Yuchan-00/CanSat_EDF_Rocket/sizing/sizing_report_vtol.md

# VTOL 크기 산정 - 전원 battery

CAD 보고서 `cad/exports/cadquery_report_vtol.json` (params sha256 `3419c5fea63506dc…`).

* 질량 1653.7 g (출력 부품 565.6 g), CG z 245.3 mm, 베인 팔 208.3 mm, Ixx 0.0355 kg m², 높이 475.3 mm, 발자국 Ø246.8 mm
* 넘어짐 각: 핀 쪽 26.7°, 핀 사이 19.6°
* 법규: 4종 (250 g 초과 ~ 2 kg 이하), 기체 신고 필요 False

| 추력 (kgf) | T/W | 호버 스로틀 | P1 호버 W | P2 호버 W | T/W 1.3이 되는 질량 (g) |
|---|---|---|---|---|---|
| 2.0 | 1.21 | 0.91 | 886 | 1702 | 1538 |
| 2.3 | 1.39 | 0.85 | 886 | 1380 | 1769 |
| 2.6 | 1.57 | 0.80 | 886 | 1148 | 2000 |
| 3.09 | 1.87 | 0.73 | 886 | 886 | 2377 |

베인 권한(호버 추력 16.2 N, 명령 한계): 피치 0.536 N m → 15.1 rad/s², 롤 0.144 N m → 43.5 rad/s²

모터선 항력(E): 배기 속 모터선 묶음(수축 튜브, 항력 면적 325 mm², Cd 1 ASSUMED)이 추력의 3.2 %(Cd 0.8-1.2: 2.6-3.8 %)를 먹습니다. 호버에서 0.54 N. 그래서 T/W 1.3에 필요한 추력은 2.22 kgf입니다(질량만 보면 2.15 kgf). 위 표(T/W, 호버 전력)는 질량만 반영합니다. 이 EDF를 조립한 그대로 시험대에서 잰 추력에는 이 항력이 이미 들어 있으므로, 그 값에는 보정을 다시 하지 않습니다.

전압 조건: 위 표의 추력은 ESC 22.2 V 기준입니다. 팩이 셀당 3.7 V일 때 전 스로틀 전압은 20.36 V(내부 저항 18 mΩ ASSUMED)이고 추력은 0.870배(T ∝ V^1.61)입니다. 그때 T/W: 2 kgf 1.05 / 2.3 kgf 1.21 / 2.6 kgf 1.37 / 3.09 kgf 1.63. 비행 끝까지 T/W 1.3을 지키려면 22.2 V 기준 추력 2.47 kgf 이상이 필요합니다.

## 배터리 선택지 (추정, 기본 팩은 그대로)

| 팩 | 기체 질량 g | T/W @2.0/2.3/2.6/3.09 | P1 호버 A / 전압 처짐 V / 비행 s | P2(2.0 kgf) 호버 A / 처짐 V / 비행 s | 최대 C (P1 T/W 1.3 / P2 전 스로틀) |
|---|---|---|---|---|---|
| 6S 1300 mAh 120C | 1520 | 1.32/1.51/1.71/2.03 | 36.6 / 0.88 / 102 | 73.4 / 1.76 / 51 | 43 / 88 (정격 120) |
| 6S 1500 mAh 100C | 1550 | 1.29/1.48/1.68/1.99 | 37.6 / 0.79 / 115 | 74.9 / 1.57 / 58 | 38 / 76 (정격 100) |
| 6S 1800 mAh 100C | 1590 | 1.26/1.45/1.64/1.94 | 38.9 / 0.74 / 133 | 77.4 / 1.47 / 67 | 33 / 63 (정격 100) |
| 6S 2200 mAh 70C (default: battery.*) | 1654 | 1.21/1.39/1.57/1.87 | 41.3 / 0.74 / 153 | 82.1 / 1.48 / 77 | 28 / 51 (정격 70) |
