Yuchan-00/CanSat_EDF_Rocket/sizing/sizing_report_vtol_hybrid.md

# VTOL 크기 산정 - 전원 hybrid

CAD 보고서 `cad/exports/cadquery_report_vtol_hybrid.json` (params sha256 `3419c5fea63506dc…`).

* 질량 1526.8 g (출력 부품 565.6 g), CG z 232.5 mm, 베인 팔 195.5 mm, Ixx 0.0322 kg m², 높이 475.3 mm, 발자국 Ø246.8 mm
* 넘어짐 각: 핀 쪽 28.0°, 핀 사이 20.6°
* 법규: 4종 (250 g 초과 ~ 2 kg 이하), 기체 신고 필요 False

| 추력 (kgf) | T/W | 호버 스로틀 | P1 호버 W | P2 호버 W | T/W 1.3이 되는 질량 (g) |
|---|---|---|---|---|---|
| 2.0 | 1.31 | 0.87 | 786 | 1510 | 1538 |
| 2.3 | 1.51 | 0.81 | 786 | 1224 | 1769 |
| 2.6 | 1.70 | 0.77 | 786 | 1019 | 2000 |
| 3.09 | 2.02 | 0.70 | 786 | 786 | 2377 |

베인 권한(호버 추력 15.0 N, 명령 한계): 피치 0.464 N m → 14.4 rad/s², 롤 0.133 N m → 40.9 rad/s²

모터선 항력(E): 배기 속 모터선 묶음(수축 튜브, 항력 면적 325 mm², Cd 1 ASSUMED)이 추력의 3.2 %(Cd 0.8-1.2: 2.6-3.8 %)를 먹습니다. 호버에서 0.50 N. 그래서 T/W 1.3에 필요한 추력은 2.05 kgf입니다(질량만 보면 1.98 kgf). 위 표(T/W, 호버 전력)는 질량만 반영합니다. 이 EDF를 조립한 그대로 시험대에서 잰 추력에는 이 항력이 이미 들어 있으므로, 그 값에는 보정을 다시 하지 않습니다.

## 전원 장치 한계 (Mean Well RSP-1500-24, 25.2 V / 60 A, 루프 59.5 mΩ)

전류 한계에서 ESC 전압 21.63 V, 전력 1298 W. 전원 1대로 낼 수 있는 T/W:

| 추력 (kgf) | T/W 전원 한계 P1 | T/W 전원 한계 P2 | 호버 전선 전류 P1 A (ESC V) | P2 A (ESC V) | 버퍼 전류 P1 / P2 A | 버퍼 지속 P1 / P2 s |
|---|---|---|---|---|---|---|
| 2.0 | 1.26 | 0.90 | 33.9 (23.18) | 72.2 (20.90) | 0.0 / 25.9 | - / 72 |
| 2.3 | 1.40 | 1.04 | 33.9 (23.18) | 56.0 (21.87) | 0.0 / 13.4 | - / 140 |
| 2.6 | 1.40 | 1.18 | 33.9 (23.18) | 45.3 (22.51) | 0.0 / 4.3 | - / 431 |
| 3.09 | 1.40 | 1.40 | 33.9 (23.18) | 33.9 (23.18) | 0.0 / 0.0 | - / - |

하이브리드: 전선 전류가 40.3 A(버퍼 22.8 V)를 넘으면 버퍼 배터리가 함께 방전합니다. '호버는 전선이 혼자 감당한다'는 말은 팬 효율이 P1(판매처 표)처럼 좋을 때만 맞습니다.
