Yuchan-00/CanSat_EDF_Rocket/sizing/sizing_report_vtol_tether.md

# VTOL 크기 산정 - 전원 tether

CAD 보고서 `cad/exports/cadquery_report_vtol_tether.json` (params sha256 `3419c5fea63506dc…`).

* 질량 1405.8 g (출력 부품 565.6 g), CG z 219.8 mm, 베인 팔 182.8 mm, Ixx 0.0293 kg m², 높이 475.3 mm, 발자국 Ø246.8 mm
* 넘어짐 각: 핀 쪽 29.3°, 핀 사이 21.7°
* 법규: 4종 (250 g 초과 ~ 2 kg 이하), 기체 신고 필요 False

| 추력 (kgf) | T/W | 호버 스로틀 | P1 호버 W | P2 호버 W | T/W 1.3이 되는 질량 (g) |
|---|---|---|---|---|---|
| 2.0 | 1.42 | 0.84 | 695 | 1334 | 1538 |
| 2.3 | 1.64 | 0.78 | 695 | 1082 | 1769 |
| 2.6 | 1.85 | 0.74 | 695 | 900 | 2000 |
| 3.09 | 2.20 | 0.67 | 695 | 695 | 2377 |

베인 권한(호버 추력 13.8 N, 명령 한계): 피치 0.399 N m → 13.7 rad/s², 롤 0.122 N m → 38.0 rad/s²

모터선 항력(E): 배기 속 모터선 묶음(수축 튜브, 항력 면적 325 mm², Cd 1 ASSUMED)이 추력의 3.2 %(Cd 0.8-1.2: 2.6-3.8 %)를 먹습니다. 호버에서 0.46 N. 그래서 T/W 1.3에 필요한 추력은 1.89 kgf입니다(질량만 보면 1.83 kgf). 위 표(T/W, 호버 전력)는 질량만 반영합니다. 이 EDF를 조립한 그대로 시험대에서 잰 추력에는 이 항력이 이미 들어 있으므로, 그 값에는 보정을 다시 하지 않습니다.

## 전원 장치 한계 (Mean Well RSP-1500-24, 25.2 V / 60 A, 루프 59.5 mΩ)

전류 한계에서 ESC 전압 21.63 V, 전력 1298 W. 전원 1대로 낼 수 있는 T/W:

| 추력 (kgf) | T/W 전원 한계 P1 | T/W 전원 한계 P2 | 호버 전선 전류 P1 A (ESC V) | P2 A (ESC V) |
|---|---|---|---|---|
| 2.0 | 1.36 | 0.98 | 29.6 (23.44) | 62.0 (21.51) |
| 2.3 | 1.52 | 1.13 | 29.6 (23.44) | 48.5 (22.32) |
| 2.6 | 1.52 | 1.28 | 29.6 (23.44) | 39.4 (22.86) |
| 3.09 | 1.52 | 1.52 | 29.6 (23.44) | 29.6 (23.44) |
