Yuchan-00/CanSat_EDF_Rocket/pcb/vtol_carrier/spec/SPEC_ko.md

# VTOL 캐리어 PCB 전기 사양 (rev 2c, 2026-11-05)

## 0. rev 2c 변경 (rev 2b 독립 검토 반영, 2026-11-05)

아래 1장 이후는 rev 2b 때 쓴 요약입니다. rev 2c에서 바뀐 것은 이 절과 `carrier_spec.json`의 `rev_2c_changes`가 우선합니다.

- **J14(1S 배터리)와 J15(전원 스위치 리드)를 −x/+y 모서리로 옮겼습니다.** 사용자가 고른 배터리 A 자리(6S 팩 −x 면) 바로 옆입니다. J15는 2.54 mm 수 헤더 대신 **JST-PH 2핀 세로형**(J17과 같은 부품, LCSC C131337)입니다. 꽂은 플러그가 높이 13.4 mm 안에 들어갑니다 (A). 스위치 리드 끝은 JST-PH 하우징으로 다시 끼웁니다.
- **J13(사출 서보, 미실장)과 그 직렬 저항을 뺐습니다.** VTOL에는 사출 서보가 없습니다 (params `configs.vtol`). U2 PE5는 무연결로 둡니다. 펌웨어는 고치지 않았습니다. 부품 번호 자리는 비워 두어 다른 번호는 그대로입니다.
- **J3(ESP 굽기 헤더)를 1×6에서 2×3으로 바꾸고 케이블타이 띠 맨 위, ESP-12E 바로 옆에 두었습니다.** 핀 번호와 뜻은 같습니다 (1 IO0, 2 GND, 3 TXD0, 4 RXD0, 5 RST, 6 GND). 부품은 ISP와 같은 2×3 헤더(LCSC C65114)입니다.
- **크리스털 부하 콘덴서 22 pF → 27 pF** (CL 18 pF 크리스털에 맞춤, LCSC C1557, 2026-11-05 온라인 확인).
- **ESP 벌크 콘덴서 100 µF 6.3 V → 10 V** (LCSC C7196 TAJB107M010RNJ, 2026-11-05 온라인 확인). 3.3 V에서 정격의 33 %입니다.
- 부품 수: 162개 (실장 160, 미실장 2), 넷 100개 (M, build_spec.py).
- 배터리 A 자리 가정 상자와 무선 결정(Wi-Fi 유지, ESP-NOW 1 Mbps, 지상 고이득 안테나, 1 km 이상 지상 거리 시험, 실패하면 LoRa)은 `battery_spot_A_assumed`, `radio_decision_2026_11_05`에 있습니다.

아직 그리지 않았습니다. 이 문서는 사양만 요약합니다. 보드를 만들거나 측정한 적이 없으므로 모든 동작은 **NOT_VERIFIED**입니다.

- 기계 판독용 사양: `B:/0)AI_Cad/CanSat_EDF_Rocket/pcb/vtol_carrier/spec/carrier_spec.json`
- 생성 스크립트: `B:/0)AI_Cad/CanSat_EDF_Rocket/pcb/vtol_carrier/scripts/build_spec.py` (네트워크 없이 실행)
- 부품 출처 확인(온라인, 읽기만): `B:/0)AI_Cad/CanSat_EDF_Rocket/pcb/vtol_carrier/scripts/fetch_parts_sources.py` → `B:/0)AI_Cad/CanSat_EDF_Rocket/pcb/vtol_carrier/spec/parts_sources.json`, 원본 응답 `B:/0)AI_Cad/CanSat_EDF_Rocket/pcb/vtol_carrier/out/reports/sourcing/`
- 라이브러리 확인: `B:/0)AI_Cad/CanSat_EDF_Rocket/pcb/vtol_carrier/spec/library_probe.json` (KiCad 10 라이브러리 파일에서 읽음)
- 1차 빌드(PLM100 + 2S): `B:/0)AI_Cad/CanSat_EDF_Rocket/pcb/vtol_carrier/archive/rev1_plm100_2s/` (건드리지 않음)

표시: F = 파일·업체 페이지 근거, M = 도구로 측정, E = 추정, A = 가정(이유 있음).

## 1. 이번에 바뀐 것 (rev 2 → rev 2b)

- **5번째 ATmega128A를 뺐습니다** (사용자 결정). U5와 그 칩만 쓰던 크리스털, 콘덴서, 인덕터, 저항, LED, ISP 헤더 J23을 모두 지웠습니다. 다른 부품 번호는 그대로 두려고 번호 자리(U5, Y5, C33-C40, L5, R9-R10, D5, J23)는 비워 두었습니다.
- **5 V 모듈을 Pololu S9V11F5S6CMA로 정했습니다** (디바이스마트 15855364, F). 승강압형이고 저전압 차단 기능이 있습니다. 셀 과방전을 하드웨어로 막습니다. J6 1×5 헤더 하나로 꽂습니다 (J4는 이제 없음).
- **크리스털을 바꿨습니다.** JLC 기본 부품 C13738은 부하용량이 9 pF라 22 pF 콘덴서와 맞지 않습니다 (F, LCSC 페이지). 18 pF 제품 C70562 X322516MRB4SI를 씁니다.
- 서보 전원 220 µF 전해 콘덴서 풋프린트를 실제 부품 크기(6.3 × 5.4)에 맞췄습니다.
- **4층 대비 계획**을 넣었습니다 (8장).
- **모든 부품의 구매처를 온라인으로 확인했습니다** (7장).

## 2. 규모 (스크립트 결과, M)

- 부품 164개 (실장 160, 미실장/선택 4: J13, R22, Q3, R47), 넷 102개.
- 핀 665개 = 연결 481 + 무연결 184 (무연결마다 이유 기록).
- 신호 경로 52개 모두 통과, TX끼리 충돌 0, ESP 부팅 스트랩 5/5, ESP 플래시 핀 6개 미연결 확인. 스크립트 검사이며 ERC/DRC가 아닙니다.
- 일부러 틀린 6가지(ESP TX/RX 뒤바꿈, GPIO15 풀업, GPS TX끼리 연결, 0402 자리에 0603 부품, 출처 없는 저항값, Pololu EN 핀 누락)를 넣으면 스크립트가 모두 막았습니다. 원본은 통과했습니다 (M, `C:/Users/yc012/AppData/Local/Temp/claude/B--Claude/bed4b475-b8b1-46b7-ab64-c3b11e27401e/scratchpad/pcb/rev2b_mutation.py`).
- 두 번 만든 JSON의 해시가 같습니다 (M, sha256 f12d65d2…).

## 3. 칩과 링크 (펌웨어 핀 그대로)

- U1 NAV, U2 FCU, U3 COM, U4 GNS: ATmega128A-AU, 16 MHz, 5 V.
- 칩마다: 16 MHz 크리스털 + 22 pF 2개, 리셋 10 kΩ + 100 nF, VCC 핀마다 100 nF, AVCC 10 µH + 100 nF, AREF 100 nF(내부 2.56 V 기준), ISP 2×3, LED + 1 kΩ (F: `firmware/README.md:310-311`, `board.h`).
- nlink SPI(NAV→FCU), ilink UART(FCU↔COM, 1 kΩ), glink UART(NAV↔GNS, 1 kΩ 추가 - A)는 5 V 직결입니다.
- 프로그래밍용 리셋 고정 점퍼: J24(NAV), J25(FCU), J26(COM, ESP 굽기용).

## 4. 전원

- 경로: J14 배터리(Molex Mini-SPOX 2핀) → Q10 AO3401A 역극성 보호 → J15 스위치 리드 → 22 µF ×2 → J6 3번 VIN → Pololu 모듈 → J6 1번 VOUT → **+5V** → U6 AMS1117-3.3 → **+3V3**.
- 서보는 ESC BEC(5 V/7 A)에서 받습니다. 로직 배터리에서 받지 않습니다 (F: `firmware/README.md:322-324`).
- 6S는 J18로 전압만 잽니다 (PF0/PF1/PF2). 6S → 로직 변환기는 없습니다.
- 접지: 로직 GND와 추진 GND_PWR는 **NT1 한 곳(J12 ESC 커넥터 3번 핀)** 에서만 만납니다.
- 부하 (E): 5 V 평균 273 mA, 최대 683 mA. 3.3 V 평균 128 mA, 최대 448 mA (ESP 송신 순간 약 400 mA, A).
- 모듈 입력 전류 (E, 효율 85 % A): 3.7 V에서 평균 0.43 A, 3.0 V에서 최대 1.34 A.
- 모듈 능력: 업체 값 1.7 A는 입력이 5 V 근처일 때입니다. 3.0-3.7 V 입력에서는 약 1 A로 봅니다 (A, 그래프 미확인). 최대 부하 0.68 A에 약 1.5배 여유 (E). ESP 송신 때 5 V 처짐을 재야 합니다.
- AMS1117 발열 (E): 평균 0.22 W, 순간 0.76 W.
- 사용 시간 (E): 약 7.7 시간. 비행은 40 s이므로 충전만 해 두면 됩니다.
- Q10: 셀 3.0 V에서도 완전히 켜집니다 (LCSC: 2.5 V에서 85 mΩ, F). 전압 강하 0.11 V 이하 (E).
- 과방전 보호 (3겹):
  1. Pololu 모듈 저전압 차단. 차단 3.2 V를 제안합니다 (A). 재시동은 약 3.65 V부터입니다 (업체 값 114 %).
  2. 배터리 내장 보호회로 ('P' 접미사로 추정 - A, 실측 필요).
  3. FCU PF3 감시 분압기 47k/47k (실장). 펌웨어는 아직 읽지 않습니다. 그때까지 비행 전에 3.8 V 이상인지 재십시오.
- 차단이 비행 중에 걸리면 칩 4개가 모두 꺼집니다. 비행 전 전압 확인이 먼저입니다.
- 로직이 꺼진 채 6S를 꽂으면 PF0 분압기로 약 0.42 mA가 샙니다 (E). 로직을 먼저 켜고 6S를 꽂으십시오.

## 5. ESP-12E (U7)

- 3.3 V + 100 µF 탄탈 + 10 µF + 100 nF를 VCC 핀 옆에 둡니다 (A).
- EN 10 kΩ 풀업 + 100 nF, RST 10 kΩ 풀업(Q5), GPIO15 10 kΩ 풀다운, GPIO0·GPIO2 10 kΩ 풀업 (A, Espressif 자료 확인 필요).
- COM PD3 → Q4 → 1 kΩ → ESP RXD0. ESP TXD0 → Q11 → COM PD2. COM PC6 → Q5 → ESP RST.
- 굽기 헤더 J3 (3.3 V 전용, 전원 핀 없음): 1 IO0, 2 GND, 3 TXD0, 4 RXD0, 5 RST, 6 GND. J26을 끼워 COM을 리셋에 묶고 굽습니다.
- 안테나: 보드 +y 모서리. 안테나 아래와 양옆 4 mm는 모든 층에 구리·부품 금지입니다 (4층이면 안쪽 층도).
- 거리: 가시거리 약 100-300 m (A). VTOL 지오펜스 35 m에는 충분합니다 (E). 로켓(정점 140-150 m + 표류)에는 빠듯합니다 → 사용자 결정. 로켓 구성은 아직 LoRa입니다.

## 6. 센서·주변 장치

- J1 GY-521(I2C 0x68, 5 V), J2 BMP280(직각 소켓으로 눕힘, I2C 0x77, 3.3 V), I2C는 Q1/Q2 BSS138.
- J7 GPS 리드(JST-GH 4핀, NEO-7M은 상단 캡), Q6/Q7, JP1로 3.3 V/5 V 선택 (기본 3.3 V).
- J5 OpenLog: 직각 소켓, 보드에 눕힘 (OpenLog에 직각 수 헤더를 납땜).
- J8-J11 베인 서보, J12 ESC, J13 사출 서보(미실장), J16 아밍 스위치, J17 부저(Q9), J18 6S 감지.
- BSS138 채널 9개 자리, 8개 실장 (Q3는 선택).

## 7. 부품 구매처 (사용자 규칙: JLCPCB 또는 디바이스마트만)

- 보드 부품 36줄 모두 출처가 있습니다 (M, 스크립트 확인). JLCPCB/LCSC 34줄: Basic 18, Extended 16. 디바이스마트 2줄(GY-521, Pololu 모듈).
- 줄마다 C번호 또는 디바이스마트 no=, 제조사 품번, 패키지, 확인 URL, 날짜(2026-11-05), 재고, Basic/Extended를 `carrier_spec.json`의 `bom_sources`에 적었습니다. JLC BOM 열 이름은 `LCSC Part #`입니다.
- 패키지가 풋프린트와 맞는지 스크립트가 검사합니다 (칩 크기는 풋프린트 이름에서 읽음).
- 보드 밖 물품: 점퍼캡 5개(C100114), BMP280·OpenLog·NEO-7M·배터리·토글 스위치(디바이스마트), OpenLog용 직각 헤더(C55629820), GPS 리드 하우징·핀(C160418, C189897), 부저 리드 하우징·핀(C157955, C111515).
- 주의 1: 디바이스마트가 이 PC의 접속을 05:32쯤부터 막았습니다. OpenLog(1313116), MTS-102 토글(13029107), ESP-12E 대안(1378118)은 그 전에 디바이스마트 검색 결과로만 확인했습니다. 상품 페이지는 못 읽었습니다. 근거는 `spec/parts_sources_manual.json`에 적었습니다. 주문 전에 다시 확인하십시오.
- 주의 2: MTS-102 토글의 접점 정격은 확인하지 못했습니다 (A: 2 A 이상 가정). Adafruit 미니 토글은 1 A라서 쓰지 않았습니다 (F).
- 주의 3: LCSC에도 OpenLog(C17253836)가 있지만 재고가 0이었습니다.
- 주의 4: 재고는 날마다 바뀝니다. 주문 직전에 `fetch_parts_sources.py`를 다시 돌리십시오.
- 구매나 장바구니 담기는 하지 않았습니다.

## 8. 2층 / 4층 계획

- 먼저 2층(5번째 칩 없이)으로 배선합니다. 약 90분 안에 미연결 0이 안 되면 4층으로 바꿉니다 (사용자 결정).
- 4층 구성: F.Cu 신호 / In1.Cu GND 전면 / In2.Cu 전원(+5V, +3V3, SERVO_5V) / B.Cu 신호. JLCPCB 표준 4층 1.6 mm. 비아 0.3/0.6 mm 관통만. 2층 규칙을 그대로 지킵니다.
- 4층은 2층보다 기판값이 꽤 비쌉니다 (E, 가격은 조회 안 함). 배선 단계가 어느 쪽을 냈는지 보고합니다.

## 9. 사용자가 정할 것

1. 로직 배터리 자리 (CAD 상자에서 계산, E): A 6S 팩 −x 면이 가장 좋음 (무게중심이 축에서 0.84 mm, 지금 1.34 mm). D −y 옆 1.41 mm(GPS 선과 겹침), C +y 옆 1.09 mm(ESP 안테나 위), B ESC +x 면 2.73 mm(냉각창 막음).
2. 무게: 84 g 추가로 VTOL 배터리 구성 약 1,737.6 g, 목표보다 약 87.6 g 무거움 (E). params.json은 고치지 않았습니다.
3. 전원 스위치 위치: 기체를 닫으면 캐리어에 손이 닿지 않습니다. (a) 옆 창 스위치, (b) 상단 캡에 구멍 추가, (c) 배터리 플러그로 끄기 중 선택.
4. Pololu 차단 전압 (3.2 V 제안).
5. ESP 안테나: 모서리 + 금지 영역(기본) 또는 보드 밖으로 내밀기.
6. JLC Extended 부품 조립비, ESP-12E를 JLC 조립(C89297)할지 손납땜할지.
7. ESP 중계 펌웨어, 지상 쪽, COM 드라이버 - 별도 단계.
8. BMP280 드라이버와 시뮬레이션 기압 모델 - 제어 관련 변경이므로 전/후 비교 영상 규칙 적용.

## 10. 펌웨어 후속 (이번에는 고치지 않음)

- ESP 중계 펌웨어(새로), 지상 쪽(노트북/휴대폰 또는 ESP8266 한 개 더), `tools/ground_station.py` UDP/TCP.
- COM lora_uart 드라이버는 9600 8N1 투명 중계면 그대로 될 수도 있습니다 (E, 시험 필요). `sim/link_model.py`의 Ebyte 시간 모델은 Wi-Fi에 맞지 않습니다.
- FCU PF3 로직 배터리 읽기 + 아밍 금지/착륙 문턱 (A 값).
- NEO-7M MON-VER 처리, 상단 캡 맞춤. `sim/tether.py:171` bec_min_v 재검토.

## 11. 파일 사이 어긋남 (요약, 전체는 `conflicts` 19개)

- params `carrier.model`(1755줄)에는 GY-63, LoRa, 5 V buck, 미실장 5번째 칩이 아직 적혀 있습니다. 사용자 결정을 따랐습니다. params와 문서는 고치지 않았습니다.
- P3 문서의 22 pF와 JLC 기본 크리스털(9 pF)이 맞지 않아 18 pF 크리스털을 골랐습니다.
- params `com.pins.link_uart_rx`는 "direct"인데 Q11을 넣었습니다 (펌웨어 영향 없음).
- 펌웨어 README의 6S → 5 V UBEC 전원 설명은 별도 로직 배터리로 대체됩니다.
- 질량 초과는 과제 문장의 3.7 g이 아니라 문서·CAD 값 3.6 g을 썼습니다.
