Yuchan-00/CanSat_EDF_Rocket/docs/제작가이드.md

# 제작 가이드 — 부품표 · 출력 · 조립

> v0.4: 조종 링크는 보유한 LoRa 모듈입니다. 기체 안에서는 자세 제어와 안전 차단만 돌고, 발사·모터 정지·사출은 노트북 지상국이 명령합니다. 사용법은 [지상국_사용법.md](지상국_사용법.md)에 있습니다.
>
> v0.6.3: 비행 컴퓨터는 ATmega128A 보드 3개입니다. **NAV**는 센서(MPU-6050·기압계)를 읽고 자세 추정과 고도 필터를 돌립니다. 매 틱(4 ms)마다 72바이트 항법 프레임을 SPI(nlink)로 FCU에 보냅니다. **FCU**는 명령과 인터록(I1–I10), 자세 제어, 서보·ESC 출력, OpenLog 로그를 맡습니다. 비행 판단은 모두 FCU가 합니다. **COM**은 LoRa 무선, 명령 해독, 텔레메트리 작성을 맡고, UART(ilink, 250 kbaud)로 FCU와 이어집니다. NAV와 COM은 비행 판단을 하지 않습니다. (2026-11-09 덧붙임: v0.8.1부터 GPS를 맡는 **GNS**를 더해 칩이 4개입니다. VTOL은 네 칩을 캐리어 PCB 한 장에 올립니다. 무선은 2026-11-06부터 ESP-12E Wi-Fi가 기본이고 LoRa는 예비입니다.)

이 문서는 `params.json` v0.6.3의 기본 설계 **`BUDGET_90mm_6S`** 기준입니다. 원래 설계(KAIST 1 kg 캔위성, 12S)는 `KAIST_90mm_12S` 프리셋으로 남아 있습니다. 치수가 바뀌면 `python cad/layout.py`로 현재 값을 확인하세요.

## 1. 부품표

가격, 배송비, 판매처 링크가 있는 전체 부품표는 [예산안.md](budget/예산안.md)에 있습니다. 모든 가격은 2026-10-13에 판매 페이지에서 읽은 값이고, 합계는 `tools/budget_bom.py`가 계산합니다. (ASSUMED) 표시는 가격을 조사하지 않은 추정 품목입니다.

| 분류 | 부품 | 연결 |
|---|---|---|
| 추진 | Hobbyocean 90 mm 12엽 EDF 6S 1450KV | ESC 경유 |
| 추진 | Hobbywing SkyWalker 100A V2 ESC | 신호선 ← FCU PE4(OC3B). 내장 5 V/7 A BEC로 서보 5개 구동 |
| 추진 | CNHL G+Plus 6S 2200 mAh 70C | FCU ADC0(PF0)에 47 kΩ / 4.7 kΩ 분압 |
| 구동 | MG90S 서보 5개 | FCU: 베인 PB5·PB6·PB7·PE3, 사출 PE5 |
| 배선 (v0.6) | 26 AWG 3심 플랫 서보선(실리콘) 약 3 m, 3핀 JR/듀폰 커넥터 4개(또는 서보 헤더 기판에 납땜), 수축 튜브 (ASSUMED) | 베인 서보 4개의 연장선. FCU까지 연장 길이 합 1,947 mm + 여유 300 mm. 단면 3.6 × 1.3 mm, 10 g/m로 가정했으므로 산 전선을 재고 무게를 달아 `params.json`의 `servo_leads`와 비교 |
| 비행 컴퓨터 | ATmega128A 최소 시스템 보드 3개 (NAV·FCU·COM), 16 MHz | 크리스털이 16 MHz인지 확인(8 MHz로 온 사례 있음). 설계는 50 × 50 × 15 mm 보드, 44 mm 정사각 M3 구멍으로 잡았습니다. 받으면 재서 다르면 알려 주세요 |
| NAV | MPU-6050(GY-521), 기압계 BMP280 모듈(TYE-BMP29, 디바이스마트 15442588, 3.3 V. 사용자 결정 2026-11-04, GY-63 MS5611 대신) | NAV PD0(SCL)/PD1(SDA) → 레벨 시프터 HV(5 V) 쪽, GY-521·BMP280의 SCL/SDA → LV(3.3 V) 쪽. BMP280은 VCC 3.3 V(AMS1117 1번)이고, CSB·SDO를 3.3 V에 묶어 I2C 0x77로 씁니다(캐리어 J2와 같음. 핀 순서는 실크로 확인, A). 펌웨어의 기본 NAV 빌드가 BMP280을 읽습니다(2026-11-10 제어 라운드. 실제 부품으로는 아직 확인하지 않았습니다. MS5611을 쓰려면 env `nav_ms5611`) |
| NAV | I2C 레벨 시프터 4채널, AMS1117-3.3 (1번) | ATmega128은 5 V에서 TWI 입력 High 기준이 3.5 V라 3.3 V 센서를 직접 받으면 보장되지 않음 |
| COM | 보유한 LoRa 모듈 (기체용) | UART형(Ebyte E22/E220/E32 등): COM의 USART1 PD2/PD3, M0·M1·AUX = PC3·PC4·PC5. SPI형(SX1276 900 MHz, 예: RFM95W·Ra-01H): COM의 PB0–PB3, DIO0 = PE7, RESET = PC6, 전원은 AMS1117-3.3(2번)에서. Ra-01/Ra-02는 433 MHz라 맞지 않음 |
| COM | 두 번째 레벨 시프터 4채널, AMS1117-3.3 (2번) | COM에서 LoRa 모듈로 가는 신호를 3.3 V로. 2번 AMS1117은 LoRa 모듈과 이 시프터의 3.3 V 쪽 |
| FCU | OpenLog 호환 로거 + microSD | FCU USART0 TXD0(PE1) → OpenLog RXI, 57600 baud. FCU의 ISP와 핀 공유 → FCU를 프로그래밍할 때 분리. 레벨 시프터 경로는 3장 9단계 참고 |
| 배선 (v0.6) | ilink 배선: 1 kΩ 직렬 저항, 4핀 커넥터 1쌍, 신호선 약 30 cm (ASSUMED) | FCU PD3(TXD1) → 1 kΩ → COM PE0(RXD0), COM PE1(TXD0) → FCU PD2(RXD1), GND. 3선입니다(`board.h`). 4핀 커넥터의 남는 핀은 비워 둡니다. COM의 5 V는 UBEC에서 따로 받습니다. 두 칩 모두 5 V라 시프터 없음 |
| 배선 (v0.6.3) | nlink 배선: 5핀 커넥터 1쌍, 신호선 약 30 cm (ASSUMED) | NAV PB0·PB1·PB2·PB3 → FCU 같은 핀 (SS, SCK, MOSI, MISO) + GND. 시프터 없음. FCU를 프로그래밍할 때 뺌 |
| 비행 컴퓨터 | 5 V 3 A UBEC (2–6S) | 로직 전원(세 보드, 센서, 로거, 시프터 5 V 쪽). 서보 전원과 분리해 브라운아웃 리셋을 막음 |
| 회수 | 립스톱 1 × 1.5 m 두 장으로 만든 1.4 m 낙하산, 줄, 쇼크 코드, 스위블 | 노즈 앵커바 ↔ 페이로드 격벽 |
| 구조 | Bambu PLA Matte **아이보리 화이트(Ivory White, 코드 11100)** 1 kg × 2(로켓) / × 1(VTOL), **만다린 오렌지(Mandarin Orange, 코드 11300)** 1 kg × 1(로고), 발사대용 차콜(Charcoal, 11101, 검정, 있으면 안 삼), M3·M2 나사, OD 40 스프링 | 2026-11-04: 기체 흰색 + YUCHAN 로고. 살 때 색 이름·코드 확인(Bone White 11103과 헷갈리지 않게) |
| 구조 | 양면 폼 테이프 3 mm, 케이블 타이 | FCU와 통신·로거 상자 고정. 예산안에 없는 품목 |
| VTOL 로직 전원 (2026-11-05, 배터리 구성만) | 1S 3.7 V 4200 mAh DTP105565P(디바이스마트 16021596, 84 g), MTS-102 토글 하네스(디바이스마트 13029107, 접점 ≥ 2 A 확인), JST-PH 2핀 하우징, 케이블 타이 1개, 상단 캡 나사 **M3×6** 4개(더 긴 나사 금지), 배터리 선이 115 mm보다 짧으면 Molex 5264 2핀 연장선 | 캐리어 PCB J14(배터리) / J15(스위치). 자리·고정·선: 3장 14단계 |

**캔위성 규격이 바뀌었습니다.** 이 예산의 추력(약 3 kg)으로는 국제 규격 캔위성(Ø66 × 115 mm, 350 g)까지만 실을 수 있습니다. KAIST 체험부·슬기부·창작부 규격(650–1000 g)은 이 예산으로 불가능합니다.

## 2. 출력 (Bambu Lab P2S, PLA Matte 흰색 + 주황 로고)

* 출력용 STL은 `cad/exports/print/`에 **출력 방향이 이미 적용된 상태**로 들어 있습니다. Bambu Studio에 그대로 불러오면 됩니다.
* **출력하기 전에 `python tools/make_print_files.py --check`를 실행합니다.** 종료 코드 0이면 출력 파일이 현재 설계와 맞습니다. v0.9(2026-11-04)에는 Fusion 360 GUI 실행(스크립트 0.9.6)을 아직 하지 않아서, 지금 쓸 수 있는 출력 파일은 CadQuery 트윈 STL로 만든 **임시본**입니다: `cad/exports/print/provisional_v09_cadquery/`(로켓), `cad/exports/print/provisional_v09_cadquery_vtol/`(VTOL 배터리). 공식 출력 파일은 Fusion 스크립트를 지금의 `params.json`으로 실행하고 `--check`가 0을 낼 때 만듭니다.
* **흡입 모듈만은 STL이 아니라 `intake_module.3mf`(Bambu Studio 프로젝트)를 엽니다 (v0.6.2).** 창 4개마다 서포트 차단(support blocker) 볼륨과 슬라이스 설정이 들어 있습니다. 흡입 모듈은 **뒤집어** 출력합니다. 위쪽 스피곳이 판에 서고, 조립하면 아래쪽인 창 끝이 출력할 때 창의 천장이 됩니다. 이 천장은 가운데 20 mm가 브리지이고 양쪽이 45° 경사(잘린 박공)라 서포트 없이 출력됩니다. STL만 불러오면 Bambu Studio가 천장 밑과 창 안에 서포트를 다시 넣습니다. 그러면 서포트를 뗄 때 기둥이 상할 수 있습니다. `print_plan.md`의 "창 안 서포트 검사"가 PASS인지 확인하고(지금 PASS, 창 4개 모두 0 mm), 슬라이스 미리보기에서도 창 안에 서포트가 없는지 봅니다.
* 흡입 모듈 창 띠 (v0.6.1): 1.2 mm 기둥이 출력 중에 휘고 서포트를 뗄 때 부러져서, 창이 있는 띠를 3 mm 두께로, 기둥을 18 mm 폭으로 바꿨습니다. 창은 축에서 본 부채꼴이라 기둥 옆면이 반경 방향입니다.
* 공통 설정: `0.20mm Standard @BBL P2S` 기반, 채움 15 % 자이로이드, 자동 브림. 벽 수는 부품 등급별입니다(v0.9 임시 출력 계획): 하중 경로(A) 4줄·위아래 4층, 몸통·평판·발사대(B·C·E) 3줄·4층, 작은 부품(D) 5줄·5층. 벽이 1.2 mm라 3줄 이상이면 꽉 찬 벽이 됩니다.
* 서포트가 필요한 부품: 흡입 모듈(뒤집어 출력), 페이로드 모듈, 노즈콘, 베인, 발사대, **VTOL 배터리 구성의 상단 캡**(2026-11-05 스위치 보호 칼라 때문에 바로 세워 출력, 트리 서포트 - 3장 14단계 2). 발사대는 트리 서포트가 판 밖으로 퍼져 슬라이서가 거부하므로 일반(그리드) 서포트를 씁니다. 흡입 모듈은 일반 서포트를 밀착형(snug)으로, 서포트 확장 −0.5 mm로 씁니다. 트리 서포트는 차단 볼륨이 있어도 가지가 창을 지나 안쪽 선반까지 가기 때문입니다. 흡입 모듈의 서포트는 스피곳 안 격벽 밑, 안쪽 선반 턱 밑, 스피곳 바깥 턱, 볼록 통로 밑에만 남습니다. 선반 홈 천장(폭 14 mm·9 mm)은 대부분 브리지로 출력됩니다. 페이로드 모듈은 판에서 15 mm 위의 격벽과 그 아래 COM 보스 4개(v0.6)에 짧은 트리 서포트가 생깁니다.
* 부품별 출력 시간과 필라멘트는 `cad/exports/print/provisional_v09_cadquery/print_plan_provisional.md`(로켓)와 `cad/exports/print/provisional_v09_cadquery_vtol/print_plan_provisional.md`(VTOL)에 있습니다. 로켓은 발사대를 포함해 47시간 29분, 필라멘트 1475 g(부품 1083 g), VTOL은 32시간 41분, 827 g입니다(v0.9 CadQuery STL을 Bambu Studio로 슬라이스한 값, 2색 모듈의 퍼지량은 가정값 150 / 210 mm³ 기준). 예전 v0.6.2 Fusion 내보내기 값(전체 30시간 21분, 1272 g)은 `cad/exports/print/print_plan.md`에 남아 있습니다.
* PLA 열변형 온도는 52 °C(1.8 MPa)입니다. 여름철 차 안이나 직사광선 아래 보관을 피하세요.
* 벽이 1.2 mm로 얇아졌습니다. 착지 충격으로 금이 가면 해당 모듈만 다시 출력하세요.

### 2색 출력: 전자부 모듈 + YUCHAN 로고 (2026-11-04, AMS 필요)

* **2색인 판은 전자부 모듈 하나뿐**입니다. 다른 부품은 모두 흰색 한 색이고, 발사대만 검정입니다.
* 여는 파일: `cad/exports/print/provisional_v09_cadquery/avionics_module.3mf`(로켓) 또는 `..._vtol/avionics_module.3mf`(VTOL). STL을 따로 불러오지 마세요.
  이 프로젝트에 흰 몸통과 주황 로고가 한 물체의 두 부분으로 들어 있고, 필라멘트 1·2에 색이 정해져 있습니다.
* **AMS 넣기**: 1번 칸 Ivory White(아이보리 화이트, #FFFFFF, 11100), 2번 칸 Mandarin Orange(만다린 오렌지, #F99963, 11300). 보낼 때 AMS 매핑에서 1 → 흰색 칸, 2 → 주황 칸을 고릅니다.
* **슬라이서 설정**(프로젝트에 들어 있음, 바꾸지 마세요): P2S 0.4 노즐, `0.20mm Standard @BBL P2S`, 벽 3줄·위아래 4층·15 % 자이로이드, 벽 생성기 classic,
  **얇은 벽 감지(Detect thin wall) 켬**, 퍼지량 흰→주황 150 mm³ / 주황→흰 210 mm³(배수 1), 프라임 타워 켬(x 20, y 205).
  * 얇은 벽 감지는 끄지 마세요. 끄면 주황 한 줄을 같은 자리에 두 번 찍어서(갔다가 돌아옴) 홈이 넘치고 로고 가장자리가 튀어나올 수 있습니다.
  * 퍼지량 150 / 210은 가장 가까운 색 쌍(연회색 ↔ 주황)에서 가져온 가정값입니다. 흰색·만다린 쌍은 Bambu 표에 없습니다.
  * "채움/물체로 퍼지"는 켜지 마세요. 켜면 주황이 사라집니다(주황은 바깥 한 줄뿐).
  * 벽 생성기를 arachne로 바꾸지 마세요. 시험에서 주황 줄이 덜 찍혔습니다.
  * Bambu Studio가 퍼지량을 더 크게 계산해 보여 주면 그 값을 써도 됩니다. 시간과 버리는 양만 늘어납니다.
* **미리보기에서 확인**: 주황이 바깥 벽 한 줄에만 있는지, 그리고 **그 한 줄을 한 번만 지나가는지** 봅니다(선 종류 보기에서 주황 바깥 벽이 겹쳐 두 줄로 보이면 안 됨).
  색 바꿈은 576번(출력 높이 3.4-124.2 mm)입니다. 그중 2번은 주황 없이 색만 바꾸는 층입니다(층마다 색 순서가 번갈아 바뀌어 생김, 알려진 것).
  글자 끝이나 흰 쐐기 끝이 걸리는 몇 층에서는 작은 주황 점이 빠지거나 흰 쐐기 끝이 메워질 수 있습니다. 예상한 모습입니다.
* **예상(슬라이서 M, 퍼지 150 / 210 가정)**: 로켓 16 h 54 min, VTOL 16 h 28 min(한 색일 때보다 약 +14 h 23-26 min).
  버리는 양: 퍼지 136 g + 프라임 타워 45 g ≈ 180 g. 이 부품에 흰 163 g(VTOL; 로켓은 228 g), 주황 76 g이 듭니다.
  퍼지를 CLI 기본 280 mm³로 하면 약 +15 h 30 min, 256 g입니다(위쪽 기준).
* **긴 출력 전에 짧은 2색 시험 출력을 하세요**(실제 Ivory White / Mandarin 롤, 로고가 있는 아래쪽 몇 cm만). 흰 벽에 주황 기운이 보이면 주황→흰 퍼지를 늘립니다.
  출력이 길어서 AMS 칸에 각각 300 g 이상 남아 있는지 먼저 봅니다.
* **출력 뒤 검사**:
  1. 밖에서 보면 양쪽 모두 아래에서 위로 YUCHAN이 읽혀야 합니다(글자 윗부분이 왼쪽). 기체를 노즈 쪽이 오른쪽이 되게 눕히면 바로 읽힙니다.
  2. 로고가 벽과 같은 높이입니다(튀어나오거나 파이지 않음). 손톱으로 경계를 쓸어 봅니다.
  3. 주황 가장자리에 흰 실·번짐·빈틈이 없고, 가장 작은 배기 점선 3개(약 8.5 mm²)가 다 찍혔는지 봅니다.
  4. 모듈 안쪽 벽에는 주황이 보이지 않아야 합니다(주황은 바깥 0.42 mm뿐).

### 출력 후 가공

1. 힌지 보어(Ø5.4)를 5.5 mm 드릴로 손으로 가볍게 리밍합니다. 베인 축이 걸림 없이 돌아야 합니다.
2. 혼의 D-보어에 베인 축 D-컷이 들어가는지 확인합니다. 설계상 반경 방향 틈새 0.2 mm입니다.
3. 결합부(스피곳)에 상대 모듈이 손으로 끼워지는지 확인합니다. 설계 직경 틈새 0.4 mm입니다.
4. M3 결합 구멍(Ø2.5 / Ø3.2)과 서보 귀 구멍(Ø1.8)을 정리합니다.
5. 흡입 모듈 바깥의 볼록 전선 통로(0° 쪽)를 아래쪽 입구와 선반 홈 쪽으로 들여다보고, 서포트 찌꺼기가 없는지 확인합니다. 12 × 5 mm 막대나 묶은 전선을 한 번 통과시켜 봅니다. 통로 바닥은 45° 경사라 서포트가 생기지 않게 설계했습니다.
6. **서보선 통로 (v0.6)**: 추진 모듈의 서보 포드 4개 끝벽 아래쪽 창(4.6 × 7 mm), 원뿔 아래쪽의 세로 슬롯 4개(핀에서 8° 지난 53°·143°·233°·323°), 그 바로 위 데크 홈 4개, 스피곳 링 바깥 둘레의 턱(깊이 3.4 mm, 높이 5 mm), 흡입 모듈 180° 쪽 볼록 통로와 선반 홈, 격벽의 180° 구멍을 확인합니다. 3.6 × 1.3 mm 띠(서보선 한 가닥)가 걸림 없이 지나가야 합니다.
7. **흡입 모듈 창 (v0.6.2)**: 창 안에는 서포트가 없어야 합니다. 창 천장(출력할 때 위쪽, 조립하면 아래쪽 끝) 가운데 20 mm 브리지에 처진 실이 있으면 칼로 다듬기만 합니다. 안쪽 선반 턱 밑의 서포트는 모듈의 열린 끝(스커트 쪽)으로 손을 넣어 선반에서 떼어 냅니다. 이때 기둥을 지렛대로 쓰지 마세요.
8. **흡입 모듈 격벽 윗면 (v0.6.3)**: 흡입 모듈을 뒤집어 출력하면 격벽 윗면(스피곳 안쪽)이 서포트 위에 출력됩니다. 이 면에 FCU를 폼 테이프로 붙이므로, 서포트를 깨끗이 떼어 평평하게 만듭니다. 통풍 구멍 4개(Ø8, 축에서 40 mm, 45°·135°·225°·315°)에 찌꺼기가 없고 케이블 타이가 지나가는지 봅니다.
9. **VTOL 상단 캡 (배터리 구성, 2026-11-05 보호 칼라)**: 캡은 바로 세워(스커트 끝이 판에) 트리 서포트로 출력됩니다. 스커트 안의 서포트를 손을 넣어 떼어 냅니다. 리브·림 링을 지렛대로 쓰지 마세요. **스위치 구멍(Ø6.2) 둘레의 판 밑면은 안쪽 너트가 닿는 자리**이고 서포트 접촉면 위에 출력됩니다. 칼로 긁거나 사포로 평평하게 합니다. 구멍, 칼라 안, 손가락 홈 안에는 서포트가 없습니다(G-code 검사, M). 와셔 홈(Ø32.5, 허브 아래)도 서포트를 깨끗이 떼고 평평하게 다듬습니다. **이 칼라 캡으로는 붙잡는 줄·증명 하중 시험을 하지 않습니다**: 바로 세워 출력하면 하드포인트 하중 경로(리브 끝, 허브, 와셔 홈)도 서포트 위에 출력되는데, 증명 하중의 리브 안전율은 1.03뿐입니다(C38, 윗면 아래 출력 기준). 그런 시험은 윗면 아래로 출력한 캡(유선·하이브리드 캡)으로만 합니다. 스커트 입구가 첫 층이라 이 슬라이스는 첫 층 보정(elephant foot 0.15 mm, A)을 씁니다. 처음 출력한 캡을 아비오닉스 스피곳에 끼워 맞춤을 확인합니다(반경 틈 0.2 mm).
10. **COM 보스 구멍 (v0.6)**: 페이로드 모듈 격벽 아래 보스 4개(Ø7 × 3 mm, 축에서 x·y ±22 mm)에는 Ø2.5 막힌 구멍이 보스 끝에서 3.8 mm 깊이로 있습니다. 서포트가 구멍에 들어갔으면 2.5 mm 드릴로 손으로 뚫습니다. 구멍 바닥 위의 격벽은 1.2 mm뿐입니다. 드릴에 테이프로 3.8 mm를 표시하고 그보다 깊이 넣지 마세요. 뚫리면 스프링 쪽으로 구멍이 납니다.

## 3. 조립 순서

세 보드는 붙이기 전에 펌웨어를 올려 두면 편합니다(10단계). FCU는 흡입 격벽 위에 붙고 나면 손이 닿기 어렵습니다. 그래도 시험 빌드를 오갈 때와 `params.json`이 바뀔 때마다 FCU를 다시 올려야 합니다. 조립된 기체에서 FCU에 닿는 순서는 10단계 4에 있습니다.

1. **베인 · 서보**: 베인 축을 덕트 안쪽에서 힌지 보어로 끼우고, 바깥에서 혼을 D-컷에 끼웁니다. 서보를 포드에 넣기 전에 (v0.6):
   1. **서보선이 출력축 반대쪽 끝에서 나오는지 확인합니다.** 설계는 그렇게 가정했습니다(`servo_leads.lead_exit_ASSUMED`). 출력축 쪽에서 나오는 서보라면 이 경로가 맞지 않으니 출력하기 전에 알려 주세요.
   2. 서보선을 케이스에서 60 mm 남기고 자릅니다(커넥터 제거). 이 선을 포드 끝벽 아래쪽 창(혼 반대쪽, 핀 쪽)으로 밖으로 빼고 서보를 넣습니다.
   3. 남긴 60 mm 끝에 26 AWG 3심 연장선을 납땜하고 수축 튜브를 씌웁니다. v0.6.3부터 서보선은 흡입 격벽 위의 FCU에서 끝납니다. 연장선 길이(여유 50 mm 포함): 포드 1(24°) 524 mm, 포드 2(114°) 434 mm, 포드 3(204°) 450 mm, 포드 4(294°) 539 mm (`python cad/layout.py`, 검사 C23). 마지막 구간(격벽 서보선 구멍 → FCU 윗면 → 보드 가운데)은 FCU의 서보 헤더 위치를 몰라서 추정한 값입니다. 자르기 전에 FCU에서 서보 헤더를 달 자리를 정하고 길이를 확인하세요. 반대쪽 끝은 피복만 벗긴 채 두고(커넥터는 마지막에 답니다) 양쪽 끝에 번호를 표시합니다.

   서보를 M2 나사로 고정합니다. 서보를 중립(1500 µs)에 둔 상태에서 암을 반경 방향으로 맞추고 푸시로드(1.5 mm 피아노선, 축간 24.7 mm)를 연결합니다. 손으로 ±25°까지 걸림이 없는지 확인합니다.
2. **EDF 실측 (v0.5)**: 설계 치수는 판매처 치수 도면에서 읽은 값입니다. 받으면 먼저 재서 `params.json`의 `edf` 항목과 비교하세요. 다르면 고친 뒤 모델을 다시 생성합니다.
   * 하우징 지름 98 mm, 나팔형 립 지름 112 mm와 깊이 약 11 mm
   * 립 앞면에서 하우징 뒤끝까지 81.1 mm
   * 장착 탭: 바깥끼리 114.2 mm, 길이 42.3 mm, 두께는 도면에 없어 3.0 mm로 가정
   * 탭 가운데 구멍이 하우징 뒤끝에서 34.3 mm, 구멍 간격 11 mm
   * 탭 아래 끝에서 립 앞면까지(모델 67.95 mm)와 탭 아래 끝에서 각 구멍 중심까지(모델 10.15 / 21.15 / 32.15 mm). (2026-11-03 시계 장착부터 탭 나사가 없어 이 값은 재지 않아도 됩니다; 폼 패드가 ±0.5 mm를 받습니다.)
3. **EDF 장착 (2026-11-03 시계 장착, 탭 나사 없음 - `docs/v0.9_하드웨어_변경.md` 17.13)**: 재지 않고 넣습니다.
   1. 공장 수축 튜브는 그대로 둡니다. 모터 전선 끝의 총알 커넥터는 이 단계 전에 잘라 두거나 아직 납땜하지 않습니다.
   2. 두 탭의 밑면에 EVA 폼 조각(약 3 × 8 mm, 두께 3.5 mm)을 하나씩 붙입니다.
   3. **넣기 전에** 낱선 세 가닥을 묶음 끝에서 위로 약 90° 굽혀 둡니다(반지름은 7-15 mm 어디든, 선이 원하는 대로). 곧은 선으로는 EDF가 들어가지 않습니다(곧은 선은 블리스터 바깥벽보다 멀리 나감).
   4. EDF를 위에서 들고 돌려, 선 묶음이 0°(ESC 쪽, +x)의 선 통로(바깥으로 튀어나온 블리스터)를 향하게 합니다. 세운 선이 통로 안에 서도록 그대로 내립니다. 탭은 둘레의 키웨이 25개 중 가까운 곳에 저절로 떨어집니다.
      선이 탭 바로 옆에서 나오면 한 탭은 통로 안에 매달립니다. 정상입니다.
   5. 세운 선을 블리스터 바깥벽 쪽으로 밀어 붙입니다(벽에서 4 mm 안쪽까지만; 탭이 통로에 매달린 자리에서는 꼭). 위쪽에서 흡입부 홈 자리에 나란히 눕힙니다.
   6. 묶음을 고정 날개 뒤 끝에 RTV로 붙이는 것은 선택입니다. 통로 위쪽(몸통 밖, 반지름 60-76.7 mm의 열린 부분)에 폼 마개를 선 둘레에 꽉 채워 끼웁니다.
   7. 추력은 립 → 흡입부 선반이 받습니다(탭 나사 없음). 아래 방향은 탭 → 폼 → 키웨이 바닥 패드가 받습니다. 모터 토크는 탭 → 키웨이 옆 슬리브 이빨이 받습니다(이빨 폭 5.3 mm 이상, C35).
4. **서보선 넣기 (v0.6)**: 경로는 SPEC 3.8에 있습니다. 서보선 4가닥은 모터 전선(0°)과 반대편인 180° 쪽으로 모아 올립니다.
   1. 각 서보선은 포드 창에서 나와 핀 뿌리 옆을 따라 올라가, 원뿔이 시작하는 높이(배기구 끝에서 약 88–92 mm)에서 핀 선을 넘어 8° 옆(53°·143°·233°·323°)의 원뿔 세로 슬롯 아래로 갑니다.
   2. 같은 각도의 데크 홈(스피곳 링 바깥, 흡입 모듈이 덮을 자리)에서 0.5 mm 피아노선이나 기타 줄처럼 뻣뻣한 줄을 아래로 밀어 넣으면, 통로가 일직선이라 원뿔 슬롯으로 나옵니다. 서보선 끝을 테이프로 붙여 위로 당겨 올립니다.
   3. 데크 홈에서 나온 선을 스피곳 링 바깥 둘레의 턱(깊이 3.4 mm, 높이 5 mm)에 납작하게(폭이 세로가 되게) 눕혀 180° 쪽으로 돌립니다. 선은 180°로 가는 길에 그 사이의 키웨이(2026-11-03 시계 장착부터 둘레에 25개) 위를 여러 번 건너갑니다. 키웨이마다 턱 바닥에 4 mm 틈이 있고(탭 윗끝보다 8.65 mm 위), 선은 그 위를 건너가기만 합니다(틈 안으로 밀어 넣지 마세요). 0°의 모터 전선 홈 쪽으로는 돌리지 않습니다.
   4. 포드에서 원뿔 슬롯까지의 바깥 구간(납땜 이음매 포함)은 덕트와 핀 뿌리에 캡톤이나 알루미늄 테이프로 붙입니다. 베인을 손으로 ±25° 움직여 선이 혼·푸시로드에 닿지 않는지 확인합니다.
5. **흡입 모듈**:
   1. 흡입 모듈을 내리기 전에 맨 전선 세 가닥을 흡입 모듈 아래쪽에서 바깥 볼록 통로(0°)로 넣어, 선반 홈을 지나 창 안쪽으로 빼 둡니다. 통로 입구는 6 mm라 한 가닥씩 넣는 것이 쉽습니다. 서보선 네 가닥도 같은 방법으로 반대편 180° 볼록 통로 아래 입구로 넣어 선반 홈을 지나 창 안쪽으로 빼 둡니다. 흡입 모듈을 내릴 때 서보선이 스피곳 링 턱 안에 있어 스커트에 끼지 않는지 봅니다.
   2. 흡입 모듈을 내리기 전에 립이 가운데 오도록 손으로 맞춥니다. 탭이 EDF를 가운데로 잡아 주지 않기 때문입니다(립과 홈 사이 반경 여유 0.75 mm). 흡입 모듈을 스피곳에 끼우고 **M3×8** 나사 4개로 고정합니다. 결합 구멍은 막힌 구멍이라 더 긴 나사를 쓰면 바닥에 닿아 헛돕니다. 선반은 립 앞면에서 0.5 mm 위에 있고, 2026-11-03 시계 장착부터는 추력을 받는 멈춤입니다.
   3. 전선 끝에 4 mm 총알 커넥터를 납땜하고 수축 튜브를 씌웁니다. 전선은 0° 기둥 안쪽을 따라 케이블 타이로 묶고, 격벽의 전선 구멍(0°)을 지나 트레이 +x 면의 ESC로 갑니다.
   4. EDF 전선이 ESC에 닿지 않으면 부품표의 12 AWG 실리콘 전선과 4 mm 총알 커넥터로 늘리세요. 이음매는 흡입 모듈 창 안쪽 넓은 곳에 두는 것이 좋습니다.
   5. 서보선 네 가닥은 180° 기둥 안쪽을 따라 납작하게 모아 케이블 타이로 묶고, 격벽의 180° 서보선 구멍으로 넘깁니다. 창 쪽으로 늘어진 곳이 없어야 합니다(흡입 공기에 빨려 들어가면 팬이 칩니다). 넘긴 끝은 6단계에서 FCU에 연결합니다.
6. **FCU 보드 (v0.6.3, 흡입 격벽 위)**: 에이비오닉스 모듈을 끼우기 **전에** 합니다(검사 C25).
   1. FCU에는 서보 헤더(베인 4 + 사출 1), ESC 신호선, nlink·ilink 커넥터, 로그 선, 배터리 분압, 아밍 스위치·부저·LED, 5 V 전원이 모입니다. CAD는 FCU를 폼 테이프 위 15 mm 높이의 상자로 잡았습니다. 그 위로 트레이 아래 끝까지 2.0 mm, ESC와 기타 전자 상자까지 약 12 mm입니다(`python cad/layout.py`). 커넥터를 꽂은 높이를 재 봅니다.
   2. 3 mm 양면 폼 테이프를 보드 밑면에 붙이고, 격벽 윗면 가운데에 보드 모서리를 x·y축에 맞춰 놓습니다(보드가 축에서 ±25 mm). 가운데 Ø20 케이블 구멍은 보드가 덮습니다. 이 구멍으로는 아무 선도 지나가지 않습니다. 모터선은 0° 전선 구멍, 서보선은 180° 서보선 구멍을 씁니다.
   3. 케이블 타이를 대각선으로 마주 보는 통풍 구멍 두 개(45°와 225°, 또는 135°와 315°)로 넣습니다. 격벽 밑(흡입 창 안쪽)으로 돌려 보드 위를 대각선으로 가로질러 조입니다. 통풍 구멍 가장자리는 보드 모서리에서 0.64 mm 떨어져 있어 보드에 가려지지 않습니다.
   4. 서보선 4가닥을 180° 서보선 구멍에서 FCU 윗면 높이로 올리고, 보드의 −x 가장자리를 넘겨 서보 헤더로 가져갑니다. 각 선 끝에 3핀 커넥터를 압착하거나 서보 헤더 기판에 납땜합니다: 포드 1~4(24°·114°·204°·294°)의 신호선 → FCU PB5·PB6·PB7·PE3, 빨강 → 서보 5 V 줄(ESC BEC +5 V), 갈색 → GND. 서보 5 V 줄(FCU 서보 헤더의 V+ 줄과 사출 서보 V+)은 FCU의 VCC(UBEC 로직 5 V)와 연결하지 않습니다. GND는 공통입니다(`firmware/README.md` 4.5). 세 가닥을 가볍게 꼬고, 0° 쪽 모터 전선과 ESC에서 떨어뜨려 둡니다.
   5. 위로 올라갈 선(nlink, ilink, 로그, 5 V 전원, ESC 신호, 배터리 분압, 아밍 스위치·부저)을 FCU에 연결하고, 끝을 위로 모아 둡니다(9단계).
   6. 흡입–에이비오닉스 결합 나사(Z 340.4)는 FCU와 같은 높이에 있습니다. 하지만 나사 끝이 스피곳 안으로 21.6 mm 넘게 들어가야 보드에 닿으므로 키트 나사(5–20 mm)로는 닿지 않습니다.
7. **에이비오닉스**: 트레이 +x 면 아래쪽에 ESC, 위쪽(v0.5 비행 컴퓨터 자리, 44 mm 정사각 구멍 4개)에 **NAV 보드**를 붙입니다. −x 면에는 아래쪽에 UBEC·부저·아밍 스위치와 배선 묶음(`electronics.misc`, 40 g), **위쪽에 배터리**를 붙입니다. 배터리를 위에 두는 것은 무게중심을 올려 안정 여유를 확보하기 위해서입니다.
   * NAV는 v0.5 비행 컴퓨터 자리 그대로라서 IMU(GY-521) 장착 방향 규칙도 그대로입니다(`firmware/atmega128_fc/fc_config.json`의 `imu_mounting` = +x, +y, +z). 붙인 뒤 `firmware/README.md`의 IMU 장착 방향 절차로 축을 확인합니다. 맞지 않으면 `imu_mounting`을 고치고 `tools/gen_firmware_params.py`를 다시 실행한 뒤 NAV를 다시 올립니다.
   * 에이비오닉스 모듈을 흡입 모듈 스피곳에 끼우고, 트레이를 레일 홈에 위에서 밀어 넣습니다. 트레이는 레일 아래 끝의 멈춤 블록에 얹혀 설계 높이에 섭니다. 이때 FCU에서 올라오는 선이 트레이 아래 끝(FCU 윗면과 2.0 mm)에 끼지 않게 합니다. 모듈을 M3 4개로 고정합니다.
8. **COM 보드와 통신·로거 상자 (페이로드 격벽 아래)**: 페이로드 모듈을 에이비오닉스 모듈에 끼우기 전에 합니다.
   * **COM 보드 (v0.6)**: 페이로드 격벽 아래 보스 4개(축에서 x·y ±22 mm)에 아래에서 **M3×5** 나사로 고정합니다(검사 C22). 나사는 1.6 mm 보드를 지나 3.8 mm 막힌 구멍에 3.4 mm 물립니다. 더 긴 나사는 쓰지 마세요. 구멍 위 격벽이 1.2 mm뿐이라 스프링 쪽으로 뚫고 나갑니다. 부품은 아래로 매달리므로, 매달린 쪽에는 곧은 핀 헤더 대신 전선을 납땜하거나 ㄱ자 헤더를 씁니다. CAD는 보드 포함 15 mm 높이로 잡았고, 트레이 윗끝과 2.0 mm, 배터리와 5.0 mm 떨어집니다.
   * **통신·로거 상자 (v0.6.2)**: LoRa 모듈, OpenLog 호환 로거 + microSD, 두 번째 레벨 시프터, 두 번째 AMS1117-3.3은 트레이에 붙이지 않습니다. 이 네 가지를 30 × 20 × 15 mm 상자 하나로 묶어(`electronics.radio_log`, 20 g은 가정값이니 달아서 `params.json`에 넣으세요) **페이로드 격벽 아래면**에 매답니다(검사 C24). 위치는 축에서 40 mm, −y 쪽(θ −90°)으로 상자가 x −15…15 mm, y −50…−30 mm를 차지합니다. 격벽 아래 가운데의 COM 보드 바로 옆입니다. 양면 폼 테이프로 붙이고 케이블 타이로 한 번 더 묶습니다. 설계 틈새는 COM 보드와 5.0 mm, 스피곳 안벽과 4.8 mm, 트레이·레일·결합 나사와 7 mm 이상입니다(`python cad/layout.py`). 상자가 이보다 크면 붙이기 전에 알려 주세요.
   * LoRa 안테나는 동체 밖으로 내지 않습니다. 상자가 있는 −y 쪽 에이비오닉스 벽을 따라 안쪽에 세로로 늘어뜨리고, ESC·모터 전선·배터리 선과 나란히 달리지 않게 합니다(`firmware/README.md`의 안테나 배치). 이 상자를 격벽 아래로 올린 이유는 두 가지입니다. 무게중심을 올려 안정 여유를 늘리고, 안테나를 ESC와 모터 전선에서 떨어뜨리기 위해서입니다.
9. **배선 정리**: 핀 번호는 `firmware/atmega128_fc/src/board.h`가 기준입니다. 같은 핀 이름이라도 칩이 다르면 다른 핀입니다. 거리는 `python cad/layout.py`가 낸 상자 사이 최단 거리이고, 실제 선 길이는 조립하면서 잽니다.

   | 선 | 양 끝 | 연결 | 거리 · 주의 |
   |---|---|---|---|
   | nlink (SPI) | 트레이의 NAV ↔ 흡입 격벽 위 FCU | PB0 SS, PB1 SCK, PB2 MOSI, PB3 MISO를 같은 핀끼리 + GND | 최단 107 mm. 예산은 30 cm로 가정. FCU를 프로그래밍할 때 뺌 |
   | ilink (UART) | FCU ↔ 페이로드 격벽 아래 COM | FCU PD3 → 1 kΩ → COM PE0, COM PE1 → FCU PD2, GND (3선, 5 V 없음) | 최단 164 mm. 30 cm 가정. 페이로드 모듈을 떼어 낼 때와 COM을 프로그래밍할 때 뺌 |
   | 로그 | FCU ↔ 상자의 OpenLog | FCU PE1 → 시프터 → OpenLog RXI, GND. OpenLog 5 V는 아래 5 V 로직 전원에서 | 최단 167 mm. 아래 "로그 선" 참고 |
   | 무선 | COM ↔ 상자의 LoRa 모듈 | `firmware/README.md` 4.2(LoRa 결선, 핀은 모두 COM의 핀). MCU → 모듈 신호는 두 번째 시프터를 거침 | 상자와 COM 보드 5.0 mm |
   | ESC 신호 | FCU PE4 → ESC 신호선 | 10 kΩ 풀다운. ESC 빨간선(BEC +5 V)은 FCU 로직 5 V에 연결하지 않고 서보 5 V 줄에만 연결(6단계 4, `firmware/README.md` 4.5) | ESC와 12 mm |
   | 베인 서보 | 180° 서보선 구멍 → FCU | 6단계 4 | 1단계 길이 |
   | 사출 서보 | FCU PE5 → 페이로드 모듈 바깥 포드의 MG90S | **CAD에 이 선의 경로가 없습니다(NOT VERIFIED).** 조립 전에 경로를 정해 알려 주세요 | |
   | 배터리 전압 | 팩 + → 47 kΩ → FCU PF0 → 4.7 kΩ → GND | PF0에 100 nF | |
   | 아밍 스위치·부저·LED | FCU PC2, PC1, PC0 | 아밍 스위치는 GND로, 열림 = 안전 | |
   | 5 V 로직 전원 | UBEC → NAV, FCU, COM, OpenLog, 시프터 5 V 쪽 | 모든 보드의 GND를 공통으로. 서보 5 V 줄(ESC BEC)과는 잇지 않음 | |

   * **로그 선 (NOT VERIFIED)**: `firmware/README.md` 4.10. FCU PE1 → 레벨 시프터 한 채널 → OpenLog RXI(3.3 V)입니다. 첫 번째 시프터는 트레이의 NAV에 있고 OpenLog는 페이로드 격벽 아래 상자에 있습니다. 이 선이 어느 시프터 채널을 쓰는지는 정해지지 않았습니다. UART형 LoRa면 두 번째 시프터의 ch4가 비어 있고, SPI형이면 네 채널이 모두 쓰입니다. 산 OpenLog의 RXI 입력 전압을 확인한 뒤 정하세요.
   * **로그 선에는 커넥터가 꼭 있어야 합니다. 적어도 FCU 쪽 끝에 둡니다.** FCU를 프로그래밍할 때 이 선을 빼야 하기 때문입니다(`board.h`, 10단계 4). 예산안에는 이 커넥터가 없습니다.
   * 페이로드 모듈(COM 보드와 상자가 달림)을 떼어 낼 때는 ilink 커넥터와 로그 선 커넥터를 뺍니다. COM·상자의 5 V 전원선에 커넥터를 둘지는 정해지지 않았습니다(예산안에 없음).
   * 서보선, nlink, ilink는 0° 쪽 모터 전선과 ESC에서 떨어뜨려 묶습니다.
10. **프로그래밍 (세 보드)**: USBasp가 필요합니다(예산안의 추가 장비). 명령은 프로젝트 폴더에서 실행합니다.
    1. `params.json`, 게인, `fc_config.json`이 바뀔 때마다 `tools/gen_firmware_params.py`와 `tools/gen_gains_header.py`로 헤더를 다시 만들고, `.venv/Scripts/python.exe -m platformio run -d firmware/atmega128_fc`로 빌드합니다.
       * **2026-10-16 현재 이 단계는 경고 없이 끝납니다.** 게인(`sim/out/gains.json`)과 CAD 보고서를 지금 `params.json`(`0a5c261b…`)으로 다시 만들었고, `gen_firmware_params.py --check`와 `gen_gains_header.py --check`가 모두 "up to date"입니다(`gains.h`의 `GAINS_PARAMS_STALE` 0, params tag 0x6E). Fusion 360 재실행은 출력 파일용이고 헤더와는 상관없습니다(`firmware/README.md` 7.2).
    2. 퓨즈는 칩마다 한 번 씁니다: `... -e nav -t fuses`, `... -e fcu -t fuses`, `... -e com -t fuses`.
    3. NAV: `-e nav -t upload`, NAV의 ISP에 USBasp.
    4. FCU: `-e fcu -t upload`. **OpenLog를 뺍니다**(로그 선 커넥터, FCU PE0/PE1 = ISP). **NAV를 리셋 상태로 잡거나 nlink 커넥터를 뺍니다**(FCU PB1 = ISP SCK를 NAV가 구동).
       * **조립된 기체에서 FCU에 닿는 법.** FCU 윗면은 트레이 아래 끝과 2.0 mm 떨어져 있어 ISP 헤더에 손이 닿지 않습니다(`python cad/layout.py`). 아래 순서는 조립(6–7단계)의 역순입니다. 실물로 해 보지 않았습니다(NOT VERIFIED).
         1. 배터리를 분리합니다.
         2. 흡입–에이비오닉스 결합 나사 M3 4개(Z 340.4)를 풉니다. 페이로드 모듈과 노즈는 에이비오닉스 모듈에 붙은 채로 함께 들립니다.
         3. 에이비오닉스 모듈을 조금 들어 올리고, 흡입 모듈 쪽과 이어진 선을 모두 뺍니다. 모터 전선은 ESC 쪽 4 mm 총알 커넥터에서 뺍니다. FCU에서 위로 가는 선(6단계 5의 선: nlink, ilink, 로그, 5 V 전원, ESC 신호, 배터리 분압, 아밍 스위치·부저, 그리고 사출 서보)은 FCU 쪽에서 뺍니다. 그러려면 이 선들의 FCU 쪽 끝에 커넥터가 있어야 합니다. 들어 올릴 만큼의 선 여유 길이는 정해지지 않았습니다.
         4. 에이비오닉스 모듈을 들어 내면 흡입 모듈 스피곳 위로 FCU 윗면이 드러납니다. 서보선은 FCU에 꽂힌 채로 둡니다. nlink와 로그 선이 이미 빠져 있으므로 위의 준비가 된 상태입니다. 이때 FCU 전원을 USBasp로 줄지 UBEC로 줄지는 정해지지 않았습니다(`firmware/README.md` 7.3). 둘을 함께 연결하지 마세요.
         5. 다시 조립할 때는 7단계대로 하고, 뺀 커넥터를 모두 다시 꽂았는지 확인합니다.
       * FCU ISP 연장선을 꺼내 두는 방법은 설계되지 않았습니다(CAD에 경로 없음). 필요하면 경로를 정해 알려 주세요.
    5. COM: `-e com -t upload`(`params.json`의 `flight_computer.link.radio` 무선, 지금 `lora_uart`). 모듈 형식이 다르면 `com_lora_uart` 또는 `com_sx127x`. **ilink 커넥터를 뺍니다**(COM PE0/PE1 = ISP).
    6. ATmega128의 ISP 핀은 PE0/PE1/PB1/RESET입니다. PB2/PB3이 아닙니다.
    7. **세 칩에는 같은 `params.json`으로 만든 빌드를 올립니다.** 빌드마다 params 해시 한 바이트(params tag)가 들어갑니다. 확인은 두 가지를 따로 합니다(`firmware/README.md` 7.2). 이 표시는 비행을 막지 않으니 둘 다 직접 확인하세요.
       * COM ↔ FCU: FCU 로그(SD)의 `T` 기록 "COM boot: … params tag 0x.. match"를 봅니다. 다르면 "MISMATCH"가 남고 `S` 기록의 `com_flags`에 0x80이 켜집니다. NAV LED에는 나타나지 않습니다.
       * FCU ↔ NAV: NAV LED가 약 1초마다 두 번 깜빡이면 다릅니다. FCU 로그의 `N` 기록 NAV reset_cause 비트 0x20으로도 보입니다.
    8. `*_simbench`, `*_cosim` 빌드는 기체에 올리지 않습니다. `fcu_bench_*` 빌드로 시험한 뒤에는 `fcu`를 다시 올립니다.
11. **페이로드**: COM 보드와 상자가 달린 페이로드 모듈을 에이비오닉스 모듈에 끼우고 M3 4개로 고정합니다. 격벽 위에 스프링, 피스톤, 캔위성 순서로 넣습니다. 쇼크 코드 한쪽을 격벽 구멍에 묶고 캔위성 옆으로 올립니다.
12. **노즈**: 기체 낙하산을 노즈 안에 접어 넣고 쇼크 코드를 앵커바 구멍에 묶습니다. 노즈를 씌우고 스프링을 누른 채 래치 암을 래그 위로 돌려 잠급니다.
13. **무게중심 확인**: 캔위성 350 g을 실은 상태에서 무게중심이 배기구 끝에서 약 376.3 mm 위에 와야 합니다(CAD 376.3 mm, v0.6.3: 흡입 격벽 위 FCU 20 g, 트레이의 NAV 40 g, COM 보드 20 g, 격벽 아래 통신·로거 상자 20 g, 서보 연장선 21.5 g 포함. 정적 여유 0.51 cal, 검사 C13 WARN). FCU·COM·상자 질량과 서보선 10 g/m는 가정값입니다. 달아서 `params.json`에 넣으세요. 크게 다르면 안정 여유와 제어 게인이 달라지므로 실제 질량을 넣고 다시 계산합니다.
14. **VTOL 배터리 구성: 로직 전원 (2026-11-05, 사용자 결정 - `docs/v0.9_하드웨어_변경.md` 19장)**: 캐리어 PCB rev 2c는 따로 1S 로직 배터리로 켭니다. **배터리 구성에만** 넣습니다(유선·하이브리드 구성은 이 캐리어로 더 맞추지 않음).
    표시: M = CAD로 잰 값, E = 추정, A = 가정(산 물건으로 확인).
    1. **산 물건을 먼저 잽니다(A).** MTS-102 토글(디바이스마트 13029107): 부싱 지름·길이, 판 아래 몸통(가정 8 × 13 × 10 mm), 레버 높이(판 위 약 15 mm), 너트 맞변 거리(가정 8 mm), **접점 정격 ≥ 2 A**(물건 표시나 판매 페이지), **하네스 선 길이 ≥ 178 mm**(E; 짧으면 26 AWG 2가닥으로 늘린 뒤 JST-PH로 압착). 1S 배터리(디바이스마트 16021596): 10.5 × 55.5 × 67 mm, 84 g, 리드가 나오는 끝과 길이(**≥ 115 mm 필요**, E), 플러그 1번 핀 = +(계측기로). 다르면 `params.json` `configs.vtol.logic_power`를 고치고 CAD를 다시 만든 뒤 상단 캡을 출력합니다.
    2. **상단 캡**: 출력 파일 `cad/exports/print/provisional_v09_cadquery_vtol/top_cap.3mf`(스위치 구멍 Ø6.2 + **보호 칼라**, 부품 37.8 g, 필라멘트 64.5 g(서포트 26.7 g 포함), 2 h 48 min, M). 구멍은 r 43 mm, 140°(J15 바로 위)입니다.
       **보호 칼라 (2026-11-05, 사용자 결정 "상단 캡과 한 몸으로 출력하는 보호 칼라를 달아줘", `docs/v0.9_하드웨어_변경.md` 19.12)**: 스위치 둘레의 둥근 관이 캡과 한 몸으로 출력됩니다. 안지름 Ø21, 벽 2.4 mm, 판 위 17.2 mm, 레버가 젖혀지는 기체 y 방향 양쪽에 **U자 손가락 홈**(폭 17 mm, 바닥은 반지름 8.5 mm의 반원, 가장 낮은 곳은 판 위 5.0 mm). 붙이는 부품·접착제·나사가 없습니다.
       **출력 방향이 바뀌었습니다**: 칼라 때문에 캡을 **바로 세워**(스커트 끝이 판에, 윗면과 칼라가 위) 트리 서포트로 출력합니다. 3MF에 설정이 들어 있습니다. 예전처럼 윗면을 판에 놓으면 안 됩니다(캡이 칼라 위에 서고 윗면 전체가 서포트 위에 출력됨).
       출력 뒤 판 밑면의 구멍 둘레(안쪽 너트 자리)와 와셔 홈을 평평하게 다듬습니다(2장 출력 후 가공 9). 시간이 급하면 Bambu Studio에서 서포트를 일반(normal)으로 바꿔도 됩니다: 처음 칼라 설계(네모 홈)에서 1 h 49 min, 서포트 34.7 g(M)이었습니다.
       **먼저 레버를 잽니다**: 레버 끝이 판 위 15.06 mm(A 값으로 계산)보다 높으면 칼라 여유 2 mm가 모자랍니다. 그때는 `params.json` `configs.vtol.logic_power.collar.h`를 올리고 다시 만듭니다.
    3. **스위치 달기**: 안쪽 너트(와 잠금 와셔)를 부싱의 **몸통 쪽 끝까지** 돌려 내립니다. 판 아래에서 부싱을 구멍에 끼우고, 판 위에서 잠금 와셔와 바깥 너트로 조입니다. 부싱이 판 위로 약 5 mm(A) 나와야 CAD와 같습니다(레버 끝은 캡 위 약 15 mm). 레버는 기체 y 방향으로 젖힙니다(A).
       바깥 너트는 칼라 안에서 **8 mm 너트 드라이버나 깊은 소켓**으로 조입니다(칼라 안 여유 반경 5.9 mm, E). 스패너는 들어가지 않습니다.
       **주의(검토 F4)**: 반경 여유만 확인했습니다. 젖힌 레버는 부싱 끝 높이에서 축에서 약 4.2 mm(E) 나와 있어 8 mm 육각 소켓 안쪽(반지름 4.0 mm)에 걸릴 수 있습니다. **캡을 출력하기 전에 실물 소켓을 실물 스위치에 대 봅니다.** 위에서 도구가 안 들어가면: 판 위에서 잠금 와셔와 바깥 너트를 **손으로** 끝까지 돌려 놓고, 캡을 뺀 상태에서 스위치 몸통을 잡고 **판 아래의 안쪽 너트를 돌려** 조입니다. 부싱이 판 위로 나오는 길이(약 5 mm, C38)는 그대로 둡니다.
       하네스는 3선(2단 3P, SPDT)입니다. **가운데 선(공통)과 바깥 선 하나만** JST-PH 2핀 하우징에 다시 압착합니다(J15, 극성 없음). 남은 바깥 선은 잘라 수축 튜브로 덮습니다. 계측기로 ON 위치를 찾고, **칼라 바깥 벽**의 ON 쪽 손가락 홈 옆에 ON 표시를 합니다(레버는 칼라 안이라 캡 윗면에는 보이지 않습니다).
    4. **배터리 넣기 (A 자리)**: 6S 팩을 트레이 −x 면에 붙인 뒤, 1S 배터리를 6S 팩의 −x 면에 세워 붙입니다(넓은 면이 6S 쪽, 길이 방향이 위아래, 아래 끝을 6S 팩 아래 끝에 맞춤). **리드가 나오는 끝을 위로** 둡니다. 아래 끝은 트레이 바닥 높이(z 344.1)보다 2.0 mm 위이고 서보선 묶음까지 3.86 mm(M, C37)라 선을 굽힐 자리가 없습니다.
       **6S 감지선(J18)**: J18 플러그는 1S 배터리 바로 아래(캐리어 위 4 mm 틈)에 있습니다. 감지선 경로는 CAD에 없습니다(6S 리드가 나오는 끝을 모름, A). 1S 배터리 −x 면과 관 벽 사이(J18 높이 y −17.7에서 7.7 mm, M)로 올리거나, 6S 팩 아래 4 mm 틈(M)으로 지나게 합니다. 1S 배터리와 관 벽 사이 모서리(3.0 mm)에는 넣지 마세요. 실제 길을 재서 알려 주세요.
    5. **고정**: 6S 팩의 아래 끈을 길게 해서 두 팩을 함께 감고, 위쪽(배터리 윗끝에서 10 mm 아래)에 케이블 타이를 하나 감습니다. 타이는 트레이 경량 구멍의 **바깥 끝**(|y| 33 mm)으로 지나게 합니다(A). 새 출력 부품은 없습니다. 꽉 당기고 흔들어 봅니다(착지 충격 약 16.5 N, E).
       길게 한 아래 끈은 이제 6S 팩 모서리를 직접 감지 않습니다(1S 배터리가 사이에 있음). 6S 팩 아래쪽은 끈이 1S를 통해 누르는 힘(마찰)과 위 끈으로 잡힙니다. 흔들 때 6S 아래쪽이 옆으로 밀리지 않는지 봅니다.
    6. **배터리 선**: 배터리 윗끝에서 리드를 +y 끝 쪽(관 벽 쪽)으로 넘겨 옆으로 내리고, 보드 −x/+y 모서리의 J14에 꽂습니다. 필요한 길이 약 115 mm(E). PCB 라운드는 리드가 +y 끝에서 나와 6 mm만 내려온다고 가정했습니다. CAD는 윗끝(A)이라 더 깁니다. 리드가 115 mm보다 짧으면 Molex 5264 2핀 연장선(암-수, 약 60 mm, 1번 = + 유지)을 만듭니다.
       배터리 선은 **끈 바깥쪽**으로 내립니다(끈 위를 지나감, E). 6S 팩 위나 서보선 묶음 위로 지나가지 않게 합니다.
    7. **스위치 선**: 캡을 씌우기 전에 스위치 선(약 178 mm, 여유 60 mm 포함, E)을 J15(J14 바로 옆, −x/+y 모서리)에 꽂습니다. 선은 스위치에서 똑바로 내려옵니다. 선은 **끈과 타이 고리 안쪽**(1S 배터리 +y 끝 옆)으로 내립니다. 타이가 선을 살짝 눌러 잡아 줍니다(E). 끈을 조일 때 두 선이 끈 밑에서 꺾이지 않게 합니다. 캡을 씌울 때 선이 스커트에 끼지 않게 합니다.
    8. **캡 떼기·달기**: 캡 나사는 **M3×6 이하** 4개입니다(M3×8부터는 135° 나사 끝이 스위치 몸통에서 2 mm 안으로 들어옵니다: M3×6은 2.63 mm(Layout, 나사 끝을 둥글게 본 보수적 값)·3.76 mm(C38 고체), M3×8은 1.03 mm(Layout이 거부), M). M3 4개를 풀고 캡을 들어 올린 뒤(스커트 물림 15 mm, 선 여유 60 mm), J15에서 스위치 선을 뺍니다. 손이 안 닿으면 136° 창(J15에서 17 mm, M)으로 핀셋을 씁니다. 배터리를 오래 둘 때는 J14도 뺍니다.
    9. **켜기 순서 (PCB README 7.2)**: 로직 스위치를 켠 뒤 6S를 꽂고, 6S를 먼저 뺀 뒤 로직을 끕니다. 레버는 기체를 닫은 채 캡 위에서 손가락으로 젖힙니다.
       레버는 칼라의 **손가락 홈 쪽에서** 손끝을 옆으로 넣어 반대쪽으로 넘깁니다. 켤 때와 끌 때 쓰는 홈이 다릅니다(홈 하나가 한 방향). 홈은 손끝(Ø16 가정, A)이 레버를 가운데 너머로 미는 동안 내내 홈 옆면에서 0.5 mm씩 떨어지게 폭 17 mm로 만들었습니다(E/M, C41). 손가락으로 양쪽 다 젖혀지는지 처음 조립할 때 확인합니다.
       **이제 기체의 가장 높은 곳은 칼라 테두리입니다**(z 492.50, 레버보다 2.2 mm 높음, M). 뒤집어 놓거나 윗 모서리로 넘어져도 바닥은 테두리에 닿고 레버에는 닿지 않습니다(C39 PASS). 홈으로 옆에서 들어오는 막대·풀은 막지 못하니 레버 근처를 잡고 옮기지 마세요.
    10. **충전**: 충전 단자가 없습니다. 캡을 떼고 J14를 뺀 뒤 끈과 타이를 풀어 배터리를 꺼내 1S Li-Po 충전기로 충전합니다(A).
    11. **무게**: 이 부품들(부품 약 91.4 g + 구멍·칼라로 캡 +2.6 g = 약 +94 g, M/A)은 아직 비행 질량 모델에 넣지 않았습니다(사용자 결정, `logic_power.in_flight_mass_model` false). 달아서 적어 두세요. 결정 대기 보고서: `cad/exports/logic_power_pending_mass_vtol.md`.
