Yuchan-00/CanSat_EDF_Rocket/sizing/tw_table_v09.md

# v0.9 추력/무게 비와 호버 스로틀 (4개 구성)

params.json sha256 `3419c5fea63506dc…`. 추력은 모릅니다(판매처 3.09 kgf 미검증). 표는 추력 가정별입니다.
호버 스로틀 u = (W/T_max)^(1/2). 전력 P1 = 프록시 효율, P2 = 비관적 모델(T_max에서 2,264 W).

| 구성 | 질량 (g) | 2.0 kgf | 2.3 kgf | 2.6 kgf | 3.09 kgf | T/W 1.3이 되는 추력 | 모터선 항력 포함 (E) |
|---|---|---|---|---|---|---|---|
| VTOL 배터리 | 1653.7 | T/W 1.21, u 0.91 | T/W 1.39, u 0.85 | T/W 1.57, u 0.80 | T/W 1.87, u 0.73 | 2.15 kgf | 2.22 kgf (Cd 0.8-1.2: 2.21-2.24) |
| VTOL 하이브리드 | 1526.8 | T/W 1.31, u 0.87 | T/W 1.51, u 0.81 | T/W 1.70, u 0.77 | T/W 2.02, u 0.70 | 1.98 kgf | 2.05 kgf (Cd 0.8-1.2: 2.04-2.06) |
| VTOL 유선(배터리 없음) | 1405.8 | T/W 1.42, u 0.84 | T/W 1.64, u 0.78 | T/W 1.85, u 0.74 | T/W 2.20, u 0.67 | 1.83 kgf | 1.89 kgf (Cd 0.8-1.2: 1.88-1.90) |
| 로켓 | 2609.2 | T/W 0.77, u - | T/W 0.88, u - | T/W 1.00, u - | T/W 1.18, u 0.92 | 3.39 kgf | 3.50 kgf (Cd 0.8-1.2: 3.48-3.53) |

모터선 항력(E): 모터선 묶음(수축 튜브로 묶인 3가닥, 사진 기준)이 배기 바람을 가로지르며 받는 힘 D = Cd q A (Cd 1.0, 0.8-1.2 ASSUMED, A = Layout.ml_jet_drag). 추력의 약 3.2 % / 3.2 % / 3.2 % / 3.2 %를 먹습니다. T/W 칸은 질량만 반영한 값입니다. 실측이 필요합니다. 이 EDF는 공장에서부터 선이 바람 속에 있으므로, 이 EDF를 조립한 그대로 시험대에서 잰 추력에는 이 항력이 이미 들어 있습니다. 그 값을 쓸 때는 항력을 다시 빼지 않습니다(두 번 빼는 셈). 항력 보정은 다른 EDF의 표(프록시) 추력에만 씁니다.

추력은 ESC 22.2 V 기준입니다. 팩이 셀당 3.7 V까지 내려가면(전 스로틀 전압 처짐 포함) 추력이 줄어듭니다:

| 구성 | 2.0 kgf | 2.3 kgf | 2.6 kgf | 3.09 kgf | 끝까지 T/W 1.3에 필요한 22.2 V 추력 |
|---|---|---|---|---|---|
| VTOL 배터리 (셀당 3.7 V, 20.4 V) | T/W 1.05 | T/W 1.21 | T/W 1.37 | T/W 1.63 | 2.47 kgf |
| 로켓 (셀당 3.7 V, 20.4 V) | T/W 0.67 | T/W 0.77 | T/W 0.87 | T/W 1.03 | 3.90 kgf |

유선·하이브리드는 전원 장치 1대(Mean Well RSP-1500-24, 25.2 V / 60 A, 8.5 m 10 AWG)의 한계가 있습니다. 전원 한계 T/W (P1 / P2, 질량만 반영 - 모터선 항력 미포함):

| 구성 | 2.0 kgf | 2.3 kgf | 2.6 kgf | 3.09 kgf |
|---|---|---|---|---|
| VTOL 유선(배터리 없음) (전원 1대) | 1.36 / 0.98 | 1.52 / 1.13 | 1.52 / 1.28 | 1.52 / 1.52 |
| VTOL 하이브리드 (전원 1대) | 1.26 / 0.90 | 1.40 / 1.04 | 1.40 / 1.18 | 1.40 / 1.40 |

## 호버 전력·전류 (P1 / P2, 22.2 V 기준)

질량만 반영한 값입니다(모터선 항력 미포함). 항력 D/T = k 이면 호버 추력이 1/(1-k)배, 전력은 약 (1/(1-k))^1.5 배가 됩니다: 5.0 % / 5.0 % / 5.0 % / 5.0 % 더 (E). 시뮬레이션도 아직 이 항력을 넣지 않았습니다.

| 구성 | 추력 | P1 W | P1 A | P2 W | P2 A |
|---|---|---|---|---|---|
| VTOL 배터리 | 2.0 kgf | 886 | 39.9 | 1702 | 76.7 |
| VTOL 배터리 | 2.3 kgf | 886 | 39.9 | 1380 | 62.2 |
| VTOL 배터리 | 2.6 kgf | 886 | 39.9 | 1148 | 51.7 |
| VTOL 배터리 | 3.09 kgf | 886 | 39.9 | 886 | 39.9 |
| VTOL 하이브리드 | 2.0 kgf | 786 | 35.4 | 1510 | 68.0 |
| VTOL 하이브리드 | 2.3 kgf | 786 | 35.4 | 1224 | 55.2 |
| VTOL 하이브리드 | 2.6 kgf | 786 | 35.4 | 1019 | 45.9 |
| VTOL 하이브리드 | 3.09 kgf | 786 | 35.4 | 786 | 35.4 |
| VTOL 유선(배터리 없음) | 2.0 kgf | 695 | 31.3 | 1334 | 60.1 |
| VTOL 유선(배터리 없음) | 2.3 kgf | 695 | 31.3 | 1082 | 48.7 |
| VTOL 유선(배터리 없음) | 2.6 kgf | 695 | 31.3 | 900 | 40.5 |
| VTOL 유선(배터리 없음) | 3.09 kgf | 695 | 31.3 | 695 | 31.3 |
| 로켓 | 2.0 kgf | - | - | - | - |
| 로켓 | 2.3 kgf | - | - | - | - |
| 로켓 | 2.6 kgf | - | - | - | - |
| 로켓 | 3.09 kgf | 1757 | 79.1 | 1757 | 79.1 |

## 베인 권한: 로켓 → VTOL 배터리

| 항목 | 호버 추력에서 로켓 | VTOL | 비 | 공칭 추력에서 로켓 | VTOL | 비 |
|---|---|---|---|---|---|---|
| thrust_N | 25.59 | 16.22 | 0.634 | 30.3 | 30.3 | 1.000 |
| lever_arm_mm | 349.5 | 208.3 | 0.596 | 349.5 | 208.3 | 0.596 |
| M_pitch_Nm | 1.418 | 0.5356 | 0.378 | 1.679 | 1.001 | 0.596 |
| I_xx_kg_m2 | 0.1332 | 0.03551 | 0.267 | 0.1332 | 0.03551 | 0.267 |
| alpha_pitch_rad_s2 | 10.65 | 15.08 | 1.417 | 12.61 | 28.18 | 2.236 |
| M_roll_Nm | 0.2271 | 0.144 | 0.634 | 0.269 | 0.269 | 1.000 |
| I_zz_kg_m2 | 0.005079 | 0.003312 | 0.652 | 0.005079 | 0.003312 | 0.652 |
| alpha_roll_rad_s2 | 44.72 | 43.47 | 0.972 | 52.96 | 81.23 | 1.534 |

## 무게중심·넘어짐

| 구성 | CG z (mm) | 베인 팔 (mm) | Ixx (kg m²) | 넘어짐 각 (핀 쪽 / 핀 사이) |
|---|---|---|---|---|
| VTOL 배터리 | 245.3 | 208.3 | 0.0355 | 26.7° / 19.6° |
| VTOL 하이브리드 | 232.5 | 195.5 | 0.0322 | 28.0° / 20.6° |
| VTOL 유선(배터리 없음) | 219.8 | 182.8 | 0.0293 | 29.3° / 21.7° |
| 로켓 | 386.5 | 349.5 | 0.1332 | 17.7° / 12.7° |
