Yuchan-00/CanSat_EDF_Rocket/docs/v0.9_하드웨어_변경.md

# v0.9 하드웨어 변경 - VTOL 구성 + 검토 수정 (CAD-2 → 수정 라운드, 2026-10-28)

사용자 결정 1(직접 구동 베인), 2(경량화, VTOL 구성), 3(모터 선), 4(추력 표), 5(유선 전원)를 CAD에 넣은 결과입니다.
CAD-2(2026-10-27) 뒤에 독립 검토 3건(형상, 무게, 렌더)이 결함을 찾았습니다. 이 문서는 그 결함을 고친 **수정 라운드** 기준입니다.
모든 숫자는 이번에 직접 돌린 도구(CadQuery 트윈, 형상 검사, Bambu Studio 슬라이서, Fusion 스크립트 재생, 크기 산정)에서 나왔습니다.
재지 않은 값은 ASSUMED(추정)로 표시했습니다.

> **2026-11-05 로직 전원(19장, VTOL 배터리 구성만)**: 캐리어 PCB rev 2c의 1S 로직 배터리(84 g)를 6S 팩 −x 면(A 자리)에, MTS-102 스위치를 상단 캡 구멍에 넣었습니다. 새 검사 C37-C40 PASS. **질량은 사용자가 나중에 정합니다**: 시뮬레이션·펌웨어가 읽는 무게는 그대로 1,653.7 g이고, 넣으면 **1,747.71 g(+94.01 g, M/A, 스위치 보호 칼라 포함)**입니다. 유선·하이브리드 구성은 이 캐리어로 더 맞추지 않습니다(사용자 결정).
>
> **2026-11-05 스위치 보호 칼라(19.12, VTOL 배터리 구성만)**: 사용자 결정 "상단 캡과 한 몸으로 출력하는 보호 칼라를 달아줘". 칼라(Ø21 / Ø25.8, 판 위 17.2 mm, U자 손가락 홈 2개)가 상단 캡과 한 몸으로 출력됩니다. C39 WARN → PASS, 새 검사 C41 PASS. 비행 질량 1,653.70 g은 그대로입니다(칼라도 `in_flight_mass_model` false 뒤). 캡은 이제 바로 세워 트리 서포트로 출력합니다(2 h 48 min).
>
> **2026-11-04 흰색 몸통 + YUCHAN 로고(18장)**: 출력 부품 모두 흰색(Ivory White), 전자부 모듈 양옆에 주황(Mandarin Orange) 세로 로고를 AMS 2색 상감(0.42 mm)으로 넣었습니다. 전자부 모듈 출력이 색 바꿈 580번, +14 h 34 min, 버리는 양 181 g 늘어납니다(M). 무게: VTOL 배터리 **1,653.8 g**, 유선 1,405.9 g, 하이브리드 1,526.9 g, 로켓 2,599.3 g. 새 검사 C36 PASS. 발사대는 검정 그대로.
>
> **2026-11-03 모터선 통로를 "재지 않아도 맞게" 바꿨습니다(17장, 시계 장착).** EDF를 돌려 선 묶음을 하나의 통로(블리스터)에 맞추고,
> 탭은 키웨이 **25개** 중 가까운 곳에 들어갑니다(탭 나사 없음). 공장 수축 튜브는 그대로, 출구 각도는 어디든, 선 지름 4.3 mm, 굽힘 7-15 mm까지 받습니다.
> **2026-11-04 수정 라운드(17.16)**: 독립 검토가 찾은 약한 슬리브 이빨(1.73 mm)을 없앴습니다(키웨이 27 → 25개, 이빨 5.3 mm 이상, 토크 안전율 5.9).
> 조립 순서를 고쳤습니다(선을 **먼저** 굽히고 EDF를 내림). 비스듬히 누운 납작 묶음도 모든 경우 검사에 넣었습니다(864개).
> 무게: VTOL 배터리 **1,653.6 g**(목표보다 3.6 g 무거움), 유선 **1,405.7 g**(5.7 g), 하이브리드 1,526.7 g, 로켓 2,599.1 g.
> C33(옆 치우침): 유선 **FAIL 14.0 %**, 하이브리드 **FAIL 11.2 %**, 배터리 WARN 7.7 %, 로켓 WARN 5.7 % - 사용자 결정(17.10).
> 아래 인용(2026-10-29)과 1-16장의 숫자는 그 전 값입니다.
>
> **2026-10-29 모터선 출구 수정(17장, 사용자 사진 기준으로 다시 씀)으로 무게와 검사가 바뀌었습니다.** VTOL 배터리 1,647.2 → **1,655.1 g**(목표 1,650 g 초과),
> 유선 1,399.3 → **1,407.2 g**(목표 1,400 g 초과), 하이브리드 1,520.3 → 1,528.2 g, 로켓 2,592.6 → 2,600.3 g.
> 배기 속 모터선 묶음 항력(추정)을 넣은 C33: 유선 **WARN 9.9 %**, 하이브리드 WARN 7.6 %, 배터리 PASS 4.4 %.
> **같은 날 독립 검토 반영(17장 수정 라운드)**: 공장 수축 튜브를 14 mm로 다시 씌우는 조립 규칙. 무게·출력 파일은 그대로.
> C33은 Cd 범위의 나쁜 쪽 끝으로 판정: 유선 **FAIL 10.3 %(끝 10.8 %)**, 하이브리드 WARN 7.9 %, 배터리 **WARN 4.7 %(끝 5.2 %)**.
> (2026-11-03부터 출구 각도는 재지 않습니다 - 17장.)
> 같은 날 오전의 1차 모델(모터 몸통을 타고 올라감)은 사진으로 틀린 것이 확인되어 `history/v0.9_wire_round1/`에 보관했습니다.
> 아래 1-16장의 숫자는 그 전(2026-10-28) 값입니다. 바뀐 값은 17장을 보세요.

## 0. 이번 수정 라운드에서 고친 것

| 검토 결함 (심각도) | 고친 방법 | 확인 |
|---|---|---|
| 모터 선을 설치할 수 없음 (형상, 높음). 립 포켓 벽이 닫힌 고리 | 모터 선 쪽(0°)에 **폭 6 mm 슬릿**을 립 포켓 벽에 냄. 흡입부를 들고 불릿을 안쪽으로 올린 뒤, 선만 슬릿으로 빼서 홈에 넣음 | C29: 선 통과 0 mm³, 벽 고리 98.3 %(열림). 출력 STL 단면 6곳에서도 열림 |
| 베인 축이 빠질 수 있음 (형상, 높음). 안쪽으로 26 mm 밀림 | 커플러에 **M2 무두볼트**(컵 포인트)를 넣어 축의 D컷을 누름. 축 D컷은 서비스 쪽(+v)으로 돌림 | C28: 안쪽 0.3 mm에서 멈춤(물림 6.5 mm의 절반보다 훨씬 작음), 바깥 2.0 mm(덕트 벽) |
| 모터 선이 흡입실에서 129 mm 매달림, EDF 입구 반지름 안쪽 (형상 높음, 렌더 중간) | 0° 지주 안쪽 면에 **케이블 타이 고정점 3개**(45° 지붕, 서포트 없음). 격벽 구멍 20 × 11 mm, r 42-53으로 바깥쪽으로 이동 | C29: 선이 입구 반지름보다 3.5 mm 바깥, 최대 자유 길이 31.4 mm (40 mm 이하) |
| 서보 빼는 순서가 막힘 (형상, 중간) | 순서를 정함: 무두볼트 풀기 → 베인을 7.5 mm 이상 안쪽으로 밀기 → 서보 빼기. 검사에 축을 넣음 | C5: 밀어 넣은 상태 0 mm³, 육각 렌치 경로 0 mm³ |
| 베인 유격 7-8° (형상, 중간) | 무두볼트로 D컷 유격 없앰. 혼 홈 맞춤 0.05 mm. 서보와 덮개 사이 **EVA 폼 3 mm**(27-50 % 압축) | 남는 유격 추정: 홈 0.65° + 기어 1° (ASSUMED) = 약 1.7° (전체 폭) |
| 커플러-혼 나사 자리가 없음 (형상, 중간) | 나사 없이 **혼 소켓**: 2암 혼을 8.8 mm로 잘라 커플러 홈에 끼움. 혼 나사 머리는 둥근 구멍 안 | 혼 나사 머리와 축 끝 간격 2.4 mm > 바깥 이동 2.0 mm. 홈 벽 두께 1.30 mm |
| 유선 부품 형상 없음, 전선 구멍이 트레이 위 (형상, 중간) | 커패시터, 클램프, XT90-S(+ 하이브리드 다이오드 보드)를 **상자로 모델링**. 전선 구멍을 180°(배터리 칸 위)로, GPS 패치를 0°로 | C14, C25, C30 통과. 커패시터-ESC 입력 34.5 mm (50 mm 이하) |
| 아이볼트 보강판 부족, 배터리와 1.2 mm (형상, 중간) | **D32 × 2 mm 알루미늄 와셔**를 허브 바닥 홈에 넣고 M5 × 16 + 얇은 너트 | C30: 볼트 끝-배터리 4.2 mm (3 mm 이상) |
| 힌지 보스 유격 0.4 mm, 서포트 자국 축 (형상, 중간) | **황동 부싱 6 × 0.45 mm** (안지름 5.1 ASSUMED). 보스 구멍 6.0으로 넓힘. 축은 손으로 다듬어 맞춤 | 기울어짐 2.94° → 0.82° |
| 핀 경량 구멍 강도 과대평가 (무게, 높음) | **구멍 삭제**. 핀은 다시 꽉 찬 판 | 손 계산 여유 8.5배 (구멍 있을 때 약 1.5배) |
| 무게중심이 옆으로 치우침 (무게, 중간) | 트레이 면을 x 25 → 14.6 mm로 옮김. 유선 부품을 -x 쪽에 둠. 새 검사 C33 | 배터리 3.06 → 0.61 mm, 유선 5.71 → 2.06 mm, 하이브리드 6.24 → 1.52 mm |
| 하이브리드 "전선만으로 호버" 조건부 (무게, 중간) | 전원 한계·버퍼 분담 표를 추가 (5장) | 팬이 약하면(P2) 버퍼가 호버 중에도 방전 |
| 유선 T/W에 전원 한계가 빠짐 (무게, 중간) | 전원 장치 1대 한계 T/W 행 추가 (5장) | P1 1.37-1.52, P2 0.99-1.52 |

작은 결함도 고쳤습니다.
* 22 mm 슬롯 옆 얇은 조각(0.035 mm)과 흡입부 홈 가장자리 조각: 절단면 위치를 바꿔 없앰. 출력 STL 두께 조사로 확인.
* `Shape.Volume()` 오차(추진 모듈 -0.7 %): STL 검사와 경량화 계산에 정밀 부피를 씀. 덕트 21.4 g, 페어링 8.3 g으로 고침(전 23.1 / 11.1 g).
* STL 오차가 한계를 넘어도 조용히 넘어가던 문제: 이제 경고를 냄.
* 추력의 전압 조건, 1500 mAh 팩 문구, CAD-1 문서의 옛 VTOL 추정, 발자국 메모: 고쳤습니다(아래).

## 1. 한눈에 보기

* **VTOL 배터리 구성: 1,647.2 g** (목표 1,650 g 이하, 여유 2.8 g). CAD-2보다 +11.0 g (꽉 찬 핀, 부싱).
* **배터리 없는 유선 구성: 1,399.3 g** (목표 1,400 g 이하, 여유 0.7 g). 하이브리드: 1,520.3 g.
* 로켓 구성: 2,592.6 g (비행 질량 2,602.6 g). +1.0 g (부싱 4개 +1.9 g, 나사 -1.0 g).
* 두 목표 모두 **추정 질량을 포함해서** 겨우 맞습니다. 결합 나사, 캐리어, 선 무게를 재면 바뀝니다.
* T/W 1.3이 되는 추력: VTOL 배터리 **2.14 kgf**, 하이브리드 1.98 kgf, 유선 1.82 kgf, 로켓 3.38 kgf.
* 형상 검사: 로켓 0 FAIL / 3 WARN, VTOL 배터리 0 / 1, 유선 0 / 2 (C33 7.0 %), 하이브리드 0 / 1, KAIST 0 / 2.
* 설정 스위치는 그대로입니다: `mission.config`("rocket" | "vtol"), `power.source`("battery" | "tether" | "hybrid"). 기본값은 아직 "rocket"입니다.

## 2. VTOL 구성에서 바뀐 것

| 항목 | 로켓 | VTOL (수정 후) |
|---|---|---|
| 맨 위 | 노즈콘 + 페이로드 모듈 + GPS 포드 | **탑캡** (GPS 위, 테더 고정점, 전선 구멍 180°, 무장 스위치) |
| 캔위성·낙하산·피스톤·스프링·분리 서보·걸쇠 | 있음 | 없음 |
| 비행 컴퓨터 | 보드 4개 + 무선 상자 | **캐리어 PCB 1장** (ATmega128A 4개 + 5번째 자리. 2026-11-05 rev 2b에서 5번째 자리를 뺐습니다(사용자 결정)) |
| 항공전자 모듈 | 200 mm 튜브 | 150 mm, 육각 창 14개 (옆 창 90/112/248/270°) |
| 트레이 | 160 × 100 mm, x 25 | 112 × 107.5 mm, **x 14.6**, 경량 구멍 |y| 4-33 |
| 덕트 벽 / 페어링 벽 | 2.4 / 1.6 mm | 1.6 / 1.2 mm |
| 핀 | 꽉 찬 판, 길이 76 | **꽉 찬 판**(구멍 삭제), 길이 76.8 (발자국 246.8 mm 유지) |
| EDF 구간 / 흡입 격벽 | 100 mm / 2.0 mm | 92 mm / 1.2 mm |

두 구성 모두 같은 것(수정 라운드): 립 포켓 슬릿, 지주 고정점 3개, 격벽 구멍 20 × 11 mm(r 42-53), 혼 소켓 커플러 + 무두볼트, 황동 부싱, EVA 폼.

## 3. 무게 표 (CAD-2 → 수정 후)

| 구성 | CAD-2 g | 수정 후 g | 차이 | 출력 부품 g |
|---|---|---|---|---|
| 로켓 (CAD) | 2,591.6 | **2,592.6** | +1.0 | 944.4 → 945.1 |
| 로켓 (비행 질량, +10 g) | 2,601.6 | **2,602.6** | +1.0 | |
| VTOL 배터리 | 1,636.2 | **1,647.2** | +11.0 | 558.2 → 568.8 |
| VTOL 유선 | 1,388.3 | **1,399.3** | +11.0 | 558.2 → 568.8 |
| VTOL 하이브리드 | 1,509.3 | **1,520.3** | +11.0 | 558.2 → 568.8 |
| KAIST (참고) | 4,396.8 | 4,396.8 | 0 | |

VTOL 배터리의 +11.0 g 내역: 추진 모듈 +10.8 g(꽉 찬 핀 약 +8 g, 핀 길이 +0.6 g, 부싱 구멍·슬롯), 부싱 4개 +1.9 g, 흡입부 +0.6 g(고정점), 커플러 +0.2 g,
트레이 -0.4 g(넓어졌지만 구멍도 키움), 탑캡 -0.45 g(와셔 홈), 베인 나사 추정 -1.0 g(커플러 나사 8개 없어짐), 모터 선 -0.5 g(경로가 짧아짐).
유선·하이브리드 부품은 무게는 같고(추정) 덩어리 대신 상자·고체로 바뀌었습니다.

## 4. 줄인 무게, 단계별 (로켓 → VTOL 배터리, 945.5 g)

각 형상 단계는 그 단계만 끈 모듈과 켠 모듈을 만들어 **정밀 부피** 차이를 재고, 슬라이서의 유효 밀도로 g로 바꿨습니다(`sizing/vtol_savings.py`).

| 단계 | g |
|---|---|
| 페이로드 묶음 제거 | 670.0 |
| 보드 4개 → 캐리어 PCB (ASSUMED) | 76.6 |
| 노즈콘 + GPS 포드 뚜껑 → 탑캡 | 38.2 |
| 항공전자 창 14개 | 35.6 |
| 항공전자 튜브 200 → 150 mm | 30.9 |
| 덕트 벽 2.4 → 1.6 mm (정밀 부피, 전 23.1) | 21.4 |
| 기타 전자 40 → 25 g (ASSUMED) | 15.0 |
| 트레이 경량 구멍 | 14.0 |
| 트레이 160 → 112 mm | 12.5 |
| 흡입 격벽 2.0 → 1.2 mm | 10.8 |
| EDF 구간 100 → 92 mm | 10.0 |
| 페어링 벽 1.6 → 1.2 mm (정밀 부피, 전 11.1) | 8.3 |
| GPS 접지판·선 | 3.8 |
| 트레이 107.5 mm로 넓힘 (수정 라운드, 비용) | -2.0 |
| 핀 길이 76.8 mm (수정 라운드, 비용) | -0.6 |
| ~~핀 경량 구멍~~ | 삭제 (강도) |

## 5. 추력/무게 비와 호버 스로틀

추력은 모릅니다. 판매처 3.09 kgf는 검증되지 않았습니다. 호버 스로틀 u = (무게/추력)^(1/2). 추력은 ESC 22.2 V 기준입니다.

| 구성 | 질량 g | 2.0 kgf | 2.3 kgf | 2.6 kgf | 3.09 kgf | T/W 1.3이 되는 추력 |
|---|---|---|---|---|---|---|
| VTOL 배터리 | 1,647.2 | 1.21 (u 0.91) | 1.40 (0.85) | 1.58 (0.80) | 1.88 (0.73) | 2.14 kgf |
| VTOL 하이브리드 | 1,520.3 | 1.32 (0.87) | 1.51 (0.81) | 1.71 (0.76) | 2.03 (0.70) | 1.98 kgf |
| VTOL 유선 | 1,399.3 | 1.43 (0.84) | 1.64 (0.78) | 1.86 (0.73) | 2.21 (0.67) | 1.82 kgf |
| 로켓 (비행 질량) | 2,602.6 | 0.77 (호버 불가) | 0.88 (불가) | 1.00 (1.00) | 1.19 (0.92) | 3.38 kgf |

**전압 조건 (새로 추가).** 팩이 셀당 3.7 V이고 전 스로틀이면 ESC 전압은 약 20.4 V입니다(내부 저항 18 mΩ ASSUMED). 추력은 0.87배(T ∝ V^1.61)입니다.
그때 VTOL 배터리 T/W: 1.06 / 1.22 / 1.37 / 1.63. 비행 끝까지 T/W 1.3을 지키려면 22.2 V 기준 추력이 **2.46 kgf 이상**이어야 합니다.

**전원 장치 한계 (새로 추가).** Mean Well RSP-1500-24 1대(25.2 V, 60 A), 8.5 m 10 AWG(루프 59.5 mΩ)에서 ESC 전압 21.6 V, 1,298 W가 한계입니다.

| 구성 (전원 1대) | 2.0 kgf | 2.3 kgf | 2.6 kgf | 3.09 kgf |
|---|---|---|---|---|
| 유선, P1 / P2 | 1.37 / 0.99 | 1.52 / 1.13 | 1.52 / 1.28 | 1.52 / 1.52 |
| 하이브리드(전선만), P1 / P2 | 1.26 / 0.91 | 1.40 / 1.04 | 1.40 / 1.18 | 1.40 / 1.40 |

P1 = 판매처 표 효율, P2 = 비관적 모델(T_max에서 2,264 W). 팬이 P2처럼 약하면 전원 1대로는 T/W 1.3이 안 됩니다. **전원 장치는 추력 시험 뒤에 사세요.**

**하이브리드 조건 (고침).** 전선 전류가 40.3 A(버퍼 22.8 V)를 넘으면 버퍼 배터리가 같이 방전합니다.
P1이면 호버 전류 33.7 A라 전선만으로 됩니다. P2이면 2.0 kgf에서 버퍼가 25.5 A를 내고 약 73초, 2.3 kgf에서 13.0 A로 약 144초 버팁니다.
즉 "호버는 전선이 혼자 감당한다"는 말은 **팬이 판매처 표만큼 좋을 때만** 맞습니다.

호버 전력(배터리 구성): P1 881 W(39.7 A). 팬이 약하면(P2, 2.0 kgf) 1,692 W(76.2 A). 전체 표: `sizing/tw_table_v09.md`.

## 6. 무게중심, 관성, 베인 권한, 넘어짐

| 항목 | 로켓 | VTOL 배터리 | VTOL 유선 | VTOL 하이브리드 |
|---|---|---|---|---|
| 무게중심 높이 (mm) | 388.0 | 247.0 | 221.7 | 234.3 |
| 옆 치우침 (mm) - CAD-2 → 수정 후 | 1.51 → 1.54 | **3.06 → 0.61** | **5.71 → 2.06** | **6.24 → 1.52** |
| 호버 중 고정 트림 (피치 권한 대비) | 2.8 % | **1.8 %** (전 9.1 %) | **7.0 %** (전 19.3 %) | **4.9 %** (전 19.7 %) |
| 넘어짐 각 (핀 쪽 / 핀 사이, 치우침 포함) | 17.6° / 12.7° | 26.4° / 19.3° | 28.7° / 21.1° | 27.5° / 20.2° |

* 베인 팔 210.0 mm, Ixx 0.0351 kg m². 호버에서 피치 각가속도 15.3 rad/s²로 로켓(10.8)의 1.42배입니다.
* 유선 구성은 배터리(가장 무거운 -x 쪽 부품)가 없어서 아직 2.1 mm 치우칩니다. 검사 C33이 WARN(7.0 %)으로 알립니다. 시뮬레이션에서 트림 1.4°를 넣으면 됩니다.
* 핀 사이 넘어짐 각이 15°보다 커서 검사 C32는 PASS입니다.

## 7. 직접 구동 베인 (수정 라운드)

* **커플러**: 허브(Ø10, D컷 구멍) + 소켓(Ø12). 소켓에는 2암 혼이 들어가는 홈(5.55 mm, 양쪽 열림)과 혼 허브용 Ø7.2 구멍이 있습니다.
  나사가 없습니다. 혼의 팔 옆면으로 힘을 전달합니다. 팔 방향으로는 미끄러질 수 있어 정렬 오차를 받아 줍니다.
* **무두볼트**: M2 × 3 컵 포인트 1개가 허브를 지나 축의 D컷을 누릅니다. 축이 빠지지 않고 D컷 유격도 없어집니다. 0.9 mm 육각 렌치를 씁니다.
* **혼**: MG90S 동봉 2암 혼의 양 팔을 **8.8 mm(끝에서 끝)**로 자릅니다. 팔 폭 5.5, 두께 1.8, 허브 Ø7은 ASSUMED입니다. 재고 홈을 맞춰 다듬으세요.
* **황동 부싱**: 6 × 0.45 mm 황동 파이프를 보스 길이(7 mm)로 잘라 Ø6.0 구멍에 끼웁니다(필요하면 순간접착제). 베인 옆 힘(2.95 N)은 부싱이 받습니다.
* **폼**: 서보와 덮개 사이에 EVA 3 mm 한 장. 서보를 반대쪽 벽에 눌러 흔들림을 막습니다.
* 힌지 모멘트 0.119 kgf·cm (서보 1.8 kgf·cm의 1/15). 서보가 멈춰 버틸 때 소켓 면압 15.3 MPa, 비행 중 1.0 MPa입니다.
* 시뮬레이션 작업에 넘길 값: 베인 유격 약 1.7°(전체 폭, 기어 1° ASSUMED 포함), 혼 스플라인 20T라 중립 트림 ±9° 필요.

**조립 순서**
1. 혼을 서보에 나사로 고정합니다(팔은 서보 길이 방향과 직각).
2. 커플러를 혼에 끼우고, 무두볼트를 살짝만 끼웁니다.
3. 서보를 열린 쪽(+v)에서 주머니에 밀어 넣습니다. 아래 귀가 바닥 홈에 들어갑니다.
4. 베인을 배기구 쪽에서 덕트 안으로 넣고, 축을 부싱으로 밀어 커플러 D컷 구멍에 끼웁니다. 서보는 1500 µs 중립, 축 D컷은 +v 쪽을 봅니다.
5. 커플러를 보스 쪽으로 붙인 뒤 약 0.3 mm 띄우고 무두볼트를 조입니다.
6. 폼 패드를 붙이고 덮개를 M2 × 8 나사 2개로 닫습니다.

**빼는 순서**: 덮개 열기 → 무두볼트 풀기 → 베인을 배기구 쪽에서 **7.5 mm 이상 안쪽으로 밀기** → 서보를 커플러·혼과 함께 +v 쪽으로 빼기.

## 8. 모터 선 (수정 라운드)

* 립 포켓 벽에 폭 6 mm 슬릿(모터 선 쪽 0°). EDF 립은 나머지 벽이 그대로 잡습니다.
* 0° 지주 안쪽 면에 케이블 타이 고정점 3개(폭 12 mm, 터널 1.4 × 3 mm, 2.5 mm 타이용). 아래쪽은 45° 지붕이라 서포트 없이 출력됩니다.
* 격벽 구멍 20 × 11 mm, r 42-53. 선은 구멍 바깥쪽(r 50.8)을 지나 EDF 입구 반지름보다 3.5 mm 바깥에 있습니다.
* 슬라이스에서 흡입부 창 서포트 검사(window-315) PASS. 서포트 양은 0.2 g 늘었습니다.

**설치 순서**
1. EDF를 넣고 선 3가닥을 추진 모듈 슬롯에 위에서 눕혀 넣습니다.
2. 흡입부를 위에 들고, 불릿을 하나씩 흡입부 **안쪽으로 곧게** 올려 격벽 구멍으로 빼냅니다.
3. 선(불릿이 아닌 선 부분)을 립 포켓 벽의 **슬릿으로 바깥 홈에** 옮깁니다.
4. 흡입부를 내립니다. 선은 홈을 지나 게이트로 립 위를 넘어 안으로 들어갑니다.
5. 창으로 손을 넣어 선 3가닥을 고정점 3곳에 케이블 타이로 묶습니다.
6. 홈 덮개를 닫습니다. 불릿 연결부는 전자부 칸에 둡니다.

## 9. 탑캡과 유선 준비 (수정 라운드)

* 전선 구멍 2개는 **180°**(x -25, 배터리 칸 위)로 옮겼습니다. 트레이 면과 겹치지 않습니다. GPS 패치는 0°로 옮겼습니다.
* 고정점: M5 × 16 아이볼트, **D32 × 2 mm 알루미늄 와셔**(4.2 g, 허브·리브 바닥 홈에 평평하게), M5 얇은 너트(+ 나사 고정제). 볼트 끝-배터리 4.2 mm.
  와셔 판 계산: 100 N에서 여유 12배, 300 N에서 4배. 리브는 여전히 300 N에서 1.03배라 **번지(충격 흡수 줄)는 꼭 필요합니다.**
* 유선 부품 상자(트레이 -x 쪽, 크기 ASSUMED):
  커패시터 1000 µF × 4 (27 × 27 × 26 mm, ESC 입력에서 34.5 mm), 브레이크 초퍼·저항 (16 × 30 × 50 mm, 벽 쪽), XT90-S + 100 mm 여유선 (18 × 25 × 40 mm, 전선 구멍 아래),
  하이브리드 다이오드 보드 (10 × 25 × 40 mm, 버퍼 옆). 무게는 유선전원 검토의 추정 그대로입니다.
* 테더 경로: 부트(≥ 100 mm) 끝에서 흡입 창까지 263 mm(200 mm 이상). 흡입 창 보호망은 아직 없습니다(작은 결함, 시험 전에 덧대기 권장).

## 10. 배터리·ESC 선택지 (추정, 기본은 그대로)

| 팩 | 기체 g | T/W @2.0/2.3/2.6/3.09 | P1 호버 A / 처짐 V / 비행 s | P2(2.0 kgf) 호버 A / 처짐 V / 비행 s |
|---|---|---|---|---|
| 6S 1300 mAh 120C | 1,513 | 1.32 / 1.52 / 1.72 / 2.04 | 36 / 0.87 / 103 | 73 / 1.75 / 51 |
| 6S 1500 mAh 100C | 1,543 | 1.30 / 1.49 / 1.68 / 2.00 | 37 / 0.78 / 116 | 74 / 1.56 / 58 |
| 6S 1800 mAh 100C | 1,583 | 1.26 / 1.45 / 1.64 / 1.95 | 39 / 0.73 / 134 | 77 / 1.46 / 67 |
| 6S 2200 mAh 70C (기본) | 1,647 | 1.21 / 1.40 / 1.58 / 1.88 | 41 / 0.74 / 154 | 82 / 1.47 / 78 |

* 1500 mAh는 **팬 효율이 P1일 때만** 60초 비행에 충분합니다. P2(2.0 kgf)이면 58초로 60초 한계(hard_cutoff)보다 짧습니다. 1300 mAh는 51초입니다.
* 추력 시험 전까지 100 A ESC와 2200 팩을 유지합니다.

## 11. 출력 (임시 출력 계획, CadQuery STL 슬라이스)

| 부품 | 등급 | VTOL g | 로켓 g |
|---|---|---|---|
| 추진 모듈 (서포트 없음) | A | 304.5 | 350.0 |
| 흡입 모듈 (창 서포트 검사 PASS) | A | 122.6 | 130.2 |
| 항공전자 모듈 | B | 58.6 | 124.8 |
| 트레이 | C | 14.2 | 36.4 |
| 탑캡 | A | 35.2 | - |
| 베인 ×4 / 커플러 ×4 / 서보 덮개 ×4 / 선 덮개 | D / D / C / B | 3.56 / 0.92 / 3.41 / 2.23 | 같음 |
| **합계** | | **부품 569 g, 필라멘트 650 g, 17 h 05** | 부품 945 g(발사대 제외), 필라멘트 1,299 g, 31 h 52 |

## 12. 예산

로켓 382,232원, VTOL 배터리 354,192원 (둘 다 +6,000원: 무두볼트 4개 + 0.9 mm 렌치, 황동 파이프 30 cm, EVA 폼, 케이블 타이, ASSUMED).
커플러 M2 × 4 나사 8개는 빠졌습니다. 유선 변형 +35,000원, 하이브리드 +130,000원(유선전원 검토 가격, 와셔 포함).

## 13. 검증한 것

* 형상 검사(5개 구성): 0 FAIL. WARN은 C10(예전부터 있던 0.69 mm 탭 구멍 벽), 로켓 C12·C13(T/W, 안정 여유), 유선 C33(7.0 %).
* 새 검사: C33(옆 무게중심 트림). 바뀐 검사: C5(빼는 순서, 렌치 경로), C28(축 고정, 소켓, 폼, 부싱), C29(슬릿, 고정점, 입구 거리), C30(와셔·볼트 스택), C32(꽉 찬 핀), C14(새 부품).
* 모든 부품 쌍 겹침: 로켓 55개, VTOL 42 / 49 / 52개에서 0 mm³.
* Fusion 스크립트(0.9.2) 재생 비교: 추진 모듈, 커플러, 혼, 부싱, 서보, 덮개, 탑캡, 항공전자 모듈, 유선 부품 전부 0.0000 mm³.
  흡입부는 재생기가 창을 못 그리는 예전 한계가 있지만, 창을 뺀 영역(슬릿, 고정점, 터널, 격벽 구멍 포함)은 0.0000 mm³입니다. 트레이는 재생기가 확인하지 못합니다(예전부터).
* Fusion 모의 실행 4개 구성 실패 0, API 검사 0건.
* 출력 STL 두께 조사: 슬롯·홈 옆 얇은 조각이 없어졌습니다.
* 전체 pytest: 1,102 통과, 5 실패, 5 건너뜀, 2 예상 실패. 실패 중 2개는 옛 형상을 기대한 시험이라 고쳐서 다시 돌렸고 통과했습니다.
  남은 3개: `params_gen.h`·`bridge_config_gen.h` STALE(펌웨어 작업에서 다시 만듦), CAD-1부터 있던 GNS 경로 시험.
  형상이 바뀐 부품의 고정 해시(추진 모듈, 흡입 모듈, 베인 4, 커플러 4)는 바뀐 이유와 전후 부피를 적고 다시 고정했습니다.
  KAIST와 v0.6.2 부품의 고정 해시는 그대로 통과합니다.

## 14. 사용자가 재야 할 것

1. **EDF 추력·전류·전압·회전수** (LiPo로, 100 A에서 멈춤). 추력은 전압과 함께 적어 주세요.
2. ~~edf.wire_exit (모터 선이 나오는 각도와 높이)~~ - **2026-11-03: 이제 재지 않습니다(시계 장착, 17장). 남은 목록은 17.14.**
3. **MG90S 2암 혼**: 팔 폭·두께, 허브 지름, 칼라 높이, 혼 나사 머리. 기어 유격도 가능하면.
4. 황동 파이프의 실제 안지름(5.1 ASSUMED)과 출력한 축 지름.
5. 무게: 결합 나사 12개, 캐리어 PCB, 기타 전자, 선(g/m), 불릿, 아이볼트·와셔·너트·부트.
6. 300 g 하우징의 출력 설정(벽 수).
7. 배터리 후보의 실제 무게·크기·내부 저항.
8. GPS 보드·패치 크기, MG90S 선이 나오는 쪽.
9. 유선 부품 실제 크기(XT90-S 한 쌍, 커패시터, 알루미늄 저항, 다이오드 보드).
10. **핀 낙하 시험**: 핀 하나로 0.3-0.6 m/s, 단단한 바닥. 손 계산의 다리 강성은 추정입니다.

## 15. 남은 일과 주의

* **기본 구성은 아직 "rocket"입니다.** VTOL은 `--config vtol`로 만듭니다.
* **펌웨어 헤더 `params_gen.h`와 `bridge_config_gen.h`는 STALE입니다.** params를 바꿨으니 예상된 일이고, 펌웨어 작업에서 다시 만듭니다.
* 시뮬레이션은 아직 VTOL 구성을 읽지 않습니다. 시뮬레이션 작업에서 VTOL 질량·관성·옆 무게중심·베인 유격으로 게인을 다시 맞춰야 합니다. 로터 자이로 효과도 넣어야 합니다.
* Fusion 360 GUI 실행은 아직 없습니다. 출력 파일은 임시(CadQuery STL)입니다.
* 무게 목표(1,650 / 1,400 g)는 여유가 2.8 / 0.7 g뿐이고, 약 197 g이 추정 질량입니다.
* 흡입 창 보호망, 배터리 선 나오는 자리, 착지 수평 속도 한계(약 0.3 m/s)는 다음 작업으로 남깁니다.
* 렌더 그림 (결과물 폴더 `B:\0)AI_Cad\CanSat_v0.9\06_3D_CAD\CAD_v0.9\렌더\` 기준, 2026-10-29 확인): `렌더\발표용_1920x1080\`의 7장은 **수정 후** 형상입니다.
  수정 전 형상의 같은 그림은 `발표용_1920x1080\수정전_보관\`에 있습니다. `렌더\수정라운드\` 3장도 수정 후 형상입니다(모터 선 경로, 직접 구동 고정, 유선 부품).
  `렌더\` 바로 아래 4장과 `VTOL\렌더\` 5장은 수정 전 형상입니다(핀 구멍, 원판 혼, 슬릿·고정점 없음).
  2026-10-29 모터선 출구 수정(17장) 뒤 다시 그린 그림: `발표용_1920x1080\`의 01, 02, 04, 05, 06, 07과 `수정라운드\` fix_01. 바뀌기 전 그림은 같은 폴더의 `수정전_보관_모터선출구\`에 있습니다. 03(v0.8.1 대 v0.9)은 다시 그리지 않아 질량 글자가 옛 값입니다.

## 16. 파일 위치

* CAD 결과: `cad/exports/` (CadQuery 보고서·검사·STL·STEP, Fusion 재생 비교), 임시 출력 파일 `cad/exports/print/provisional_v09_cadquery*/`
* 문서: `docs/v0.9_하드웨어_변경.md` (이 문서). 결과물 복사본은 `B:\0)AI_Cad\CanSat_v0.9`에 있습니다.
* 프로젝트: `params.json` (`meta.v09_fix_note`), `cad/layout.py`, `cad/cadquery/rocket_geometry.py`, `check_geometry.py`, `build_rocket.py`,
  `cad/fusion360/CanSatEDFRocket/CanSatEDFRocket.py` (0.9.2), `sizing/vtol_sizing.py`, `docs/vtol_strength_checks.json`, `docs/vtol_savings.json`

## 17. 모터선 통로 - 재지 않아도 맞는 넉넉한 설계 (2026-11-03, 시계 장착)

**왜 바꿨나.** 사용자 요청(2026-10-30): "알아서 여유있게 해주면 안돼?" 출력 전에 작은 치수를 여러 개 재고 싶지 않다는 뜻입니다.
이전 설계(2026-10-29 수정 라운드)는 출구 각도를 재야 했고(허용 ±9.6°, VTOL), 공장 수축 튜브를 벗겨 14 ± 1 mm로 다시 씌워야 했고,
굽힘 반지름은 7.2-8.0 mm만 맞았습니다. 그 설계는 `history/v0.9_wire_round2/`에 그대로 있습니다(`ARCHIVE_README.md`).
그보다 전 판은 `history/v0.9_wire_round1/`(1차), `history/v0.9_pre_wire/`(도면의 옆 구멍)에 있습니다.
아래에서 M = 도구로 잰 값(CAD 불리언, 슬라이서), E = 손계산 추정, A = 가정입니다.

### 17.1 무엇을 바꿨나 (한 줄 요약)
* **EDF를 돌려서(시계처럼 맞춰서) 선 묶음을 하나의 고정 통로에 넣습니다.** 이것을 "시계 장착"이라고 부릅니다.
* 통로는 0°(ESC 쪽, +x) 하나입니다. 몸통(반지름 60 mm) 밖으로 **블리스터**가 튀어나옵니다. 블리스터는 통로를 감싸는 볼록한 덮개입니다.
* **키웨이(탭이 끼는 세로 홈) 25개**를 원 둘레에 냅니다(11-03판 27개, 11-04 수정 라운드에서 25개). EDF를 어느 각도로 돌려도 탭이 가까운 키웨이에 들어갑니다.
* **탭 나사 4개와 나사 받침(러그)은 없어졌습니다.** EDF는 위로 흡입부 선반(shelf)에, 아래로 키웨이 바닥의 폼 패드에 놓입니다.
* 22 mm 슬롯 상자와 12.4 mm 노치는 통로로 바뀌었습니다.
* params: `propulsion_module.tab_mount` = `clock_keyways`(기본), `propulsion_module.clock_keyways`, `propulsion_module.lead_passage`,
  `motor_leads.generosity_box`, `edf.axial_retention`. 예전 나사 장착은 `tab_mount` = `screws`로 그대로 만들 수 있습니다(시험도 그 모드로 계속 돌림).

### 17.2 왜 몸통 밖으로 나가야 하나
* 두 개의 독립 검토안(A, B)이 각자 같은 한계를 보였습니다: **몸통 반지름 60 mm 안에서는 공장 튜브 24-35 mm와 굽힘 반지름 15 mm가 들어가지 않습니다.**
  B의 반지름 예산: 몸통 안에서 맞는 가장 큰 굽힘 반지름은 VTOL에서 10.2 mm 이하이고, 튜브가 24 mm 이상이면 아무것도 맞지 않습니다(E).
* 그래서 통로의 바깥벽은 중심에서 **75.5 mm**입니다 = 모터 반지름 17.65 + 튜브 35 + 굽힘 15 + 굵은 낱선 3가닥을 포갠 두께 6.85 + 굽힘 시작 여유 1.0.
  블리스터 바깥면은 76.7 mm(모서리 77.2 mm)입니다. **나중에 통로를 몸통 안으로 다시 넣지 마세요.** 넉넉함이 사라집니다.

### 17.3 넉넉함의 범위 (사용자가 재지 않아도 되는 범위, 모두 A)
| 값 | 받는 범위 | 예전 (10-29) |
|---|---|---|
| 선 출구 각도 (탭에서) | **0-360° 어디든** (C34) | −90° ± 9.6°, 재야 함 |
| 공장 수축 튜브 | **그대로 둠**, 모터에서 35 mm까지, 계단 지름 12 mm까지, 12 × 5 납작 묶음은 어느 방향이든(비스듬히 누워도: 반대각선 6.5 mm를 위아래·옆 모두로 잡은 단면, 11-04) | 벗기고 14 ± 1 mm로 다시 씌움 |
| 낱선(12 AWG) 지름 | **4.3 mm까지** | 3.81 mm 이하 |
| 굽힘 반지름 (선 중심) | **7-15 mm** (작게 굽힐 필요 없음) | 7.2-8.0 mm |
| 고정 날개 뒤 끝이 림보다 안쪽 | **0-3 mm** | 0 (3.2 넘으면 다시 설계) |
| 모터가 림 뒤로 나온 길이 | **30-36 mm** | 30.0 (도면) |
| 림 뒷면 - 묶음 윗면 틈 | **0-2 mm** | 0.4 |
| 굽힘 시작 위치 | 바깥벽에 닿는 곳부터 1 mm 안쪽까지 | 정해진 점 |
* C29는 이 범위의 **모든 모서리 조합**(튜브 20 / 28 / 35 mm × 단면 4가지(둥근 12, 납작 세움, 납작 눕힘, 납작 비스듬 13 × 13) × 지름 3.6 / 4.3 × 굽힘 7 / 10 / 15 × 틈 0 / 2 × 굽힘 시작 0 / 1 mm = 288개)을
  출구 오차 −8.04° / 0° / +8.04°에서 모두 만들어 봅니다(864개; 11-03판은 단면 3가지 648개). 고정 날개 안쪽 3 mm는 덕트 안에서만 묶음을 올리므로 EDF와의 검사(1,008건)에 넣었습니다.
* **표의 범위가 곧 한계입니다(독립 검토 F6, M).** 범위 끝에는 추가 여유가 없습니다. 검토자의 시험: 선 지름 4.6 mm, 림 틈 3 mm, 지름 14 mm 묶음,
  출구가 통로 한계보다 1° 더 돌아감 - 모두 추진 모듈이나 넣는 길에 닿기 시작합니다(12.8 / 7.3 / 69 / 292 mm³, 11-03판 형상).
  실제로는 선이 휘어서 받아 주므로 조금 넘는 것은 큰 문제가 아니지만, 위 숫자를 넘는 부품(굵은 10 AWG 선, 두 겹 수축 튜브 등)은 이 설계로 보장하지 않습니다.
  흡입부 쪽도 4.3 mm 선에서 한계에 딱 맞습니다(EDF 목과 3.00 mm, 묶음 고정점 깊이 여유 0.0 mm).

### 17.4 키웨이와 커버리지 (C34, M)
* 키웨이: 폭 4.0 mm(두께 3.6 mm까지의 탭이 들어감; 탭 3.0 mm는 A), 반지름 49.25-57.6, 바닥 z 123.65(VTOL) / 131.65(로켓), 위로 열림.
  각도는 `Layout._clock_seat`이 계산합니다(손으로 넣지 않음): 24.75, 37.75, 50.75, 63.50, 76.50, 89.50, 102.50, … 321.50, 333.50° (25개; 그림 속 EDF는 89.50° / 269.50° 자리).
  키웨이는 웹(45° + 90° k), 서보선 기둥의 안내벽(−20° + 90° k), 결합 나사 구멍, 통로를 피합니다.
* **11-04 수정 라운드(독립 검토 F1)**: 11-03판의 계획기는 193.55° / 200.15° 키웨이 사이에 **1.73 mm 이빨**을 남겼고(통로 옆에는 1.30 mm 조각도),
  모터 토크로 옆으로 휘는 힘을 아무 검사도 보지 않았습니다(손계산 안전율 0.6, 통로 옆 0.37). 이빨은 키웨이 바닥(z 123.65)에서 데크 밑(z 165.8)까지
  42.2 mm 서 있는 기둥(반지름 방향 두께 1.6 mm)입니다. 그래서 계획기를 바꿨습니다:
  * 설계 토크 1.01 N·m(C35와 같은 값)를 **탭 하나**가 받고(매달린 자리, 두 탭 자리도 한쪽만 닿는 경우, 양쪽 방향), 양끝 고정·고른 하중으로 안전율 5 이상 →
    이빨 폭 4.86 mm 이상이 필요합니다(E). 계획은 여유 0.2 mm를 더한 **5.06 mm 이상**으로, 통로 옆 이빨도 같은 폭으로 둡니다(웹·벽이 잡아 주는 것은 셈하지 않음).
  * 계획기: 180° 둘레(자리는 a와 a + 180°가 같음) 위에 자리 사슬을 놓습니다. 이웃 자리 사이 ≥ 이빨 간격(10.43°), ≤ 2 × 7.5 − 여유 1.0 = 14°,
    자리 수가 가장 적고 그다음 가장 큰 틈이 가장 작은 사슬(`plan_step_deg` 0.25°, 새 params `tooth_factor_min` 5, `tooth_w_margin` 0.2, `plan_gap_margin_deg` 1.0).
  * 결과(M, 도면에서 잼): 이빨 26개, **가장 좁은 이빨 5.30 mm**(통로 옆 19.4°), 키웨이 사이 최소 6.42 mm, **토크 안전율 최소 5.9**(C35, 기준 5).
    일부러 6.6° 옆에 키웨이를 하나 더 넣으면 C35가 안전율 1 미만을 찾습니다(새 시험의 음성 대조).
* 앉는 자리: 25개(탭 둘 다 키웨이 22개 + 한 탭이 통로 안에 매달리는 자리 3개: 166.50 / 346.50, 179.50 / 359.50, 191.75 / 11.75).
* **커버리지 100 %**: 출구 각도가 0-360° 어디든 어떤 자리에서 통로 중심에서 최대 **6.50°** 안에 옵니다(11-03판 6.77°; 0.01° 간격으로 다시 계산, 기준 7.5°).
  가장 큰 자리 틈 13.0°. 통로는 7.5° + 탭이 키웨이 안에서 노는 각도 0.54° = **±8.04°**를 받습니다(여유 1.54°, 11-03판 1.27°).
* EDF를 25개 자리 모두에 놓아도 추진 모듈과 겹침 0.000 mm³(M).

### 17.5 통로와 블리스터 (추진 모듈, M)
* 통로(위에서 본 모양): 덕트 안 42 mm부터 바깥벽 75.5 mm까지, 반폭 7.2 mm(가장 넓은 묶음 6.9 + 0.3)를 ±8.04° 돌린 부채꼴입니다.
  바닥: 모든 경우의 가장 낮은 선 바닥 − 0.7 = z **96.8**(VTOL) / **104.8**(로켓) (11-04: 비스듬한 납작 묶음 때문에 0.1 mm 내려감). 위로는 모듈 끝까지 열려 있습니다(EDF를 위에서 넣음).
* 블리스터: 통로를 벽 1.2 mm로 감쌉니다. z 95.6-166.8(VTOL), 103.6-174.8(로켓). 흡입부 바로 아래(0.2 mm)에서 끝납니다.
  몸통 밖 블리스터 윗면(반지름 60-76.7 mm, 약 530 mm², 흡입부 홈 벽 바깥 약 250 mm²)은 열려 있어 폼 마개로 선 둘레를 채웁니다(17.13).
* 바닥 아래 **45° V자 용골**: 2 mm 계단 14개(Fusion도 같은 tprism). 핀 1(0°) 위에 얹혀 받침 없이 똑바로 출력됩니다.
* 덕트 벽에 생기는 창(림 아래, E): 439 mm²(11-03판 436, 예전 노치 118 mm²).
* 정면에서 본 블리스터 면적(몸통 밖): **619 mm²**(몸통 단면 11,310 mm²의 5.5 %, M 형상).

### 17.6 바닥 패드 (판정자 수정, C18)
* 각 키웨이 아래 패드: 두께 **3.0 mm**(개념안 1.2 mm에서 올림), 폭 6.4 mm, 슬리브에서 껍데기까지 6.79 mm(VTOL)를 잇습니다. 아래는 45° 받침(받침 없이 출력).
* 착지 20 g에서 EDF 369 g(72.4 N)을 **탭 하나**가 받을 때(점하중, 양끝 고정) 굽힘 안전율 **8.28**(VTOL) / 8.09(로켓) (E, 기준 PASS ≥ 5).
  1.2 mm면 1.2였습니다. 시험(`test_clock_floor_pad_judge_fix_and_negative_control`)은 1.2 mm일 때 C18이 FAIL하는 것도 확인합니다.

### 17.7 EDF를 붙잡는 방법 (탭 나사 없음, C35, A/E)
* **판정 기록의 고침**: 개념안은 립과 흡입부 선반 사이에 EVA 고리(틈 2.9 mm)를 넣었습니다. 그런데 실제 틈은 `lip_stop_gap` **0.5 mm**입니다
  (개념안은 선반 윗면까지 잰 2.9 mm를 썼음). 0.5 mm에 폼을 넣으면 도면 치수 오차 ±0.5 mm에서 0-100 %로 눌려 조립이 안 될 수 있습니다.
* 그래서 폼을 **탭 아래**로 옮겼습니다. 키웨이 바닥을 2.4 mm 더 깊게 하고, 탭 밑면에 EVA 폼 조각(두께 3.5 mm, 서보 폼과 같은 재료)을 붙입니다.
  * 위: EDF 립이 흡입부 선반에 닿습니다(추력이 가는 길: 립 → 선반 → 흡입부 → 결합 나사).
  * 아래: 탭 → 폼 → 키웨이 바닥 → 바닥 패드. 착지 때 폼이 다 눌리면 패드가 받습니다.
  * 폼 압축: 추력으로 립이 선반에 닿을 때 17 %, 치수 오차 ±0.5 mm를 넣어 3-31 %, 그림 위치(+오차)에서 최대 46 % (한계 50 %). 흡입부 아래 높이는 그대로입니다.
* 가장 많이 뜨는 거리 1.0 mm(0.5 + 오차 0.5), 그때 키웨이에 남은 탭 길이 41.3 mm(기준 ≥ 30).
* 선반 굽힘(최대 추력 37.2 N): 안전율 177(E). 키웨이 이빨 지압(최대 출력 토크 1.0 N·m를 탭 하나가): 안전율 107(E, 30 MPa 기준).
  **이빨 옆 굽힘(11-04 새 항목, 17.4)**: 도면에서 잰 이빨 26개 모두 안전율 5.9 이상(E 하중, M 형상).
* 폼만으로는 EDF 무게(3.6 N)를 들어 올리지 못합니다(2.6 N, A). 정지 때는 폼이 조금 더 눌린 채 앉고, 추력이 무게를 넘으면 선반에 닿습니다.
* **정지 때 무게로 눌리는 양(11-04, 독립 검토 F4, A)**: 두 탭 자리는 폼 2개가 74.5 kPa → 42 % 눌림, 그림보다 0.38 mm 아래에 앉고,
  모터가 돌기 시작하면 선반까지 최대 1.38 mm 올라갑니다. **매달린 자리(탭 하나)**는 149 kPa로 가정한 폼 곡선(50 %에서 90 kPa)을 넘어 폼이 거의 다 눌립니다.
  그때는 탭이 납작해진 폼을 사이에 두고 바닥 패드에 앉고(패드 검사 C18이 탭 하나 착지 20 g을 이미 봄), 선반까지 최대 3.4 mm 올라갑니다.
  키웨이에 남는 탭 길이는 위쪽 위치(립이 선반에 닿음)로 정해지므로 41.3 mm 그대로입니다.
  이 값은 C35에 숫자로 적지만 합격 기준에는 넣지 않았습니다: 폼 50 % 한계는 "흡입부를 눌러 끼울 수 있는가"(조립 치수) 규칙이고, 정지 무게는 다른 경우입니다.
  매달린 자리는 선이 어느 탭에서든 약 −18° ~ +20° 안에서 나올 때만 쓰입니다(M, 자리 목록에서 계산)(사진 읽기 −90° / 22-47°로는 아닐 가능성이 큼, A).
  그 자리라면 폼이 시간이 지나며 납작해질 수 있고, 추력을 올릴 때 EDF가 선반을 톡 칠 수 있습니다 → 추력 시험에서 봅니다(17.14).

### 17.8 선 경로 (조립된 모습, 가장 긴 경우로 질량 계산)
1. 공장 튜브 묶음이 모터 앞쪽 링에서 나와 고정 날개 하나를 따라 림 아래로 갑니다(사진 그대로).
2. 낱선이 바깥벽에 닿는 곳에서 위로 굽습니다(반지름은 선이 알아서 정함, 7-15 mm).
3. 바깥벽을 따라 올라가 흡입부 바로 아래 30 mm에서 반지름 64.5 mm로 모입니다.
4. 흡입부 홈(22 × 11) 안으로 나란히 들어갑니다. 그다음은 예전과 같습니다(문 → 지주 → 격벽 구멍 → 전자부 칸).
* 경로 길이(가장 긴 경우: 튜브 20 mm, 납작 묶음, 지름 4.3, 굽힘 7, 틈 2): 287.7 mm(VTOL) / 288.5(로켓) + 여유 60. 예전 273.2 / 274.0.
* 지름 4.3 mm 낱선 때문에 흡입 격벽 구멍을 r 42-53 → **41-53.2**로 넓혔습니다. 4.3 mm 선이 EDF 목에서 정확히 3.00 mm(기준 3.0) 떨어지고,
  선을 묶는 고정점은 터널 깊이 한계에 딱 맞습니다(여유 0.0 mm, 3.6 mm 선이면 0.7 mm). 총알 커넥터를 곧게 올릴 때도 선반에 안 닿습니다(0.000 mm³).

### 17.9 검사 결과 (M, 2026-11-04 수정 라운드)
| 검사 | 로켓 | VTOL 배터리 | 유선 | 하이브리드 |
|---|---|---|---|---|
| C18 탭·키웨이·패드 | PASS (8.09) | PASS (8.28) | PASS | PASS |
| C19 탭 나사 | N/A (나사 없음, C35) | N/A | N/A | N/A |
| C21 키웨이→바깥면 0.965 mm, 블리스터 벽 1.200 mm | PASS | PASS | PASS | PASS |
| C29 선 통로(모든 경우) | **WARN** | **WARN** | **WARN** | **WARN** |
| C33 옆 치우침(나쁜 쪽 방위·Cd) | WARN 5.7 % | WARN 7.7 % | **FAIL 14.0 %** | **FAIL 11.2 %** |
| C34 커버리지 | PASS (6.50°) | PASS | PASS | PASS |
| C35 축 방향 고정 + 이빨 굽힘 | PASS (이빨 5.9) | PASS (5.9) | PASS | PASS |
| 전체 | FAIL 0 / WARN 5 | 0 / 3 | 1 / 2 | 1 / 2 |
* KAIST 프리셋(나사·립 고정, 시계 장착 아님): FAIL 0 / WARN 2(C12, C13), 예전과 같음.
* **C29 세부**: 늘린 선 부피(여유 0.4 mm) **864개** × 추진 모듈 최대 **0.0000 mm³**, × 흡입부 0.0000, EDF를 위에서 넣을 때 쓸고 가는 부피 432개 0.0000,
  여유 없는 선 × EDF 1,008건 0.0000(고정 날개가 3 mm 안쪽이면 허브도 날개 뒤 끝에서 끝난다고 가정, A). 가장 가까운 경우는 비스듬한 납작 묶음(S35, 지름 4.3, R15, 틈 2, +8.04°).
  일부러 틀린 경우는 겹침을 찾습니다(검사가 살아 있다는 증거): 출구를 6° 더 돌림 3,590 mm³, 벽보다 3 mm 밖 725 mm³, 넣는 부피 +6° 4,899 mm³(VTOL; 로켓 3,325 / 725 / 4,729).
  통로 안에 매달린 탭 → 선 0.55 mm(기준 0.5). 추력 베인(전 각도) 51.0 / 59.0 mm, 커플러 54.6, 혼 57.1, 서보 40.1, 핀 1 판 7.6 / 15.6, 흡입부 4.0 mm.
  **WARN 이유는 하나**: 고정 날개 안쪽 3 mm + 틈 2 mm = 5 mm가 RTV 접착 한계 3.6 mm보다 큽니다. 묶음을 날개에 붙이고 싶으면 RTV를 두껍게 바르거나 얇은 받침을 끼우세요.
  한계 숫자는 올리지 않았습니다. **다만 규칙의 강도는 바뀌었습니다(독립 검토 F7)**: 나사 장착(10-29판)에서는 이 규칙이 Layout 오류(설계를 멈춤)였고,
  시계 장착에서는 접착이 선택이 되어 C29 경고(WARN)로만 남습니다. 접착 없이 선을 붙잡는 근거는 바람 속 자유 길이 27.4 mm ≤ 40 mm(A)입니다.
  이 WARN 때문에 VTOL 배터리의 "C29 PASS" 시험은 설계상 실패합니다(아래 pytest).
* 두 번째 독립 방법(pytest, 개념안 A에서 가져옴): 경우 × 3 방위의 선 부피 안 점들을 실제 고체에 넣어 보니 재료 안에 있는 점 0개; 통로 빈 공간 점도 0개. 6° 더 돌린 경우는 재료 안 점을 찾습니다.
* C8(배기 통로): 가장 큰 항력 경우의 선이 바람 속에 있는 것을 허용하되 숫자로 적음: 정면 면적 **325.0 mm² = 6.0 %**(비스듬한 납작 묶음, 11-03판 306.6 mm² 5.7 %, 예전 242 mm²), E.
* C10은 예전과 같은 WARN(키웨이 바깥 스피곳 링 0.97 mm).
* Fusion 360 스크립트 **0.9.5**(키웨이 각도는 Layout에서 읽으므로 스크립트 변경 없음): API 검사 0건, 모의 실행 5개 구성 실패 0,
  재생 비교 추진 모듈 불리언 차이 **0.0113 / 0.0000 mm³**(VTOL), 0.0128 / 0.0000(로켓) (기준 < 1). 흡입부·베인·트레이는 예전과 같은 재생기 한계(실패 목록이 11-03판과 같음).
  **Fusion GUI 실행은 아직 안 했습니다.**
* pytest (M, `--ignore=history`, 2026-11-04):
  - `cad/cadquery` 117 통과, 3 건너뜀, **4 실패**(11-03판과 같은 4개): 로켓 C33이 PASS가 아님(WARN 5.7 %), VTOL 배터리 C29·C33이 PASS가 아님(WARN, 설계상 접착 틈 WARN 포함),
    무게 목표 2개(1,653.6 > 1,650, 1,405.7 > 1,400). 기준은 그대로 두었습니다. 새 시험 2개(이빨 굽힘 + 음성 대조, 비스듬한 납작 묶음 단면) 통과.
    첫 실행에서는 추진 모듈 고정 해시가 달라 1개가 더 실패했고, 바뀐 이유와 전후 부피(319,224.9 → 320,358.7 mm³)를 적고 다시 고정했습니다(그 시험만 다시 돌려 통과).
  - `sizing/` + `tools/` 524 통과, 3 실패(`params_gen.h`·`bridge_config_gen.h` STALE: params를 바꿔서 생긴 예상된 결과, 펌웨어 단계에서 다시 만듦; 11-03판과 같음).
  - `sim/test_sim.py` + `sim/test_vtol_scenarios.py` 202 통과, 7 실패: 6개는 11-03판과 같음(5개는 원래 있던 실패, `test_sim_assist_off_limiter_cuts`),
    1개는 시뮬레이션 질량 고정값(1,652.90 → 1,653.61 g 등) - 이유를 적고 다시 고정했습니다(그 시험만 다시 돌려 통과).
* 강도(`sizing/vtol_strength.py` `clock_seat_sections`, STL 단면 M + 하중 E): 가장 약한 단면 안전율 VTOL **152.8**, 로켓 **97.2**. 바닥 패드(탭 하나 착지) 8.28.

### 17.10 C33 (옆 치우침) - 사용자 결정
선 항력이 +x 쪽에 생기고, 블리스터와 선의 무게도 +x에 있어 0°에서는 나빠졌습니다(E, Cd 0.8-1.2의 나쁜 쪽 끝, 통로 ±8° 중 나쁜 쪽 방위).
11-04 수정 라운드: 비스듬한 납작 묶음의 항력 면적(325.0 mm²)이 들어가 약 0.2 %p 올랐습니다(검토자 예상과 같음).
| 구성 | 예전 (10-29) | 11-03 | **지금 0° (11-04)** | 180° 통로 (E) | 180° + 서보 모음 0° (E) | 0°에서 10 % 이하로 무게중심을 −x로 |
|---|---|---|---|---|---|---|
| 로켓 | 4.6 % | 5.6 % | 5.7 % WARN | 3.7 % | 3.0 % | 필요 없음 (5 %: 0.44 mm) |
| VTOL 배터리 | 5.2 % | 7.5 % | 7.7 % WARN | 12.0 % | 10.2 % | 필요 없음 (5 %: 0.94 mm) |
| VTOL 유선 | 10.8 % | 13.8 % | **14.0 % FAIL** | 10.9 % | 8.5 % | **1.22 mm (100 mm에서 17 g)** |
| 하이브리드 | 8.4 % | 11.0 % | **11.2 % FAIL** | 10.8 % | 8.8 % | 0.40 mm (100 mm에서 6 g) |
* 180° 계산: 통로 쪽 모듈 무게 변화와 **모터선 전체 경로(흡입부 홈, 격벽 구멍, 전자부 칸 이음부)를 −x로 뒤집고**, ESC(+x)까지 가로지르는 선 80 mm × 3가닥(+8.9 g)을 더함.
  판정자 표의 "180°면 모두 PASS"는 선 경로 질량을 뒤집지 않은 값이라 다시 나오지 않았습니다. 이 계산으로는 180°가 VTOL 배터리를 더 나쁘게 합니다.
  (`params.json`의 `lead_passage.theta_note`도 이 내용으로 고쳤습니다, 독립 검토 F2·F8.)
* 유선·하이브리드에서 180°는 **전자부 칸의 총알 이음부가 유선 버스 클램프에 닿습니다**(Layout이 거부, 간격 0.00 < 2 mm). 180°로 가려면 칸 배치도 바꿔야 합니다.
* 권장(사용자 결정): 통로는 0°에 두고, **유선 구성의 무게중심을 −x로 1.3 mm 이상** 옮기기(예: 유선 부품 하나를 −x로). 하이브리드는 0.4 mm.
  `propulsion_module.lead_passage.theta_deg`를 180으로 바꾸면 통로·홈·격벽 구멍·경로가 같이 옮겨집니다(서보 모음 `servo_leads.gather_theta_deg`도 0으로).
* 추진 모듈 안에서 고치는 방법은 작습니다(E): 블리스터 아래 용골은 약 1.7 g × 63 mm ≈ 110 g·mm인데, 유선은 약 1,700 g·mm가 필요합니다.
  모듈의 −x 쪽을 깎으면 무게중심이 오히려 +x로 갑니다(검토 F2의 "−x 쪽 균형 깎기"는 방향이 반대). 그래서 모듈은 그대로 두었습니다.

### 17.11 무게 (슬라이서 M, 프로젝트 설정 4벽 / 4·4층 / 15 % 자이로이드 / 받침 없음)
| 항목 | 예전 (10-29) | 11-03 | **지금 (11-04)** | 11-03 대비 |
|---|---|---|---|---|
| 추진 모듈 VTOL / 로켓 | 303.72 / 349.01 g | 300.47 / 346.08 g | **301.17 / 346.79 g** | +0.70 / +0.71 g (키웨이 2개 줄어 슬리브가 더 남음) |
| 흡입 모듈 VTOL / 로켓 | 122.60 / 130.16 g | 122.60 / 130.15 g | 122.60 / 130.15 g | 0 |
| 모터선(긴 경로 + 폼 패드·마개·RTV) | 50.98 / 51.07 g | 52.05 / 52.14 g | 52.05 / 52.14 g | 0 |
| **VTOL 배터리** | 1,655.1 g | 1,652.9 g | **1,653.6 g** | +0.7 (목표 1,650: **3.6 g 넘음**) |
| **VTOL 유선** | 1,407.2 g | 1,405.0 g | **1,405.7 g** | +0.7 (목표 1,400: **5.7 g 넘음**) |
| VTOL 하이브리드 | 1,528.2 g | 1,526.0 g | 1,526.7 g | +0.7 |
| 로켓 (CAD) | 2,600.3 g | 2,598.4 g | 2,599.1 g | +0.7 |
* 탭 나사 M3×20 4개(약 4.8 g, A)는 이제 안 씁니다. 이 나사가 결합 나사 덩어리 40 g(`joint_screws_inserts`)에 들어 있었는지 모릅니다(빼지 않았음).
  들어 있었다면 VTOL 배터리 1,648.8 g(목표 맞음), 유선 1,400.9 g(0.9 g 넘음)입니다. 나사 4개를 저울에 올려 보면 정해집니다(알면 좋은 것).
* 어깨 링 속 비우기(개념안 A·B의 곁가지 제안)는 넣지 않았습니다. 이 출력 설정에서는 닫힌 빈칸 둘레에 벽 4겹이 새로 생겨 오히려 무거워질 가능성이 큽니다(E, 슬라이서로 재지는 않음).
* 출력 시간(슬라이서 M): 추진 모듈 VTOL **8 h 57**, 로켓 **9 h 38**(10-29판보다 +95 / +100분). 전체 계획 VTOL 18 h 37, 로켓 33 h 29.
  필라멘트: VTOL 647 g, 로켓 1,295 g. 파일: `cad/exports/print/provisional_v09_cadquery*/`.

### 17.12 공기역학과 추력 (E)
* 바람 속 선 항력: 추력의 **3.2 %**(11-03판 3.0 %; Cd 0.8-1.2), 호버에서 VTOL 배터리 0.54 N. T/W 1.3이 되는 추력: VTOL 배터리 2.15 → 항력 포함 **2.22 kgf**,
  하이브리드 2.05, 유선 1.89, 로켓 3.50 kgf(`sizing/tw_table_v09.md`). 이 EDF를 조립한 그대로 잰 추력에는 항력이 이미 들어 있습니다.
* 로켓 항력: 블리스터 정면 619 mm²를 기준 면적에 더했습니다(Cd 같음, E). 1-D 상승 정점은 138.9 m로 그대로(모터 끄는 고도가 정해져 있음).
* 블리스터가 만드는 옆 힘·압력 중심 변화는 바로우먼(Barrowman) 식에 없습니다. 핀 1 위, 무게중심 아래에 있어 약간 안정 쪽이지만 계산하지 않았습니다(남은 일).
* 덕트 벽 창(439 mm²)과 몸통 밖 블리스터 윗면(약 530 mm²)으로 배기가 새거나 돌아 들어오는 양은 계산하지 않았습니다. 폼 마개(17.13의 7번)가 막는다고 가정합니다(A).

### 17.13 조립 순서 (재지 않음; 8장의 1번을 바꿈; 11-04 독립 검토 F3으로 3-5번을 고침)
1. **공장 수축 튜브는 그대로 둡니다.** 벗기지 않습니다.
2. EDF의 두 탭 밑면에 EVA 폼 조각(약 3 × 8 mm, 두께 3.5 mm)을 하나씩 붙입니다.
3. **EDF를 넣기 전에** 낱선 세 가닥을 묶음 끝에서 위로 약 90° 굽혀 둡니다(반지름은 7-15 mm 어디든, 선이 원하는 대로).
   곧은 선은 블리스터 바깥벽(반지름 76.7 mm)보다 멀리 나가서 EDF가 들어가지 않고, 굽힐 곳은 통로 안 약 70 mm 깊이라 넣은 뒤에는 손이 닿지 않습니다.
   (C29의 "넣는 부피" 검사도 선을 굽힌 채로 EDF를 내린다고 봅니다.)
4. EDF를 위에서 들고 돌려서, 선 묶음이 통로(0°, 블리스터 쪽)를 향하게 합니다. 세운 선이 통로 안에 서도록 그대로 내립니다. 탭이 가장 가까운 키웨이에 저절로 떨어집니다.
   (선이 탭 바로 옆에서 나오면 한 탭은 통로 안에 매달립니다. 정상입니다.)
5. 세운 선을 블리스터 **바깥벽 쪽으로 밀어 붙입니다**. 벽에서 4 mm 안쪽까지는 괜찮습니다. 탭이 통로에 매달린 자리에서는 꼭 붙이세요
   (검토자 시험: 세운 부분이 벽에서 6 mm 안쪽이면 매달린 탭에 닿기 시작, 46 mm³, 11-03판 형상, M).
6. 낱선을 위쪽에서 흡입부 홈 자리(바깥, 반지름 약 64 mm)에 나란히 눕힙니다.
7. 묶음을 고정 날개 뒤 끝에 RTV로 붙입니다(**선택**). 틈이 크면 RTV를 두껍게 바르거나 얇은 받침을 끼웁니다.
8. 통로 위쪽, 몸통 밖의 열린 블리스터 윗면(반지름 60-76.7 mm, 약 530 mm²)에 폼 마개를 선 둘레로 꽉 채웁니다(배기 바람이 흡입부로 돌아오는 것을 막음, 0.2 g, A).
9. 흡입부를 내립니다(그다음은 8장의 2-6번과 같음). 결합 부분에 틈이 없이 앉는지 눈으로 봅니다.

### 17.14 재야 할 것 (17.11 / 14장 2번의 예전 목록을 바꿈)
**꼭 필요한 것**
1. **추력 시험(조립한 그대로)**: 선이 바람 속에 있는 상태로 호버·전 스로틀 추력. 이때 EDF가 선반에 붙어 있는지(들썩이지 않는지),
   스로틀을 갑자기 올릴 때 EDF가 선반을 치지 않는지(정지 때 폼이 눌린 만큼 1.4 mm, 매달린 자리면 최대 3.4 mm 올라감, 17.7), 키웨이 옆 이빨이 휘지 않는지도 봅니다.

**알면 좋은 것 (재지 않아도 출력 가능)**
2. 첫 시험 조립 때 눈으로: 탭이 4.0 mm 키웨이에 걸림 없이 내려가는지(탭 두께 3.6 mm까지 들어감).
3. 탭 나사 4개 무게: 결합 나사 덩어리 40 g에 들어 있었는지(무게 목표 판정이 바뀜, 17.11).
4. 선(37 g/m)·불릿 무게, EDF 369 g에 원래 선이 들어 있는지(무게 목표).

**이제 필요 없는 것**: 선 출구 각도, 수축 튜브 길이·지름·겹 수·방향, 낱선 지름, 굽힘 반지름, 고정 날개 위치, 모터 돌출 길이, 묶음-림 틈.
(단, 17.3 표의 범위 끝이 한계입니다. 더 굵은 선이나 더 큰 묶음은 이 설계가 보장하지 않습니다.)

### 17.15 남은 일
* **C33**: 유선 FAIL 14.0 %, 하이브리드 FAIL 11.2 % - 17.10의 선택(무게중심 이동 권장, 또는 180°) 중 사용자 결정.
* 무게 목표 3.6 / 5.7 g 초과: 탭 나사 4개 무게 확인 또는 사용자 결정.
* C29 WARN(접착 틈 5 > 3.6 mm): 접착을 하지 않거나 두꺼운 RTV / 받침으로 해결. 한계 숫자는 그대로(규칙의 강도는 오류 → 경고, 17.9).
* 폼 패드 고정(A): 폼 응력 값은 가정. 매달린 자리에서는 정지 무게만으로 폼이 거의 다 눌립니다(17.7). 추력 시험으로 확인.
* 이빨 굽힘(17.4)은 손계산(E, 양끝 고정, PLA 굽힘 53 MPa)입니다. 실제 토크와 층 방향 강도는 재지 않았습니다.
* 블리스터의 로켓 공기역학(옆 힘, 압력 중심), 통로·블리스터 안 공동의 배기 영향(CFD·시험 없음).
* 해석용 대체 질량 모델(`sim/vehicle.py` 내부 추정, `sizing/structure_estimate.py`)은 아직 나사 장착(러그)을 그립니다. 시뮬레이션과 크기 산정은 CAD 보고서를 먼저 쓰므로 결과에는 영향이 없습니다.
* Fusion 360 GUI 실행(0.9.5): 사람이 직접 해야 합니다. 그 전까지 출력 파일은 임시(CadQuery STL)입니다.
* (2026-11-04 고침) 렌더 그림(발표용 7장, 수정라운드 1장)과 결과물 폴더 `B:\0)AI_Cad\CanSat_v0.9`(README, 06_3D_CAD의 CadQuery 보고서·검사·STL·STEP)는 11-04에 이 시계 장착 설계로 **갱신되었습니다**. 18장(흰색 몸통 + 로고)도 11-04 저녁에 결과물 폴더와 렌더(흰색 발표용 그림)에 반영했습니다.
* `제작가이드.md` 4장 1번의 서보선 각도(53°·143°·233°·323°)는 v0.6 기준으로 보입니다(v0.9 기둥은 −20° + 90° k). 이번 라운드에서 확인·수정하지 않았습니다.
* 파일: `params.json`(위 키들, `intake_module.wire_channel.bulkhead_hole_r`), `cad/layout.py`(`clock_fan_outline`, `_clock_fan`, `_clock_pads`, `_clock_seat`,
  `_motor_lead_clock`), `cad/cadquery/rocket_geometry.py`(`clock_*`, `lead_passage_cutter`, `lead_blister_parts`, `clock_lead_env`, `clock_lead_dropin`),
  `cad/cadquery/check_clock.py`(새 파일; 11-04 `teeth_bending`, `design_torque`, 정지 무게), `check_geometry.py`(C8, C10, C18, C19, C21, C29, C33, 새 C34·C35), `build_rocket.py`(보고서 `clock_route`),
  Fusion `CanSatEDFRocket.py` 0.9.5(`build_clock_mount`), `tools/fusion_api_lint.py`(나사 장착 레이아웃도 검사), `sizing/sizing.py`(블리스터 면적),
  `sizing/vtol_strength.py`(`clock_seat_sections`, `keyway_pad`), 시험 `test_cadquery_twin.py`(시계 장착 시험 8개). 보관본: `history/v0.9_wire_round2/`.

### 17.16 수정 라운드 (2026-11-04, 독립 검토 반영)
11-03판을 독립 검토자가 복사본에서 다시 돌려 보았습니다(무게·검사 결과는 똑같이 나옴). 찾은 문제와 처리입니다.
| 번호 | 내용 | 처리 |
|---|---|---|
| F1 (큼) | 193.55° 매달린 자리 키웨이 옆 1.73 mm 이빨이 모터 토크로 옆으로 휨(안전율 0.6-0.9, 검사 없음) | **고침**: 계획기를 바꿔 이빨 5.06 mm 이상(키웨이 25개), C35에 이빨 굽힘 줄 추가(도면에서 잼, 최소 5.9), 음성 대조 시험. 통로 옆 1.30 mm 조각(안전율 0.37)도 같이 없어짐 (17.4) |
| F2 (큼) | C33이 네 구성 모두 나빠짐, 하이브리드 새 FAIL; `theta_note`가 17.10과 다름 | **문구 고침**(`theta_note`), C33 숫자 갱신(17.10). 고치는 것은 **사용자 결정으로 남김**: 모듈 안에서는 효과가 작고, "−x 쪽 깎기"는 방향이 반대 |
| F3 (큼) | 문서는 "넣고 굽힘", 검사는 "굽히고 넣음" - 곧은 선으로는 못 넣음 | **고침**: 조립 순서(17.13, 제작가이드 3장 3번, params 메모) |
| F4 | C35가 EDF 무게로 폼이 눌리는 양을 뺌 | **일부 고침**: 두 탭 / 한 탭 정지 무게와 올라가는 거리를 C35에 숫자로 적음(17.7). 합격 기준에는 넣지 않음(50 % 한계는 조립 규칙). 추력 시험에서 봄 |
| F5 | 비스듬히 누운 12 × 5 묶음이 검사 격자·항력에 빠짐 | **고침**: 단면 `ribbon12x5_turned`(6.5 × 6.5) 추가 → C29 864개 0.0000 mm³, 항력 면적 325.0 mm² (6.0 %), 통로 바닥 0.1 mm 내려감 |
| F6 | 범위 끝에 추가 여유 없음 | **문서로 고침**(17.3 "범위가 곧 한계"). 바닥 여유를 키우는 것은 하지 않음(블리스터가 더 깊어짐) |
| F7 | 접착 틈 규칙이 오류 → 경고로 약해진 것을 문서가 말하지 않음 | **문서로 고침**(17.9). 한계 숫자는 그대로 |
| F8 | 낡은 문장들(theta_note, 제작가이드 4장 3번, README C10, 결과물 README 첫머리, 폼 마개 크기 없음) | **고침** |

## 18. 흰색 몸통 + YUCHAN 로고 (2026-11-04, 사용자 결정)

### 18.1 무엇을 바꿨나
* **색**: 기체의 출력 부품을 모두 **흰색**으로 바꿉니다. Bambu PLA Matte **Ivory White**(아이보리 화이트, 색값 #FFFFFF, 코드 11100)입니다.
  예전에는 PLA Matte 검정(Charcoal, 코드 11101)이었습니다. **발사대는 요청 범위가 아니라서 검정 그대로**입니다(`printer.color_exceptions`).
* **로고**: 위 몸통(전자부 모듈 `avionics_module`) 양옆, 방위 **67° / 293°**에 주황 **"YUCHAN"**을 넣습니다.
  Bambu PLA Matte **Mandarin Orange**(만다린 오렌지, #F99963, 코드 11300)입니다. 로켓과 VTOL(배터리·유선·하이브리드) 모두 같습니다.
  사용자가 고른 "launch" 안의 **세로판**입니다. 기체 축을 따라 아래에서 위로 읽고, 서 있는 기체를 밖에서 보면 글자 윗부분이 왼쪽을 향합니다.
  두 사본은 같은 다각형이고, 밖에서 보면 똑같이 읽힙니다(좌우가 뒤집히지 않음).
* **찍는 방법**: P2S + AMS로 찍는 **평평한 2색 상감**입니다(튀어나오지 않음). 주황은 **바깥 벽 한 줄, 0.42 mm 깊이**만 차지합니다.
  그 뒤에 흰 벽 두 줄(0.78 mm)이 남아서 벽이 끊기지 않습니다(AMS 비용 시험, M).
* KAIST 프리셋(전체 설계, 2 mm 벽, 슬라이스 안 함)은 이번 범위가 아니어서 로고가 없습니다(색만 흰색). 넣으려면 `livery.applies_to.presets`에 더하고 C36을 다시 돌립니다.

### 18.2 파일과 모델
* 로고 다각형: `cad/livery/yuchan_logo_polygons.json`, 생성기 `cad/livery/make_logo.py`(`glyphs.py`, `compose.py`). 같은 입력이면 같은 바이트가 나옵니다(시험 `test_livery.py`).
  CAD에는 꼭짓점을 0.005 mm 안에서 줄인 묶음(`polygons_s_z_cad`, 꼭짓점 3,564 → 714개)을 씁니다. 슬라이서 해상도(0.012 mm)보다 작은 차이입니다.
* `params.json`: `printer.color` = Ivory White(+ `color_hex`, `color_code`, `color_exceptions`), 새 `livery` 블록(부품, 방위, 높이 기준, 깊이, 색, AMS 설정, 검사 기준),
  `meta.v09_livery_note`, `printer.part_class.avionics_logo` = B_shell.
* `cad/layout.py` `Layout._livery`: 다각형을 모듈 위에 놓기만 합니다(다시 그리지 않음). 높이 기준은 모듈 아래 끝입니다(출력 높이 3.05-124.07 mm).
* CadQuery: `avionics_module`은 **흰 몸통**(0.42 mm 홈이 파인 것)이고, 새 출력 부품 **`avionics_logo`**가 그 홈을 채우는 **주황 상감**입니다(섬 10개 × 2 = 고체 20개).
  둘을 합치면 예전 모듈과 같습니다(18.3). 상감 부피 680.99 mm³. STEP 색: 출력 부품 흰색, 로고 주황, 발사대 검정.
* Fusion 스크립트 **0.9.6**: 같은 다각형으로 홈을 파고(`build_livery` CUT) 주황 바디를 만듭니다(`avionics_logo`). 출력 부품에 흰색, 로고에 주황, 발사대에 검정 외관을 줍니다.
  API 검사 0건, 모의 실행 5개 구성 실패 0, 재생 비교(X3) 전자부 모듈·로고 불리언 차이 **0.0000 / 0.0000 mm³**(로켓, VTOL 3개 구성). **Fusion GUI 실행은 아직 안 했습니다.**

### 18.3 새 검사 C36 (M)
| 항목 | 로켓 | VTOL 배터리 | 기준 |
|---|---|---|---|
| 판정 | **PASS** | **PASS** (유선 PASS, 하이브리드 PASS, KAIST N/A) | |
| 로고 + 3 mm 띠가 벽 밖으로 나간 부피 | 67° 0.0000, 293° 0.0000 mm³ | 67° 0.0000, 293° 0.0000 mm³ | < 0.05 mm³ |
| 로고에서 가장 가까운 빈 곳까지 (검토 F6 새 행, 부피 허용치 없음) | 67° / 293° 모두 3.051 mm (모듈 아래 끝) | 67° / 293° 모두 3.051 mm (모듈 아래 끝) | ≥ 3 mm |
| 가장 가까운 것까지 거리 (알려진 특징) | 모듈 아래 끝 3.05, 통풍 슬롯 5.93, 결합 나사 구멍 13.73 mm | 모듈 아래 끝 3.05, 창 6.57, 결합 나사 구멍 13.73 mm | ≥ 3 mm |
| 가장 가는 주황 획 / 흰 틈 | 2.20 / 1.84 mm | 2.20 / 1.84 mm | ≥ 1.6 / 1.2 mm |
| 가장 작은 섬 | 8.46 mm² | 8.46 mm² | ≥ 3 mm² |
| 깊이 (설계 / 잰 값) | 0.42 / 0.420 mm | 0.42 / 0.420 mm | ≤ 한 줄 0.42, 뒤 흰 벽 ≥ 0.78 |
| 흰 몸통 + 로고 − 예전 모듈 | +0.0000 mm³ | +0.0000 mm³ | 차이 ≤ 0.05 |
| 층마다 (검토 F7, 정보이고 판정 아님) | 주황 층 578, 한 줄보다 짧은 주황 4곳(가장 짧은 0.116 mm), 한 줄보다 좁은 흰 틈 3곳(가장 좁은 0.148 mm) | 같음 | - |
* 3 mm 검사는 두 가지로 봅니다. (1) "로고를 3 mm 키운 얇은 띠가 예전 모듈의 벽 안에 다 들어가는가"(불리언). (2) **검토 F6으로 새로 넣은 행**:
  사본마다 그 주변의 바깥 0.42 mm 띠에서 예전 모듈을 뺀 "빈 곳"(창·슬롯·구멍·모듈 양끝, 목록에 없는 것도)까지의 BRep 거리가 3 mm 이상인가.
  (1)은 부피 허용치(0.05 mm³) 때문에 약 0.15 mm까지 들어온 침범을 놓쳤습니다. (2)는 허용치가 없습니다.
  가장 가까운 것은 모듈 아래 끝(결합부)으로 3.051 mm입니다(규칙보다 0.05 mm 큼).
* 일부러 틀린 경우는 FAIL이 납니다(검사가 살아 있다는 증거, `test_livery.py`): 로켓 로고를 8 mm 올려 통풍 슬롯에 닿게 함, VTOL 사본 하나를 창 기둥(90°)으로 옮김, 깊이 0.84 mm(두 줄), 획 기준 2.5 mm,
  **로고를 0.1 mm 내림(끝까지 2.95 mm)**: (1)은 0.0097 mm³라서 통과하지만, (2)가 두 사본 모두 FAIL로 잡습니다(F6).
* 층마다 행(F7)은 정보입니다. 글자 끝이나 흰 쐐기 끝이 걸리는 몇 층에서는 0.42 mm보다 짧은 주황 조각이나 좁은 흰 틈이 생깁니다. 슬라이서가 이것을 빼거나 메웁니다.
  그래서 그 층에서는 작은 주황 점이나 흰 쐐기 끝이 그림과 조금 다를 수 있습니다(예상한 모습).

### 18.4 출력과 AMS 비용 (슬라이서 M, 퍼지량은 A)
전자부 모듈은 **필라멘트 2개짜리 Bambu 프로젝트 하나**(`cad/exports/print/provisional_v09_cadquery*/avionics_module.3mf`)입니다.
1번 Ivory White, 2번 Mandarin Orange, 둘 다 PLA Matte, P2S 0.4 / 0.20mm Standard, B 등급(벽 3줄, 위·아래 4층, 15 % 자이로이드), 벽 생성기 classic, **얇은 벽 감지(detect_thin_wall) 켬**.
* 퍼지량: 디스크에 있는 Bambu 측정표(`resources/flush/flush_data_standard.txt`)에서 가장 가까운 색 쌍을 썼습니다. 흰→주황 **150 mm³**, 주황→흰 **210 mm³**
  (밝은 회색 #D1D3D5 ↔ 주황 #FF6A13. 흰색·만다린 쌍은 표에 없음). **이 값은 가정값(A)입니다.** 그래서 아래 비용은 "이 A를 넣었을 때의 슬라이서 값(M)"입니다(검토 F10).
  주황에서 진짜 흰색으로 바꿀 때는 밝은 회색보다 퍼지가 더 필요할 수 있습니다(흰 벽에 주황 기운). 280 mm³ 줄이 위쪽 기준입니다.
* 프라임 타워: **켭니다.** 색을 바꾼 바로 뒤에 보이는 바깥 벽을 찍기 때문입니다(끄면 덩어리·빈틈이 로고 테두리에 생길 수 있음). 위치 x 20, y 205 mm.
  "채움/물체로 퍼지(flush into infill / objects)"는 쓰지 않습니다. 시험에서 이 설정이 주황을 없앴습니다(주황은 바깥 한 줄뿐).
* **고친 것(검토 F1)**: 얇은 벽 감지가 꺼져 있으면 classic 벽 생성기가 한 줄 폭의 주황 영역을 납작한 고리로 만들어 **같은 자리를 두 번(갔다가 돌아오며) 찍었습니다.**
  주황 경로 14,565 mm(한 번이면 약 8,109 mm), 주황 1.29 g(고체 0.89 g, +45 %)이었고, 홈이 넘쳐 튀어나올 수 있었습니다. 지금은 한 번만 지나갑니다.
  주황 경로 로켓 8,149 / VTOL 8,147 mm(한 번 지나갈 때 8,108 mm, 비 1.005), 주황 **0.902 g**(고체 0.892 g, +1.1 %). 흰 몸통은 0.001 g 안에서 그대로입니다.
  출력 파일을 만들 때마다 G-code로 이것을 검사합니다(`make_print_files.inlay_print_check`: 경로 ≤ 한 번의 1.15배, 무게 ±10 %; 지금 PASS).

| 항목 | 로켓 | VTOL |
|---|---|---|
| 색 바꿈 | **576번** (흰→주황 288, 주황→흰 288; 출력 높이 3.4-124.2 mm) | **576번** |
| 이 부품 시간 | 16 h 54 min (같은 부품 한 색 2 h 31 min) | 16 h 28 min (한 색 2 h 02 min) |
| 늘어난 시간 (퍼지 150/210, A) | **+14 h 23 min** | **+14 h 26 min** |
| 버리는 양: 퍼지 + 타워 | 135.8 + 44.6 = **180.4 g** | 135.8 + 44.6 = **180.4 g** |
| 비교: CLI 기본 퍼지 280 (위쪽 기준) | +15 h 30 min, 255.9 g | +15 h 34 min, 255.9 g |
| 필라멘트 흰 / 주황 (이 부품) | 228.1 / 75.6 g | 163.2 / 75.6 g |
| 부품 무게 흰 몸통 / 로고 (질량 표) | 123.92 / 0.90 g (예전 한 색 124.75 g) | 57.74 / 0.90 g (예전 58.55 g) |
* 색 바꿈 576번 = 주황이 찍히는 층 574개 + 주황 없이 색만 바꾸는 층 2개입니다(G-code로 셈, M). 고치기 전 580번은 여기에 0.4 mm보다 짧은 점만 찍는 층 4개가 더해진 값이었습니다(검토 F5).
  남은 2개의 이유: Bambu는 층마다 색 순서를 번갈아 바꿉니다. 그래서 주황 층이 홀수 개 이어진 뒤 다음 층은 주황으로 시작했다가 흰색으로 돌아갑니다(출력 높이 14.1 mm 배기 점선 끝, 124.1 mm 로고 맨 위).
  없애려면 점선 길이를 0.1 mm 안에서 고쳐야 합니다. 그러면 로고 모양이 바뀌어 CAD·Fusion·고정값을 모두 다시 해야 합니다. 이득은 약 3분, 약 0.6 g이라 이번에는 하지 않았습니다(사용자가 정할 일).
* 같은 프로젝트를 다시 슬라이스하면 3MF가 바이트까지 같지는 않습니다(부품 uuid, 예상 시간 수십 초). 색 바꿈 수와 색별 무게는 같습니다. 그래서 출력 파일은 해시가 아니라 G-code 숫자로 비교합니다(검토 F9).
* 주황은 G-code에서 부품 쪽으로는 **바깥 벽(Outer wall)에만** 나오고, 한 번만 지나갑니다(위 검사).
* 0.28 mm 층(이 부품만)은 쓰지 않았습니다. 주황 층이 578 → 412층으로 줄어 약 4시간을 아낄 수 있지만(E), 글자·창·구멍의 층 계단이 거칠어지고 질량을 다시 재야 합니다. 사용자가 정할 일입니다.
* **질량 표(`slicer_part_masses.json`, 검토 F3로 고침)**: 예전에는 흰 몸통은 파이프라인 설정, 주황은 실제 P2S 설정 값이라 두 설정이 섞였습니다. 그래서 예전에 보고한 로고 무게 차이(+0.22 / +0.16 g)는 설정 차이였습니다.
  지금은 다른 부품과 같은 파이프라인 설정으로 **로고를 채운 원래 모듈**을 슬라이스하고(로켓 124.79 g, VTOL 58.60 g),
  여기에 2색 슬라이스 안에서 잰 로고 차이(2색 흰 + 주황 − 같은 모양 한 색: 로켓 +0.031 g, VTOL +0.044 g)를 더합니다.
  주황은 0.902 g, 흰 몸통은 나머지입니다(모두 M). 원래 모듈을 두 부품 프로젝트로 슬라이스한 값은 예전 한 STL 값보다 0.04-0.05 g 큽니다(슬라이서 차이).
* **찾은 것(이번 범위 밖, 다음 단계 결정)**: 임시 출력 파이프라인의 부품 슬라이스(`tools/make_print_files.py` `slice_one`)는 Bambu 시스템 프로필을 파일 경로로 넘깁니다.
  이때 CLI가 상속을 풀지 않아서 200 × 200 mm 판, arachne 벽, 0.40 mm 선폭, 일반 시작 G-code로 슬라이스합니다(2026-11-04 확인, M). 다른 모든 부품의 무게·시간이 이 설정에서 나왔습니다.
  2색 프로젝트는 프로필을 풀어서(실제 P2S 설정, 판 256 mm, classic 벽, 선폭 0.42/0.45) 만들었습니다. 다른 부품을 다시 슬라이스할지는 다음 단계에서 정합니다(모든 무게 고정값이 바뀜).

### 18.5 전체 출력 계획과 필라멘트 (M, 퍼지 A 기준)
| | 로켓 | VTOL |
|---|---|---|
| 전체 시간 | 47 h 29 min (로고 전 33 h 29 min) | 32 h 41 min (로고 전 18 h 37 min) |
| 필라멘트 합계 | 1475 g (로고 전 1295 g) | 827 g (로고 전 647 g) |
| 흰색 (예비 10 % 포함) | 1230 g → 1353 g, 1 kg × 2 | 752 g → 827 g, 1 kg × 1 |
| 주황 | 76 g → 83 g, 1 kg × 1 | 76 g → 83 g, 1 kg × 1 |
| 검정 (발사대) | 169 g → 186 g, 1 kg × 1 | - |
* 전체 시간의 차이(로켓 +14 h 00 min, VTOL +14 h 03 min)는 18.4의 "+14 h 23 / 26 min"과 다릅니다(검토 F8).
  계획표의 모듈 시간은 이제 2색 프로젝트(실제 P2S 설정)의 시간입니다. 로고 전 계획의 모듈 시간은 파이프라인 설정의 한 색 시간(로켓 2 h 54 min, VTOL 2 h 25 min)이었습니다.
  실제 P2S 설정의 한 색 시간(2 h 31 / 2 h 02 min)이 23분 짧아서, 그만큼 차이가 줄어듭니다.
* 주황은 100 g도 안 쓰지만 1 kg 롤로만 팝니다(가격 조사 기준). 주황 g의 대부분은 퍼지와 타워입니다.
* 다른 부품은 모두 흰색 한 색입니다. **판(plate)에 2색이 있는 것은 전자부 모듈 하나뿐**입니다. 발사대 검정은 이미 있으면 새로 살 필요가 없습니다.

### 18.6 무게와 검사
| 구성 | 로고 전 | 지금 (검토 수정 뒤) | 차이 | 검사 C 행 FAIL / WARN (로고 전 → 지금) |
|---|---|---|---|---|
| 로켓 | 2,599.14 g | **2,599.21 g** | +0.07 g | 0 / 5 → 0 / 5 |
| VTOL 배터리 | 1,653.61 g | **1,653.70 g** | +0.09 g | 0 / 3 → 0 / 3 |
| 유선 | 1,405.71 g | **1,405.80 g** | +0.09 g | 1 / 2 → 1 / 2 |
| 하이브리드 | 1,526.71 g | **1,526.80 g** | +0.09 g | 1 / 2 → 1 / 2 |
| KAIST (로고 없음) | 4,396.84 g | 4,396.84 g | +0.00 g | 0 / 2 → 0 / 2 |
* 무게 변화는 같은 슬라이서 기준에서 잰 로고 차이(+0.03-0.04 g)와, 원래 모듈을 두 부품으로 슬라이스할 때 생기는 슬라이서 차이(+0.04-0.05 g)입니다(모두 M).
  검토 전 보고(+0.16 / +0.22 g)는 두 설정이 섞이고 주황이 두 번 찍힌 값이었습니다. C36은 모두 PASS이고, 예전 WARN / FAIL 행은 그대로입니다.
* 시뮬레이션의 "보조 끔 리미터 차단" 시험(`test_sim_assist_off_limiter_cuts`)은 **내부 추정 무게(2,585.71 g, E)에서만 통과합니다**(검토 F2).
  CAD 무게(2,599.21 g, M)로 같은 시나리오(시드 4, 14초, 보조 끔)를 돌리면 14초 안의 예측 정점이 최대 148.71 m라서 150 m 기준에 닿지 않고, I4 차단이 일어나지 않습니다.
  기준은 바꾸지 않았습니다. CAD 무게판 시험을 "알려진 실패(xfail, strict)"로 넣었고, 추정 무게가 CAD와 ±1 % 안에 있는지 보는 시험을 더했습니다(지금 −0.52 %).
  시나리오를 바꿀지(예: 14초보다 길게)는 사용자가 정할 일입니다.

### 18.7 예산
로켓 385,232 → **421,232원**, VTOL 배터리 357,192 → **375,192원**(검토 수정 뒤에도 같음).
PLA 줄을 색별로 나눴습니다(흰·주황, 로켓은 발사대 검정도). 값은 2026-10-13에 조사한 PLA Matte 리필 18,000원/kg이고, 색마다 같은 값이라고 가정했습니다(ASSUMED).

### 18.8 사용자가 할 일 / 남은 일
* 살 때 색 이름·코드를 확인합니다: **Ivory White 11100**(같은 PLA Matte에 Bone White 11103도 있음), **Mandarin Orange 11300**(발사대를 새로 찍으면 Charcoal 11101).
* 실제 색견본으로 대비를 봅니다(색값으로 계산한 대비 2.15:1, 낮은 편).
* **긴 출력(약 17시간) 전에 짧은 2색 시험 출력을 합니다**(실제 Ivory White / Mandarin 롤). 흰 벽에 주황 기운이 보이면 주황→흰 퍼지를 늘립니다(18.4, 퍼지량은 A).
* GPS 뚜껑도 이제 흰색입니다. 흰 PLA(보통 TiO2 안료, A)가 1575 MHz에 주는 영향은 확인하지 않았습니다. 뚜껑을 씌운 것과 벗긴 것의 C/N0를 비교합니다.
* Bambu Studio에서 2색 프로젝트를 열면 퍼지량 표가 다른 값(색 예측)을 보여 줄 수 있습니다. 더 크면 그 값을 씁니다(시간·버리는 양이 늘어남, 280이면 18.4의 비교 줄).
* 남은 일: Fusion 360 GUI 실행(0.9.6), 18.4의 슬라이스 설정 문제, 펌웨어 합격 기준 21행(탄도 이미지 해시 nav 24df85f3 / fcu aff391ca / com c9b2b3db) 사용자 선언.
* (2026-11-04 저녁 반영) 렌더 그림은 흰색 몸통 + 로고로 다시 그렸고, 결과물 폴더 `B:\0)AI_Cad\CanSat_v0.9`에 넣었습니다.
  펌웨어 헤더는 지금 `params.json`으로 다시 만들었습니다(`params_gen.h` 73df1d34, `gains.h` 15d1d043, `bridge_config_gen.h` 52bd1865, sha256 앞 8자리).
* 보관본: `history/v0.9_pre_livery/`(319개 파일, sha256 목록 `MANIFEST.json`, 설명 `ARCHIVE_README.md`). 시뮬레이션 수정 전은 `post_livery_pre_simfix/`, 검토 수정 전은 `post_simfix_pre_reviewfix/`(183개)입니다.

## 19. 로직 전원 - 1S 배터리 A 자리 + 상단 캡 스위치 (2026-11-05, 사용자 결정)

표시: M = 도구로 잰 값(CadQuery, 슬라이서, 검사), E = 추정, A = 가정(산 물건으로 재야 함).

### 19.1 사용자 결정 (2026-11-05)
1. **"배터리는 A 위치(6S 팩 −x 면)로 해줘"** - 캐리어 PCB rev 2c의 1S 로직 배터리를 6S 비행 배터리의 −x 면에 붙입니다.
2. **"상단 캡에 구멍 내기"** (질문 답) - 로직 전원 스위치를 VTOL 상단 캡의 구멍에 답니다. 기체를 닫은 채로 켜고 끕니다.
3. **"배터리 구성만 쓰기"** (질문 답) - 앞으로는 VTOL **배터리 구성만** 씁니다. A 자리는 유선·하이브리드 구성의 테더 키트 상자와 겹칩니다(PCB 검토 MF2-2).
   그래서 로직 배터리와 스위치는 배터리 구성 CAD에만 넣었습니다. **유선·하이브리드 구성은 이 캐리어로 더 맞추지 않습니다.** 지우지 않았고, 형상·검사·시험은 그대로입니다(`params.json` `power.maintained_sources`, `configs.vtol.logic_power.applies_note`).
4. **"이 배터리로 진행, 질량은 나중에 결정"** - 84 g 배터리로 갑니다. 무게는 사용자가 나중에 정합니다.
   그래서 시뮬레이션, 펌웨어 헤더(`params_gen.h`, `gains.h`, `bridge_config_gen.h`), HEX, 무게 목표는 **다시 만들지 않았습니다**(19.6).

### 19.2 무엇을 넣었나
* **로직 배터리**: 디바이스마트 16021596, DTP105565P 3.7 V 4200 mAh, 10.5 × 55.5 × 67 mm, 84 g(판매자 값). 보호회로(PCM) 내장, Molex 5264형 2핀 플러그, 1번 핀 = +(A).
  자리(M, Layout): x −48.4..−37.9, y −27.75..+27.75, z 346.1..413.1 mm. PCB 라운드가 가정한 상자와 같습니다. 6S 팩 −x 면에서 0.5 mm 떨어져 세워 둡니다(두께 x, 폭 y, 길이 z).
  리드가 나오는 끝(PCM 쪽)은 **위**로 둡니다(A). 아래 끝은 트레이 바닥 높이(z 344.1)보다 2.0 mm 위이고 서보선 묶음까지 3.86 mm(M, C37)라 선을 굽힐 자리가 없습니다.
* **고정**: 새 출력 부품은 없습니다. 6S 팩의 **아래 끈**(트레이 끈 구멍 z 361.1..381.1, 20 mm 폭)을 길게 해서 두 팩을 함께 감고, 위쪽(z 403.1)에 케이블 타이 하나를 두 팩에 감습니다. 6S 팩과 캐리어가 쓰는 방법(끈, 케이블 타이)과 같습니다.
  근거(E): 착지 충격 20 g(크기 산정의 가정값)에서 84 g × 20 g = 16.5 N. 마찰 계수 0.5(A), 두 면이면 끈 + 타이가 누르는 힘이 16.5 N 이상이어야 합니다. 꽉 당기고 흔들어 봅니다. 미끄러져도 아래는 서보선 묶음이고 팬이 아닙니다.
  타이는 트레이 경량 구멍의 바깥 끝(|y| 33 mm)으로 지나갑니다(A). 길게 한 아래 끈은 이제 6S 팩 −x 모서리를 직접 감지 않습니다(M, Layout: 끈 고리의 모서리는 1S 팩 바깥 모서리와 트레이 슬롯뿐). 6S 팩 아래쪽은 끈이 1S를 통해 누르는 힘(마찰)과 위 끈으로 잡힙니다(E). 흔들기 시험에서 확인합니다.
  끈·타이와 선(평면, E, `Layout.lp_band_leads`, C37에 보고): 스위치 선은 끈과 타이 고리 **안쪽**입니다(끈과 2.41 mm, 타이는 선을 0.11 mm 눌러 잡음). 배터리 선은 두 고리 **바깥쪽**입니다(끈 위를 1.14 mm 겹쳐 지나감, 타이와 0.64 mm).
* **스위치**: MTS-102 토글(리드 달린 판, 디바이스마트 13029107). **판매 페이지 치수는 디스크에 없습니다.** 흔한 MTS-102 값을 가정했습니다(A): M6 × 0.75 부싱, 판 구멍 Ø6.2, 판 아래 몸통 8 × 13 × 10 mm(+ 납땜 단자·수축 튜브 5 mm), 판 위 너트·부싱 5 mm + 레버 10 mm. **산 물건을 재고 나서 캡을 출력하세요.**
  자리: 상단 캡 r 43 mm, 140°(x −32.94, y +27.64). 112.5° / 202.5° 리브 사이, J15 바로 위입니다. 안쪽 너트(2 mm, A)를 부싱의 몸통 쪽 끝까지 돌려 내려 판 아래에 두고, 판 위에 잠금 와셔(0.5 mm, A)와 바깥 너트가 옵니다. 너트 맞변 8 mm(A)가 구멍 둘레에 0.90 mm씩 닿습니다(기준 ≥ 0.8 mm, A).
  하네스는 3선(2단 3P, SPDT)입니다. 가운데 선(공통)과 바깥 선 하나만 J15에 씁니다. 접점 정격 ≥ 2 A(PCB spec 가정)를 산 물건으로 확인합니다.
  **캡 나사 길이 제한**: 상단 캡의 M3 결합 나사 4개(45/135/225/315°, z 466.6)는 **M3×6 이하**입니다. 스위치 몸통이 135° 나사 축 위에 있습니다. 프로젝트의 "길이 무관" 나사 대용품은 몸통과 겹칩니다. M3×6은 몸통에서 2.63 mm(Layout, 나사 끝을 둥글게 본 보수적 값) / 3.76 mm(C38 고체, M)이고 기준은 2 mm입니다. M3×8은 1.03 mm라 Layout이 거부합니다. 2 mm를 지키는 가장 긴 나사는 6.7 mm입니다(Layout).
* **선**: 스위치 → J15(JST-PH 2핀, 하네스의 듀폰 끝을 잘라 다시 압착, PCB README 7.1). 스위치 단자에서 똑바로 내려가 J15에 꽂습니다. 길이 경로 118 mm + 여유 60 mm = **178 mm**(E).
  배터리 → J14(배터리 자체 리드, Molex 5264형 → SPOX 세로형): 배터리 윗끝에서 나와 +y 끝을 넘어(x −40, y 31.8) 내려가 J14로. 경로 95 mm + 여유 20 mm = 115 mm 필요(E). 산 배터리의 리드 길이를 재세요(A).
  PCB rev 2c는 리드 끝 +y와 평면 6 mm를 가정했습니다. CAD는 리드 끝을 위(A)로 두므로 배터리 선이 약 115 mm(E) 필요합니다. 선이 짧으면 Molex 5264 2핀 연장선(암-수, 약 60 mm, 1번 = + 유지)을 만듭니다(약 1 g, A, 대기 질량에 넣지 않음).
* **6S 감지선(J18)**: J18 플러그는 1S 팩 바로 아래(1S 바닥과 캐리어 윗면 사이 4 mm)에 있습니다. J18 → 6S 감지선 경로는 모델에 없습니다(6S 리드가 나오는 끝은 A). 1S 팩 −x 면과 관 벽 사이(y −17.7에서 7.7 mm, M) 또는 6S 팩 아래 4 mm 틈(M)으로 지납니다. 1S 모서리와 관 벽 사이(3.0 mm)는 쓰지 않습니다. 조립할 때 재야 합니다.
  캡은 떼어 낼 수 있습니다. 스위치 선은 J15에서 뺍니다. 여유 60 mm가 캡 스커트 물림 15 mm보다 길어서 캡을 먼저 들어 올린 뒤 뺄 수 있습니다(M). J15는 136° 창의 아래 끝에서 17.2 mm입니다(M, 캡을 뗀 뒤 핀셋으로).
* **충전**: 문서에 충전 단자가 없어서 **배터리를 꺼내 충전합니다**(A): 캡을 떼고, J14를 빼고, 아래 끈과 타이를 풀어 꺼냅니다. 1S Li-Po 충전기로 충전합니다.

### 19.3 파일과 모델
* `params.json`: 새 블록 `configs.vtol.logic_power`(배터리, 고정, 스위치, 선, 여유, 캐리어 플러그 상자, 충전, 메모), `power.maintained_sources` / `maintained_note`, `meta.v09_logic_power_note`. 결정과 날짜를 메모에 적었습니다.
  캐리어 플러그 상자(J7, J8-J11, J14, J15, J18)는 PCB 라운드의 `pcb/vtol_carrier/out/reports/board_metrics.json` `cad_round_envelopes` 값입니다(PCB 파일은 읽기만 했습니다).
* `cad/layout.py`: `_top_cap`이 스위치 구멍을 `cap_holes`에 넣습니다(기존 구멍 규칙이 모두 적용됨). 새 `_logic_power`가 배터리 상자, 스위치, 선 경로, 플러그 상자, 여유(`lp_clearance`)를 만들고 모자라면 멈춥니다.
* CadQuery(`rocket_geometry.py`): 상단 캡에 구멍. 새 고체 `logic_pack`, `logic_switch`, 검사용 선 통로(Ø3.0, A)와 플러그 상자. STEP에 들어갑니다.
* Fusion 스크립트 **0.9.7**: 같은 구멍(`cap_holes`), 새 컴포넌트 `logic_pack`, `logic_switch`(`build_logic_switch`), 묶음 질량 `logic_switch_lead`, `logic_retention`.
  API 검사 0건, 모의 실행 5개 구성 실패 0, 재생 비교(X3) 불리언 차이: 상단 캡 **0.0000 / 0.0000 mm³**(배터리, 구멍 포함), `logic_pack` 0.0000 / 0.0000, `logic_switch` 0.0000 / 0.0000 (M). 유선·하이브리드 상단 캡도 0.0000 / 0.0000(구멍 없음). 흡입부·트레이는 예전과 같은 재생기 한계. **Fusion GUI 실행은 아직 안 했습니다.**

### 19.4 새 검사 C37-C40 (M, VTOL 배터리; 유선·하이브리드·로켓·KAIST는 N/A)
| 검사 | 판정 | 잰 값 | 기준 |
|---|---|---|---|
| C30 상단 캡 (기존 검사) | **PASS** | GPS 패치 끝 z 485.90 = 기체 맨 위. **이름 붙인 예외 하나**: 로직 스위치 레버 끝 z 490.30(+4.40 mm, 고체로 잼, 질량 스위치와 상관없음) - C39가 판정 | 예전과 같음(테더 부츠 말고는 예외 없음 + 레버). **→ 19.12: 이제 칼라 테두리(z 492.50)가 맨 위이고, C30은 칼라와 그 안의 레버(`logic_switch`)만 이름 붙여 뺍니다** |
| C37 배터리 A 자리 | **PASS** | 6S 팩과 0.50 mm(겹침 0.0000 mm³), 관 벽 3.01, 스위치 선 3.46, 서보선 묶음 3.86, 캐리어 4.00, J15 6.40, J14 6.49, J7 8.41, GPS 선 11.47, J8-J11·J18 14.40 mm. 보고만(E): 끈·타이와 선(19.2), 끈이 6S 모서리를 감는 수 0, J18 감지선 경로 없음 | 6S는 겹치지 않음(끈으로 붙임), 벽 ≥ 1, 선·플러그 ≥ 2(MF2-10), 다른 부품 ≥ 2 |
| C38 상단 캡 스위치 | **PASS** | 구멍 열림(0.0000 mm³), 스위치 × 캡 0.0000 mm³, 몸통·단자 → 캡 2.00 mm, 판 아래 6S 5.52 / 전자부 모듈 6.70 mm, 선 통로 겹침 0. 캡 나사 M3×6(최대) 135° → 몸통 3.76 mm(고체; 길이 무관 대용품은 59.1 mm³ 겹침, 2 mm를 지키는 가장 긴 나사 6.7 mm). 너트 지지 폭 0.90 mm(A) | 몸통 → 캡 ≥ 1.2, 판 아래·캡 나사 ≥ 2, 너트 지지 ≥ 0.8(A) |
| C38 강도 규칙 | **PASS** | 구멍 가장자리 → 가장 가까운 리브 중심선 16.76 mm(T 플랜지 반폭 9.60), 림 링 안쪽 8.40 mm → 리브 단면계수·환형 전단 그대로(리브 안전율 사용 3.08, 증명 1.03 그대로) | `sizing/vtol_strength.py` top_cap |
| C39 손 닿음 | **WARN** | 레버 끝 캡 위 15.0 mm(A), z 490.30 = **배터리 구성의 기체 맨 위**(GPS 패치보다 +4.40 mm, M). 아이볼트는 이 구성의 부품이 아닙니다(붙잡는 줄 시험 때만 달면 레버보다 10.0 mm 높음). 손가락 원 Ø20 안에 다른 것 없음, 캡 가장자리 안쪽 7.0 mm | 손가락 원 비어 있음, 몸통 반지름 안, 아이볼트(달았을 때)보다 낮음; 레버가 맨 위면 WARN(사용자 결정). **→ 19.12: 보호 칼라로 PASS** |
| C40 질량 스위치 | **PASS** | 보고서 parts에 로직 부품 없음, 상단 캡 질량은 구멍 없는 캡(27,506.06 mm³, 슬라이서 값). 지금 1,653.70 g → 넣으면 1,745.04 g | `in_flight_mass_model` false를 지킴 |
* 레버의 위치(C39, 보고만 함): 기체는 날개 다리로 섭니다. 옆으로 눕혀도 레버는 몸통 반지름 안(축에서 43 mm, 가장자리 17 mm 안쪽)이라 바닥에 닿지 않습니다.
  윗 모서리로 넘어지면 캡 가장자리 → 아이볼트 끝 선이 그 반지름에서 8.5 mm 높이라 레버가 6.5 mm 더 나옵니다(GPS 패치처럼). 이것은 사용자 판단으로 남깁니다.
  붙잡는 줄(catch line)은 아이볼트 끝에서 위로 나가고, 그 끝은 레버 끝에서 44.1 mm입니다. 레버가 GPS 패치 하늘을 가리는 폭은 7.4°, 높이 3.8°입니다.
  자유 비행(아이볼트 없음)에서는 레버가 기체 맨 위입니다. 뒤집어 놓거나 윗 모서리로 넘어지면 레버가 먼저 닿습니다. 받아들일지, 캡과 한 몸인 보호 칼라를 둘지, "뒤집어 놓지 않음"으로 할지는 **사용자 결정**입니다(C39 WARN).
  참고: 기존 아밍 스위치(90°, r 40, M6 미니 토글 A)도 레버가 캡 위로 나올 것입니다. 그 레버는 모델에 없어서 예전 C30도 세지 않았습니다.
* 검사 판정 합계(C 행 FAIL / WARN, M): VTOL 배터리 0 / **4**(C10, C29, C33 - 예전과 같음, + C39 레버), 유선 1 / 2, 하이브리드 1 / 2(C33 - 예전과 같음), 로켓 0 / 5, KAIST 0 / 2. 예전 기준은 하나도 바꾸지 않았습니다.

### 19.5 상단 캡 출력 파일 (슬라이서 M)
* 구멍이 생긴 상단 캡만 다시 슬라이스했습니다(`make_v09_print_files.py --config vtol --parts top_cap`). 다른 부품은 그대로입니다.
  부피 27,506.06 → 27,469.83 mm³(−36.23 mm³), 무게 35.153 → **35.107 g(−0.046 g)**, 출력 시간 42 min 56 s → 43 min 25 s. VTOL 전체 출력 계획은 그대로 32 h 41 min, 827 g입니다.
* 슬라이서 표(`slicer_part_masses.json`)는 구멍 없는 캡의 값을 `top_cap@no_logic_switch_hole`로 남깁니다. 유선·하이브리드 구성과 (지금의) 비행 질량 모델이 이 값을 씁니다. 보고서는 고체 부피가 같은 항목만 씁니다(같은 1e-6 규칙).
* 고친 것(도구): 부분 실행(`--parts`)이 출력 계획을 그 부품만 남기고 덮어쓰던 문제를 고쳤습니다. 이제 다른 부품 항목을 남기고 로그는 이어 씁니다.

### 19.6 질량 - 결정 대기 (M: CadQuery 질량 특성, 부품 질량은 A)
**이름 붙은 스위치 하나**: `params.json` `configs.vtol.logic_power.in_flight_mass_model` = **false**(결정 4를 메모로 적음). 질량 코드(`build_rocket.py`)가 이 값을 따릅니다.
false인 동안 로직 부품과 캡 구멍은 보고서 `parts` / `totals`에 들어가지 않습니다. 상단 캡 질량은 구멍 없는 캡으로 잽니다(구멍도 같은 스위치 뒤에 둠). C40이 이것을 확인합니다.
| | 질량 | 무게중심 (x, y, z) mm | 옆 치우침 | Ixx / Iyy / Izz kg m² |
|---|---|---|---|---|
| 지금 (시뮬레이션·펌웨어가 읽는 값, 그대로) | **1,653.70 g** | (+1.32, −0.19, 245.32) | 1.34 mm, C33 7.7 % WARN | 0.03551 / 0.03580 / 0.003312 |
| 로직 전원을 넣으면 | **1,745.04 g** | (−0.98, −0.09, 252.58) | 0.98 mm, C33 1.2 % PASS | 0.03726 / 0.03769 / 0.003506 |
* 차이: **+91.34 g**(배터리 84, 스위치 4, 선 1.39, 끈·타이 2.0 - 모두 A, 캡 구멍 −0.046 M), 무게중심 z +7.25 mm, 관성 +4.9 / +5.3 / +5.9 %. 무게 목표 1,650 g보다 지금 +3.7 g, 넣으면 **+95.0 g**.
* PCB 스펙이 추정한 옆 치우침 0.84 mm(E)보다 실제 CAD는 0.98 mm(M)입니다(스위치·선이 −x/+y에 있음). 그래도 지금보다 0.36 mm 줄어듭니다.
* 추력 대 무게(E, 추력은 아직 재지 않음, `edf.thrust_v09` 설계 범위): 2.14 kgf에서 1.29 → **1.23**(목표 1.3 아래), 3.09 kgf에서 1.87 → 1.77.
* 질량을 반영하면 강도 손계산(`sizing/vtol_strength.py`, 착지·다리 하중은 보고서 질량에 비례)도 다시 돌리고, 트레이 검사에 1S 팩 하중을 더해야 합니다(대기 보고서 3장).
* 보고서: `cad/exports/logic_power_pending_mass_vtol.md` / `.json`(`build_rocket.py --config vtol`이 씀), 같은 숫자가 `cadquery_report_vtol.json` `extra.logic_power`에 있습니다.
* 펌웨어 헤더(M, `--check`): `params_gen.h` STALE, `bridge_config_gen.h` OUT OF DATE, `gains.h` up to date. 바뀌는 것은 원본 sha256 줄과 params 태그(FC_PARAMS_TAG)뿐입니다(스크래치에 만들어 비교, 질량·게인 줄은 같음). **결정 4대로 다시 만들지 않았습니다.**
* 결정하면: `in_flight_mass_model`을 true로 바꾸고 CAD → 크기 산정 → 시뮬레이션(게인) → 펌웨어 헤더·HEX 순서로 다시 만듭니다. 제어가 바뀌면 전/후 비교 영상 규칙을 따릅니다.

### 19.7 검증 (M)
* 비행 질량 모델은 바이트 단위로 같습니다: 다섯 구성 모두 보고서 `parts`·`totals`가 바꾸기 전과 같음. `derived`는 VTOL 배터리의 `vehicle_h_mm` 하나만 485.90 → **490.30 mm**입니다(검토 반영 F1: 높이는 형상이라 레버를 질량 스위치와 상관없이 셈). **→ 19.12: 보호 칼라 뒤에는 492.50 mm(칼라 테두리)**입니다. 시뮬레이션·크기 산정은 이 값을 읽지 않습니다(`L.vehicle_h`를 씀). STL은 VTOL 배터리 `top_cap.stl` 하나만 바뀜(유선·하이브리드 STL 20개는 예전 VTOL STL과 같은 바이트).
* pytest: 19.8.

### 19.8 pytest (M, 2026-11-05, 같은 명령으로 바꾸기 전 / 뒤)
| 묶음 | 바꾸기 전 | 바꾼 뒤 | 바꾼 뒤 실패의 이유 |
|---|---|---|---|
| `cad/cadquery` | 130 통과, 4 실패, 3 건너뜀 | 141 통과, 4 실패, 3 건너뜀 → 검토 반영 뒤 **147 통과, 4 실패, 3 건너뜀** | 예전과 같은 4개: 로켓 C 행 수(32를 기대; 리버리 라운드부터 33, 이번에 C37-C40 N/A가 더해져 37 - 기대값은 바꾸지 않음), VTOL C29·C33 WARN, 무게 목표 2개(1,653.7 > 1,650, 1,405.8 > 1,400). 새 시험 `test_logic_power.py` 17개 통과(검토 반영 6개 추가) |
| `sim` | 548 통과, 5 실패, 4 건너뜀, 3 예상 실패 | 548 통과, 5 실패, 4 건너뜀, 3 예상 실패(검토 반영 뒤에도 같음) | 예전과 같은 VTOL 시나리오 5개. `test_sim_assist_off_limiter_cuts_at_cad_mass`는 그대로 strict xfail |
| `sizing` + `tools` + `firmware/atmega128_fc/tools` | 559 통과, 1 건너뜀 | 556 통과, **3 실패**, 1 건너뜀(검토 반영 뒤에도 같음) | 헤더 최신 여부 시험 3개(`params_gen.h` STALE 2, `bridge_config_gen.h` 1): `params.json`이 바뀌어서. 결정 4대로 다시 만들지 않음(19.6, 19.10 F2) |
* 새 시험(`cad/cadquery/test_logic_power.py`): 블록이 로켓에 새지 않음, 배터리 구성에만 있음(유선·하이브리드 캡은 예전 캡과 같은 부피), 구멍이 판 두께만큼만 뺌,
  질량 스위치 false는 비행 모델 그대로 / true면 부품이 들어가 합계가 대기 보고서의 값과 같음, C37-C40 PASS / 다른 구성 N/A, 침입 고체를 넣으면 C37·C38·C39·C40이 FAIL(음성 대조, 기준은 그대로),
  리브 위 스위치·6S 팩과 겹치는 배터리·림 링 위 스위치는 Layout이 거부.
* 첫 전체 실행에서 새 시험 1개가 실패했습니다: 배터리를 6S 팩에 1 mm 겹치게 하면 Layout이 다른 규칙(스위치 선 → 배터리 1.96 mm)으로 먼저 멈췄습니다.
  원인은 "6S 팩과의 틈" 규칙이 상자 거리(겹치면 0)를 써서 겹침을 못 잡은 것입니다. 부호 있는 x 틈으로 고쳤습니다(지금 값 0.50 mm는 같음, 보고서 바이트 같음). 그 뒤 전체를 다시 돌린 값이 위 표입니다.

### 19.9 재야 할 것 / 남은 일
* MTS-102 실물: 부싱 지름·길이, 판 아래 몸통 크기, 레버 높이, 너트 맞변(8 mm A), 접점 정격(≥ 2 A). 다르면 `logic_power.switch`를 고치고 다시 만듭니다(구멍 Ø6.2는 A).
* ~~**사용자 결정 필요**: 레버가 배터리 구성의 기체 맨 위입니다(C39 WARN, 19.4). 받아들이기 / 보호 칼라 / 뒤집어 놓지 않기 중 하나.~~ → **결정됨(2026-11-05): "상단 캡과 한 몸으로 출력하는 보호 칼라를 달아줘"**. 19.12에서 넣었습니다(C39 PASS).
* **사용자 확인 필요**: 상단 캡 나사를 M3×6 이하로 정했습니다(19.2). 원하지 않으면 스위치를 135° 선 밖(θ ≥ 약 150°)으로 옮겨야 하고, 그러면 J15까지 선에 굽힘이 하나 생깁니다.
* J18 → 6S 감지선 경로(19.2): 6S 리드가 나오는 끝을 재고 실제 길을 정합니다.
* 1S 배터리 실물: 크기, 무게, 리드가 나오는 끝과 길이, 플러그 극성(1번 = +).
* 스위치 하네스 리드 길이(178 mm 이상 필요, E).
* 끈 + 타이로 흔들어 보기(19.2).
* 질량 결정(19.6). 유선·하이브리드 구성을 다시 쓸 때는 로직 배터리 자리를 새로 정해야 합니다.
* Fusion 360 GUI 실행(0.9.7). 검토 반영은 형상을 바꾸지 않아 Fusion 스크립트는 0.9.7 그대로입니다(API 검사 0건, VTOL 모의 실행 OK, M).
* 이번 일은 제어 변경이 아니라서 전/후 비교 영상은 만들지 않았습니다.
* 보관본: `history/v0.9_pre_logic_power/`(바뀔 파일의 바이트 복사, sha256 목록 `MANIFEST.json`, 설명 `ARCHIVE_README.md`, 결과물 폴더의 바뀐 파일은 `deliverables_CanSat_v0.9/`).

### 19.10 독립 검토 반영 (2026-11-05)
검토 3개(형상, 질량·시험, 문서·PCB)의 지적을 직접 다시 재고 고쳤습니다. 수정 전 파일: `history/v0.9_pre_logic_power/post_impl_pre_reviewfix/`.
* G1(큰 문제): 스위치 몸통이 135° 캡 나사 축 위에 있습니다(길이 무관 대용품과 59.1 mm³ 겹침, M). → 캡 나사 **M3×6 이하**(`switch.cap_joint_screw_max_len`). Layout이 막고, C38이 고체로 잽니다(3.76 mm). M3×8을 넣으면 Layout이 거부합니다(시험).
* G2 / F1(큰 문제): 배터리 구성에는 아이볼트가 없어서 레버가 기체 맨 위입니다. "아이볼트보다 10 mm 낮음"은 아이볼트를 달았을 때만 맞습니다. C30이 레버를 숨기던 조건을 이름 붙인 예외로 바꾸고(값을 적음), C39가 WARN을 냅니다. 보고서 높이(`derived.vehicle_h_mm`)는 레버를 셉니다(490.30 mm).
* G3 / DP-10: 끈·타이 고리와 선의 관계를 Layout이 평면으로 계산해 C37에 보고합니다(E). 스위치 선은 고리 안쪽, 배터리 선은 바깥쪽. 아래 끈이 6S 모서리를 감지 않는 것도 적었습니다.
* G4: J18 감지선 경로는 모델에 넣지 않았습니다(6S 리드 끝 A). 지날 수 있는 틈(7.7 mm, 4 mm, M)과 피할 곳(3.0 mm)을 적었습니다.
* G5: 너트 지지 폭 규칙((맞변 − 구멍) / 2 ≥ 0.8 mm, A)과 부싱 위 나사산 여유(≥ 바깥 너트 + 잠금 와셔)를 Layout·C38에 넣었습니다. 구멍 Ø6.8은 Layout이 거부합니다(시험).
* G6: Fusion 재생 기록(`x3_replay.json`)의 상단 캡·`logic_pack`·`logic_switch`를 확인하는 시험을 더했습니다(불리언 차이 < 1 mm³, 쌍둥이 부피 = 지금 CadQuery 고체).
* G7: C40 문구를 질량 스위치에 맞췄습니다(true면 "the flight model is the with case").
* F2: 도구 시험 3개 실패는 예상된 것입니다: `test_header_on_disk_is_current`, `test_all_three_generated_headers_are_current`(`params_gen.h`), `test_bridge_header_is_current_and_matches_params`(`bridge_config_gen.h`). 원인은 `params.json`과 CAD 보고서 sha가 바뀐 것뿐입니다(질량·게인 줄은 같음, M). 시험을 느슨하게 하지 않았습니다. **다음 펌웨어 라운드는 질량 결정과 상관없이 헤더 3개와 HEX를 다시 만들어야 합니다**(FC_PARAMS_TAG가 바뀜). 사용자 결정(2026-11-05): **"다음 펌웨어 작업 때 만들자"** - 보호 칼라 라운드(19.12)에서도 다시 만들지 않았고, 이 시험 3개는 다음 펌웨어 라운드까지 실패로 남습니다.
* F3: 대기 보고서 3장에 강도 손계산과 추력 대 무게를 더했고, 1장에 T/W(E)를 넣었습니다.
* DP-1: 결과물 폴더 복사본을 검토 반영 뒤 파일로 다시 맞췄습니다(`logic_power_copy_sha256.json` 다시 만듦).
* DP-2, DP-4, DP-5, DP-6, DP-8: 배터리 선 길이와 연장선, 3선 하네스 배선, 안쪽 너트 위치, "서보선 2 mm" 표기, 스위치 선 길이를 제작가이드 14단계와 19.2에 고쳤습니다.
* DP-7: 소절 번호(19.8 pytest, 19.9 남은 일). DP-9: `README.md`, `check_geometry.py` 첫 설명, `docs/SPEC.md` 검사 표(C37-C40).
* 판정 기준은 하나도 느슨하게 하지 않았습니다. 바뀐 판정은 C39 PASS → WARN 하나입니다.

### 19.11 PCB 문서와의 관계
* PCB README 9.1(스위치 선택지 MF2-3, 158° 창 토글, 끈 방법, 다른 구성의 자리, 약 88 g E)과 `carrier_spec.json`의 `power.switch_reachability.options_user_decision`, `user_decisions[0]`의 열린 질문은 사용자 결정 2·3과 이 장으로 끝났습니다.
* PCB 파일은 이번에 읽기만 했습니다(`pcb/vtol_carrier`). 다음 PCB 라운드에서 그 문서를 이 결정에 맞춰 고칩니다.
* 무게 차이: PCB 문서의 약 88 g(E)은 배터리 + 몇 g이고, CAD의 +95.0 g(M 계산)은 1,650 g 목표 기준이며 스위치 4 g, 선 1.39 g, 끈·타이 2.0 g(A)이 들어 있습니다(+91.34 g는 지금 비행 모델 대비).
* 배터리 리드: PCB는 리드 끝 +y, 평면 6 mm를 가정했고, CAD는 윗끝(A)으로 115 mm가 필요합니다(19.2).
* J14·J15 위치는 CAD와 모순이 없습니다(스위치 구멍이 J15 바로 위, M).

### 19.12 스위치 보호 칼라 (2026-11-05, 사용자 결정)

표시: M = 도구로 잰 값(CadQuery 고체, 슬라이서, 검사), E = 추정·손계산, A = 가정(산 물건으로 재야 함).

#### 19.12.1 결정과 이유
* 사용자 결정(2026-11-05): **"상단 캡과 한 몸으로 출력하는 보호 칼라를 달아줘"**. 검토 G2(19.10)의 답입니다. 레버 끝(z 490.30)이 배터리 구성의 맨 위였고 C39가 WARN이었습니다.
* 칼라는 상단 캡과 **한 몸으로 출력**합니다. 따로 붙이는 부품, 접착제, 나사가 없습니다. 배터리 구성에만 있습니다(로직 전원과 같음).
* 사용자 말(2026-11-05): "나사 길이는 여러 길이를 써도돼". 상단 캡 결합 나사는 지난 라운드대로 **M3×6 이하**입니다(바꾸지 않음, C38 그대로).
* 이번 일은 **제어 변경이 아닙니다.** 그래서 전/후 비교 영상은 만들지 않았습니다.

#### 19.12.2 모양 (params `configs.vtol.logic_power.collar`, 치수의 원본은 이 블록 하나)
* 둥근 관입니다. 스위치와 같은 축(r 43 mm, 140°)에 판 윗면에서 섭니다. 안지름 **Ø21.0**, 벽 **2.4 mm**, 바깥 Ø25.8, 판 위 높이 **17.2 mm**(테두리 z 492.50).
* **손가락 홈 2개 (U자 홈, 독립 검토 반영 19.12.9)**: 레버가 젖혀지는 방향(기체 y, A)의 양쪽 끝에 있습니다. 폭 **17.0 mm**이고 바닥은 반지름 8.5 mm의 반원입니다. 가장 낮은 곳은 판 위 **5.0 mm**(z 480.30), 반원 중심은 판 위 13.5 mm(z 488.80)이고, 그 위는 곧은 옆면이 테두리까지 갑니다. 그 아래 5.0 mm는 끊기지 않은 고리입니다.
  (처음 설계는 폭 16 mm, 판 위 5.4 mm부터의 네모 홈이었습니다.)
  * 홈이 있는 이유: 닫힌 Ø21 컵 안에서는 손끝이 젖혀진 레버 끝의 바깥쪽(축에서 7.6 mm, 벽까지 2.9 mm, E)에 들어가지 못합니다. 그러면 한쪽으로만 밀 수 있습니다. 홈으로 손끝이 옆에서 들어와 레버 끝을 반대쪽으로 넘깁니다. 홈 하나가 한 방향입니다.
  * 폭 17 mm인 이유: 손끝(Ø16 공, A)이 레버를 가운데 너머로 미는 **동안 내내** 홈 옆면에서 0.5 mm씩 떨어지게 했습니다(`finger_path_margin_min` 0.5, A). 16 mm 홈은 이 틈이 0 mm였습니다.
  * U자 바닥인 이유: 둥근 손끝 모양을 따라가서 홈이 필요한 만큼만 깊습니다. 그리고 네모 홈 바닥의 날카로운 안쪽 모서리(옆 하중 응력이 가장 큰 곳, 층 경계 위)가 없어집니다.
  * 홈은 물 빠짐 역할도 조금 합니다(홈 바닥 높이까지). 홈 아래 컵에는 물이 약 5 mm 고일 수 있습니다. 비 오는 날은 날리지 않습니다(맨 스위치도 같은 길로 물이 샜음).
* **판 아래로 넣는 홈(리세스)은 쓰지 않았습니다.** 판이 1.2 mm라 홈은 판 아래로 매달린 컵이 됩니다. 그러면 판의 열린 지름이 Ø21이 되어 리브 T 플랜지 규칙(구멍 가장자리 → 리브 중심선 ≥ 9.60 mm)이 9.36 mm로 깨지고(E), 그 컵 바닥은 바로 세워 출력할 때도 서포트가 필요합니다. 칼라를 1-2 mm 낮추는 이득보다 손해가 큽니다.
* 레버가 쓰는 공간(A, params 값): 레버는 기체 y로 **±20°** 젖혀집니다(`switch.lever_throw_deg_ASSUMED`). 회전 중심은 부싱의 몸통 쪽 끝(안쪽 너트 아래, z 472.10)으로 잡았습니다(`lever_pivot_ASSUMED`). 가장 낮은 회전 중심이라 끝이 가장 멀리 갑니다(보수적).
  레버 끝이 가장 높은 곳은 거의 세운 자세입니다: z **490.36**(끝면 모서리, 세웠을 때 490.30). 젖힌 끝은 축에서 **7.63 mm**까지 갑니다(E, Layout).
* 판정 규칙과 값(M = 고체, E = Layout):

| 규칙 | 값 | 기준 |
|---|---|---|
| 테두리 − 레버가 지나는 공간의 맨 위 (모든 자세) | **2.14 mm** (M, 11개 각도) | ≥ 2.0 (`rim_margin_min`, A) |
| 레버 공간이 테두리 꼭대기의 볼록 껍질 안 (평면) | **2.07 mm** 안쪽 (M; 홈 16 mm일 때 2.49) | ≥ 1.0 (`plan_margin_min`) |
| 레버 공간 → 칼라 | 3.99 mm (M, BRep) / 2.87 mm (E, 반경) | ≥ 1.0 |
| 벽 2.4 mm = 0.4 mm 선 6줄, 캡 등급 A의 벽 4줄씩이 3.2 mm까지 덮음 | 잰 벽 2.400 mm (M, 4곳) | 0.4의 배수, ≥ 1.2, 전부 벽 선 |
| 손끝(Ø16 공, A)이 젖힌 레버 끝에 닿음, 양쪽 | 0.000 mm, 겹침 0 (M) | ≤ 0.05 mm |
| **손끝이 레버를 미는 길** (끝 자세 → 가운데 2° 너머, 1°마다, 양쪽) → 칼라 | **0.500 mm** (M, 23자세 × 2, 가장 가까운 곳은 가운데) / 0.500 (E) | ≥ 0.5 (`finger_path_margin_min`, A, 새 규칙) |
| 손끝 + 손가락이 다른 고체에 닿음 | 0 (M) | 0 |
| 손끝 → 홈 바닥 (z) | 0.87 mm (E) | ≥ 한 층 0.2 |
| 칼라 안벽 → 기존 손가락 원 Ø20 | 0.50 mm (E) | ≥ 0 (새로 Layout도 거부) |
| 기존 손가락 원 Ø20 (C39) | 비어 있음 (M) | 그대로 |
| 칼라 → 글랜드 구멍 / 아밍 스위치 구멍 / GPS 판 / GPS 보드 | 9.52 / 19.03 / 33.67 / 39.04 mm (E, M) | ≥ 1.2 |
| 칼라 → 아이볼트(달았을 때) | 20.1 mm (E), 21.5 mm (M) | ≥ 1.0 |
| 칼라 → 캡 가장자리 | 4.10 mm (E) | ≥ 1.2 |
| 바깥 너트 → 칼라 안벽 (반경 여유만, 19.12.8) | 5.90 mm (E) | ≥ 1.2 |

* **왜 이것으로 레버가 보호되나**: 칼라 테두리 위에 놓이는 평면(뒤집어 놓기, 윗 모서리로 넘어지기)은 테두리 꼭대기 점들보다 위에 있습니다. 그러면 그 점들의 볼록 껍질 안에서는 어디서나 테두리 높이보다 위입니다. 레버 공간은 그 껍질 안에 있고 테두리보다 2.14 mm 낮습니다. 그래서 평면은 레버에 닿지 않습니다. 막대나 풀처럼 홈으로 옆에서 들어오는 것은 막지 못합니다(손가락 홈이니까).
* **GPS 하늘 (E)**: 예전에는 GPS 마스크 규칙이 없었습니다(C30은 "패치가 맨 위, 이름 붙인 예외만"). 그래서 계산해서 판정 규칙을 새로 넣었습니다.
  패치 중심에서 칼라 꼭대기는 **6.43°** 높이, 폭 **20.8°**입니다(가장 가까운 점 58.6 mm, 테두리가 패치 윗면보다 6.60 mm 높음). 레버만 있을 때는 3.8°였습니다.
  수신기(u-blox 6) 기본 최소 위성 고도는 5°입니다(A). 산 GPS는 NEO-7M(u-blox 7, 2026-11-04 사용자 결정)입니다. u-blox 7의 기본값은 확인하지 않았습니다(A). 펌웨어의 CFG-NAV5는 dynModel만 바꾸므로 이 값이 그대로입니다. 칼라는 5° 위 하늘의 **0.16 %**를 가립니다(E, 기준 ≤ 1 %, 이번에 정한 규칙). 홈 모양은 바깥 지름과 테두리를 바꾸지 않아 이 값도 그대로입니다.
* **옆 하중 손계산 (E, C41)**: 로직 전원을 넣은 기체 1,747.71 g(M) × 2(동적) × 마찰 0.5 = **17.14 N**을 호 하나의 테두리에 옆으로 겁니다(크기 산정·다리 강도와 같은 가정, A).
  U자 홈 아래에서는 호 단면이 점점 커지므로, 홈 높이를 따라 (팔 ÷ 단면계수)가 가장 큰 곳을 찾습니다. 판 위 10.08 mm(홈 반폭 7.78 mm)의 호 하나: Z 30.4 mm³, 팔 7.12 mm → 공칭 **4.02 MPa**.
  응력 집중 계수 **1.3**(A, `kt_notch_ASSUMED`: 둥근 바닥 반지름 8.5 mm / 호 폭 약 5.1 mm, 계단 막대 굽힘 도표로 1.2 아래, 층선을 생각해 올림)을 곱해 **5.22 MPa**입니다. 판 위 전체 고리: 0.31 MPa.
  캡을 세워 출력하므로 응력이 층 사이를 가로지릅니다. 층간 강도는 인장 30 MPa의 절반 15 MPa(A) → 안전율 **2.87**(기준 ≥ 2.0). 같은 방법으로 벽 1.6이면 1.47, 2.0이면 2.11입니다(처음 네모 홈, 계수 없음: 2.4에서 2.10). 충격은 계산하지 않았습니다.
* **판 뿌리 손계산 (E, C41, 새로 넣음)**: 1.2 mm 판이 칼라 뿌리의 굽힘을 받습니다. 칼라를 단단한 보스로, 판을 **가장 먼 받침**(림 링 안쪽, 허브, 리브 4개를 1°마다 본 것 중 가장 먼 것) **b 50.6 mm**에서 고정한 원판으로 봅니다(가장 가까운 받침은 11.5 mm라 보수적, 푸아송비 0.35 A).
  (1) 옆 하중 17.14 N × 17.2 mm: **13.31 MPa**. (2) 뒤집어 놓기: 칼라가 지렛대 비율 60/103(몸통 반지름 / (몸통 반지름 + 스위치 반지름))만큼 = 19.97 N을 받고 그 마찰(× 0.5)도 같이: **20.50 MPa**.
  판은 눕혀 출력되어 층 방향 굽힘입니다. 프로젝트의 굽힘 강도 53 MPa(`printer.bending_mpa`, `sizing/vtol_strength.py`와 C30/C38 캡 강도 규칙이 쓰는 값)로 안전율 **2.59**(기준 ≥ 2.0). 인장 30 MPa로 보면 1.46입니다(참고, 19.12.8). 응력 집중은 넣지 않았습니다(vtol_strength와 같음).

#### 19.12.3 출력 (슬라이서 M, P2S 0.4, 0.20 mm Standard, PLA Matte)
* 칼라가 윗면에서 17.2 mm 서므로 **윗면을 아래로 두는 예전 방향(서포트 없음)은 더 못 씁니다.** 그 방향이면 캡이 칼라 테두리 위에 서고, 판 전체(약 110 cm²)와 GPS 테이프 면이 17 mm 서포트 위에 출력됩니다.
* 그래서 배터리 구성 캡은 **바로 세워** 출력합니다(스커트 끝이 판에, 윗면·칼라가 위). 서포트는 판에서 올라가는 **트리 서포트**(`tree(auto)`, 파이프라인 기본)이고 스커트 안의 판 밑면, 리브, 허브, 와셔 홈, 림 링 밑에 생깁니다. 로켓 페이로드 모듈 격벽과 같은 방식입니다. 유선·하이브리드 캡은 예전대로 윗면 아래, 서포트 없음입니다.
* 스위치 구멍, 칼라 안, U자 홈 안에는 **서포트가 없습니다**(G-code 검사 M: 구멍 안 0점, 칼라 안 0점, 홈 안 0점, 칼라 바깥 벽 원으로 위치 맞춤 0.006 mm). 구멍은 세로이고 홈은 위로 열려 있어 위에 걸치는 것이 없습니다.
  **다만 판 밑면의 구멍 둘레(안쪽 너트 자리)는 서포트 접촉면 위에 출력됩니다**(그 자리 서포트 경로 450.5 mm, M). 서포트를 떼고 칼로 긁거나 사포로 평평하게 해서 너트가 고르게 닿게 합니다.
* **바로 세운 방향의 부작용 (검토 F6)**:
  * 하드포인트 하중 경로(리브 끝, 허브, 와셔 홈)도 서포트 접촉면 위에 출력됩니다. 증명 하중의 리브 안전율은 1.03뿐입니다(C38, 윗면 아래 출력 기준). 그래서 **붙잡는 줄 시험·증명 하중은 이 칼라 캡으로 하지 않습니다.** 윗면 아래로 출력한 캡(유선·하이브리드 캡)으로만 합니다. 와셔 홈은 평평하게 다듬습니다.
  * 스위치·아비오닉스 스피곳에 끼우는 스커트 입구(반경 틈 0.2 mm)가 이제 첫 층입니다. 첫 층이 퍼지는 것(elephant foot)을 줄이려고 이 슬라이스만 `elefant_foot_compensation` 0.15 mm(A)를 씁니다(`make_v09_print_files.COLLAR_CAP_OVERRIDES`; 비행 질량 모델의 구멍·칼라 없는 캡 슬라이스는 그대로). 첫 출력에서 스피곳에 끼워 맞춤을 확인합니다.
* 숫자(M, `make_v09_print_files.py --config vtol --parts top_cap`):

| | 예전 (구멍만) | 칼라 처음 설계 (네모 홈) | 지금 (U자 홈) |
|---|---|---|---|
| 방향 / 서포트 | 윗면 아래 / 없음 | 바로 세움 / 트리 | 바로 세움 / 트리, 첫 층 보정 0.15 |
| 부품 g | 35.107 | 37.710 | **37.771** |
| 필라멘트 g (서포트 포함) | 35.14 | 64.46 | **64.52** |
| 서포트 g | 0 | 26.75 | **26.75** (서포트 23.17 + 접촉면 3.54 + 스커트 0.04) |
| 시간 | 43 min | 2 h 48 min | **2 h 48 min** |
| 출력 높이 | 16.2 mm | 33.4 mm | 33.4 mm |

* 처음 설계 때 비교(M, 네모 홈 STL): 일반 서포트 `normal(auto)` 34.69 g, 1 h 49 min, 밀착형(snug) 33.80 g, 1 h 46 min. 필라멘트를 덜 쓰는 트리를 기본으로 두었습니다. U자 홈으로 바꾼 뒤에는 트리만 다시 슬라이스했습니다.
* VTOL 전체 출력 계획: 32 h 41 min, 827 g → **34 h 46 min, 857 g**(부품 566 → 568 g).

#### 19.12.4 질량 (M)
* 칼라 재료(**2,104.03 mm³**, M = Layout 적분과 같음; OCC 정밀 적분, 기본 적분은 U자 곡면에서 0.05 mm³ 적게 셈)도 로직 전원 부품이라 **같은 스위치 `in_flight_mass_model`(false) 뒤**에 둡니다. 보고서 상단 캡 질량은 지난 라운드와 같은 "구멍도 칼라도 없는 캡"입니다(C40).
* **비행 질량 모델은 바이트 단위로 같습니다**: 다섯 구성 모두 보고서 `parts`·`totals`가 바꾸기 전(보관본)과 같습니다. VTOL 배터리 **1,653.70 g**, 유선 1,405.80 g, 하이브리드 1,526.80 g, 로켓 2,599.21 g, KAIST 4,396.84 g.
  `derived`는 VTOL 배터리의 `vehicle_h_mm` 하나만 490.30 → **492.50 mm**입니다(높이는 형상이라 출력 캡의 칼라를 셈). 시뮬레이션·크기 산정은 `L.vehicle_h`(판 윗면까지)를 써서 바뀌지 않습니다.
* 결정 대기 보고서(`cad/exports/logic_power_pending_mass_vtol.md` / `.json`): 로직 전원을 넣으면 1,745.04 → **1,747.71 g**(+94.01 g, 목표 대비 +97.7 g), 무게중심 (−1.03, −0.05, 252.93) mm, 옆 치우침 1.03 mm(C33 1.0 % → 채택하면 PASS), 관성 +5.33 / +5.69 / +6.03 %.
  출력 캡 37.771 g(슬라이서 M) − 비행 모델 캡 35.153 g = +2.618 g(구멍 −36.2 mm³, 칼라 +2,104.0 mm³). 추력 대 무게(E): 2.14 kgf에서 1.29 → 1.22.
* 슬라이서 표: `top_cap` = 구멍 + 칼라 캡(29,573.81 mm³, 37.771 g), `top_cap@no_logic_switch_hole` = 구멍도 칼라도 없는 캡(27,506.06 mm³, 35.153 g, 그대로).

#### 19.12.5 검사 (M)
* **C39**: 칼라가 있으면 레버 공간을 칼라와 고체로 비교합니다(위 표의 앞 세 줄). 셋 다 맞을 때만 PASS, 아니면 FAIL입니다. WARN은 없어졌습니다. 결과 **WARN → PASS**.
* **C30**: 기체 맨 위를 **고체로** 잽니다(출력 캡과 칼라 포함; 예전에는 보고서의 질량용 상자). 이름 붙인 예외는 칼라(테두리 z 492.50, 패치보다 +6.60 mm)와 그 안의 스위치(`logic_switch`, 레버 z 490.30)뿐입니다. 칼라 원기둥 밖의 캡은 z 475.30(판 윗면)에서 끝납니다. **PASS**.
  검토 F5 반영: 예외는 이름이 `logic_switch`인 고체 하나뿐입니다. `logic_pack` 같은 다른 `logic_*` 고체는 다른 고체처럼 셉니다(처음 구현은 `logic_*` 전부를 뺐음). 패치보다 높은 `logic_*` 고체를 넣으면 C30이 FAIL입니다(시험).
* **새 검사 C41**(칼라 자체 규칙): 벽(선 수, 최소 두께, 전부 벽 선, 고체에서 잰 두께), 구멍·U자 홈 열림, 손끝이 양쪽으로 닿음, **손끝이 미는 길 전체(검토 F1)**, GPS 하늘 가림, 옆 하중 안전율(응력 집중 계수 포함, 검토 F2), **판 뿌리 안전율(검토 F3)**, 다른 부품과의 거리, 칼라 부피. **PASS**. 유선·하이브리드·로켓·KAIST는 N/A.
* C10에 `logic_power.collar.wall_t` 2.4 mm가 더해졌습니다(≥ 1.2). C38(구멍·몸통·나사 M3×6·강도 규칙)은 숫자까지 그대로입니다(칼라는 판 위에만 있음). C40 문구에 "칼라 없이"가 더해졌습니다.
* 검사 판정 합계(C 행 FAIL / WARN, M): VTOL 배터리 0 / **3**(C10, C29, C33 - 예전과 같음; C39 WARN 없어짐), 유선 1 / 2, 하이브리드 1 / 2, 로켓 0 / 5, KAIST 0 / 2. 예전 기준과 허용 오차는 하나도 느슨하게 하지 않았습니다.

#### 19.12.6 파일과 모델
* `params.json`: 블록 `configs.vtol.logic_power.collar`(치수, 여유, 손끝, 손끝 길 `finger_path_*`, 옆 하중 `side_load`(+ `kt_notch_ASSUMED`, `plate_root`), GPS 하늘, 출력 메모, 질량 메모). `switch`에 `lever_throw_deg_ASSUMED` 20, `lever_pivot_ASSUMED`, `lever_throw_note`. `lever_top_note`·`in_flight_mass_model_note`·`meta.v09_logic_power_note`에 결정과 날짜를 적었습니다.
* `cad/layout.py`: `_logic_collar`(규칙을 계산하고 모자라면 멈춤; U자 홈, 손끝 길, 홈 높이를 따라 찾는 단면, 판 뿌리), `_disc_strip_area`, `_polygon_section`, `_annular_plate_boss`, `_ray_exit`, `_solve_linear`.
* CadQuery(`rocket_geometry.py`): `logic_collar`(캡에 합침), `logic_collar_slot`(U자 홈), 검사용 `logic_lever_positions`, `logic_finger_probes(L, angle)`. `top_cap(L, with_logic_hole=False)`는 구멍과 칼라를 둘 다 뺍니다(`with_logic_collar`로 따로 고를 수 있음).
* `build_rocket.py`: 높이에 출력 캡의 진짜 고체를 셈, 대기 보고서에 칼라(2b장)와 구멍·칼라 부피를 따로(칼라 부피는 정밀 적분). `check_geometry.py`: C30, C39, C41, C10. `make_v09_print_files.py`: 칼라 캡은 바로 세움 + 서포트 + 첫 층 보정, G-code 서포트 검사(홈 포함).
* Fusion 스크립트 **0.9.8**(같은 라운드라 번호는 그대로, 변경 기록에 U자 홈을 적음): `build_top_cap`에 `cap_collar`(JOIN), `cap_collar_bore`(CUT), `cap_collar_notches`(box_xy CUT, 반원 중심부터 위), `cap_collar_notch_round`(cut_between, Ø17 원기둥, y 방향)를 판 구멍 전에. 합계에서 칼라를 빼는 음의 점질량(구멍 마개와 같은 방식).
  API 검사 **0건**, 모의 실행 **5개 구성 실패 0, ERROR 줄 0**, 재생 비교(X3) 상단 캡(구멍 + U자 홈 칼라) **0.0000 / 0.0000 mm³**(부피 29,573.8 mm³), `logic_pack`·`logic_switch` 0.0000 / 0.0000, 유선·하이브리드 상단 캡(칼라 없음) 0.0000 / 0.0000. 흡입부·트레이는 예전과 같은 재생기 한계. **Fusion GUI 실행은 아직 안 했습니다.**
* `tools/sim_video.py`(시뮬레이션 영상): 캡 STL 맨 위가 이제 칼라 테두리라 GPS 부품이 판 위 17 mm에 뜰 뻔했습니다. GPS 부품은 칼라 밖 캡의 맨 위(판 윗면 z 475.3)에 놓고, 기체 길이는 테두리(492.5)를 씁니다. 그 시험 두 줄의 고정값 0.4753 → 0.4925(기체 길이)를 바꿨습니다(허용 오차 그대로, 판 윗면 0.4753 확인은 남김).
* 다시 만든 것: 다섯 구성의 CAD 보고서·검사, VTOL 배터리 `top_cap.stl`(STL은 이것 하나만 바뀜, M)과 STEP, 재생 비교 기록, VTOL 임시 출력 파일의 `top_cap.stl` / `.3mf`·출력 계획·슬라이서 표·로그, 결정 대기 보고서.
* 펌웨어: 사용자 결정(2026-11-05) **"다음 펌웨어 작업 때 만들자"**. `params_gen.h`, `gains.h`, `bridge_config_gen.h`와 HEX는 **다시 만들지 않았습니다**. `--check`(M, 읽기만): `params_gen.h` **STALE**, `bridge_config_gen.h` **OUT OF DATE**, `gains.h` up to date. 헤더 최신 여부 시험 3개(`params_gen.h` 2개, `bridge_config_gen.h` 1개)는 다음 펌웨어 라운드까지 실패로 남습니다(19.10 F2).
* 보관본: `history/v0.9_pre_switch_collar/`(이번 라운드에서 바뀐 파일의 바꾸기 전 바이트 복사, `MANIFEST.json` sha256, 설명 `ARCHIVE_README.md`). 검토 반영 직전(구현 직후) 상태는 `history/v0.9_pre_switch_collar/post_impl_pre_reviewfix/`에 있습니다.

#### 19.12.7 pytest (M, 2026-11-05, 지난 라운드와 같은 명령)
| 묶음 | 지난 라운드 (19.8) | 이번 라운드 (검토 반영 뒤) | 실패의 이유 |
|---|---|---|---|
| `cad/cadquery` | 147 통과, 4 실패, 3 건너뜀 | **160 통과, 4 실패, 3 건너뜀** (구현 직후 155 / 4 / 3) | 예전과 같은 4개: 로켓 C 행 수(32를 기대, 이번에 C41 N/A가 더해져 38 - 기대값은 바꾸지 않음), VTOL C29·C33 WARN, 무게 목표 2개(1,653.7 > 1,650, 1,405.8 > 1,400). `test_logic_power.py` 17 → 30개(칼라 시험, Layout 거부, 손끝 길, C30 예외 시험 추가; "레버가 맨 위" 시험은 "칼라가 맨 위" 시험으로 바꿈) |
| `sim` | 548 통과, 5 실패, 4 건너뜀, 3 예상 실패 | **548 통과, 5 실패, 4 건너뜀, 3 예상 실패** | 예전과 같은 VTOL 시나리오 5개 |
| `sizing` + `tools` + `firmware/atmega128_fc/tools` | 556 통과, 3 실패, 1 건너뜀 | **556 통과, 3 실패, 1 건너뜀** | 헤더 최신 여부 시험 3개(`params_gen.h` 2, `bridge_config_gen.h` 1) - 사용자 결정 "다음 펌웨어 작업 때 만들자". 구현 때 첫 실행에서 `test_sim_video.py` 2개가 더 실패했습니다(캡 STL 맨 위가 칼라라 기체 길이 0.4753 → 0.4925, GPS가 뜰 뻔함). `sim_video.py`를 고치고 고정값을 바꾼 뒤의 값입니다 |
* 명령(같음): `.venv/Scripts/python.exe -m pytest -q -p no:cacheprovider -rfEsx <묶음>`.

#### 19.12.8 재야 할 것 / 남은 일
* MTS-102 실물: **레버 길이(판 위 약 15 mm, A)와 젖히는 각(±20°, A)**, 레버 끝 모양, 회전 중심. 레버가 판 위 15.06 mm보다 높으면 칼라 높이 `collar.h`를 올리고 다시 만듭니다(Layout이 2 mm 여유가 없으면 멈춤).
* 손끝 Ø16(A)과 미는 길의 여유 0.5 mm(A)로 잡았습니다. 출력한 캡에서 손가락으로 양쪽 다 젖혀지는지 확인합니다. 안 되면 홈 폭(`notch_w`)을 바꿉니다(Layout이 길 여유를 다시 잼).
* **바깥 너트 조이기 (검토 F4)**: 칼라 안 반경 여유(5.9 mm, E)만 확인했습니다. 젖힌 레버는 부싱 끝 높이에서 축에서 약 4.21 mm(E: 8.2 sin20° + 1.5 cos20°) 나와 있고, 이것은 8 mm 육각의 안쪽 반지름 4.0 mm보다 큽니다. 레버 끝은 축에서 7.63 mm입니다. 그래서 **소켓이나 너트 드라이버가 레버에 걸려 안 들어갈 수 있습니다**(회전 중심이 A라 실물로 달라질 수 있음). 출력 전에 실물 소켓을 실물 스위치에 대 봅니다.
  위에서 도구가 안 들어가면: 바깥 너트와 잠금 와셔를 **손으로** 끝까지 돌려 놓고, 캡을 뺀 상태에서 **아래쪽 안쪽 너트를 돌려** 조입니다(스위치 몸통을 잡고). 판 위로 나오는 부싱 길이(C38)는 그대로 지킵니다.
* 판 밑면의 너트 자리와 와셔 홈을 평평하게 다듬는 것(19.12.3). 이 칼라 캡으로는 붙잡는 줄·증명 하중 시험을 하지 않는 것(19.12.3).
* 첫 출력에서 스커트 입구를 스피곳에 끼워 봅니다(첫 층 보정 0.15 mm, A).
* 사용자 확인이 필요할 수 있는 새 가정: GPS 하늘 가림 규칙(5° 마스크 위 ≤ 1 %), 층간 강도(인장의 0.5배), 응력 집중 계수 1.3, 손끝 길 여유 0.5 mm, 판 뿌리를 굽힘 강도 53 MPa로 보는 것(인장 30 MPa로 보면 뒤집어 놓기 경우 1.46, 기준 2 아래), 판 뿌리 응력 집중을 넣지 않은 것.
* 결과물 폴더(`B:\0)AI_Cad\CanSat_v0.9`)의 복사본은 이번에 바꾸지 않았습니다(요청 범위 밖).

#### 19.12.9 독립 검토 반영 (2026-11-05)
검토 2개(형상·출력, 문서·질량·시험)의 지적을 직접 다시 재고 고쳤습니다. 구현 직후 파일: `history/v0.9_pre_switch_collar/post_impl_pre_reviewfix/`.
* F1(큰 문제, 확인함): 손끝 규칙이 끝 자세만 봤습니다. 16 mm 홈은 미는 길에서 틈 0.000 mm였고(M), 14 mm 홈은 길이 막혀도 통과했습니다. → 미는 길 전체를 Layout과 C41(고체)이 잽니다(여유 ≥ 0.5 mm, A). 홈 폭 17 mm. 16 mm·14 mm 홈과 Ø19 안지름(손가락 원 안)은 이제 Layout이 거부하고, 고체만 16 mm로 바꾸면 C41이 FAIL입니다(시험).
* F2(확인함): 옆 하중 최대 응력이 네모 홈 바닥의 날카로운 모서리에 걸렸습니다. → U자 바닥(반지름 8.5 mm)으로 바꾸고, 홈 높이를 따라 가장 약한 단면을 찾고, 응력 집중 계수 1.3(A)을 곱합니다. 안전율 2.10(계수 없음) → 2.87(계수 포함).
* F3(확인함, 검토자 숫자를 같은 식으로 다시 얻음): 판 뿌리를 계산하지 않았습니다. → C41에 판 뿌리 두 경우를 넣었습니다(19.12.2). 안전율 2.59(굽힘 53 MPa 기준).
* F4(확인함): 바깥 너트 도구가 레버에 걸릴 수 있습니다. → 19.12.8과 제작가이드 14단계에 실물 확인과 도구 없이 조이는 방법을 적었습니다(형상은 바꾸지 않음).
* F5 / DM-5(확인함): C30이 `logic_*` 전부를 뺐습니다. → `logic_switch`만 뺍니다. 설명도 칼라를 적도록 고쳤습니다.
* F6(확인함): 바로 세운 출력의 부작용. → 하중 시험 제한, 와셔 홈 다듬기, 첫 층 보정(0.15 mm, A)을 넣었습니다(19.12.3). 스커트 입구 모따기는 비행 질량 모델 캡의 형상을 바꾸므로 넣지 않았습니다.
* F7 / DM-1(확인함): 문서 숫자(7.11 MPa, 2.11, "벽 1.6이면 약 0.95")가 C41 출력(7.14, 2.10, 1.07)과 달랐습니다. → 새 형상의 C41 값으로 모두 다시 썼습니다.
* F8: 확인만(결함 없음).
* DM-2: 제작가이드 "약 91 g"과 이 문서 머리말 "1,745.0 g(+91.3 g)"을 지금 값으로 고쳤습니다.
* DM-3: 19.4 C30 줄과 19.7에 19.12로 가는 표시를 넣고, 제작가이드 14.3의 ON 표시 자리를 칼라 바깥 벽으로 정했습니다.
* DM-4: 19.12.6에 `bridge_config_gen.h` 상태를 넣었습니다.
* 시험 한 개(`test_switch_hole_on_the_printed_cap_only`)가 검토 반영 뒤 첫 전체 실행에서 실패했습니다: U자 홈의 곡면 교차를 OCC 기본 부피 계산이 0.05 mm³(2.5e-5) 적게 셉니다. 허용 오차(1e-6)는 그대로 두고, 그 시험과 C41·대기 보고서의 칼라 부피를 정밀 적분(`massprops.precise_volume`)으로 바꿨습니다. 다시 돌린 값이 19.12.7입니다.
* 판정 기준과 허용 오차는 하나도 느슨하게 하지 않았습니다(새 규칙만 더함). 제어 변경이 아니어서 비교 영상은 없습니다.
