Yuchan-00/CanSat_EDF_Rocket/docs/v0.9_CAD_변경.md

# v0.9 CAD 변경 (2026-10-27)

결정 1(베인 직접 구동), 결정 3(모터 전원선 통로), 결정 4(추력별 추력/무게 비 표), 출력 무게 보정을 CAD에 반영한 결과입니다.
모든 숫자는 이번에 직접 돌린 도구(CadQuery 트윈, 검사, Bambu Studio 슬라이서, 크기 산정)의 결과입니다.
측정하지 않은 값은 ASSUMED로 표시했습니다. 대상은 BUDGET 프리셋입니다. KAIST 프리셋은 v0.8 구조(푸시로드, 45° 핀)를 그대로 둡니다.

## 1. 한눈에 보기

* 서보 4개가 핀 뿌리 페어링 안으로 들어갔습니다. 서보 출력축이 베인 축과 같은 선 위에 있고, 인쇄 커플러로 베인 축을 직접 돌립니다.
* 핀을 0/90/180/270°로 돌렸습니다. 외부 포드, 서보 암, 푸시로드, 클레비스, 베인 혼이 없어졌습니다.
* 모터 선은 5.5 mm 불릿을 단 채로 지나갑니다. 추진부 슬롯 22 mm, 흡입부 열린 홈 22 × 11 mm(인쇄 덮개), 격벽 구멍 22 × 11 mm입니다. 불릿 연결부는 전자부 칸에 있습니다.
* 출력 부품 무게는 이제 슬라이서 값입니다. 기체 질량은 **2,591.6 g**, 출력 부품은 **944.4 g**입니다.
* 검사 결과: BUDGET 0 FAIL, 3 WARN. KAIST 0 FAIL, 2 WARN. WARN은 추력/무게 비(C12), 정적 여유(C13), 탭 구멍 옆 벽(C10, 이전부터)입니다.
* **무게는 줄지 않았습니다.** 같은 고체 모델로 비교하면 v0.8.1보다 64.7 g 무겁습니다. 직접 구동 자체가 +16.6 g, 새로 넣은 모터 선이 +42.9 g(ASSUMED), 열린 홈과 덮개가 +5.1 g입니다. 계획 문서의 "−40~70 g"은 맞지 않았습니다. 줄어든 것은 출력 무게 모델(고체 1,081 g → 슬라이서 944 g) 덕분입니다.

## 2. 베인 직접 구동 (결정 1)

### 구조 (핀 하나 기준, 반지름 방향 바깥으로)
| 위치 (반지름 mm) | 부품 |
|---|---|
| 52까지 | 힌지 보스 (덕트 벽). 베인의 옆 힘과 축 방향 힘을 여기서 받습니다. |
| 53 – 61 | 인쇄 커플러 허브 Ø10. D컷 구멍 Ø5.2가 베인 축의 D컷에 끼워집니다. |
| 61 – 63 | 커플러 플랜지 Ø12. 서보 혼에 M2 × 4 나사 2개(또는 접착)로 고정합니다. |
| 63 – 65 | MG90S 기본 혼을 Ø12 원판으로 자른 것 |
| 70 – 92.5 | 서보 본체. 귀(ear)는 72 – 74.5 |

* 커플러는 회전력만 전달합니다. 베인 축은 플랜지보다 0.5 mm 앞에서 끝나고, 허브에 7.5 mm 물립니다.
* 서보는 주머니 안에서 사방 0.3 mm 떠 있습니다(덮개 아래 폼 패드). 주머니가 출력 오차(0.2 mm, ASSUMED)만큼 어긋나도 커플러를 옆으로 밀지 않습니다.
* 힌지 모멘트는 최대 0.119 kgf·cm입니다. MG90S는 1.8 kgf·cm라서 15.2배 여유입니다. 압력 중심 위치(시위의 10 %)와 마찰 계수(0.3)는 ASSUMED입니다.

### 페어링과 덮개
* 페어링은 추진 모듈과 한 덩어리입니다. 아래쪽 45° 용골이 핀 판까지 이어져서 서포트 없이 섭니다.
* 주머니는 정비 쪽(+θ)이 열려 있습니다. 위쪽 1.6 mm 띠(인방)가 천장을 받쳐서 서포트가 필요 없습니다.
* 인쇄 덮개(1.2 mm)를 M2 × 8 셀프태핑 나사 2개로 고정합니다.

### 서보 빼는 방법
1. 덮개 나사 2개를 풉니다.
2. 커넥터 칸에서 서보 선을 뽑습니다.
3. 서보를 커플러·혼과 함께 정비 쪽으로 밀어 꺼냅니다. 베인은 보스에 그대로 남습니다.

검사 C5가 이 과정을 형상으로 확인합니다(서보, 혼, 커플러, 커넥터를 밀어 꺼내는 경로가 막히지 않음, 드라이버 Ø6 × 60 mm 경로 확보).

### 서보 선 경로
* 서보 선은 핀 뿌리 안의 인쇄 파이프(Ø7.2, 안쪽 터널 Ø4.8)를 지나 기존 기둥, 덱 홈, 흡입부 서보 통로를 따라 FCU로 갑니다. 이전 포드 경로(C23)를 대신합니다.
* 연장선 길이는 589 / 539 / 450 / 499 mm입니다. 선 무게는 26.8 g(ASSUMED 단위 무게)입니다.

## 3. 모터 전원선 통로 (결정 3)

* 추진부 슬롯 폭: 14 → 22 mm.
* 흡입부: 닫힌 통로를 **열린 홈**으로 바꿨습니다. 폭 22 mm, 깊이 11 mm, 옆벽 4 mm, 45° 지붕. 인쇄 덮개(1.6 mm)를 M2 × 8 나사 4개로 고정합니다.
* 립 위에서 안으로 들어가는 문(gate)은 폭 14 mm입니다. 22 mm로 하면 창 서포트 검사가 실패했습니다(측정). 원인은 문 아래 립 주머니 벽 끝이 기둥 옆에 걸린 것이었습니다.
* 격벽 구멍: 22 × 11 mm. 불릿 연결부는 전자부 칸(격벽 2 mm 위, 높이 44 mm 구역)에 둡니다. 모든 전자 부품과 2 mm 이상 떨어져 있습니다(가장 가까운 것: ESC 7 mm).
* 선 길이: 경로 218 mm + 여유 60 mm = 가닥당 278 mm. 무게 42.9 g(12 AWG 37 g/m, 불릿 3쌍 4 g, 모두 ASSUMED).
* 검사 C29: 불릿(외경 8 mm + 사방 1 mm 여유)이 다른 두 선과 함께 한 줄로 흡입부를 곧게 통과하고, 덮개를 닫은 홈도 통과합니다. 겹침 0.0000 mm³입니다.

### 측정 부탁 (중요)
* `edf.wire_exit`(EDF 하우징에서 모터 선이 나오는 각도와 높이)는 판매처 도면에서 읽은 값입니다. **실측하지 않았습니다(ASSUMED).**
* 추진 모듈을 출력하기 전에 실물에서 재 주세요.
  1. 선 출구가 가장 가까운 탭에서 몇 도 떨어져 있는지 (지금 값: −90°)
  2. 출구 슬롯의 높이 범위, 립 앞면부터 mm (지금 값: 47.4 – 60.3 mm)

> **2026-10-29 갱신 (이 3장의 선 출구는 더 이상 맞지 않습니다).** 사용자 사진 2장(`docs/실물사진/EDF_모터선_출구_2026-10-29_1.jpg`, `_2.jpg`)으로
> 확인했습니다: 선은 하우징 옆 구멍(47.4–60.3 mm)을 쓰지 않습니다. 모터 **앞쪽 보라색 링**(고정 날개·하우징 뒤 끝 높이)에서 옆으로 나와,
> 검은 수축 튜브로 한 묶음이 된 채 고정 날개 하나를 따라 **하우징 뒤 끝(림) 아래**로 나갑니다. 추진 모듈에는 22 mm 슬롯 아래에 그 묶음이
> 지나가는 **노치**(폭 12.4 mm)가 새로 생겼습니다. 1차 모델(모터 맨 아래 끝에서 나와 모터 몸통을 타고 올라감)은 틀린 것이었고
> `history/v0.9_wire_round1/`에 보관했습니다. 지금 경로·숫자·측정 목록은 `docs/v0.9_하드웨어_변경.md` 17장을 보세요.
> 같은 날 독립 검토를 반영한 수정 라운드: 공장 수축 튜브를 벗기고 모터 몸통에서 14 ± 1 mm만 다시 씌우는 조립 규칙과 선을 나란히 펴는 구간을 넣었습니다. 노치 모양과 출력 파일은 그대로입니다.
> 선 출구 각도는 사진 판독끼리도 다르므로(약 −90° 또는 탭에서 22-47°), **각도를 재기 전에는 추진 모듈을 출력하지 마세요.**

## 4. 출력 무게 (슬라이서 값)

* 부품마다 등급(A 하중 경로, B 껍질, C 평판, D 작은 부품, E 지상 장비)별 설정으로 슬라이스했습니다. 표는 `cad/exports/print/provisional_v09_cadquery/slicer_part_masses.json`입니다.
* 기체 질량은 이 표로 계산합니다. 표의 부피가 CAD 부피와 다르면 등급 대체 밀도를 쓰고 경고합니다. 지금은 모든 부품이 표 값입니다.
* 아래 표는 v0.9 CAD-1 때 값입니다. 2026-10-29 모터선 노치 뒤 현재 값: 추진 모듈 349.0 g / 7 h 58, 합계 31 h 50 min, 필라멘트 1,298 g, 부품 1,085 g(기체 944 g).
  최신 값은 언제나 `cad/exports/print/provisional_v09_cadquery/print_plan_provisional.md`를 보세요.

| 부품 | 출력 무게 (g) | 고체 무게 (g) | 시간 |
|---|---|---|---|
| 추진 모듈 (45° 돌려 배치, 서포트 없음) | 350.1 | 443.8 | 8 h 02 |
| 흡입 모듈 (창 서포트 검사 PASS) | 129.6 | 135.9 | 4 h 51 |
| 커플러 × 4 | 0.87 | 0.88 | 0 h 05 |
| 서보 덮개 × 4 | 3.42 | 3.38 | 0 h 05 |
| 모터 선 덮개 | 2.23 | 2.19 | 0 h 04 |
| 합계 (14종, 수량 반영) | 부품 1,086 (기체 944) | | 31 h 43, 필라멘트 1,298 g |

* 추진 모듈은 핀이 축 위에 있어서 폭이 246.8 mm입니다. 똑바로 놓으면 P2S가 거부해서("plate is empty") 45° 돌려 놓습니다(대각 176.2 mm).
* 서포트를 켜면 닫힌 공간까지 서포트가 차서 73 g이 늘었습니다(측정). 그래서 서포트 없이 출력하도록 인방을 넣었습니다.
* **출력 설정 확인 부탁:** 이전에 출력한 하우징 300 g은 Bambu 기본 설정(벽 2겹)과 맞습니다. 실제로 어떤 설정으로 출력하셨는지 알려 주시면 등급 설정을 맞추겠습니다.

## 5. 추력/무게 비 (결정 4)

> **이 장의 VTOL 숫자(1,931.6 g, T/W 1.04-1.60)는 옛 추정입니다.** VTOL 구성은 CAD-2에서 설계했고 수정 라운드(2026-10-28) 기준
> 1,647.2 g, T/W 1.21 / 1.40 / 1.58 / 1.88, T/W 1.3이 되는 추력 2.14 kgf입니다. `v0.9_하드웨어_변경.md` 5장을 보세요.
> 이 문서의 직접 구동·모터 선 내용도 수정 라운드에서 바뀌었습니다(립 포켓 슬릿, 지주 고정점, 혼 소켓 + 무두볼트, 황동 부싱).

로켓 구성 = 지금 CAD(비행 질량 2,601.6 g, 하드웨어 여유 10 g 포함).
VTOL 구성 = 로켓에서 CanSat, 낙하산, 페이로드 모듈, 피스톤, 스프링, 분리 서보, 걸쇠를 뺀 것(1,931.6 g). **추정입니다. VTOL 구성은 아직 설계하지 않았습니다.**

| 추력 (kgf) | 로켓 T/W | 로켓 호버 스로틀 | VTOL T/W | VTOL 호버 스로틀 | T/W 1.3이 되는 질량 |
|---|---|---|---|---|---|
| 2.00 | 0.77 | 호버 불가 | 1.04 | 0.98 | 1,538 g |
| 2.30 | 0.88 | 호버 불가 | 1.19 | 0.92 | 1,769 g |
| 2.60 | 1.00 | 1.00 | 1.35 | 0.86 | 2,000 g |
| 3.09 | 1.19 | 0.92 | 1.60 | 0.79 | 2,377 g |

* 호버 스로틀 = (무게 / 추력)^(1/2) (params의 스로틀 지수 2).
* 3.09 kgf는 다른 EDF(Powerfun) 표 값입니다. 이 EDF의 실제 추력은 벤치 시험으로 재야 합니다.
* 목표 T/W 1.3을 넘는 것은 VTOL 구성이고 추력이 2.6 kgf 이상일 때뿐입니다.

## 6. 예산 변경

* 추가: 5.5 mm 불릿 3쌍 + 열수축(5,000원, ASSUMED), 모터 연장선 12 AWG 1 m(3,000원, 같은 판매처 단가, 필요 여부 ASSUMED), M2 나사 + 폼 패드(3,000원, ASSUMED).
* 푸시로드·클레비스는 원래 따로 산 품목이 아니었습니다(서보 동봉품). 빠지는 금액은 없습니다.
* PLA는 임시 출력 계획 1,298 g 기준 2롤입니다. 합계 376,232원(보유 가능 품목 제외 353,164원).

## 7. 검증한 것

* CadQuery 검사(BUDGET): 31줄 중 0 FAIL, 3 WARN. C5, C20, C23, C28, C29 PASS.
* Fusion 스크립트를 OCC로 재생해 CadQuery와 비교(X3 재생): 추진 모듈, 서보 덮개 4개, 커플러 2개, 모터 선 덮개, 발사대, 서보·혼 자리표시자, 기존 7개 부품이 0 mm³ 차이로 일치합니다.
  * 이 비교로 Fusion 스크립트 버그 하나를 찾아 고쳤습니다. 핀 판이 힌지 구멍을 메우고 있었습니다(핀마다 78.9 mm³). 핀 다음에 구멍을 뚫도록 순서를 바꿨습니다.
  * 흡입 모듈은 재생기가 창(gable) 절단을 모델링하지 못해 FAIL로 나옵니다. 창 4개 부피를 빼면 차이는 0 mm³입니다. 베인은 재생기가 모서리 둥글리기를 실행하지 못해 50 mm³ 차이가 납니다. 두 가지 모두 재생기의 한계입니다. 실제 Fusion 실행이 필요합니다.
* 전체 테스트(pytest): 1,083 통과, 3 실패, 3 오류, 5 건너뜀, 2 예상 실패(xfail). 그 뒤 3 오류를 고쳐 다시 돌렸습니다(VTOL 시나리오 파일: 63 통과, 1 실패, 2 건너뜀).
  * 실패 2개는 params에서 만드는 헤더 두 개(`params_gen.h`, `bridge_config_gen.h`)가 오래됐다는 것입니다. params를 바꿨으니 예상된 결과입니다. 펌웨어 작업에서 다시 만듭니다.
  * 실패 1개(`test_build_flags_select_the_v08_build_and_the_v071_fallback`)는 v0.9와 관계없습니다. v0.8.1부터 기본 GPS 경로가 GNS 보드라서 FCU의 위치 제어기가 없는데, 테스트는 v0.8 구조를 기대합니다. 이번에 바꾼 params 항목은 이 경로를 정하지 않습니다(확인함).
  * 오류 3개는 보관된 v0.7.1 CAD 보고서와 지금 부품 목록을 비교하다 난 것입니다. 보관 보고서의 부품 목록을 쓰도록 고쳤고, v0.6.3·v0.7.1 비트 일치 시험 3개가 통과합니다.
  * 건너뜀 2개는 "CAD 보고서가 핀 이후 바뀜"입니다. 하드웨어가 바뀌었으니 예상된 결과입니다.

## 8. 남은 일과 주의

* **Fusion 360 GUI 실행이 아직 없습니다.** 공식 출력 파일(`cad/exports/print`)은 오래된 것입니다. 지금 출력 계획은 임시(CadQuery STL)입니다.
* **펌웨어 헤더 `params_gen.h`는 STALE입니다.** params를 바꿨기 때문입니다. 펌웨어 작업에서 다시 만듭니다.
* EDF 선 출구 위치를 실측해 주세요(3장).
* 출력 설정을 알려 주세요(4장).
* 시험·시연용 유선 전원(테더)은 이번 CAD 작업 범위가 아닙니다. 설정 스위치는 다른 작업(CAD-2)에서 추가합니다.
* ASSUMED 값: 선·불릿 무게, 커넥터 크기, 출력 오차, 압력 중심·마찰, 나사 무게, 모터 연장선 필요 여부, EDF 선 출구.

## 9. 파일 위치

* CAD 결과: `B:\Video\CAD\v0.9\` (STEP, STL, 보고서, 검사, 임시 출력 파일, 렌더, Fusion 스크립트, 재생 비교)
* 프로젝트: `cad/exports/cadquery*`, `cad/exports/print/provisional_v09_cadquery/`, `docs/SPEC.md`(v0.9 부분), `docs/budget/예산안.md`
