Yuchan-00/CanSat_EDF_Rocket/docs/v0.9_시뮬레이션_제어_결과.md

# v0.9 시뮬레이션·제어 결과 (가벼운 VTOL 기체)

작성: 2026-10-28 (문서·최종 점검 담당). 이 문서는 v0.9 시뮬레이션·제어 라운드 전체를 한곳에 모은 요약입니다.

> **모두 시뮬레이션 결과입니다. 실제 비행이 아닙니다.**
> **EDF 추력은 아직 모릅니다.** 벤치 전원이 약해서 끝까지 재지 못했습니다. 판매자의 3.09 kgf(22.2 V)는 검증되지 않은 값입니다.
> 이번 라운드는 **Python 기준 코드와 시뮬레이션만** 바꿨습니다. 펌웨어(C 코드), 생성 헤더, 교차검증 벡터는 다음 펌웨어 라운드에서 바꿉니다.
> **(가정)** 표시는 아직 재지 않은 값입니다.

---

## 0. 한눈에 보기

* VTOL 비행은 이제 **VTOL 기체**로 납니다(낙하산·캔위성 없음, 사용자 결정). 배터리 1,647.2 g, 배터리 없는 유선 1,399.3 g, 하이브리드 1,520.3 g입니다.
* 기체 관성이 로켓의 약 1/4입니다. 그래서 **예전(v0.8.1) 제어로는 거의 모든 비행이 요 회전 비상정지(I3)** 였습니다.
* 제어를 세 번 고쳤습니다. 제어 라운드(C1~C7), 유선 전원 규칙(T1~T6), 독립 검토 뒤 수정 라운드(F1~F10)입니다.
* 가장 믿을 만한 숫자(처음 쓴 표본 FRESH2, 시드 9700): 현장 비행 120회에서 통과 **5 → 22**, 비상정지 **26 → 17**입니다.
* 새 표본(시드 1090) 캠페인 1,880회: 현장 500회 중 통과 89회(18 %), 비상정지 63회(13 %)입니다. v0.8.1 로켓 기체의 비상정지율 12 %와 비슷합니다.
* **남은 큰 위험 세 가지**
  1. 잔류 회전(swirl)이 로터와 **반대 방향**이면 비상정지가 많습니다. 현장 비상정지 63회 중 53회가 반대 방향이었습니다. 방향은 아직 모릅니다(가정).
  2. 계획한 시연 밀기(5~15 N)는 이 기체에서 **안전하지 않습니다**(94 % 비상정지). 안전한 밀기는 약 3 N × 0.3초 이하입니다.
  3. 이륙할 때 목표보다 더 올라갑니다. 유선 기체는 최대 약 1.3 m 더 올라갔습니다. 그래서 **도르래는 4.5 m 이상**이어야 합니다.
* **추력 결론**: 판정 기준을 맞추며 날려면 22.2 V 기준 **T_max 약 2.6 kgf 이상**이 필요합니다(5장). 2.14 kgf에서는 뜨고 내리지만 기준을 못 맞춥니다. 1.65 kgf 이하는 제대로 날 수 없습니다.
* 다음은 **펌웨어 라운드**입니다(9장).

---

## 1. 이번 라운드에서 한 일 (순서대로)

| 단계 | 담당 | 한 일 | 결과 폴더 (B:\Video) |
|---|---|---|---|
| 1 | 플랜트 | VTOL 기체, 직접 구동 베인 유격, 로터 자이로·반작용, 추력 범위, 배터리·유선·하이브리드 전원, 테더 모델. 예전 제어로 기준선 측정 | `B:\Video\시뮬레이션\v0.9_플랜트_기준선\` |
| 2 | 제어 | C1~C7: 자세 게인, 후보 D, 축별 적분기, 로터 보상, 이륙 램프, 수직 게인, 착지 정책 | `B:\Video\시뮬레이션\v0.9_제어_재튜닝\` |
| 3 | 유선 | T1~T6: 전원 규칙(W_ARM, W_SAG, W_LOST, W_BUF, W_D2), 고도 제한, 지상국 표시, 절차서 | `B:\Video\시뮬레이션\v0.9_유선전원_규칙\`, `B:\Video\문서\유선_시험비행_절차.md` |
| 4 | 독립 검토 2건 | 물리 모델 검토(높음 2, 중간 4), 제어·안전 검토(높음 3, 중간 4). FRESH 표본(9200)으로 다시 확인 | (검토 보고서는 스크래치, 결함은 5단계에서 처리) |
| 5 | 수정 | 플랜트 P1~P9, 제어 F1~F10. 검토 결함을 모두 다룸 | `B:\Video\시뮬레이션\v0.9_수정라운드\` |
| 6 | 렌더러 | 로그의 기체 구성대로 그림(VTOL, 유선 장비, 테더). 발표용 그림 7장 | `B:\Video\CAD\v0.9\렌더\발표용_1920x1080\`, `B:\Video\시뮬레이션\v0.9_렌더러_시험\` |
| 7 | 보관 | v0.8.1 기준선 보관본과 재실행기(run_baseline.py). 기록된 비행을 다시 돌려 모두 같음 확인 | `B:\Video\제어변경_이력\보관본\v0.8.1\` |
| 8 | 캠페인 | 새 시드 1090으로 1,880회. 분석 영상 17개 | `B:\Video\시뮬레이션\v0.9_시뮬레이션_결과_요약.md`, `B:\Video\영상\분석영상\v0.9\` |
| 9 | 비교 영상 | 제어 변경 전·후 나란히 비교 영상 28개, 한국어 변경 이력 | `B:\Video\영상\제어변경_비교\v0.9\`, `B:\Video\제어변경_이력\v0.9_제어_변경이력.md` |
| 10 | 문서·점검 | 이 문서, SPEC·README 갱신, 완결성 점검, 전체 시험, B:\Video 동기화 | `B:\Video\문서\v0.9_시뮬레이션_제어_결과.md` |

---

## 2. 시뮬레이션 모델(플랜트)에서 바뀐 것

플랜트는 "실제 기체가 어떻게 움직이는가"를 흉내 내는 부분입니다. 제어 변경이 아닙니다.

### 2.1 플랜트 라운드

| 항목 | 값 | 비고 |
|---|---|---|
| VTOL 기체 질량·무게중심·관성 | 배터리 1,647.2 g, 무게중심 247.0 mm, Ixx 0.0351 kg m², 베인 팔 210.0 mm. 유선 1,399.3 g / 221.7 mm, 하이브리드 1,520.3 g / 234.3 mm | CAD 보고서 값. 독립 검토가 부품을 다시 더해 똑같음을 확인 |
| 옆 무게중심 치우침 | 배터리 0.61 mm, 유선 2.06 mm, 하이브리드 1.52 mm | CAD 보고서 |
| 직접 구동 베인 유격 | 0.65° + 기어 1° **(가정)**. 캠페인에서 베인마다 1.3~3.0° | 예전 혼·푸시로드 비율(12:14)은 없어짐 |
| 로터 자이로·회전 반작용 | 로터 관성 4.5e-5 kg m² **(가정)**, 회전 방향 CW **(가정)** | 이륙 때 반작용 0.1~0.2 N·m. 호버 요 제어력은 약 0.14 N·m |
| 추력 | 22.2 V 기준 2.14~3.09 kgf 범위. 전압 지수 1.61 (대리값) | 팩 끝(3.7 V/셀) 0.87배 |
| 전원 모델 | 배터리, 유선, 하이브리드(새 `sim/tether.py`) | 내부 저항, 전원 장치 전류 제한, 차단 |
| 테더 기계 모델 | 현수선, 안전줄, 걸림 | 도르래 높이 3.5~4.0 m (캠페인 표본) |
| 착지 판정 | 지면 기준 수평 속도 **0.3 m/s 이하**, 넘어짐 여유 > 0 | 새 기준(엄격해짐) |

### 2.2 수정 라운드 (독립 물리 검토 반영, P1~P9)

| ID | 항목 | 값 |
|---|---|---|
| P1 | 베인 힘 분산 (모터 뒤 죽은 공기) | 0.72~1.05배 **(가정 범위)** |
| P2 | 안전줄 장치: 자동 감김(SRL)·자동 잠금 빌레이. 천천히 풀릴 때 자유, 낙하 때 잠김. 번지 감쇠 버그 수정 | 잠김 속도 1.2~1.8 m/s **(가정)** |
| P3 | 지면 효과 (배기면이 바닥에 닿는 면) | 모양과 계수 **(가정)**, 벤치 자료 없음 |
| P4 | 늘어진 전선 0.25 m 이하, 흡입창 고리 검사 | |
| P5 | ADC 오차 (교정 후 ±0.5 %) | 교정 전 오차는 −10 ~ +5.5 % |
| P6 | 회생 전류, 브레이크 초퍼, 전원 장치 과전압 차단 | 회생 효율 0~0.8 **(가정)** |
| P7 | 잔류 회전 **방향** 무작위(+/− 반반) | 예전에는 한 방향만 시험했음 |
| P8 | 새 판정: 이륙 초과(일반 0.5 m, 유선 0.3 m), 줄에 매달린 착지, 흡입창 전선 고리 | 모두 **엄격해지는** 방향 |
| P9 | 착지 판정은 이륙 직후 재접촉이 아닌 첫 접촉으로 | 전·후 양쪽에 똑같이 적용 |

**중요**: 수정 라운드의 플랜트는 더 엄격합니다(반대 방향 회전, 약한 베인, 지면 효과). 그래서 제어 라운드의 숫자(예: 현장 비상정지 0)와 수정 라운드의 숫자(17)를 바로 비교하면 안 됩니다. 같은 플랜트 안의 전·후만 비교합니다(4장).

---

## 3. 제어에서 바뀐 것과 이유

자세한 내용(무엇을 / 왜 / 이전 / 이후 / 영상)은 `B:\Video\제어변경_이력\v0.9_제어_변경이력.md`에 있습니다. 비교 영상 번호는 `B:\Video\영상\제어변경_비교\v0.9\비교영상_목록.md`와 같습니다.

### 3.1 제어 라운드 C1~C7 (예전 문제: 가벼운 기체에서 회전 비상정지)

| ID | 무엇을 | 왜 | 근거 |
|---|---|---|---|
| C1 | 자세 속도 게인을 관성 비율로 줄임(피치·롤 ×0.266, 요 ×0.647) | 예전 게인은 피치 위상 여유 18°(강한 추력에서 4.5°). 흔들림 → 믹서 포화 → 요 명령을 버림 → 회전 | 위상 여유 18.3° → 40.4°, 이득 여유 1.60 → 6.01 |
| C2 | 기울기 오차를 요 오차와 분리 (v0.8.2 후보 D) | 요 오차가 기울기 보정을 돌림 | 빼면 TUNE 비상정지 37 → 51 |
| C3 | 적분기 멈춤을 축별로 | 한 축 포화가 세 축 적분기를 다 멈춤 | 빼면 37 → 39 |
| C4 | 로터 반작용 토크 미리 상쇄(요) | 반작용 0.15 N·m 대 요 제어력 0.14 N·m | 빼면 37 → 39 |
| C5 | 이륙 2단 램프(0.5초에 0.5, 그다음 초당 0.3) + 추력 탐색, 추력 학습 하한 0.55 | 예전 램프는 0.5초 만에 스로틀 1 → 반작용으로 회전. 약한 기체는 V15가 작동 안 함 | 약한 기체에서 V15 작동 |
| C6 | 수직 게인 낮춤 (vz_kp 0.08 → 0.05, vz_ki 0.0128 → 0.008, alt_kp 1.25 → 1.0) | 기압계 추력 보정과 겹쳐 1 Hz로 흔들림(위상 여유 음수) | 수직 위상 여유 −36.7~−42.8° → 24.6~32.8° |
| C7 | 착지 마지막 구간에서 수평 속도 0 유지 (keep_vel) | 바람에 밀려 빠르게 닿음 | 착지 수평 0.42 → 0.08 m/s (영상 11) |

쓰지 않은 것(TUNE에서 더 나빴음): 요 적분기 정규화(B), 회전 감시 V16(C), 믹서 요 예약.

### 3.2 유선 전원 규칙 T1~T6

| ID | 무엇을 | 왜 |
|---|---|---|
| T1 | W_SAG(배터리 없는 유선): 20.0 V 아래 0.3초 → 경고, 추력 상한 고정, UP 거부. 1.0초 → 착륙 | 전원 장치가 5초 뒤 스스로 차단하기 전에 내려옴 |
| T2 | W_LOST(하이브리드): 전선이 끊기면 40 ms 뒤 버퍼로 착륙 | 버퍼가 닳기 전에 착륙 (시뮬레이션 0.04초) |
| T3 | W_BUF: 버퍼 3.4 V/셀(0.2초) 또는 3.6 V/셀(2초) → 착륙 | 전선이 살아 있어도 버퍼가 닳을 수 있음 |
| T4 | W_ARM: 전선 24.6~25.6 V 밖이면 ON 거부. 하이브리드는 버퍼 3.72~3.92 V/셀 밖도 거부 | 약한 전원으로 이륙 금지 |
| T5 | 유선 고도: 호버 1.5 m, 최고 2.0 m(UP 거부), 상한 3.2 m, 울타리 3.6 m, 비행 170초 | 머리 위 도르래 |
| T6 | 이륙 판정 전 전원 규칙 → 모터 정지 (F1에서 고침) | 패드 위에서 전원 장치 차단 방지 |

W_D2(비행 중 버퍼 충전 → 착륙)도 넣었지만 플랜트에 고장 모델이 없어 단위 시험만 했습니다. 배터리 빌드(대회용)는 한 비트도 바뀌지 않았습니다(배터리·탄도 비행 5개의 로그 해시 같음).

### 3.3 수정 라운드 F1~F10 (독립 검토 반영)

| ID | 무엇을 | 왜 (검토 결함) | 근거 |
|---|---|---|---|
| F1 | 전원 규칙의 모터 정지(SAFE)는 **패드 위에서만**. 떠 있으면 착륙 | T6 때문에 이륙 판정 전(0.6~1.8 m 높이)에 전선이 빠지면 공중에서 모터가 꺼졌음. 하이브리드 6/6 낙하 | P_H_unplug_climb: 0.46 m 공중 정지 → 버퍼로 착륙 0.66 m/s |
| F2 | 축소 자세 오차를 항상 사용 | 반대 방향 회전, FCU 비용 절약 | 수평 경로 −216 µs |
| F3 | 로터 자이로 보상 끔 | 새 플랜트에서 비상정지가 늘었음 | TUNE 회전 그룹 비상정지 20 → 12 |
| F4 | 믹서가 포화돼도 요 트림 몫 유지 | 트림을 버리면 회전이 기체를 돌림 | I3가 I2로 바뀜(물리 한계) |
| F5 | 이륙 감지 후 추력비 빠른 학습(0.4초) | 센 기체가 목표를 지나침 | 이륙 초과 1.09 → 0.46 m (영상 23) |
| F6 | 이륙할 때까지 기준 높이 대기 | 기준이 기체보다 앞서 감 | 1.01 → 0.34 m (영상 24) |
| F7 | 목표 앞에서 기준 감속 | 계단 명령 | 0.73 → 0.44 m (영상 25) |
| F8 | 바닥 위에 떠 있으면 추력을 조금 빼서 내려앉힘 | 지면 효과로 바닥 위 3~12 cm에서 착지로 판정하고 모터를 끔 | 떠 있는 착지 TUNE 37/99 → 0/99 |
| F9 | 착륙 시작 때 기준 높이를 현재 높이로 | 상승 중 착륙 명령이 너무 빠르게 내려옴 | 접지 1.41 → 0.65 m/s (영상 27) |
| F10 | 반작용 보상을 이득 값으로 (값 1, 동작 같음) | 시험용 | 영상 없음 |

쓰지 않은 것: 기준 거버너(이륙 초과가 줄지 않음), 이륙 상한 고정(cap_margin), NAV 지연 스로틀 보정(초과 0.54 → 0.60 m로 나빠짐), 반작용 보상 0.5배.

---

## 4. 결과 표

### 4.1 표본(시드)과 규칙

| 표본 | 시드 | 쓰임 |
|---|---|---|
| TUNE | 7400 | 튜닝은 여기서만 |
| EVAL | 8300 | 라운드마다 한 번. 플랜트·제어·유선 라운드가 각각 한 번씩 돌림. 수정 라운드도 한 번 다시 돌림 → **튜닝 자료로 침** |
| FRESH | 9200 | 독립 검토자가 한 번 사용(이제 사용 끝) |
| FRESH2 | 9700 | 수정 라운드 최종 검증에 처음 사용(이제 사용 끝) |
| 캠페인 | 1090 | 새 표본, 튜닝 없음 |
| 검토자 시험 | 9900 | 검토자 반례 시험 |

**주의**: EVAL, FRESH, FRESH2 모두 이제 본 표본입니다. 다음 최종 검증에는 **새 시드**가 필요합니다.

### 4.2 제어 라운드 (플랜트 라운드의 모델, 같은 표본 전·후)

EVAL 8300 (각 1회), 통과 / 비상정지:

| 그룹 (비행 수) | 예전 제어 | 제어 라운드 |
|---|---|---|
| 현장 배터리 (120) | 10 / 79 | 42 / 0 |
| 회전 강함 (80) | 0 / 69 | 18 / 1 |
| 추력 하한 (60) | 5 / 33 | 4 / 0 |
| 추력 스트레스 (30) | 1 / 8 (이륙 불가 7) | 1 / 0 |
| 시연 밀기 (60) | 0 / 59 | 0 / 57 |
| 유선 (40) | 0 / 29 | 1 / 9 |
| 하이브리드 (40) | 0 / 40 | 0 / 40 |

검토자의 FRESH 9200 (새 표본, 각 트리 1회): 현장 6/73 → **20/1**, 회전 강함 3/73 → 15/0, 추력 하한 1/33 → 3/0, 스트레스 0/14 → 0/0, 시연 1/57 → 0/55, 유선 0/29 → 2/10, 하이브리드 0/39 → 0/37.
→ 비상정지 감소는 진짜였습니다. 하지만 현장 통과는 EVAL의 42회가 아니라 **20회**였습니다(EVAL이 운 좋은 표본).

### 4.3 수정 라운드 (엄격해진 플랜트, 같은 표본 전·후)

전 = 새 플랜트 + 제어·유선 라운드의 제어, 후 = 새 플랜트 + 수정 라운드 제어.

FRESH2 9700 (처음 쓴 표본, 가장 믿을 만함), 통과 / 비상정지:

| 그룹 (비행 수) | 전 | 후 |
|---|---|---|
| 현장 배터리 (120) | 5 / 26 | **22 / 17** |
| 회전 강함 (80) | 2 / 29 | 9 / 19 |
| 회전 반대 방향 (40) | 0 / 30 | 2 / 22 |
| 추력 하한 (60) | 0 / 13 | 1 / 7 |
| 추력 스트레스 (30) | 0 / 11 | 0 / 5 |
| 시연 밀기 (60) | 0 / 57 | 0 / 56 |
| 유선 (40) | 1 / 14 | 6 / 4 |
| 하이브리드 (40) | 0 / 33 | 0 / 33 |
| 이름 붙은 시나리오 57개 | 29개 기대대로 | **39개** 기대대로 |

* 현장 이륙 초과 중앙값 0.68 → 0.41 m, 위치 유지 RMS 중앙값 0.46 → 0.29 m.
* **나빠진 것**: 약한 추력(스트레스) 기체의 이륙 초과 중앙값 −0.07 → 1.06 m. 비상정지는 11 → 5로 줄었습니다.
* EVAL 8300 재실행(튜닝 자료): 현장 7/32 → 27/21, 유선 0/9 → 3/7.
* 유선 전원 규칙 시나리오 27개: 통과 20 → 22.

### 4.4 캠페인 (시드 1090, 최종 제어, 각 1회)

| 캠페인 | 비행 수 | 통과 | 착지·기준 미달 | 비상정지 |
|---|---:|---:|---:|---:|
| 현장 (GPS 켬) | 500 | 89 (18 %) | 338 | 63 (13 %) |
| 시연, 계획한 밀기 5~15 N | 300 | 2 | 9 | 282 (94 %) |
| 유선 시험 (배터리 없음) | 150 | 14 (모두 실외) | 107 | 28 (19 %) |
| 하이브리드 시연 (밀기 5~15 N) | 150 | 0 | 1 | 129 (86 %), ON 거부 16 |
| 보조: 시연 밀기 1~3 N | 100 | 10 | 76 | 12 |
| 보조: 하이브리드 밀기 1~3 N | 50 | 1 | 21 | 22 |
| 참고: v0.8.1 현장 (로켓 기체) | 1000 | 333 (33 %) | 414 | 122 (12 %) |

* v0.9는 판정이 두 개 더 엄격합니다(착지 0.3 m/s, 이륙 초과). 통과율은 v0.8.1과 직접 비교할 수 없습니다. 비상정지율은 비교할 수 있습니다(13 % 대 12 %).
* 현장 비상정지 63회: I3 36회, I2 27회. 63회 중 60회는 회전 배율이 1보다 컸고, 53회는 반대 방향이었습니다.
* 잔류 회전 스윕(같은 30개 표본): 비상정지 −2.0에서 25, −1.5에서 11, −1.0에서 3, −0.5~+1.5에서 0, +2.0에서 9.
* 착지 지면 속도 0.3 m/s 이하는 45 %뿐입니다. 가장 많이 실패한 기준입니다. 착지 때 다시 뜨는 일이 흔합니다(접촉 중앙값 3회).
* 실내 유선 80회 통과 0은 **판정 문제**입니다. GPS가 없으면 '착지점-유지점' 값을 계산할 수 없는데 실패로 셉니다. 이 기준만 실패한 실내 비행이 28회입니다(참고값, 기준은 바꾸지 않음).

### 4.5 v0.8.1 대 v0.9 (같은 40개 회전 표본, 기체·모델·제어 모두 다름)

| | 비상정지 | 통과 |
|---|---:|---:|
| v0.8.1 (로켓 기체 2,664 g) | 9 | 17 |
| v0.9 최종 (VTOL 1,647 g) | 13 | 6 |

강한 회전 속에서는 가벼운 v0.9 기체가 더 약합니다. 비교 영상 01~04가 이것을 보여 줍니다(02는 반례).

---

## 5. 추력 범위 결과 — 안전하게 날려면 T_max가 얼마 필요한가

현장 프로파일, 같은 30개 표본, T_max(22.2 V 기준)만 바꿈 (시드 1090, `sim/out/vtol/campaign_v09_thrust_sweep_s1090/`):

| T_max (kgf) | 추력/무게 (22.2 V) | 통과 /30 | 비상정지 | 이륙 거부 V15 | 이륙 초과 중앙값 / 최대 (m) | 착지 ≤ 0.3 m/s | 위치 유지 RMS (m) |
|---|---|---:|---:|---:|---|---|---|
| 1.50 | 0.91 | 0 | 2 | 20 | − | 0/4 | 0.61 |
| 1.65 | 1.00 | 0 | 4 | 4 | − (V14 착륙 19) | 1/21 | 1.09 |
| 1.80 | 1.10 | 0 | 6 | 0 | 1.40 / 1.96 | 3/23 | 1.39 |
| 2.00 | 1.22 | 0 | 6 | 0 | 1.21 / 1.84 | 3/23 | 1.12 |
| **2.14** | **1.30** | **0** | 5 | 0 | 1.03 / 1.74 | 10/24 | 1.11 |
| 2.30 | 1.40 | 0 | 4 | 0 | 0.79 / 1.42 | 9/25 | 0.94 |
| 2.46 | 1.50 | 2 | 5 | 0 | 0.56 / 1.09 | 9/24 | 0.76 |
| **2.62** | **1.60** | **4** | 4 | 0 | **0.38** / 0.81 | 12/25 | 0.72 |
| 2.78 | 1.69 | 9 | 4 | 0 | 0.25 / 0.59 | 16/25 | 0.72 |
| 2.94 | 1.79 | 9 | 4 | 0 | 0.17 / 0.43 | 14/25 | 0.75 |
| 3.09 | 1.88 | 12 | 4 | 0 | 0.11 / 0.34 | 16/25 | 0.73 |

**결론**

* **T_max 1.65 kgf 이하 (추력/무게 ≤ 1.0)**: 제대로 날 수 없습니다. 1.65 kgf에서는 떠도 19회가 V14(추력 여유가 모자라 위치 유지용 기울기를 못 냄)로 착륙했습니다. 1.50 kgf에서 V15가 30회 중 20회를 패드에서 멈췄습니다. **그러나 4회는 모터가 54~60초 동안 패드 위에서 돌았고 V15가 작동하지 않았습니다**(지면 효과로 살짝 뜸, 가정 모양). 펌웨어 라운드에서 고쳐야 할 빈틈입니다.
* **1.80~2.30 kgf**: 뜨고 내립니다. 하지만 이륙 초과가 0.8~1.4 m이고 통과 0입니다.
* **2.14 kgf (설계 하한, T/W 1.3)**: 통과 0/30입니다. 이륙 초과 중앙값 1.03 m, 착지 0.3 m/s 이하 42 %.
* **2.46 kgf**: 팩 끝(3.7 V/셀)에서도 T/W 1.3이 되는 값입니다(`docs/v0.9_하드웨어_변경.md` 5장). 통과가 생기기 시작합니다.
* **2.62 kgf 이상 (T/W ≥ 1.6)**: 이륙 초과 중앙값이 0.5 m 기준 아래로 내려갑니다. 위치 유지 RMS 0.72 m.
* 비상정지 4~6회는 추력과 관계없이 **같은 표본**(회전 배율 −1.3 ~ −2.0)에서 났습니다. 추력을 올려도 반대 방향 회전 문제는 해결되지 않습니다.
* 그래서 벤치 시험의 판단 기준을 이렇게 제안합니다: **22.2 V 기준 T_max ≥ 2.6 kgf 권장, 2.46 kgf 최소.** 2.14~2.46 kgf이면 이륙 초과를 줄이는 제어 작업이 더 필요합니다. 2.0 kgf 아래이면 기체를 더 가볍게 하거나 EDF를 바꿔야 합니다.
* 이 결론은 지금 제어기와 가정값(회전, 베인 힘, 지면 효과)에 기댑니다. 펌웨어로 옮긴 뒤와 실측 뒤에 다시 확인해야 합니다.
* 참고: 로켓 구성(2,592.6 g)은 T/W 1.3에 3.38 kgf가 필요합니다.

---

## 6. 유선·하이브리드 전원 규칙

### 6.1 규칙 (값은 모두 가정, `params.json` `mission.vtol.power_rules_ASSUMED`)

| 규칙 | 조건 | 동작 |
|---|---|---|
| W_ARM | ON 전 전선 24.6~25.6 V 밖 (하이브리드: 버퍼 3.72~3.92 V/셀 밖) | ON 거부 |
| W_SAG | 배터리 없는 유선, 20.0 V 아래 0.3초 / 1.0초 | 경고 + 추력 상한 고정 + UP 거부 / 착륙 |
| W_LOST | 하이브리드, 전선 20.0 V 아래 또는 버퍼보다 0.5 V 낮음, 40 ms | 버퍼로 착륙 |
| W_BUF | 버퍼 3.4 V/셀 0.2초, 또는 3.6 V/셀 2초 | 착륙 |
| W_D2 | 비행 중 버퍼 충전 (3.95 V/셀 0.5초) | 착륙 |
| 고도 | 호버 1.5 m, 최저 1.0, 최고 2.0 m(UP 거부), 상한 3.2 m, 울타리 3.6 m | |
| 시간 | 비행 170초, 강제 차단 200초 | |
| F1 | 이륙 판정 전이라도 떠 있으면 | SAFE 대신 착륙 |

### 6.2 결과

* 정상 유선·하이브리드 비행에서 전원 규칙 **오작동 0회** (TUNE 26, EVAL 80, FRESH 74, 수정 라운드 EVAL/FRESH2, 캠페인 300).
* 규칙 시나리오 27개 중 22개 통과(수정 라운드). 남은 실패: 긴 선로 + 약한 팬에서 W_SAG 경고(보수적), 유선 기체 3 N 밀기, 전선 걸림 2개.
* 배터리 없는 1~2 m 낙하 5개 시나리오: 모두 땅에 닿기 전에 안전줄이 잡았습니다(약 42~43 N, SRL·자동 잠금 장치 모델, 가정값).
* 하이브리드 전선 빠짐(이륙 1초 뒤): 0.04초 뒤 버퍼로 착륙, 접지 0.66 m/s.

### 6.3 절차서의 핵심 (`B:\Video\문서\유선_시험비행_절차.md`)

1. 비행 전 **추력·전류 벤치 시험**. 호버 전류가 전원 장치 전류 제한의 **0.7배 이하**여야 합니다(짧은 선로에서 전류 제한에 걸리면 기체가 알 수 없음).
2. **ADC 세 채널 2점 교정** (V_in, 전선, 버퍼). 교정 전에는 유선 비행 금지.
3. **도르래 4.5 m 이상**, 패드 바로 위.
4. 안전줄은 **SRL 또는 자동 잠금 빌레이**. 예전의 '0.1 m 이하로 잠근 빌레이'는 쓰지 않습니다.
5. 늘어뜨린 전선은 **0.25 m 이하**, 흡입창에서 떨어지게.
6. ESC의 정지 시 브레이크는 끕니다(회생 전류).
7. **하이브리드 시연 중 밀기는 하지 않습니다.**

---

## 7. 남은 위험

| # | 위험 | 숫자 | 다음 할 일 |
|---|---|---|---|
| 1 | 추력 미측정 | 판매자 3.09 kgf 미검증 | 벤치 시험 (8장) |
| 2 | 잔류 회전이 **반대 방향**이면 비상정지 많음. 원인(로터 반작용·자이로와의 결합)은 아직 모름 | 현장 비상정지 53/63이 반대 방향, 스윕 −2.0에서 25/30 | 방향·크기 측정. 다음 제어 작업 |
| 3 | 약한 베인 + 강한 회전 = 물리적 한계 | 트림만으로 베인 20° 중 15~18° | 베인 힘 측정 |
| 4 | 시연 밀기 5~15 N 불가 | 94 % 비상정지. 1~3 N도 6초 안 복귀 55 % | **밀기 규칙 결정 필요** (사용자) |
| 5 | 이륙 초과 | 현장 중앙값 0.33~0.41 m, 약한 기체 1.06 m, 유선 최대 약 1.3 m, 캠페인 참 높이 최대 3.35 m (도르래 충돌은 모델에 없음) | 도르래 4.5 m 이상. 다음 제어 작업 |
| 6 | 착지 지면 속도, 착지 때 다시 뜸 | 0.3 m/s 이하 45 %, 접촉 중앙값 3회 | 다음 제어 작업 |
| 7 | 위치 유지의 나쁜 쪽 | 최대 거리 95 %: 5.07 m (v0.8.1 2.58 m) | 다음 제어 작업 |
| 8 | 약한 추력에서 V15 빈틈 | 1.50~1.65 kgf에서 5/60회, 모터 54~60초 패드 위 | 감독 규칙 수정(펌웨어 라운드) |
| 9 | 전선 걸림은 제어로 못 막음 | 20 N 걸림 7/8 비상정지 | 무게중심 높이 브라이들 또는 끊어지는 연결 (CAD) |
| 10 | 지면 효과: 배기면 = 바닥 접촉면 | 바닥 위 5~12 cm에서 떠 있음 | 착지 다리(배기면 45 mm 이상 띄움, CAD) |
| 11 | 탄도(로켓) 비행은 다시 튜닝하지 않음 | S5 실패, 서보 평가 '부족' (베인 유격) | 로켓 임무를 날릴 거면 재튜닝 |
| 12 | FCU RAM 여유 | 배터리 빌드 1 B 남음, 하이브리드 빌드 7 B 확보 필요. 사이클 숫자는 대부분 추정 | 펌웨어 라운드에서 simavr로 측정 |
| 13 | 가정값 | 추력표, 회전 크기·방향, 로터 관성(4.5e-5), 회전 방향(CW), 베인 힘, 지면 효과, GPS 오차, 안전줄·전원 장치 | 측정 (8장) |
| 14 | VTOL 비상정지 기록의 '낙하산 사출' 문구 | 옛 문구. VTOL에는 낙하산 없음 | 문구 수정 요청함 |

---

## 8. 직접 재 주실 것

| # | 무엇 | 왜 | 방법·참고 |
|---|---|---|---|
| 1 | **EDF 추력표** (스로틀별 추력, 전류, ESC 입력 전압, 회전수). 추력은 전압과 함께 기록 | 모든 결과의 가장 큰 불확실성. 판단 기준: 22.2 V 기준 2.6 kgf 권장, 2.46 kgf 최소 | `docs/시험_안전_법규.md` 2단계(추력 측정), `docs/유선전원_검토.md` 15절(전원·계측: 150 A 전력계, 5 kg 로드셀), `docs/유선_시험비행_절차.md` 1단계. 비행용 LiPo로, 100 A에서 멈춤 |
| 2 | **잔류 회전 토크의 크기와 방향** + 팬 회전 방향 | 비상정지의 주원인. 지금은 크기 0.15 × (0~2), 방향 반반, 회전 CW 모두 가정 | 제안: 추력대에 요(수직축) 토크 팔을 달고 베인 0°에서 스로틀 50/70/90 %의 토크를 저울로 잼. 회전 방향은 흡입구 쪽에서 봄 |
| 3 | **부품 무게** | 질량 목표 여유가 2.8 g(배터리) / 0.7 g(유선)뿐이고 약 197 g이 추정 | 결합 나사 12개, 캐리어 PCB(50 g 가정), 기타 전자(25 g 가정), 선(g/m), 불릿, 아이볼트·와셔·너트·부트, 배터리 실물 (`docs/v0.9_하드웨어_변경.md` 14장) |
| 4 | 베인 힘(옆 힘·모멘트) 대 각도, 호버 추력에서. 서보마다 µs당 각도 | 베인 힘 0.72~1.05배 가정. 11.1 µs/° 근거 없음 | 로드셀, ±5/10/20° |
| 5 | 로터 관성 또는 부하 회전수 | 로터 보상의 크기 | 회전수계 |
| 6 | 추력 계단 응답 (10 % 계단) | 추력 시정수 0.15초 가정 | 로드셀 + 회전수 |
| 7 | ESC 회생 여부, 정지 시 브레이크 끄기 | 유선 전원 장치 과전압 차단 위험 | 80 → 50 % 계단, KILL |
| 8 | 안전줄 장치의 잠김 속도·감는 힘 | 낙하 판정이 이 모델에 기댐 | 장치 사양서 또는 실측 |
| 9 | ADC 2점 교정 (유선 비행 전) | 교정 전 오차가 규칙 창보다 큼 | 멀티미터, 약 20 V / 25 V |
| 10 | (가능하면) 판 위 호버 시험 | 지면 효과 모양 | h/D 0.1~1.5에서 추력·베인 모멘트 |

---

## 9. 다음 라운드 = 펌웨어 라운드

이번 라운드의 기준 코드 변경을 모두 ATmega128A로 옮깁니다. 지금 실패하는 헤더·교차검증 시험은 그때 고쳐집니다.

1. **NAV 시간 맞추기**: 4칩 v0.8.1 측정에서 NAV가 틱의 102.5 %(최대 4,099 µs / 4,000 µs)입니다. 프로파일: 스크래치 `timing82/profile/breakdown.md`. 이번 라운드는 NAV에 아무것도 더하지 않았습니다.
2. **C 이식** (`v09sim/control/C_port_notes.md`, 복사본 `B:\Video\시뮬레이션\v0.9_수정라운드\C_port_notes.md`)
   * 1~4절 (제어 라운드): 후보 D(포트 B), 축별 적분기 멈춤, 로터 반작용 보상, 2단 이륙 램프 + 추력 탐색, keep_vel(GNS)
   * 6절 (유선): 빌드별 전원(PWR_SRC), `core/power_mon.c`(Q4 필터), 규칙(I8 자리), u_cap, 유선 제한값. 이유 코드 R_W_LOST 0x30 ~ R_W_D2 0x33, REJ_POWER 0x58, TELEM v4/v5(+2 B). ADC 핀 2개(PF4~7 제외), 버퍼 전류 부호 GPIO
   * 7절 (수정 라운드): F1 power_act, att_err_mode 2, 자이로 보상 끔, 믹서 요 트림 예약, 이륙 학습·대기·감속, 착륙 기준 재설정, 착지 추력 빼기. ADC 채널별 교정 상수
3. **FCU 비용 (추정, v0.8.1 측정 대비)**: 기울어진 경로(최악) 약 −143 µs, 수평 경로 약 −118 µs, 유선 빌드는 +약 20 µs. 정적 RAM +4 B → 배터리 빌드 여유 1 B, 하이브리드 빌드 **7 B 확보 필요**. 모두 simavr로 측정해야 합니다.
4. **헤더 다시 만들기**: `params_gen.h`, `gains.h`, `bridge_config_gen.h` (새 키: VTOL 재정의, 이륙, 전원 규칙 Q4 코드, 터치다운 정책). 먼저 `core/fc_config.c fc_vtol_gains`와 생성기의 `VTOL_OV_C_FIELDS`에 새 키 7개의 칸을 더해야 합니다. 지금은 생성기가 params.json을 거부합니다(시험 67개 실패, 10장)
5. **교차검증 벡터**: 제어기, 감독(전원 규칙 포함), 수직 제어기
6. **4칩 공동 시뮬레이션**(NAV·FCU·COM·GNS)으로 시간·동작 확인
7. 같이 할 것: V15 빈틈(약한 추력), VTOL 비상정지 문구, MIX_L_V 구성별(0.2100 / 0.1847 / 0.1973 m), GPS 안테나 위치(params), 서보 트림 범위 ±100 µs 이상
8. 다른 작업: CAD(착지 다리, 무게중심 높이 브라이들), 사용자 결정(밀기 규칙, 하이브리드 버퍼 하한 3.72 V/셀, 이륙 초과 기준 0.5 / 0.3 m, 안전줄 장치 선택)

---

## 10. 시험 결과 (전체 pytest, 2026-10-28, 이 문서 작성 중 1회)

명령: `.venv/Scripts/python.exe -m pytest -q -p no:cacheprovider -rfEs --tb=line` (프로젝트 전체, 656초).
결과: **1,097 통과, 58 실패, 15 오류, 8 건너뜀, 2 예상 실패.** 기록: 스크래치 `v09sim/docs/pytest_full.txt`.

| 묶음 | 개수 | 이유 | 언제 고치나 |
|---|---:|---|---|
| `tools/test_gen_firmware_params.py` | 52 실패 + 15 오류 | **원인 하나**: 헤더 생성기가 지금 params.json을 거부합니다. `control.vtol_overrides.att_err_mode`에 해당하는 C 구조체 칸(`core/fc_config.c fc_vtol_gains`)이 없기 때문입니다. 새 키 7개(att_err_mode, aw_per_axis, ff_rotor_h_nms, ff_rotor_tau_s, ff_rotor_react, ff_rotor_gyro, mix_yaw_trim_reserve)가 모두 그렇습니다. 일부러 만든 안전 장치입니다(C에 없는 값을 조용히 버리지 않음). 헤더 최신 여부 시험(`test_header_on_disk_is_current`)도 여기 들어 있습니다 | 펌웨어 라운드 (C 칸 추가 + 헤더 재생성). **이전 라운드 보고서에는 없던 실패입니다**(그 라운드들은 sim/과 지상국 시험만 돌렸음) |
| `tools/test_ground_station.py::test_bridge_header_is_current_and_matches_params` | 1 | 지상 브리지 헤더 STALE | 펌웨어 라운드 |
| `sim/test_vtol_scenarios.py::test_build_flags_select_the_v08_build_and_the_v071_fallback` | 1 | 원래 있던 실패 (v0.8.1 GNS 경로) | 기존 |
| `test_push_far_from_the_cg_tilts_more_than_at_the_cg` | 1 | 가벼운 기체: 밀기 중 요 회전 74.7°/s > 60 | 플랜트 라운드부터. 기준 미완화 |
| `test_strong_plant_lands_on_the_ground_by_the_detector` | 1 | 추력비 학습 1.40 (기대 1.25 ± 0.06) | 제어 라운드부터, 원인 조사 안 됨 |
| `test_too_weak_plant_never_lifts_off_and_stays_safe` | 1 | V15는 작동. 모터 시간 5.64초 > 3.6초(예전 램프 기준) | 제어 라운드부터 |
| `test_push_position_response_and_v08_push_check` | 1 | 가벼운 기체: 첫 밀기 뒤 복귀 못 함 | 플랜트 라운드부터 |

건너뜀 8개: CadQuery 립 클램프 프리셋 3개(원래), VTOL CAD 보고서가 다른 params.json에서 나옴 2개(이번 라운드의 params 변경, CAD 보고서 재발급 필요), v0.8 기체 고정 해시 2개(기본 기체가 VTOL로 바뀜), CadQuery 트윈 STALE 1개.
sim/과 지상국 시험만 보면 수정 라운드·캠페인 보고와 같습니다(6개 실패).

---

## 11. 완결성 점검 (문서 담당이 한 일)

* 보고서에 적힌 파일 233개 경로를 디스크에서 확인했습니다. **없는 파일 0개**.
* 머리 숫자 20여 개를 결과 파일을 열어 확인했습니다. 모두 같았습니다(예: 기준선 현장 10/79, 제어 라운드 42/0, FRESH 20/1, FRESH2 22/17, 이름 붙은 시나리오 29 → 39, 캠페인 89/63, 추력 스윕, 회전 스윕, 루프 여유 40.4° / 6.01, 40개 짝 비교 9/17 대 13/6, 질량 1,647.17 g, params 해시 ae0b99e4…).
* 기준을 몰래 완화한 곳은 찾지 못했습니다. 기준 변경은 모두 엄격해지는 쪽이거나(이륙 초과, 매달린 착지, 비행 중 확인), 보고서에 적혀 있습니다(착지 판정 대상 선택, 시나리오 재설계).
* 찾은 문제(보고만 함, 제 파일이 아님)
  * 전체 시험에서 **헤더 생성기 시험 67개(52 실패 + 15 오류)** 가 실패합니다. 어느 라운드 보고서에도 없었습니다(10장). 원인은 하나이고 펌웨어 라운드에서 고쳐집니다.
  * 수정 라운드의 새 기능(플랜트 P1~P9, 제어 F2~F9)에 전용 단위 시험이 거의 없습니다. 시험 파일 주석이 말하는 `test_v09fix_*` 시험은 존재하지 않습니다. 지금은 닫힌 루프 시험과 다시 고정한 해시로만 간접 확인됩니다.
  * C 이식 메모 6.1절의 "유선 빌드는 실내 GPS 없이만 난다"는 문장이 아직 고쳐지지 않았습니다(검토자 지적). 캠페인 유선 비행의 절반은 실외 GPS 비행입니다. 결론(비용이 최악 틱을 넘지 않음)은 그대로입니다.
  * 캠페인의 도르래 높이 표본은 3.5~4.0 m인데, 절차서는 4.5 m 이상을 요구합니다. 도르래 충돌은 모델에 없습니다.
  * 가정 표시가 빠진 값: `params.json` `servo.pwm_us_per_deg` 11.1(µs/°)은 측정값이 아닌데 (가정) 표시가 없습니다. 직접 구동이라 이 값이 그대로 루프 이득입니다(물리 검토자 지적). 8장 4번에서 재 주세요.
  * 시험 쪽 조정(기준 완화 아님, 확인함): 수정 라운드가 GPS 울타리 시험의 "먼저 HOLD 도달" 단계를 "HOLD 또는 LAND"로, 다른 시험의 비행 시간을 15 → 12초로 바꿨습니다. 시험의 판정(울타리로 착륙, 비상정지 없음)은 그대로입니다.

---

## 12. 파일 위치 (B:\Video, 전체 경로)

**[있음]** 이미 있는 것

| 무엇 | 경로 |
|---|---|
| 이 문서 | `B:\Video\문서\v0.9_시뮬레이션_제어_결과.md` |
| 하드웨어 변경 | `B:\Video\문서\v0.9_하드웨어_변경.md` |
| 설계 명세 (영문) | `B:\Video\문서\SPEC.md` |
| 유선 시험비행 절차 | `B:\Video\문서\유선_시험비행_절차.md` |
| 플랜트 기준선 | `B:\Video\시뮬레이션\v0.9_플랜트_기준선\` |
| 제어 재튜닝 | `B:\Video\시뮬레이션\v0.9_제어_재튜닝\` |
| 유선 전원 규칙 | `B:\Video\시뮬레이션\v0.9_유선전원_규칙\` |
| 수정 라운드 (C 이식 메모 포함) | `B:\Video\시뮬레이션\v0.9_수정라운드\` |
| 캠페인 요약 (그래프 8장) | `B:\Video\시뮬레이션\v0.9_시뮬레이션_결과_요약.md` |
| 캠페인 결과 폴더 | `B:\Video\시뮬레이션\캠페인\v0.9_현장_GPS켬_500회\` 외 `v0.9_*` 7개, `v0.9_그래프\`, `v0.9_분석\` |
| 렌더러 시험 영상 | `B:\Video\시뮬레이션\v0.9_렌더러_시험\` |
| 분석 영상 17개 | `B:\Video\영상\분석영상\v0.9\` (목록 `영상_목록.md`) |
| 제어 변경 비교 영상 28개 | `B:\Video\영상\제어변경_비교\v0.9\` (목록 `비교영상_목록.md`, 프레임 확인 `프레임_확인\`) |
| 제어 변경 이력 | `B:\Video\제어변경_이력\v0.9_제어_변경이력.md`, `B:\Video\제어변경_이력\제어_변경_이력.md` |
| 하드웨어 변경 이력 | `B:\Video\제어변경_이력\v0.9_하드웨어_변경이력.md` |
| v0.8.1 기준선 보관본 | `B:\Video\제어변경_이력\보관본\v0.8.1\`, 안내 `B:\Video\제어변경_이력\v0.8.1_기준선\README.md`, 재현 확인 `B:\Video\시뮬레이션\v0.8.1_기준선\verify_report.json` |
| 지상국 유선 안내, 연습 기록 예시 | `B:\Video\지상국\v0.9_지상국_유선전원_안내.md`, `연습로그_예시_*_v0.9.csv` |
| 발표용 CAD 그림 7장 | `B:\Video\CAD\v0.9\렌더\발표용_1920x1080\` |
| 소스코드 사본 | `B:\Video\소스코드\` |
| 독립 검토 결과 파일 (FRESH 비교표, 루프 여유, 물리 손 계산, 가정 시험 비교) | `B:\Video\문서\작업보고서\v0.9_독립검토\제어안전\`, `B:\Video\문서\작업보고서\v0.9_독립검토\물리\` |
| 최종 점검 증거 (전체 pytest 기록, 파일 확인, 동기화 확인) | `B:\Video\문서\작업보고서\v0.9_최종점검\` |

**[예정]** 아직 없는 것

| 무엇 | 언제 |
|---|---|
| 펌웨어 v0.9 (C 이식, 새 헤더, HEX), 4칩 공동 시뮬레이션 보고서 | 펌웨어 라운드 → `B:\Video\펌웨어\` |
| 실측 추력표, 회전 토크, 부품 무게 | 사용자 벤치 시험 뒤 |
| 실측값으로 다시 돌린 시뮬레이션과 캠페인 | 실측 뒤 |
| 발표용 실사(Blender) 대표 영상 | 미정 → `B:\Video\영상\실사_Blender\` |
