Yuchan-00/CanSat_EDF_Rocket/docs/시험_안전_법규.md

# 시험 계획 · 안전 · 법규

## 1. 단계별 시험 (앞 단계를 통과해야 다음 단계로)

| 단계 | 내용 | 통과 기준 |
|---|---|---|
| 0. 벤치 전원 | ESC를 연결하지 않은 상태로 비행 컴퓨터 세 보드(NAV·FCU·COM)와 LoRa만 켭니다. 지상국에서 루프 시간, IMU·기압계 값, 링크 지연과 손실률을 확인합니다. SD 로그에서 세 보드가 같은 `params.json`으로 빌드됐는지 봅니다(아래 "펌웨어 올리기"). | 루프 시간이 4 ms 주기 안에 끝남. 센서 값이 정상. 로그의 "COM boot: … params tag … match", NAV LED가 두 번씩 깜빡이지 않음(태그 불일치 표시). 지상국을 끄면 ARMED 상태가 2 s 뒤 SAFE로 돌아감 |
| 0a. 통신 거리 시험 | 기체를 비행 위치에 두고 지상국을 실제 거리만큼 떨어뜨려 텔레메트리 손실률을 봅니다. | 비행 거리(수직 150 m + 표류)에서 손실률이 작고 링크가 끊기지 않음 |
| 0b. 보드 고장 시험 (v0.6.3) | 모터선을 분리하고, 노즈와 사출 스프링을 빼거나 사출 링크를 분리합니다(ABORT가 사출 서보를 엽니다). **NAV**: ARMED에서 NAV를 리셋 상태로 잡습니다(RESET 핀을 GND로). 다시 ARM → LAUNCH로 POWERED를 만든 뒤 NAV를 잡거나 짧게 리셋합니다. **COM**: ARMED에서 ilink 커넥터를 뺍니다. POWERED에서도 같은 시험을 합니다. COM을 0.5 s만 리셋하는 시험도 합니다. | NAV: ARMED → SAFE (I9). POWERED → 마지막 정상 프레임 0.1 s 뒤 ABORT (I9), 0.5 s 뒤 사출 서보 열림. 짧은 리셋 뒤 NAV가 다시 살아나도 ABORT (재부팅한 NAV는 자세 추정이 무효). COM: ARMED → 2 s 뒤 SAFE (I1p). POWERED → 마지막 명령 3 s 뒤 ABORT (I1), 0.5 s 뒤 사출. 0.5 s 리셋은 상태 변화 없이 링크가 돌아옴 |
| 1. 베인 방향 | 기체를 손으로 기울여 각 베인이 복원 방향으로 움직이는지 확인합니다. 서보 방향·트림을 조정합니다. FCU에 `fcu_bench_vanes`를 올리고 NAV·COM은 비행 빌드 그대로 둡니다. | +X 쪽으로 기울이면 베인이 −X 쪽 모멘트를 만드는 방향으로 편향 |
| 2. 추력 측정 | 기체를 로드셀이 달린 고정대에 묶고 실제 배터리로 0 → 100 % 스로틀 곡선을 측정합니다. 0–50 %는 FCU에 `fcu_bench_tether`(50 % 제한), 50–100 %는 비행 빌드 `fcu`를 올리고 지상국을 `--allow-throttle-cmd`로 켜서 `throttle <u>`로 올립니다(`firmware/README.md` 10절 9단계). | 만충 배터리에서 100 % 추력 ≥ 30 N (3.1 kg). 크기 산정 비행 질량 2596 g(v0.6.3, `sizing/sizing_report.md`)에서 공칭 추력 30.3 N이면 T/W 1.19입니다(C12 WARN). 최대 전류는 ESC 순간 정격 120 A 이하여야 합니다. 미달이거나 초과하면 비행 금지 |
| 3. 테더 호버 | 짐벌 시험대 또는 줄로 묶은 상태에서 호버 스로틀(약 92 %, 크기 산정 0.917)로 자세 안정화를 확인합니다. | 10° 외란 후 1 s 안에 1° 이내로 복귀, 베인 포화 없음 |
| 4. 저고도 비행 | `mission.target_altitude_m`을 10 m로 낮춰 비행합니다. 노즈 분리와 낙하산 전개를 확인합니다. | 정점 검출 → 분리 → 낙하산 정상 |
| 5. 본 비행 | 목표 140 m (v0.6.3 시뮬레이션: 기본 비행 S2 정점 144.8 m, 시드 10개 135.2–148.7 m. 기체의 150 m 제한이 상한) | 로그와 시뮬레이션 비교 |

0b의 POWERED 기대값은 세 칩을 함께 돌린 simavr 공동 시뮬레이션 결과입니다(`firmware/atmega128_fc/host_test/build/cosim_report.json`, 고장 시험 `nav_hold`, `nav_pulse`, `cut`, `reset` 모두 PASS). ARMED 기대값은 감시기 규칙(`sim/onboard.py`의 I9, I1p)입니다. 실기에서는 아직 확인하지 않았습니다(NOT VERIFIED). 이 시험이 그 확인입니다. 시뮬레이션의 `cut`은 ilink 양방향을 4 s 끊은 것입니다. ilink 커넥터는 TX·RX·GND 3선이고 COM은 UBEC에서 따로 전원을 받으므로(`firmware/README.md` 4.8), 커넥터를 빼도 데이터만 끊기고 COM은 켜진 채로 있습니다. 둘 다 FCU에게는 명령이 오지 않는 같은 상황입니다. ARMED에서 NAV를 아주 짧게 리셋했을 때의 동작은 시뮬레이션하지 않았으므로, ARMED에서는 리셋을 잡고 있는 시험만 합니다. ABORT 뒤에는 RELEASED가 되고 전원을 다시 넣어야 풀리므로, 시험마다 전원을 껐다 켭니다.

각 단계의 로그(SD 카드)는 `firmware/atmega128_fc/tools/decode_log.py`로 CSV로 바꿉니다. v0.6.3 로그에는 NAV 링크 기록(`N`, 1 Hz)과 COM 상태 기록(`C`)이 따로 있습니다. 이것을 `sim/`의 시뮬레이션 결과와 비교해서 게인과 모델을 보정합니다.

### 펌웨어 올리기 (세 보드, v0.6.3)

자세한 명령은 [제작가이드.md](제작가이드.md) 3장 10단계에 있습니다. 시험할 때 특히 지킬 것:

* 세 칩(NAV·FCU·COM)에는 **같은 `params.json`으로 만든 빌드**를 올립니다. `params.json`이 바뀌면 셋 다 다시 빌드해서 올립니다. 태그가 달라도 비행은 막히지 않으므로 0단계에서 로그와 NAV LED로 확인합니다.
* FCU를 올릴 때는 OpenLog를 빼고, NAV를 리셋 상태로 잡거나 nlink 커넥터를 뺍니다. COM을 올릴 때는 ilink 커넥터를 뺍니다. 올린 뒤 커넥터를 다시 꽂았는지 확인합니다. nlink가 빠져 있으면 센서 고장(I9), ilink가 빠져 있으면 링크 끊김(I1p/I1)으로 처리되어 ARM이 되지 않거나 풀립니다.
* 시험용 FCU 빌드: 1단계 `fcu_bench_vanes`(ESC는 계속 정지, 비행 금지), 2단계 0–50 % `fcu_bench_tether`(스로틀 50 % 제한), 3단계 `fcu_bench_hover`(스로틀을 호버 스로틀 + 5 %로 제한). `fcu_bench_tether`로는 100 % 추력을 잴 수 없으므로 2단계의 50–100 %는 비행 빌드 `fcu`로 합니다. 시험이 끝나면 비행 빌드 `fcu`를 다시 올립니다.
* 조립된 기체에서는 FCU의 ISP 헤더에 손이 닿지 않습니다. FCU를 다시 올릴 때는 [제작가이드.md](제작가이드.md) 3장 10단계 4의 순서로 에이비오닉스 모듈을 들어 냅니다.
* `*_simbench`, `*_cosim` 빌드는 시뮬레이터 측정용입니다. 기체에 올리지 않습니다.

## 2. 안전

* 90 mm EDF는 6S에서도 수만 rpm으로 돕니다. 흡입구(창) 쪽에 손·공구·끈이 닿지 않게 하고, 배터리를 연결한 상태에서는 기체 앞뒤에 서지 않습니다.
* 작업할 때는 항상 배터리를 분리합니다. 아밍 스위치가 꺼져 있어도 배터리를 빼는 것이 원칙입니다.
* 6S LiPo는 만충 25.2 V(원래 12S 설계는 50.4 V)이고 순간 100 A 이상을 냅니다. 충전·보관은 LiPo 안전 백에서 하고, 손상되거나 부푼 팩은 쓰지 않습니다.
* 펌웨어 부팅 상태는 모터 정지(1000 µs)입니다. 비행 중 LoRa가 3 s 끊기거나, 기울기가 45°를 넘거나, 고도가 160 m를 넘으면 기체가 스스로 모터를 끄고 낙하산을 전개합니다(ABORT). 예상 정점이 150 m에 닿으면 모터를 끄고, 사출 명령 없이 낙하하면 스스로 사출합니다.
* v0.6.3: 판단은 FCU가 합니다. 비행 중 NAV(센서 보드)가 멈추거나 재부팅하면 0.1 s 뒤 ABORT입니다(I9). COM(무선 보드)이 멈추거나 ilink가 끊기면 LoRa가 끊긴 것과 같아서 3 s 뒤 ABORT입니다(I1).
* 관람자는 발사대에서 충분히 떨어져 있어야 합니다. 시뮬레이션에서 풍속 3 m/s일 때 수평 표류가 수십 m 이상 나왔으므로(v0.6.3 S2 최대 106.9 m), 바람이 약한 날 넓은 장소에서 비행합니다.

## 3. 법규 (대한민국, 2026-10 기준 확인 필요)

`sizing/sizing.py`가 질량으로 판단한 결과는 다음과 같습니다. 법령 원문을 직접 확인한 것은 아니므로 비행 전에 **드론원스톱(drone.onestop.go.kr)** 과 관할 지방항공청에 반드시 확인하세요.

* 예산 설계의 이륙 질량은 약 2.60 kg입니다(v0.6.3 크기 산정 비행 질량 2596 g, CAD 2586 g; 원래 설계는 4.33 kg). 둘 다 2 kg을 넘으므로 기체 신고 대상이고, 조종자 증명 3종(2 kg 초과 ~ 7 kg 이하) 대상으로 판단됩니다.
* 고도 150 m 초과, 관제권, 비행금지구역에서는 비행 승인이 필요합니다. 기본 목표 고도를 140 m로 둔 이유입니다(v0.6.3 시뮬레이션 정점 135.2–149.5 m: S2·S7·S8과 그 시드 실행, 기체가 예상 정점 150 m에서 모터를 끔).
* 캔위성 경연대회의 전개 고도(체험부 150–200 m — 크기 산정은 175 m로 계산, 슬기부 250 m, 창작부 350 m)는 150 m를 넘으므로, 그 고도로 직접 발사하려면 비행 승인이 필요합니다. 대회 규정상 발사체는 주최 측이 제공하므로, 이 기체를 대회 발사체로 쓰려면 주최 측(KAIST 인공위성연구소)과 먼저 협의하세요.
* 이 기체는 전기 덕티드팬으로 날기 때문에 화약 로켓 모터는 쓰지 않습니다. 법적으로 어떤 비행장치 종류로 분류되는지(무인비행장치의 세부 종류)는 위 기관에 확인이 필요합니다.
