Yuchan-00/CanSat_EDF_Rocket/docs/유선_시험비행_절차.md

# 유선(테더) 시험비행 절차 — v0.9

작성: v0.9 전원·테더 규칙 라운드 (2026-10-28). 근거: `docs/유선전원_검토.md`, `docs/tether_power_proposal.json`,
`sim/onboard.py`("v0.9 power rules"), `sim/tether_scenarios.py`, params `mission.vtol.power_rules_ASSUMED`.
값 옆의 **(가정)** 은 아직 측정하지 않은 값입니다. 벤치 시험으로 측정한 뒤 바꾸세요.

---

## 1. 이 절차의 범위

- 대상: 유선 시험(배터리 없는 기체, `wired`)과 하이브리드 시연(전선 + 650 mAh 버퍼 배터리, `wired_buffer`).
- 대회 비행은 지금처럼 배터리로 합니다. 이 절차는 쓰지 않습니다.
- 실내(완전히 막힌 공간)에서 GPS 없이 비행하는 것이 기본입니다. 실외 유선 비행은 GPS 빌드로만 합니다.
- 비행 높이: 호버링 1.5 m, 최고 2.0 m. 기체가 2.0 m보다 높이 올라가라는 UP 명령은 스스로 거부합니다.

## 2. 먼저 끝내야 하는 것 (이것이 없으면 유선 비행을 하지 않습니다)

1. **추력 벤치 시험**(배터리로): 추력, 전류, ESC 입력 전압을 스로틀별로 기록합니다.
   호버 전류를 구합니다.
2. **전원 장치 크기 확인**: 호버 전류가 전원 장치 전류 제한의 **0.7배 이하**여야 합니다.
   - 이유: 짧은 전선에서 전원 장치가 전류 제한에 걸리면, 기체 쪽 전압이 아직 높아서 기체가 알아챌 수 없습니다.
     5초 뒤 전원 장치가 꺼집니다(배터리 없는 기체는 떨어집니다). 시뮬레이션에서 확인한 알려진 한계입니다.
3. **전선 저항 측정**: 실제 8.5 m 10 AWG 전선으로 30 / 40 / 50 A를 흘리고 전압 강하를 잽니다.
   예상값 59.5 mΩ **(가정)**. 1.5배 이상이면 전선을 바꿉니다.
4. **ESC 회생 확인**: 스로틀을 80 % → 50 %로 내릴 때 역전류가 있는지 봅니다. 기체의 버스 클램프(26.6 V)가 받아야 합니다.
   ESC의 '정지 시 브레이크(brake on stop)'는 **끕니다**. (v0.9 수정 라운드: 시뮬레이션에 회생 모델을 넣었습니다.
   추력 지연 0.15초에서는 회생이 거의 없고, 클램프가 있으면 전원 장치 과전압 차단은 0회였습니다. 값은 가정값입니다.)
4a. **ADC 교정(v0.9 수정 라운드 추가)**: V_in, 전선 전압, 버퍼 전압 세 채널을 멀티미터로 두 점(약 20 V, 25 V)에서 교정합니다.
   ATmega128A 내부 기준전압은 2.3–2.7 V라서, 교정 전 오차(−10 ~ +5.5 %)가 전원 규칙의 창(±0.4 V)보다 큽니다.
   교정값은 펌웨어 라운드에서 params_gen.h에 넣습니다. 교정 전에는 유선 비행을 하지 않습니다.
5. **펌웨어**: 기체 FCU를 전원 빌드에 맞게 굽습니다 (`wired` 또는 `wired_buffer`).
   지상국도 같은 빌드로 켭니다: `python tools/ground_station.py --port COMx --power wired`(또는 `wired_buffer`).

## 3. 장비

| 항목 | 내용 |
|---|---|
| 전원 | Mean Well RSP-1500-24, 25.2 V 설정 (처음에는 6S 2200 팩 2개 병렬 지상 배터리도 가능) |
| 차단 | 100 A 퓨즈 + 버섯형 비상정지(전원 장치 원격 ON/OFF 또는 배터리 분리) |
| 전선 | 10 AWG 실리콘 2가닥 8.5 m + 다이니마 2 mm 강도선 + 번지(충격 흡수) 0.3–0.5 m, XT90-S 양쪽 |
| 안전줄 | 다이니마 + 번지, 위 도르래를 지나 보조자(빌레이)가 잡음 |
| 갠트리 | 도르래 높이 **4.5 m 이상** (아래 4절) |
| 보호구 | 보안경, 귀마개, 보조자 장갑 |

## 4. 설치

### 4.1 도르래 높이 — 왜 4.5 m인가
- 지금 수직 제어기는 이륙할 때 목표 높이를 **최대 약 1.2 m 넘습니다** (가볍고 힘센 유선 기체, 시뮬레이션 TUNE·EVAL).
  1.5 m 호버면 순간적으로 2.6–2.8 m까지 갑니다.
- 그래서 기체의 고도 상한(착륙 규칙)은 3.2 m, 고도 울타리(비상정지)는 3.6 m로 두었습니다. 정상 비행에서는 작동하지 않습니다.
- 기체 꼭대기 = 배기면 높이 + 0.585 m, 케이블 보호관 + 0.1 m. 울타리 3.6 m에서 꼭대기는 약 4.3 m입니다.
  → **도르래는 4.5 m 이상**에 둡니다.
- 3.5–4.0 m 갠트리를 쓰려면 이륙 초과를 먼저 고쳐야 합니다(다음 제어 라운드 요청 사항). 그 전에는 쓰지 않습니다.
- v0.9 수정 라운드: 이륙 때 목표를 지나치는 양을 줄였습니다(이륙 기준 대기, 목표 앞 감속, 이륙 중 추력 학습).
  유선 기체의 중앙값은 0.49 → 0.28 m로 줄었지만, 최대값은 아직 약 1.3 m입니다(EVAL 40회, 수정 라운드 changes.json fix_round).
  **도르래 4.5 m 규칙은 그대로 둡니다.**

### 4.2 안전줄 (v0.9 수정 라운드에서 바꿈)
- **자동 감김·속도 잠금 장치**를 씁니다: 자동 감김 안전줄(SRL) 또는 자동 잠금 빌레이 장치.
  - 줄이 천천히 나갈 때(착륙 하강)는 **자유롭게 풀려야** 합니다. 빠르게 나갈 때(약 1.2–1.8 m/s, 낙하)만 잠깁니다.
  - 이전 절차의 '여유 0.1 m 이하로 잠근 빌레이'는 **쓰지 않습니다.** 이 규칙은 시뮬레이션의 보조자 모델에 기댄 것이었습니다.
    그 모델에서는 여유가 작으면 내려올 때 기체가 줄에 걸려 공중에서 착지로 판정되었습니다(독립 검토 지적).
  - 수정 라운드 시뮬레이션(SRL·자동 잠금 모델, 가정값): 배터리 없는 기체의 1–2 m 낙하 5개 시나리오 모두 땅에 닿기 전에 잡혔습니다.
    잡는 힘은 약 42–43 N(시험하중 300 N 이하)입니다. 줄에 매달린 채 착지 판정된 비행은 0회였습니다.
  - 장치의 잠금 속도와 감김 힘(0.3–1.0 N 가정)은 실제 장치로 확인합니다.
- 번지는 반드시 넣습니다. 다이니마만 쓰면 걸리는 힘이 500–850 N이 됩니다.
- 기체가 올라가거나 내려갈 때만 천천히 줄을 조절합니다.

### 4.3 전선
- 전선은 위로(도르래 쪽으로) 나갑니다. 흡입구 창에서 200 mm 이상 떨어져야 합니다.
- 커넥터에는 힘이 걸리지 않게, 강도선을 기체 고정점에 묶습니다.
- 전선을 늘어뜨려 공급할 때는 직선 거리보다 **0.25 m 이하**만 더 풉니다(v0.9 수정 라운드).
  - 이유: 늘어진 고리는 (여유)/2만큼 고정점 아래로 처집니다. 흡입창 윗면은 고정점에서 181 mm 아래라서, 0.36 m 넘게 풀면
    고리가 흡입창에 닿습니다. 가능하면 일정 장력 공급 장치(밸런서)를 씁니다.

## 5. 비행 전 점검표

1. [ ] 비행 구역: 실내 완전 밀폐, 관객은 차단막 뒤, 비상정지 담당 1명 배치
2. [ ] 도르래 높이 4.5 m 이상, 도르래가 패드 바로 위(30 cm 이내)
3. [ ] 자동 감김·속도 잠금 안전줄 장치 확인(천천히 당기면 풀리고, 세게 당기면 잠김), 번지 연결
3a. [ ] ADC 세 채널 교정값 확인(2절 4a), ESC 정지 시 브레이크 꺼짐
3b. [ ] 전선 늘어짐 0.25 m 이하(늘어뜨려 공급할 때), 고리가 흡입창에서 떨어져 있음
4. [ ] 전원 장치 25.2 V, 퓨즈, 비상정지 동작 확인(기체 연결 전에)
5. [ ] (하이브리드) 버퍼 배터리 휴지 전압 **3.72–3.92 V/셀**
6. [ ] 지상국 `--power` 빌드가 기체와 같음, PWR 줄에 "전선/버스 2x.x V"가 보임
7. [ ] 대기 전압이 24.6–25.6 V (밖이면 지상국과 기체가 ON을 거부합니다)
8. [ ] 아밍 스위치, 통신, KILL 절차 확인. 보호구 착용
9. [ ] 측정 장비 켜기 (8절)

## 6. 비행 중 호출과 중단

| 상황 | 호출 | 누가 | 결과 |
|---|---|---|---|
| 정상 종료 | "착륙" | 조종자: `off` | 제자리 착륙 |
| 기체가 이상하게 움직임 | "착륙" | 조종자: `off` | 제자리 착륙 |
| 사람이 위험함 | "킬" | 조종자: `kill` + `yes` | 모터 즉시 정지, 낙하 → 안전줄이 잡음 |
| 전선·전원 이상(연기, 냄새, 불꽃) | "전원 차단" | 비상정지 담당 | 배터리 없는 기체: 떨어짐 → 안전줄. 하이브리드: 버퍼로 스스로 착륙 |
| 지상국 경고 "!!! … !!!" | "경고" | 조종자 | 기체가 이미 착륙 중. UP을 누르지 않음 |

- Ctrl+C는 `off`(착륙)입니다. KILL이 아닙니다.
- 착륙이 시작되면 취소할 수 없습니다. UP/DOWN은 거부됩니다.

## 7. 기체가 스스로 하는 일 (전원 규칙)

| 규칙 | 언제 | 기체가 하는 일 | 지상국 표시 |
|---|---|---|---|
| W_ARM | ON을 누를 때, 이륙 경고(2초) 끝 | 전선 전압 24.6–25.6 V 밖, 또는 버퍼 3.72–3.92 V/셀 밖이면 이륙 거부 | "거부: 전원 상태 불량 …" |
| W_SAG (배터리 없음) | 전압 20.0 V 아래로 0.3초 | 추력 상한 고정, UP 거부 | PWR 줄 |
| W_SAG (배터리 없음) | 전압 20.0 V 아래로 1.0초 | 착륙 (이륙 전이면 모터 정지) | "!!! 전원 전압 저하 - 착륙 중 !!!" |
| W_LOST (하이브리드) | 전선 전압 20 V 아래, 또는 버퍼보다 0.5 V 낮음, 40 ms | 버퍼로 즉시 착륙(시뮬레이션: 0.04초 뒤) | "!!! 전선 끊김 - 버퍼로 착륙 중 !!!" + 삐 소리 |
| W_BUF (하이브리드) | 버퍼 3.4 V/셀 아래 0.2초, 또는 3.6 V/셀 아래 2초 | 착륙 | "!!! 버퍼 배터리 부족 - 착륙 중 !!!" |
| W_D2 (하이브리드) | 비행 중 버퍼가 3.95 V/셀 위로 충전됨(다이오드 고장) | 착륙 → 착륙 후 전원 차단 | "!!! 버퍼 충전 이상(D2) …" |
| 고도 | UP으로 2.0 m 초과 | UP 거부 | "거부: 고도 범위 한계" |
| 고도 상한 | 3.2 m 초과 | 착륙 | V3 |
| 고도 울타리 | 3.6 m 초과 | 모터 정지(낙하 → 안전줄) | V4 |
| 비행 시간 | 모터 170초 | 착륙 (200초에 모터 정지) | V2 / V6 |

- 배터리 없는 기체는 전선이 빠지거나 끊기거나 전원이 꺼지면 **할 수 있는 일이 없습니다**(전기가 없음). 안전줄이 잡습니다.
- 배터리 기체(대회용)의 규칙은 바뀌지 않았습니다. 팩 말기(3.3 V/셀)에서도 착륙할 추력은 남습니다:
  추력 하한 2.14 kgf에서 추력/무게 1.08, 2.46 kgf에서 1.24, 3.09 kgf에서 1.56 **(가정: 전압 지수 1.61, 팩 저항 18 mΩ)**.

## 8. 기록할 측정값

매 비행마다:
- 지상국 로그(CSV, 자동). 비행 번호와 함께 보관합니다.
- 전원 장치: 설정 전압, 표시 전류(호버 중), 전류 제한 표시가 켜졌는지.
- 대기 전압과 호버 중 버스 전압(지상국 PWR 줄 = 6 × V_cell).
- (하이브리드) 비행 전·후 버퍼 휴지 전압.
- 안전줄: 걸린 일이 있으면 최대 하중(로드셀이 있으면), 번지 늘어난 길이.
- 비행 후 온도: 전선(가장 뜨거운 곳), 모터, ESC, 콘덴서 뱅크.
- 비디오(옆면과 위에서). 이륙 때 최고 높이를 눈금으로 읽습니다(이륙 초과 확인).

처음 한 번(설치 때):
- 전선 왕복 저항(2절 3번), 전원 장치 전류 제한 동작(가능하면 저항 부하로).
- XT90-S 접촉 저항, 실제 전선 무게(g/m).

## 9. 알려진 한계 (시뮬레이션에서 확인)

- **짧은 전선에서 전원 장치 전류 제한**: 기체가 모릅니다 → 2절 2번 규칙으로 막습니다.
- **이륙 초과**: 4.1절. 수정 라운드에서 줄였지만 최대값은 아직 약 1.3 m입니다.
- **요(yaw) 회전 비상정지(I3)**: 유선 호버 중에도 가끔 생겼습니다(EVAL 유선 40회 중 8회). 원인은 제어 쪽입니다.
- **(v0.9 수정 라운드) 지면 효과**: 배기면이 바로 닿는 면이라서, 딱딱한 바닥 위 몇 cm에서 기체가 떠 있을 수 있습니다.
  착지 직전에 추력을 조금 빼는 기능을 넣었습니다(시뮬레이션: 떠 있는 채 착지 판정 37/99 → 0/99, 가정한 지면 효과 모델).
  근본 대책은 **착지 다리**(배기면이 바닥에서 45 mm 이상 떨어지게)입니다 — CAD 요청.
- **(수정 라운드) 밀기**: 배터리 기체도 0.3초 밀기는 약 **3 N 이하**만 안전합니다(5 N 이상은 7번 중 5–7번 비상정지, 독립 검토).
  유선 기체는 3 N(0.40 m)에서도 비상정지했습니다 → **유선·하이브리드 비행에서는 밀지 않습니다.**
- **(수정 라운드) 전선 걸림(snag)**: 꼭대기 고정점에 옆으로 10 N이 걸리면 회전력이 베인 힘의 약 9배입니다. 제어로 막을 수 없습니다.
  전선과 안전줄을 무게중심 높이의 브라이들(고리)로 잡거나, 옆 힘 3 N 이하에서 끊어지는 연결을 씁니다 — 설계 결정 필요.
- **(수정 라운드) 잔류 회전(swirl) 방향**: 방향이 로터와 반대이면 비상정지가 더 많습니다(시뮬레이션). 벤치에서 방향과 크기를 잽니다.
  하이브리드 시연 밀기에서는 거의 모두 비상정지했습니다 → **시연 중 밀기는 하지 않습니다**.
- 하이브리드에서 전선이 끊길 때 버스 전압이 23.3 → 21.7 V로 떨어지면 팬 속도가 변해 요 회전을 일으킬 수 있습니다.
- 지상국에는 지금 버스 전압과 경고만 보입니다. 버퍼 전압과 전원 상태 비트는 다음 펌웨어 라운드(TELEM v4/v5) 뒤에 보입니다.
- 모든 문턱값은 **(가정)** 입니다. 벤치 시험 결과로 다시 정합니다.
