Yuchan-00/CanSat_EDF_Rocket/docs/유선전원_검토.md

# 유선 전원 검토 (시험·시연용) — v0.9

작성 2026-10-27. 사용자 요청: "테스트, 시연용 유선 전원". 대회 비행은 지금처럼 배터리로 합니다(규정이 허용하지 않는 한).

이 문서는 **제안**입니다. `params.json`과 `cad/`는 바꾸지 않았습니다. CAD·시뮬레이션·펌웨어 작업에서 기계가 읽는 제안서 `docs/tether_power_proposal.json`을 반영합니다.
숫자는 모두 계산 스크립트로 만들었습니다(19절). "가정값"은 실물로 재기 전까지 믿으면 안 되는 값입니다.

---

> **수정 라운드 메모 (2026-10-28).** 이 검토의 표는 예상 질량(1,650 / 1,402 / 1,523 g)으로 계산했습니다. CAD 질량은 이제
> 1,647.2 / 1,399.3 / 1,520.3 g입니다(결론은 같음). 전원 장치 1대의 T/W 한계(P1 1.37-1.52, P2 0.99-1.52)와 하이브리드 조건
> ("호버는 전선이 혼자 감당한다"는 P1 팬일 때만, P2 2.0 kgf면 버퍼가 25 A를 내고 약 73초)은 `v0.9_하드웨어_변경.md` 5장과
> `sizing/sizing_report_vtol_tether.md` / `_hybrid.md`에 CAD 질량으로 다시 냈습니다. 기체 쪽 유선 부품은 이제 CAD 상자로 있고,
> 전선 구멍은 180°, 아이볼트 아래에 D32 × 2 mm 알루미늄 와셔가 들어갑니다(수정 라운드).

## 0. 결론 먼저

1. **다음 추력 시험은 비행용 LiPo로 합니다.** 22 V / 10 A(220 W) 전원은 최대 출력 2,264 W의 10 % 정도였습니다. 1.5 kW 전원(60 A)으로도 최대 스로틀(판매처 대용 표 102–124 A)에 못 갑니다.
2. **유선 비행은 높이 3 m 이하(권장 2 m 이하)에서만 합니다.** 10 m 비행은 들어 올리는 전선 무게만 0.6–1.5 kg입니다. 배터리(349 g)의 2–4배라 불가능합니다.
3. **전선은 기체 맨 위 중심(축 위)에서 위로 빠져서, 머리 위 도르래(갠트리)로 갑니다.** 아래로 빼면 배기 제트 속을 지나고, 옆으로 늘어지면 흡입창에 빨려 들어갑니다.
4. **시험 비행:** 배터리를 뺀 유선 기체 + 안전줄(사람이 잡고 늘어짐 0.3 m 이하). 전원은 처음에 지상에 둔 LiPo 2개(전원 장치 구입 없이), 나중에 Mean Well RSP-1500-24.
5. **공개 시연:** 하이브리드(유선 + 기체 안 작은 6S 650 mAh 비상 배터리 + 이상적 다이오드 2개). 전선이 끊기거나 전원이 꺼져도 비상 배터리로 착륙합니다.
6. **전원 장치는 추력 시험 뒤에 삽니다.** 팬 효율이 판매처 표만큼이면 1.5 kW 전원 1대로 T/W 1.52(기체 1.40 kg)입니다. 팬이 약하면(최대 2.0 kgf인데 전력은 표만큼 먹는 경우) 같은 전원으로 T/W 0.99, 뜨지 못합니다.
7. **회생 전류 위험:** ESC가 감속할 때 전기를 전원 쪽으로 되돌리면, 전원 장치는 받지 못해 전압이 치솟습니다. 회전 에너지 약 117 J의 2 %만 4 mF 콘덴서에 들어가도 42 V입니다(가정값). 기체에 버스 클램프(브레이크 초퍼)를 넣고, 추력 시험에서 회생 여부를 잽니다.
8. **법규:** VTOL 경량 구성(유선 포함)은 2 kg 이하라 기체 신고가 필요 없고 조종자 증명은 4종(온라인 교육)으로 판단됩니다. "계류식" 예외는 신고에만 확인됐고 조종자 증명에는 예외가 없습니다. 사방과 천장이 막힌 실내는 비행승인이 필요 없습니다(국토부 FAQ). 전원선 기체가 법적으로 "계류식"인지는 불확실합니다(13절).

---

## 1. 전제와 불확실성

### 1.1 질량 구성

| 구성 | 질량 | 내용 |
|---|---|---|
| 로켓(현재 v0.8 크기 산정) | 2,674 g | CanSat·낙하산·페이로드 포함 |
| VTOL 경량(배터리) | 1,500 / **1,650** / 1,800 g | v0.9 과제의 범위. 1,650 g을 기준으로 씁니다. 실제 값은 질량 모델 작업이 정합니다 |
| 유선, 배터리 없음 | VTOL − 349 g + 101 g = **1,402 g** (1,252–1,552) | 기체 쪽 부품 101 g(가정값): XT90-S 7, 10 AWG 전원선 0.25 m 쌍 34, ESC 콘덴서 25, 버스 클램프 20, 고정점·전선 부트 15 |
| 유선 하이브리드 | 위 + 121 g = **1,523 g** (1,373–1,673) | 이상적 다이오드 보드 15 g, 배선 6 g, 6S 650 mAh 120C 100 g(GNB 판매 정보) |

### 1.2 추력 모델 (추력은 모름 — 사용자 결정 4)

* 전기 입력 전력 P는 추력 T의 1.5제곱에 비례합니다(운동량 이론). 기준점은 대용 표(Powerfun 90 mm 6S) 30.30 N에서 2,264 W입니다. 크기 산정 보고서의 호버 1,822 W(26.2 N)를 같은 식으로 다시 얻었습니다. 대용 표의 두 점(30.3 N / 2,264 W, 37.2 N / 3,125 W)으로 구한 지수는 1.58입니다.
* 실제 최대 추력 T_max를 모르므로 두 경우로 위아래를 잡습니다.
  * **P1 (대용 효율):** 팬이 대용 표만큼 효율적. 같은 추력에 같은 전력.
  * **P2 (대용 전력, 비관):** 최대 스로틀에서 2,264 W를 먹지만 추력은 T_max만 냄. T_max가 작을수록 같은 추력에 전력이 더 듭니다.
  * T_max = 3.09 kgf면 둘이 같습니다.
* 추력 ∝ 스로틀², 전력 ∝ 스로틀³, 최대 추력 ∝ 전압²(`params.json` `edf.throttle_exponent` 2).

### 1.3 사용자 관찰(22 V / 10 A, 회전수 약 40 %, EDF가 자기 무게만 듦)

* P1이면 220 W에서 0.65 kgf입니다.
* "자기 무게만"이 0.37 kgf(EDF 369 g)라면, 같은 1.5제곱 법칙으로 2,264 W에서 1.75 kgf입니다. 0.5 kgf라면 2.37 kgf입니다.
* 즉 관찰은 1.75 kgf부터 대용 표 3.09 kgf까지 모두와 맞습니다. 전원이 전류 제한에 걸려 실제 전압·전력을 모르므로 **하한일 뿐**입니다. 그래서 아래 표에 2.0 kgf를 넣었습니다.

---

## 2. 필요한 전력

기준 기체 1,650 g 계열. 전류는 ESC 전압 23 V로 나눈 값입니다(참고).

| 구성 | 무게 | 호버 P1 | T/W 1.3 순간 P1 | 호버 P2 (T_max 2.0 kgf) |
|---|---|---|---|---|
| 로켓 (현재) | 2.674 kgf | 1,822 W | 2,701 W (22.2 V 최대 출력 2,264 W 넘음) | 호버 불가 |
| VTOL 배터리 | 1.650 kgf | 883 W (38 A) | 1,309 W (57 A) | 1,697 W (74 A) |
| 유선, 배터리 없음 (머리 위 급전) | 1.402 kgf | **692 W (30 A)** | **1,026 W (45 A)** | 1,329 W (58 A) |
| 유선, 전선 12 AWG 1.5 m가 매달림 | 1.555 kgf | 808 W (35 A) | 1,198 W (52 A) | 1,552 W (67 A) |
| 유선 하이브리드 (머리 위 급전) | 1.523 kgf | 783 W (34 A) | 1,161 W (50 A) | 1,505 W (65 A) |

* 과제에서 예상한 40–60 A가 맞습니다(P1). 팬이 약하면 60–75 A입니다.
* 머리 위 급전은 갠트리가 전선 무게를 받으므로 기체가 드는 전선 무게를 0으로 봤습니다(10절의 작은 장력은 따로).

---

## 3. 추력별 T/W와 호버 스로틀 (22.2 V 기준)

호버 스로틀 u = √(무게 / T_max). 목표 T/W ≥ 1.3.

| 구성 | 무게 kgf | 2.0 kgf | 2.3 kgf | 2.6 kgf | 3.09 kgf |
|---|---|---|---|---|---|
| 로켓 (현재) | 2.674 | 0.75 / 불가 | 0.86 / 불가 | 0.97 / 불가 | 1.16 / 0.93 |
| VTOL 배터리 1,500 g | 1.500 | 1.33 / 0.87 | 1.53 / 0.81 | 1.73 / 0.76 | 2.06 / 0.70 |
| VTOL 배터리 1,650 g | 1.650 | 1.21 / 0.91 | 1.39 / 0.85 | 1.58 / 0.80 | 1.87 / 0.73 |
| VTOL 배터리 1,800 g | 1.800 | 1.11 / 0.95 | 1.28 / 0.89 | 1.44 / 0.83 | 1.72 / 0.76 |
| 유선 무배터리 (머리 위) | 1.402 | 1.43 / 0.84 | 1.64 / 0.78 | 1.85 / 0.73 | 2.20 / 0.67 |
| 유선 무배터리, 12 AWG 1.5 m 매달림 | 1.555 | 1.29 / 0.88 | 1.48 / 0.82 | 1.67 / 0.77 | 1.99 / 0.71 |
| 유선 무배터리, 12 AWG 3 m 매달림 | 1.708 | 1.17 / 0.92 | 1.35 / 0.86 | 1.52 / 0.81 | 1.81 / 0.74 |
| 하이브리드 (머리 위) | 1.523 | 1.31 / 0.87 | 1.51 / 0.81 | 1.71 / 0.77 | 2.03 / 0.70 |
| 하이브리드, 12 AWG 1.5 m 매달림 | 1.676 | 1.19 / 0.92 | 1.37 / 0.85 | 1.55 / 0.80 | 1.84 / 0.74 |

칸 = T/W / 호버 스로틀. 1,500 g·1,800 g 기체의 유선 값은 `tether_calc_out.json` `thrust_table`에 있습니다.

**전원 장치가 한계일 때 (배터리 없음):** 위 표는 전원이 충분할 때입니다. RSP-1500-24 1대(25.2 V에서 정격 60 A)와 권장 전선(10 AWG 8.5 m)이면 ESC에 21.7 V, 1,301 W가 들어갑니다. 그때 낼 수 있는 추력으로 다시 계산한 T/W입니다(P1 / P2).

| 기체 | 2.0 kgf | 2.3 kgf | 2.6 kgf | 3.09 kgf |
|---|---|---|---|---|
| 1,252 g | 1.52 / 1.10 | 1.71 / 1.27 | 1.71 / 1.44 | 1.71 / 1.71 |
| **1,402 g** | 1.36 / **0.99** | 1.52 / 1.13 | 1.52 / 1.28 | 1.52 / 1.52 |
| 1,552 g | 1.23 / 0.89 | 1.38 / 1.02 | 1.38 / 1.16 | 1.38 / 1.38 |

→ 팬이 대용 표만큼이면 전원 1대로 충분합니다. 팬이 약하면 부족하고, 2.0 kgf면 1,402 g 기체가 뜨지 못합니다. **추력 시험이 먼저입니다.**

---

## 4. 전선 (2가닥) — 굵기·길이별

### 4.1 전선 성질

판매 정보: 0.08 mm 주석 도금 가닥, 10 AWG 1,050가닥 OD 5.5 mm, 12 AWG 680가닥 OD 4.5 mm, 14 AWG 400가닥 OD 3.5 mm. 저항·무게는 그 가닥 수로 계산했습니다(실리콘 밀도 1.20 g/cm³ 가정). 사 온 전선을 꼭 달아 보세요.

| 전선 | 단면적 | 저항 (20 °C, 1가닥) | 무게 (1가닥) | 2가닥 + 강도줄 |
|---|---|---|---|---|
| 10 AWG | 5.28 mm² | 3.38 mΩ/m | 68.2 g/m | 139.5 g/m |
| 12 AWG (OD 4.5) | 3.42 mm² | 5.22 mΩ/m | 44.8 g/m | 92.6 g/m |
| 12 AWG (OD 3.6, 사용자 모터선 가정) | 3.42 mm² | 5.22 mΩ/m | 38.0 g/m | 78.9 g/m |
| 14 AWG | 2.01 mm² | 8.88 mΩ/m | 26.7 g/m | 56.4 g/m |

### 4.2 기체가 들어 올리는 전선 무게 (아래나 옆으로 매달릴 때)

수직 구간 × 1.10(늘어짐, 가정값).

| 전선 | 1.5 m (시연 호버) | 3 m (시연 최대) | 10 m (필드) |
|---|---|---|---|
| 10 AWG | 230 g | 460 g | 1,535 g |
| 12 AWG (OD 4.5) | 153 g | 306 g | 1,019 g |
| 12 AWG (OD 3.6) | 130 g | 260 g | 868 g |
| 14 AWG | 93 g | 186 g | 620 g |

* 10 m 유선 비행은 안 됩니다. 14 AWG도 620 g이고, 10 m 14 AWG는 호버만 해도 ESC 전압이 16.4 V로 떨어집니다(4.3절).
* 머리 위 급전(9절)으로 하면 이 무게를 갠트리가 받습니다. 그래서 굵은 10 AWG를 쓸 수 있습니다.

### 4.3 전압 강하·손실 (전원 25.2 V, 기준 기체 1,555 g)

호버 808 W, T/W 1.3 순간 1,198 W (P1). 고리 저항 = 2가닥 × 길이 + 커넥터 1 mΩ(가정값).

| 전선 | 길이 | 고리 저항 | 호버: 전류 / ESC 전압 / 손실 | T/W 1.3: 전류 / ESC 전압 / 손실 |
|---|---|---|---|---|
| 10 AWG | 3 m | 21.3 mΩ | 33.0 A / 24.50 V / 23 W | 49.6 A / 24.14 V / 52 W |
| 10 AWG | 5 m | 34.8 mΩ | 33.6 A / 24.03 V / 39 W | 51.2 A / 23.42 V / 91 W |
| 10 AWG | 10 m | 68.6 mΩ | 35.5 A / 22.76 V / 87 W | 56.1 A / 21.35 V / 216 W |
| 12 AWG | 3 m | 32.3 mΩ | 33.5 A / 24.12 V / 36 W | 50.9 A / 23.56 V / 84 W |
| 12 AWG | 5 m | 53.2 mΩ | 34.6 A / 23.36 V / 64 W | 53.6 A / 22.35 V / 153 W |
| 12 AWG | 10 m | 105.4 mΩ | 38.2 A / 21.18 V / 154 W | 65.5 A / 18.30 V / 452 W |
| 14 AWG | 3 m | 54.3 mΩ | 34.7 A / 23.32 V / 65 W | 53.8 A / 22.28 V / 157 W |
| 14 AWG | 5 m | 89.8 mΩ | 36.9 A / 21.88 V / 122 W | 60.6 A / 19.76 V / 330 W |
| 14 AWG | 10 m | 178.6 mΩ | 49.3 A / 16.40 V / 434 W | 전달 불가 |

24 V로 설정한 경우도 계산했습니다(`tether_calc_out.json` `electrical`). 모두 0.6–1.3 V 더 낮습니다.

### 4.4 전선 발열 (1가닥, 조용한 공기 10 W/m²K 가정)

| 전선 | 40 A | 50 A | 60 A |
|---|---|---|---|
| 10 AWG | +7 K (60 s), +12 K (120 s), 정상상태 +36 K | +11 / +20 / +61 K | +16 / +29 / +97 K |
| 12 AWG | +16 / +28 / +77 K | +25 / +46 / +145 K | +37 / +69 / +279 K |
| 14 AWG | +45 / +83 / +262 K | +75 / +144 / +977 K | +115 / +236 K / 폭주 |

* 60 s 비행에는 12 AWG도 견딥니다(실리콘 200 °C 등급). 짐벌 시험처럼 몇 분 돌리려면 10 AWG를 씁니다.
* 감은 채(릴)로 쓰지 않습니다. 감긴 전선은 식지 못합니다.

### 4.5 권장 전선 경로 (머리 위 급전)

바닥 0.5 m + 기둥 3.5 m + 붐 1.5 m + 내려오는 부분 최대 3.0 m = **8.5 m, 10 AWG 2가닥**, 고리 저항 58.5 mΩ.

| 기체 | 호버 | T/W 1.3 | 호버 P2 (2.3 kgf) |
|---|---|---|---|
| 무배터리 1,402 g | 692 W, 29.5 A, ESC 23.48 V, 손실 51 W | 1,026 W, 45.5 A, 22.54 V, 121 W | 1,077 W, 48.1 A, 22.38 V |
| 하이브리드 1,523 g | 783 W, 33.7 A, 23.23 V, 67 W | 1,161 W, 52.5 A, 22.13 V, 161 W | 1,220 W, 55.6 A, 21.95 V |

같은 경로를 12 AWG로 하면 89.8 mΩ, T/W 1.3 순간에 20.8 V까지 떨어집니다. 권하지 않습니다.
ESC 전압 22–23.5 V는 반쯤 쓴 6S 배터리(22.2 V)와 비슷한 수준입니다.

---

## 5. 전원 방식 비교

### 5.1 (a) 지상 저전압 전원 (24–25 V, 40–70 A)

| 방식 | 정격 | 과부하 동작 | 무게·가격 | 판단 |
|---|---|---|---|---|
| **Mean Well RSP-1500-24** | 24 V 63 A 1,512 W, 조정 20–26.4 V, 원격 감지 0.3 V, 원격 ON/OFF, 전류 분담 최대 6,000 W(3+1대) | 정격 전력의 105–135 %에서 정전류, **5초 뒤 출력 차단**, 전원을 다시 켜야 복구. 과전압 차단 27.6–32.4 V | 3.0 kg, 632,265원 (element14 한국, 1개) | 권장. 정전류 5초 구간이 있어 버틸 시간이 있음 |
| Mean Well SE-1500-24 | 24 V 62.5 A 1,500 W, 조정 21.6–26.4 V, 입력 180–264 VAC | 105–125 %에서 **출력 차단**(정전류 구간 언급 없음), 다시 켜야 복구 | 3.3 kg, USD 199.95 (Jameco) ≈ 268,073원 + 배송·통관(가정 +20 %) | 하이브리드에서만. 무배터리에서는 순간 과부하 한 번에 추락 |
| RSP-1500-24 2대 병렬 | 120 A | 같음 | 1,264,530원 | 전선 강하가 커서 이득이 작음: 12 AWG 5 m에서 120 A면 ESC 18.8 V. 10 AWG ≤ 3 m일 때만 의미 |
| 서버 전원 직렬(예: 12 V 100 A급 2대) | 24 V 100 A | 기종별 차단 | 중고가 싸다고 알려짐(가격 미조사) | 첫 제작에는 비권장. 노출된 교류 기판, 한 대의 출력 접지를 띄우는 개조가 위험 |
| **지상 LiPo 묶음 ("유선 배터리")** | 6S, 사실상 전류 제한 없음 | 없음(퓨즈 필수) | 사용자 6S 2200 2개(2번째 40,207원), 또는 CNHL 6S 4000 70C 2개 163,538원 | 처음 유선 시험에 권장. 교류 전원 불필요(야외 가능), 회생 전류를 받아 줌 |

지상 LiPo 묶음 사용 시간(무배터리 기체, 호버, 80 %까지):

| 묶음 | P1 (31.5 A) | P2 2.3 kgf (49 A) |
|---|---|---|
| 6S 2200 1개 | 3.4분 | 2.2분 |
| 6S 2200 2개 병렬 | 6.7분 | 4.3분 |
| CNHL 6S 4000 2개 병렬 | 12.2분 | 7.8분 |

지상 LiPo 주의: 전선이 끊기면 지상 쪽 끝이 단락될 수 있습니다. 배터리 출구에 100 A 퓨즈(가정값)와 차단 스위치를 넣고, LiPo 안전 백에 둡니다. 전압이 25.2 V에서 22 V로 내려가므로 아래 하이브리드의 "크로스오버" 설계와는 잘 맞지 않습니다(무배터리 기체용).

### 5.2 (b) 고전압 전선 + 기체 안 DC-DC — 이 기체에는 맞지 않음

* 상용 계류 드론은 400–800 V 전선과 기체 안 변환기를 씁니다. Vicor 자료: 1.8 kW 변환 모듈 41 g, 98 %, 5 kW 시스템 변환기 합 222 g.
* 이 기체용(384 V → 24 V) Vicor BCM4414VD1E2663C02는 DigiKey에서 USD 950.09(약 127만 원)입니다. 여기에 고전압 지상 전원(가격 미조사), 방열판, 필터가 더 듭니다.
* 기체 쪽 무게(가정값): 3 m에서 약 179 g, 10 m에서 약 290 g. 배터리 349 g보다 크게 가볍지 않습니다. 이득은 수십 m 이상, 오래 떠 있을 때만 납니다.
* 수백 V 직류는 감전 시 치명적입니다. 학생 시험·공개 시연에 맞지 않습니다.

### 5.3 (c) 하이브리드: 유선 + 작은 기체 배터리

전선이 끊겨도 착륙할 전기를 기체가 가지고 있습니다. 6절에서 안전하게 병렬하는 방법을 정리했습니다.

---

## 6. 하이브리드를 안전하게 병렬하는 방법

### 6.1 배터리를 그냥 버스에 붙이면 안 되는 이유

전원 25.2 V, 비상 배터리 22.8 V, 전선 59 mΩ이면, 기체가 놀 때 전선이 비상 배터리를 (25.2 − 22.8) / 0.059 ≈ **40 A로 충전**합니다. 650 mAh에는 60 C 충전입니다. 불이 날 수 있습니다.
수동 병렬로는 "호버 30 A는 전선이 대고, 놀 때 충전은 1 A 이하"를 동시에 만들 수 없습니다.

### 6.2 권장 회로: 다이오드-OR (방전 전용 비상 배터리)

```
지상 전원 25.2 V ──[ 전선 ]── XT90-S ──[D1 이상적 다이오드]──┬── ESC 버스 (콘덴서 4 mF + 클램프)
                                                         │
                   6S 650 mAh (3.80 V/셀 보관) ──[D2 이상적 다이오드, FET 2개 직렬]──┘
```

* **D1 (전선 쪽):** 기체 버스가 전선으로 역류하지 않게 막습니다. 전선이 끊기거나 지상에서 단락돼도 비상 배터리가 전선으로 흘러 나가지 않습니다.
* **D2 (배터리 쪽):** 전원이 비상 배터리를 충전하지 못하게 막습니다. 방전만 합니다. FET 2개를 직렬로 넣어 한 개가 단락 고장 나도 충전 경로가 열리지 않게 합니다.
* 부품: TI LM74700-Q1(3.2–65 V, 순방향 20 mV 조정, 역전류 차단 0.75 µs 이내) + 60 V MOSFET. 60 A급 완성 모듈은 찾지 못했습니다(Pololu 이상적 다이오드는 최대 25 A). 보드를 직접 만듭니다(약 15 g, 가정값).
* 비상 배터리는 지상 충전기의 **보관 모드(3.80 V/셀 = 22.8 V)** 로 맞춰 둡니다. 기체에서는 충전하지 않습니다.

### 6.3 왜 전원을 25.2 V로 맞추나 ("전원 = 배터리 만충 전압")

* 6S 만충 전압이 25.2 V입니다. D2가 고장 나서 충전 경로가 생겨도, 배터리가 과전압(4.2 V/셀 초과)까지 가지는 않습니다.
* 그래도 고장 시 충전 **전류**는 큽니다. 그래서 펌웨어가 비상 배터리 전압이 3.95 V/셀 넘게 오르는지 감시하고(10절 W_D2), 지상에서 전원을 끕니다.
* ESC는 6S용입니다. 25.2 V면 정격 안입니다. 26.4 V까지 올릴 수 있지만(RSP 조정 범위) ESC 정격 밖이고 RSP 과전압 차단(최소 27.6 V)과 여유가 줄어 권하지 않습니다.

### 6.4 크로스오버 전류 — 누가 언제 전기를 대나

전선이 혼자 대는 최대 전류 I_x = (전원 전압 − 비상 배터리 전압) / 고리 저항. I_x보다 많이 쓰면 비상 배터리가 나눠 댑니다.
**규칙:** 1.2 × 실측 호버 전류 ≤ I_x ≤ 0.9 × 전원 정격 전류.

권장 경로(10 AWG 8.5 m, D1 포함 59.5 mΩ)에서:

| 비상 배터리 보관 전압 | 3.75 V/셀 | **3.80 V/셀** | 3.85 V/셀 | 3.90 V/셀 |
|---|---|---|---|---|
| I_x | 45.4 A | **40.3 A** | 35.3 A | 30.3 A |

* 3.80 V/셀이면 I_x 40 A. 호버 33.7 A(P1)는 전선이 혼자 대고, T/W 1.3 순간(52.5 A)은 비상 배터리가 약 12 A를 보탭니다. 전원은 60 A 정격 아래에 머물러 5초 차단에 가지 않습니다.
* 팬이 약해서(P2 2.3 kgf) 호버가 55.6 A면 비상 배터리가 호버 중에 줄어듭니다. 펌웨어가 비상 배터리 전압을 보고 착륙합니다(안전 쪽). 추력 시험 뒤 보관 전압이나 경로를 다시 정합니다.

### 6.5 돌입 전류와 역류

* **돌입:** 4 mF 콘덴서를 25 V에 바로 연결하면 불꽃이 큽니다. 전선 쪽과 비상 배터리 쪽 모두 XT90-S(불꽃 방지형)를 씁니다. 전원은 연결 후 켜거나 원격 ON/OFF로 켭니다.
* **역류(back-feed):** D1이 기체 → 전선 방향을 막습니다. 무배터리 기체는 D1을 생략할 수 있습니다(단순화). 그때 전선이 끊기면 기체 콘덴서만 방전됩니다(해 없음).

### 6.6 비상 배터리 크기

전선이 끊긴 뒤 착륙 시간 = (높이 − 플레어 높이)/하강 속도 + 플레어 높이/접지 속도 + 1 s.

| 상황 | 착륙 시간 | P1: 전류 / 사용량 | P2 2.0 kgf: 전류 / 사용량 |
|---|---|---|---|
| 시연 1.5 m | 5.2 s | 36 A / 0.052 Ah (650의 8 %) | 70 A / 0.100 Ah (15 %) |
| 시연 3 m | 8.9 s | 36 A / 0.090 Ah (14 %, 56 C) | 70 A / 0.173 Ah (27 %, 108 C) |
| (참고) 10 m | 19.3 s | 36 A / 0.196 Ah (30 %) | 70 A / 0.376 Ah (58 %) |

* 650 mAh로 에너지는 충분합니다. 팬이 약한 경우 C 수(100 C 이상)가 부담이니 6S 1100 mAh 100C(CNHL, 211 g)로 바꿉니다.
* GNB 6S 650 mAh 120C는 HV(셀당 4.35 V) 팩이고 XT30 단자입니다. XT60으로 바꿉니다.

---

## 7. ESC 보호 (긴 전선)

* **콘덴서:** 전선이 길면 인덕턴스 때문에 ESC 입력 리플이 커집니다. Castle의 CapPack 설명: 늘린 전선 8–12인치분 리플을 상쇄하고, 리플 피크는 팩 전압의 10 % 미만이어야 하며, 콘덴서는 ESC에 최대한 가깝게. 커뮤니티 경험칙은 10 cm 늘릴 때마다 220 µF입니다(공식 값 아님).
* 이 경험칙을 8.5 m에 그대로 쓰면 18,700 µF로 너무 무겁습니다. 대신 ESC 입력에 **저 ESR 1000 µF 35 V(또는 50 V) 4개(4 mF, 약 25 g)** 를 50 mm 안에 붙이고, 측정으로 확인합니다(리플 < 10 %, 60 s 뒤 콘덴서 온도).
* **LC 감쇠(가정값 0.6 µH/m):** 8.5 m 전선 + 4 mF → 공진 1.1 kHz, 감쇠비 0.82, 50 A 계단 변화 때 약 1.8 V 출렁임. ESC 자체 콘덴서만(0.88 mF 가정)이면 감쇠비 0.38, 3.8 V. 전선 저항이 공진을 눌러 줍니다.
* **회생 전류(가장 큰 위험):** 배터리는 되돌아오는 전기를 받아 주지만 전원 장치와 D1이 막은 버스는 못 받습니다. 팬·로터 회전 에너지 약 117 J(관성 4.5×10⁻⁵ kg·m² 가정)의 2 %만 들어와도 0.88 mF면 77 V, 4 mF면 42 V입니다. ESC가 타고, RSP는 과전압으로 꺼집니다.
  * **버스 클램프(브레이크 초퍼)**: 26.6 V에서 켜지고 26.0 V에서 꺼지는 비교기 + MOSFET + 1–2 Ω 50 W 알루미늄 저항(약 20 g, 값은 가정). RSP 과전압 차단 최소 27.6 V보다 낮게 둡니다. 마지막 보호로 26 V 대기 전압 TVS.
  * 유선 빌드는 스로틀을 천천히 내리게 합니다(초당 −2.0 이하, 가정값). KILL·ABORT는 지금처럼 즉시 끕니다(모터가 그냥 공회전으로 멈춤).
  * Hobbywing SkyWalker 100A V2가 감속 때 회생하는지는 모릅니다. 추력 시험에서 잽니다(15절).

---

## 8. 커넥터·스트레인 릴리프·빠른 분리

* **커넥터:** XT90-S(불꽃 방지, 90 A 연속급, 수 7 g / 암 6 g). 살아 있는 쪽(전선 끝)이 암(접점이 가려진 쪽)입니다. 지상 전원 쪽에도 XT90 하나 더.
* **힘은 강도줄이 받습니다.** 전선 옆에 Dyneema 2 mm 강도줄을 0.3 m마다 묶습니다. 기체 쪽은 축 위 고정점(아이볼트)에 묶고, 전선은 그 옆 클램프를 지나 100 mm 여유 고리를 두고 XT90-S에 갑니다. 커넥터와 납땜에는 힘이 가지 않습니다.
* **충격 완화줄(필수):** 강도줄 기체 쪽 0.3–0.5 m를 번지(고무줄)로 합니다. 늘어짐 0.1–0.3 m에서 떨어지는 하이브리드(1,523 g)를 잡을 때 최대 힘이 번지 있으면 60–90 N(무게의 4–6배), Dyneema만 있으면 498–851 N(33–57배)입니다(번지 600 N/m 가정). 기체 고정점이 부서집니다.
* **빠른 분리:** 머리 위 급전에서는 강도줄이 안전줄이므로 기체 쪽에 "끊어지는 고리"를 두지 않습니다. 걸림·밟힘에 대비해 지상 쪽 전선을 모래주머니로 눌러 두고, 지상 쪽 XT90을 손으로 바로 뽑을 수 있게 둡니다. 비상 정지는 RSP 원격 ON/OFF에 연결한 버섯 버튼입니다.

---

## 9. 전선이 기체를 떠나는 위치

| 위치 | 수치 | 판단 |
|---|---|---|
| 아래(배기 쪽, 축) | 배기 제트 한가운데 (호버 배기 속도 약 51 m/s) | 불가 |
| 핀 끝(반지름 123 mm)에서 아래로 | 노즐 아래 0.2 m에서는 그 반지름의 유속 0.6 m/s이지만 0.5 m 8.4 m/s, 1.0 m 12.4 m/s, 1.5 m 11.5 m/s (원형 제트 근사, 가정값). 전선(지름 9 mm)에 0.5–1.0 N/m 항력, 펄럭임, 바닥의 방사형 바람. 모멘트 약 0.38 N·m | 비권장 |
| 옆, 흡입창 근처 | 흡입창 면 유속 8.3 m/s. 창 하나를 반구 흡입으로 보면 5 cm에서 4.1 m/s, 10 cm 1.0 m/s, 20 cm 0.26 m/s, 30 cm 0.11 m/s | 창에서 20 cm 안으로 오면 빨려 들어감. 절대 금지 |
| **위, 축 위 (권장)** | 흡입창 윗끝 Z 326.9, 위쪽 출구 Z 약 533 이상 → 수직으로 206 mm 이상 떨어짐(지금 높이 기준, v0.9 단축 동체에서 다시 확인). 수평력 1 N × 0.3 rad × 레버 0.25 m ≈ 0.075 N·m | 권장. 갠트리가 전선 무게를 받음 |

조건: 전선이 느슨해져도 옆으로 흘러내리면 안 됩니다. 기체 위에 100 mm 이상 단단한 전선 부트(스프링 가드)를 달아 전선이 축에서 15° 안으로 위로 나가게 하고, 줄 잡는 사람이 늘 약하게 당겨 둡니다.

**갠트리:** 3.5–4 m 조명 스탠드 2개 + 가로대(또는 붐 스탠드), 도르래나 매끈한 고리를 가장 높은 시험 고도의 기체 윗면보다 1.0 m 이상 위에. 유선 비행 고도는 최대 2.0 m로 두면 3.5–4 m 스탠드로 됩니다. 실내에서 GPS가 없을 때 옆으로 흐르는 것도 이 줄이 막아 줍니다.

---

## 10. 외란 (위치 유지·시뮬레이션 모델)

시뮬레이션에 넣을 모델(`tether_power_proposal.json` `sim`):

* **장력:** 기체 위 축 위 고정점에서 도르래 방향으로 0.5–2.0 N(사람·스프링 바란서, 2 s 시간상수 무작위, 가정값).
* **옆 복원력:** 장력 × 옆 이동 / 내려온 길이 ≈ 1 N, 2 m에서 0.5 N/m. 약합니다.
* **안전줄:** 늘어짐 0–0.3 m, 팽팽해지면 번지 600 N/m + 감쇠비 0.3(가정값), Dyneema(EA 약 3×10⁵ N, 가정값)와 직렬.
* **사건:** 걸림 20 N 0.2 s, 수직에서 30°; 절단(장력 0, 전력 0).
* **전원:** ESC 전압 = 25.2 V − 전류 × 58.5 mΩ; T_max는 전압²에 비례; 전원 60 A 정격, 105–135 %에서 정전류 후 5 s 뒤 차단(RSP), SE는 105–125 %에서 차단; 비상 배터리 OCV(SOC), 내부저항 0.03 Ω(가정), D2로 방전만; 버스 클램프 26.6 V.
* 야외 바람 3 m/s일 때 내려온 전선 3 m의 항력은 약 0.2 N(지름 11 mm, Cd 1.2). 작습니다.

새 시나리오 W1–W6(호버+밀기, 절단 하이브리드/무배터리, 전원 전류 제한, 걸림, 전선–흡입창 거리 ≥ 0.2 m)은 JSON에 판정 기준과 함께 적었습니다.

---

## 11. 고장 모드와 안전한 결과

### 11.1 떨어질 때 에너지 (1,650 g 계열)

| 기체 | 1.5 m | 3 m |
|---|---|---|
| 무배터리 1,402 g | 20.6 J, 5.4 m/s | 41.2 J, 7.7 m/s |
| 하이브리드 1,523 g | 22.4 J | 44.8 J |
| VTOL 배터리 1,650 g | 24.3 J | 48.5 J |

비교: 미국 FAA의 사람 위 비행 2등급 한계는 11 ft-lb(14.9 J)입니다(한국 규정 아님, "다칠 수 있음"의 기준으로만). 이 기체의 낙하산 착지 에너지는 37 J입니다(크기 산정). 1.5 m에서 떨어져도 사람이 다칠 수 있는 에너지입니다.

### 11.2 고장별 결과

| 고장 | 무배터리 + 안전줄 | 무배터리, 안전줄 없음 | 하이브리드 |
|---|---|---|---|
| 전선 절단·커넥터 빠짐 | 모터 즉시 정지, 0.3 m 이내에서 줄이 잡음(60–90 N) | 추락 (20–41 J) | W_LOST → 비상 배터리로 착륙 |
| 전원 과부하 차단(RSP 정전류 5 s 뒤, SE는 정전류 구간 없이) | 위와 같음 | 추락 | 비상 배터리가 순간 전류를 대서 차단이 안 일어나게 설계(I_x < 정격). 일어나면 착륙 |
| 전압 강하(전류 제한, 가는 전선) | W_SAG: 스로틀 상한 고정 → 2 s 지속 시 착륙 | 같음(그 전에 차단되면 추락) | 비상 배터리가 나눠 댐 → W_BUF로 착륙 |
| 회생 전압 상승 | 클램프 26.6 V | 같음 | 같음 |
| 비상 배터리 충전 고장(D2 단락) | — | — | W_D2 경보, 착륙, 지상 전원 차단 |
| 전원 비상 정지 버튼 | 줄이 잡음 | 추락 | 착륙 |

**무배터리 기체는 사람이 잡는 안전줄(늘어짐 0.3 m 이하) 없이 띄우지 않습니다.**

### 11.3 펌웨어 규칙 (펌웨어 작업에서 구현)

* 빌드 전원 구분: `battery`(지금) / `wired`(무배터리) / `wired_buffer`(하이브리드). field·demo 프로필과 별개. 이름은 기존 `fcu_bench_tether`(로드셀 고정용)와 헷갈리지 않게 "wired"로 합니다.
* ADC: 지금의 PF0(47k/4.7k, 2.56 V 기준, 최대 28.2 V)이 버스 전압. 새로 전선 전압(D1 앞)과 비상 배터리 전압(D2 앞)을 빈 ADC 핀 두 개에 같은 분압으로(PF4–PF7은 JTAG 핀이라 핀 배치에서 고름).
* **W_ARM:** 대기 중 전선 전압 24.6–25.6 V, 하이브리드는 비상 배터리 3.72–3.92 V/셀. 아니면 ARM 거부.
* **W_LOST (하이브리드):** 비행 중 전선 전압 < 20.0 V(또는 비상 배터리 − 0.5 V)가 40 ms 이상 → 착륙(새 이유 코드 TETHER_LOST), UP 무시, 텔레메트리 표시, 지상국 경보.
* **W_SAG:** 버스 < 21.0 V가 0.3 s 이상 → 스로틀 상한을 지금 값에 고정 + 경고, 2.0 s 지속 → 착륙(RSP는 5 s 뒤 차단).
* **W_BUF:** 비상 배터리 부하 전압 < 3.4 V/셀 → 착륙(ABORT 아님).
* **W_D2:** 유선 중 비상 배터리가 3.95 V/셀 넘게 오름 → 경보, 착륙.
* I8(셀 전압): 배터리 빌드는 그대로, 무배터리는 W_SAG로 대체, 하이브리드는 비상 배터리 전압으로.
* 비행 시간 V2: 유선 빌드 180 s(10 AWG 40–50 A에서 120 s에 +12–20 K, 계산). 모터 온도는 실측 후.
* 스로틀 하강 속도 제한(회생 방지): 초당 −2.0(가정값, 벤치 측정으로 정함).
* 지상국: 세 전압 표시, "TETHER LOST — 착륙 중" 빨간 경고와 소리, 로그 필드.
* `params.json`에 `power.*`가 들어가면 `params_gen.h`는 오래된 상태(STALE)가 됩니다. 예상된 일이고 펌웨어 작업에서 다시 생성합니다.

---

## 12. 시연에서의 장점과 단점

장점
* 물리적인 줄: 기체가 정해진 영역 밖으로 못 나갑니다. 실내에서 GPS 없이 흘러가는 문제를 줄입니다.
* 시간 제한이 사실상 없습니다(배터리 VTOL은 40 s 비행 한도). 관객 앞에서 여유 있게 보여 줄 수 있습니다.
* 배터리 교체·충전 대기가 없습니다. 기체가 248 g(무배터리) / 127 g(하이브리드) 가벼워져 T/W가 오릅니다.
* 안전줄이 낙하를 0.3 m 안에서 잡습니다(사람이 잡을 때).

단점
* 장비: 갠트리, 3 kg 전원, 220 V 콘센트(RSP 교류 8 A / 230 V), 줄 잡는 사람 1명.
* 전선이 느슨해져 기체 옆으로 떨어지면 흡입창에 빨려 들어갈 수 있습니다(부트와 장력으로 막음).
* 무배터리는 전원 고장 = 모터 정지입니다. 그래서 시연은 하이브리드입니다.
* 비용: 하이브리드 + RSP 약 103만 원(14절). 기체 예산(약 30만 원)보다 큽니다.
* EDF 소음이 크고(귀마개), 배기 바람이 바닥 먼지를 날립니다.

---

## 13. 국내 법규

**확인한 것** (2차 출처로 본 조문. 원문 국가법령정보센터 페이지는 이 환경에서 열리지 않았습니다):

* **기체 신고 — 항공안전법 시행령 제24조** (사업용이 아닐 때 신고 불필요): 3호 "계류식(繫留式) 무인비행장치", 5호 "최대이륙중량이 2킬로그램 이하인" 무인동력비행장치.
* **조종자 증명 — 항공안전법 시행규칙 제306조 ① 4호**(2025-01-19 본문): 무인비행장치는 조종자 증명 대상이고, 빠지는 것은 연료 포함 최대이륙중량 250 g 이하 무인동력비행장치와 작은 무인비행선뿐입니다. **계류식 예외는 없습니다.**
* 종류(언론 보도): 4종 250 g 초과–2 kg 이하(교통안전공단 온라인 교육), 3종 2 kg 초과–7 kg 이하(비행 교육 6시간 + 학과시험. 실기 시험 여부는 자료마다 다름).
* **비행승인 — 시행규칙 제308조 ①:** 시행령 제24조 1–4호 장치(계류식 무인비행장치 포함, 사업용 아닐 때)와 최대이륙중량 25 kg 이하 무인동력비행장치를 그 항의 대상에서 뺍니다.
* **실내:** 국토부 드론 FAQ(검색 결과 요약으로 확인): "사방ㆍ천장이 막혀있는 실내 공간에서의 비행은 승인을 필요로 하지 않습니다." 다만 인명·재산에 위험이 없도록 주의해야 한다는 단서가 붙습니다.

**질량이 2 kg 위·아래일 때**

| 구성 | 최대이륙중량 | 기체 신고 | 조종자 증명 |
|---|---|---|---|
| 로켓 (현재) | 2.67 kg | 필요 | 3종 |
| VTOL 경량 (배터리) | 1.5–1.8 kg | 불필요 | 4종 |
| 유선 무배터리 | 1.25–1.55 kg | 불필요 | 4종 |
| 유선 하이브리드 | 1.37–1.67 kg | 불필요 | 4종 |

→ 경량화로 2 kg 아래가 되는 것 자체가 법규상 큰 이득입니다. 계류식 인정 여부와 상관없이 신고가 필요 없습니다.

**불확실한 것** (지방항공청 또는 드론원스톱 drone.onestop.go.kr에 문의):
* 전원선 + 사람이 잡는 안전줄로 묶인 기체가 법적 "계류식 무인비행장치"인지(정의를 찾지 못함).
* 들어 올리는 전선 무게가 최대이륙중량에 들어가는지.
* 야외에서 계류식 장치에 150 m·관제권·비행금지구역 승인 규정이 어떻게 적용되는지(제308조의 다른 항을 다 읽지 못함). 유선 비행은 3 m 이하이므로 고도는 문제가 아니고, 장소(관제권·비행금지구역)가 문제입니다.
* 3종의 현재 실기 시험 요건.
* 공개 시연 장소의 자체 규정과 배상 책임 보험.

---

## 14. 비용과 구입 (원)

환율은 프로젝트 가격 조사와 같은 1 USD = 1,340.7원(2026-10-12)입니다.

| 품목 | 가격 | 근거 |
|---|---|---|
| Mean Well RSP-1500-24 | 632,265 | element14 한국, 1개 |
| Mean Well SE-1500-24 | 약 268,073 + 배송·통관 | Jameco USD 199.95 |
| 2번째 CNHL 6S 2200 70C | 40,207 | `docs/budget/price_research_2026-10-13.json` |
| CNHL 6S 4000 70C 2개 | 163,538 | 같은 파일 (개당 USD 60.99, 611 g) |
| 비상 배터리 6S 1100 100C (CNHL) | 36,186 | RaceDayQuads USD 26.99, 211 g |
| 비상 배터리 6S 650 120C (GNB) | 약 45,000 (가정) | 무게·치수는 Pyrodrone 정보 |
| XT90-S 2쌍 | 약 10,000 (가정) | Gator-RC 쌍당 USD 2.25 |
| 10 AWG 실리콘선 2 × 9 m | 약 90,000 (가정, m당 5,000) | 국내 가격 미조사 |
| Dyneema·번지·묶음 | 약 20,000 (가정) | |
| 갠트리(조명 스탠드 2 + 가로대) + 도르래 | 약 130,000 (가정) | |
| 기체 부품(콘덴서, TVS, 클램프, 고정점) | 약 30,000 (가정) | |
| D1/D2 보드(LM74700-Q1 2 + FET 6 + PCB) | 약 50,000 (가정) | |
| 100 A 퓨즈·홀더·비상 정지 | 약 20,000 (가정) | |
| 전력계 150 A 이상 | 약 20,000 (가정) | |

묶음:
* (i) 추력 시험: **약 6만 원**(전력계 + 2번째 팩).
* (ii) 무배터리 유선 시험(지상 LiPo): **약 34만 원**.
* (iii) 하이브리드 시연 + RSP: **약 103만 원**. SE-1500-24로 하면 약 66만 원(통관 제외).
* 구입처: Mean Well은 국내 유통(element14 한국 확인), RC 부품은 AliExpress(2–3주)나 국내 RC 상점, LM74700-Q1은 element14·DigiKey 한국 배송.

---

## 15. 다음 추력 시험의 전원 (권장)

**전원:** 완충한 비행용 6S 2200 70C. 가능하면 2개 병렬(전압 처짐이 줄고, 측정이 안정). 실험실 전원은 쓰지 않습니다.

**계측:** 150 A 이상 전력계(전압·전류·전력·최대값), 5 kg 이상 로드셀, ESC 단자에서 잰 전압, 양방향 전류(홀 클램프나 션트 + 오실로스코프), 적외선 온도계.

**순서**
1. `docs/v0.9_설계변경_계획.md` 1절과 `firmware/README.md` 10절 9단계의 방법을 따릅니다.
2. 0–100 %를 10 %씩, 각 3 s(80 % 이상은 2 s), 사이에 쉼. 완충 팩과 약 23 V 팩에서 한 번씩. 한 번 훑는 데 약 0.2–0.3 Ah(대용 표 전류로 추정).
3. **회생 확인:** 80 % → 50 % 계단 내림, 80 %에서 KILL. 배터리 전류가 음수(배터리로 들어감)가 되는지, ESC 전압이 얼마나 오르는지 기록합니다. 이것으로 버스 클램프 크기를 정합니다.
4. **유선 예행연습:** 같은 팩을 바닥에 두고 실제 10 AWG 8.5 m 전선을 거쳐 30 / 40 / 50 A로 돌립니다. 전압 강하, ESC 입력 리플(오실로스코프 AC), 60 s 뒤 콘덴서 온도를 봅니다. 전원 장치를 사기 전에 유선의 전기적 문제를 미리 봅니다.
5. **판단:** 1.3–1.7 kgf 구간의 추력–전력 곡선을 맞춥니다. 3절 "전원이 한계일 때" 표에서 실측 질량의 T/W가 1.3 이상이면 RSP-1500-24 1대를 삽니다.

---

## 16. 최종 권장 구성과 작업별 변경

| | (i) 벤치 추력 시험 | (ii) 유선 시험 비행 | (iii) 공개 시연 |
|---|---|---|---|
| 기체 | 시험대 고정 | 무배터리 유선 | 하이브리드(6S 650 mAh, D1/D2) |
| 지상 전원 | 비행용 LiPo (2개 병렬 권장) | 처음: 지상 LiPo 2개. 나중: RSP-1500-24 25.2 V | RSP-1500-24 25.2 V (하이브리드면 SE 가능) |
| 전선 | 실제 전선으로 예행연습 | 10 AWG 2가닥 8.5 m + Dyneema + 번지 | 같음 |
| 안전 | 보안경·귀마개, 팬 옆에 서지 않음 | 갠트리 + 사람이 잡는 안전줄(늘어짐 ≤ 0.3 m), 고도 ≤ 2 m | 같음 + 관객 차단선, 실내(사방·천장 막힘), 호버 1.5 m, 최대 2.0 m |
| 비용 | 약 6만 원 | 약 34만 원 | 약 103만 원 (SE면 약 66만 원) |

대회 비행: 배터리. 10 m 필드 비행: 배터리.

**CAD 변경** (`tether_power_proposal.json` `cad`)
* 설정: `power.source` = `battery` / `wired` / `wired_buffer` (VTOL 구성에만).
* VTOL 윗덮개: 축 위 M5 아이볼트 + 지름 30 mm 이상 하중판(작업 하중 100 N, 검사 하중 300 N, 가정값), 100 mm 이상 전선 부트(축에서 ±15°), 축에서 25 mm 안의 전선 클램프(10 AWG OD 5.5 mm 2개), 100 mm 여유 고리, 안쪽 XT90-S. GPS 포드는 축에서 비켜 둡니다.
* 에이비오닉스 칸: 10 AWG 0.25 m 전원선, ESC에서 50 mm 안의 콘덴서 4 mF, 버스 클램프(약 20 g), 하이브리드는 D1/D2 보드(약 15 g)와 배터리 칸의 6S 650(63 × 30 × 31 mm, 끈 고정).
* 금지 영역: 에이비오닉스 모듈 윗면 아래로는 유선 부품·전선 경로 없음. 전선 경로의 모든 점이 흡입창에서 200 mm 이상. 아래·핀 출구는 만들지 않음.
* 질량: 무배터리 −248 g, 하이브리드 −127 g(배터리 VTOL 대비). 무게중심이 내려가 베인 레버암이 줄어듭니다. 다시 계산합니다.

**시뮬레이션 변경** (`sim`)
* 장력·안전줄·전원(전선 저항, 전원 정전류·5 s 차단, 비상 배터리, 클램프) 모델. 추력 P1/P2 × 2.0–3.09 kgf 분산.
* 시나리오 W1–W6과 기록 항목(장력, ESC 전압·전류, 비상 배터리 Ah, 전선–흡입창 최소 거리, 전원 상실 → 착륙 시간).

**펌웨어 변경** (`firmware`, 11.3절)
* 빌드 전원 구분, ADC 2채널, W_ARM / W_LOST / W_SAG / W_BUF / W_D2, I8 대응, 유선 비행 시간 180 s, 스로틀 하강 제한, 지상국 경보.
* `params_gen.h`는 CAD 작업이 `params.json`을 바꾼 뒤 STALE이 됩니다. 펌웨어 작업에서 다시 만듭니다.

---

## 17. 실물로 재야 할 것

1. LiPo로 추력·전류·ESC 전압 곡선(전원 장치 구입을 결정).
2. SkyWalker 100A V2가 스로틀을 내릴 때 회생하는지(클램프 크기).
3. 실제 8.5 m 전선을 거친 ESC 입력 리플과 콘덴서 온도.
4. 사 온 10 / 12 AWG 전선의 실제 지름과 m당 무게.
5. XT90-S 접촉 저항(커넥터 합 1 mΩ 가정).
6. 호버 전류로 120–180 s 돌린 뒤 모터 온도.
7. EDF 하우징의 모터선 출구 위치(`edf.wire_exit`는 도면에서 읽은 가정값 — 모터 전원선 작업과 같은 항목).

---

## 18. 출처

* Mean Well RSP-1500 사양서(2026-06-15판): https://www.meanwell.com/Upload/PDF/RSP-1500/RSP-1500-SPEC.PDF
* Mean Well SE-1500 사양서(2026-09-07판): https://www.meanwell.com/Upload/PDF/SE-1500/SE-1500-SPEC.PDF
* RSP-1500-24 한국 가격(element14): https://kr.element14.com/mean-well/rsp-1500-24/power-supply-ac-dc-24v-63a/dp/3002756
* SE-1500-24 가격(Jameco): https://www.jameco.com/z/SE-1500-24-MEAN-WELL-AC-to-DC-Power-Supply-Single-Output-24-Volt-62-5-Amp-1-5kw_2103353.html
* 계류 드론 고전압 구조·변환기 무게(Vicor/Mouser 설계 안내): https://www.mouser.lt/pdfDocs/DesignGuidetoPoweringTetheredUAVs.pdf
* Vicor BCM4414 가격(DigiKey 기준, 집계 사이트): https://thepartsdirect.com/part/bcm4414vd1e13a3c02~vicor
* TI LM74700-Q1: https://www.ti.com/product/LM74700-Q1
* Pololu 이상적 다이오드(최대 25 A): https://pololu.com/category/329/reverse-voltage-protection-and-ideal-diodes
* Castle CapPack 설명(리플 10 %, 전선 길이): https://wrekd.com/products/castle-creations-capacitor-pack-8s-max-35v-2240%CE%BCf , https://store.hobbyetc.com/parts/view/76346
* 220 µF / 10 cm 경험칙(커뮤니티): https://endless-sphere.com/sphere/threads/adding-caps-to-castle-creations-escs.35420/
* XT90-S 무게·가격: https://www.gator-rc.com/products/xt90-connectors-with-wire-cover-pair
* 실리콘선 가닥·지름: https://protosupplies.com/product/silicone-wire-14awg-ultra-flexible/ , https://st.robu.in/?p=24860 , https://www.ebay.de/itm/153721122103
* CNHL 6S 1100 100C 무게·가격: https://www.racedayquads.com/products/cnhl-black-series-22-2v-6s-1100mah-100c-lipo-battery-xt60
* GNB 6S 650 120C 무게·치수: https://pyrodrone.com/collections/batteries/products/gaoneng-gnb-650mah-22-8v-6s-120c-hv-lipo-battery-xt30
* 항공안전법 시행령 제24조(조문 인용): https://www.nepla.ai/wiki/it-정보-방송통신/로봇-드론/-일문일답-드론-구매-후-신고를-해야-하는-드론은-gy380o1e8rxk
* 항공안전법 시행규칙 제306조·제308조(2025-01-19 본문): https://www.nepla.ai/law/%ED%95%AD%EA%B3%B5%EC%95%88%EC%A0%84%EB%B2%95%20%EC%8B%9C%ED%96%89%EA%B7%9C%EC%B9%99/20250119
* 국토부 드론 FAQ(실내 비행, 신고): https://www.molit.go.kr/USR/policyTarget/dtl.jsp?idx=584 (검색 결과로만 확인, 페이지는 열리지 않음)
* 조종자 증명 종류(언론): https://www.segye.com/view/20240607510803
* FAA 14 CFR 107.120 (11 ft-lb): https://www.ecfr.gov/current/title-14/chapter-I/subchapter-F/part-107/subpart-D
* 프로젝트 내부: `params.json`(sha256 `5608f2ee…`), `sizing/sizing_report.md`, `docs/budget/price_research_2026-10-13.json`, `docs/v0.9_설계변경_계획.md`

---

## 19. 계산 근거 파일

* 계산 스크립트: `C:\Users\yc012\AppData\Local\Temp\claude\B--Claude\bed4b475-b8b1-46b7-ab64-c3b11e27401e\scratchpad\v09\tether\tether_calc.py`
* 결과: `C:\Users\yc012\AppData\Local\Temp\claude\B--Claude\bed4b475-b8b1-46b7-ab64-c3b11e27401e\scratchpad\v09\tether\tether_calc_out.json`
* 실행 기록: `C:\Users\yc012\AppData\Local\Temp\claude\B--Claude\bed4b475-b8b1-46b7-ab64-c3b11e27401e\scratchpad\v09\tether\run_log.txt`
* 제안서(기계용): `B:\0)AI_Cad\CanSat_EDF_Rocket\docs\tether_power_proposal.json`
* 확인: 스크립트가 크기 산정의 호버 1,822 W(26.22 N)를 그대로 다시 냅니다.
* 시험하지 않은 것: 이 문서의 모든 값은 계산과 판매처·법령 자료입니다. 실물 측정은 아직 없습니다.
