Yuchan-00/CanSat_EDF_Rocket/docs/출력무게_보정.md

# 출력 무게 보정 (v0.9)

2026-10-27. 모든 숫자는 이번에 Bambu Studio CLI로 직접 슬라이스한 값입니다. 원자료는 `docs/print_mass_calibration.json`에 있습니다.
`params.json`과 `cad/`는 고치지 않았습니다. CAD 담당이 이 결과를 반영합니다.

## 1. 한눈에 보기

* 사용자가 잰 **"출력한 외부 하우징 약 300 g"은 추진 모듈(`propulsion_module`)**입니다. CAD는 속이 꽉 찬 고체로 계산해서 437.7 g입니다.
* 같은 부품을 **Bambu Studio 기본 설정**(벽 2겹, 위 5층·아래 3층, 채움 15 % 격자)으로 슬라이스하면 **295.1 g**입니다. Bambu 화면에 나오는 밀도(1.32)로는 297.4 g입니다. 실측 약 300 g과 맞습니다.
* 프로젝트 출력 계획(벽 5겹, 위·아래 5층, 15 % 자이로이드)대로 출력하면 369.2 g입니다. 벽 3겹은 336.0 g, 벽 4겹은 352.7 g입니다.
* 그래서 **기본 설정으로 출력하신 것으로 보입니다.** 설정을 기록하지 않았으니 확인이 필요합니다 (7번).
* CAD 무게 모델은 실제 출력물보다 무겁습니다. 지금 기체 출력 부품 합계는 다음과 같습니다.
  * CAD 고체: 1,054.8 g
  * 슬라이서, 지금 출력 계획 설정: 964.4 g (−90.4 g)
  * 슬라이서, 제안 설정: **925.3 g (−129.5 g)**
* 설정만으로 줄일 수 있는 무게는 작습니다 (계획 대비 −39.1 g). 대부분 부품이 이미 얇은 벽(1.2 mm)이라 속까지 벽으로 꽉 차기 때문입니다. 크게 줄이려면 형상을 바꿔야 합니다 (5번).

## 2. 어떻게 쟀나

* 프로젝트의 슬라이스 흐름(`tools/make_print_files.py`의 방향, 서포트, 흡입 모듈 서포트 차단)을 그대로 썼습니다. 바꾼 것은 벽 수, 위·아래 층 수, 채움 비율뿐입니다.
* 프린터 `Bambu Lab P2S 0.4 nozzle`, 공정 `0.20mm Standard @BBL P2S`, 필라멘트 `Bambu PLA Matte @BBL P2S`, 밀도 1.31 g/cm³ (params). Bambu Studio 02.08.02.61.
* **재현 확인:** 10월 20일 출력 계획의 추진 모듈 369.979 g → 이번 369.987 g. 베인 4.036 g → 4.036 g. 같은 흐름이 같은 값을 냅니다.
* 현재 설계 형상은 CadQuery 트윈 STL(`cad/exports/cadquery/stl`, params.json sha256 `5608f2ee…`)입니다. Fusion 내보내기는 v0.6.3이라 오래됐습니다.
* **부품 무게 = 서포트·브림을 뺀 부품 자체의 압출량**입니다. 비행하는 무게입니다. G-code의 기능별 압출량을 합해서 구했습니다 (G-code 총량과 0.01 % 이내로 일치).

## 3. 부품별 표

| 부품 | 수량 | CAD 고체 (g) | 지금 계획 설정 (g) | 제안 설정 | 제안 설정 (g) | 절감 (g, 1개) | 기본 설정 벽 2겹 (g) |
|---|---|---|---|---|---|---|---|
| 추진 모듈 | 1 | 437.7 | 369.2 | A | **351.4** | 17.8 | 295.1 |
| 흡입 모듈 | 1 | 133.0 | 132.1 (+서포트 82.1) | A | **126.9** | 5.2 | 100.2 |
| 전자 모듈 | 1 | 127.8 | 124.8 | B | **124.8** | 0.0 | 124.8 |
| 전자 트레이 | 1 | 40.9 | 41.4 | C | **36.4** | 5.0 | 36.3 |
| 페이로드 모듈 | 1 | 188.5 | 177.6 (+서포트 99.8) | B | **171.1** | 6.4 | 169.2 |
| 피스톤 | 1 | 31.8 | 29.3 | C | **25.2** | 4.1 | 25.1 |
| 노즈콘 | 1 | 70.4 | 68.2 (+서포트 3.2) | A | **67.8** | 0.4 | 67.3 |
| 베인 | 4 | 4.3 | 3.6 | D (유지) | **3.6** | 0 | 2.9 |
| 베인 혼 | 4 | 0.45 | 0.44 | D (유지) | **0.44** | 0 | 0.38 |
| 래치 암 | 1 | 0.29 | 0.27 | D (유지) | **0.27** | 0 | 0.22 |
| GPS 포드 뚜껑 | 1 | 5.5 | 5.6 | B | **5.6** | 0 | 5.6 |
| 발사대 (기체 아님) | 1 | 356.8 | 174.0 | E | **140.9** | 33.1 | 127.1 |

합계 (발사대 제외, 수량 반영):

| 구성 | CAD 고체 | 지금 계획 설정 | 제안 설정 | 기본 설정 벽 2겹 |
|---|---|---|---|---|
| 로켓 구성 (지금 부품 전부) | 1,054.8 g | 964.4 g | **925.3 g** | 837.0 g |
| VTOL 구성 (페이로드 모듈·피스톤·래치 암·GPS 뚜껑 제외) | 828.6 g | 751.7 g | **723.2 g** | 636.9 g |

* VTOL 구성은 지금 부품에서 빠지는 것만 뺀 값입니다. v0.9 새 형상(핀 속 서보, 짧아진 동체)은 CAD 담당이 다시 슬라이스합니다.
* 출력 시간은 거의 같습니다 (기체 25시간 25분 → 25시간 13분).
* 흡입·페이로드 모듈은 서포트가 많습니다 (82 g, 100 g). 필라멘트는 쓰지만 비행 무게에는 들어가지 않습니다.
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
