Yuchan-00/CanSat_EDF_Rocket/cad/exports/cadquery_checks.md

# CadQuery geometry checks - preset BUDGET_90mm_6S

params_sha256 `f907c459e287d26b034c44738e875d716c9b5177655477e9cd89d616a2fa1f41` - generator cadquery 2.8.0 - runtime 314.4 s

Summary (C-rows): 29 PASS, 5 WARN, 0 FAIL, 5 N/A (edf.mount = tabs). No-intersection tolerance 1 mm^3.

| id | status | check | measured | detail |
|---|---|---|---|---|
| C1 | PASS | printed parts fit the bed in print orientation | worst extent/limit = 0.794 (limits 248x248x252) | propulsion_module(upright) 176.2x176.2x190.0; intake_module(upright) 131.7x120.0x172.9; avionics_module(upright) 120.0x120.0x200.0; avionics_logo(upright) 17.0x116.3x121.0; avionics_tray(flat) 100.0x160.0x2.0; payload_module(upright) 193.8x120.0x198.4; piston(flat) 116.6x116.6x2.4; nose_cone(upright) 126.0x120.0x155.0; vane(flat) 32.0x46.5x5.0; vane_coupler(upright) 13.5x10.6x12.0; servo_cover(flat) 43.1x50.0x1.2;
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
