Yuchan-00/CanSat_EDF_Rocket/cad/exports/fusion/preview.png

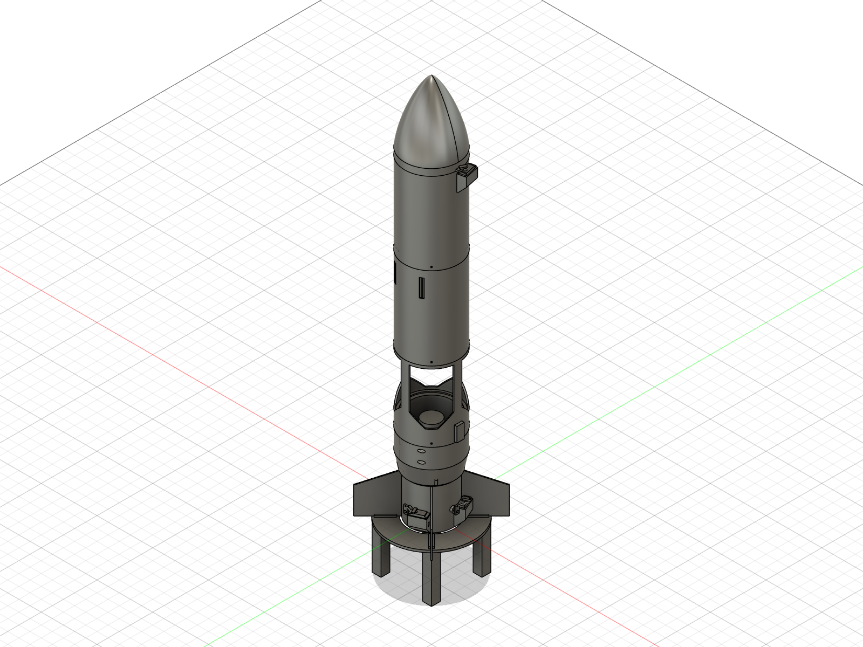
cad/exports/fusion/preview.png
