Yuchan-00/CanSat_EDF_Rocket/cad/exports/gps_pod_section.png

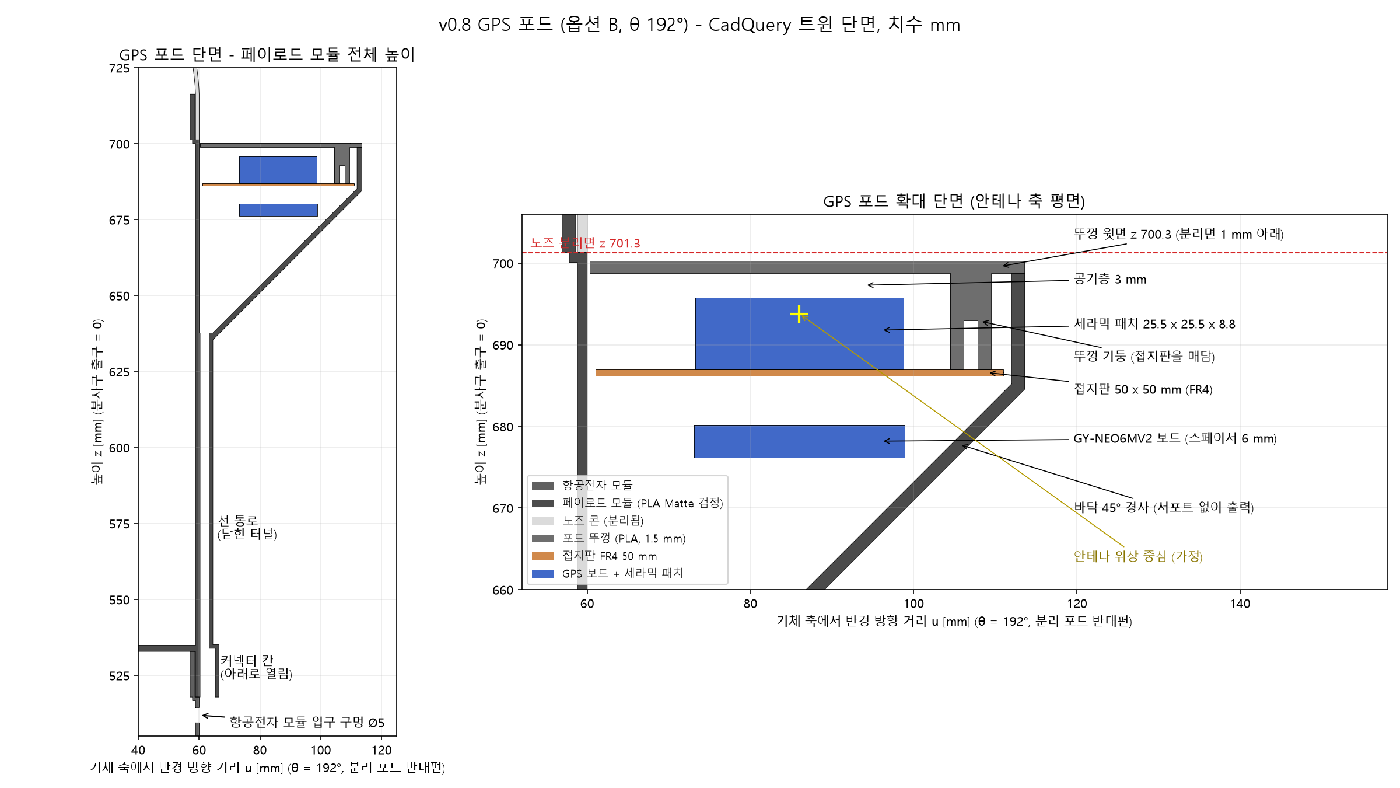
cad/exports/gps_pod_section.png
