Yuchan-00/CanSat_EDF_Rocket/pcb/vtol_carrier/out/presentation/pcb_bottom_2400.png

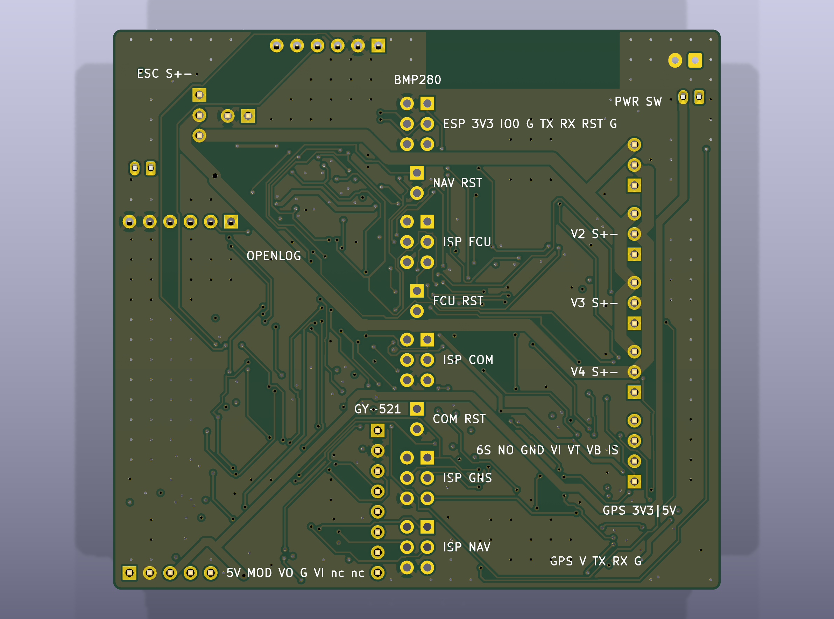
pcb/vtol_carrier/out/presentation/pcb_bottom_2400.png
