Yuchan-00/CanSat_EDF_Rocket/pcb/vtol_carrier/out/presentation/pcb_iso_back_2400.png

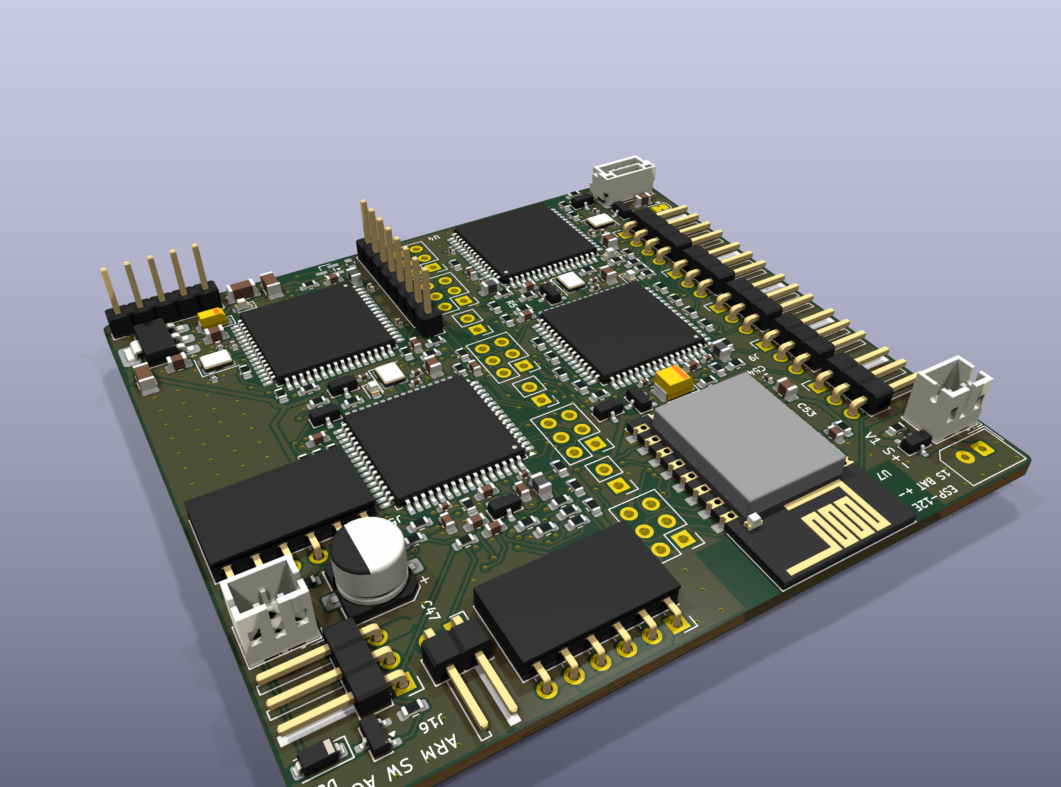
pcb/vtol_carrier/out/presentation/pcb_iso_back_2400.png
