Yuchan-00/CanSat_EDF_Rocket/pcb/vtol_carrier/out/presentation/sch_Level_shift.png

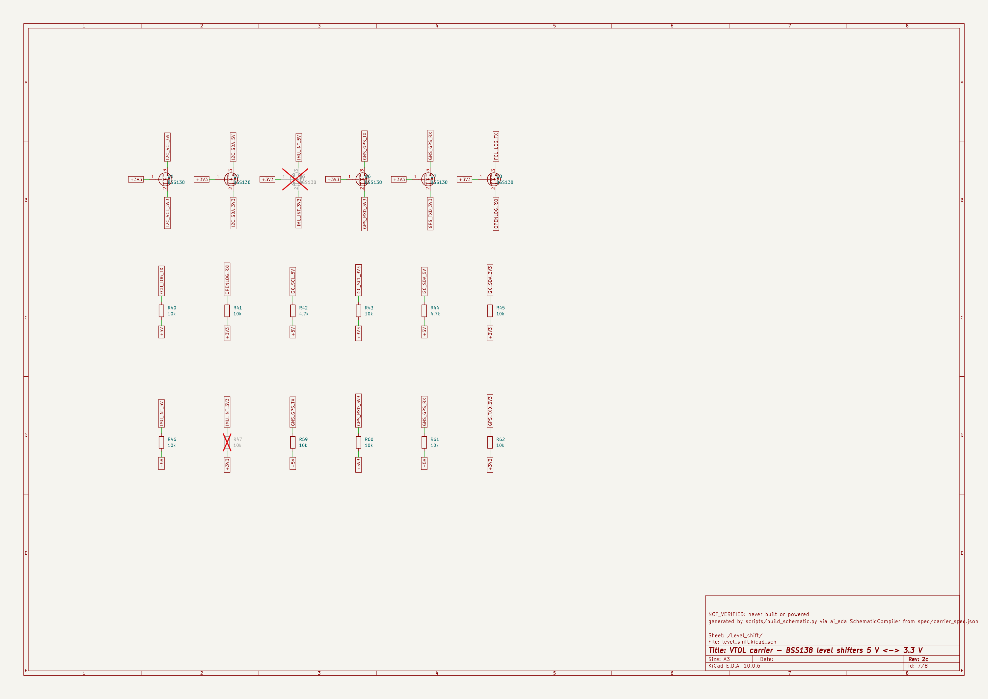
pcb/vtol_carrier/out/presentation/sch_Level_shift.png
