Yuchan-00/CanSat_EDF_Rocket/pcb/vtol_carrier/out/presentation/sch_NAV.png

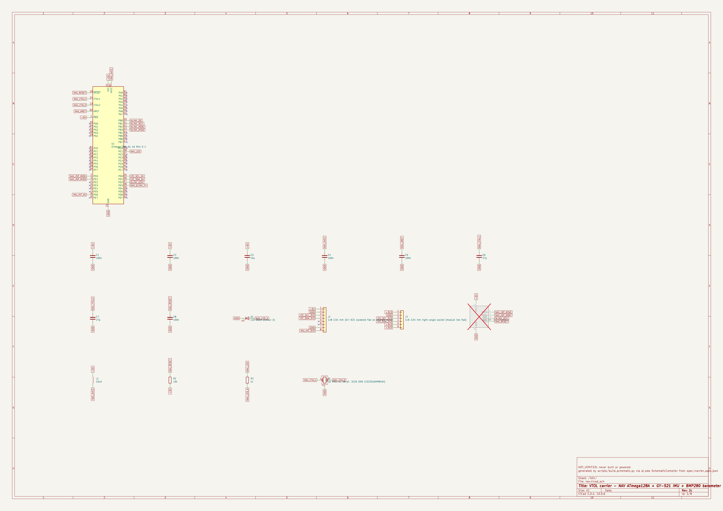
pcb/vtol_carrier/out/presentation/sch_NAV.png
