Yuchan-00/CanSat_EDF_Rocket/pcb/vtol_carrier/out/bom_sources_all_lines.csv

line | value | fitted refs | qty fitted | DNP refs | footprint | source | part number | MPN / name | JLC type | assembly | URL fetched | fetch date | stock at fetch
c100n0402 | 100n | C1 C2 C4 C9 C10 C12 C17 C18 C20 C25 C26 C28 C54 | 13 |  | Capacitor_SMD:C_0402_1005Metric | JLCPCB/LCSC | C1525 | CL05B104KO5NNNC | Basic | JLC SMT assembly | https://jlcpcb.com/partdetail/C1525 https://cart.jlcpcb.com/shoppingCart/smtGood/getComponentDetail?componentCode=C1525 https://www.lcsc.com/product-detail/multilayer-ceramic-capacitors-mlcc-smd-smt_samsung-electro-mechanics-cl05b104ko5nnnc_C1525.html/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 | 2026-11-05 | 33539946
c10u0805 | 10u | C3 C11 C19 C27 C44 C53 C56 | 7 |  | Capacitor_SMD:C_0805_2012Metric | JLCPCB/LCSC | C15850 | CL21A106KAYNNNE | Basic | JLC SMT assembly | https://jlcpcb.com/partdetail/C15850 https://cart.jlcpcb.com/shoppingCart/smtGood/getComponentDetail?componentCode=C15850 https://www.lcsc.com/product-detail/multilayer-ceramic-capacitors-mlcc-smd-smt_samsung-electro-mechanics-cl21a106kaynnne_C15850.html/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 | 2026-11-05 | 7647363
c100n0603 | 100n | C5 C8 C13 C16 C21 C24 C29 C32 C46 C48 C49 C50 C51 C55 | 14 |  | Capacitor_SMD:C_0603_1608Metric | JLCPCB/LCSC | C14663 | CC0603KRX7R9BB104 | Basic | JLC SMT assembly | https://jlcpcb.com/partdetail/C14663 https://cart.jlcpcb.com/shoppingCart/smtGood/getComponentDetail?componentCode=C14663 https://www.lcsc.com/product-detail/multilayer-ceramic-capacitors-mlcc-smd-smt_yageo-cc0603krx7r9bb104_C14663.html/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 | 2026-11-05 | 37483003
c27p0402 | 27p | C6 C7 C14 C15 C22 C23 C30 C31 | 8 |  | Capacitor_SMD:C_0402_1005Metric | JLCPCB/LCSC | C1557 | 0402CG270J500NT | Extended | JLC SMT assembly | https://jlcpcb.com/partdetail/C1557 https://cart.jlcpcb.com/shoppingCart/smtGood/getComponentDetail?componentCode=C1557 https://www.lcsc.com/product-detail/multilayer-ceramic-capacitors-mlcc-smd-smt_fh-guangdong-fenghua-advanced-tech-0402cg270j500nt_C1557.html/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 | 2026-11-05 | 292832
c22u1206 | 22u 10V | C41 C42 C43 | 3 |  | Capacitor_SMD:C_1206_3216Metric | JLCPCB/LCSC | C12891 | CL31A226KAHNNNE | Basic | JLC SMT assembly | https://jlcpcb.com/partdetail/C12891 https://cart.jlcpcb.com/shoppingCart/smtGood/getComponentDetail?componentCode=C12891 https://www.lcsc.com/product-detail/multilayer-ceramic-capacitors-mlcc-smd-smt_samsung-electro-mechanics-cl31a226kahnnne_C12891.html/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 | 2026-11-05 | 1628107
tant22u | 22u 10V tantalum | C45 | 1 |  | Capacitor_Tantalum_SMD:CP_EIA-3216-18_Kemet-A | JLCPCB/LCSC | C7183 | TAJA226M010RNJ | Extended | JLC SMT assembly | https://jlcpcb.com/partdetail/C7183 https://cart.jlcpcb.com/shoppingCart/smtGood/getComponentDetail?componentCode=C7183 https://www.lcsc.com/product-detail/tantalum-capacitors_kyocera-avx-taja226m010rnj_C7183.html/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 | 2026-11-05 | 2307
elec220u | 220u 10V | C47 | 1 |  | Capacitor_SMD:CP_Elec_6.3x5.4 | JLCPCB/LCSC | C2833309 | RVT220UF10V67RV0037 | Extended | JLC SMT assembly | https://jlcpcb.com/partdetail/C2833309 https://cart.jlcpcb.com/shoppingCart/smtGood/getComponentDetail?componentCode=C2833309 https://www.lcsc.com/product-detail/aluminum-electrolytic-capacitors-smd_knscha-rvt220uf10v67rv0037_C2833309.html/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 | 2026-11-05 | 205404
tant100u | 100u 10V tantalum | C52 | 1 |  | Capacitor_Tantalum_SMD:CP_EIA-3528-21_Kemet-B | JLCPCB/LCSC | C7196 | TAJB107M010RNJ | Extended | JLC SMT assembly | https://jlcpcb.com/partdetail/C7196 https://cart.jlcpcb.com/shoppingCart/smtGood/getComponentDetail?componentCode=C7196 https://www.lcsc.com/product-detail/tantalum-capacitors_kyocera-avx-tajb107m010rnj_C7196.html/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 | 2026-11-05 | 105178
led | LED 0603 (colour A) | D1 D2 D3 D4 | 4 |  | LED_SMD:LED_0603_1608Metric | JLCPCB/LCSC | C2286 | KT-0603R | Basic | JLC SMT assembly | https://jlcpcb.com/partdetail/C2286 https://cart.jlcpcb.com/shoppingCart/smtGood/getComponentDetail?componentCode=C2286 https://www.lcsc.com/product-detail/led-indication-discrete_hubei-kento-elec-kt-0603r_C2286.html/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 | 2026-11-05 | 6721348
schottky | SS14 / B5819W class Schottky | D6 | 1 |  | Diode_SMD:D_SOD-123 | JLCPCB/LCSC | C8598 | B5819W SL | Basic | JLC SMT assembly | https://jlcpcb.com/partdetail/C8598 https://cart.jlcpcb.com/shoppingCart/smtGood/getComponentDetail?componentCode=C8598 https://www.lcsc.com/product-detail/schottky-diodes_jiangsu-changjing-electronics-technology-co-ltd-b5819w-sl_C8598.html/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 | 2026-11-05 | 811852
gy521 | 1x8 2.54 mm (GY-521 soldered flat on straight pins) | J1 | 1 |  | Connector_PinHeader_2.54mm:PinHeader_1x08_P2.54mm_Vertical | devicemart | no=1247052 | MPU-6050 6축 자이로 가속도 센서 모듈 GY-521 [SZH-EK007] |  | hand-solder (devicemart module) | https://www.devicemart.co.kr/goods/view?no=1247052 https://www.devicemart.co.kr/goods/search_sse_stream?search_text=1247052 | 2026-11-05 | 0
sock1x6ra | 1x6 2.54 mm right-angle socket (module lies flat) | J2 J5 | 2 |  | Connector_PinSocket_2.54mm:PinSocket_1x06_P2.54mm_Horizontal | JLCPCB/LCSC | C55629861 | SH-PM254R-1x6P-H85 | Extended | hand-solder (THT; JLC THT assembly optional) | https://jlcpcb.com/partdetail/C55629861 https://cart.jlcpcb.com/shoppingCart/smtGood/getComponentDetail?componentCode=C55629861 | 2026-11-05 | 985
hdr2x3 | 2x3 2.54 mm vertical: ESP-12E programming header (3.3 V logic ONLY) |  | 0 | J3 J19 J20 J21 J22 | Connector_PinHeader_2.54mm:PinHeader_2x03_P2.54mm_Vertical | JLCPCB/LCSC | C65114 | 2.54-2*3PPin | Extended | hand-solder (THT; JLC THT assembly optional) | https://jlcpcb.com/partdetail/C65114 https://cart.jlcpcb.com/shoppingCart/smtGood/getComponentDetail?componentCode=C65114 https://www.lcsc.com/product-detail/pin-headers_boomele-boom-precision-elec-2-54-2-3p_C65114.html/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 | 2026-11-05 | 41728
boost | 1x5 2.54 mm: Pololu S9V11F5S6CMA 5 V step-up/step-down module (VOUT, GND, VIN, EN, PG) | J6 | 1 |  | Connector_PinHeader_2.54mm:PinHeader_1x05_P2.54mm_Vertical | devicemart | no=15855364 | 5V Step-Up/Step-Down Voltage Regulator w/ Adjustable Low-Voltage Cutoff S9V11F5S6CMA #2870 |  | hand-solder (devicemart module) | https://www.devicemart.co.kr/goods/view?no=15855364 https://www.devicemart.co.kr/goods/search_sse_stream?search_text=15855364 | 2026-11-05 | 100
gh4 | JST-GH 1.25 mm 4-pin vertical (top entry) | J7 | 1 |  | Connector_JST:JST_GH_BM04B-GHS-TBT_1x04-1MP_P1.25mm_Vertical | JLCPCB/LCSC | C161692 | BM04B-GHS-TBT(LF)(SN) | Extended | JLC SMT assembly | https://jlcpcb.com/partdetail/C161692 https://cart.jlcpcb.com/shoppingCart/smtGood/getComponentDetail?componentCode=C161692 https://www.lcsc.com/product-detail/wire-to-board-connector_jst-bm04b-ghs-tbt-lf-sn_C161692.html/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 | 2026-11-05 | 23326
hdr1x3ra | 1x3 2.54 mm right-angle header (S, +, -) | J8 J9 J10 J11 J12 | 5 |  | Connector_PinHeader_2.54mm:PinHeader_1x03_P2.54mm_Horizontal | JLCPCB/LCSC | C55629817 | SH-PZ254R-1x3P | Extended | hand-solder (THT; JLC THT assembly optional) | https://jlcpcb.com/partdetail/C55629817 https://cart.jlcpcb.com/shoppingCart/smtGood/getComponentDetail?componentCode=C55629817 | 2026-11-05 | 2000
spox2 | Molex SPOX 5267-02A 2.50 mm 2-pin vertical (mates the pack's 5264-type housing, A) | J14 | 1 |  | Connector_Molex:Molex_SPOX_5267-02A_1x02_P2.50mm_Vertical | JLCPCB/LCSC | C5364642 | 22035025 | Extended | hand-solder (THT; JLC THT assembly optional) | https://jlcpcb.com/partdetail/C5364642 https://cart.jlcpcb.com/shoppingCart/smtGood/getComponentDetail?componentCode=C5364642 https://www.lcsc.com/product-detail/wire-to-board-connector_molex-22035025_C5364642.html/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 | 2026-11-05 | 454
ph2 | JST-PH 2.0 2-pin vertical: lead to an external logic power switch | J15 J17 | 2 |  | Connector_JST:JST_PH_B2B-PH-K_1x02_P2.00mm_Vertical | JLCPCB/LCSC | C131337 | B2B-PH-K-S(LF)(SN) | Extended | hand-solder (THT; JLC THT assembly optional) | https://jlcpcb.com/partdetail/C131337 https://cart.jlcpcb.com/shoppingCart/smtGood/getComponentDetail?componentCode=C131337 https://www.lcsc.com/product-detail/wire-to-board-connector_jst-b2b-ph-k-s-lf-sn_C131337.html/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 | 2026-11-05 | 214800
hdr1x2ra | 1x2 right-angle header | J16 | 1 |  | Connector_PinHeader_2.54mm:PinHeader_1x02_P2.54mm_Horizontal | JLCPCB/LCSC | C55629816 | SH-PZ254R-1x2P | Extended | hand-solder (THT; JLC THT assembly optional) | https://jlcpcb.com/partdetail/C55629816 https://cart.jlcpcb.com/shoppingCart/smtGood/getComponentDetail?componentCode=C55629816 | 2026-11-05 | 1750
hdr1x4ra | 1x4 right-angle header | J18 | 1 |  | Connector_PinHeader_2.54mm:PinHeader_1x04_P2.54mm_Horizontal | JLCPCB/LCSC | C55629818 | SH-PZ254R-1x4P | Extended | hand-solder (THT; JLC THT assembly optional) | https://jlcpcb.com/partdetail/C55629818 https://cart.jlcpcb.com/shoppingCart/smtGood/getComponentDetail?componentCode=C55629818 | 2026-11-05 | 1898
hdr1x2v | 2-pin header + shunt |  | 0 | J24 J25 J26 | Connector_PinHeader_2.54mm:PinHeader_1x02_P2.54mm_Vertical | JLCPCB/LCSC | C55629809 | SH-PZ254V-1x2P | Extended | hand-solder (THT; JLC THT assembly optional) | https://jlcpcb.com/partdetail/C55629809 https://cart.jlcpcb.com/shoppingCart/smtGood/getComponentDetail?componentCode=C55629809 | 2026-11-05 | 1662
ind10u | 10uH | L1 L2 L3 L4 | 4 |  | Inductor_SMD:L_0805_2012Metric | JLCPCB/LCSC | C1046 | SDFL2012S100KTF | Basic | JLC SMT assembly | https://jlcpcb.com/partdetail/C1046 https://cart.jlcpcb.com/shoppingCart/smtGood/getComponentDetail?componentCode=C1046 https://www.lcsc.com/product-detail/inductors-smd_sunlord-sdfl2012s100ktf_C1046.html/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 | 2026-11-05 | 211090
bss138 | BSS138 | Q1 Q2 Q4 Q5 Q6 Q7 Q8 Q11 | 8 | Q3 | Package_TO_SOT_SMD:SOT-23 | JLCPCB/LCSC | C40912 | BSS138-7-F | Extended | JLC SMT assembly | https://jlcpcb.com/partdetail/C40912 https://cart.jlcpcb.com/shoppingCart/smtGood/getComponentDetail?componentCode=C40912 https://www.lcsc.com/product-detail/mosfets_diodes-incorporated-bss138-7-f_C40912.html/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 | 2026-11-05 | 409427
npn | MMBT3904 | Q9 | 1 |  | Package_TO_SOT_SMD:SOT-23 | JLCPCB/LCSC | C20526 | MMBT3904(RANGE:100-300) | Basic | JLC SMT assembly | https://jlcpcb.com/partdetail/C20526 https://cart.jlcpcb.com/shoppingCart/smtGood/getComponentDetail?componentCode=C20526 https://www.lcsc.com/product-detail/bipolar-bjt_jiangsu-changjing-electronics-technology-co-ltd-mmbt3904-range-100-300_C20526.html/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 | 2026-11-05 | 2816488
pfet | AO3401A (-30 V, -4 A, Vgs(th) -0.5..-1.3 V, Rds(on) <= 85 mOhm at Vgs -2.5 V: A) | Q10 | 1 |  | Package_TO_SOT_SMD:SOT-23 | JLCPCB/LCSC | C15127 | AO3401A | Basic | JLC SMT assembly | https://jlcpcb.com/partdetail/C15127 https://cart.jlcpcb.com/shoppingCart/smtGood/getComponentDetail?componentCode=C15127 https://www.lcsc.com/product-detail/mosfets_alpha-omega-semicon-ao3401a_C15127.html/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 | 2026-11-05 | 1636513
r10k | 10k | R1 R3 R5 R7 R11 R14 R23 R24 R25 R26 R27 R29 R31 R38 R40 R41 R43 R45 R46 R48 R49 R50 R51 R52 R53 R55 R56 R57 R58 R59 R60 R61 R62 | 33 | R47 | Resistor_SMD:R_0603_1608Metric | JLCPCB/LCSC | C25804 | 0603WAF1002T5E | Basic | JLC SMT assembly | https://jlcpcb.com/partdetail/C25804 https://cart.jlcpcb.com/shoppingCart/smtGood/getComponentDetail?componentCode=C25804 https://www.lcsc.com/product-detail/chip-resistor-surface-mount_uni-royal-uniroyal-elec-0603waf1002t5e_C25804.html/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 | 2026-11-05 | 44433013
r1k | 1k | R2 R4 R6 R8 R12 R13 R28 R30 R54 | 9 |  | Resistor_SMD:R_0603_1608Metric | JLCPCB/LCSC | C21190 | 0603WAF1001T5E | Basic | JLC SMT assembly | https://jlcpcb.com/partdetail/C21190 https://cart.jlcpcb.com/shoppingCart/smtGood/getComponentDetail?componentCode=C21190 https://www.lcsc.com/product-detail/chip-resistor-surface-mount_uni-royal-uniroyal-elec-0603waf1001t5e_C21190.html/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 | 2026-11-05 | 28460198
r47k | 47k 1% | R15 R16 R32 R34 R36 | 5 |  | Resistor_SMD:R_0603_1608Metric | JLCPCB/LCSC | C25819 | 0603WAF4702T5E | Basic | JLC SMT assembly | https://jlcpcb.com/partdetail/C25819 https://cart.jlcpcb.com/shoppingCart/smtGood/getComponentDetail?componentCode=C25819 https://www.lcsc.com/product-detail/chip-resistor-surface-mount_uni-royal-uniroyal-elec-0603waf4702t5e_C25819.html/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 | 2026-11-05 | 2612722
r220 | 220 | R17 R18 R19 R20 R21 | 5 |  | Resistor_SMD:R_0603_1608Metric | JLCPCB/LCSC | C22962 | 0603WAF2200T5E | Basic | JLC SMT assembly | https://jlcpcb.com/partdetail/C22962 https://cart.jlcpcb.com/shoppingCart/smtGood/getComponentDetail?componentCode=C22962 https://www.lcsc.com/product-detail/chip-resistor-surface-mount_uni-royal-uniroyal-elec-0603waf2200t5e_C22962.html/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 | 2026-11-05 | 2868502
r4k7 | 4.7k 1% | R33 R35 R37 R42 R44 | 5 |  | Resistor_SMD:R_0603_1608Metric | JLCPCB/LCSC | C23162 | 0603WAF4701T5E | Basic | JLC SMT assembly | https://jlcpcb.com/partdetail/C23162 https://cart.jlcpcb.com/shoppingCart/smtGood/getComponentDetail?componentCode=C23162 https://www.lcsc.com/product-detail/chip-resistor-surface-mount_uni-royal-uniroyal-elec-0603waf4701t5e_C23162.html/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 | 2026-11-05 | 13889072
r100k | 100k | R39 | 1 |  | Resistor_SMD:R_0603_1608Metric | JLCPCB/LCSC | C25803 | 0603WAF1003T5E | Basic | JLC SMT assembly | https://jlcpcb.com/partdetail/C25803 https://cart.jlcpcb.com/shoppingCart/smtGood/getComponentDetail?componentCode=C25803 https://www.lcsc.com/product-detail/chip-resistor-surface-mount_uni-royal-uniroyal-elec-0603waf1003t5e_C25803.html/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 | 2026-11-05 | 16782662
mcu | ATmega128A-AU 16 MHz 5 V | U1 U2 U3 U4 | 4 |  | Package_QFP:TQFP-64_14x14mm_P0.8mm | JLCPCB/LCSC | C6510 | ATMEGA128A-AU | Extended | JLC SMT assembly | https://jlcpcb.com/partdetail/C6510 https://cart.jlcpcb.com/shoppingCart/smtGood/getComponentDetail?componentCode=C6510 https://www.lcsc.com/product-detail/microcontrollers-mcu-mpu-soc_microchip-tech-atmega128a-au_C6510.html/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 | 2026-11-05 | 1029
ldo | AMS1117-3.3 | U6 | 1 |  | Package_TO_SOT_SMD:SOT-223-3_TabPin2 | JLCPCB/LCSC | C6186 | AMS1117-3.3 | Basic | JLC SMT assembly | https://jlcpcb.com/partdetail/C6186 https://cart.jlcpcb.com/shoppingCart/smtGood/getComponentDetail?componentCode=C6186 https://www.lcsc.com/product-detail/voltage-regulators-linear-low-drop-out-ldo-regulators_advanced-monolithic-systems-ams1117-3-3_C6186.html/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 | 2026-11-05 | 1684743
esp | ESP-12E (ESP8266EX + 4 MB SPI flash, PCB antenna) | U7 | 1 |  | RF_Module:ESP-12E | JLCPCB/LCSC | C89297 | ESP-12E | Extended | JLC SMT assembly | https://jlcpcb.com/partdetail/C89297 https://cart.jlcpcb.com/shoppingCart/smtGood/getComponentDetail?componentCode=C89297 https://www.lcsc.com/product-detail/wifi-modules_ai-thinker-esp-12e_C89297.html/?href=jlc-SMT/?href=jlc-SMT | 2026-11-05 | 1588
xtal | 16 MHz, CL 18 pF, 3225 SMD (X322516MRB4SI) | Y1 Y2 Y3 Y4 | 4 |  | Crystal:Crystal_SMD_3225-4Pin_3.2x2.5mm | JLCPCB/LCSC | C70562 | X322516MRB4SI | Extended | JLC SMT assembly | https://jlcpcb.com/partdetail/C70562 https://cart.jlcpcb.com/shoppingCart/smtGood/getComponentDetail?componentCode=C70562 https://www.lcsc.com/product-detail/crystals_yxc-crystal-oscillators-x322516mrb4si_C70562.html/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 | 2026-11-05 | 29987
