Yuchan-00/CanSat_EDF_Rocket/pcb/vtol_carrier/out/vtol_carrier_bom.csv

Refs | Value | Footprint | Qty | DNP | Description
C1,C2,C4,C9,C10,C12,C17,C18,C20,C25,C26,C28,C54 | 100n | Capacitor_SMD:C_0402_1005Metric | 13 |  | COM AVCC decoupling,COM VCC pin 21 decoupling,COM VCC pin 52 decoupling,ESP-12E VCC decoupling (at pin 8, own GND via),FCU AVCC decoupling,FCU VCC pin 21 decoupling,FCU VCC pin 52 decoupling,GNS AVCC decoupling,GNS VCC pin 21 decoupling,GNS VCC pin 52 decoupling,NAV AVCC decoupling,NAV VCC pin 21 decoupling,NAV VCC pin 52 decoupling
C3,C11,C19,C27,C44,C53,C56 | 10u | Capacitor_SMD:C_0805_2012Metric | 7 |  | AMS1117 input capacitor,COM local bulk,ESP-12E VCC ceramic,FCU local bulk,GNS local bulk,GPS supply bulk at the connector,NAV local bulk
C5,C8,C13,C16,C21,C24,C29,C32,C46,C48,C49,C50,C51,C55 | 100n | Capacitor_SMD:C_0603_1608Metric | 14 |  | COM AREF capacitor (internal 2.56 V reference),COM reset capacitor,ESP EN RC delay (enable after the 3.3 V rail has settled),FCU AREF capacitor (internal 2.56 V reference),FCU reset capacitor,GNS AREF capacitor (internal 2.56 V reference),GNS reset capacitor,NAV AREF capacitor (internal 2.56 V reference),NAV reset capacitor,PF0 divider filter,PF1 divider filter,PF2 divider filter,arm input filter,logic battery divider filter (NEW)
C6,C7,C14,C15,C22,C23,C30,C31 | 27p | Capacitor_SMD:C_0402_1005Metric | 8 |  | COM crystal load cap,FCU crystal load cap,GNS crystal load cap,NAV crystal load cap
C41,C42 | 22u 10V | Capacitor_SMD:C_1206_3216Metric | 2 |  | boost input capacitor 1,boost input capacitor 2
C43 | 22u | Capacitor_SMD:C_1206_3216Metric | 1 |  | 5 V rail bulk at the boost output
C45 | 22u 10V tantalum | Capacitor_Tantalum_SMD:CP_EIA-3216-18_Kemet-A | 1 |  | AMS1117 output capacitor (stability, ESR)
C47 | 220u 10V | Capacitor_SMD:CP_Elec_6.3x5.4 | 1 |  | servo rail bulk capacitor
C52 | 100u 10V tantalum | Capacitor_Tantalum_SMD:CP_EIA-3528-21_Kemet-B | 1 |  | ESP-12E bulk (TX bursts), at the VCC pin
D1,D2,D3,D4 | LED 0603 (colour A) | LED_SMD:LED_0603_1608Metric | 4 |  | COM status LED,FCU status LED,GNS status LED,NAV status LED
D6 | SS14 / B5819W class Schottky | Diode_SMD:D_SOD-123 | 1 |  | buzzer flyback diode
J1 | 1x8 2.54 mm (GY-521 soldered flat on straight pins) | Connector_PinHeader_2.54mm:PinHeader_1x08_P2.54mm_Vertical | 1 |  | IMU module GY-521 MPU-6050 [SZH-EK007]
J2 | 1x6 2.54 mm right-angle socket (module lies flat) | Connector_PinSocket_2.54mm:PinSocket_1x06_P2.54mm_Horizontal | 1 |  | barometer module BMP280 [TYE-BMP29]
J3 | 2x3 2.54 mm vertical: ESP-12E programming header (3.3 V logic ONLY) | Connector_PinHeader_2.54mm:PinHeader_2x03_P2.54mm_Vertical | 1 | DNP | ESP-12E flash header: 1 IO0, 2 GND, 3 TXD0, 4 RXD0, 5 RST, 6 GND [DNP]
J5 | 1x6 2.54 mm right-angle socket: OpenLog lies FLAT beside it (outline reserved) | Connector_PinSocket_2.54mm:PinSocket_1x06_P2.54mm_Horizontal | 1 |  | OpenLog logger (microSD) on the carrier
J6 | 1x5 2.54 mm: Pololu S9V11F5S6CMA 5 V step-up/step-down module (VOUT, GND, VIN, EN, PG) | Connector_PinHeader_2.54mm:PinHeader_1x05_P2.54mm_Vertical | 1 |  | 5 V regulator module (boost from the 1S pack, adjustable low-voltage cut-off)
J7 | JST-GH 1.25 mm 4-pin vertical (top entry) | Connector_JST:JST_GH_BM04B-GHS-TBT_1x04-1MP_P1.25mm_Vertical | 1 |  | GPS lead (u-blox NEO-7M module in the top cap)
J8,J9,J10,J11,J12 | 1x3 2.54 mm right-angle header (S, +, -) | Connector_PinHeader_2.54mm:PinHeader_1x03_P2.54mm_Horizontal | 5 |  | ESC lead (signal, BEC +5 V out, GND),vane servo 1 lead (SIG, V+, GND),vane servo 2 lead (SIG, V+, GND),vane servo 3 lead (SIG, V+, GND),vane servo 4 lead (SIG, V+, GND)
J14 | Molex SPOX 5267-02A 2.50 mm 2-pin vertical (mates the pack's 5264-type housing, A) | Connector_Molex:Molex_SPOX_5267-02A_1x02_P2.50mm_Vertical | 1 |  | logic battery input (1S Li-Po DTP105565P 3.7 V 4200 mAh ONLY, separate from the 6S)
J15 | JST-PH 2.0 2-pin vertical: lead to an external logic power switch | Connector_JST:JST_PH_B2B-PH-K_1x02_P2.00mm_Vertical | 1 |  | logic power switch
J16 | 1x2 right-angle header | Connector_PinHeader_2.54mm:PinHeader_1x02_P2.54mm_Horizontal | 1 |  | arming switch lead (top cap toggle, switch to GND)
J17 | JST-PH 2.0 2-pin vertical (top entry) | Connector_JST:JST_PH_B2B-PH-K_1x02_P2.00mm_Vertical | 1 |  | buzzer lead (5 V active buzzer in the misc box)
J18 | 1x4 right-angle header | Connector_PinHeader_2.54mm:PinHeader_1x04_P2.54mm_Horizontal | 1 |  | power-sense lead: V_in (6S bus), V_tether, V_buffer, buffer-current sign
J19,J20,J21,J22 | AVR ISP 2x3 (USBasp) | Connector_PinHeader_2.54mm:PinHeader_2x03_P2.54mm_Vertical | 4 | DNP | COM ISP header (MOSI = PE0/PDI, MISO = PE1/PDO, SCK = PB1) [DNP],FCU ISP header (MOSI = PE0/PDI, MISO = PE1/PDO, SCK = PB1) [DNP],GNS ISP header (MOSI = PE0/PDI, MISO = PE1/PDO, SCK = PB1) [DNP],NAV ISP header (MOSI = PE0/PDI, MISO = PE1/PDO, SCK = PB1) [DNP]
J24,J25,J26 | 2-pin header + shunt | Connector_PinHeader_2.54mm:PinHeader_1x02_P2.54mm_Vertical | 3 | DNP | COM reset hold (shunt on = COM held in reset) [DNP],FCU reset hold (shunt on = FCU held in reset) [DNP],NAV reset hold (shunt on = NAV held in reset) [DNP]
L1,L2,L3,L4 | 10uH | Inductor_SMD:L_0805_2012Metric | 4 |  | COM AVCC filter inductor,FCU AVCC filter inductor,GNS AVCC filter inductor,NAV AVCC filter inductor
Q1,Q2,Q4,Q5,Q6,Q7,Q8,Q11 | BSS138 | Package_TO_SOT_SMD:SOT-23 | 8 |  | level shifter channel: COM PC6 -> ESP-12E RST (pin 1, active low),level shifter channel: COM PD3 TXD1 -> ESP-12E RXD0 (GPIO3, pin 21),level shifter channel: ESP-12E TXD0 (GPIO1) -> COM PD2 RXD1,level shifter channel: FCU PE1 TXD0 -> OpenLog RXI (57600 8N1),level shifter channel: GNS PD3 TXD1 -> GPS RXD (38400 8N1),level shifter channel: GPS TXD -> GNS PD2 RXD1,level shifter channel: NAV I2C SCL (400 kHz),level shifter channel: NAV I2C SDA
Q3 | BSS138 | Package_TO_SOT_SMD:SOT-23 | 1 | DNP | level shifter channel: GY-521 INT -> NAV PE6/INT6 (firmware polls; optional) [DNP]
Q9 | MMBT3904 | Package_TO_SOT_SMD:SOT-23 | 1 |  | buzzer low-side driver
Q10 | AO3401A (-30 V, -4 A, Vgs(th) -0.5..-1.3 V, Rds(on) <= 85 mOhm at Vgs -2.5 V: A) | Package_TO_SOT_SMD:SOT-23 | 1 |  | reverse-polarity protection (P-MOSFET, high side)
R1,R3,R5,R7,R11,R14,R23,R24,R25,R26,R27,R29,R31,R38,R40,R41,R43,R45,R46,R48,R49,R50,R51,R52,R53,R55,R56,R57,R58,R59,R60,R61,R62 | 10k | Resistor_SMD:R_0603_1608Metric | 33 |  | COM reset pull-up,ESC signal pull-down (motor off while the FCU boots / resets),ESP EN (CH_PD) pull-up,ESP GPIO0 boot-strap pull-up (run from flash),ESP GPIO15 boot-strap pull-down,ESP GPIO2 boot-strap pull-up,FCU reset pull-up,GNS reset pull-up,NAV reset pull-up,Q1 LV (3.3 V) pull-up,Q10 gate resistor,Q11 HV (5 V) pull-up,Q11 LV (3.3 V) pull-up,Q2 LV (3.3 V) pull-up,Q3 HV (5 V) pull-up,Q4 HV (5 V) pull-up,Q4 LV (3.3 V) pull-up,Q5 HV (5 V) pull-up,Q5 LV (3.3 V) pull-up,Q6 HV (5 V) pull-up,Q6 LV (3.3 V) pull-up,Q7 HV (5 V) pull-up,Q7 LV (3.3 V) pull-up,Q8 HV (5 V) pull-up,Q8 LV (3.3 V) pull-up,VANE1 PWM pull-down (servo line low while the FCU boots / is held in reset),VANE2 PWM pull-down (servo line low while the FCU boots / is held in reset),VANE3 PWM pull-down (servo line low while the FCU boots / is held in reset),VANE4 PWM pull-down (servo line low while the FCU boots / is held in reset),arm input external pull-up (in addition to the internal one),buffer-current sign series resistor,buzzer driver base pull-down (off during reset),nlink SS pull-up (FCU idle-high while the NAV is in reset / programmed)
R2,R4,R6,R8,R12,R13,R28,R30,R54 | 1k | Resistor_SMD:R_0603_1608Metric | 9 |  | COM status LED resistor,ESP RXD0 series resistor (a programmer on J3 wins against the COM side),FCU status LED resistor,GNS status LED resistor,NAV status LED resistor,arm input series resistor (ESD / lead noise),buzzer driver base resistor,glink series resistor NAV TXD1 -> GNS RXD0 (like the ilink one),ilink series resistor FCU TXD1 -> COM RXD0
R15,R16,R32,R34,R36 | 47k 1% | Resistor_SMD:R_0603_1608Metric | 5 |  | PF0 divider top,PF1 divider top,PF2 divider top,logic battery divider bottom (NEW),logic battery divider top (NEW, firmware does not read PF3 yet)
R17,R18,R19,R20,R21 | 220 | Resistor_SMD:R_0603_1608Metric | 5 |  | ESC signal series resistor (long lead, back-power limit),VANE1 signal series resistor (long lead, back-power limit),VANE2 signal series resistor (long lead, back-power limit),VANE3 signal series resistor (long lead, back-power limit),VANE4 signal series resistor (long lead, back-power limit)
R33,R35,R37 | 4.7k 1% | Resistor_SMD:R_0603_1608Metric | 3 |  | PF0 divider bottom,PF1 divider bottom,PF2 divider bottom
R39 | 100k | Resistor_SMD:R_0603_1608Metric | 1 |  | buffer-current sign pull-down (battery / tether builds: reads low)
R42,R44 | 4.7k | Resistor_SMD:R_0603_1608Metric | 2 |  | Q1 HV (5 V) pull-up,Q2 HV (5 V) pull-up
R47 | 10k | Resistor_SMD:R_0603_1608Metric | 1 | DNP | Q3 LV (3.3 V) pull-up [DNP]
U1,U2,U3,U4 | ATmega128A-AU 16 MHz 5 V | Package_QFP:TQFP-64_14x14mm_P0.8mm | 4 |  | COM microcontroller,FCU microcontroller,GNS microcontroller,NAV microcontroller
U6 | AMS1117-3.3 | Package_TO_SOT_SMD:SOT-223-3_TabPin2 | 1 |  | 3.3 V LDO (ESP-12E, BMP280, GPS, shifter LV side)
U7 | ESP-12E (ESP8266EX + 4 MB SPI flash, PCB antenna) | RF_Module:ESP-12E | 1 |  | Wi-Fi radio: transparent UART <-> Wi-Fi bridge for the COM (no flight computing on it)
Y1,Y2,Y3,Y4 | 16 MHz, CL 18 pF, 3225 SMD (X322516MRB4SI) | Crystal:Crystal_SMD_3225-4Pin_3.2x2.5mm | 4 |  | COM crystal,FCU crystal,GNS crystal,NAV crystal
