Yuchan-00/CanSat_EDF_Rocket/cad/exports/print/intake_module.3mf

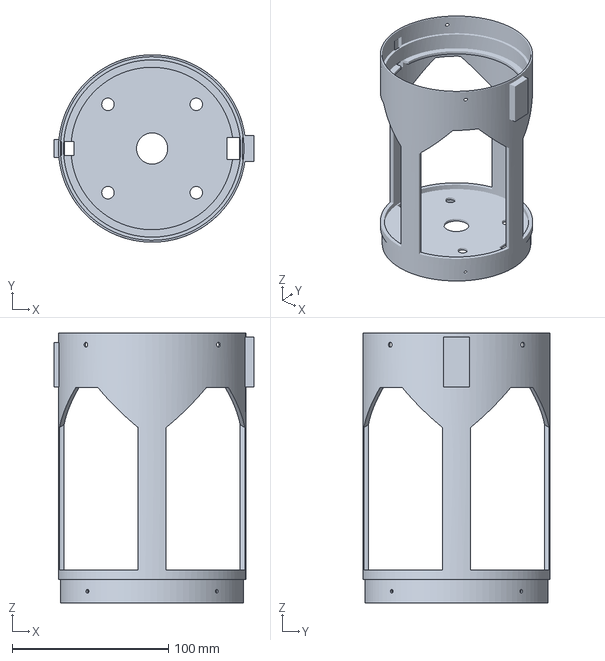
[picture p42: CAD file, 2026-11-04]
cad/exports/print/intake_module.3mf
127.9 x 120.0 x 172.9 mm
