Yuchan-00/CanSat_EDF_Rocket/cad/exports/print/provisional_v081_cadquery/payload_module.3mf

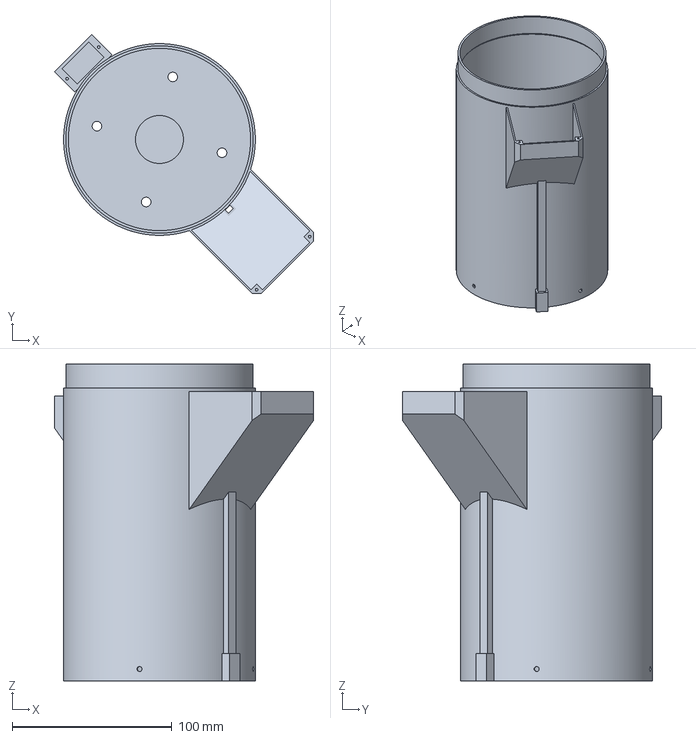
[picture p43: CAD file, 2026-11-04]
cad/exports/print/provisional_v081_cadquery/payload_module.3mf
162.2 x 162.2 x 198.4 mm
