Yuchan-00/CanSat_EDF_Rocket/cad/exports/print/provisional_v09_cadquery_vtol/avionics_module.3mf

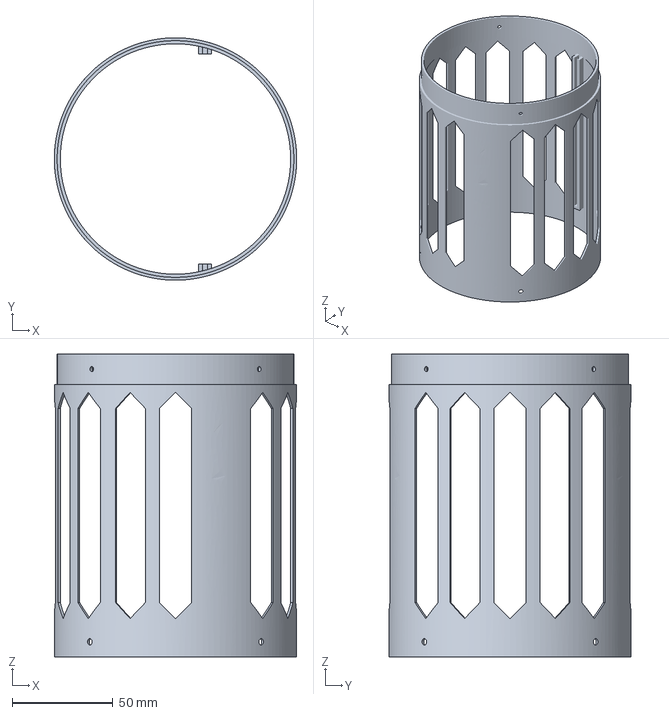
[picture p44: CAD file, 2026-11-10]
cad/exports/print/provisional_v09_cadquery_vtol/avionics_module.3mf
120.0 x 120.0 x 150.0 mm
