Yuchan-00/CanSat_EDF_Rocket/pcb/vtol_carrier/out/vtol_carrier.step

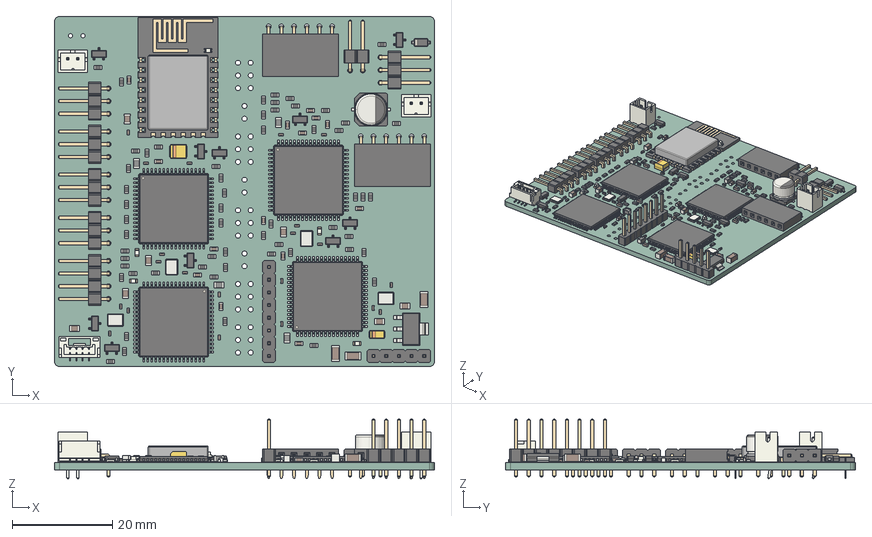
[picture p45: CAD file, 2026-11-05]
pcb/vtol_carrier/out/vtol_carrier.step
76.0 x 70.0 x 11.9 mm
R_0603_1608Metric x 58
JST_B2B_PH_K x 2
C_0402_1005Metric x 21
LED_0603_1608Metric x 4
C_0603_1608Metric x 14
C_1206_3216Metric x 3
SOT-23 x 10
L_0805_2012Metric x 4
PinHeader_1x03_P254mm_Horizontal x 5
PinHeader_1x02_P254mm_Horizontal
CP_Elec_63x54
PinHeader_1x04_P254mm_Horizontal
PinSocket_1x06_P2.54mm_Horizontal x 2
JST_BM04B_GHS_TBT
TQFP-64_14x14mm_P0.8mm x 4
CP_EIA_3528_21_Kemet_B
PinHeader_1x08_P254mm_Vertical
Crystal_SMD_3225-4Pin_3.2x2.5mm x 4
C_0805_2012Metric x 7
ESP_12E001_cp
CP_EIA_3216_18_Kemet_A
D_SOD-123
PinHeader_1x05_P254mm_Vertical
SOT-223
vtol_carrier_PCB
