Yuchan-00/CanSat_EDF_Rocket/cad/exports/print/provisional_v081_cadquery/avionics_module.3mf

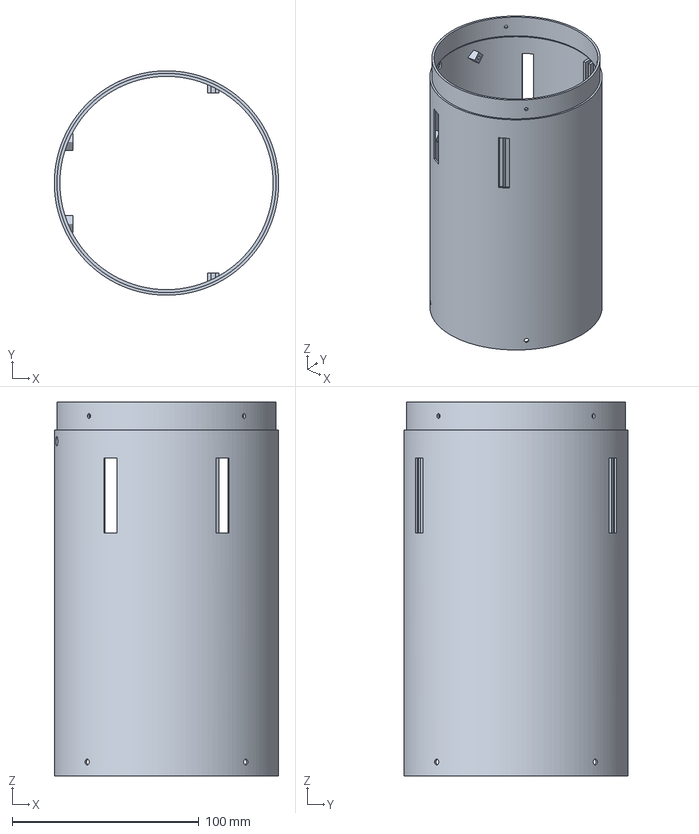
[picture p46: CAD file, 2026-11-04]
cad/exports/print/provisional_v081_cadquery/avionics_module.3mf
120.0 x 120.0 x 200.0 mm
