Yuchan-00/CanSat_EDF_Rocket/cad/exports/print/provisional_v09_cadquery_vtol/vane_coupler.3mf

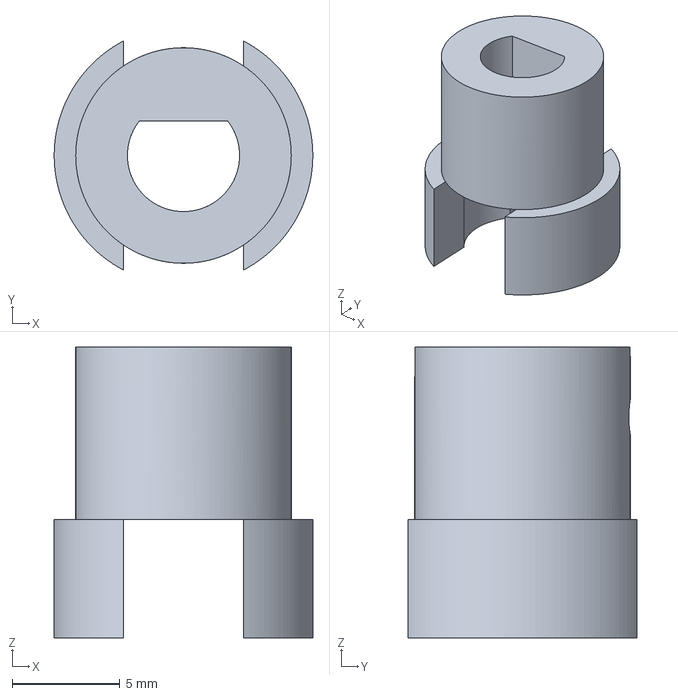
[picture p47: CAD file, 2026-11-10]
cad/exports/print/provisional_v09_cadquery_vtol/vane_coupler.3mf
12.0 x 10.6 x 13.5 mm
