Yuchan-00/CanSat_EDF_Rocket/cad/exports/print/provisional_v081_cadquery/gps_pod_lid.3mf

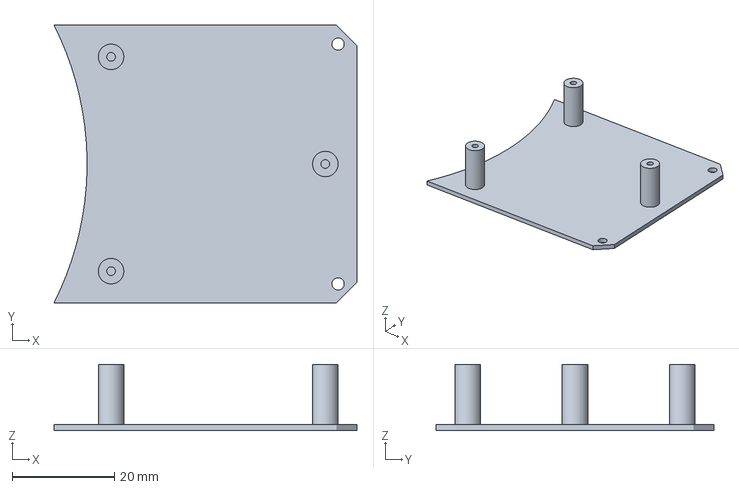
[picture p48: CAD file, 2026-11-04]
cad/exports/print/provisional_v081_cadquery/gps_pod_lid.3mf
59.4 x 54.4 x 13.0 mm
