Yuchan-00/CanSat_EDF_Rocket/cad/exports/print/provisional_v09_cadquery_vtol/vane.3mf

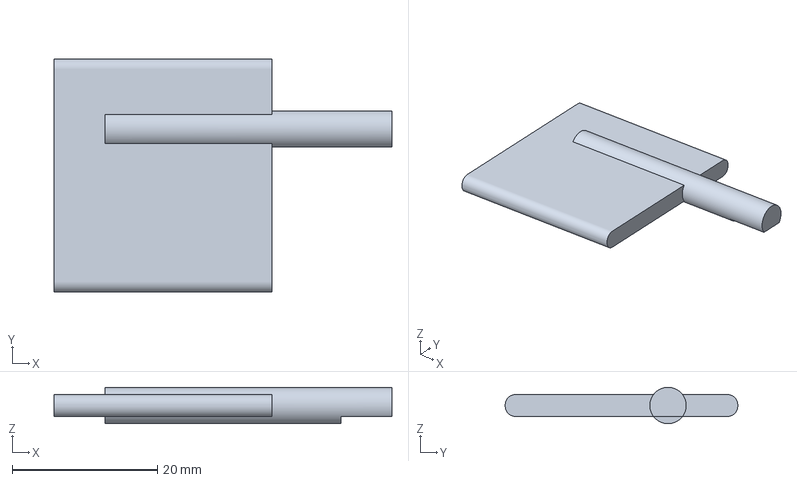
[picture p49: CAD file, 2026-11-10]
cad/exports/print/provisional_v09_cadquery_vtol/vane.3mf
46.5 x 32.0 x 5.00 mm
