Yuchan-00/CanSat_EDF_Rocket/cad/exports/print/provisional_v09_cadquery_vtol/wire_cover.3mf

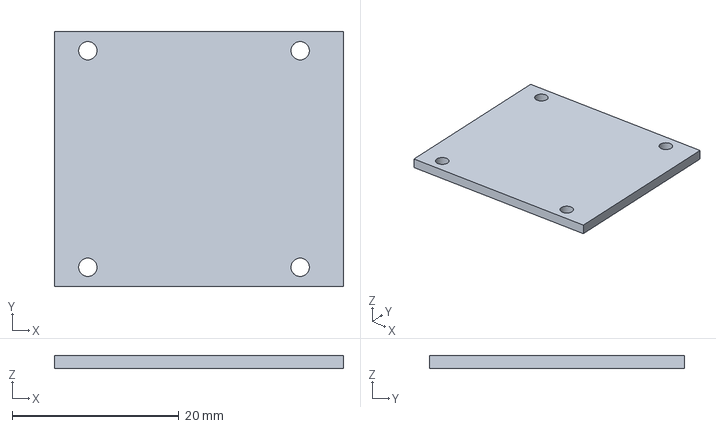
[picture p50: CAD file, 2026-11-10]
cad/exports/print/provisional_v09_cadquery_vtol/wire_cover.3mf
34.7 x 30.6 x 1.60 mm
