Yuchan-00/CanSat_EDF_Rocket/cad/exports/print/provisional_v09_cadquery_vtol/servo_cover.3mf

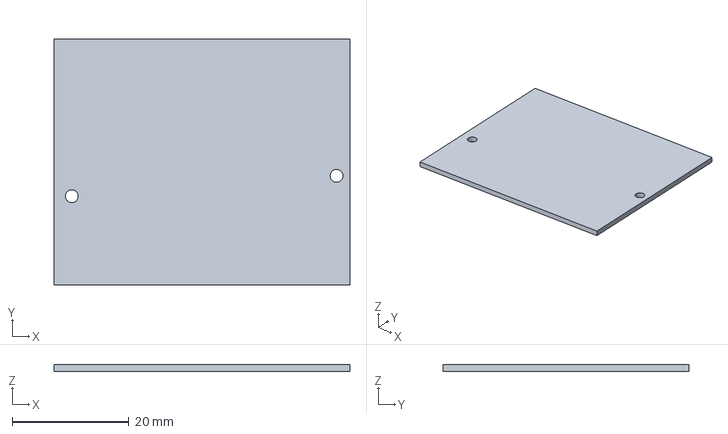
[picture p51: CAD file, 2026-11-10]
cad/exports/print/provisional_v09_cadquery_vtol/servo_cover.3mf
50.8 x 42.3 x 1.20 mm
