Yuchan-00/CanSat_EDF_Rocket/cad/exports/print/provisional_v09_cadquery_vtol/avionics_tray.3mf

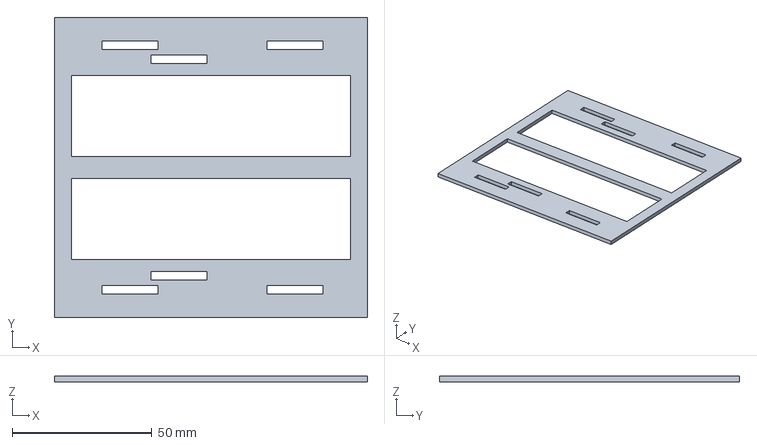
[picture p52: CAD file, 2026-11-10]
cad/exports/print/provisional_v09_cadquery_vtol/avionics_tray.3mf
112.0 x 107.5 x 2.00 mm
