Yuchan-00/CanSat_EDF_Rocket/cad/exports/print/provisional_v09_cadquery_vtol/top_cap.3mf

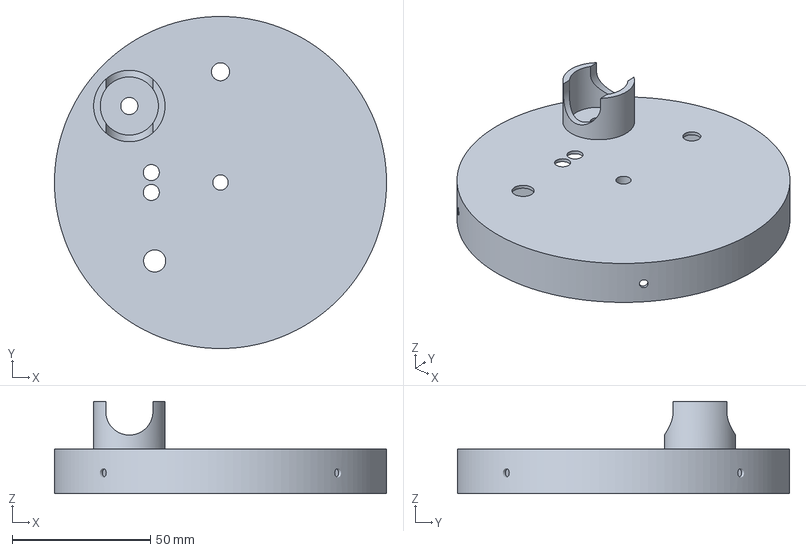
[picture p53: CAD file, 2026-11-10]
cad/exports/print/provisional_v09_cadquery_vtol/top_cap.3mf
120.0 x 120.0 x 33.4 mm
