Yuchan-00/CanSat_EDF_Rocket/cad/exports/print/provisional_v09_cadquery_vtol/propulsion_module.3mf

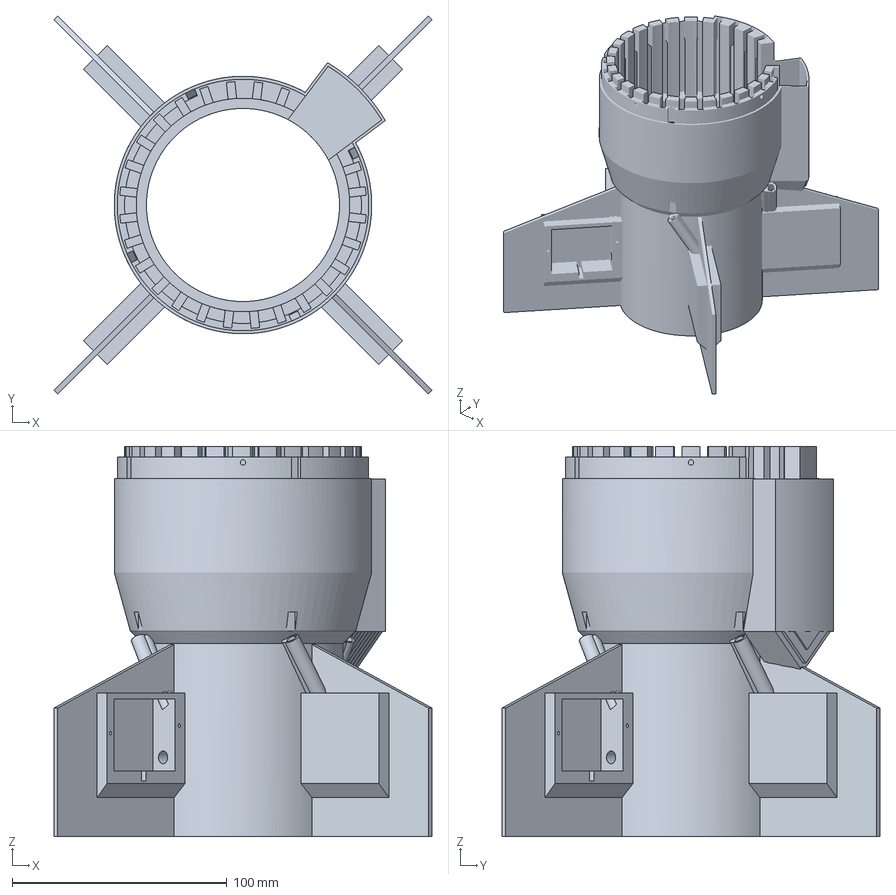
[picture p54: CAD file, 2026-11-10]
cad/exports/print/provisional_v09_cadquery_vtol/propulsion_module.3mf
176.2 x 176.2 x 182.0 mm
