Yuchan-00/CanSat_EDF_Rocket/pcb/vtol_carrier/archive/rev1_plm100_2s/out/vtol_carrier.step

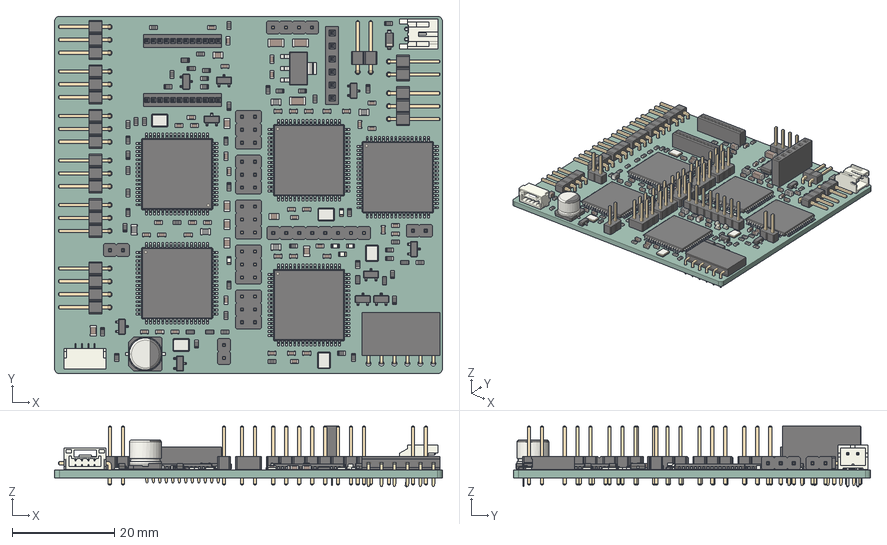
[picture p55: CAD file, 2026-11-05, an earlier design]
pcb/vtol_carrier/archive/rev1_plm100_2s/out/vtol_carrier.step
76.0 x 70.0 x 11.9 mm
PinHeader_1x02_P254mm_Vertical x 3
R_0603_1608Metric x 52
C_0603_1608Metric x 42
LED_0603_1608Metric x 5
C_0805_2012Metric x 8
JST_S2B_PH_K
C_1206_3216Metric x 3
PinHeader_1x03_P254mm_Horizontal x 6
SOT-23 x 10
L_0805_2012Metric x 5
PinHeader_1x02_P254mm_Horizontal x 2
PinHeader_1x04_P254mm_Horizontal
Crystal_SMD_3225-4Pin_3.2x2.5mm x 5
PinSocket_1x06_P2.54mm_Horizontal
JST_SM04B_GHS_TB
TQFP-64_14x14mm_P0.8mm x 5
PinSocket_1x12_P1.27mm_Vertical x 2
PinHeader_1x08_P254mm_Vertical
PinHeader_2x03_P254mm_Vertical x 5
D_SOD-123
PinSocket_1x06_P2.54mm_Vertical
PinHeader_1x04_P254mm_Vertical
SOT-223
CP_Elec_63x58
vtol_carrier_PCB
