Yuchan-00/CanSat_EDF_Rocket/(list of files, cad)

Other CAD files:
cad/exports/print/provisional_v09_cadquery_vtol/intake_module.3mf
cad/exports/print/provisional_v080_cadquery/avionics_module.3mf
cad/exports/print/provisional_v09_cadquery/avionics_module.3mf
cad/exports/print/provisional_v080_cadquery/payload_module.3mf
cad/exports/print/provisional_v080_cadquery/gps_pod_lid.3mf
cad/exports/print/provisional_v09_cadquery/avionics_tray.3mf
cad/exports/print/provisional_v09_cadquery/gps_pod_lid.3mf
cad/exports/print/provisional_v09_cadquery/intake_module.3mf
cad/exports/print/provisional_v09_cadquery/latch_arm.3mf
cad/exports/print/provisional_v09_cadquery/launch_pad.3mf
cad/exports/print/provisional_v09_cadquery/nose_cone.3mf
cad/exports/print/provisional_v09_cadquery/payload_module.3mf
cad/exports/print/provisional_v09_cadquery/piston.3mf
cad/exports/print/provisional_v09_cadquery/propulsion_module.3mf
cad/exports/print/provisional_v09_cadquery/servo_cover.3mf
cad/exports/print/provisional_v09_cadquery/vane.3mf
cad/exports/print/provisional_v09_cadquery/vane_coupler.3mf
cad/exports/print/provisional_v09_cadquery/wire_cover.3mf
render/human/human_rigged.blend
