Yuchan-00/CanSat_EDF_Rocket/pcb/vtol_carrier/out/schematic/vtol_carrier_schematic.pdf

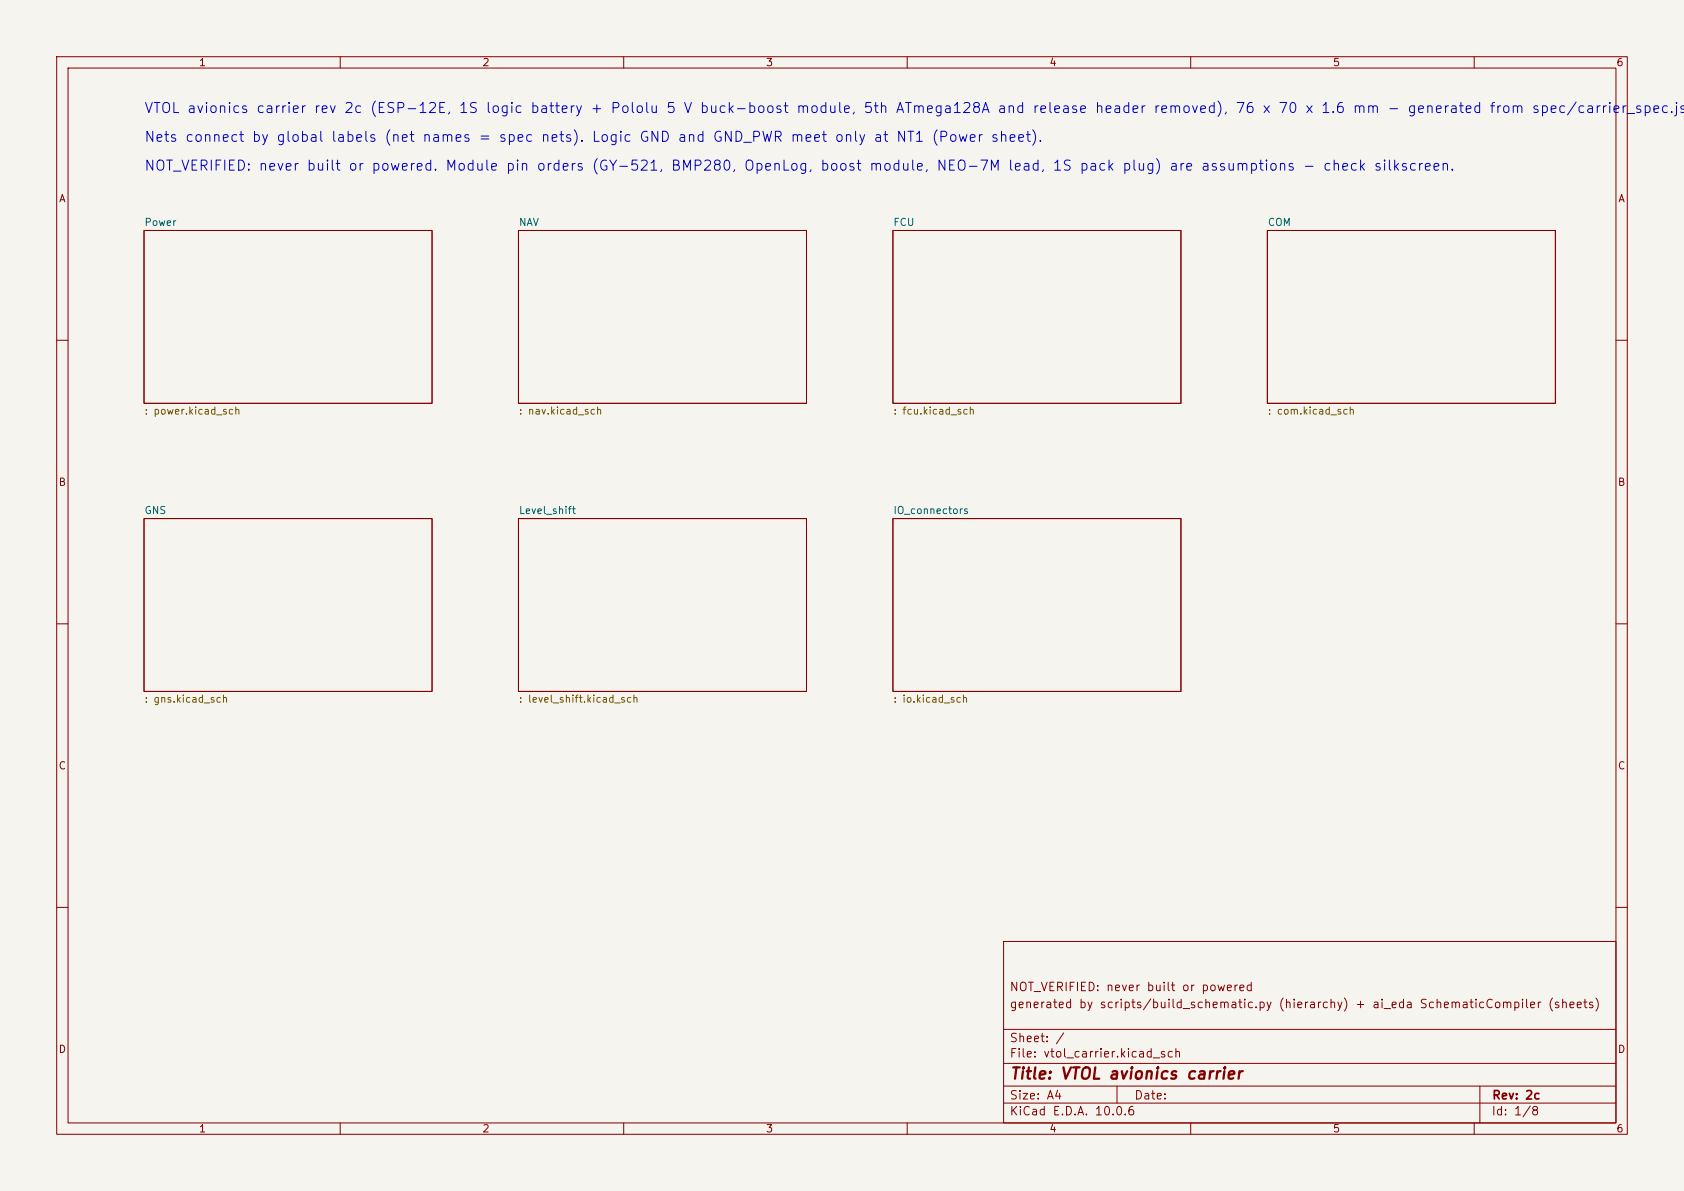
[picture p56: page 1]

파일: io.kicad_sch VTOL avionics carrier rev 2c (ESP-12E, 1S logic battery + Pololu 5 V buck-boost module, 5th ATmega128A and release header removed), 76 x 70 x 1.6 mm - generated from spec/carrier_spec.json
Nets connect by global labels (net names = spec nets). Logic GND and GND_PWR meet only at NT1 (Power sheet).
NOT_VERIFIED: never built or powered. Module pin orders (GY-521, BMP280, OpenLog, boost module, NEO-7M lead, 1S pack plug) are assumptions - check silkscreen.

NOT_VERIFIED: never built or powered
generated by scripts/build_schematic.py (hierarchy) + ai_eda SchematicCompiler (sheets)

Sheet: /
File: vtol_carrier.kicad_sch
Title: VTOL avionics carrier

Size: A4 | Rev: 2c
KiCad E.D.A. 10.0.6 | Id: 1/8

1 | 2 | 3 | 4 | 5 | 6 | 7 | 8 | 9 | 10 | 11
1 | 2 | 3 | 4 | 5 | 6 | 7 | 8 | 9 | 10 | 11

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
### FGH Date:

Size: A2 | Rev: 2c

Title: VTOL carrier - 1S logic battery input, reverse-polarity P-FET, power-switch lead, 5 V boost module, AMS1117-3.3, ground tie, logic-battery monitor

### File: power.kicad_sch

### Sheet: /Power/

generated by scripts/build_schematic.py via ai_eda SchematicCompiler from spec/carrier_spec.json

### NOT_VERIFIED: never built or powered

C41

22u 10V | C43 22u
PWR_FLAG | PWR_FLAG | GND

1

VO | 2
VI 3 | U6
AMS1117-3.3

C46
100n
PWR_FLAG | PWR_FLAG | PWR_FLAG

C42
22u 10V 1

2

J14 Molex SPOX 5267-02A 2.50 mm 2-pin vertical (mates the pack's 5264-type housing, A) | C45 22u 10V tantalum

PWR_FLAG

C44
10u 1

2

J15

JST-PH 2.0 2-pin vertical: lead to an external logic power switch NT1 net tie R16

47k 1%

R15
47k 1%

1
2
3
4
5

J6
1x5 2.54 mm: Pololu S9V11F5S6CMA 5 V step-up/step-down module (VOUT, GND, VIN, EN, PG) | 1

2 3 Q10
AO3401A (-30 V, -4 A, Vgs(th) -0.5..-1.3 V, Rds(on) <= 85 mOhm at Vgs -2.5 V: A) R14
10k FCU_LBAT_ADC GND | +5V GND
VBAT_LOGIC_RAW | VBAT_LOGIC
VBAT_LOGIC_SW GNS_AVCC GND | NAV_AVCC GND +5V GND
VBAT_LOGIC_SW COM_AVCC | FCU_AVCC GND VBAT_LOGIC_SW | VBAT_LOGIC_SW +5V | GND
GND | GND_PWR | VBAT_LOGIC VBAT_LOGIC_RAW +5V GND | GND LBAT_PFET_G
LBAT_PFET_G +5V GND | +3V3 GND FCU_LBAT_ADC VBAT_LOGIC_SW | +3V3 GND FCU_LBAT_ADC

J15
JST-PH 2.0 2-pin vertical: lead to an external logic power switch 1
2 | NT1
net tie | Q10
AO3401A (-30 V, -4 A, Vgs(th) -0.5..-1.3 V, Rds(on) <= 85 mOhm at Vgs -2.5 V: A) 1

2 3 R14

10k

J6

1x5 2.54 mm: Pololu S9V11F5S6CMA 5 V step-up/step-down module (VOUT, GND, VIN, EN, PG) 1 2
3
4
5

J14 Molex SPOX 5267-02A 2.50 mm 2-pin vertical (mates the pack's 5264-type housing, A) 1 2

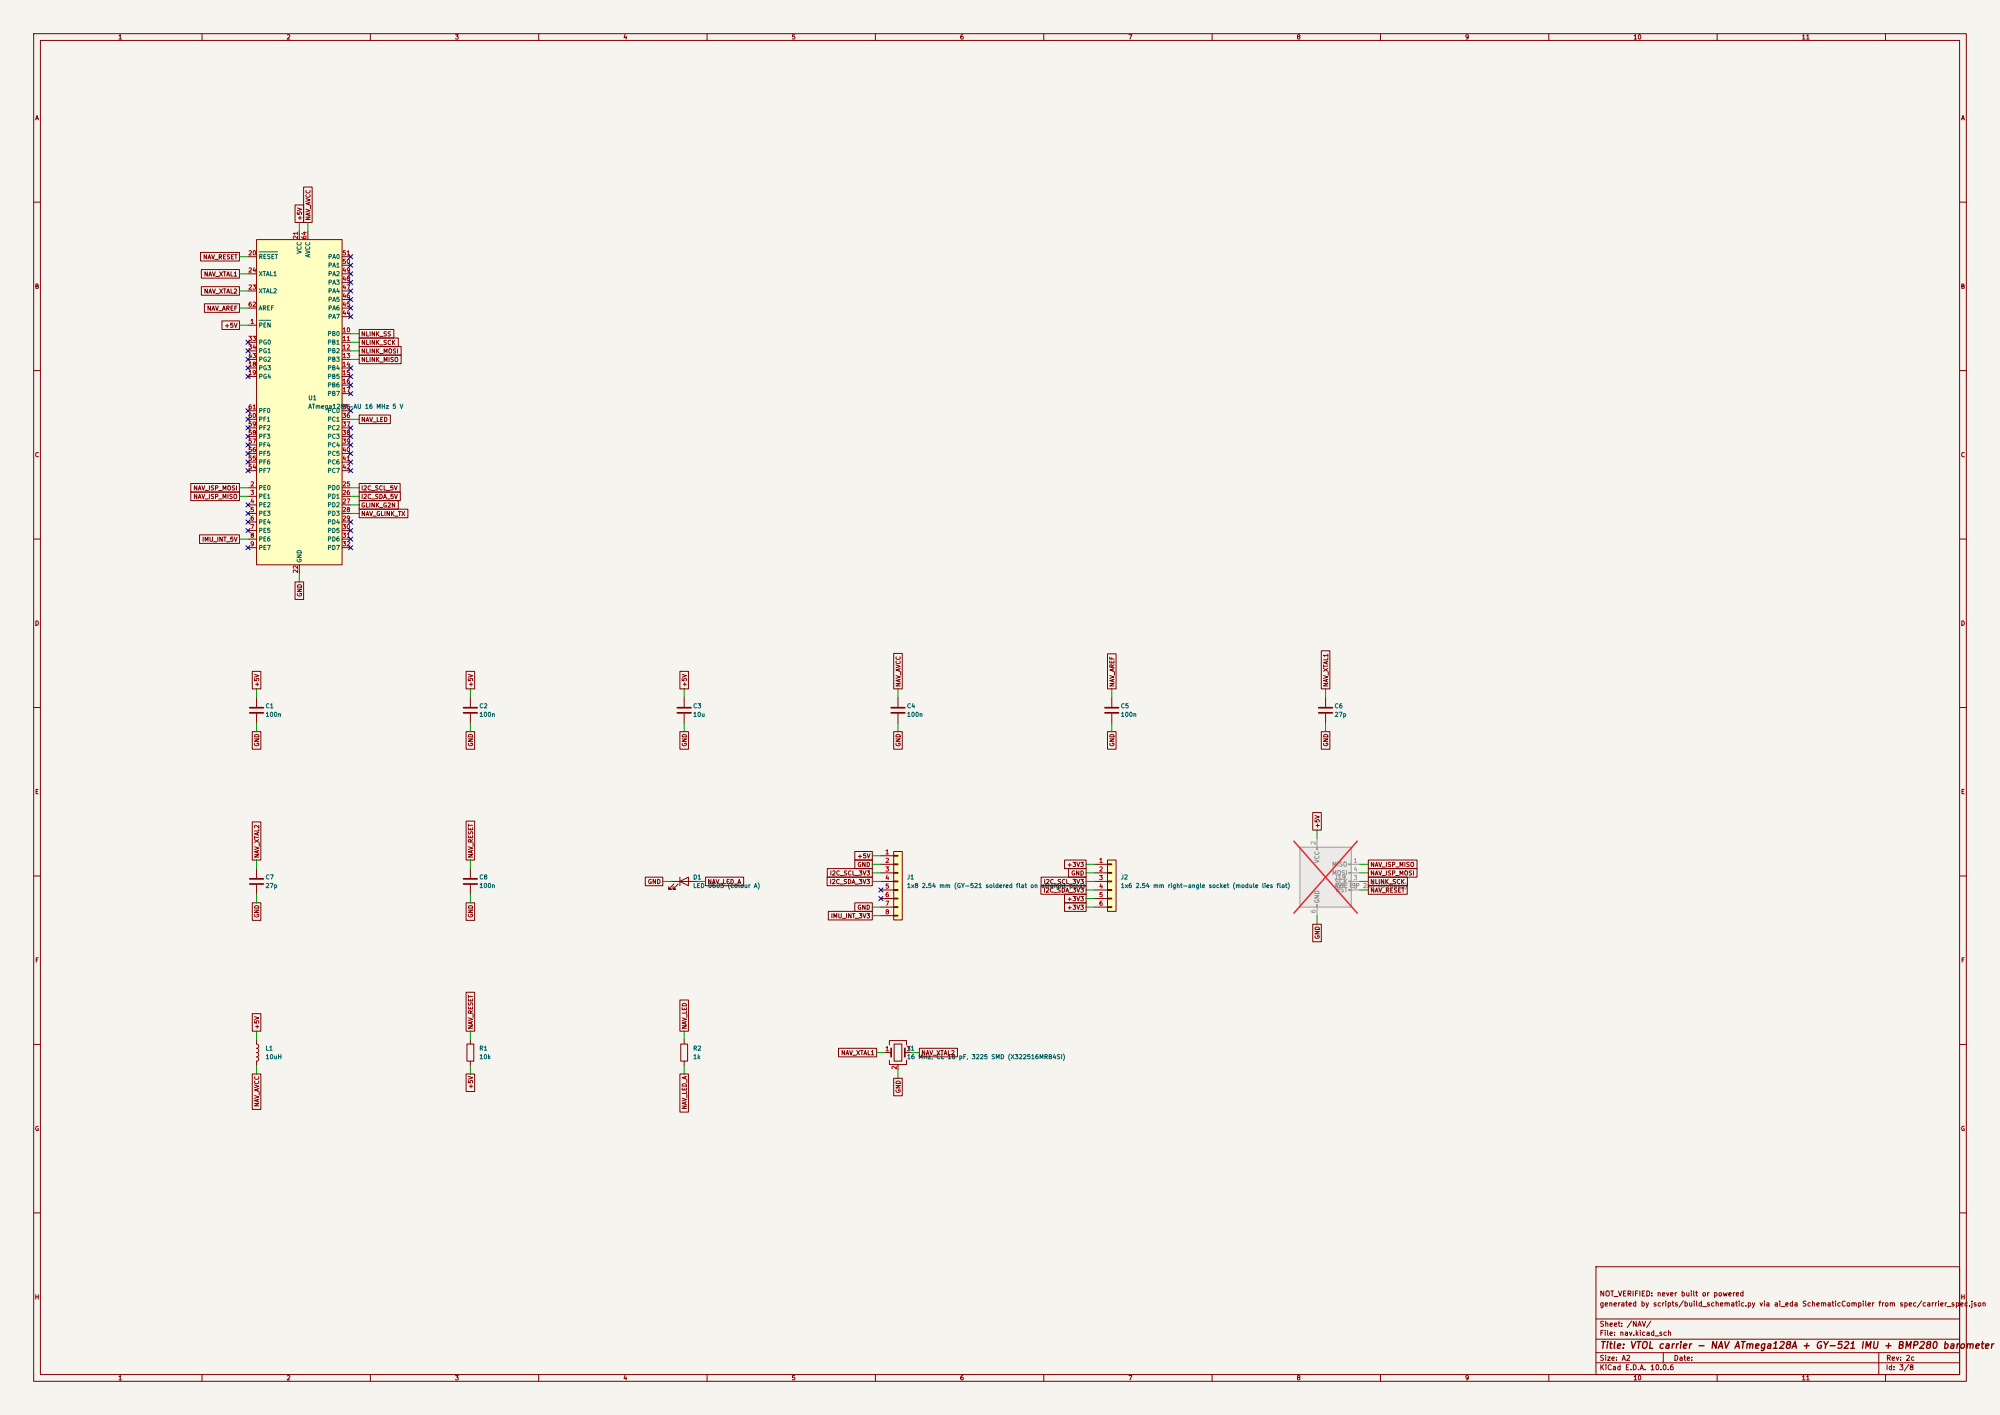
[picture p57: page 3]

1x8 2.54 mm (GY-521 soldered flat on straight pins) L1

1x6 2.54 mm right-angle socket (module lies flat) R2

16 MHz, CL 18 pF, 3225 SMD (X322516MRB4SI)

Sheet: /NAV/
File: nav.kicad_sch
Title: VTOL carrier - NAV ATmega128A + GY-521 IMU + BMP280 barometer

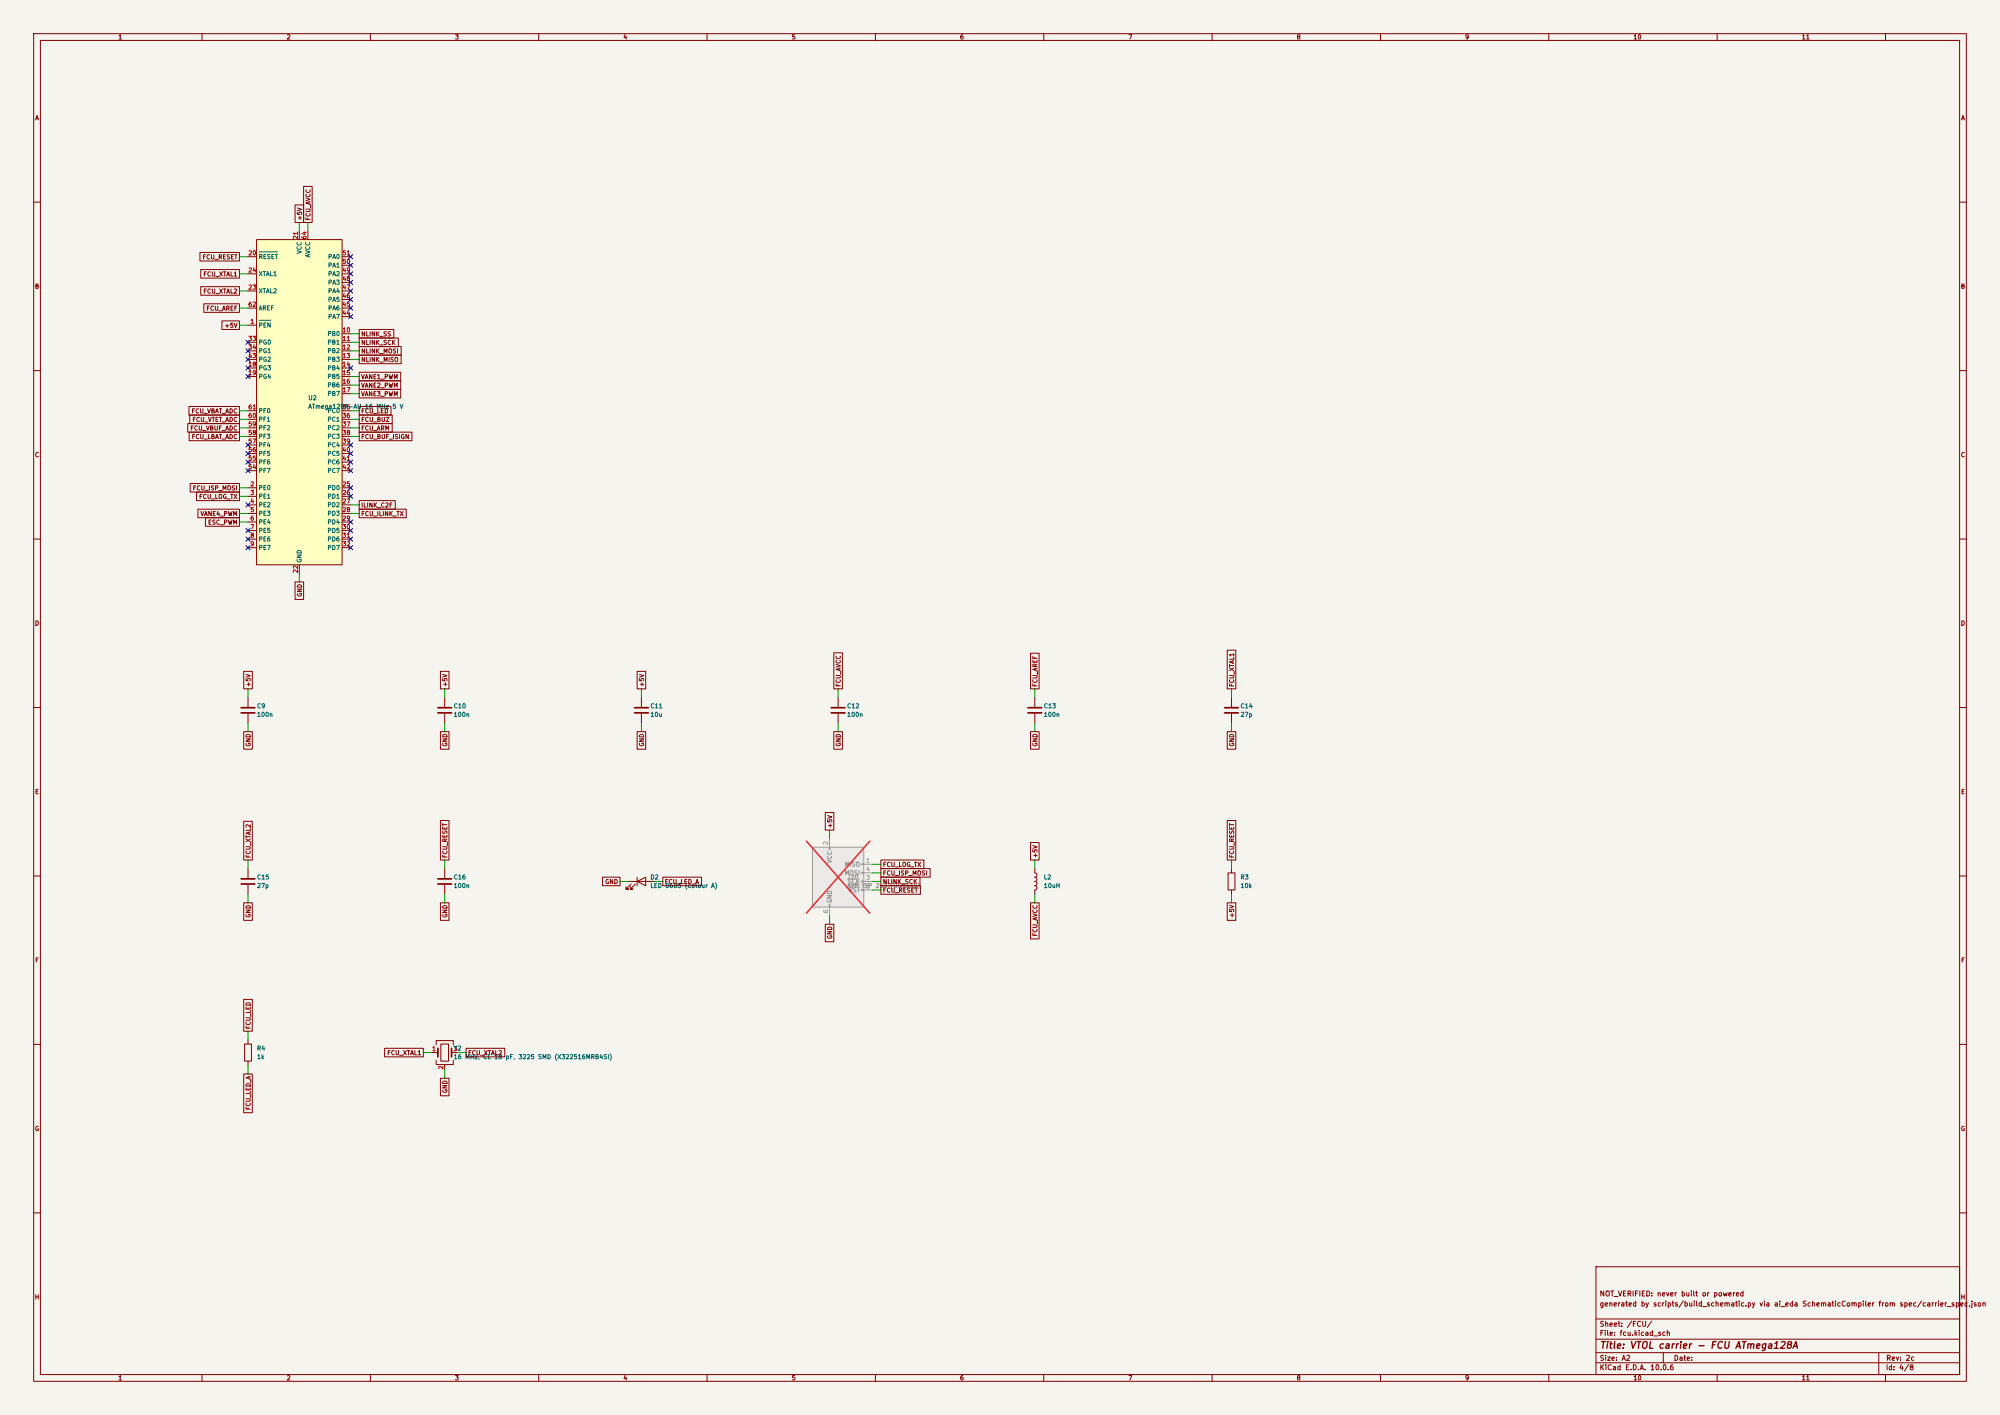
[picture p58: page 4]

FCU_XTAL2
16 MHz, CL 18 pF, 3225 SMD (X322516MRB4SI)

Sheet: /FCU/
File: fcu.kicad_sch
Title: VTOL carrier - FCU ATmega128A

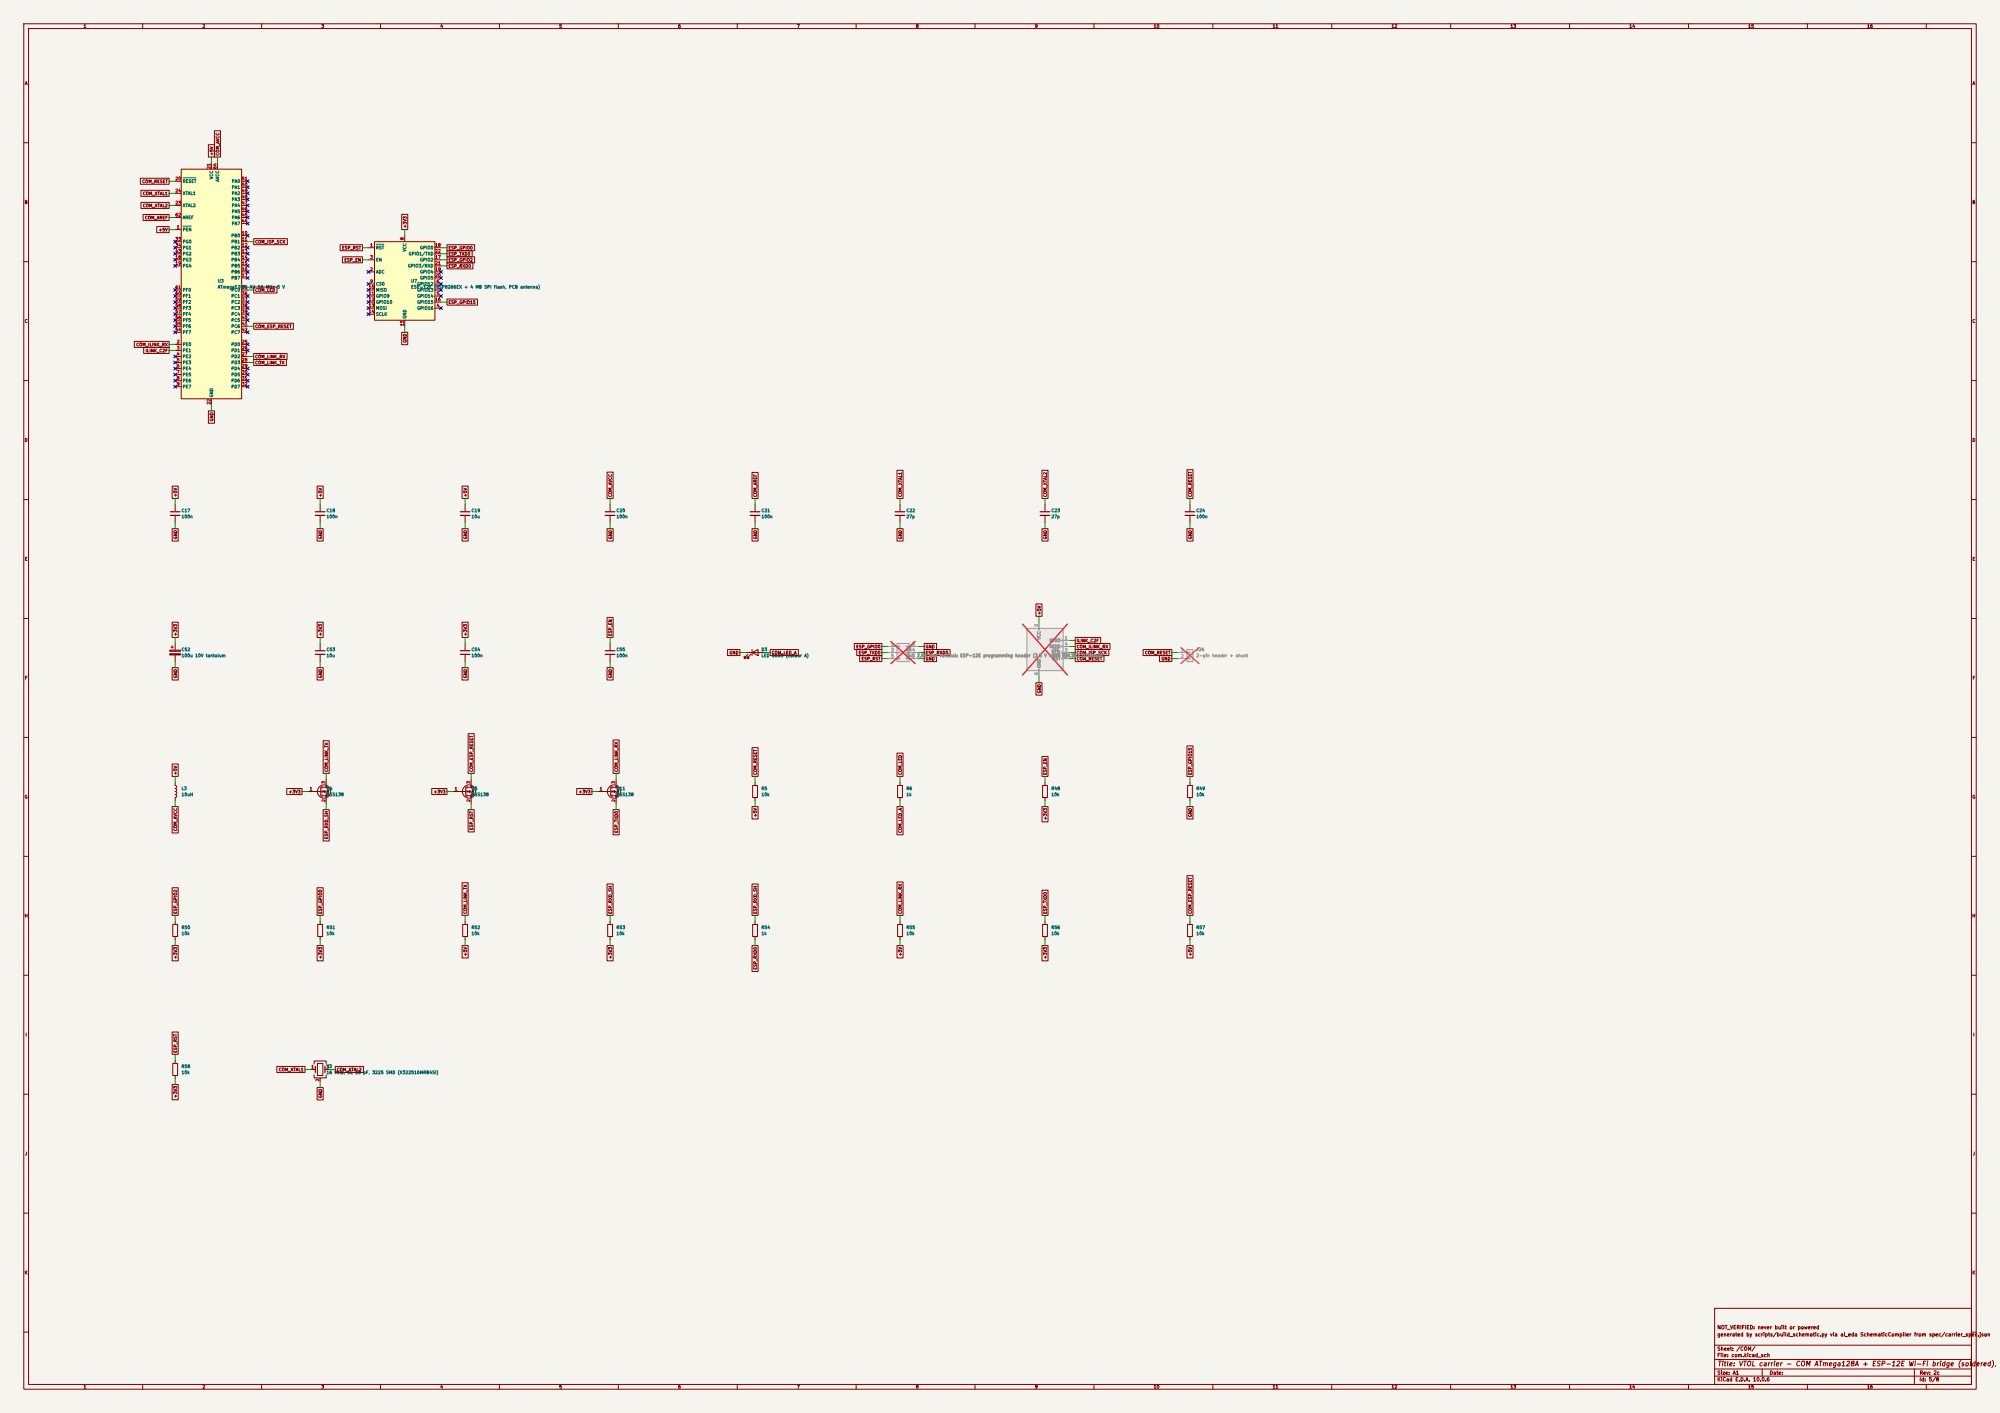
[picture p59: page 5]

AVR ISP 2x3 (USBasp) MISO VCC

16 MHz, CL 18 pF, 3225 SMD (X322516MRB4SI)

Sheet: /COM/
File: com.kicad_sch
Title: VTOL carrier - COM ATmega128A + ESP-12E Wi-Fi bridge (soldered), its shifters, straps and flash header

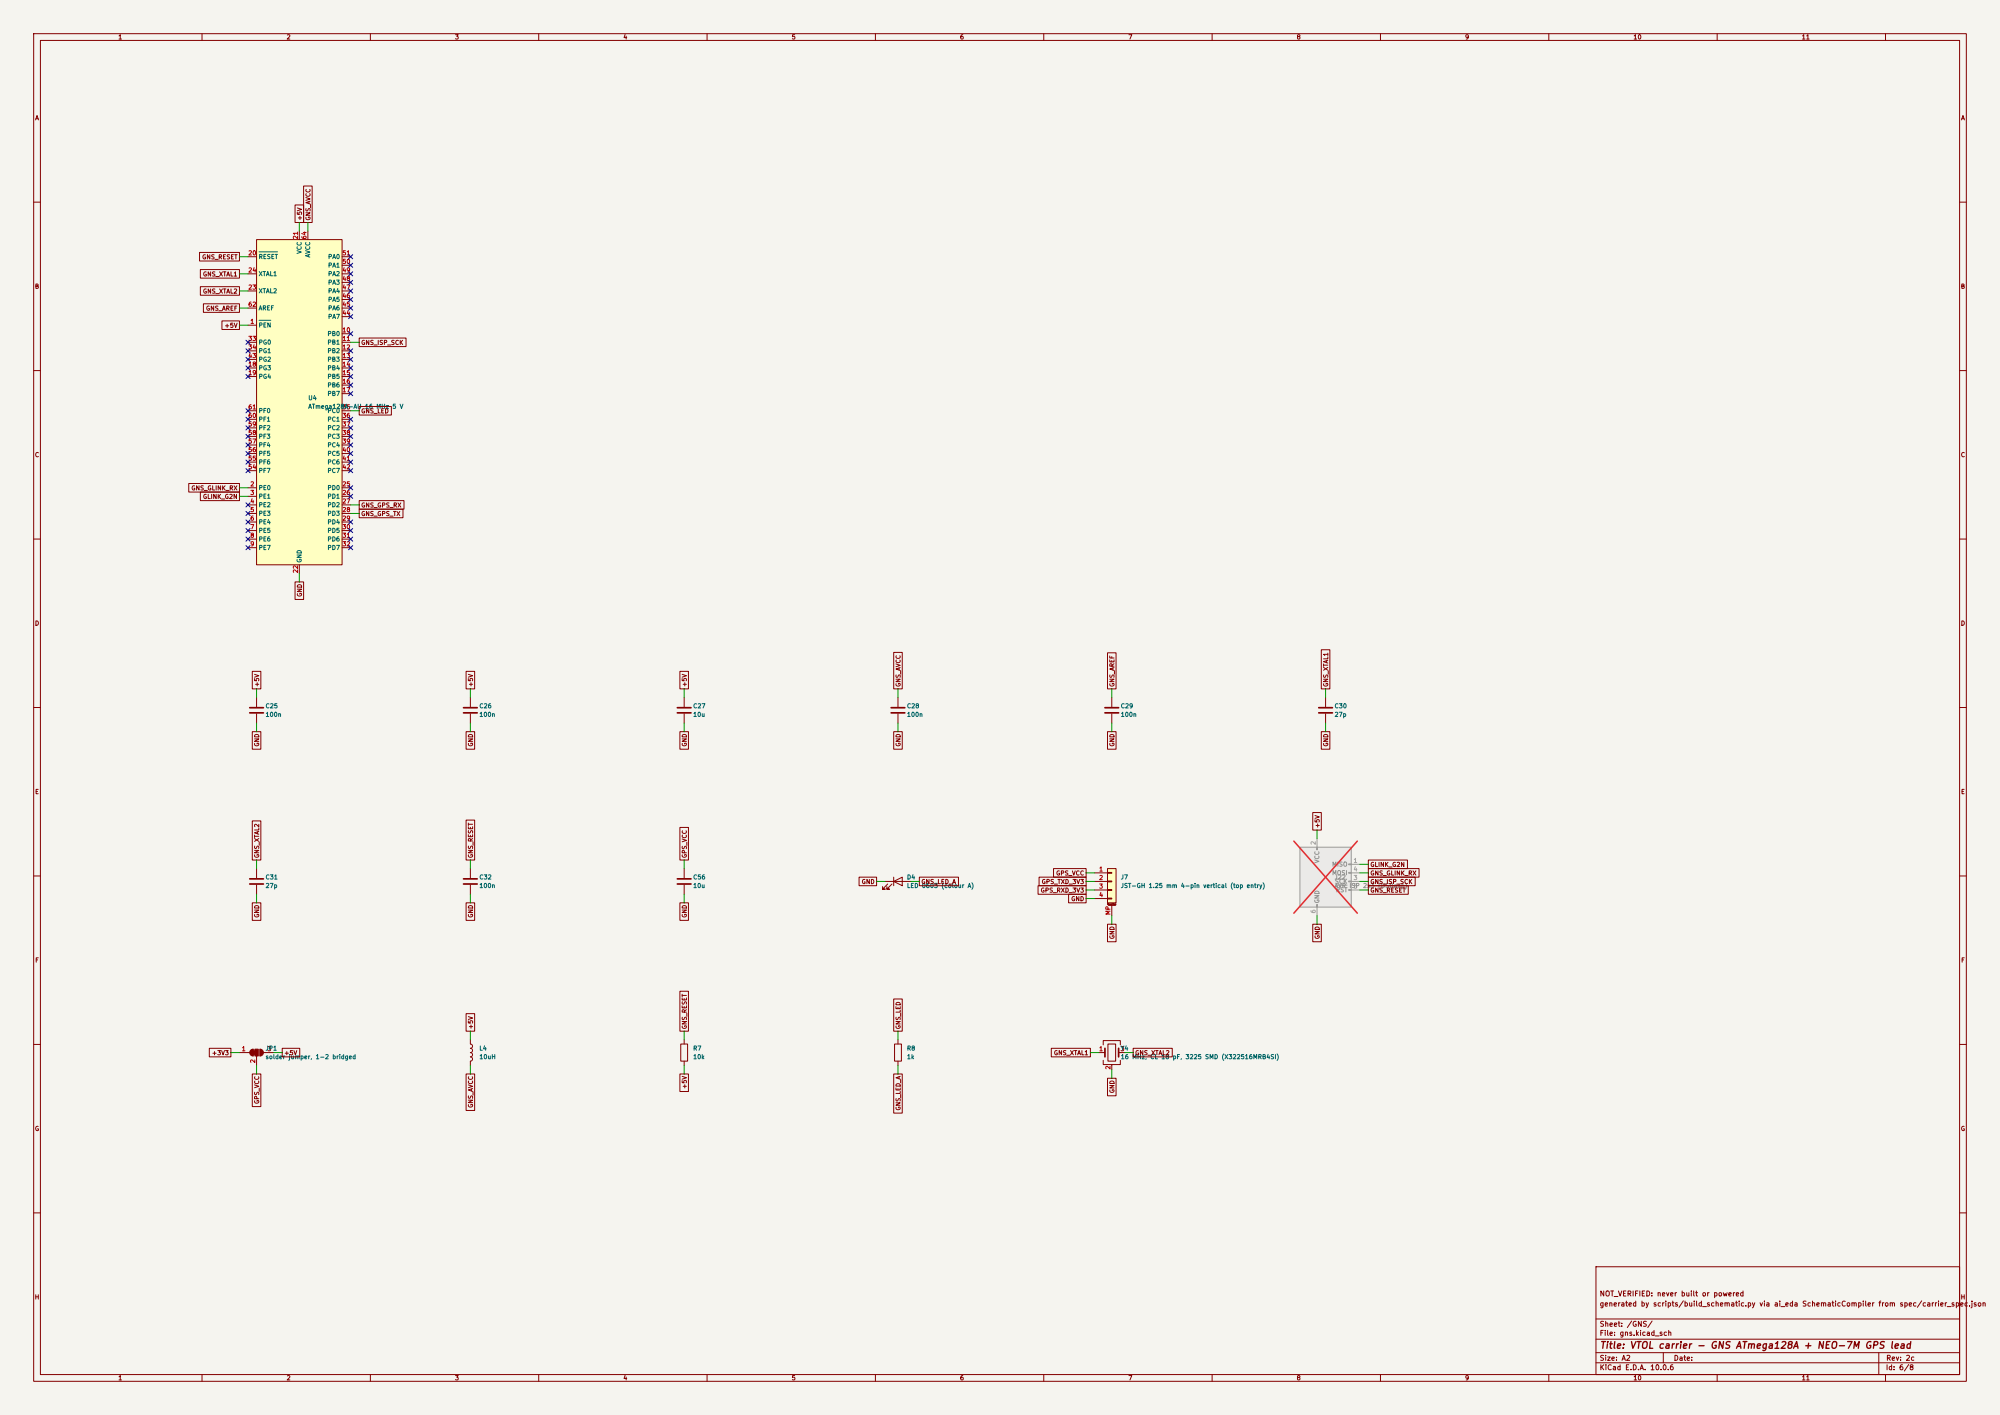
[picture p60: page 6]

JST-GH 1.25 mm 4-pin vertical (top entry) C31

16 MHz, CL 18 pF, 3225 SMD (X322516MRB4SI) 1

Sheet: /GNS/
File: gns.kicad_sch
Title: VTOL carrier - GNS ATmega128A + NEO-7M GPS lead

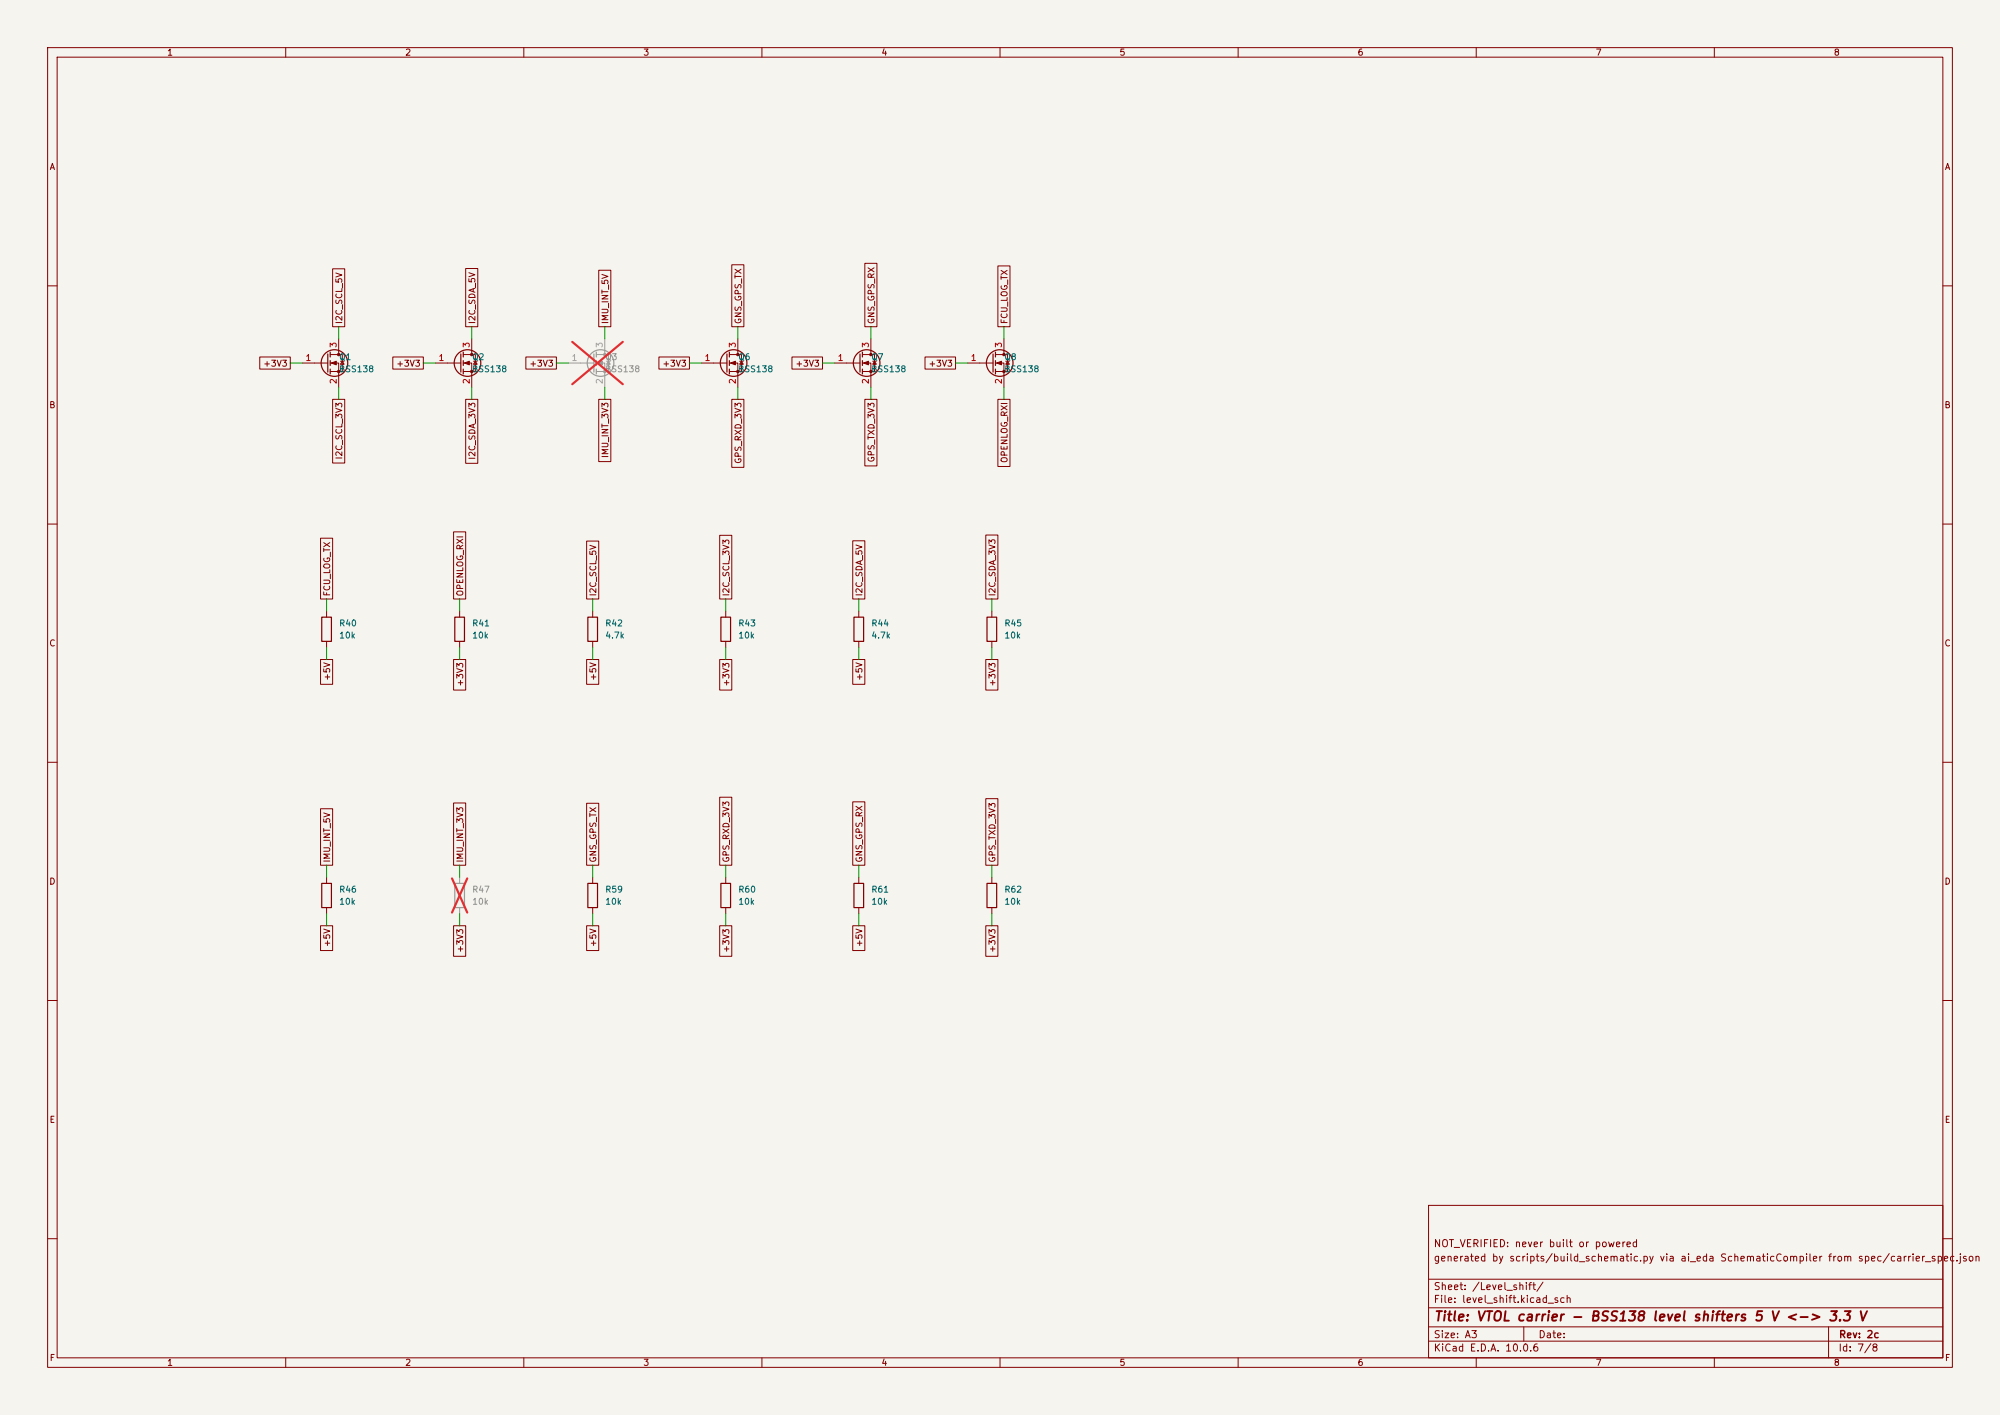
[picture p61: page 7]

NOT_VERIFIED: never built or powered
generated by scripts/build_schematic.py via ai_eda SchematicCompiler from spec/carrier_spec.json

Sheet: /Level_shift/
File: level_shift.kicad_sch
Title: VTOL carrier - BSS138 level shifters 5 V <-> 3.3 V

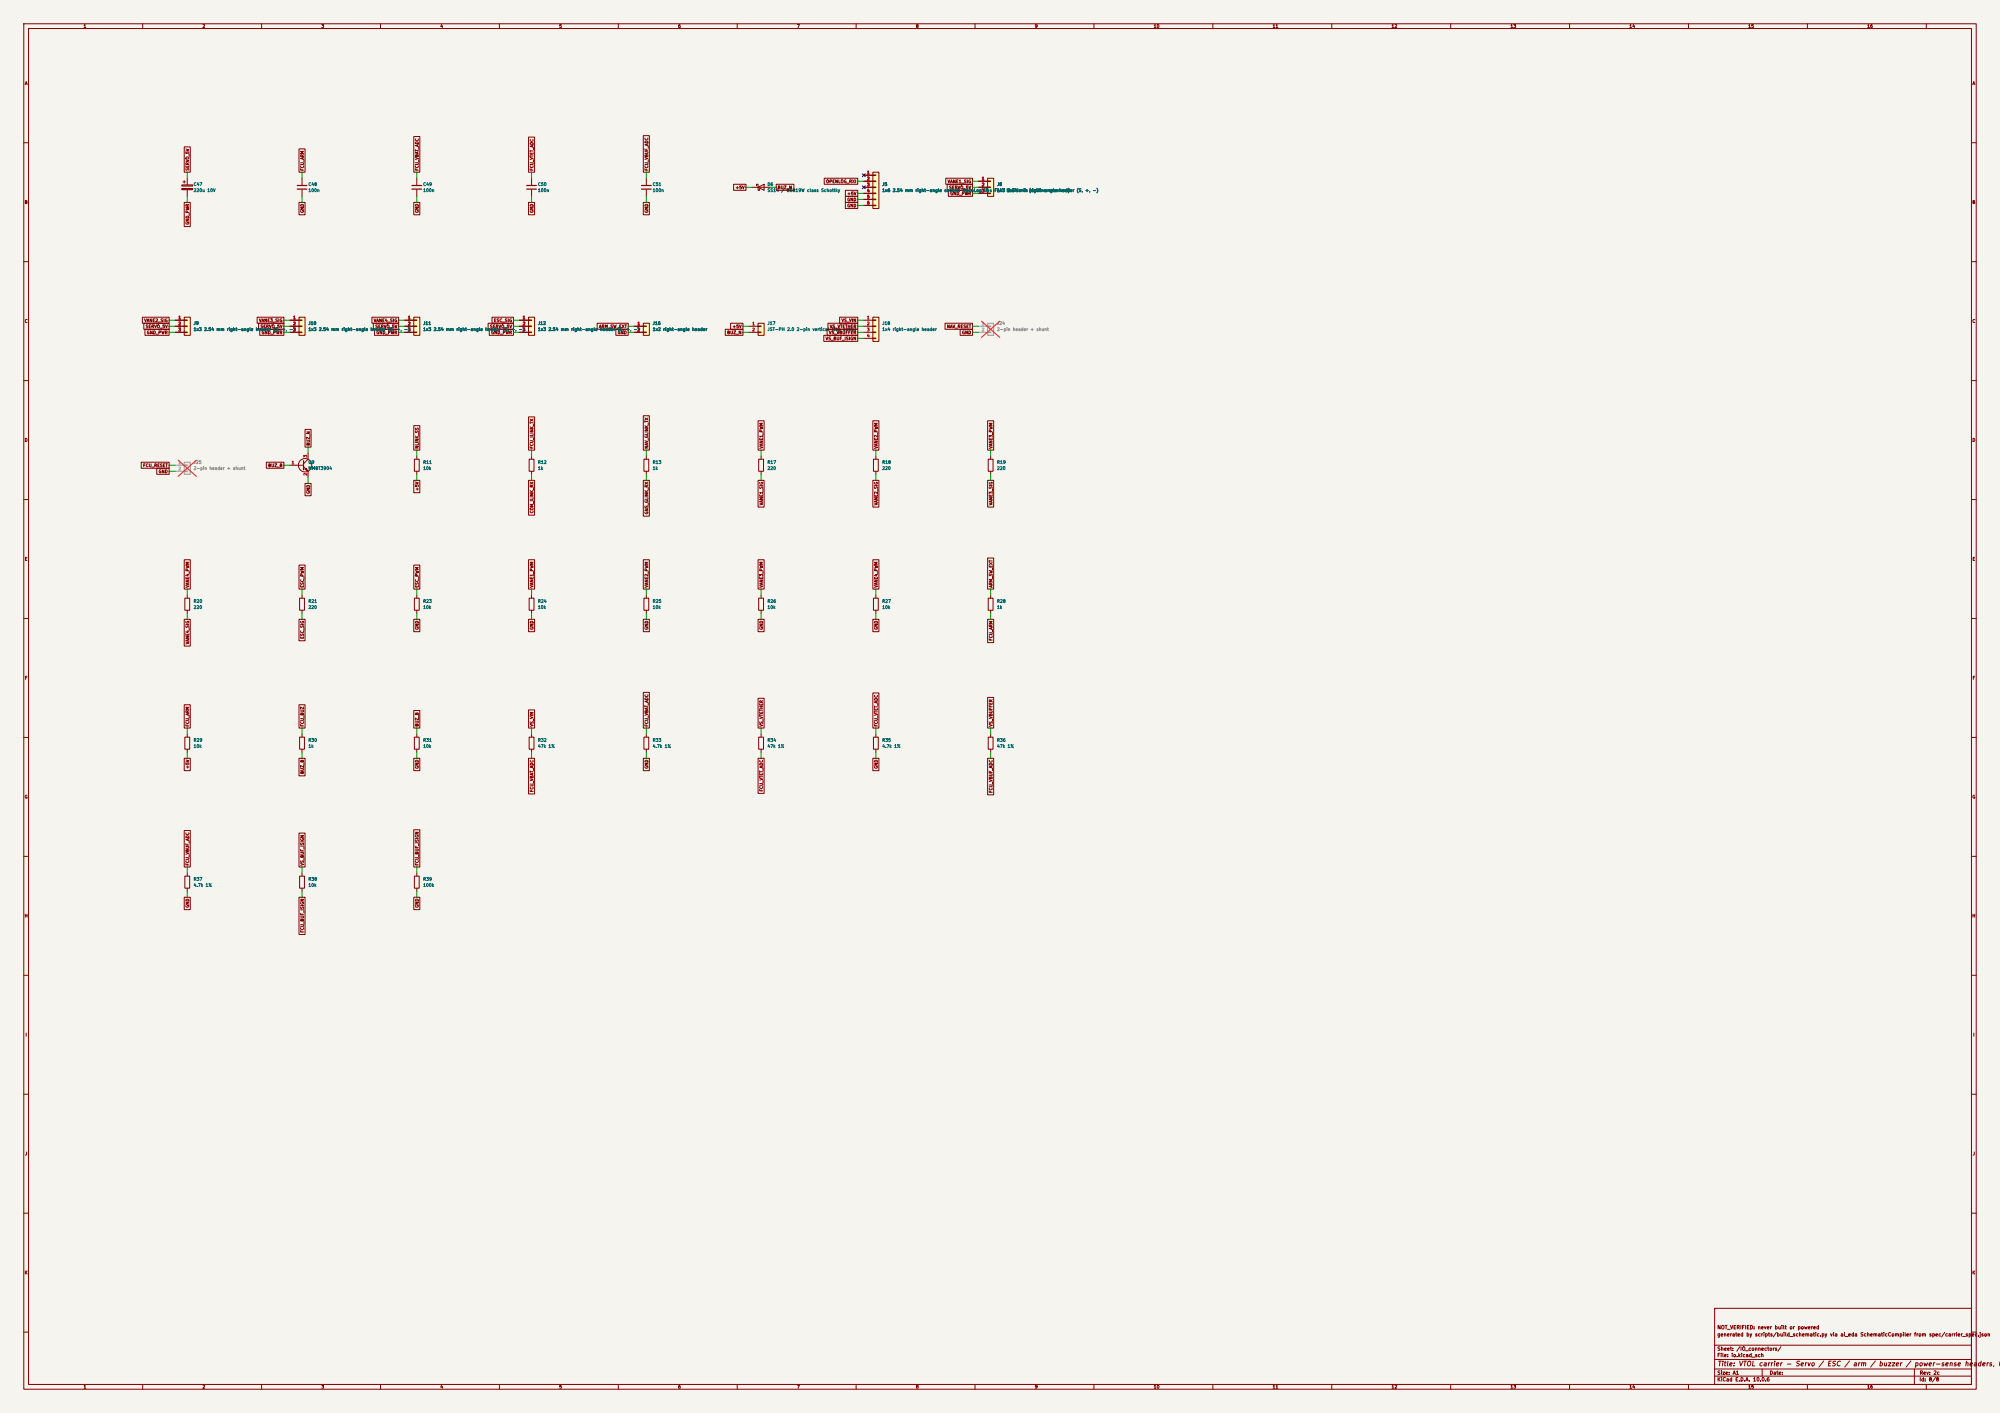
[picture p62: page 8]

1x3 2.54 mm right-angle header (S, +, -) C47

1x3 2.54 mm right-angle header (S, +, -) R12

1x3 2.54 mm right-angle header (S, +, -)

JST-PH 2.0 2-pin vertical (top entry)

Sheet: /IO_connectors/
File: io.kicad_sch
Title: VTOL carrier - Servo / ESC / arm / buzzer / power-sense headers, OpenLog, inter-chip links
