Yuchan-00/CanSat_EDF_Rocket/pcb/vtol_carrier/archive/rev1_plm100_2s/out/schematic/vtol_carrier_schematic.pdf

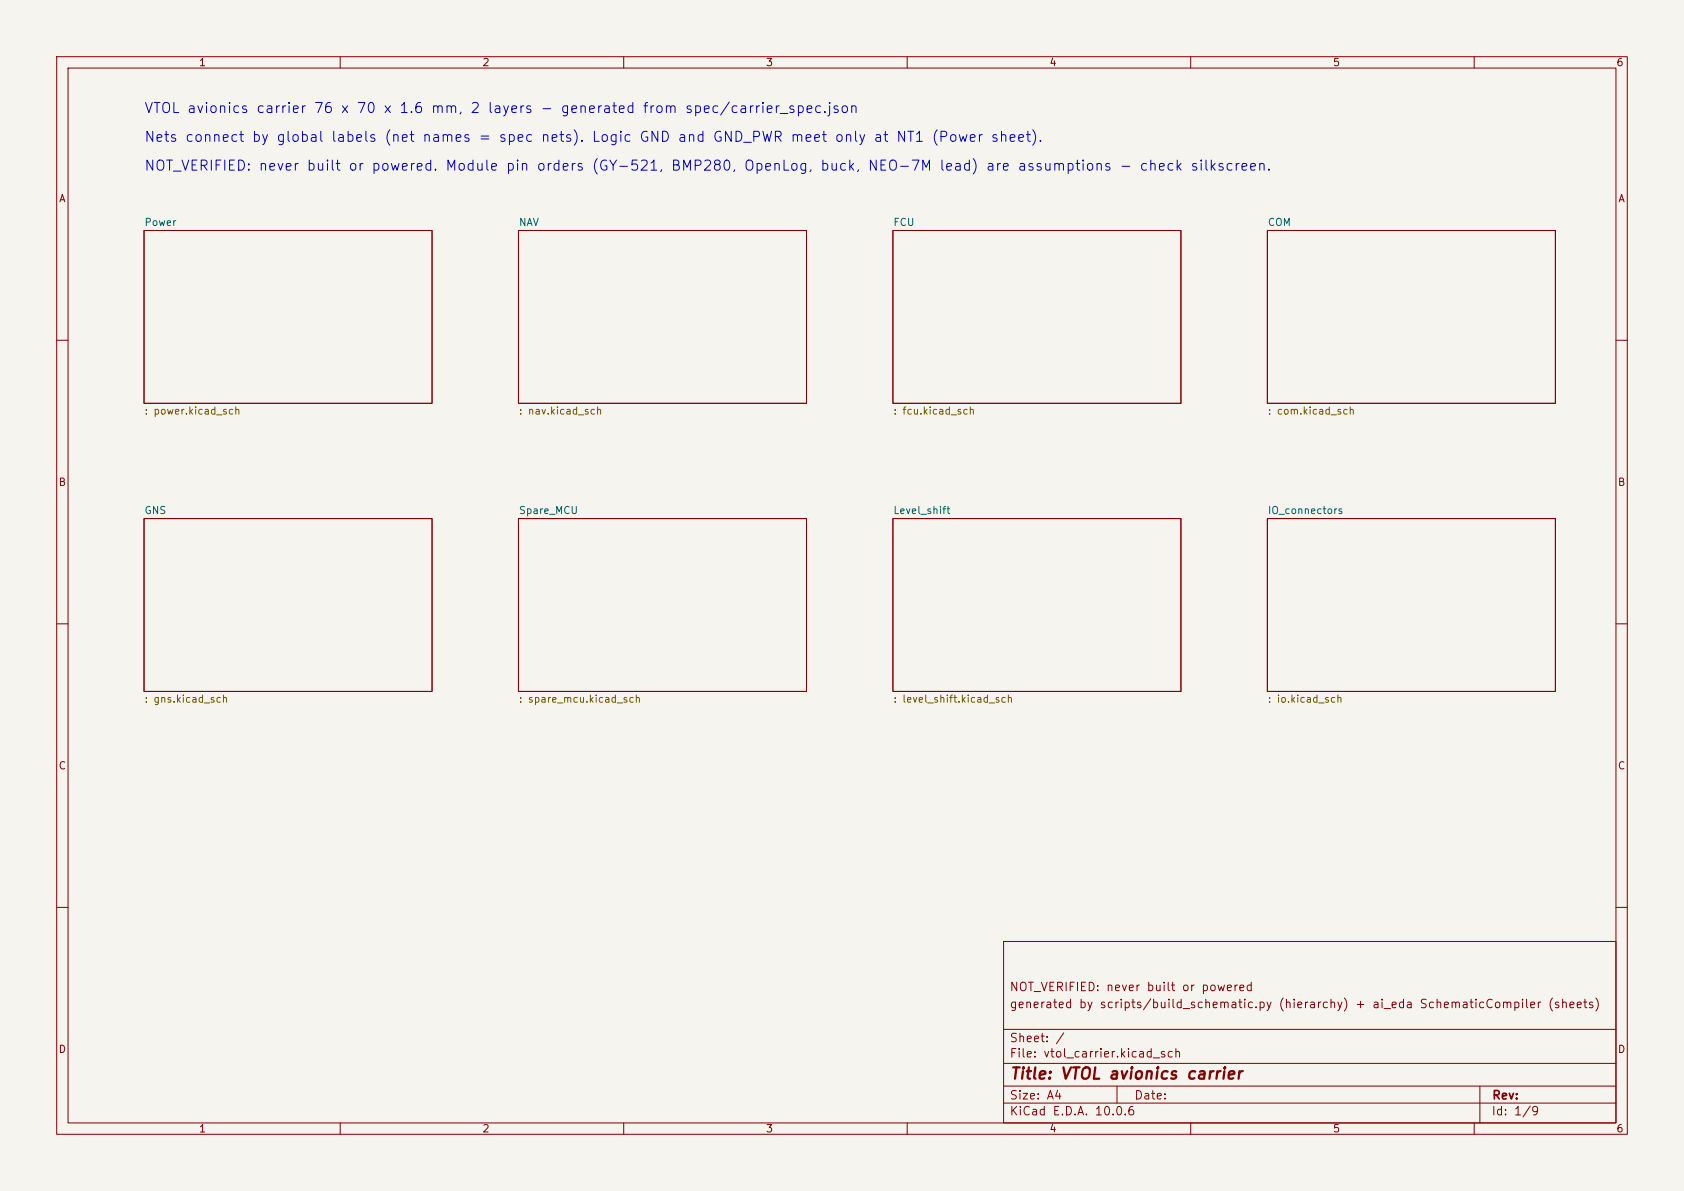
[picture p63: page 1]

VTOL avionics carrier 76 x 70 x 1.6 mm, 2 layers - generated from spec/carrier_spec.json
Nets connect by global labels (net names = spec nets). Logic GND and GND_PWR meet only at NT1 (Power sheet).
NOT_VERIFIED: never built or powered. Module pin orders (GY-521, BMP280, OpenLog, buck, NEO-7M lead) are assumptions - check silkscreen.

NOT_VERIFIED: never built or powered
generated by scripts/build_schematic.py (hierarchy) + ai_eda SchematicCompiler (sheets)

Sheet: /
File: vtol_carrier.kicad_sch
Title: VTOL avionics carrier

Size: A4 | Rev:
KiCad E.D.A. 10.0.6 | Id: 1/9

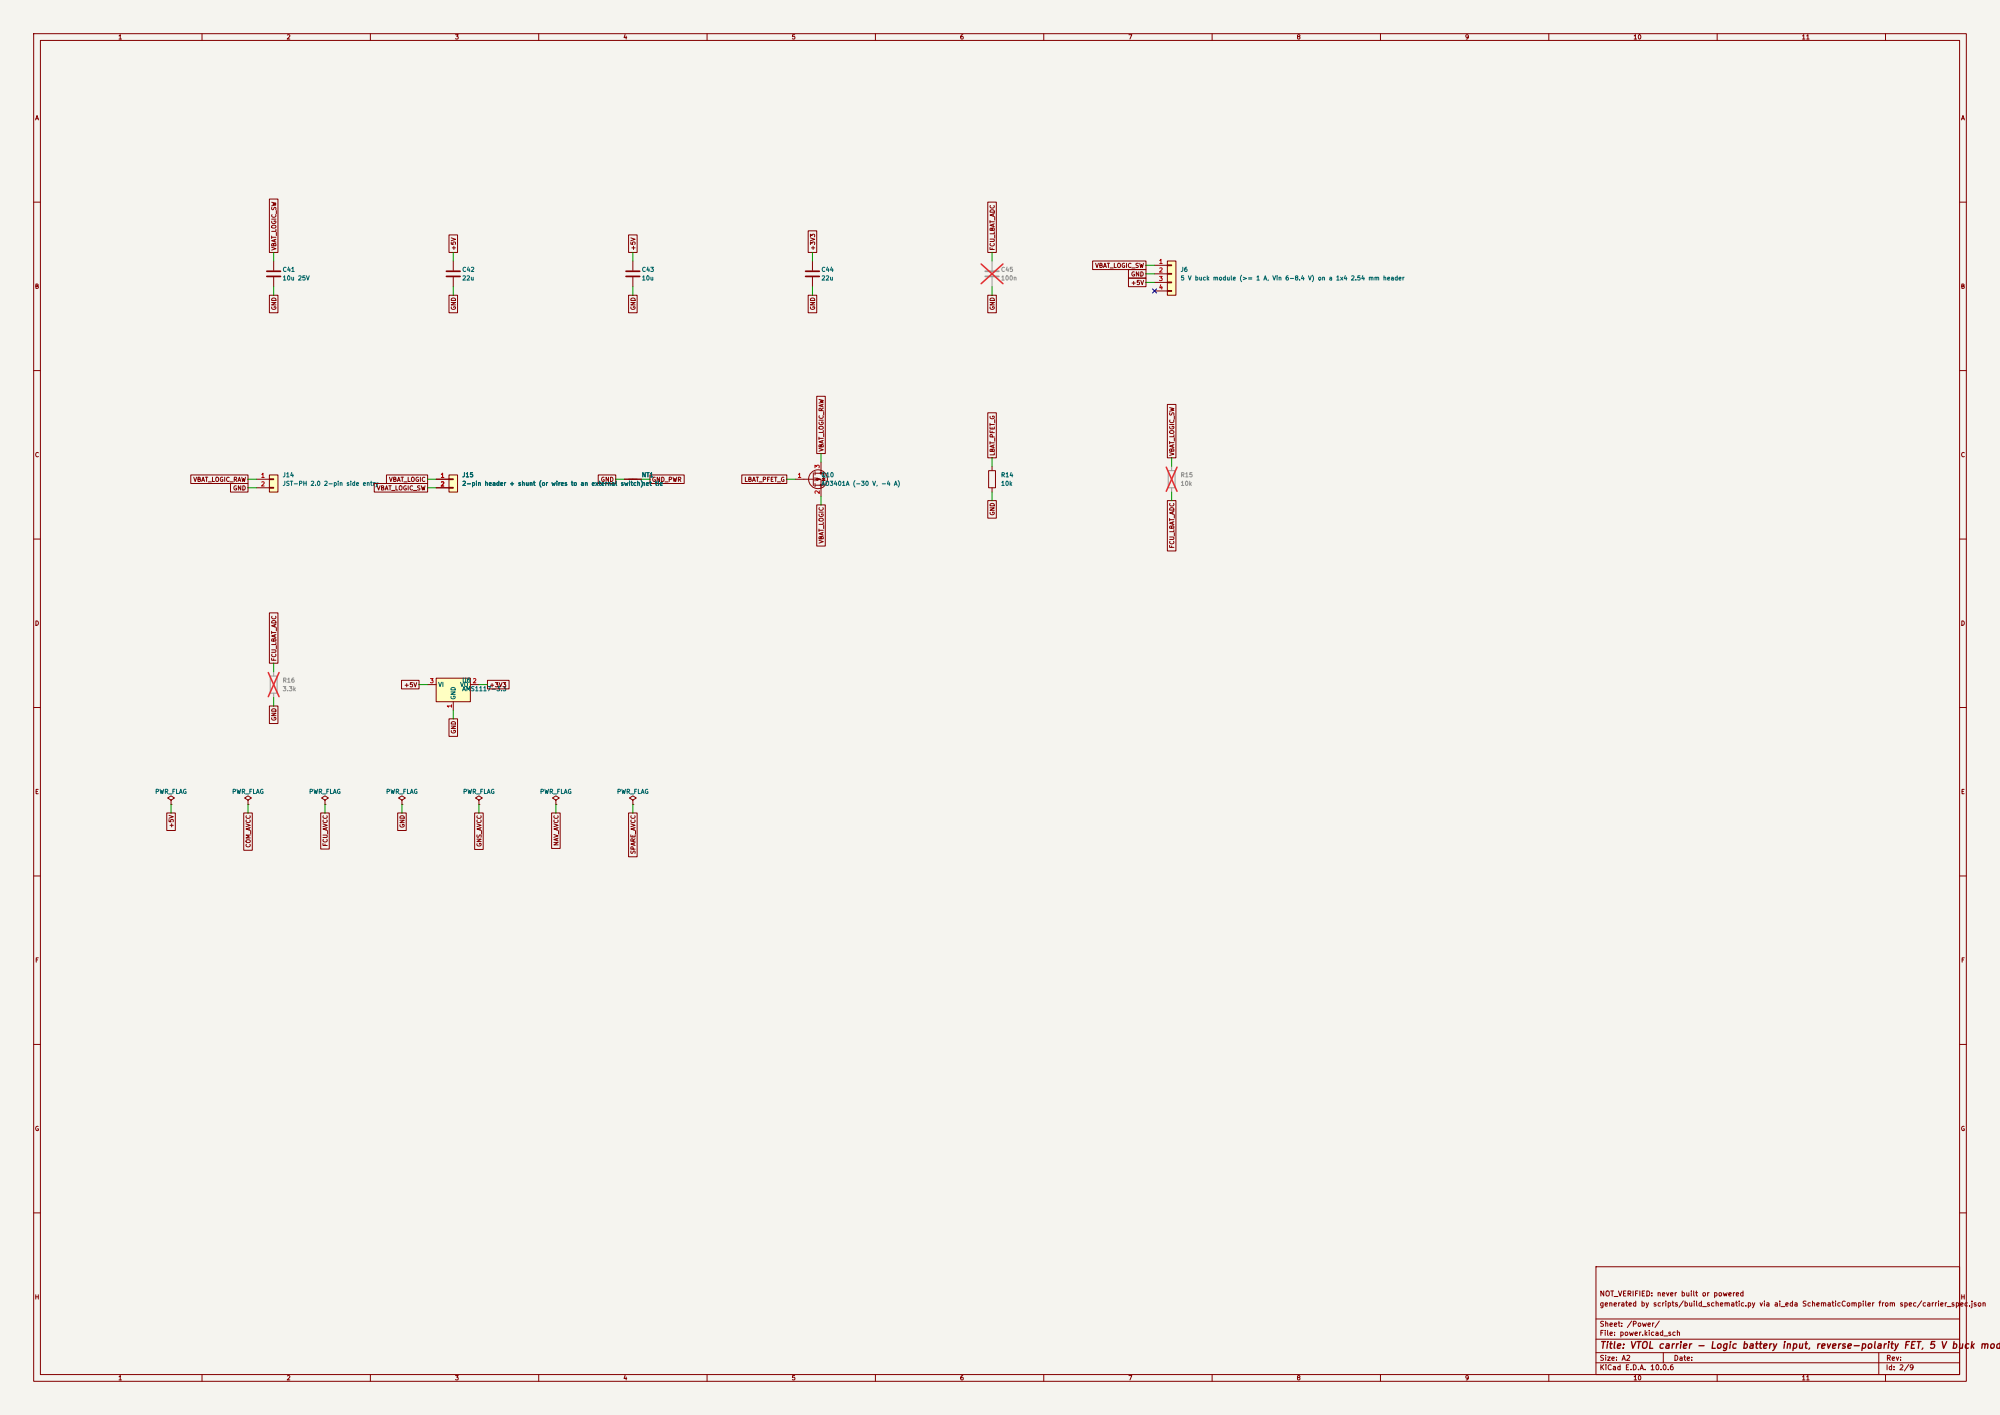
[picture p64: page 2]

JST-PH 2.0 2-pin side entry C41

5 V buck module (>= 1 A, Vin 6-8.4 V) on a 1x4 2.54 mm header

2-pin header + shunt (or wires to an external switch) 1

2-pin header + shunt (or wires to an external switch) GND

NOT_VERIFIED: never built or powered
generated by scripts/build_schematic.py via ai_eda SchematicCompiler from spec/carrier_spec.json

Sheet: /Power/
File: power.kicad_sch
Title: VTOL carrier - Logic battery input, reverse-polarity FET, 5 V buck module, AMS1117-3.3, ground tie

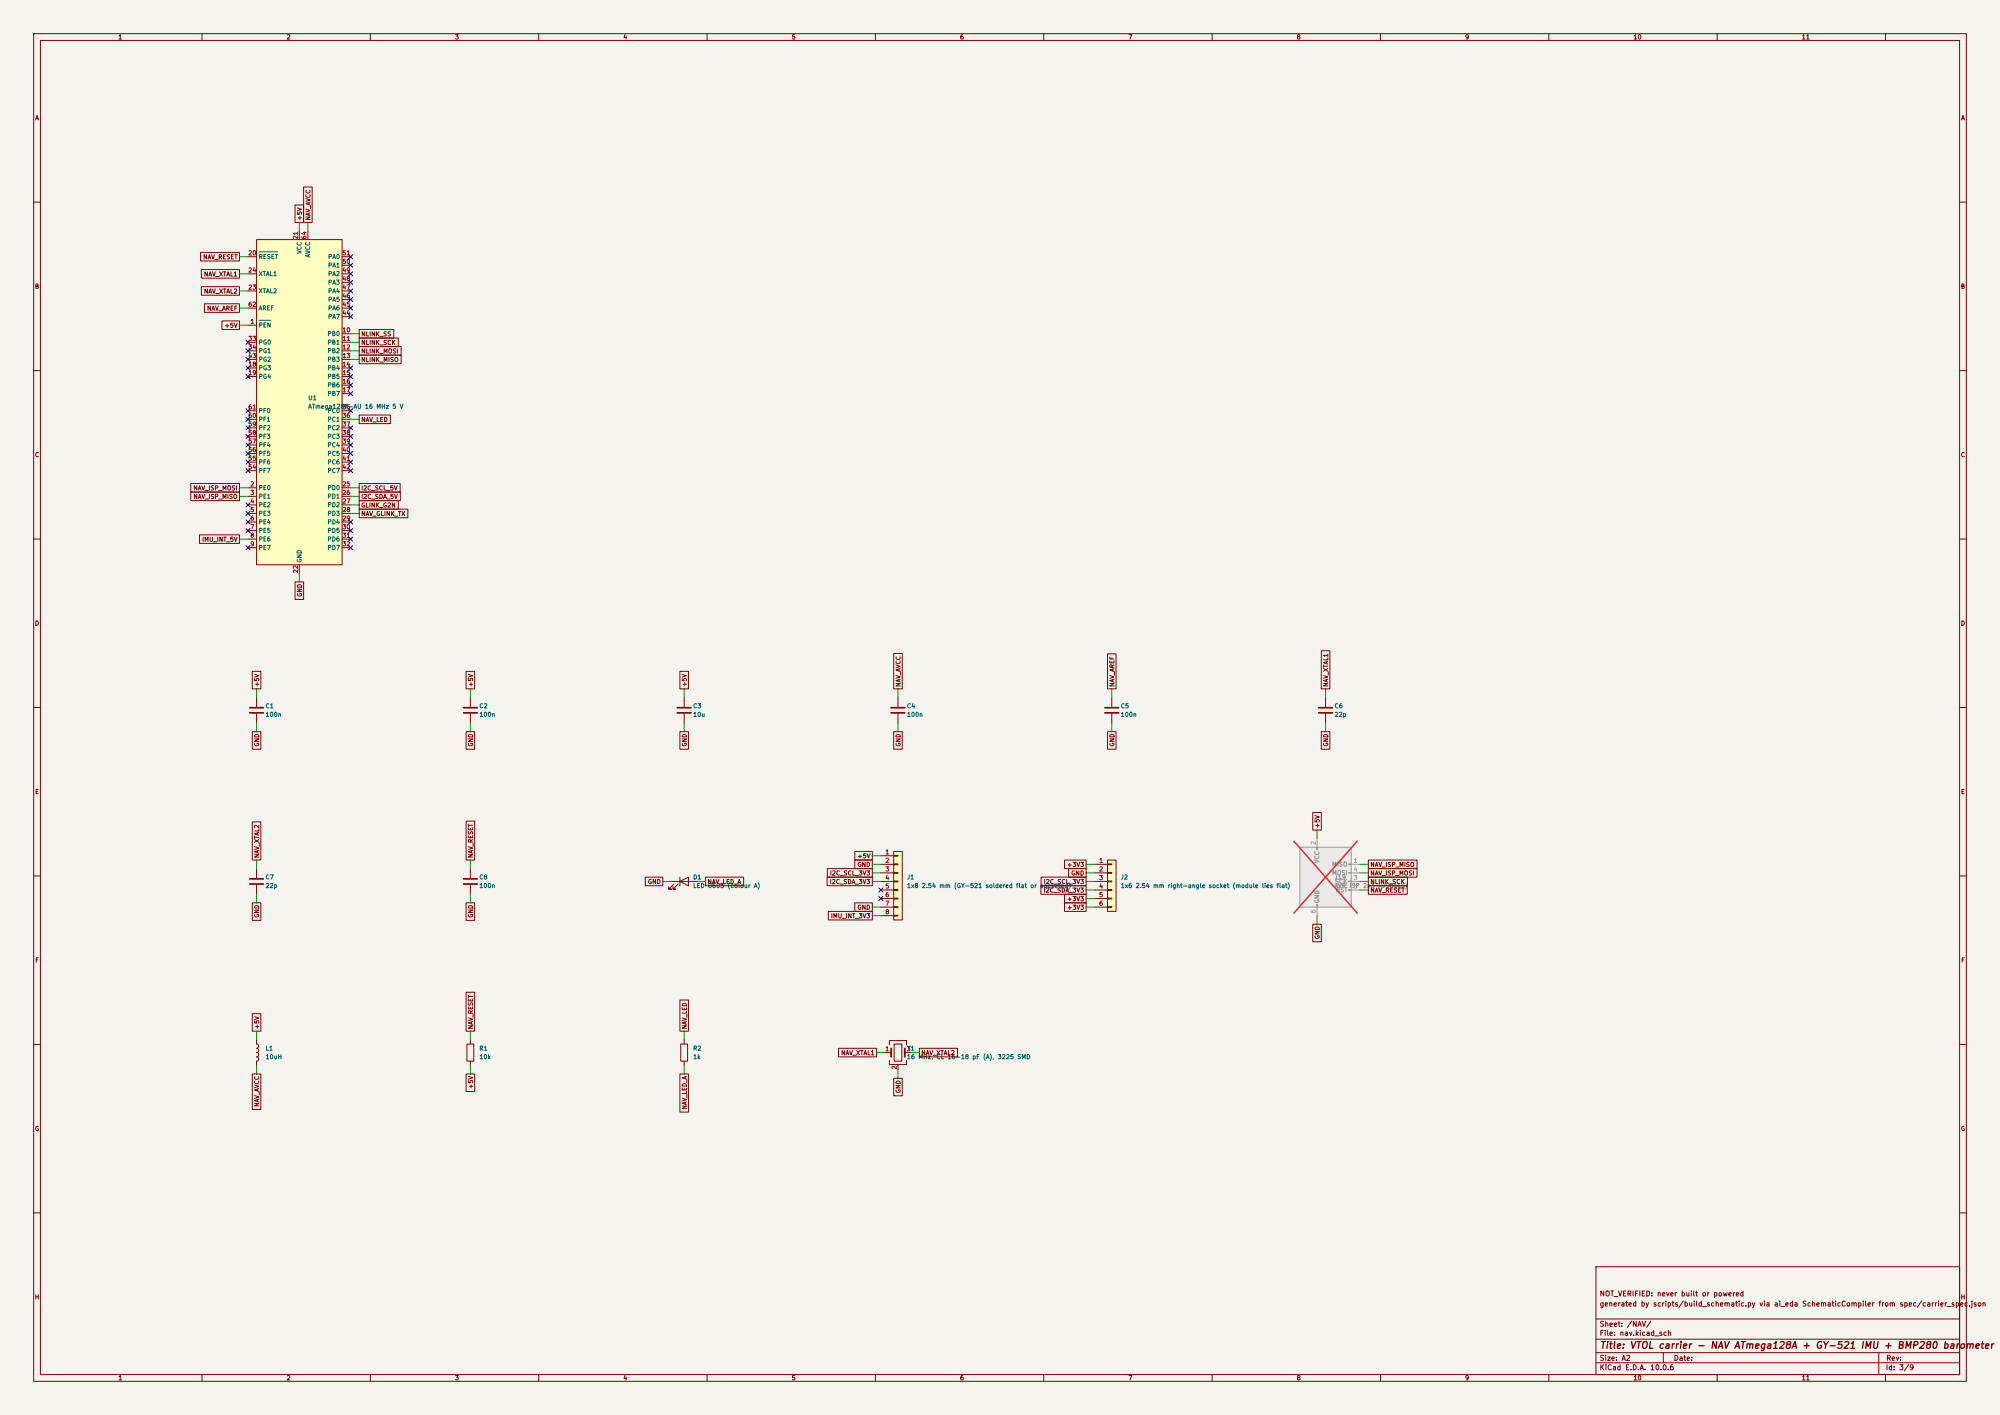
[picture p65: page 3]

1x8 2.54 mm (GY-521 soldered flat or socketed) L1

1x6 2.54 mm right-angle socket (module lies flat) R2

16 MHz, CL 16-18 pF (A), 3225 SMD

Sheet: /NAV/
File: nav.kicad_sch
Title: VTOL carrier - NAV ATmega128A + GY-521 IMU + BMP280 barometer

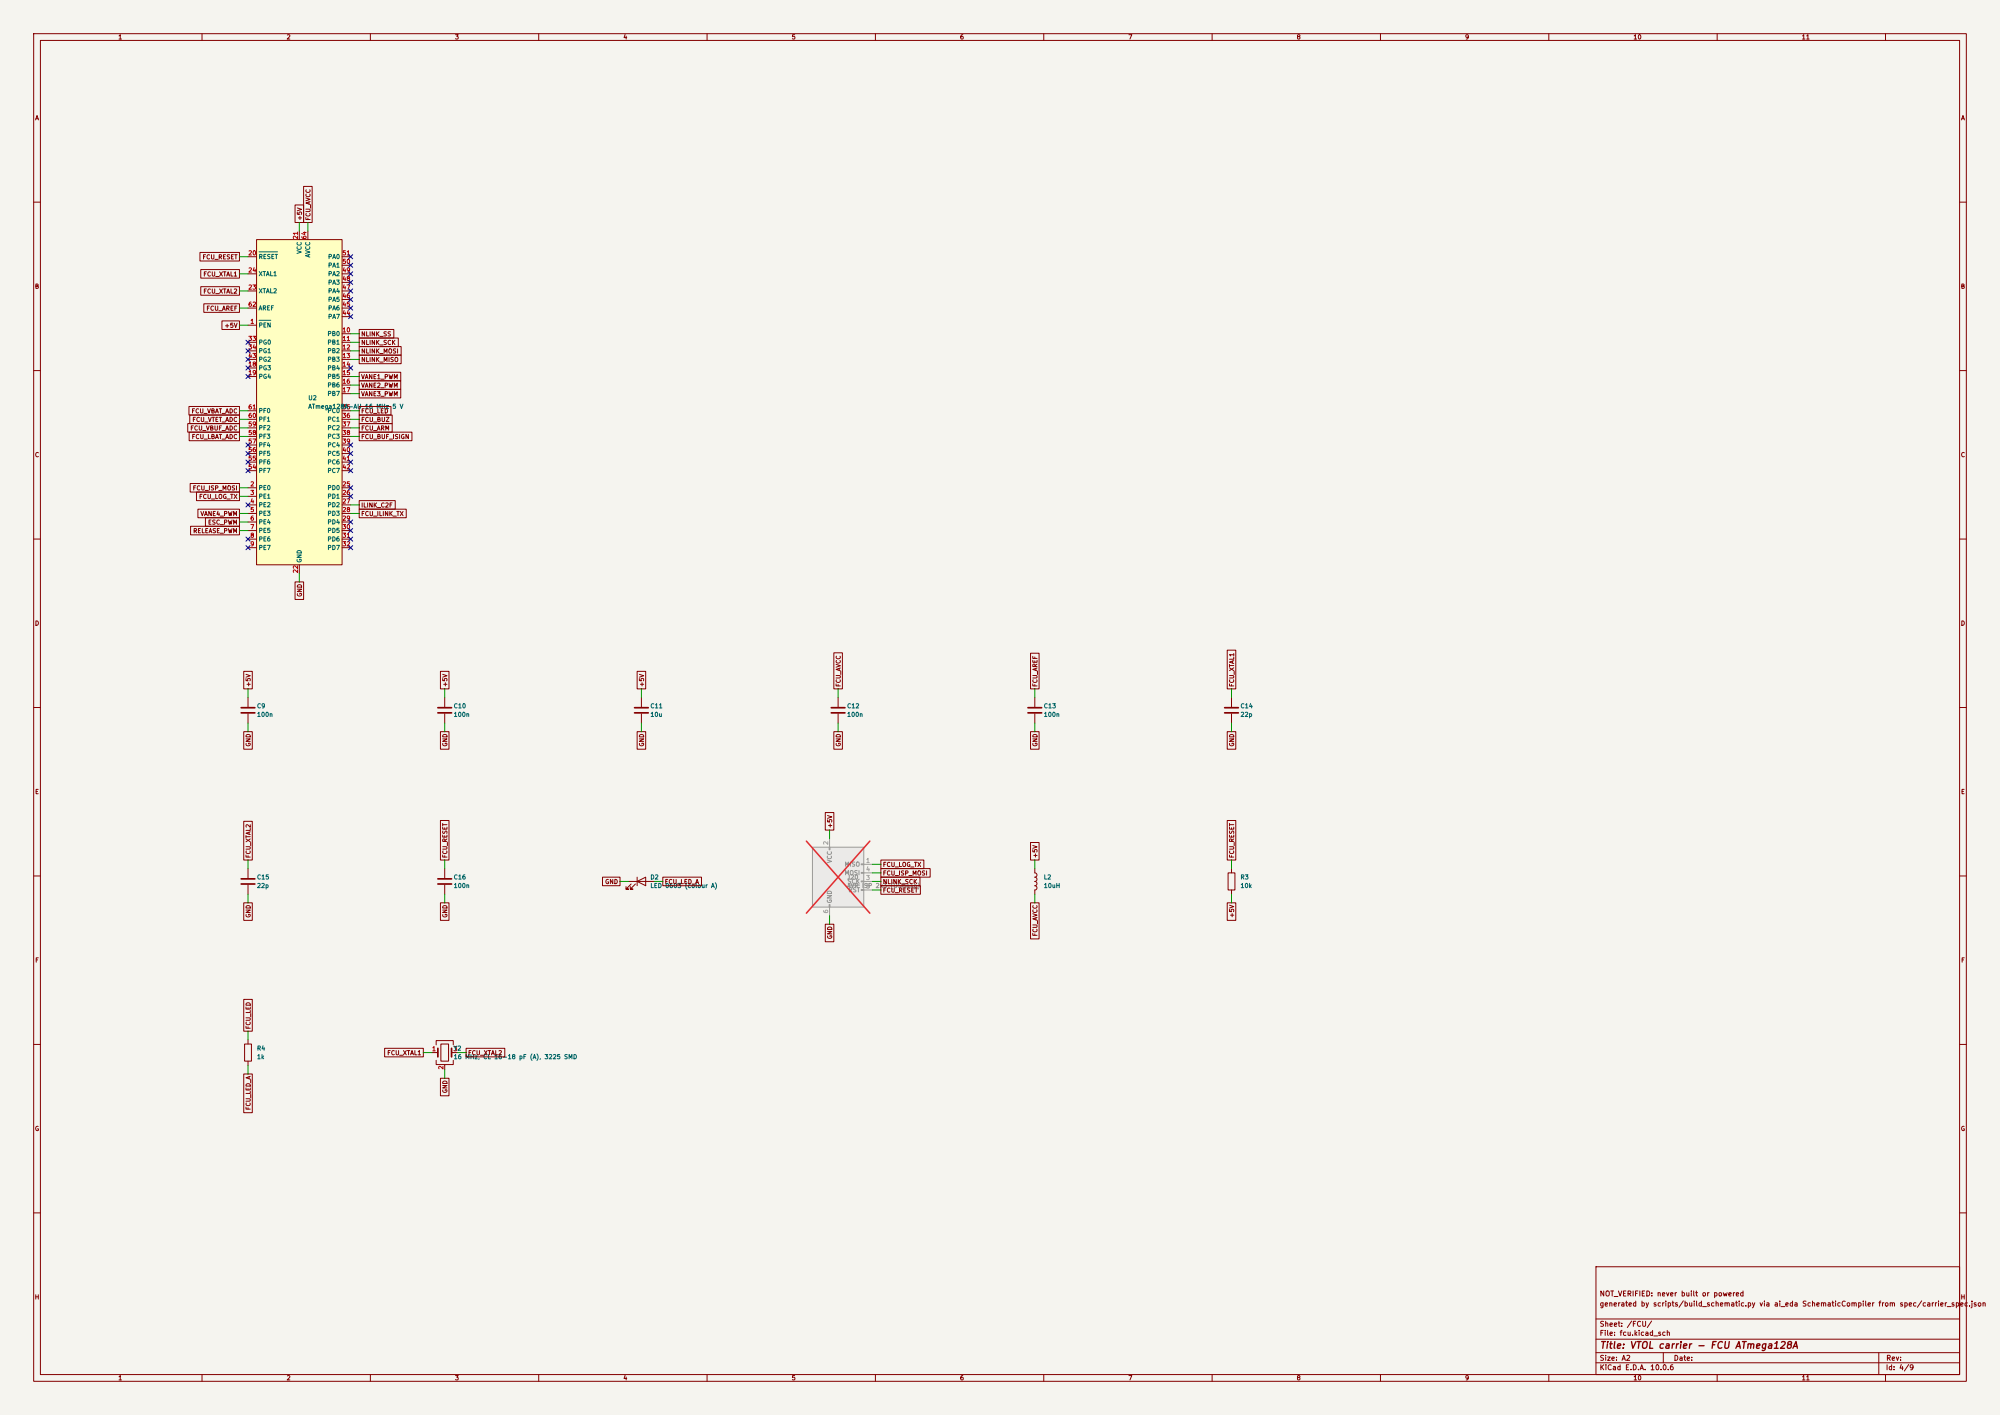
[picture p66: page 4]

16 MHz, CL 16-18 pF (A), 3225 SMD

Sheet: /FCU/
File: fcu.kicad_sch
Title: VTOL carrier - FCU ATmega128A

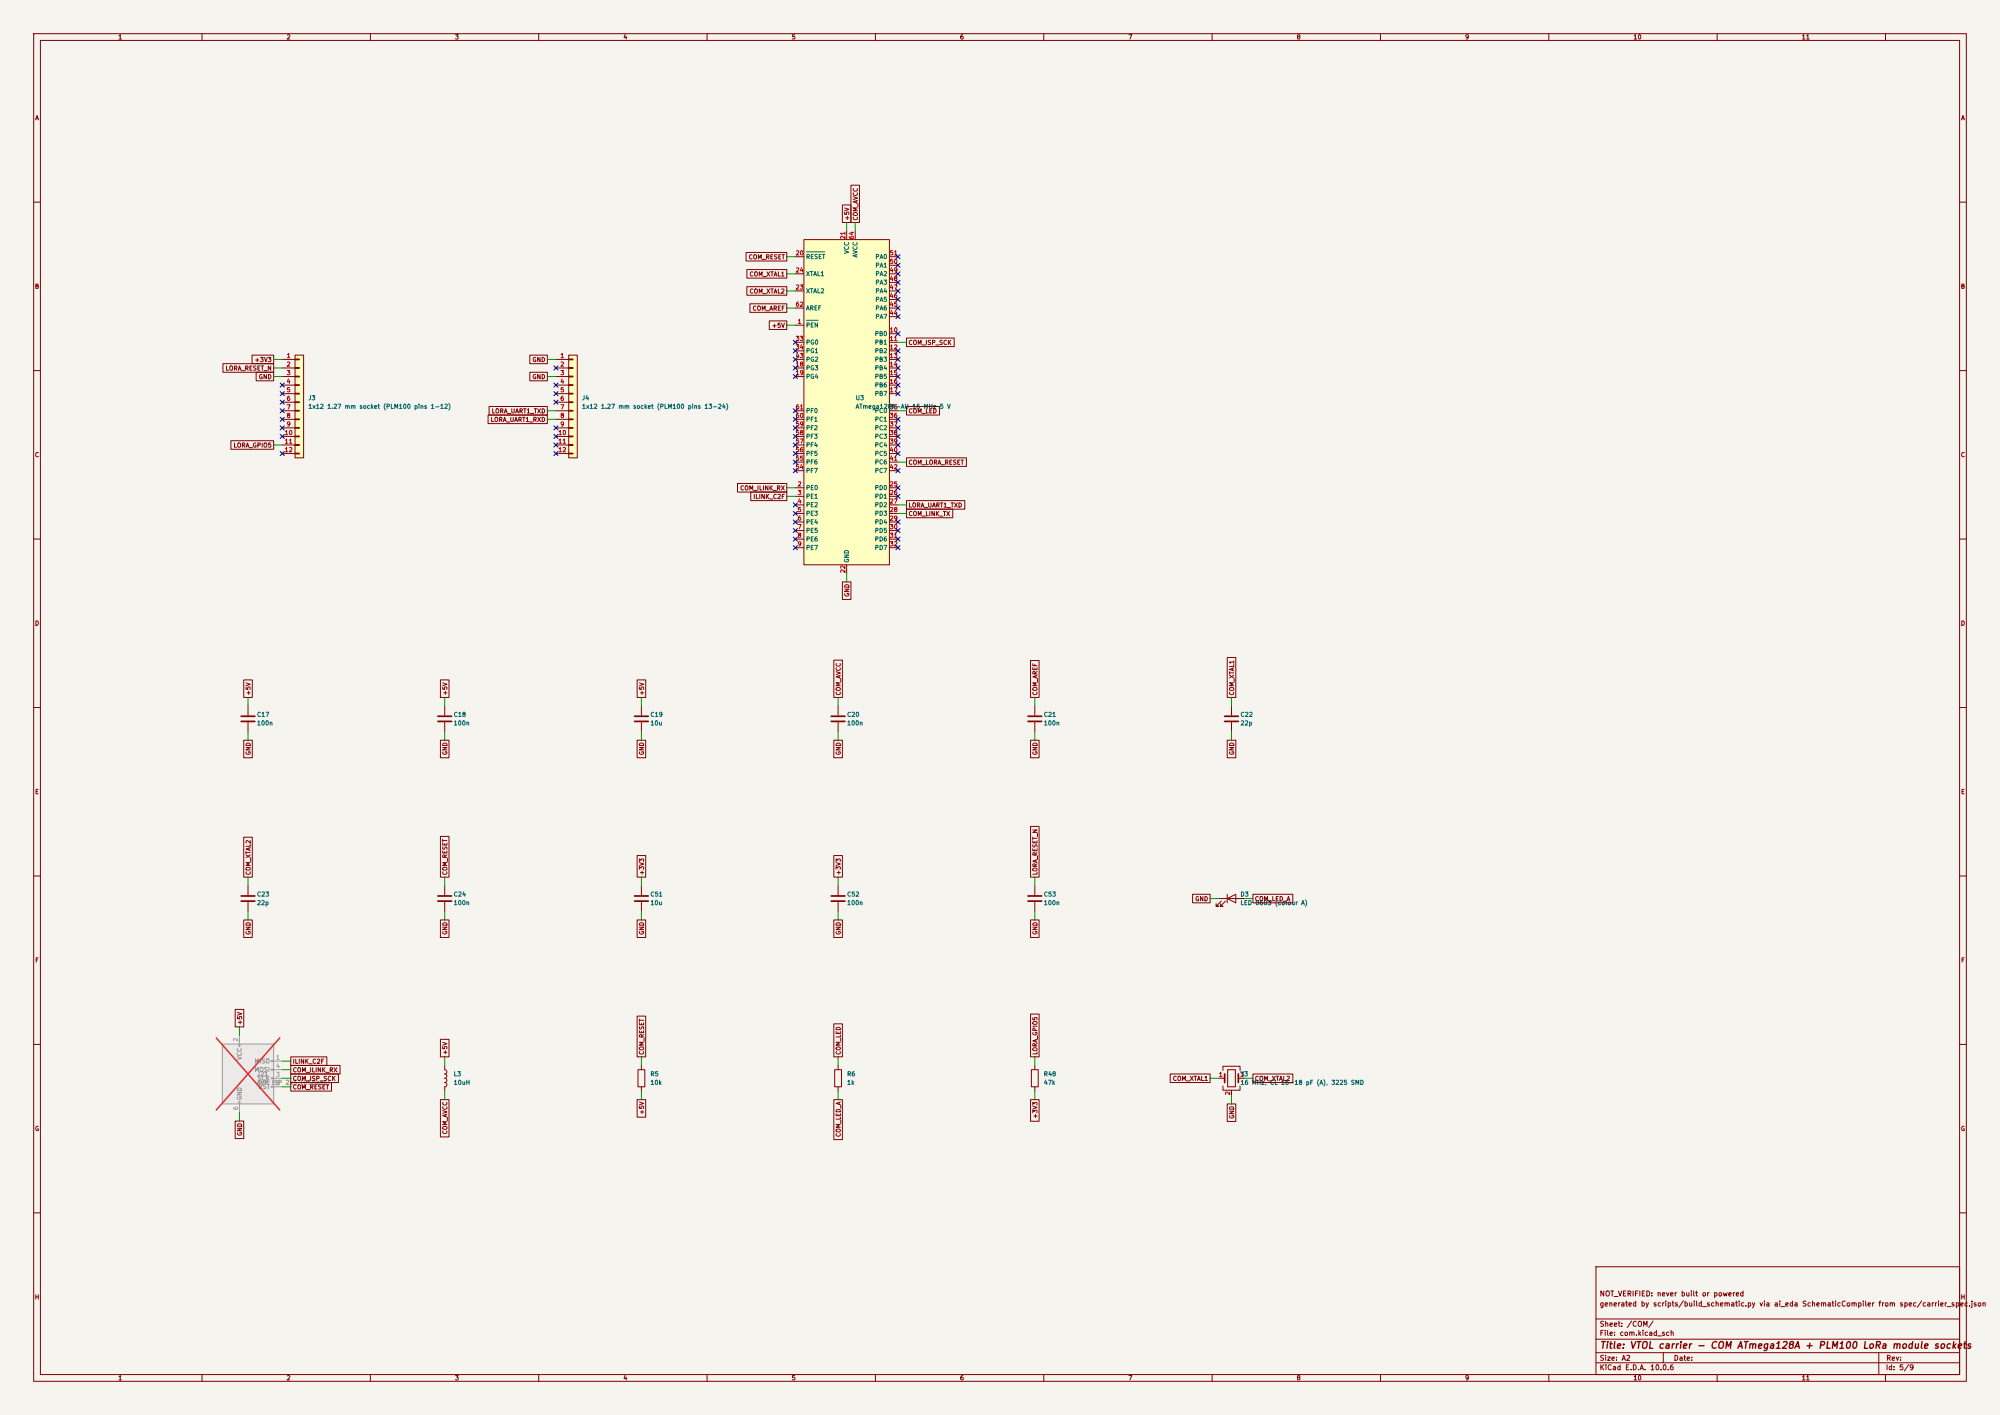
[picture p67: page 5]

16 MHz, CL 16-18 pF (A), 3225 SMD

Sheet: /COM/
File: com.kicad_sch
Title: VTOL carrier - COM ATmega128A + PLM100 LoRa module sockets

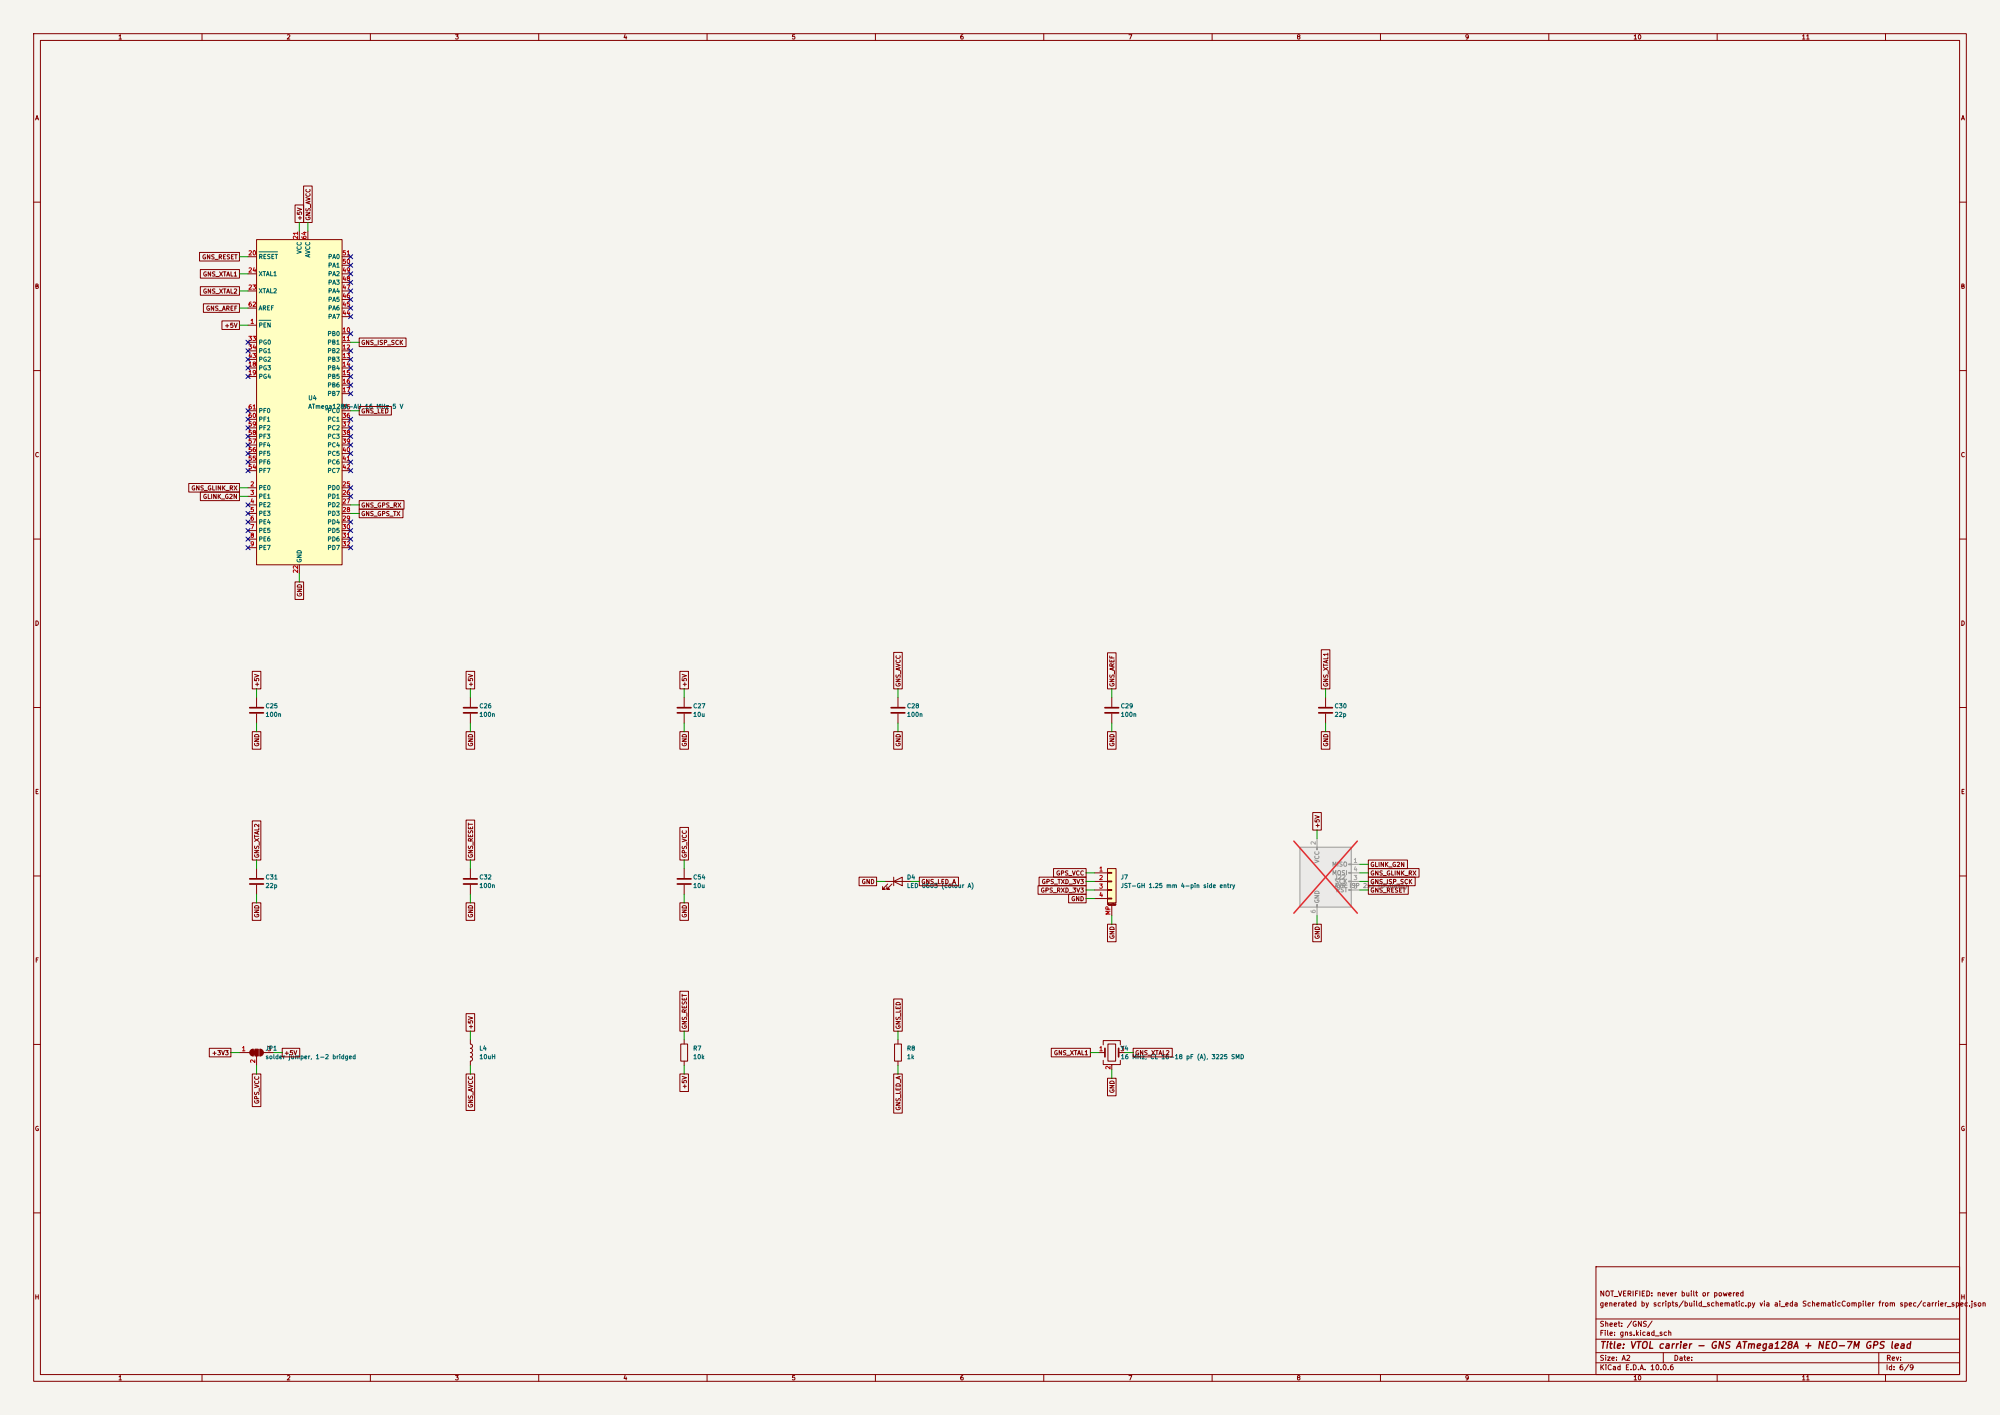
[picture p68: page 6]

JST-GH 1.25 mm 4-pin side entry C31

16 MHz, CL 16-18 pF (A), 3225 SMD 1 2

Sheet: /GNS/
File: gns.kicad_sch
Title: VTOL carrier - GNS ATmega128A + NEO-7M GPS lead

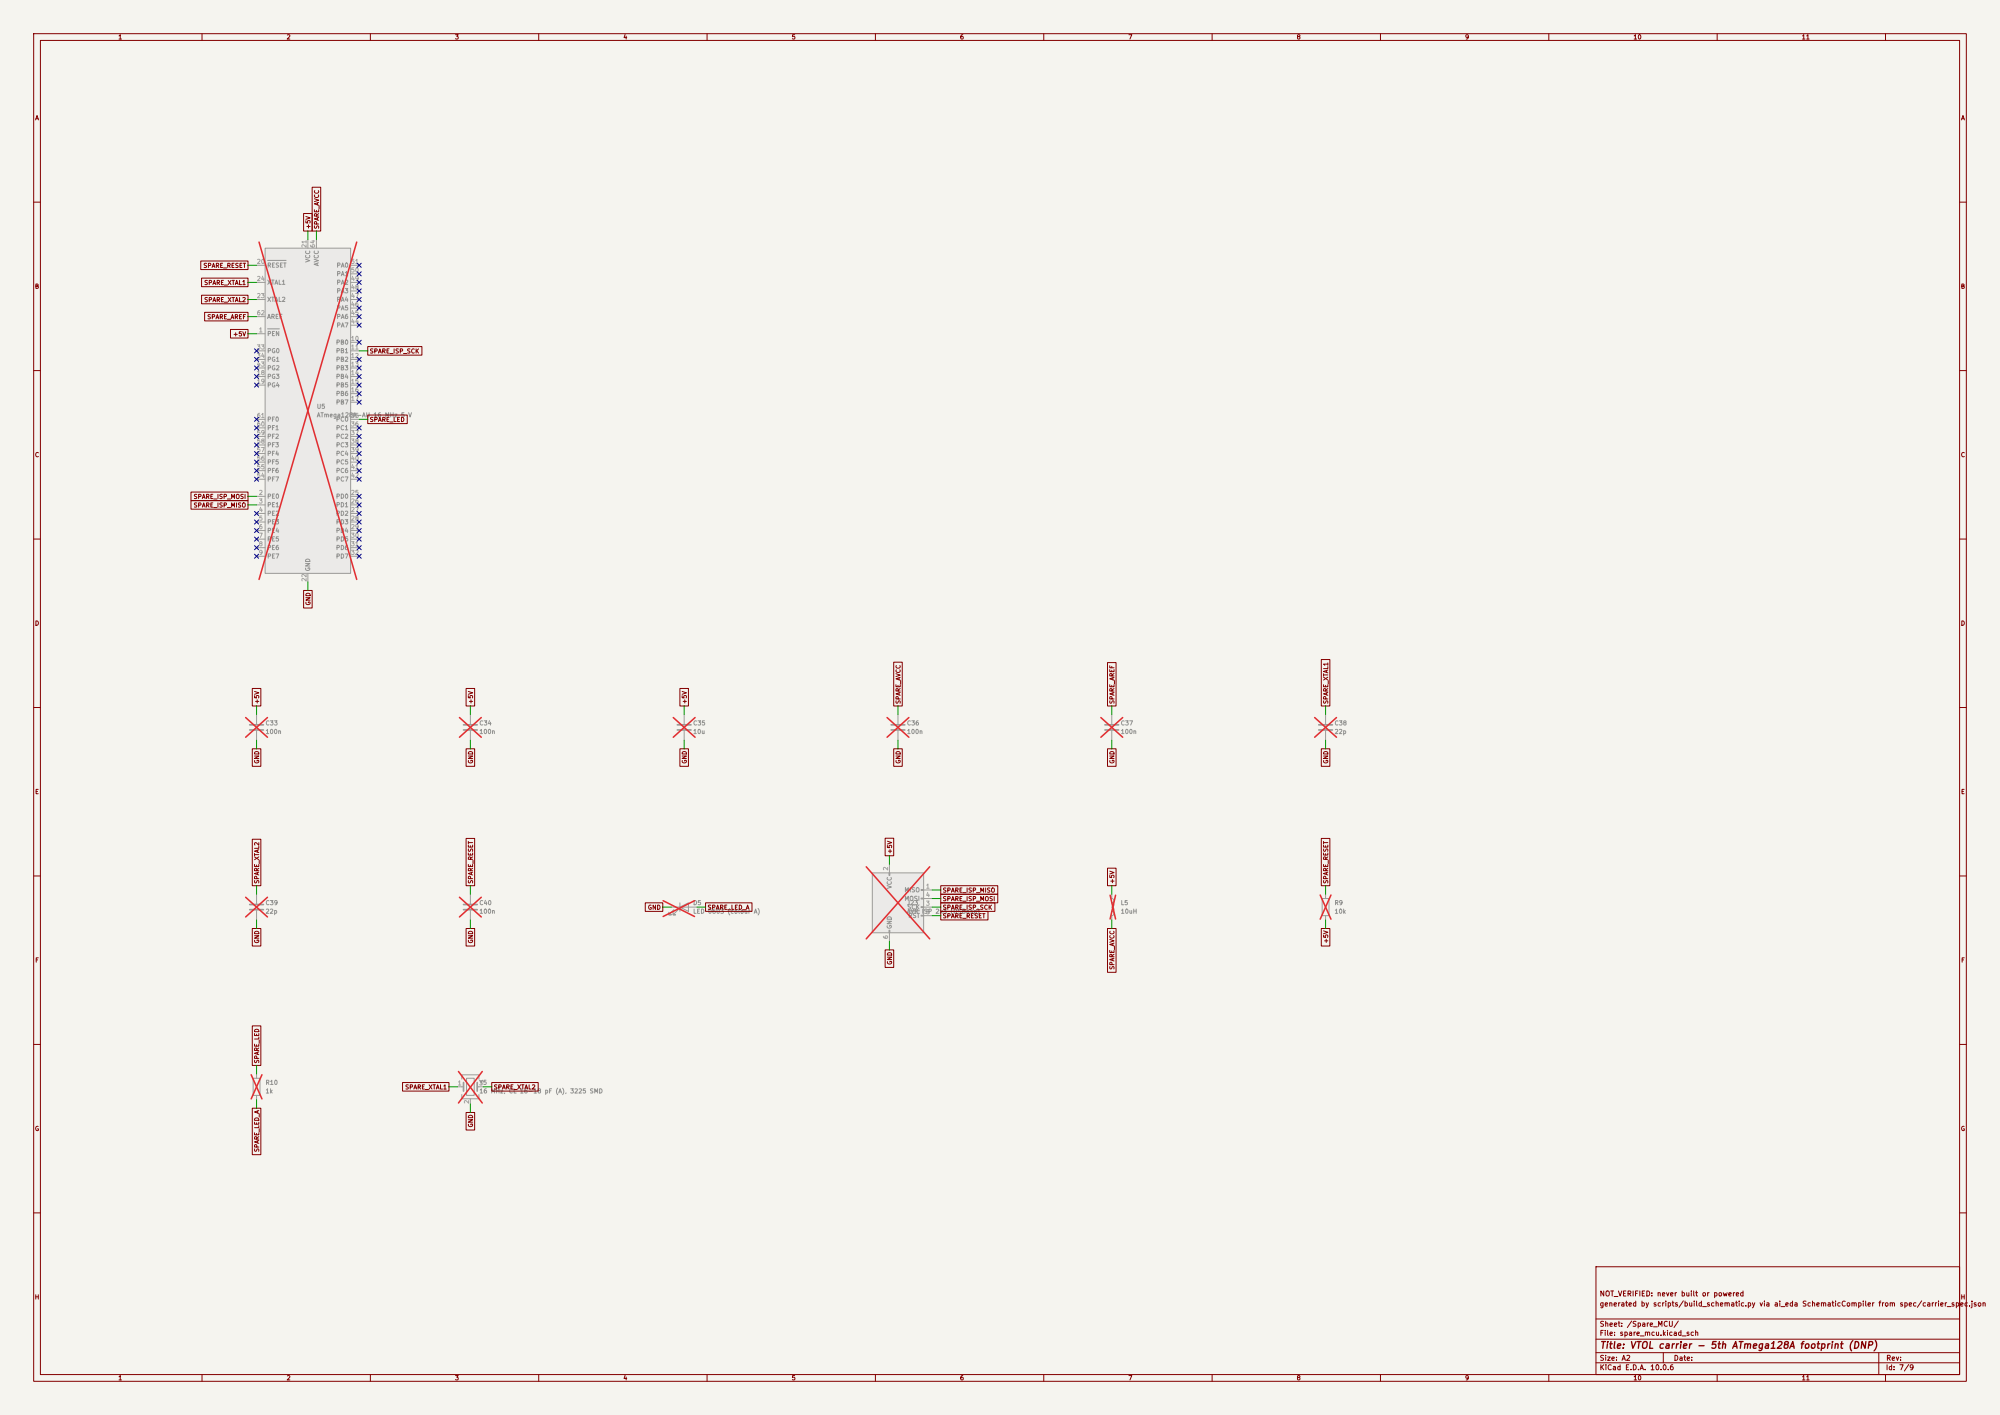
[picture p69: page 7]

16 MHz, CL 16-18 pF (A), 3225 SMD

Sheet: /Spare_MCU/
File: spare_mcu.kicad_sch
Title: VTOL carrier - 5th ATmega128A footprint (DNP)

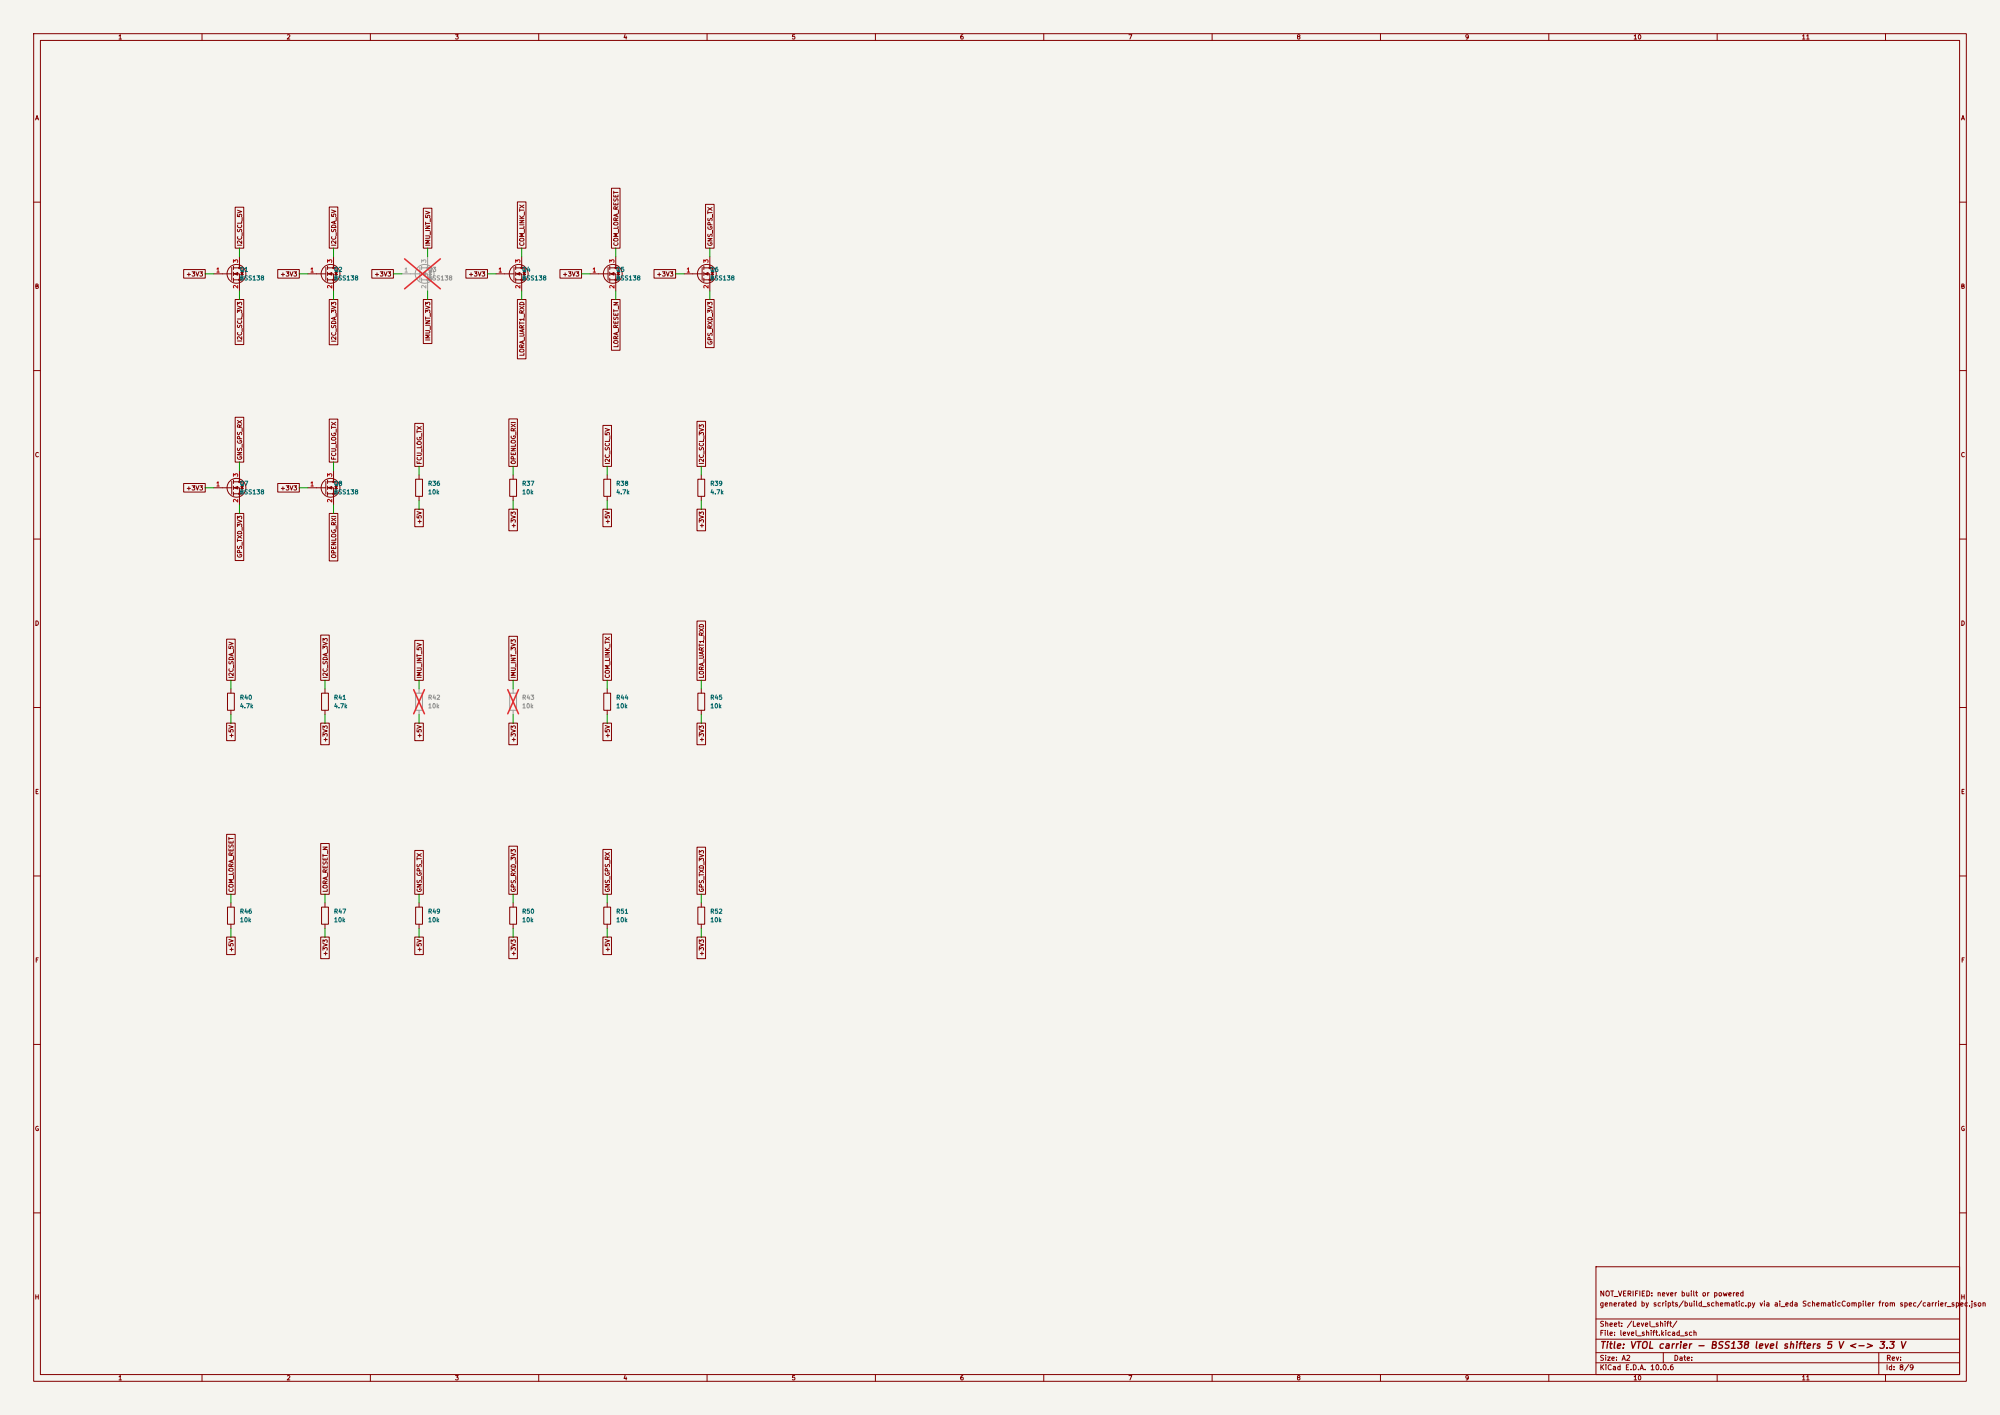
[picture p70: page 8]

Sheet: /Level_shift/
File: level_shift.kicad_sch
Title: VTOL carrier - BSS138 level shifters 5 V <-> 3.3 V

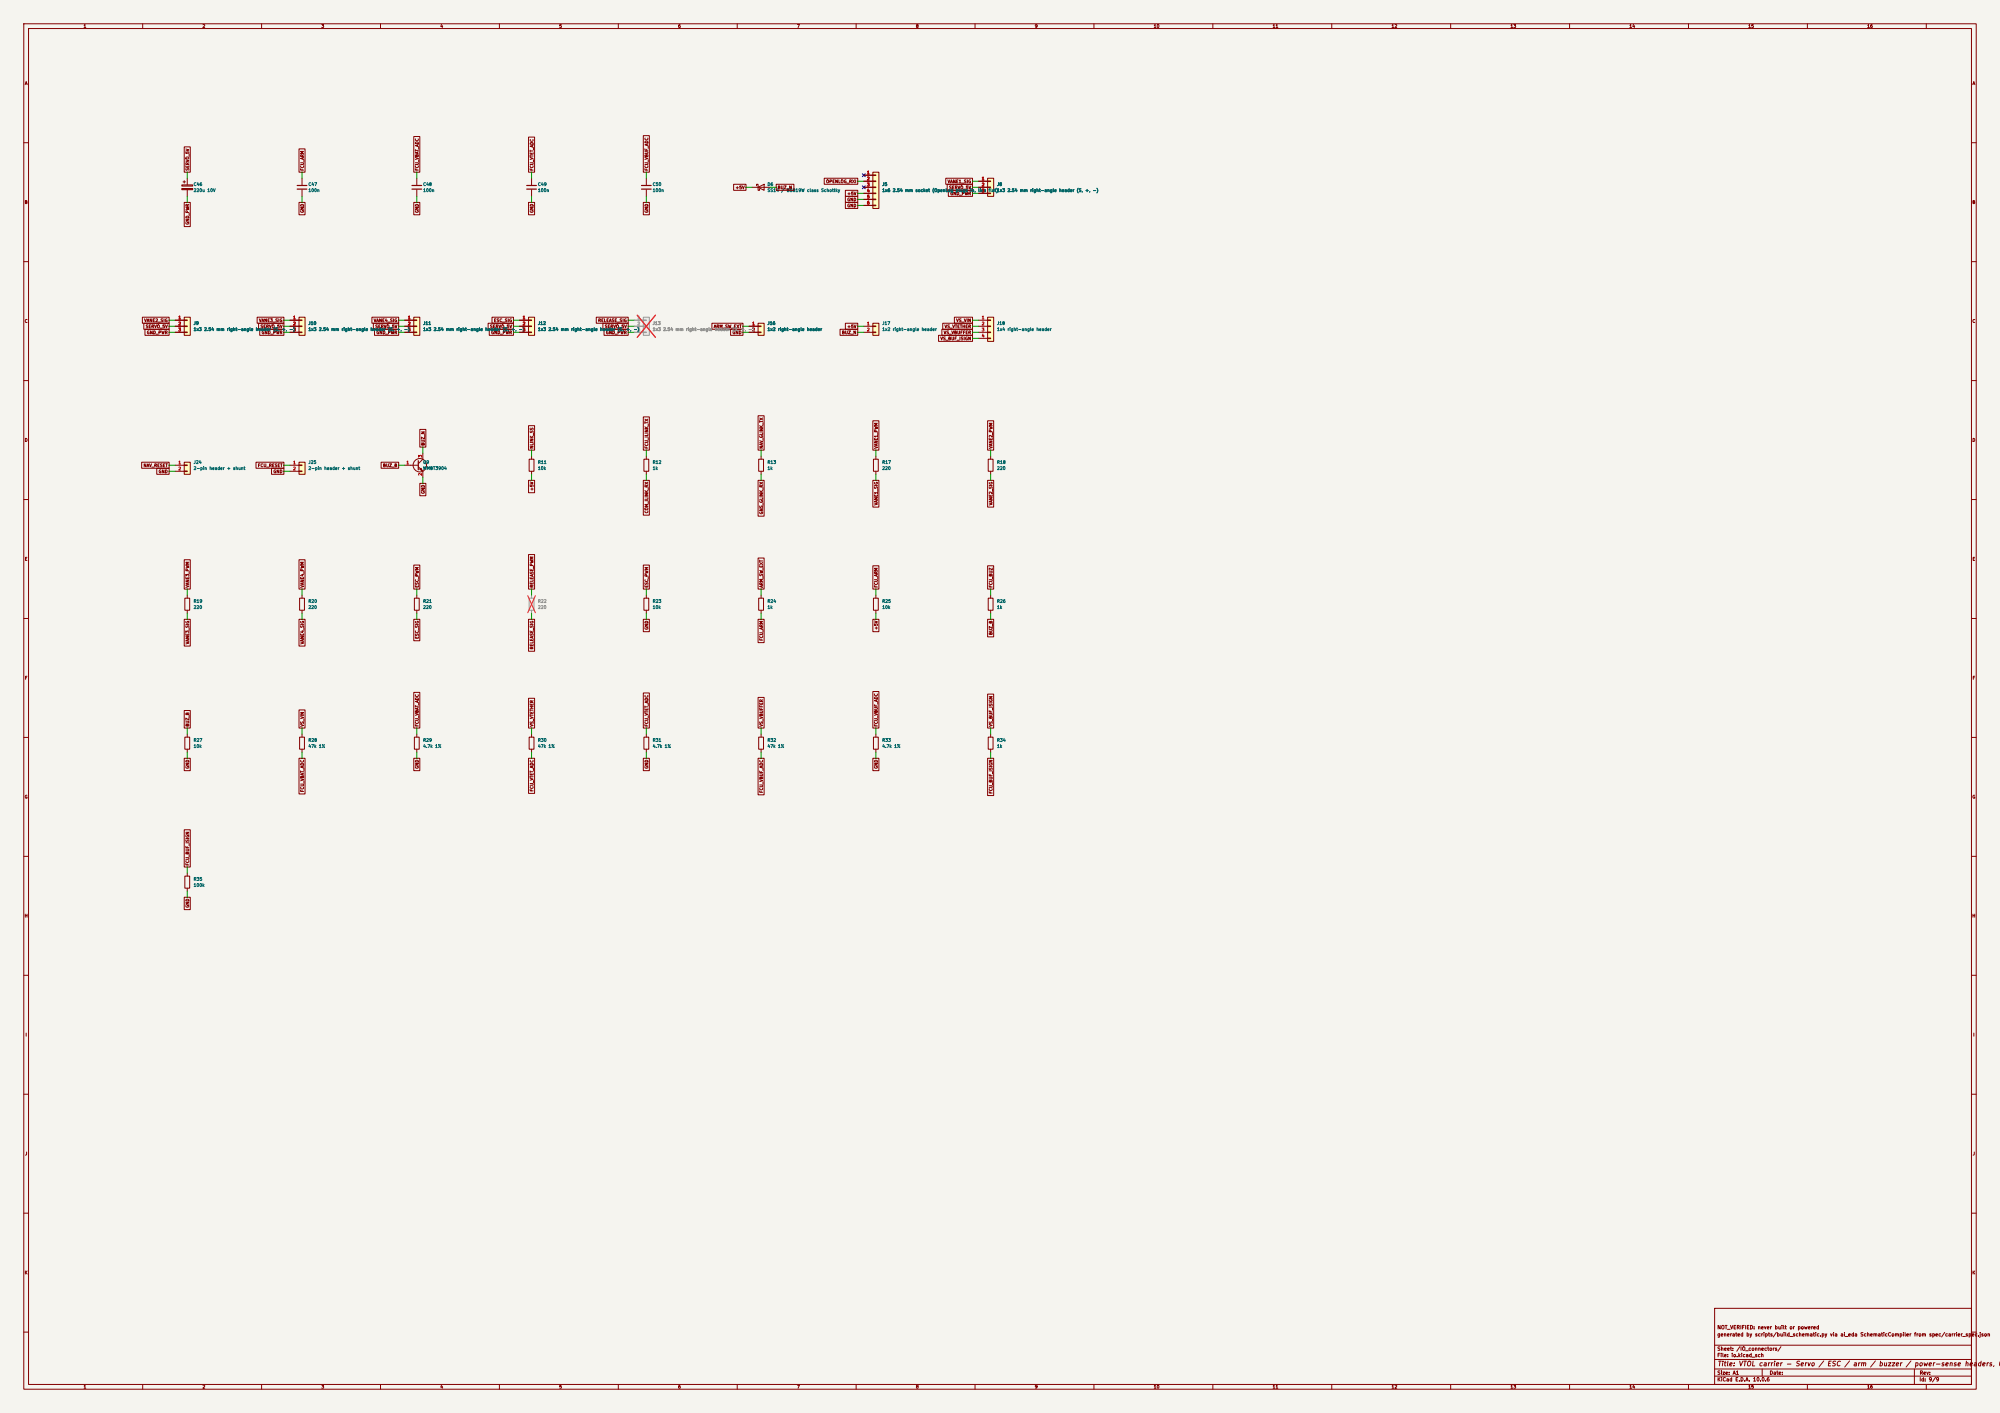
[picture p71: page 9]

1x3 2.54 mm right-angle header (S, +, -) D6
BUZ_N

1x3 2.54 mm right-angle header (S, +, -) 1

1x3 2.54 mm right-angle header (S, +, -) R21

1x3 2.54 mm right-angle header (S, +, -)
1x4 right-angle header R11

Sheet: /IO_connectors/
File: io.kicad_sch
Title: VTOL carrier - Servo / ESC / arm / buzzer / power-sense headers, OpenLog, inter-chip links
