Yuchan-00/CanSat_EDF_Rocket/(list of files, drawings)

Other design files:
pcb/vtol_carrier/archive/rev1_plm100_2s/kicad/schematic_manifest.json
pcb/vtol_carrier/archive/rev1_plm100_2s/kicad/work/vtol_carrier.dsn
pcb/vtol_carrier/archive/rev1_plm100_2s/kicad/work/vtol_carrier_stage2.dsn
pcb/vtol_carrier/kicad/schematic_manifest.json
pcb/vtol_carrier/kicad/work/freerouting_4layer_rev2c/vtol_carrier_complete.dsn
pcb/vtol_carrier/kicad/work/freerouting_4layer_rev2c/vtol_carrier_gnd.dsn
pcb/vtol_carrier/kicad/work/freerouting_4layer_rev2c/vtol_carrier_power.dsn
pcb/vtol_carrier/kicad/work/freerouting_4layer_rev2c/vtol_carrier_power_high.dsn
pcb/vtol_carrier/kicad/work/freerouting_4layer_rev2c/vtol_carrier_servo.dsn
pcb/vtol_carrier/kicad/work/freerouting_4layer_rev2c/vtol_carrier_signals.dsn
pcb/vtol_carrier/kicad/work/rev2b_freerouting_4layer/vtol_carrier_complete.dsn
pcb/vtol_carrier/kicad/work/rev2b_freerouting_4layer/vtol_carrier_gnd.dsn
pcb/vtol_carrier/kicad/work/rev2b_freerouting_4layer/vtol_carrier_power.dsn
pcb/vtol_carrier/kicad/work/rev2b_freerouting_4layer/vtol_carrier_power_high.dsn
pcb/vtol_carrier/kicad/work/rev2b_freerouting_4layer/vtol_carrier_servo.dsn
pcb/vtol_carrier/kicad/work/rev2b_freerouting_4layer/vtol_carrier_signals.dsn
pcb/vtol_carrier/kicad/work/stopped_rev2_attempt/vtol_carrier.dsn
pcb/vtol_carrier/kicad/work/stopped_rev2_attempt/vtol_carrier_stage2.dsn
