Yuchan-00/CanSat_EDF_Rocket/pcb/vtol_carrier/kicad/vtol_carrier.kicad_pcb

## KiCad design pcb/vtol_carrier/kicad/vtol_carrier.kicad_pcb (2026-11-05)

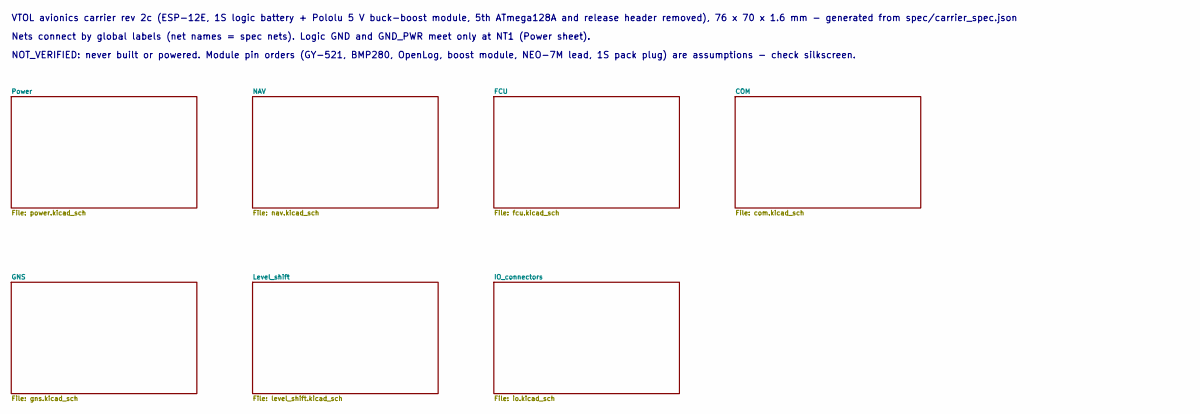
[picture p72: schematic vtol_carrier.kicad_sch, VTOL avionics carrier]

Notes on the sheet:
VTOL avionics carrier rev 2c (ESP-12E, 1S logic battery + Pololu 5 V buck-boost module, 5th ATmega128A and release header removed), 76 x 70 x 1.6 mm - generated from spec/carrier_spec.json
Nets connect by global labels (net names = spec nets). Logic GND and GND_PWR meet only at NT1 (Power sheet).
NOT_VERIFIED: never built or powered. Module pin orders (GY-521, BMP280, OpenLog, boost module, NEO-7M lead, 1S pack plug) are assumptions - check silkscreen.

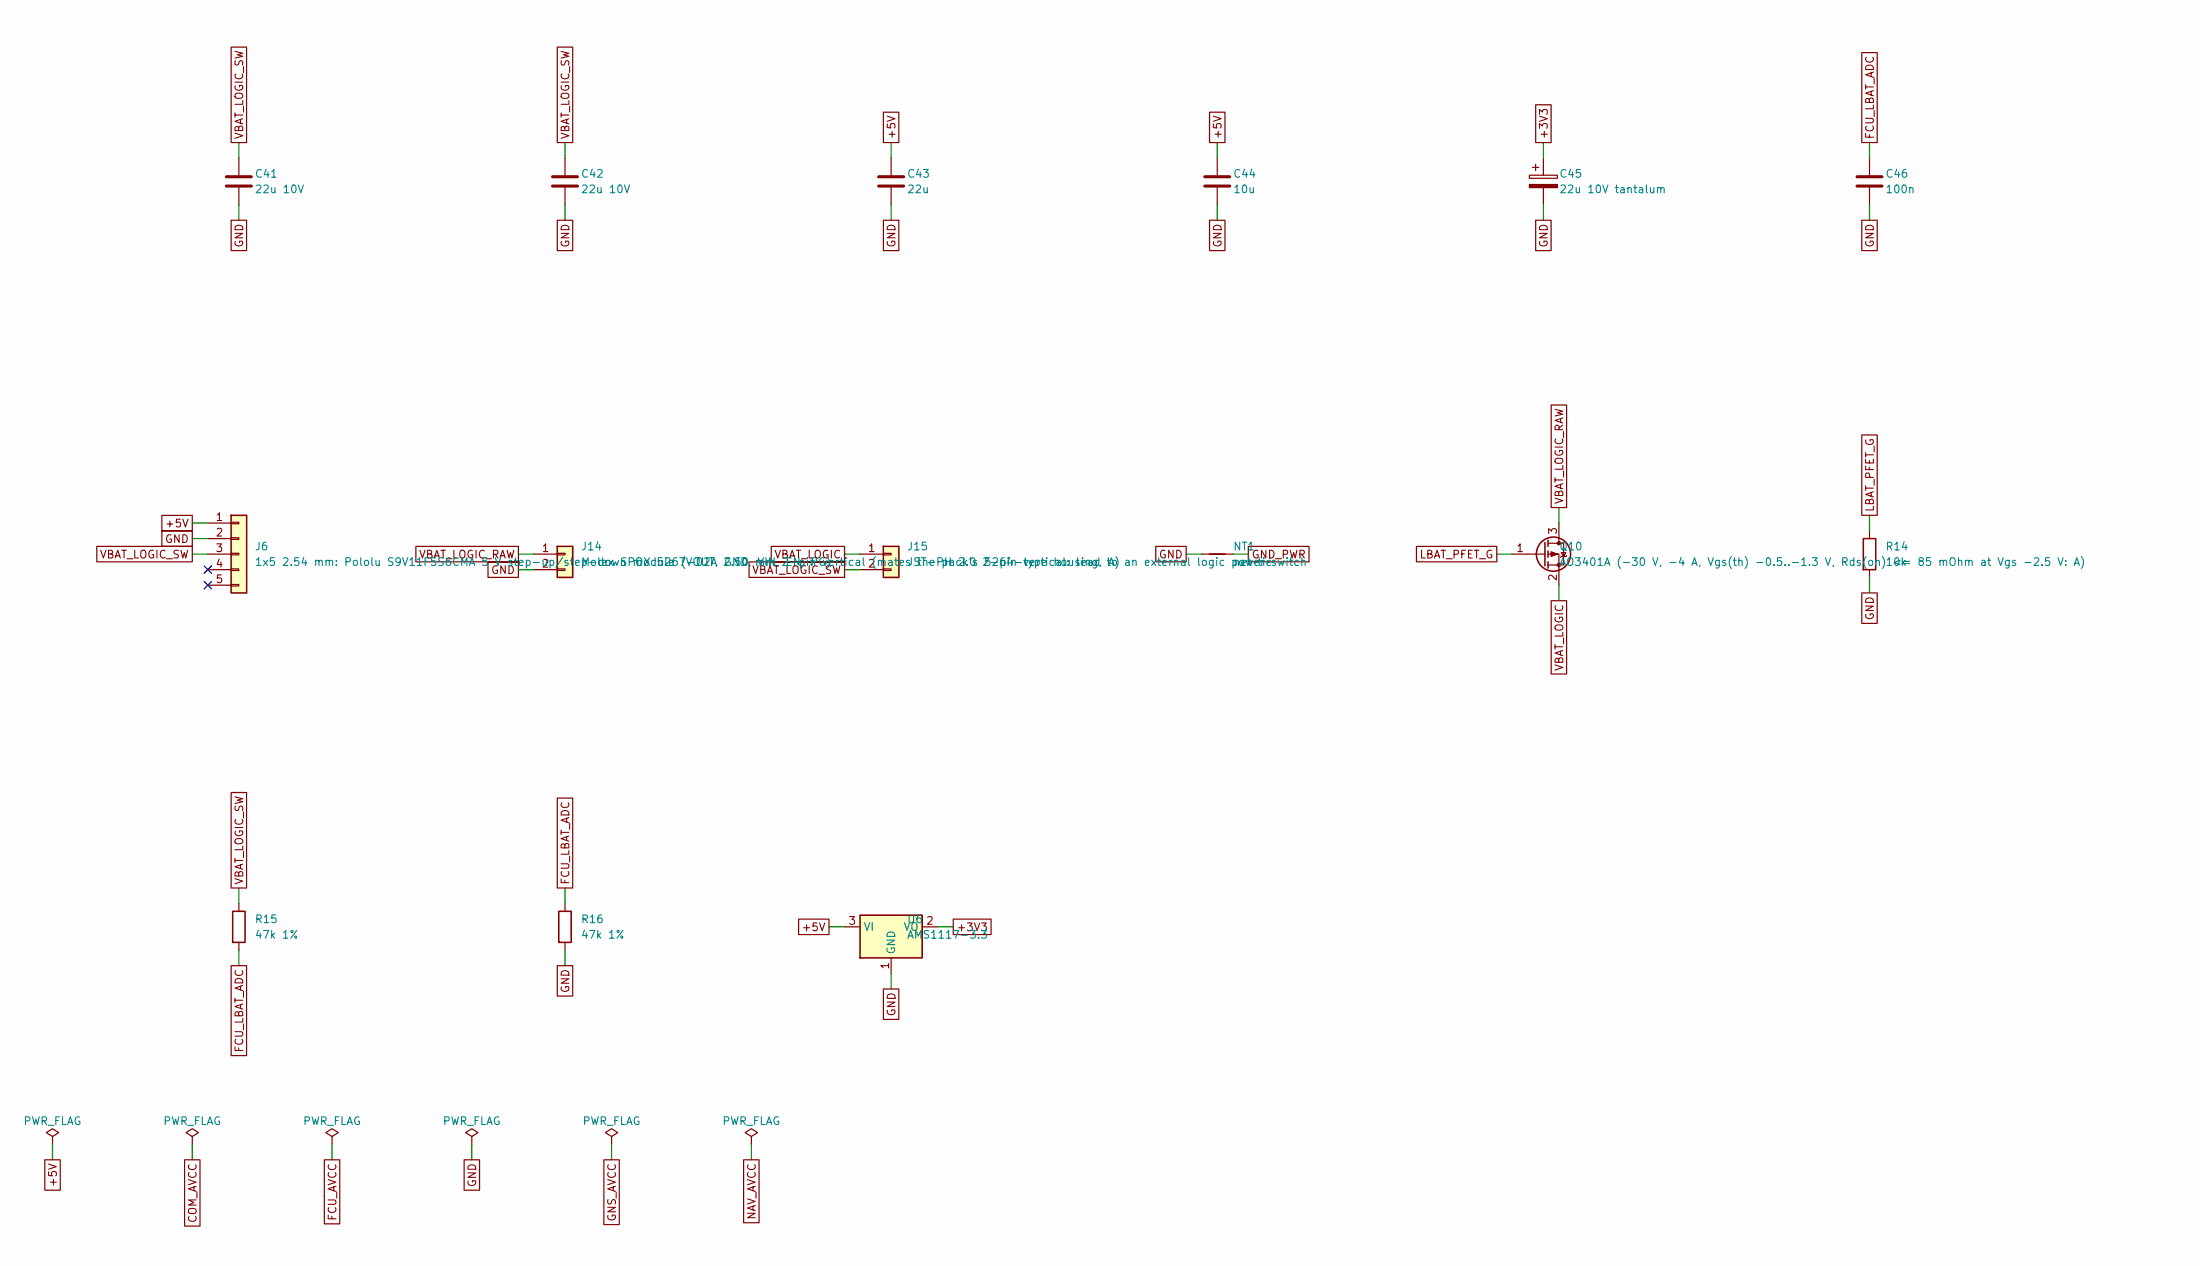
[picture p73: schematic power.kicad_sch, VTOL carrier - 1S logic battery input, reverse-polarity P-F…]

Parts:
C41, C42: 22u 10V; C_1206_3216Metric
C43: 22u; C_1206_3216Metric
C44: 10u; C_0805_2012Metric
C45: 22u 10V tantalum; CP_EIA-3216-18_Kemet-A
C46: 100n; C_0603_1608Metric
J6: 1x5 2.54 mm: Pololu S9V11F5S6CMA 5 V step-up/step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; PinHeader_1x05_P2.54mm_Vertical
J14: Molex SPOX 5267-02A 2.50 mm 2-pin vertical (mates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; Molex_SPOX_5267-02A_1x02_P2.50mm_Vertical
J15: JST-PH 2.0 2-pin vertical: lead to an external lo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; JST_PH_B2B-PH-K_1x02_P2.00mm_Vertical
NT1: net tie; NetTie-2_SMD_Pad0.5mm
Q10: AO3401A (-30 V, -4 A, Vgs(th) -0.5..-1.3 V, Rds(o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; SOT-23
R14: 10k; R_0603_1608Metric
R15, R16: 47k 1%; R_0603_1608Metric
U6: AMS1117-3.3; SOT-223-3_TabPin2

Connections:
+3V3: C45.1, U6.2 (VO); also elsewhere on the board
+5V: C43.1, C44.1, J6.1, U6.3 (VI); also elsewhere on the board
FCU_LBAT_ADC: C46.1, R15.2, R16.1; also elsewhere on the board
GND: C41.2, C42.2, C43.2, C44.2, C45.2, C46.2, J6.2, J14.2, NT1.1, R14.2, R16.2, U6.1 (GND); also elsewhere on the board
GND_PWR: NT1.2; also elsewhere on the board
LBAT_PFET_G: Q10.1 (G), R14.1
VBAT_LOGIC: J15.1, Q10.2 (S)
VBAT_LOGIC_RAW: J14.1, Q10.3 (D)
VBAT_LOGIC_SW: C41.1, C42.1, J6.3, J15.2, R15.1

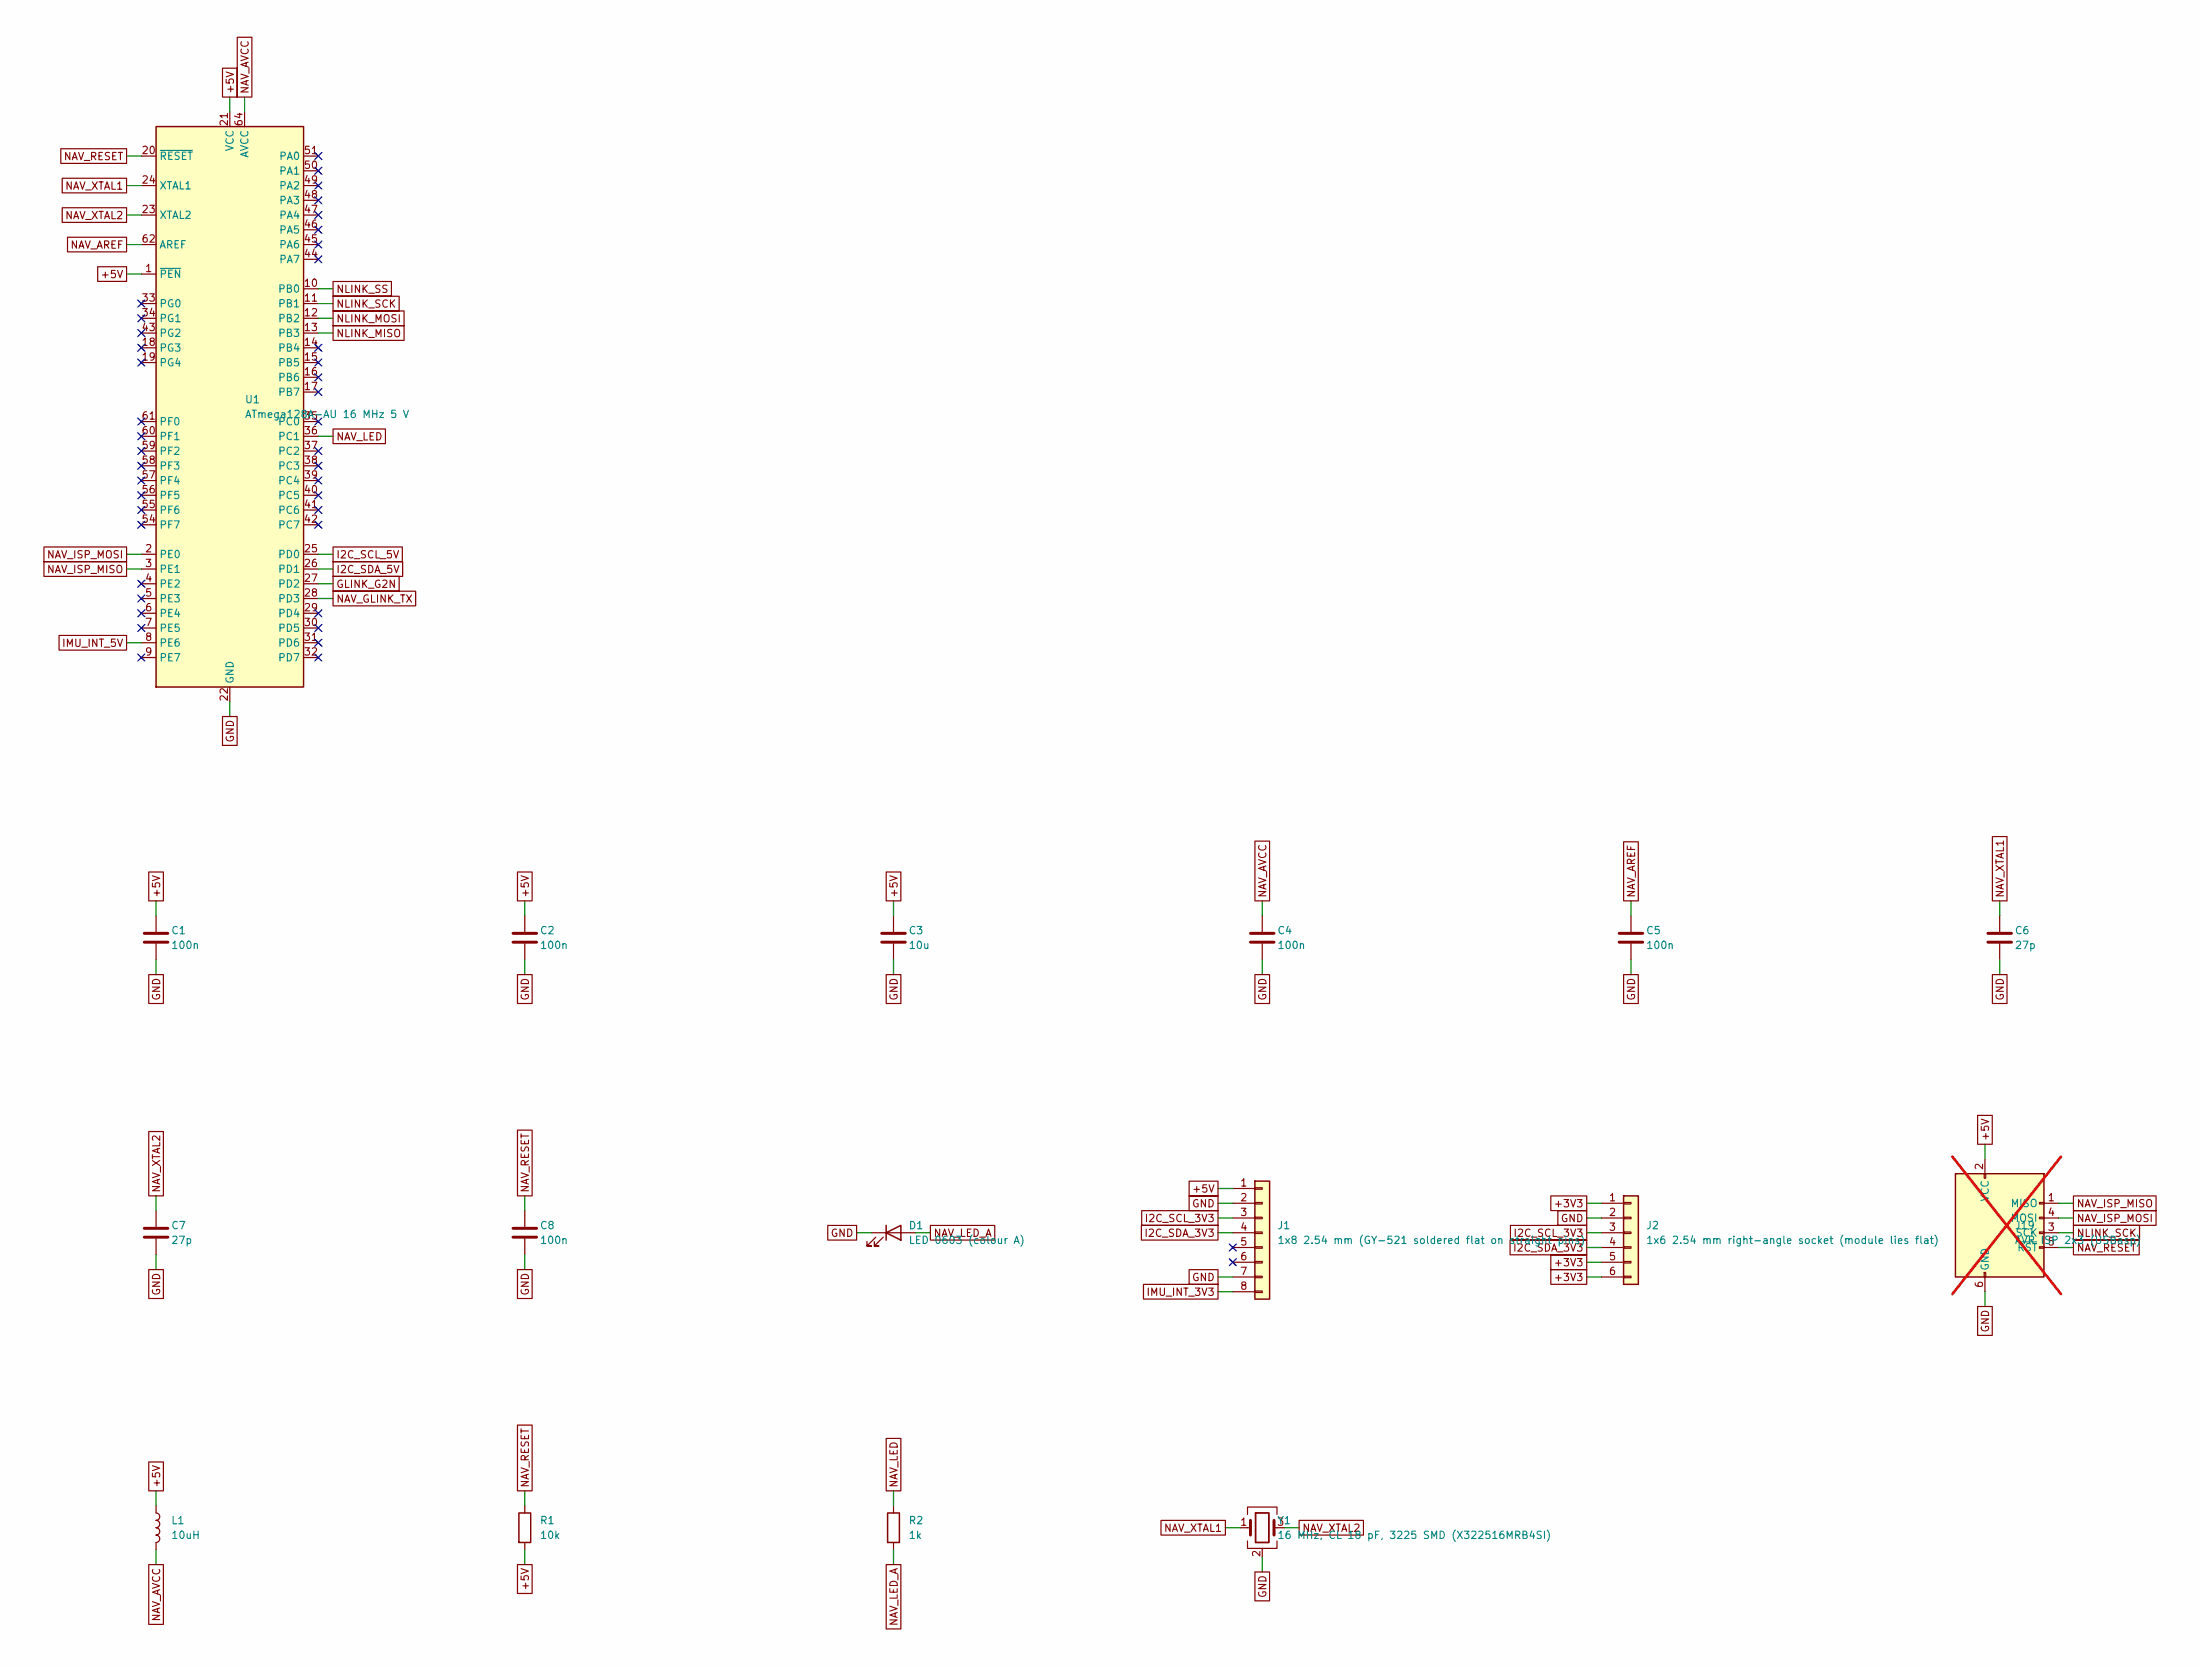
[picture p74: schematic nav.kicad_sch, VTOL carrier - NAV ATmega128A + GY-521 IMU + BMP280 baromet…]

Parts:
C1, C2, C4: 100n; C_0402_1005Metric
C3: 10u; C_0805_2012Metric
C5, C8: 100n; C_0603_1608Metric
C6, C7: 27p; C_0402_1005Metric
D1: LED 0603 (colour A); LED_0603_1608Metric
J1: 1x8 2.54 mm (GY-521 soldered flat on straight pin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; PinHeader_1x08_P2.54mm_Vertical
J2: 1x6 2.54 mm right-angle socket (module lies flat); PinSocket_1x06_P2.54mm_Horizontal
J19: AVR ISP 2x3 (USBasp); PinHeader_2x03_P2.54mm_Vertical; not fitted
L1: 10uH; L_0805_2012Metric
R1: 10k; R_0603_1608Metric
R2: 1k; R_0603_1608Metric
U1: ATmega128A-AU 16 MHz 5 V; TQFP-64_14x14mm_P0.8mm
Y1: 16 MHz, CL 18 pF, 3225 SMD (X322516MRB4SI); Crystal_SMD_3225-4Pin_3.2x2.5mm

Connections:
+3V3: J2.1, J2.5, J2.6; also elsewhere on the board
+5V: C1.1, C2.1, C3.1, J1.1, J19.2 (VCC), L1.1, R1.2, U1.1 (~PEN), U1.21 (VCC), U1.52 (VCC); also elsewhere on the board
GLINK_G2N: U1.27 (PD2); also elsewhere on the board
GND: C1.2, C2.2, C3.2, C4.2, C5.2, C6.2, C7.2, C8.2, D1.1 (K), J1.2, J1.7, J2.2, J19.6 (GND), U1.22 (GND), U1.53 (GND), U1.63 (GND), Y1.2 (G), Y1.4 (G); also elsewhere on the board
I2C_SCL_3V3: J1.3, J2.3; also elsewhere on the board
I2C_SCL_5V: U1.25 (PD0); also elsewhere on the board
I2C_SDA_3V3: J1.4, J2.4; also elsewhere on the board
I2C_SDA_5V: U1.26 (PD1); also elsewhere on the board
IMU_INT_3V3: J1.8; also elsewhere on the board
IMU_INT_5V: U1.8 (PE6); also elsewhere on the board
NAV_AREF: C5.1, U1.62 (AREF)
NAV_AVCC: C4.1, L1.2, U1.64 (AVCC)
NAV_GLINK_TX: U1.28 (PD3); also elsewhere on the board
NAV_ISP_MISO: J19.1 (MISO), U1.3 (PE1)
NAV_ISP_MOSI: J19.4 (MOSI), U1.2 (PE0)
NAV_LED: R2.1, U1.36 (PC1)
NAV_LED_A: D1.2 (A), R2.2
NAV_RESET: C8.1, J19.5 (~RST), R1.1, U1.20 (~RESET); also elsewhere on the board
NAV_XTAL1: C6.1, U1.24 (XTAL1), Y1.1
NAV_XTAL2: C7.1, U1.23 (XTAL2), Y1.3
NLINK_MISO: U1.13 (PB3); also elsewhere on the board
NLINK_MOSI: U1.12 (PB2); also elsewhere on the board
NLINK_SCK: J19.3 (SCK), U1.11 (PB1); also elsewhere on the board
NLINK_SS: U1.10 (PB0); also elsewhere on the board

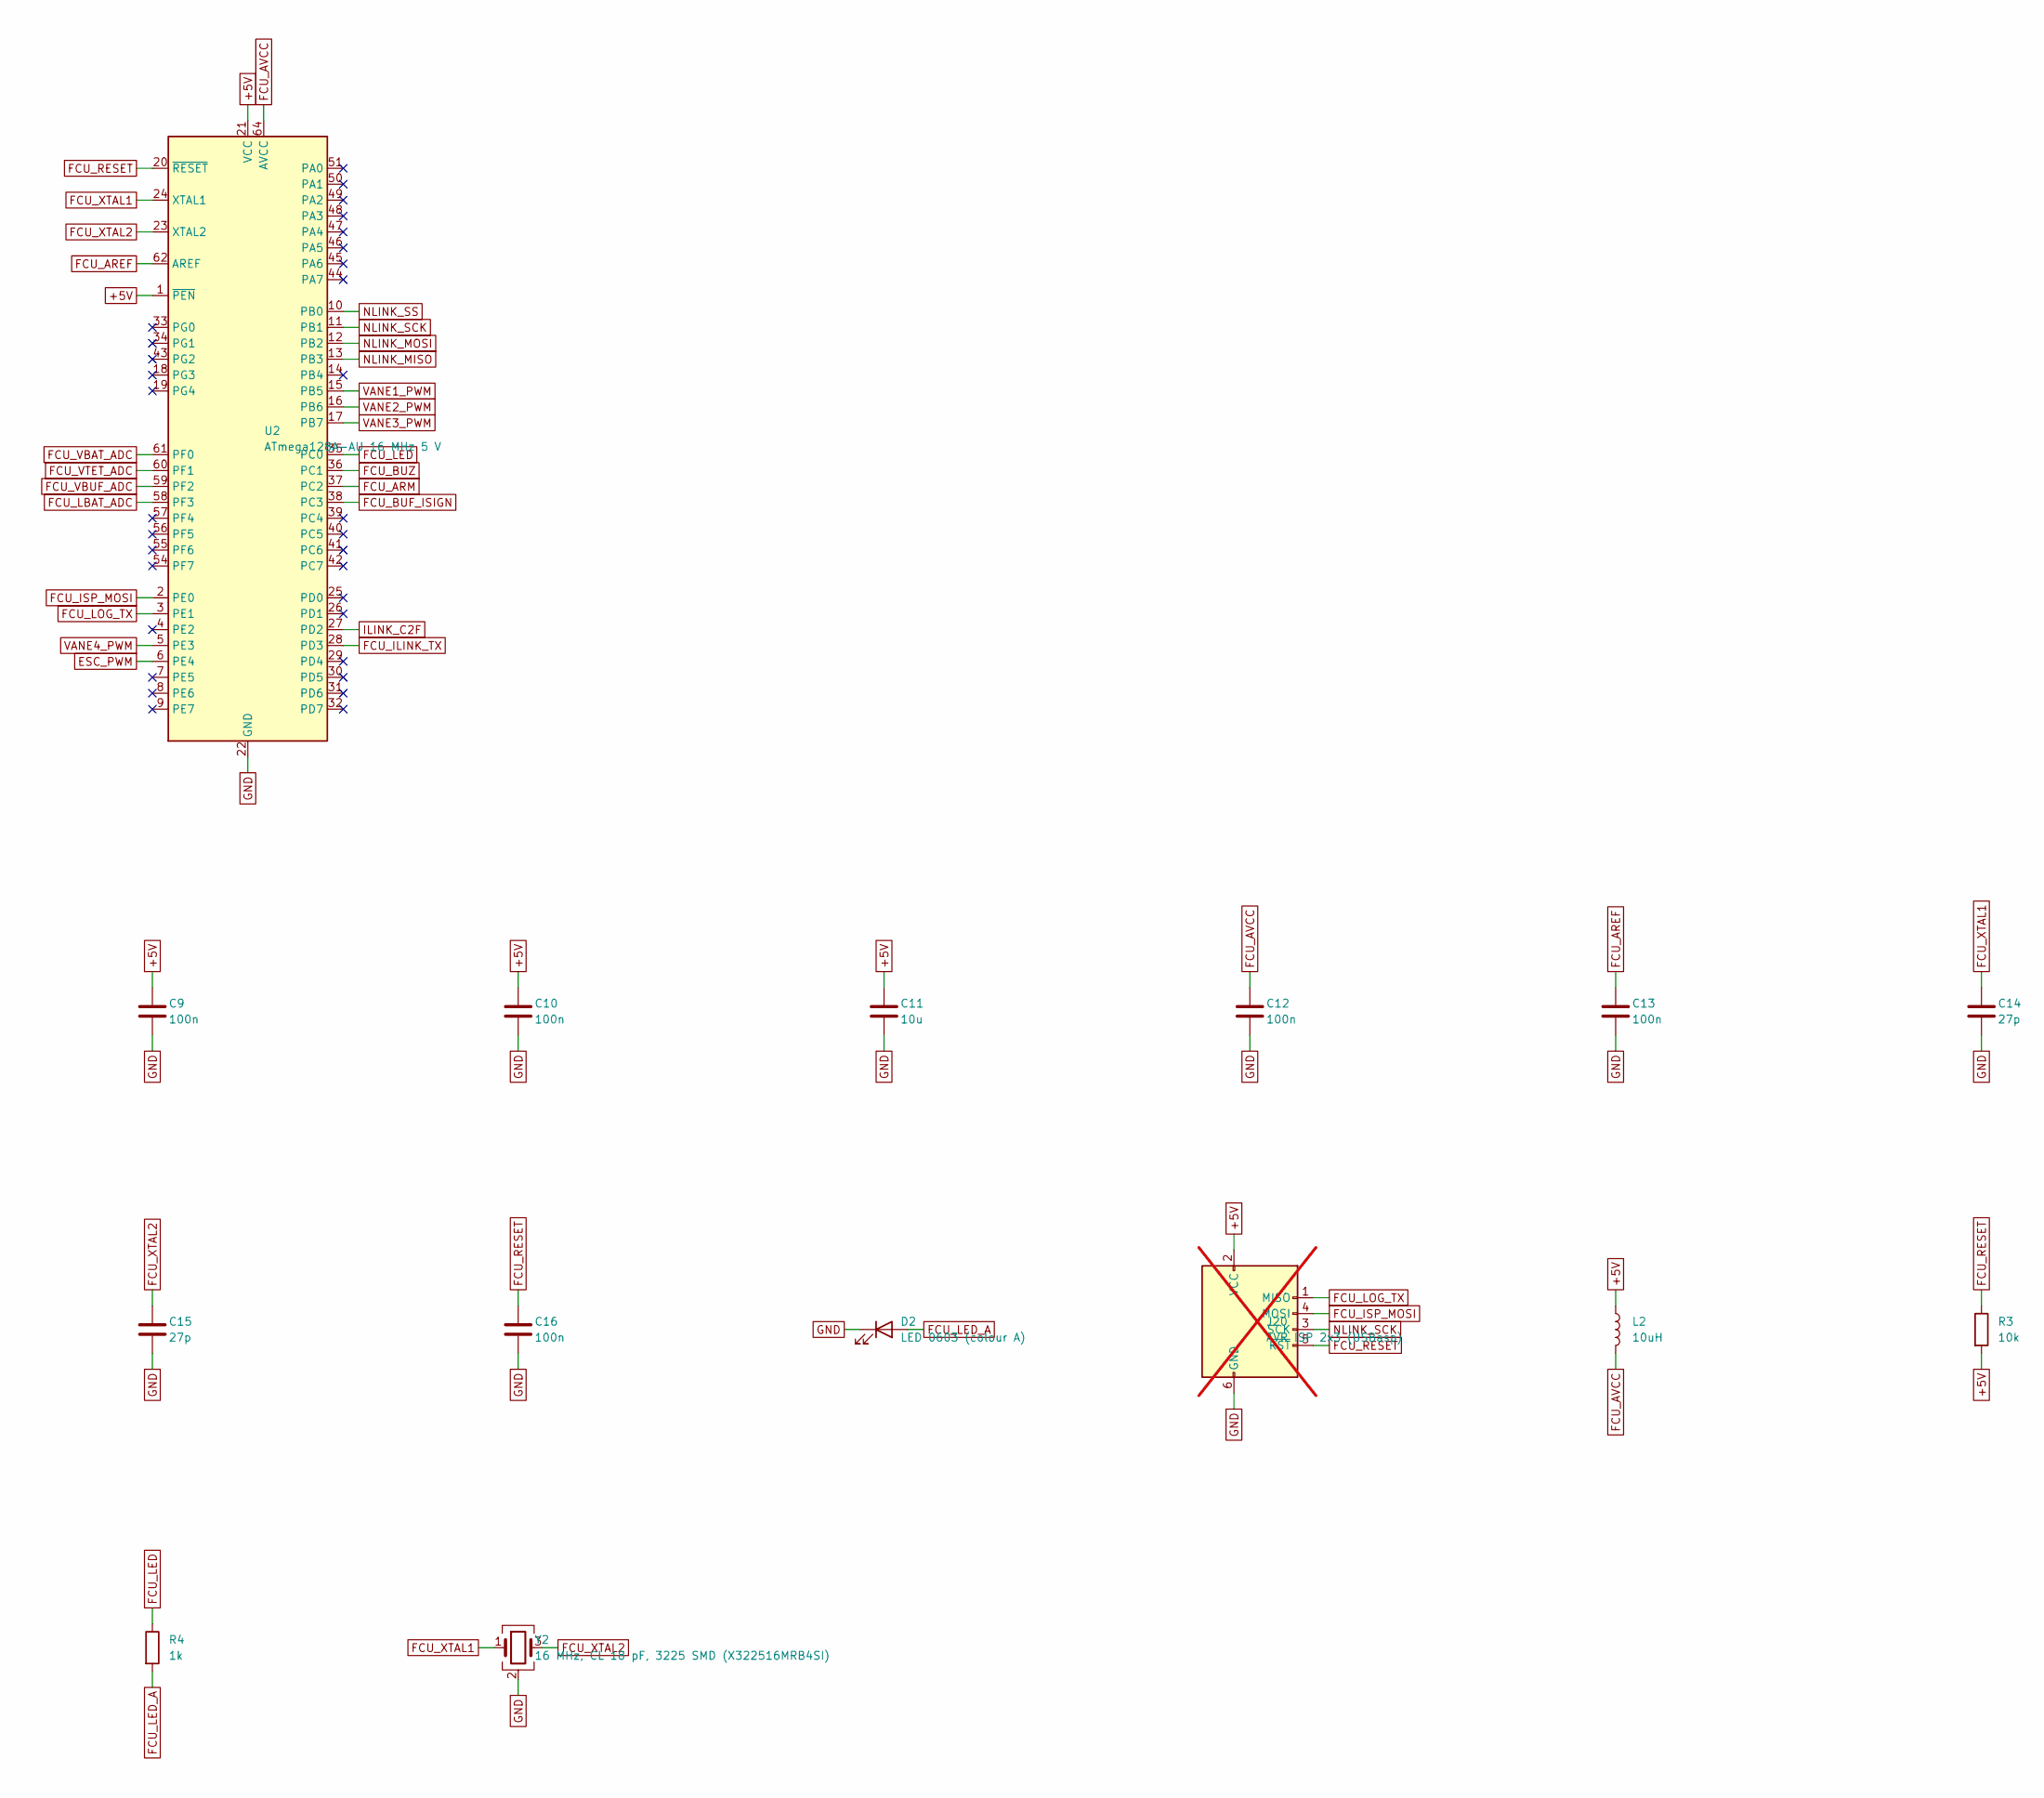
[picture p75: schematic fcu.kicad_sch, VTOL carrier - FCU ATmega128A]

Parts:
C9, C10, C12: 100n; C_0402_1005Metric
C11: 10u; C_0805_2012Metric
C13, C16: 100n; C_0603_1608Metric
C14, C15: 27p; C_0402_1005Metric
D2: LED 0603 (colour A); LED_0603_1608Metric
J20: AVR ISP 2x3 (USBasp); PinHeader_2x03_P2.54mm_Vertical; not fitted
L2: 10uH; L_0805_2012Metric
R3: 10k; R_0603_1608Metric
R4: 1k; R_0603_1608Metric
U2: ATmega128A-AU 16 MHz 5 V; TQFP-64_14x14mm_P0.8mm
Y2: 16 MHz, CL 18 pF, 3225 SMD (X322516MRB4SI); Crystal_SMD_3225-4Pin_3.2x2.5mm

Connections:
+5V: C9.1, C10.1, C11.1, J20.2 (VCC), L2.1, R3.2, U2.1 (~PEN), U2.21 (VCC), U2.52 (VCC); also elsewhere on the board
ESC_PWM: U2.6 (PE4); also elsewhere on the board
FCU_AREF: C13.1, U2.62 (AREF)
FCU_ARM: U2.37 (PC2); also elsewhere on the board
FCU_AVCC: C12.1, L2.2, U2.64 (AVCC)
FCU_BUF_ISIGN: U2.38 (PC3); also elsewhere on the board
FCU_BUZ: U2.36 (PC1); also elsewhere on the board
FCU_ILINK_TX: U2.28 (PD3); also elsewhere on the board
FCU_ISP_MOSI: J20.4 (MOSI), U2.2 (PE0)
FCU_LBAT_ADC: U2.58 (PF3); also elsewhere on the board
FCU_LED: R4.1, U2.35 (PC0)
FCU_LED_A: D2.2 (A), R4.2
FCU_LOG_TX: J20.1 (MISO), U2.3 (PE1); also elsewhere on the board
FCU_RESET: C16.1, J20.5 (~RST), R3.1, U2.20 (~RESET); also elsewhere on the board
FCU_VBAT_ADC: U2.61 (PF0); also elsewhere on the board
FCU_VBUF_ADC: U2.59 (PF2); also elsewhere on the board
FCU_VTET_ADC: U2.60 (PF1); also elsewhere on the board
FCU_XTAL1: C14.1, U2.24 (XTAL1), Y2.1
FCU_XTAL2: C15.1, U2.23 (XTAL2), Y2.3
GND: C9.2, C10.2, C11.2, C12.2, C13.2, C14.2, C15.2, C16.2, D2.1 (K), J20.6 (GND), U2.22 (GND), U2.53 (GND), U2.63 (GND), Y2.2 (G), Y2.4 (G); also elsewhere on the board
ILINK_C2F: U2.27 (PD2); also elsewhere on the board
NLINK_MISO: U2.13 (PB3); also elsewhere on the board
NLINK_MOSI: U2.12 (PB2); also elsewhere on the board
NLINK_SCK: J20.3 (SCK), U2.11 (PB1); also elsewhere on the board
NLINK_SS: U2.10 (PB0); also elsewhere on the board
VANE1_PWM: U2.15 (PB5); also elsewhere on the board
VANE2_PWM: U2.16 (PB6); also elsewhere on the board
VANE3_PWM: U2.17 (PB7); also elsewhere on the board
VANE4_PWM: U2.5 (PE3); also elsewhere on the board

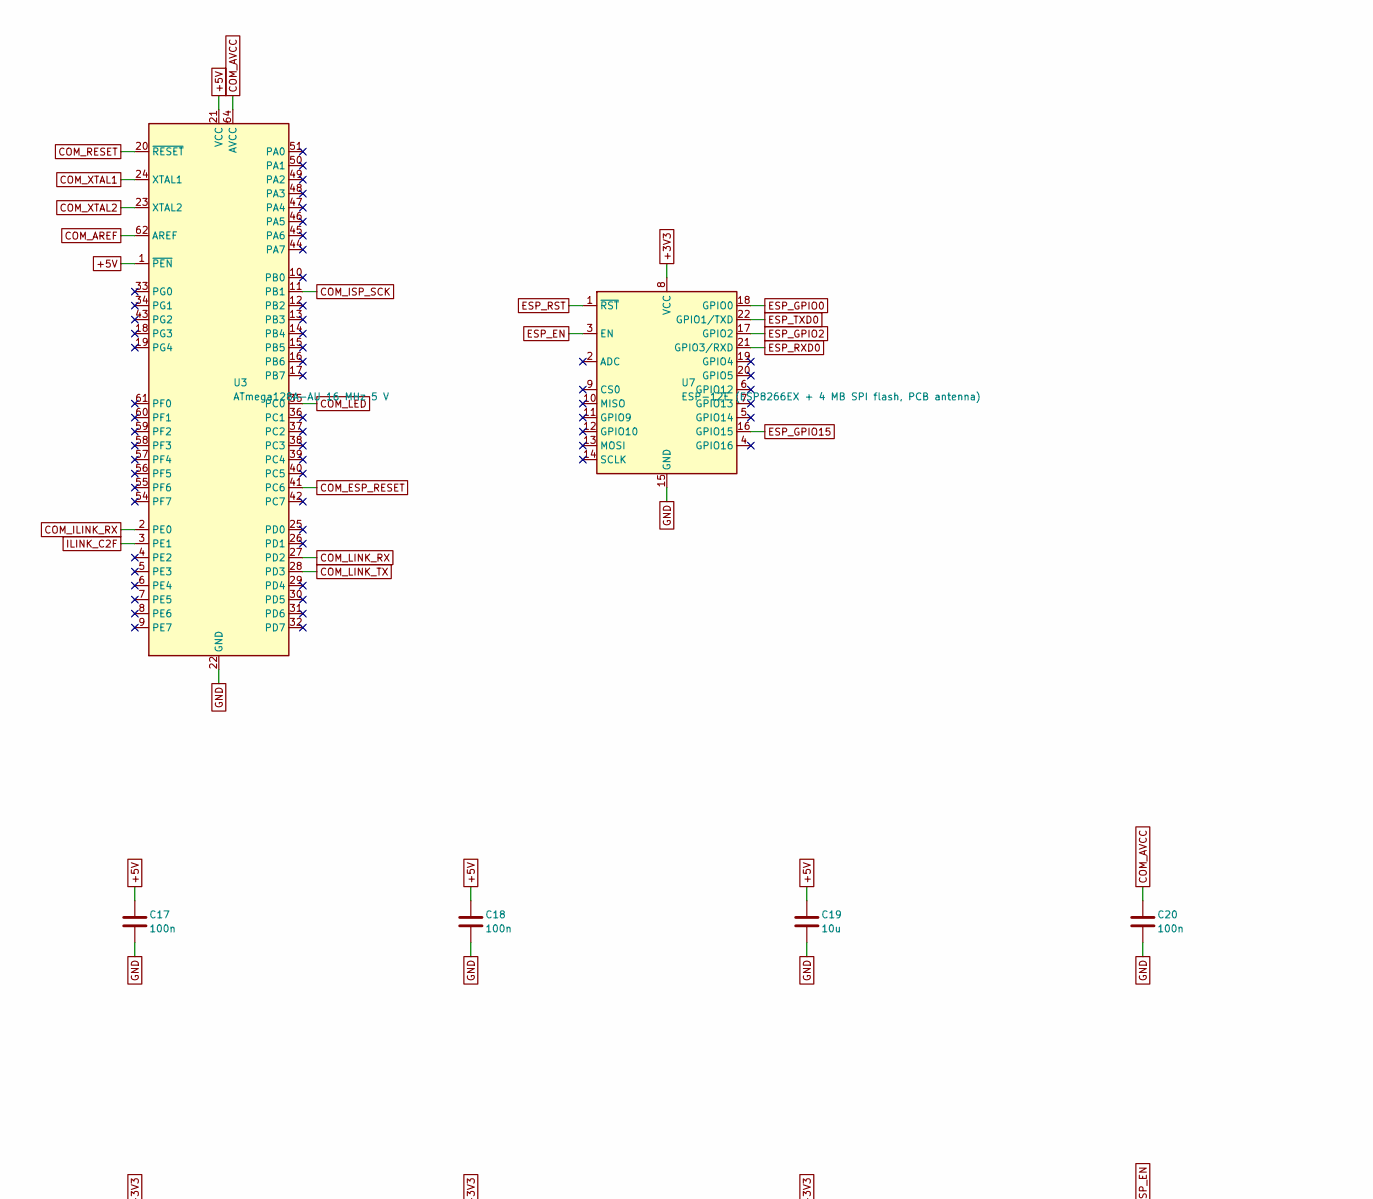
[picture p76: schematic com.kicad_sch, VTOL carrier - COM ATmega128A + ESP-12E Wi-Fi bridge (solde…, part in row 1, column 1]

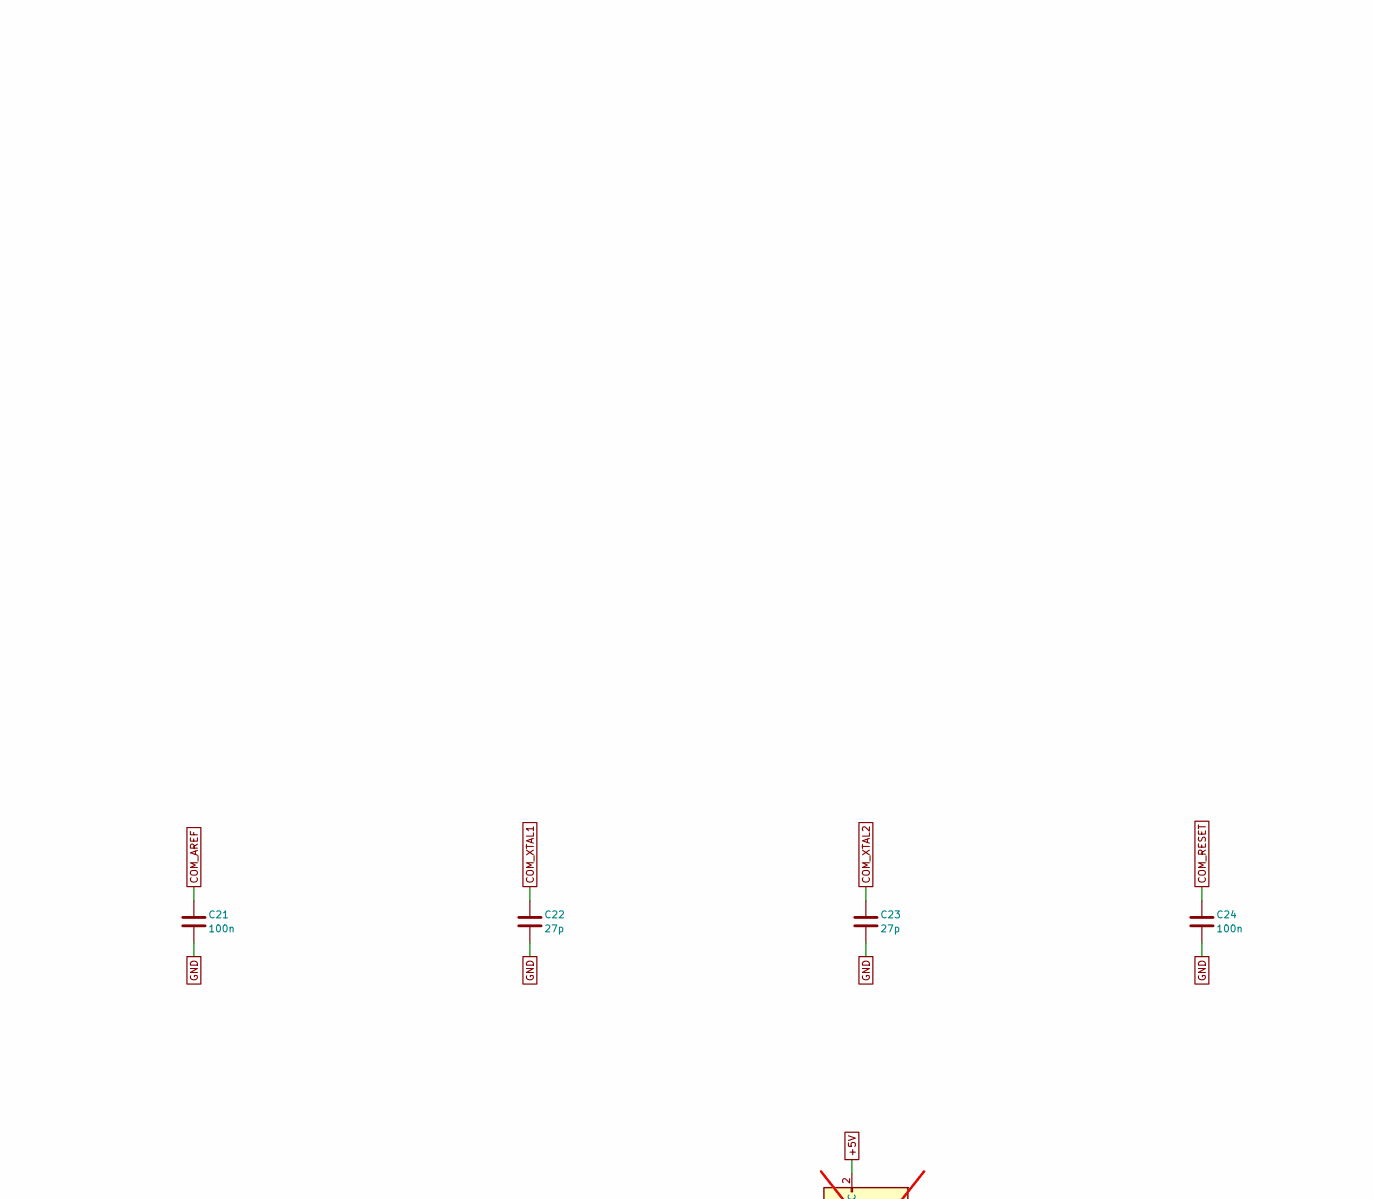
[picture p77: schematic com.kicad_sch, VTOL carrier - COM ATmega128A + ESP-12E Wi-Fi bridge (solde…, part in row 1, column 2]

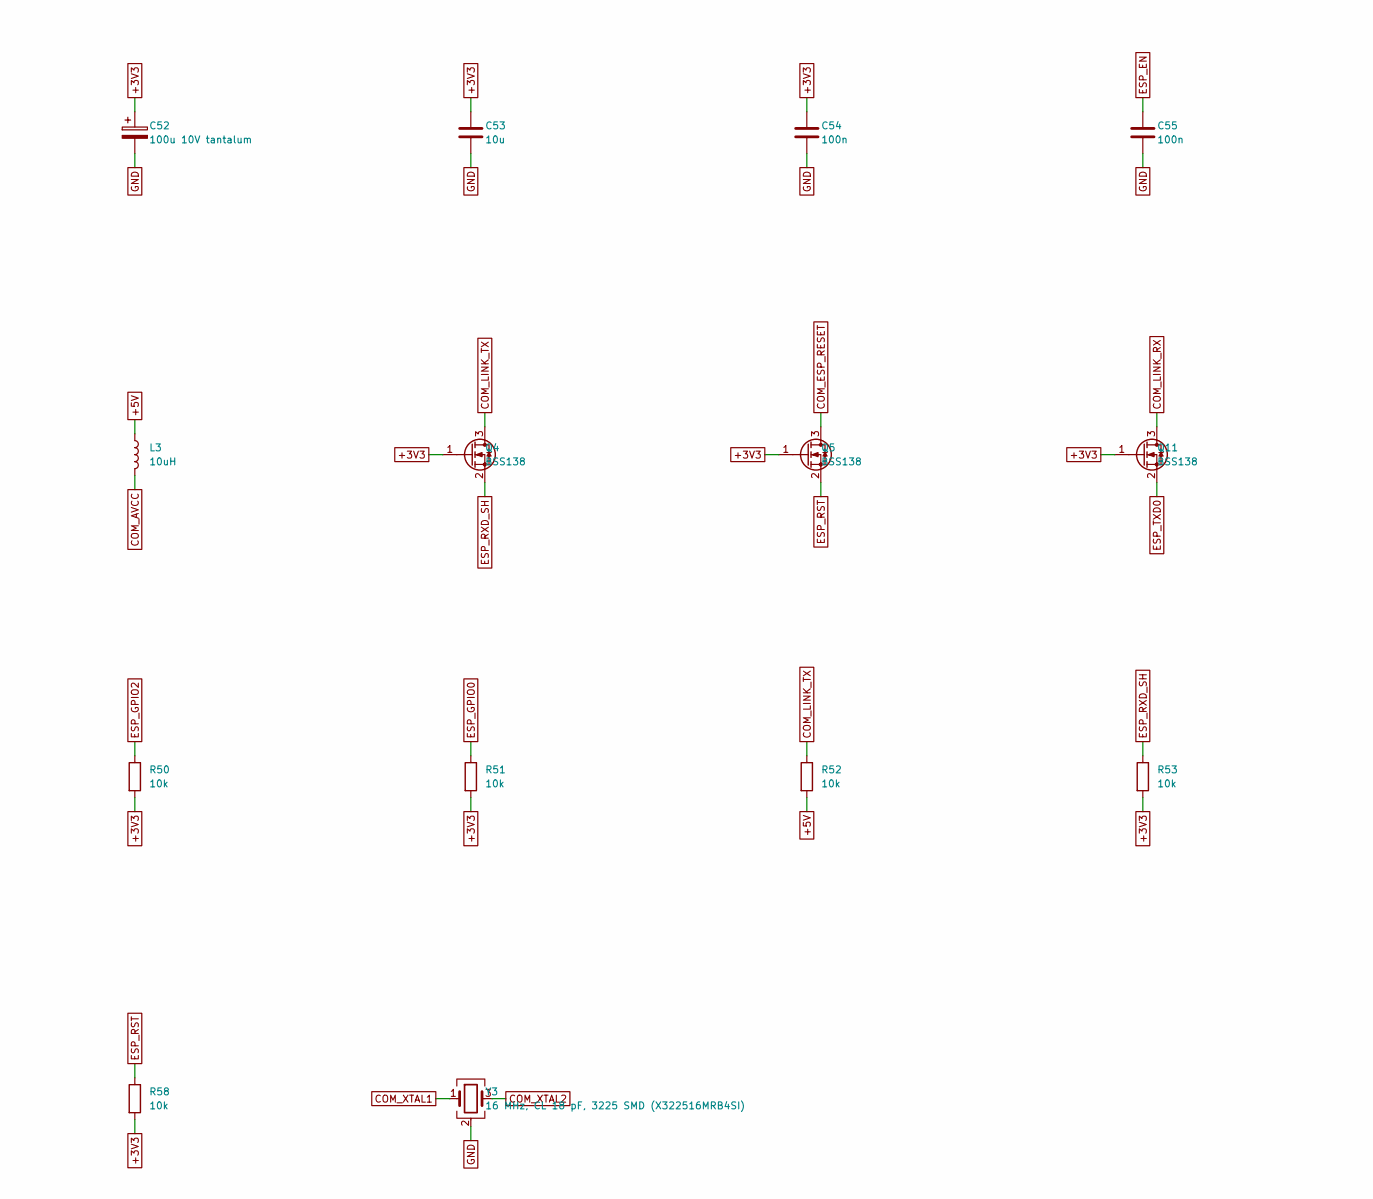
[picture p78: schematic com.kicad_sch, VTOL carrier - COM ATmega128A + ESP-12E Wi-Fi bridge (solde…, part in row 2, column 1]

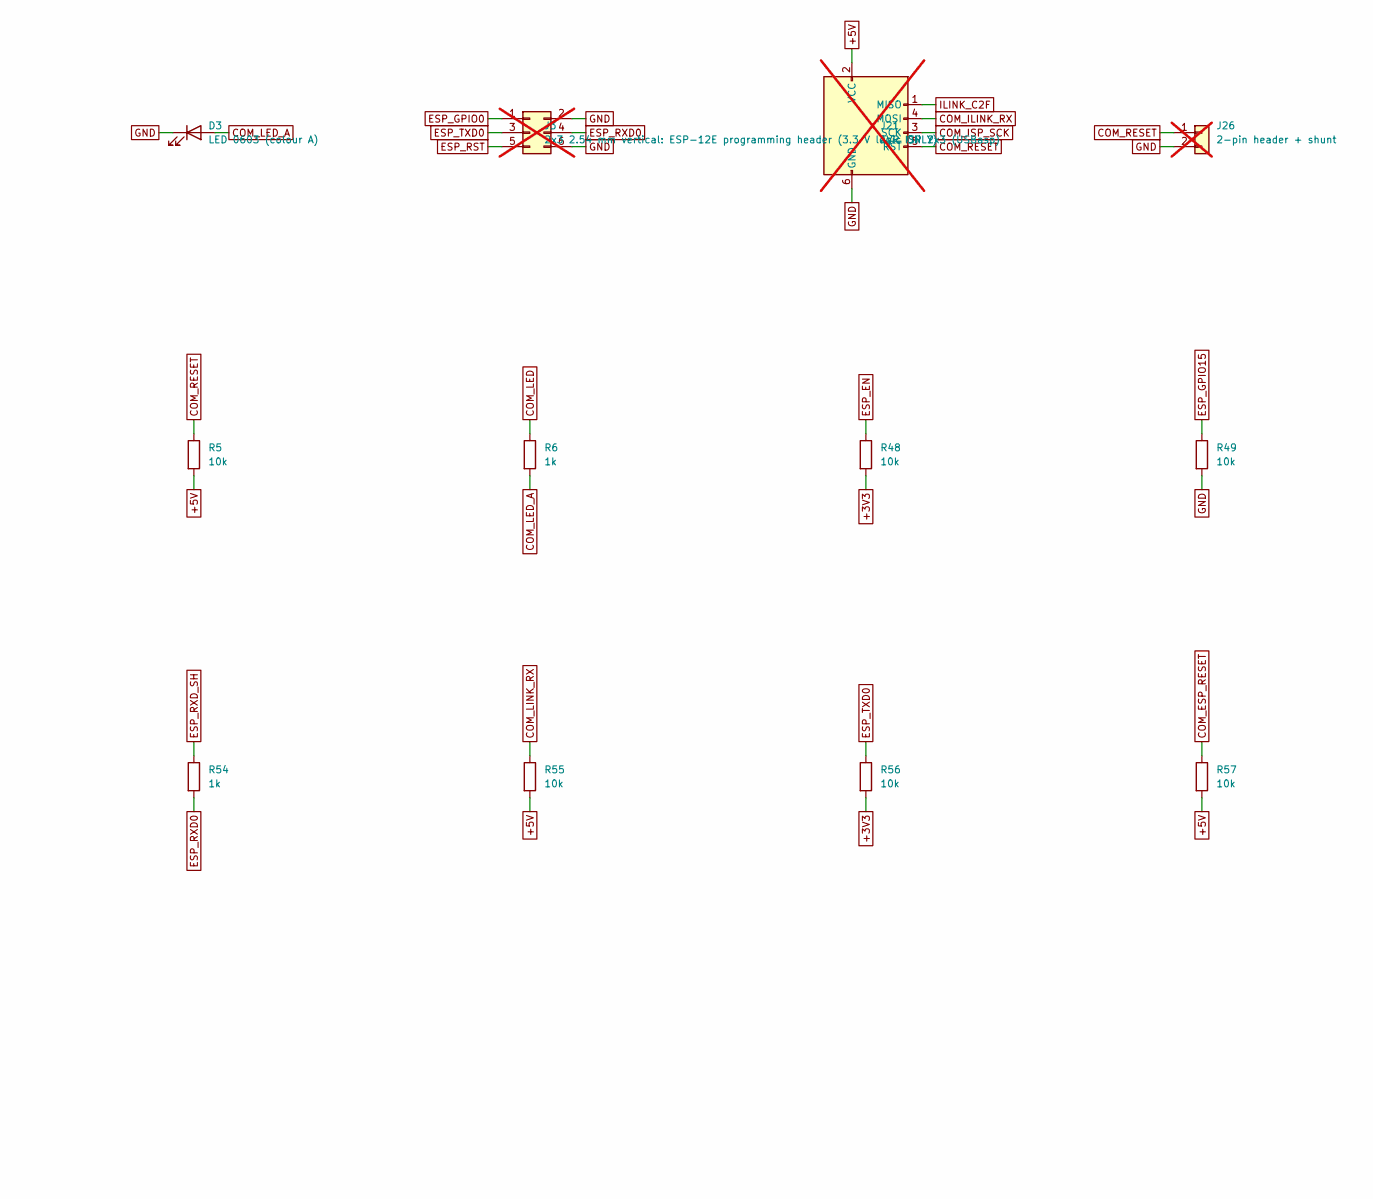
[picture p79: schematic com.kicad_sch, VTOL carrier - COM ATmega128A + ESP-12E Wi-Fi bridge (solde…, part in row 2, column 2]

Parts:
C17, C18, C20, C54: 100n; C_0402_1005Metric
C19, C53: 10u; C_0805_2012Metric
C21, C24, C55: 100n; C_0603_1608Metric
C22, C23: 27p; C_0402_1005Metric
C52: 100u 10V tantalum; CP_EIA-3528-21_Kemet-B
D3: LED 0603 (colour A); LED_0603_1608Metric
J3: 2x3 2.54 mm vertical: ESP-12E programming header 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; PinHeader_2x03_P2.54mm_Vertical; not fitted
J21: AVR ISP 2x3 (USBasp); PinHeader_2x03_P2.54mm_Vertical; not fitted
J26: 2-pin header + shunt; PinHeader_1x02_P2.54mm_Vertical; not fitted
L3: 10uH; L_0805_2012Metric
Q4, Q5, Q11: BSS138; SOT-23
R5, R48, R49, R50, R51, R52, R53, R55, R56, R57, R58: 10k; R_0603_1608Metric
R6, R54: 1k; R_0603_1608Metric
U3: ATmega128A-AU 16 MHz 5 V; TQFP-64_14x14mm_P0.8mm
U7: ESP-12E (ESP8266EX + 4 MB SPI flash, PCB antenna); ESP-12E
Y3: 16 MHz, CL 18 pF, 3225 SMD (X322516MRB4SI); Crystal_SMD_3225-4Pin_3.2x2.5mm

Connections:
+3V3: C52.1, C53.1, C54.1, Q4.1 (G), Q5.1 (G), Q11.1 (G), R48.2, R50.2, R51.2, R53.2, R56.2, R58.2, U7.8 (VCC); also elsewhere on the board
+5V: C17.1, C18.1, C19.1, J21.2 (VCC), L3.1, R5.2, R52.2, R55.2, R57.2, U3.1 (~PEN), U3.21 (VCC), U3.52 (VCC); also elsewhere on the board
COM_AREF: C21.1, U3.62 (AREF)
COM_AVCC: C20.1, L3.2, U3.64 (AVCC)
COM_ESP_RESET: Q5.3 (D), R57.1, U3.41 (PC6)
COM_ILINK_RX: J21.4 (MOSI), U3.2 (PE0); also elsewhere on the board
COM_ISP_SCK: J21.3 (SCK), U3.11 (PB1)
COM_LED: R6.1, U3.35 (PC0)
COM_LED_A: D3.2 (A), R6.2
COM_LINK_RX: Q11.3 (D), R55.1, U3.27 (PD2)
COM_LINK_TX: Q4.3 (D), R52.1, U3.28 (PD3)
COM_RESET: C24.1, J21.5 (~RST), J26.1, R5.1, U3.20 (~RESET)
COM_XTAL1: C22.1, U3.24 (XTAL1), Y3.1
COM_XTAL2: C23.1, U3.23 (XTAL2), Y3.3
ESP_EN: C55.1, R48.1, U7.3 (EN)
ESP_GPIO0: J3.1, R51.1, U7.18 (GPIO0)
ESP_GPIO2: R50.1, U7.17 (GPIO2)
ESP_GPIO15: R49.1, U7.16 (GPIO15)
ESP_RST: J3.5, Q5.2 (S), R58.1, U7.1 (~RST)
ESP_RXD0: J3.4, R54.2, U7.21 (GPIO3/RXD)
ESP_RXD_SH: Q4.2 (S), R53.1, R54.1
ESP_TXD0: J3.3, Q11.2 (S), R56.1, U7.22 (GPIO1/TXD)
GND: C17.2, C18.2, C19.2, C20.2, C21.2, C22.2, C23.2, C24.2, C52.2, C53.2, C54.2, C55.2, D3.1 (K), J3.2, J3.6, J21.6 (GND), J26.2, R49.2, U3.22 (GND), U3.53 (GND), U3.63 (GND), U7.15 (GND), Y3.2 (G), Y3.4 (G); also elsewhere on the board
ILINK_C2F: J21.1 (MISO), U3.3 (PE1); also elsewhere on the board
