Yuchan-00/CanSat_EDF_Rocket/pcb/vtol_carrier/kicad/vtol_carrier.kicad_pcb

## KiCad design pcb/vtol_carrier/kicad/vtol_carrier.kicad_pcb (continued)

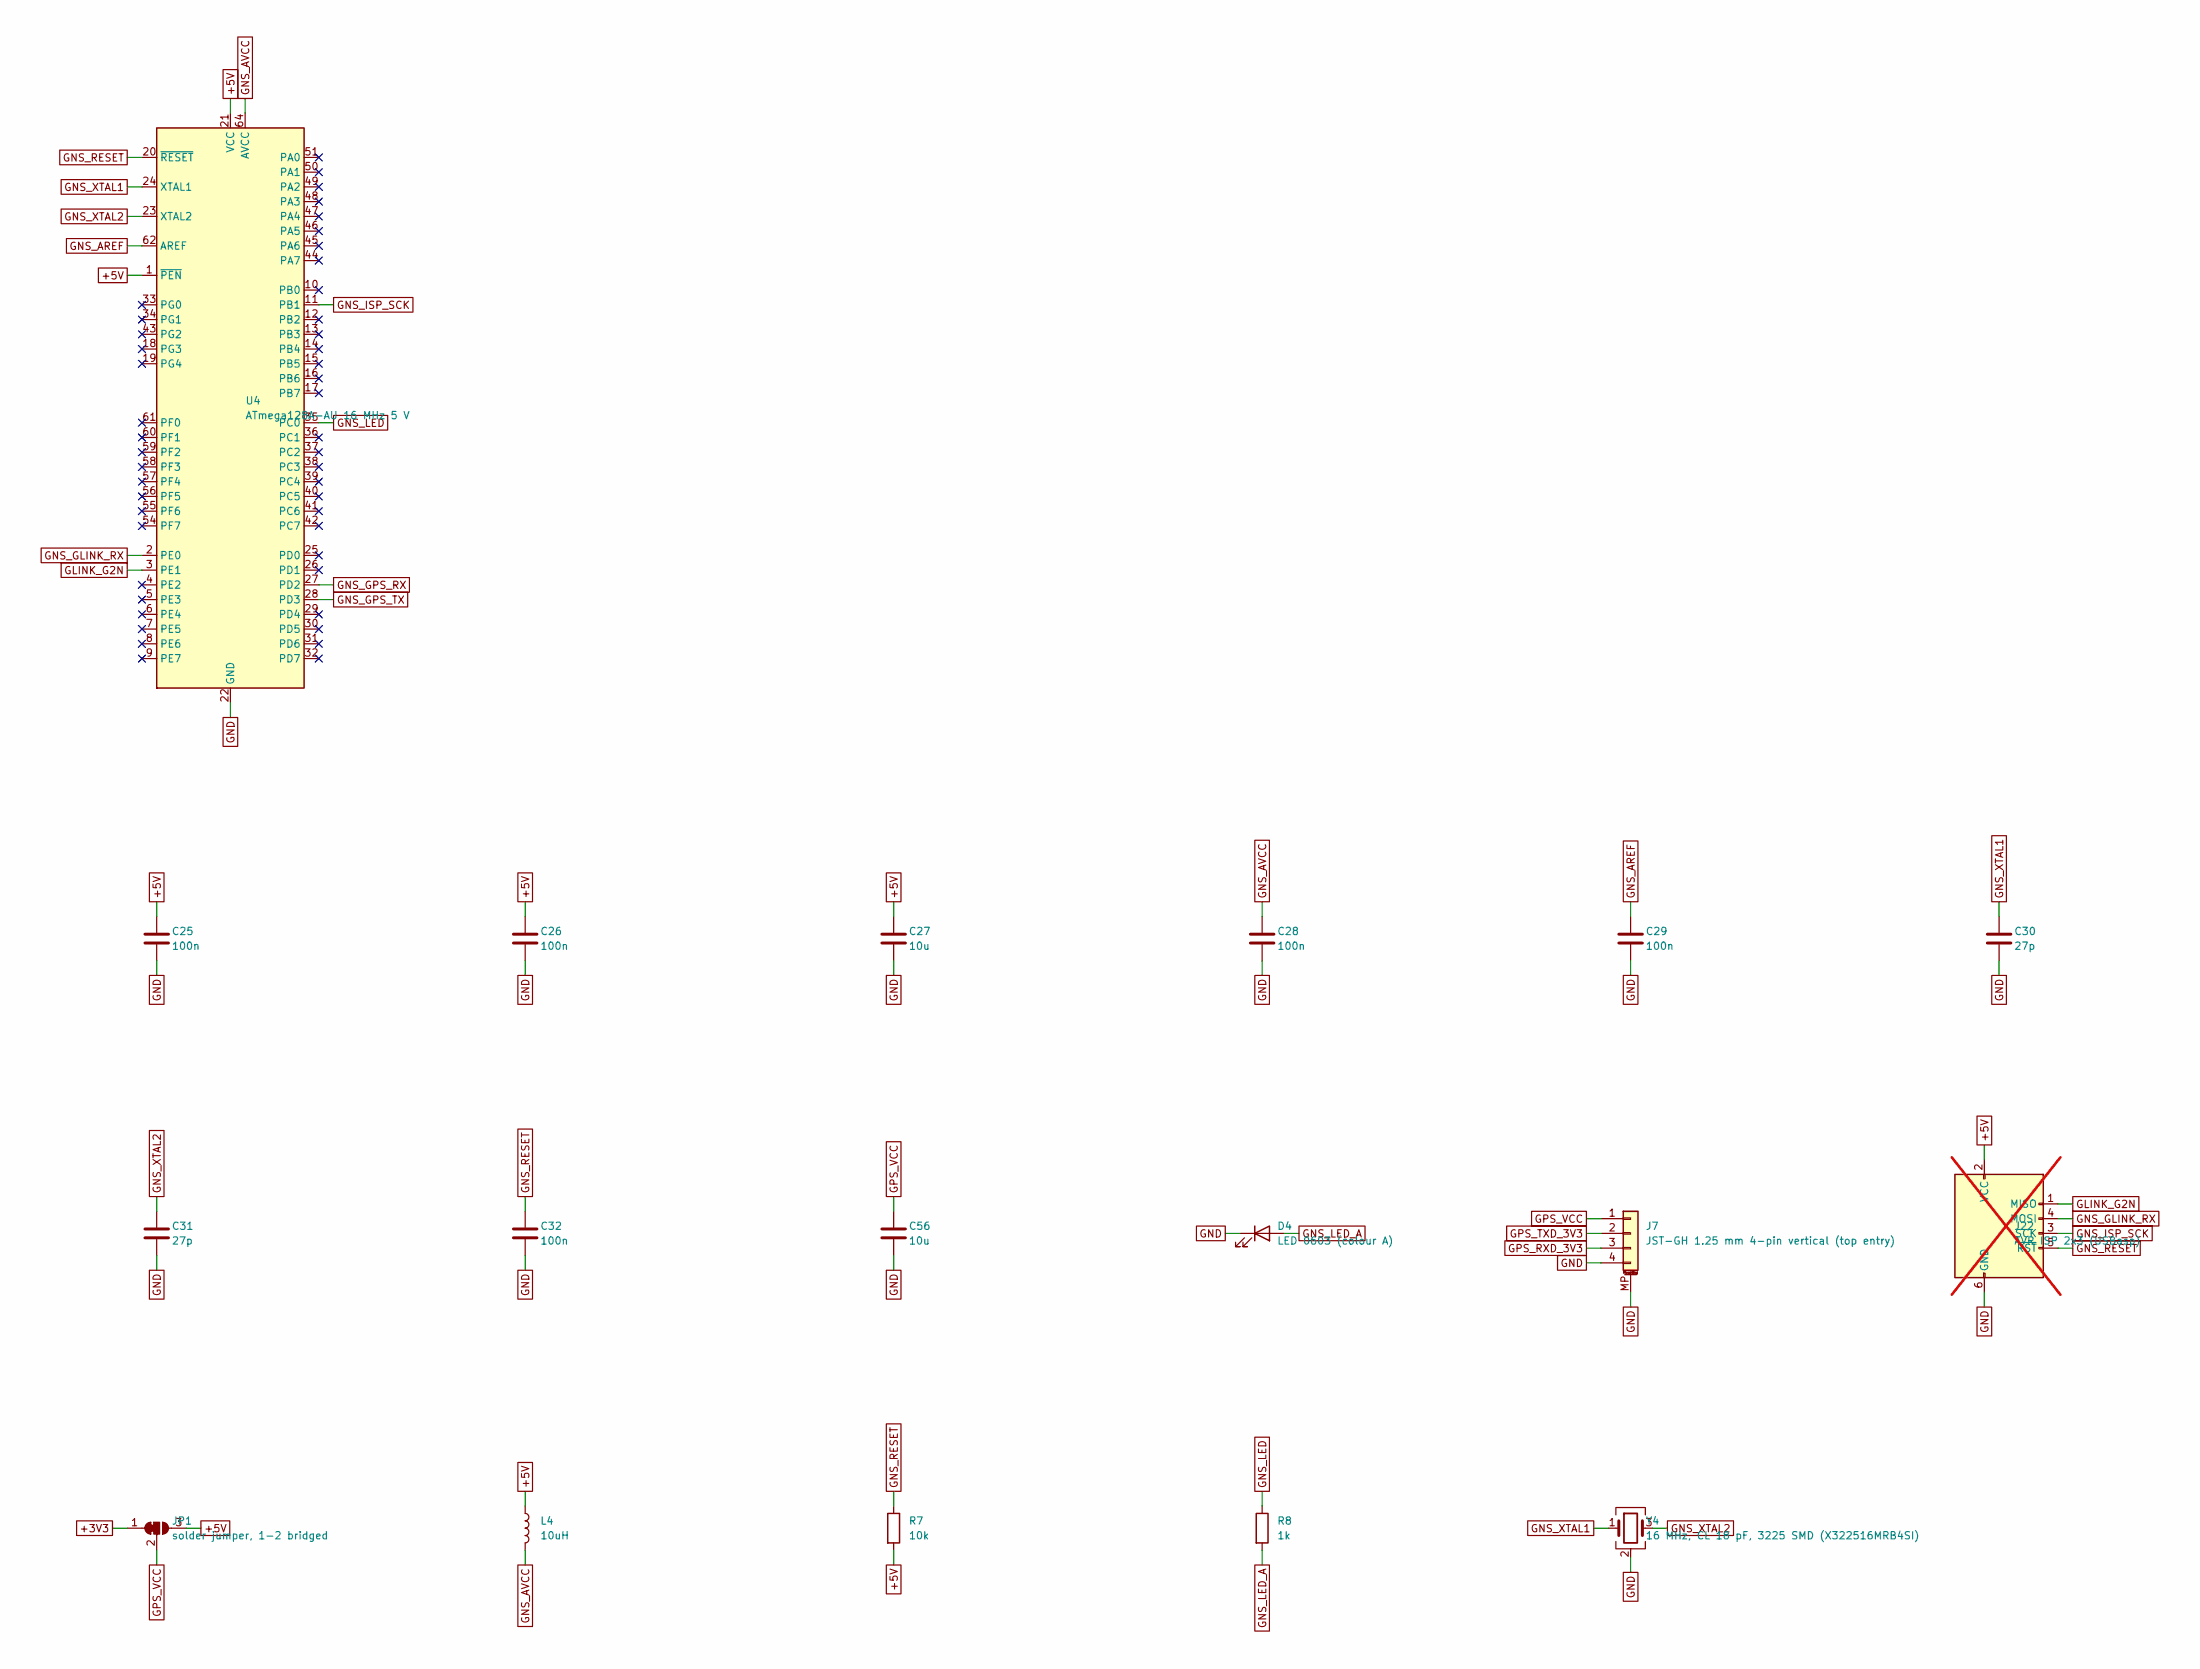
[picture p80: schematic gns.kicad_sch, VTOL carrier - GNS ATmega128A + NEO-7M GPS lead]

Parts:
C25, C26, C28: 100n; C_0402_1005Metric
C27, C56: 10u; C_0805_2012Metric
C29, C32: 100n; C_0603_1608Metric
C30, C31: 27p; C_0402_1005Metric
D4: LED 0603 (colour A); LED_0603_1608Metric
J7: JST-GH 1.25 mm 4-pin vertical (top entry); JST_GH_BM04B-GHS-TBT_1x04-1MP_P1.25mm_Vertical
J22: AVR ISP 2x3 (USBasp); PinHeader_2x03_P2.54mm_Vertical; not fitted
JP1: solder jumper, 1-2 bridged; SolderJumper-3_P1.3mm_Bridged12_RoundedPad1.0x1.5mm
L4: 10uH; L_0805_2012Metric
R7: 10k; R_0603_1608Metric
R8: 1k; R_0603_1608Metric
U4: ATmega128A-AU 16 MHz 5 V; TQFP-64_14x14mm_P0.8mm
Y4: 16 MHz, CL 18 pF, 3225 SMD (X322516MRB4SI); Crystal_SMD_3225-4Pin_3.2x2.5mm

Connections:
+3V3: JP1.1 (A); also elsewhere on the board
+5V: C25.1, C26.1, C27.1, J22.2 (VCC), JP1.3 (B), L4.1, R7.2, U4.1 (~PEN), U4.21 (VCC), U4.52 (VCC); also elsewhere on the board
GLINK_G2N: J22.1 (MISO), U4.3 (PE1); also elsewhere on the board
GND: C25.2, C26.2, C27.2, C28.2, C29.2, C30.2, C31.2, C32.2, C56.2, D4.1 (K), J7.4, J7.MP (MountPin), J22.6 (GND), U4.22 (GND), U4.53 (GND), U4.63 (GND), Y4.2 (G), Y4.4 (G); also elsewhere on the board
GNS_AREF: C29.1, U4.62 (AREF)
GNS_AVCC: C28.1, L4.2, U4.64 (AVCC)
GNS_GLINK_RX: J22.4 (MOSI), U4.2 (PE0); also elsewhere on the board
GNS_GPS_RX: U4.27 (PD2); also elsewhere on the board
GNS_GPS_TX: U4.28 (PD3); also elsewhere on the board
GNS_ISP_SCK: J22.3 (SCK), U4.11 (PB1)
GNS_LED: R8.1, U4.35 (PC0)
GNS_LED_A: D4.2 (A), R8.2
GNS_RESET: C32.1, J22.5 (~RST), R7.1, U4.20 (~RESET)
GNS_XTAL1: C30.1, U4.24 (XTAL1), Y4.1
GNS_XTAL2: C31.1, U4.23 (XTAL2), Y4.3
GPS_RXD_3V3: J7.3; also elsewhere on the board
GPS_TXD_3V3: J7.2; also elsewhere on the board
GPS_VCC: C56.1, J7.1, JP1.2 (C)

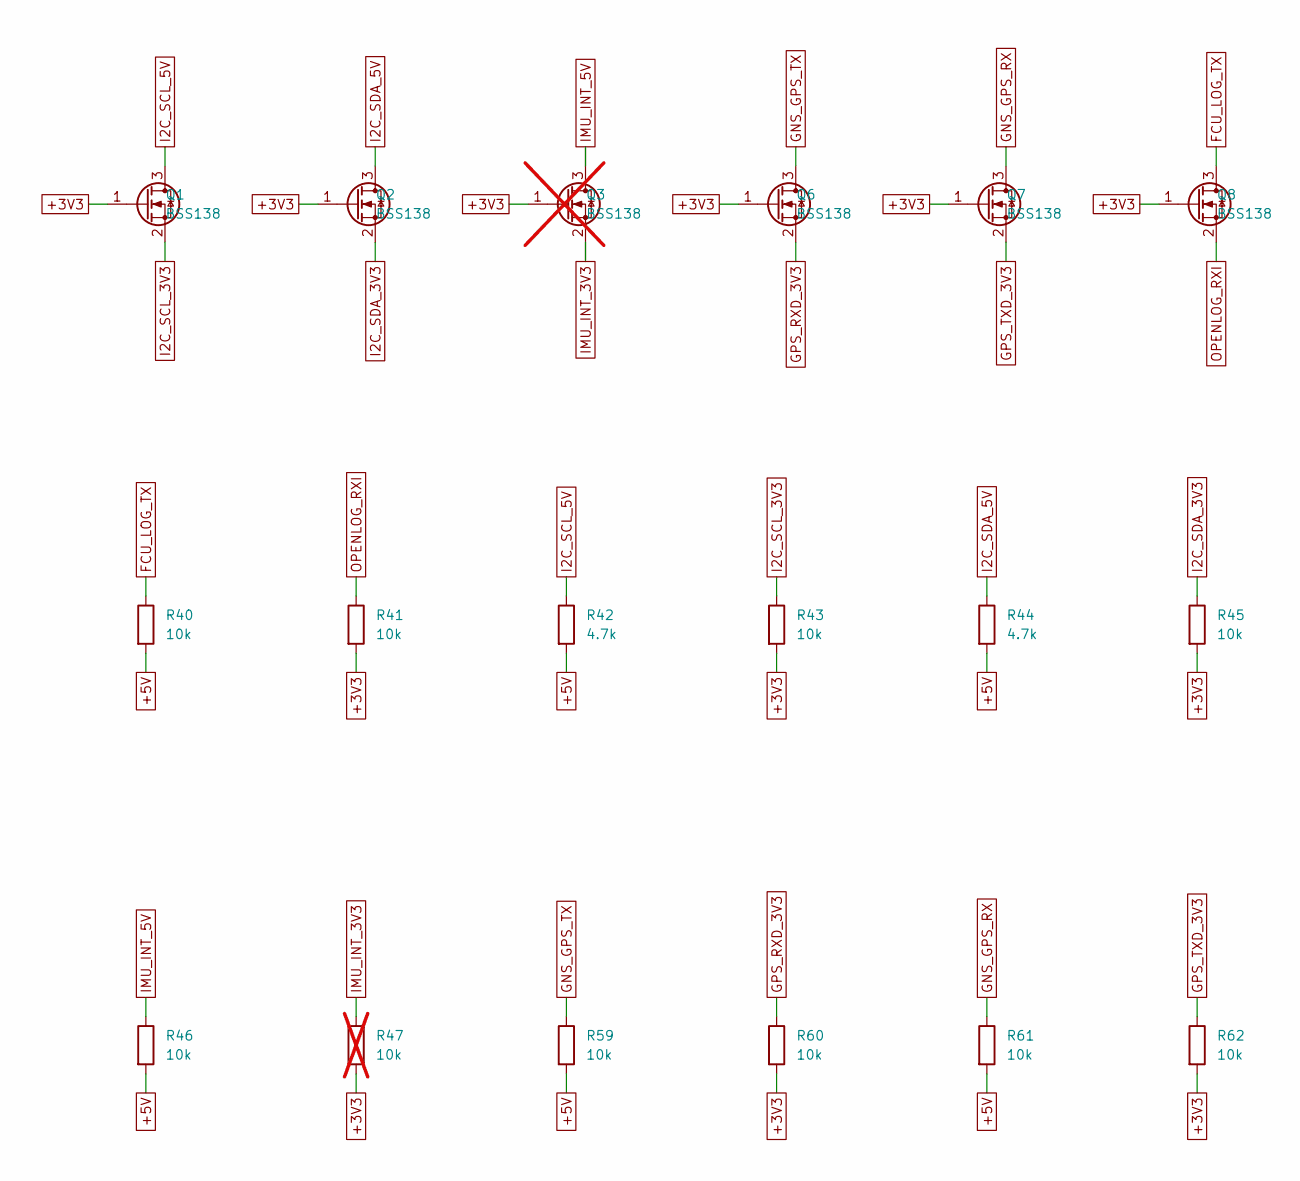
[picture p81: schematic level_shift.kicad_sch, VTOL carrier - BSS138 level shifters 5 V <-> 3.3 V]

Parts:
Q1, Q2, Q6, Q7, Q8: BSS138; SOT-23
Q3: BSS138; SOT-23; not fitted
R40, R41, R43, R45, R46, R59, R60, R61, R62: 10k; R_0603_1608Metric
R42, R44: 4.7k; R_0603_1608Metric
R47: 10k; R_0603_1608Metric; not fitted

Connections:
+3V3: Q1.1 (G), Q2.1 (G), Q3.1 (G), Q6.1 (G), Q7.1 (G), Q8.1 (G), R41.2, R43.2, R45.2, R47.2, R60.2, R62.2; also elsewhere on the board
+5V: R40.2, R42.2, R44.2, R46.2, R59.2, R61.2; also elsewhere on the board
FCU_LOG_TX: Q8.3 (D), R40.1; also elsewhere on the board
GNS_GPS_RX: Q7.3 (D), R61.1; also elsewhere on the board
GNS_GPS_TX: Q6.3 (D), R59.1; also elsewhere on the board
GPS_RXD_3V3: Q6.2 (S), R60.1; also elsewhere on the board
GPS_TXD_3V3: Q7.2 (S), R62.1; also elsewhere on the board
I2C_SCL_3V3: Q1.2 (S), R43.1; also elsewhere on the board
I2C_SCL_5V: Q1.3 (D), R42.1; also elsewhere on the board
I2C_SDA_3V3: Q2.2 (S), R45.1; also elsewhere on the board
I2C_SDA_5V: Q2.3 (D), R44.1; also elsewhere on the board
IMU_INT_3V3: Q3.2 (S), R47.1; also elsewhere on the board
IMU_INT_5V: Q3.3 (D), R46.1; also elsewhere on the board
OPENLOG_RXI: Q8.2 (S), R41.1; also elsewhere on the board

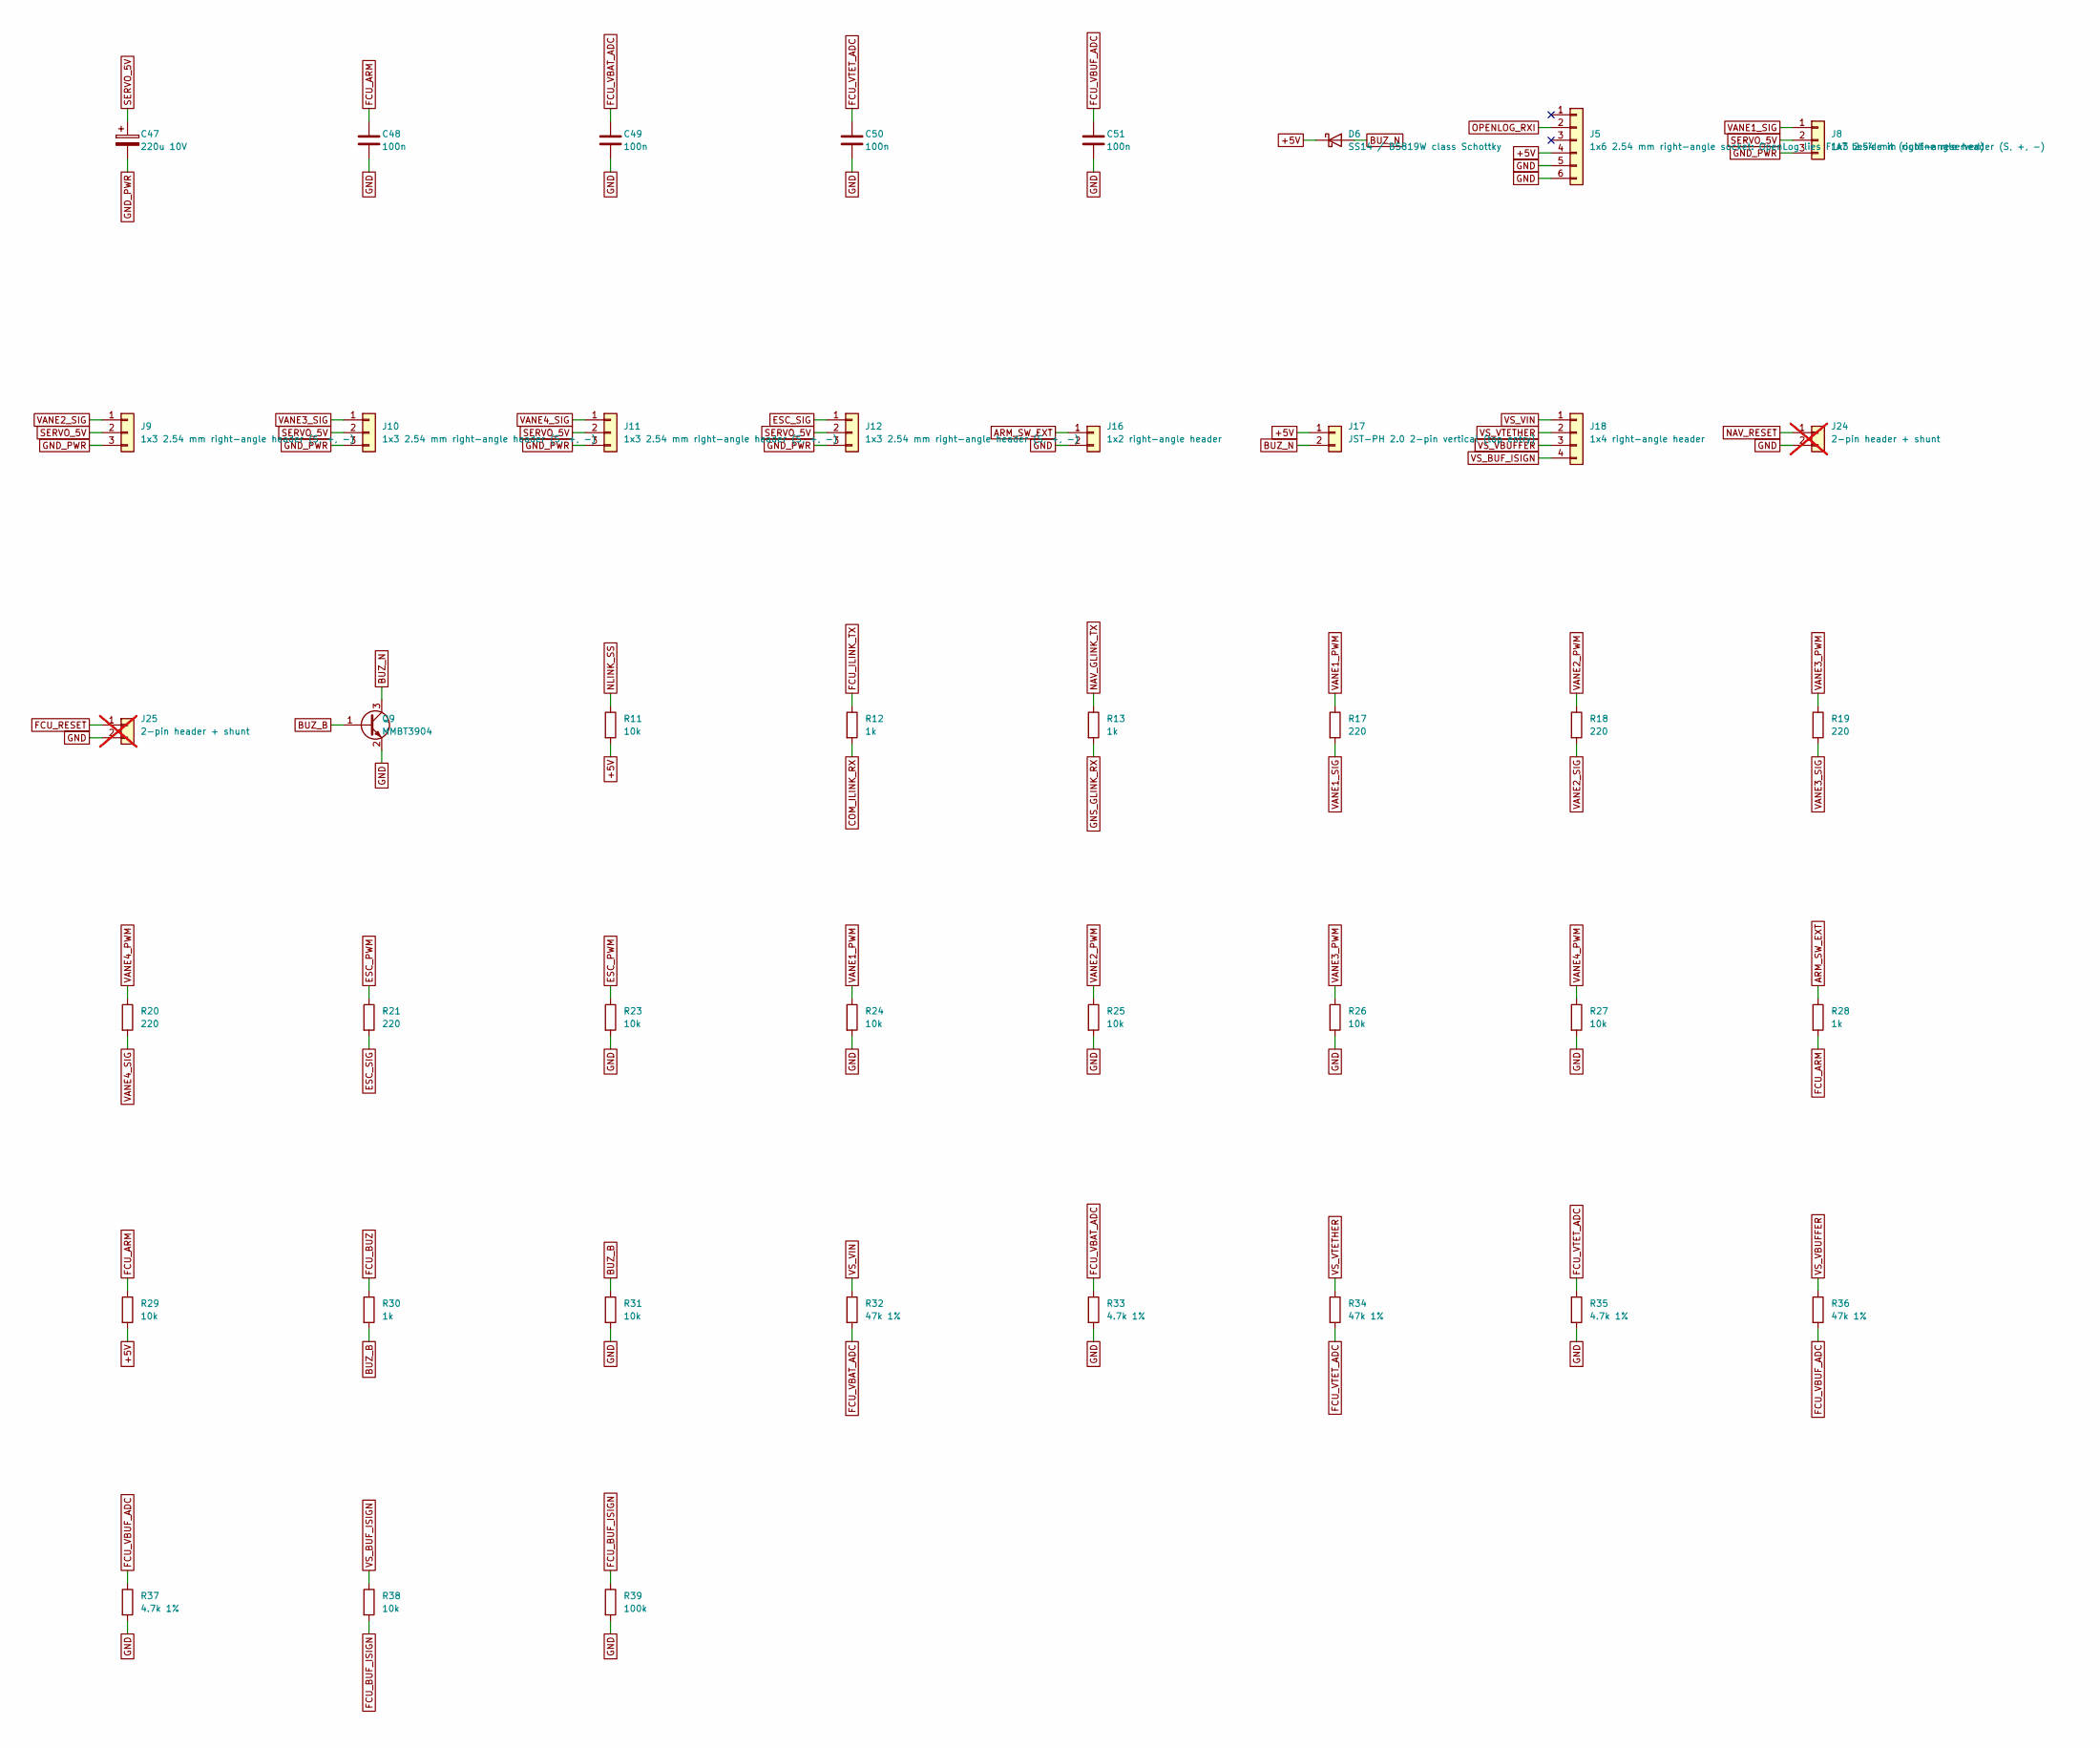
[picture p82: schematic io.kicad_sch, VTOL carrier - Servo / ESC / arm / buzzer / power-sense hea…]

Parts:
C47: 220u 10V; CP_Elec_6.3x5.4
C48, C49, C50, C51: 100n; C_0603_1608Metric
D6: SS14 / B5819W class Schottky; D_SOD-123
J5: 1x6 2.54 mm right-angle socket: OpenLog lies FLAT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; PinSocket_1x06_P2.54mm_Horizontal
J8, J9, J10, J11, J12: 1x3 2.54 mm right-angle header (S, +, -); PinHeader_1x03_P2.54mm_Horizontal
J16: 1x2 right-angle header; PinHeader_1x02_P2.54mm_Horizontal
J17: JST-PH 2.0 2-pin vertical (top entry); JST_PH_B2B-PH-K_1x02_P2.00mm_Vertical
J18: 1x4 right-angle header; PinHeader_1x04_P2.54mm_Horizontal
J24, J25: 2-pin header + shunt; PinHeader_1x02_P2.54mm_Vertical; not fitted
Q9: MMBT3904; SOT-23
R11, R23, R24, R25, R26, R27, R29, R31, R38: 10k; R_0603_1608Metric
R12, R13, R28, R30: 1k; R_0603_1608Metric
R17, R18, R19, R20, R21: 220; R_0603_1608Metric
R32, R34, R36: 47k 1%; R_0603_1608Metric
R33, R35, R37: 4.7k 1%; R_0603_1608Metric
R39: 100k; R_0603_1608Metric

Connections:
+5V: D6.1 (K), J5.4, J17.1, R11.2, R29.2; also elsewhere on the board
ARM_SW_EXT: J16.1, R28.1
BUZ_B: Q9.1 (B), R30.2, R31.1
BUZ_N: D6.2 (A), J17.2, Q9.3 (C)
COM_ILINK_RX: R12.2; also elsewhere on the board
ESC_PWM: R21.1, R23.1; also elsewhere on the board
ESC_SIG: J12.1, R21.2
FCU_ARM: C48.1, R28.2, R29.1; also elsewhere on the board
FCU_BUF_ISIGN: R38.2, R39.1; also elsewhere on the board
FCU_BUZ: R30.1; also elsewhere on the board
FCU_ILINK_TX: R12.1; also elsewhere on the board
FCU_RESET: J25.1; also elsewhere on the board
FCU_VBAT_ADC: C49.1, R32.2, R33.1; also elsewhere on the board
FCU_VBUF_ADC: C51.1, R36.2, R37.1; also elsewhere on the board
FCU_VTET_ADC: C50.1, R34.2, R35.1; also elsewhere on the board
GND: C48.2, C49.2, C50.2, C51.2, J5.5, J5.6, J16.2, J24.2, J25.2, Q9.2 (E), R23.2, R24.2, R25.2, R26.2, R27.2, R31.2, R33.2, R35.2, R37.2, R39.2; also elsewhere on the board
GND_PWR: C47.2, J8.3, J9.3, J10.3, J11.3, J12.3; also elsewhere on the board
GNS_GLINK_RX: R13.2; also elsewhere on the board
NAV_GLINK_TX: R13.1; also elsewhere on the board
NAV_RESET: J24.1; also elsewhere on the board
NLINK_SS: R11.1; also elsewhere on the board
OPENLOG_RXI: J5.2; also elsewhere on the board
SERVO_5V: C47.1, J8.2, J9.2, J10.2, J11.2, J12.2
VANE1_PWM: R17.1, R24.1; also elsewhere on the board
VANE1_SIG: J8.1, R17.2
VANE2_PWM: R18.1, R25.1; also elsewhere on the board
VANE2_SIG: J9.1, R18.2
VANE3_PWM: R19.1, R26.1; also elsewhere on the board
VANE3_SIG: J10.1, R19.2
VANE4_PWM: R20.1, R27.1; also elsewhere on the board
VANE4_SIG: J11.1, R20.2
VS_BUF_ISIGN: J18.4, R38.1
VS_VBUFFER: J18.3, R36.1
VS_VIN: J18.1, R32.1
VS_VTETHER: J18.2, R34.1

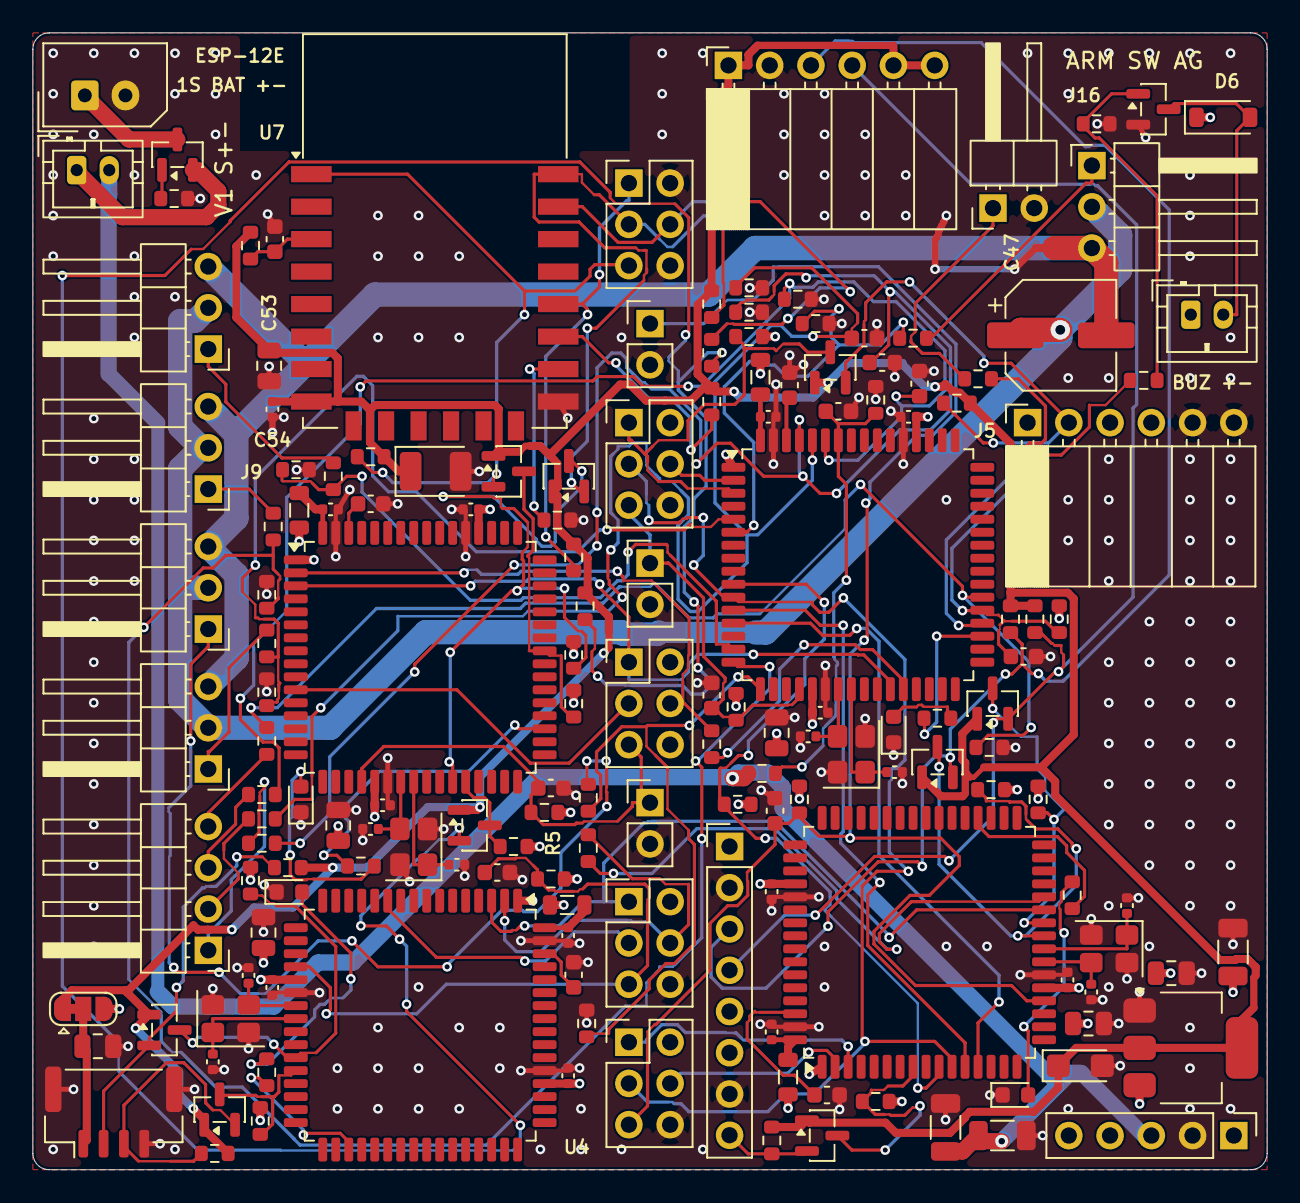
[picture p83: board vtol_carrier.kicad_pcb from above]

Board: 4 copper layers, 76.0 x 70.0 mm, 162 parts (0 on the bottom side), 100 nets.
