Yuchan-00/CanSat_EDF_Rocket/cad/cadquery/check_geometry.py

"""Geometry checks C1-C41 of SPEC section 7 against the CadQuery twin (C24: v0.6.2 radio/log box, C25: v0.6.3 FCU board,
C26: v0.8 GPS pod, C27: v0.8.1 GNS board; C28-C35 v0.9 VTOL / clock mount; C36: the 2026-11-04 livery - YUCHAN inlay,
check_livery; C37-C40: the 2026-11-05 logic power; C41: the 2026-11-05 switch collar).

Invariant: every PASS is backed by a measurement on the solids (boolean intersection volume,
bounding box, OCC mass properties) or on Layout/params numbers - never by inspection of the
code.  "No intersection" means boolean common volume < INTERSECT_TOL (1 mm^3).  Rows X1..X3
are extra informational checks (WARN at most, never FAIL).  C18-C21 check the v0.5 EDF tab
mount and are reported ``N/A`` (never FAIL) when ``edf.mount`` is not ``tabs``.  v0.5d: C7 also needs
positive evidence of the tray stops, C16 of the blind propulsion joint holes, C19 that the head tunnel crosses the
skin, C15's latched overlap is positive evidence (uncomputable -> 0), and C20's step-out window and floor closure
follow the 45 deg floor wedge.  v0.6: C22 checks the COM board (second ATmega128A) under the payload bulkhead on the
solids - BRep clearances to the tray / placeholders / rails / spigot bore (uncomputable -> 0 -> FAIL), the board
seated on the boss tips, solid bosses around clear blind holes with a floor, open bulkhead holes - and is N/A (never
FAIL) for params without electronics.com / payload_module.com_mount.  C14 includes the ``com`` placeholder.
v0.6 servo leads: C23 checks the vane-servo lead route (SPEC 3.8 / 5.1) with ribbon proxies and solid evidence (servo
bulge closed, deck seat and sleeve intact) and is N/A without ``Layout.servo_leads``; C20's skin-opening test allows
the servo channel behind the servo bulge, C21's keyway probes stop at the rebate floor, C10 lists the route's walls.
v0.6.1 intake band (SPEC 5.1, window_wall_t thick, radial-sector windows): C9 judges the MINIMUM opening of the built
band (probe shells across it) and the Layout minimum at r_band_in, and adds solid evidence - every window clear through,
every strut's mid-height section >= 0.95 x the design sector and window_wall_t deep, the band window_wall_t thick and
solid in the margin rings; C10 lists window_wall_t, the strut inner face and the shelf ledge past the band; C20's upper
gate is taken to the band's inner face, and C20 / C23 measure the BRep gap from the leg that runs up beside the strut
to the band (> 0 / >= servo_leads.min_clearance).
v0.6.2 (window gable, radio/log box): C9 probes the windows clear ABOVE the lower boundary only, the gussets solid under
it, the bridge flat at z_window_bottom, and every lower-boundary edge on the outer and inner band surface (BRep edges)
flat within the bridge or >= GABLE_MIN_EDGE_SLOPE_DEG from horizontal, spanning the full gable height on both sides of
every window (printability evidence); C10 notes the gussets (no new minimum feature); C14 includes ``radio_log``; the new
row C24 checks the radio/log box under the payload bulkhead on the solids (N/A without electronics.radio_log).
v0.6.3 (three ATmega128A): the tray placeholder ``fc`` is ``nav`` now (C7 / C14 / C22 / C24 test it under that name); C14
includes the new ``fcu`` placeholder and the new row C25 checks the FCU board on the intake bulkhead on the solids
(N/A without electronics.fcu) - a separate row, gated on its own params key like C24.
v0.8 (GPS pod, payload_module.gps_pod): the new row C26 checks the pod, its lid, the antenna stack, the raceway / connector
pocket and the avionics entry hole on the solids (N/A without the pod); C14 includes the ``gps`` / ``gps_ground_plane``
placeholders (zone: footprint radius over the payload module, clear of the payload module and the lid); C10 lists the pod's
walls (designed) and its hole / post walls (derived, Layout.gps_walls); C1 / C2 include the new printed part ``gps_pod_lid``.
v0.8.1 (GNS board, electronics.gns / avionics_module.gns_mount): the new row C27 checks the GNS board on its four bosses on
the -x avionics tube wall on the solids (clearances, seat on the boss tips, blind tap holes, 45 deg boss faces, the GPS /
glink lead tubes; N/A without electronics.gns); C7 / C14 include the ``gns`` placeholder (avionics zone); C10 lists the
GNS boss walls (derived, Layout.gns_walls).
2026-11-05 logic power (user decisions 1-4, params configs.vtol.logic_power; VTOL battery build only, N/A elsewhere): C37 the
1S logic pack at spot A on the solids (6S pack, bore, bay boxes, >= 2 mm to the servo bundle / GPS lead / carrier plugs /
switch lead - PCB review MF2-10 - and the strap retention), C38 the MTS-102 switch through the top cap (hole open, switch vs
the cap, body / lugs >= min_feature from the ribs / ring / plate and >= min_clear_to_tray from everything below the plate,
the plate strength rule of sizing/vtol_strength.py untouched, the lead keep-outs to J15 / J14 clear, cap removal slack),
C39 the lever reachable from outside with the vehicle closed (finger circle free, inside the body edge, below the eye bolt
when fitted; WARN while the lever is the vehicle top; tip-over / catch-line / GPS-sky numbers reported), C40 the named mass
switch (logic_power.in_flight_mass_model) honoured by the report and the pending full-mass numbers (with C33's trim at the
full mass).  Review fixes (2026-11-05): C38 also checks the cap joint screws at their length limit and the switch nut
bearing; C30 names the logic switch lever as its only non-tether exception (measured on the solid, judged in C39); C37
reports the strap / tie loops against the leads (E).
Switch-collar round (user decision 2026-11-05, '상단 캡과 한 몸으로 출력하는 보호 칼라를 달아줘', logic_power.collar): C39
judges the lever's swept envelope against the collar printed with the top cap (rim margin, inside the rim hull, clear of
it - PASS or FAIL, no WARN), C30 measures the vehicle top on the solids and names the collar (and the lever inside it) as
its exceptions, the new row C41 checks the collar's own rules (FDM wall, bore / notches, finger reach both ways, GPS sky
shading, rim side load by hand, keep-outs).

Writes cad/exports/cadquery_checks.md + .json (``_<preset>`` variants for non-default presets)
and exits 1 when any C-row FAILs.
"""
from __future__ import annotations

import argparse
import math
import os
import sys
import time
from dataclasses import dataclass, field

import cadquery as cq

_HERE = os.path.dirname(os.path.abspath(__file__))
if _HERE not in sys.path:
    sys.path.insert(0, _HERE)

import build_rocket as br  # noqa: E402
import check_clock as ckc  # noqa: E402  (wire09c clock mount: C18 / C21 / C29 clock versions, C34, C35)
import check_livery as ckl  # noqa: E402  (livery 2026-11-04: C36)
import rocket_geometry as rg  # noqa: E402
from layout import GABLE_MIN_EDGE_SLOPE_DEG, PLACEHOLDER_BORE_CLEAR_MM, Layout, load_params  # noqa: E402

INTERSECT_TOL_MM3 = 1.0
PASS, WARN, FAIL, NA = "PASS", "WARN", "FAIL", "N/A"
G0 = 9.80665

# SPEC 7 literals of the v0.5 tab-mount checks
C18_FLOOR_GAP_MAX = 0.05        # C18: keyway floor touches the tab (gap < 0.05 mm)
C19_CLEAR_PROBE_D = 3.0         # C19: clearance-hole probe O3.0 over t in [t_keyway, t_head]
C19_TUNNEL_PROBE_D = 6.0        # C19: head tunnel probe O6.0 over t in [t_head + 0.2, t_cbore_end + 2]
C19_TUNNEL_PAST_END = 2.0       # C19: the tunnel probe runs to t_cbore_end + 2
C19_TAP_FREE_PROBE_D = 2.0      # C19: tap hole is open: O2.0 probe over [t_tap_end + 0.2, -t_keyway] x module = 0
C19_TAP_MAT_PROBE_D = 3.2       # C19: material to self-tap: O3.2 probe there x module >= 0.95 x pi/4 (3.2^2 - 2.5^2) x len
C19_TAP_MAT_FRACTION = 0.95     # C19: (the 2.5 of that formula is the tap hole, tab_screw_d_tap)
C19_PROBE_INSET = 0.2           # C19: probes start 0.2 mm past the counterbore floor / tap-hole bottom
SHANK_PROBE_D = 3.0             # C19: O3.0 probe for |t| <= tab_t/2 x edf_unit = 0 (the screw passes the tab slot)
C19_SLOT_CONTROL_EXTRA_D = 1.0  # C19: positive control, a O(tab_slot_w + 1.0) probe there x edf_unit > 0
C21_MIN_SKIN_WALL = 0.8         # C21: material between each keyway (centre and corners) and the outer surface >= 0.8 mm
C18_FLOOR_AREA_FRACTION = 0.95  # C18: floor area under the tab >= 0.95 x tab_t x (tab_r_out - edf_bore_r)
C19_TUNNEL_TOL_MM3 = 0.01       # C19: the head tunnel must be clear (a clearance, not the generic 1 mm^3 tolerance)
C20_CLOSED_TOL_MM3 = 0.5        # C20: bulge walls / floor / roof and the intake skin have no unintended opening
C21_SLOT_VOID_TOL_MM3 = 1.0     # C21: the skin sector beside the wire slot is intact
# modelling helpers of the checks
FLOOR_PROBE_H = 2.0             # C18: height of the box under the tab that finds the keyway floor
FLOOR_AREA_SLAB = 0.1           # C18: thin slab under the tab whose material / height is the floor bearing area
FEATURE_EPS = 1e-6              # C10: float round-off allowance (134.05 - 132.85 = 1.1999999999999886 is 1.2)
C21_Z_STATIONS = 48             # C21: radial probes at the midpoints of this many equal Z intervals
C21_LOCAL_PAD = 3.0             # C21: the module is first clipped to a box this much larger than the probed region
TRAY_STOP_FILL_MIN = 0.95       # C7 (v0.5d tray stop evidence, SPEC 5.2): the FLOOR_AREA_SLAB-thin slab under the
                                # tray footprint in each rail slot is >= 95 % avionics_module material (as C18's floor)
TRAY_STOP_TOP_TOL = 0.05        # C7: the stop's top face is the tray's bottom face (|gap| < 0.05 mm, as C18_FLOOR_GAP_MAX)
JOINT_FLOOR_FILL_MIN = 0.95     # C16 (v0.5d blind propulsion joint holes, SPEC 3.2): the probe between the EDF bore
                                # and the hole bottom is >= 95 % module material (the hole is blind)
# v0.6 C22 (COM board, SPEC 5.3 / 6)
COM_FILL_MIN = 0.95             # C22: boss ring and the floor above each blind hole are >= 95 % payload_module material
COM_HOLE_CLEAR_TOL_MM3 = 0.01   # C22: a probe Ø(hole_d - 2 x COM_PROBE_INSET) in the blind hole meets no material (a
                                # clearance, as C19's tunnel; the 1 mm^3 tolerance would hide a 2.0 hole cut for 2.5)
COM_PROBE_INSET = 0.05          # C22: probes keep 0.05 mm off the faces they pin (hole wall, hole end, boss tip, ...)
COM_SEAT_TOL = 0.05             # C22: the lowest payload_module material over the board is the boss tip (|gap| < 0.05)
# v0.6.1 C9 (intake band, SPEC 5.1)
C9_STRUT_SECTION_MIN = 0.95     # C9: each strut's mid-height section >= 0.95 x the design sector (strut_w at body_r,
                                # radial sides, window_wall_t)
C9_WINDOW_CLEAR_TOL_MM3 = 0.01  # C9: a window probe (inset C9_PROBE_INSET) meets no material - a clearance, as C19's
                                # tunnel (the 1 mm^3 tolerance would hide a 0.1 mm skin left across a window)
C9_PROBE_INSET = 0.05           # C9: window probes stay 0.05 mm inside the window faces, ring probes inside the band
C9_WINDOW_PROBE_PAST = 0.5      # C9: window / strut probes run 0.5 mm past the band faces radially
C9_RADIAL_TOL = 0.01            # C9: radial probes find the band at r_band_in .. body_r within 0.01 mm
# v0.6.2 C9 (window gable, SPEC 5.1 / intake_module.window_bottom_end)
C9_GUSSET_VOID_TOL_MM3 = 0.01   # C9: the inset gusset region (below the boundary) is solid - void < 0.01 mm^3 (as the
                                # window clearance: a square-ended window leaves ~2000 mm^3 per window void there)
C9_EDGE_TOL = 1e-3              # C9: an edge lies on a band surface / at a Z station within 1e-3 mm
C9_EDGE_SAMPLES = 21            # C9: tangent / position samples per lower-boundary edge
# v0.6 C23 (servo leads, SPEC 3.8 / 5.1)
C23_CLOSED_TOL_MM3 = 0.5        # C23: servo bulge walls / floor / roof, the deck seat and the sleeve are solid (as C20)
C23_PROBE_INSET = 0.05          # C23: solid-evidence probes stay 0.05 mm inside the faces they test
# v0.6.3 C25 (FCU board on the intake bulkhead)
FCU_SEAT_FILL_MIN = 0.5         # C25: more than half of the board footprint is bulkhead material for the foam tape (a
                                # board over a hole has nothing to stick to)
FCU_SEAT_FILL_TOL = 1e-3        # C25: that measured fill equals Layout.fcu_seat_fraction within 1e-3 (when it is exact)
FCU_TIE_PROBE_D = 1.0           # C25: a O1 rod from one vent-hole centre to another at the board's mid height meets the
                                # board when the cable tie between them runs across it
# v0.8 C26 (GPS pod)
GPS_PROBE_INSET = 0.05          # C26: probes keep 0.05 mm off the faces they pin (hole walls, raceway faces, patch top)
GPS_CLEAR_TOL_MM3 = 0.01        # C26: a clearance probe (hole, raceway, sky column, bore) meets no material - as C22's
                                # hole probe (the 1 mm^3 tolerance would hide a 0.1 mm skin across the raceway)
# v0.9 C5 (direct drive: servo in the fin-root fairing) and C28 (coupler alignment)
C5_WALL_PROBE = 1.0             # C5: probes 1 mm deep beside / under the lower ear tab's slot find its walls and floor
C5_PROBE_INSET = 0.05           # C5: probes keep 0.05 mm off the faces they pin
C5_FILL_MIN = 0.95              # C5: slot walls / floor and the ring around each tap hole are >= 95 % material
C5_SWEEP_PAST = 5.0             # C5: the slide-out sweep runs the servo's width + 5 mm past the fairing face
C5_CLEAR_TOL_MM3 = 0.01         # C5: tap / clearance-hole probes meet no material (a clearance, as C19's tunnel)
C5_TAP_RING = 1.0               # C5: material ring 1 mm thick around each cover-screw tap hole
C28_AXIS_TOL = 0.01             # C28: the horn (servo output) centre lies on the hinge axis within 0.01 mm
C28_TORQUE_MARGIN_MIN = 2.0     # C28: servo torque >= 2 x the worst hinge moment
# v0.9 C20 / C29 (open motor-lead groove, bullets)
C29_CLEAR_TOL_MM3 = 0.01        # C29: a bullet / lead proxy (already grown by its clearance) meets no material
FINGER_REACH_MM = 0.05          # C41 (switch collar): the fingertip probe touches the lever end (BRep distance)
FINGER_PATH_TOL_MM = 1e-6       # C41 (review fix 2026-11-05, F1): numerical tolerance on the finger-path BRep distance
C33_TRIM_PASS = 0.05            # C33 (v0.9 fix round): standing trim from the lateral CG <= 5 % of the hover pitch authority
C33_TRIM_WARN = 0.10            # ... WARN up to 10 %
# v0.8.1 C27 (GNS board)
GNS_SEAT_SLAB = 0.1             # C27: slab behind the board's back face whose avionics material / thickness is the
                                # bearing area of the four boss tips (as C18's FLOOR_AREA_SLAB)
GNS_SEAT_AREA_TOL = 0.01        # C27: that area equals 4 x (diamond - hole) within 1 %
GNS_FACE_PROBE_W = 0.1          # C27: thin columns that find a boss's lowest material (bottom vertex / mid-face)
GNS_FACE_TOL = 0.1              # C27: ... at the 45-deg design height within 0.1 mm (the column is 0.1 wide)


@dataclass
class Check:
    id: str
    title: str
    status: str
    measured: str
    detail: str = ""
    values: dict = field(default_factory=dict)


def _v(a: cq.Shape, b: cq.Shape) -> float:
    """Intersection volume for "no intersection" tests: an uncomputable intersection counts as +inf (FAIL)."""
    v = rg.intersection_volume(a, b)
    return math.inf if math.isnan(v) else v


def _vpos(a: cq.Shape, b: cq.Shape) -> float:
    """Intersection volume used as positive evidence ("material is there"): uncomputable counts as 0 (FAIL)."""
    v = rg.intersection_volume(a, b)
    return 0.0 if math.isnan(v) else v


def _void(region: cq.Shape, solid: cq.Shape) -> float:
    """Volume of region not covered by solid (region minus solid); uncomputable counts as +inf (FAIL)."""
    try:
        rest = region.cut(solid)
        return 0.0 if rest is None or rest.wrapped.IsNull() else float(rest.Volume())
    except Exception:  # noqa: BLE001
        return math.inf


def _status_no_intersection(vmax: float) -> str:
    return PASS if vmax < INTERSECT_TOL_MM3 else FAIL


def _box(x0, x1, y0, y1, z0, z1) -> cq.Shape:
    return rg._box(x0, x1, y0, y1, z0, z1)


def _top_z(shape: cq.Shape, region: cq.Shape) -> float:
    """Highest Z of shape's material inside region; -inf when there is none (or OCC cannot compute it)."""
    try:
        common = shape.intersect(region)
        if common is None or common.wrapped.IsNull() or common.Volume() <= 1e-9:
            return -math.inf
        return common.BoundingBox().zmax
    except Exception:  # noqa: BLE001
        return -math.inf


def _bottom_z(shape: cq.Shape, region: cq.Shape) -> float:
    """Lowest Z of shape's material inside region; +inf when there is none (or OCC cannot compute it)."""
    try:
        common = shape.intersect(region)
        if common is None or common.wrapped.IsNull() or common.Volume() <= 1e-9:
            return math.inf
        return common.BoundingBox().zmin
    except Exception:  # noqa: BLE001
        return math.inf


def _clearance(a: cq.Shape, b: cq.Shape) -> float:
    """Minimum BRep distance (mm) between two solids, used as a clearance (>= limit): 0 when they touch or overlap,
    and 0 when OCC cannot compute it (no evidence is never PASS)."""
    try:
        d = float(a.distance(b))
    except Exception:  # noqa: BLE001
        return 0.0
    return d if math.isfinite(d) else 0.0


def _off_axis_ring(x: float, y: float, r_in: float, r_out: float, z0: float, z1: float) -> cq.Shape:
    """Vertical annulus r_in..r_out about the vertical line through (x, y), Z [z0, z1] (C22 boss probe)."""
    return rg._cyl_z(r_out, z0, z1, x, y).cut(rg._cyl_z(r_in, z0 - 1.0, z1 + 1.0, x, y))


def _pt_seg_dist(p: tuple[float, float], a: tuple[float, float], b: tuple[float, float]) -> float:
    """Distance from point p to the segment a-b in a plane."""
    (px, py), (ax, ay), (bx, by) = p, a, b
    dx, dy = bx - ax, by - ay
    t = max(0.0, min(1.0, ((px - ax) * dx + (py - ay) * dy) / (dx * dx + dy * dy)))
    return math.hypot(px - (ax + t * dx), py - (ay + t * dy))


class Checker:
    def __init__(self, L: Layout, parts: dict[str, rg.Part], report: dict):
        self.L = L
        self.parts = parts
        self.report = report
        self.shape = {n: p.shape for n, p in parts.items() if p.shape is not None}
        self.prop = self.shape["propulsion_module"]
        self._band_part: cq.Shape | None = None
        # 2026-11-05: the logic-power solids (in parts once logic_power.in_flight_mass_model is true, else built here)
        self.logic = ({n: parts.get(n) or q for n, q in rg.logic_power_parts(L).items()}
                      if getattr(L, "has_logic_power", False) else {})

    def _intake_band_part(self) -> cq.Shape:
        """v0.6.1: the intake module's windowed band above the lead notches / channels (rocket_geometry.
        intake_opening_z_range), r from 1 mm inside r_band_in to 1 mm outside body_r - what the C20 / C23 legs that run
        up beside the struts must keep clear of (BRep distance)."""
        if self._band_part is None:
            z0, z1 = rg.intake_opening_z_range(self.L)
            self._band_part = self.shape["intake_module"].intersect(
                rg._tube(self.L.body_r + 1.0, self.L.r_band_in - 1.0, z0, z1))
        return self._band_part

    # ------------------------------------------------------------------ #
    def c1_bed_fit(self) -> Check:
        pr = self.L.p["printer"]
        bed_xy = pr["bed_x"] - 2 * pr["usable_margin"]
        bed_z = pr["bed_z"] - pr["usable_margin"]
        rows, worst, fails = [], 0.0, []
        seen = set()
        for p in self.parts.values():
            if p.kind != "printed" or p.base in seen:
                continue
            seen.add(p.base)
            rz = rg.plate_rot_z(self.L, p.base)          # v0.9: the propulsion module turns 45 deg on the plate
            bb = (p.shape.rotate(cq.Vector(0, 0, 0), cq.Vector(0, 0, 1), rz) if rz else p.shape).BoundingBox()
            ext = sorted([bb.xlen, bb.ylen, bb.zlen])
            if p.orientation == "flat":
                h, xy = ext[0], (ext[1], ext[2])
            else:  # upright / plate_down: vehicle Z is the print Z
                h, xy = bb.zlen, (bb.xlen, bb.ylen)
            ratio = max(xy[0] / bed_xy, xy[1] / bed_xy, h / bed_z)
            worst = max(worst, ratio)
            ok = xy[0] <= bed_xy and xy[1] <= bed_xy and h <= bed_z
            if not ok:
                fails.append(p.base)
            rows.append(f"{p.base}({p.orientation}) {xy[0]:.1f}x{xy[1]:.1f}x{h:.1f}")
        return Check("C1", "printed parts fit the bed in print orientation",
                     FAIL if fails else PASS, f"worst extent/limit = {worst:.3f} (limits {bed_xy:.0f}x{bed_xy:.0f}x{bed_z:.0f})",
                     "; ".join(rows) + (f"; FAILS: {fails}" if fails else ""), {"worst_ratio": worst, "fails": fails})

    def c2_envelope(self) -> Check:
        env = rg.payload_envelope(self.L)
        vols = {n: _v(env, p.shape) for n, p in self.parts.items() if p.kind == "printed" and p.in_vehicle}
        worst = max(vols, key=vols.get)
        return Check("C2", "payload envelope does not intersect any printed body", _status_no_intersection(vols[worst]),
                     f"max common volume {vols[worst]:.3f} mm^3 ({worst})",
                     f"envelope D{self.L.envelope_d:.0f} Z {self.L.z_envelope_bottom:.0f}..{self.L.z_envelope_top:.0f}", vols)

    def c3_edf(self) -> Check:
        L = self.L
        edf = self.shape["edf_unit"]
        v1, v2 = _v(edf, self.prop), _v(edf, self.shape["intake_module"])
        lip_ok = L.shelf_id < L.p["edf"]["lip_od"]
        st = _status_no_intersection(max(v1, v2))
        if not lip_ok:
            st = FAIL
        return Check("C3", "EDF clears propulsion/intake modules; shelf retains the lip", st,
                     f"edf x prop {v1:.3f}, edf x intake {v2:.3f} mm^3; shelf_id {L.shelf_id:.1f} < lip_od {L.p['edf']['lip_od']:.1f} -> {lip_ok}",
                     "", {"edf_prop": v1, "edf_intake": v2, "shelf_id": L.shelf_id, "lip_od": L.p["edf"]["lip_od"]})

    def c4_vanes(self) -> Check:
        L = self.L
        dmax = L.p["vane"]["max_deflection_mech_deg"]
        neutral = [self.shape[f"vane_{i + 1}"] for i in range(L.vane_count)]
        worst_prop, worst_vane, worst_shaft = (0.0, ""), (0.0, ""), (0.0, "")
        for i in range(L.vane_count):
            for d in (0.0, +dmax, -dmax):
                vs = neutral[i] if d == 0.0 else rg.vane(L, i, d)
                v = _v(vs, self.prop)
                if v > worst_prop[0]:
                    worst_prop = (v, f"vane_{i + 1} d={d:+.0f}")
                for j in range(L.vane_count):
                    if j == i:
                        continue
                    vv = _v(vs, neutral[j])
                    if vv > worst_vane[0]:
                        worst_vane = (vv, f"vane_{i + 1} d={d:+.0f} vs vane_{j + 1}")
            sh = _v(rg.vane_shaft(L, i), self.prop)
            if sh > worst_shaft[0]:
                worst_shaft = (sh, f"shaft_{i + 1}")
        vmax = max(worst_prop[0], worst_vane[0], worst_shaft[0])
        return Check("C4", f"vanes at d=0/+-{dmax:.0f}deg clear the module and each other; shafts pass the bore",
                     _status_no_intersection(vmax),
                     f"max vane x module {worst_prop[0]:.3f} ({worst_prop[1]}), vane x vane {worst_vane[0]:.3f} ({worst_vane[1]}), shaft x module {worst_shaft[0]:.3f} mm^3",
                     f"vane_r_out {L.vane_r_out:.1f} vs duct_r {L.duct_r:.1f}; TE offset {L.vane_hinge_z - L.vane_te_z:.1f} mm",
                     {"vane_module": worst_prop[0], "vane_vane": worst_vane[0], "shaft_module": worst_shaft[0]})

    def _c5_direct(self) -> Check:
        """v0.9 (vane_drive.mode 'direct'): each servo in its fin-root fairing, on the solids - (a) the servo (case + ears +
        output boss), the horn and the coupler clear the propulsion module and the cover (< INTERSECT_TOL) and the servo
        keeps >= servo_float - 0.01 from the module (it floats); (b) the lower ear tab is captured in its floor slot:
        material on both radial sides of the tab over the slot height and under it (>= C5_FILL_MIN); (c) slide-out: the
        servo + horn + coupler envelope swept along the service direction past the fairing face meets no module material;
        (d) the cover is seated on the service face (cover x module < tol, BRep gap < 0.01) and covers the pocket opening;
        (e) each cover screw: the clearance hole in the cover clear, the tap hole clear, tap material around it >=
        C5_FILL_MIN, and a screwdriver (cov_driver_d x cov_driver_len from the cover face outward) clear of every other
        component; (f) the connector bay holds the inline connector clear of the module and the servo."""
        L = self.L
        n, ss, f = L.vane_count, L.dd_service_side, L.dd_float
        prop = self.prop
        worst_x, worst_gap, slot_fill, sweep_x, cov = (0.0, ""), (math.inf, ""), (math.inf, ""), (0.0, ""), []
        screw_rows, driver_x, conn_x = [], (0.0, ""), (0.0, "")
        removal: list[dict] = []
        others = {nm: s for nm, s in self.shape.items() if nm != "propulsion_module" and self.parts[nm].in_vehicle}
        for k in range(n):
            th = L.fin_thetas[k]
            servo, horn, coupler, cover = (self.shape[f"servo_vane_{k + 1}"], self.shape[f"servo_horn_{k + 1}"],
                                           self.shape[f"vane_coupler_{k + 1}"], self.shape[f"servo_cover_{k + 1}"])
            for nm, s in ((f"servo_vane_{k + 1}", servo), (f"servo_horn_{k + 1}", horn), (f"vane_coupler_{k + 1}", coupler)):
                for tgt_nm, tgt in (("propulsion_module", prop), (f"servo_cover_{k + 1}", cover)):
                    v = _v(s, tgt)
                    if v > worst_x[0]:
                        worst_x = (v, f"{nm} x {tgt_nm}")
            g = _clearance(servo, prop)
            if g < worst_gap[0]:
                worst_gap = (g, f"servo_vane_{k + 1}")
            # (b) ear tab captured: inner / outer radial walls of the slot and its floor
            hw = L.dd_case_w / 2
            probes = {"inner": rg._box_polar(L.dd_slot_u[0] - C5_WALL_PROBE, L.dd_slot_u[0] - C5_PROBE_INSET, -hw, hw,
                                             L.dd_slot_z[0] + C5_PROBE_INSET, L.dd_slot_z[1] - C5_PROBE_INSET, th),
                      "outer": rg._box_polar(L.dd_slot_u[1] + C5_PROBE_INSET, L.dd_slot_u[1] + C5_WALL_PROBE, -hw, hw,
                                             L.dd_slot_z[0] + C5_PROBE_INSET, L.dd_slot_z[1] - C5_PROBE_INSET, th),
                      "floor": rg._box_polar(L.dd_slot_u[0], L.dd_slot_u[1], -hw, hw, L.dd_slot_z[0] - C5_WALL_PROBE,
                                             L.dd_slot_z[0] - C5_PROBE_INSET, th)}
            for pn, pb in probes.items():
                fr = _vpos(pb, prop) / pb.Volume()
                if fr < slot_fill[0]:
                    slot_fill = (fr, f"fin {k + 1} slot {pn}")
            # (c) slide-out along the service direction: the servo / horn / coupler boxes extended past the fairing face
            far = ss * (L.fair_hv + L.dd_case_w + C5_SWEEP_PAST)
            def swept(u0, u1, v0, v1, z0, z1):
                a, b = (min(v0, far), max(v1, far)) if ss > 0 else (min(v0, far), max(v1, far))
                return rg._box_polar(u0, u1, a, b, z0, z1, th)
            rr = max(L.dd_flange_d, L.dd_horn_d) / 2
            env = [swept(L.dd_u_case_top, L.dd_u_case_bot, -hw, hw, L.dd_z_case[0], L.dd_z_case[1]),
                   swept(L.dd_u_ear[0], L.dd_u_ear[1], -hw, hw, L.dd_z_ear[0], L.dd_z_ear[1]),
                   swept(L.dd_u_hub0, L.dd_u_case_top, -rr, rr, L.vane_hinge_z - rr, L.vane_hinge_z + rr),
                   # the servo's own lead and its connector half come out with it (under the lintel)
                   swept(L.dd_conn_u[0], L.dd_conn_u[1], -L.dd_conn_v, L.dd_conn_v, L.dd_conn_z[0], L.dd_conn_z[1])]
            for e in env:
                v = _v(e, prop)
                if v > sweep_x[0]:
                    sweep_x = (v, f"fin {k + 1}")
            # v0.9 fix round (reviewer: 'the removal procedure is blocked by the vane shaft'): the same sweep against the
            # vane installed (blocked - documented) and pushed inward by the shaft engagement + 1 mm (must be clear); the
            # pushed vane must clear the module, its bushing and the other vanes; the set screw's hex-key path (key_d x
            # key_len along +v from the hub with the cover off) must be clear
            if hasattr(L, "dd_set_screw_u"):
                push = L.dd_engagement + 1.0
                t = math.radians(L.vane_thetas[k])
                vane_in = self.shape[f"vane_{k + 1}"]
                vane_pushed = vane_in.translate(cq.Vector(-push * math.cos(t), -push * math.sin(t), 0.0))
                envu = rg._fuse(env)
                rm = {"installed": _v(envu, vane_in), "pushed": _v(envu, vane_pushed)}
                others_v = [prop] + [self.shape[f"vane_{j + 1}"] for j in range(n) if j != k]
                if f"hinge_bushing_{k + 1}" in self.shape:
                    others_v.append(self.shape[f"hinge_bushing_{k + 1}"])
                rm["pushed_vane_x"] = max(_v(vane_pushed, s) for s in others_v)
                kd, kl = L.dd_set_screw_key
                a = L.fin_xyz(k, L.dd_set_screw_u, ss * (L.dd_hub_d / 2 + 0.1), L.vane_hinge_z)
                b = L.fin_xyz(k, L.dd_set_screw_u, ss * (L.fair_hv + kl), L.vane_hinge_z)
                key = rg._cyl_between(kd, a, b)
                kx = max((_v(key, s), nm) for nm, s in list(others.items()) + [("propulsion_module", prop)]
                         if nm != f"servo_cover_{k + 1}")
                rm["key"], rm["key_hit"] = kx
                removal.append({"fin": k + 1, **rm})
            # (d) cover seated
            cov.append({"fin": k + 1, "x_module": _v(cover, prop), "gap": _clearance(cover, prop)})
            # (e) screws
            for j, (a, b) in enumerate(rg.cover_screw_axes(L, k)):
                va, vb = cq.Vector(*a), cq.Vector(*b)
                ax = (vb - va).normalized()
                tap_len = (vb - va).Length
                tap_clear = rg._cyl_between(L.cov_d_tap - 2 * C5_PROBE_INSET, a, (va + ax * (tap_len - C5_PROBE_INSET)).toTuple())
                ring = rg._cyl_between(L.cov_d_tap + 2 * C5_TAP_RING, (va + ax * C5_PROBE_INSET).toTuple(), b).cut(
                    rg._cyl_between(L.cov_d_tap + 2 * C5_PROBE_INSET, a, b, ext0=1.0, ext1=1.0))
                hole_clear = rg._cyl_between(L.cov_d_clear - 2 * C5_PROBE_INSET, (va - ax * (L.cov_t + 0.5)).toTuple(), a)
                driver = rg._cyl_between(L.cov_driver_d, (va - ax * (L.cov_t + 0.2)).toTuple(),
                                         (va - ax * (L.cov_t + 0.2 + L.cov_driver_len)).toTuple())
                vt = _v(tap_clear, prop)
                vr = _vpos(ring, prop) / ring.Volume()
                vh = _v(hole_clear, cover)
                dx = max((_v(driver, s), nm) for nm, s in list(others.items()) + [("propulsion_module", prop)])
                screw_rows.append({"fin": k + 1, "screw": j + 1, "tap_clear": vt, "tap_material": vr, "hole_clear": vh,
                                   "driver": dx[0], "driver_hit": dx[1]})
                if dx[0] > driver_x[0]:
                    driver_x = (dx[0], f"fin {k + 1} screw {j + 1} x {dx[1]}")
            # (f) connector bay
            conn = rg.servo_connector(L, k)
            v = max(_v(conn, prop), _v(conn, servo))
            if v > conn_x[0]:
                conn_x = (v, f"fin {k + 1}")
        ok_x = worst_x[0] < INTERSECT_TOL_MM3
        ok_gap = worst_gap[0] >= f - 0.01
        ok_slot = slot_fill[0] >= C5_FILL_MIN
        ok_sweep = sweep_x[0] < INTERSECT_TOL_MM3
        ok_cov = all(c["x_module"] < INTERSECT_TOL_MM3 and c["gap"] < 0.01 for c in cov)
        ok_screw = all(r["tap_clear"] < C5_CLEAR_TOL_MM3 and r["tap_material"] >= C5_FILL_MIN and r["hole_clear"] < C5_CLEAR_TOL_MM3
                       and r["driver"] < INTERSECT_TOL_MM3 for r in screw_rows)
        ok_conn = conn_x[0] < INTERSECT_TOL_MM3
        # v0.9 fix round: removal order (vane pushed in first) and the set-screw key path
        ok_rm = all(r["pushed"] < INTERSECT_TOL_MM3 and r["pushed_vane_x"] < INTERSECT_TOL_MM3 and r["key"] < INTERSECT_TOL_MM3
                    for r in removal)
        allok = ok_x and ok_gap and ok_slot and ok_sweep and ok_cov and ok_screw and ok_conn and ok_rm
        rm_txt = ""
        if removal:
            rm_txt = (f"; removal: sweep x vane installed {max(r['installed'] for r in removal):.1f} mm^3 (blocked: push the "
                      f"vane in first), x vane pushed {L.dd_engagement + 1.0:.1f} mm in {max(r['pushed'] for r in removal):.3f} "
                      f"mm^3, pushed vane x module / bushing / other vanes {max(r['pushed_vane_x'] for r in removal):.3f} mm^3; "
                      f"set-screw key O{L.dd_set_screw_key[0]:g} x {L.dd_set_screw_key[1]:g} x anything (cover off) "
                      f"{max(r['key'] for r in removal):.3f} mm^3")
        return Check("C5", "(v0.9 direct drive) servo + ears + horn + coupler in the fin-root fairing: clear, floating, ear tab "
                     "captured, slides out to the service side (after the vane is pushed in), cover seated, cover screws (tap, "
                     "material, screwdriver path), set-screw key path, connector bay", PASS if allok else FAIL,
                     f"max x (module / cover) {worst_x[0]:.3f} mm^3 ({worst_x[1]}); servo -> module min gap {worst_gap[0]:.3f} "
                     f"mm (float {f:g}); ear-slot walls / floor min fill {slot_fill[0]:.3f} ({slot_fill[1]}); slide-out sweep "
                     f"x module {sweep_x[0]:.3f} mm^3; cover x module max {max(c['x_module'] for c in cov):.3f}, gap max "
                     f"{max(c['gap'] for c in cov):.3f} mm; screws: tap clear max {max(r['tap_clear'] for r in screw_rows):.4f}, "
                     f"tap material min {min(r['tap_material'] for r in screw_rows):.3f}, cover hole clear max "
                     f"{max(r['hole_clear'] for r in screw_rows):.4f}, screwdriver x anything max {driver_x[0]:.3f} mm^3 "
                     f"({driver_x[1] or '-'}); connector x (module, servo) {conn_x[0]:.3f} mm^3" + rm_txt,
                     f"pocket u {L.dd_pocket_u[0]:.2f}..{L.dd_pocket_u[1]:.2f}, |v| {L.dd_pocket_hv:.2f} (+ open to the service side "
                     f"{'+' if ss > 0 else '-'}v), z {L.dd_pocket_z[0]:.2f}..{L.dd_pocket_z[1]:.2f}; ear slot u {L.dd_slot_u[0]:.2f}.."
                     f"{L.dd_slot_u[1]:.2f}, z {L.dd_slot_z[0]:.2f}..{L.dd_slot_z[1]:.2f}; cover screws (u, z) "
                     + ", ".join(f"({u:.2f}, {z:.2f})" for u, z in L.cov_screws_uz)
                     + f", tap O{L.cov_d_tap:g} x {L.cov_tap_depth:g}, clear O{L.cov_d_clear:g}; screwdriver O{L.cov_driver_d:g} x "
                       f"{L.cov_driver_len:g}",
                     {"intersection": worst_x[0], "servo_gap": worst_gap[0], "slot_fill": slot_fill[0], "sweep": sweep_x[0],
                      "covers": cov, "screws": screw_rows, "connector": conn_x[0], "removal": removal})

    def c28_coupler(self) -> Check:
        """v0.9 (direct drive): coupler alignment and torque - (a) the servo output axis (the horn disc's COM on the
        solid) lies on the vane hinge axis (offset < C28_AXIS_TOL); (b) servo_float >= print_tolerance_ASSUMED (the
        servo floats, so a pocket printed off the axis does not side-load the coupler); (c) the coupler and horn rotated
        with the vane at 0 / +-max_deflection_mech_deg clear the propulsion module and the servo case by >= servo_float -
        0.01 (BRep), and the coupler clears the vane shaft at every deflection (its D-bore clearance); (d) the shaft
        engages the hub over >= half the hub and ends short of the flange; (e) the worst hinge moment (Layout,
        ASSUMED CP offset and bearing friction) is below the servo torque by >= C28_TORQUE_MARGIN_MIN."""
        L = self.L
        if not L.direct_drive:
            return Check("C28", "(v0.9 direct drive) coupler alignment and hinge moment", NA,
                         "not applicable: vane_drive.mode 'pushrod'", "", {"applicable": False})
        dmax = L.p["vane"]["max_deflection_mech_deg"]
        axis_off, gap_min, shaft_x = 0.0, (math.inf, ""), (0.0, "")
        for k in range(L.vane_count):
            c = self.shape[f"servo_horn_{k + 1}"].Center()
            t = math.radians(L.vane_thetas[k])
            # distance of the horn's centre from the hinge axis line (radial at theta_k, Z hinge)
            along = c.x * math.cos(t) + c.y * math.sin(t)
            perp = -c.x * math.sin(t) + c.y * math.cos(t)
            axis_off = max(axis_off, math.hypot(perp, c.z - L.vane_hinge_z))
            for d in (0.0, +dmax, -dmax):
                cp = rg.vane_coupler(L, k, d)
                g = _clearance(cp, self.prop)
                if g < gap_min[0]:
                    gap_min = (g, f"coupler_{k + 1} d={d:+.0f} x propulsion_module")
                v = _v(cp, rg.vane(L, k, d))
                if v > shaft_x[0]:
                    shaft_x = (v, f"coupler_{k + 1} x vane_{k + 1} d={d:+.0f}")
        ok_axis = axis_off < C28_AXIS_TOL
        ok_float = L.dd_float >= L.dd_tol - 1e-9
        ok_gap = gap_min[0] >= L.dd_float - 0.01
        ok_shaft = shaft_x[0] < INTERSECT_TOL_MM3
        hub = L.dd_u_hub1 - L.dd_u_hub0
        ok_eng = L.dd_engagement >= 0.5 * hub and L.vane_shaft_r_out < L.dd_u_hub1
        ok_torque = L.vane_hinge_margin >= C28_TORQUE_MARGIN_MIN
        allok = ok_axis and ok_float and ok_gap and ok_shaft and ok_eng and ok_torque
        # v0.9 fix round: (f) axial retention by the set screw - the vane + coupler move as one: the inward stop (hub on
        # the boss face, boss_gap) < half the engagement; the outward free travel (vane root to the duct wall, measured
        # by translating vane_1 + coupler_1 radially in 0.05 mm steps) leaves the horn (arm face, screw head) untouched;
        # (g) foam pad compression range; (h) bushing (bore = its OD, shaft tilt); (i) set-screw thread length; (j)
        # socket: arm engagement over the slot at both stops, estimated lost motion
        extra = {}
        fix_txt = ""
        if hasattr(L, "dd_set_screw_u"):
            k = 0
            t = math.radians(L.vane_thetas[k])
            e = cq.Vector(math.cos(t), math.sin(t), 0.0)
            vane0, cp0 = self.shape[f"vane_{k + 1}"], self.shape[f"vane_coupler_{k + 1}"]
            horn0 = self.shape[f"servo_horn_{k + 1}"]
            stops = [self.prop] + ([self.shape[f"hinge_bushing_{k + 1}"]] if f"hinge_bushing_{k + 1}" in self.shape else [])
            def hits(d: float) -> float:
                return max(_v(vane0.translate(e * d), s) for s in stops)
            lo, hi = 0.0, 6.0          # bisection to 0.02 mm (hits(0) = 0: the vane clears the module as built)
            if hits(hi) < INTERSECT_TOL_MM3:
                lo = hi
            while hi - lo > 0.02:
                mid = 0.5 * (lo + hi)
                lo, hi = (mid, hi) if hits(mid) < INTERSECT_TOL_MM3 else (lo, mid)
            t_out = lo
            horn_at_out = max(_v(cp0.translate(e * t_out), horn0), _v(vane0.translate(e * t_out), horn0))
            inward_ok = (max(_v(cp0.translate(e * -(L.dd_inward_stop - 0.05)), s) for s in stops) < INTERSECT_TOL_MM3
                         and max(_v(cp0.translate(e * -(L.dd_inward_stop + 0.2)), s) for s in stops) > INTERSECT_TOL_MM3)
            arm_eng_out = min(L.dd_u_flange1 + t_out, L.dd_u_horn1) - max(L.dd_u_hub1 + t_out, L.dd_u_arm0)
            arm_eng_in = min(L.dd_u_flange1 - L.dd_inward_stop, L.dd_u_horn1) - max(L.dd_u_hub1 - L.dd_inward_stop, L.dd_u_arm0)
            ok_ret = (L.dd_inward_stop < 0.5 * L.dd_engagement and inward_ok and horn_at_out < INTERSECT_TOL_MM3
                      and min(arm_eng_out, arm_eng_in) >= L.dd_horn_arm_t - 1e-6)
            ok_foam = (not getattr(L, "dd_foam", False)) or (
                L.dd_foam_limits[0] - 1e-9 <= L.dd_foam_compression[0] and L.dd_foam_compression[1] <= L.dd_foam_limits[1] + 1e-9)
            ok_bush = (not getattr(L, "dd_bushing", False)) or abs(L.hinge_bore_d - L.dd_bush_od) < 1e-9
            ok_ss = L.dd_set_screw_wall >= 2 * L.p["printer"]["min_feature"] - 1e-9
            allok = allok and ok_ret and ok_foam and ok_bush and ok_ss
            extra = {"inward_stop_mm": L.dd_inward_stop, "inward_stop_found": inward_ok, "outward_free_mm": t_out,
                     "horn_x_at_outward_stop": horn_at_out, "arm_engagement_mm": [arm_eng_in, arm_eng_out],
                     "foam_compression": list(getattr(L, "dd_foam_compression", ())),
                     "bushing_tilt_deg": getattr(L, "dd_bush_tilt_deg", None), "set_screw_thread_mm": L.dd_set_screw_wall,
                     "deadband_pp_deg": {"socket": L.dd_deadband_slot_deg, "gear_backlash_ASSUMED": L.dd_gear_backlash_deg,
                                         "total": L.dd_deadband_pp_deg}}
            fix_txt = (f"; retention (set screw): inward stop {L.dd_inward_stop:g} mm (< {0.5 * L.dd_engagement:.2f} = half the "
                       f"engagement; stop found {inward_ok}), outward free {t_out:.2f} mm (vane root -> duct wall), coupler / shaft "
                       f"x horn at the outward stop {horn_at_out:.3f} mm^3, horn arms engaged {min(arm_eng_in, arm_eng_out):.2f} of "
                       f"{L.dd_horn_arm_t:g} mm at both stops; foam {L.dd_foam_t:g} mm compressed "
                       f"{L.dd_foam_compression[0]:.2f}..{L.dd_foam_compression[1]:.2f} (limits {L.dd_foam_limits[0]:g}.."
                       f"{L.dd_foam_limits[1]:g}); bushing O{L.dd_bush_od:g}/{L.dd_bush_id:g} in a O{L.hinge_bore_d:g} bore, tilt "
                       f"{L.dd_bush_tilt_deg:.2f} deg; set-screw thread {L.dd_set_screw_wall:.2f} mm; lost motion est. "
                       f"{L.dd_deadband_slot_deg:.2f} deg (socket) + {L.dd_gear_backlash_deg:g} deg gear (ASSUMED) p-p")
        return Check("C28", "(v0.9 direct drive) coupler alignment and hinge moment: servo axis on the hinge axis, servo floats "
                     ">= print tolerance, coupler clears the fairing at 0/+-max deflection, D-bore clears the shaft, shaft "
                     "engagement, hinge moment << servo torque; (fix round) set-screw axial retention, horn socket, foam pad, "
                     "hinge bushing", PASS if allok else FAIL,
                     f"axis offset {axis_off:.4f} mm (< {C28_AXIS_TOL:g}); float {L.dd_float:g} >= tolerance {L.dd_tol:g}; coupler -> "
                     f"module min gap {gap_min[0]:.3f} mm ({gap_min[1]}); coupler x shaft {shaft_x[0]:.3f} mm^3; engagement "
                     f"{L.dd_engagement:.2f} of {hub:.1f} mm; hinge moment {L.vane_hinge_moment_kgcm:.3f} kgf cm vs servo "
                     f"{L.servo_torque_kgcm:g} kgf cm (x{L.vane_hinge_margin:.1f}, >= {C28_TORQUE_MARGIN_MIN:g})" + fix_txt,
                     f"worst vane side load {L.vane_side_load_N:.2f} N (thrust_peak {L.p['edf']['thrust_peak_N']:.1f} N, exhaust "
                     f"q {L.vane_exit_q_pa:.0f} Pa, {L.vane_exit_v_mps:.1f} m/s, d_cmd {L.p['vane']['max_deflection_cmd_deg']:g} deg); "
                     f"CP offset {L.p['vane_drive']['hinge_moment']['cp_offset_chord_max_ASSUMED']:g} chord and bearing mu "
                     f"{L.p['vane_drive']['hinge_moment']['bearing_mu_ASSUMED']:g} ASSUMED",
                     {"axis_offset": axis_off, "coupler_gap": gap_min[0], "coupler_shaft": shaft_x[0],
                      "engagement": L.dd_engagement, "hinge_moment_kgcm": L.vane_hinge_moment_kgcm,
                      "servo_torque_kgcm": L.servo_torque_kgcm, "margin": L.vane_hinge_margin, **extra})

    def c5_linkage(self) -> Check:
        L = self.L
        if L.direct_drive:
            return self._c5_direct()
        n = L.vane_count
        group = {}
        for i in range(n):
            group[f"vane_horn_{i + 1}"] = self.shape[f"vane_horn_{i + 1}"]
            group[f"servo_vane_{i + 1}"] = self.shape[f"servo_vane_{i + 1}"]
            group[f"servo_arm_{i + 1}"] = self.shape[f"servo_arm_{i + 1}"]
            group[f"pushrod_{i + 1}"] = self.shape[f"pushrod_{i + 1}"]
        connected = set()
        for i in range(n):
            connected.add(frozenset({f"pushrod_{i + 1}", f"servo_arm_{i + 1}"}))
            connected.add(frozenset({f"pushrod_{i + 1}", f"vane_horn_{i + 1}"}))
        worst_mod = (0.0, "")
        for name, s in group.items():
            v = _v(s, self.prop)
            if v > worst_mod[0]:
                worst_mod = (v, name)
        worst_pair, skipped = (0.0, ""), []
        names = list(group)
        for a in range(len(names)):
            for b in range(a + 1, len(names)):
                pair = frozenset({names[a], names[b]})
                if pair in connected:
                    skipped.append(f"{names[a]}-{names[b]}")
                    continue
                v = _v(group[names[a]], group[names[b]])
                if v > worst_pair[0]:
                    worst_pair = (v, f"{names[a]} x {names[b]}")
        worst_pod = (0.0, "")
        for i in range(n):
            v = _v(self.shape[f"pushrod_{i + 1}"], rg.servo_pod(L, i))
            if v > worst_pod[0]:
                worst_pod = (v, f"pushrod_{i + 1} x pod_{i + 1}")
        vmax = max(worst_mod[0], worst_pair[0], worst_pod[0])
        return Check("C5", "horns, servos, arms, pushrods clear the module (incl. fins) and each other",
                     _status_no_intersection(vmax),
                     f"max  x module {worst_mod[0]:.3f} ({worst_mod[1]}), pairwise {worst_pair[0]:.3f} ({worst_pair[1]}), pushrod x pod {worst_pod[0]:.3f} mm^3",
                     f"connected pairs excluded from the pairwise test (joined by a clevis pin): {len(skipped)}",
                     {"module": worst_mod[0], "pairwise": worst_pair[0], "pushrod_pod": worst_pod[0]})

    def c6_modules(self) -> Check:
        L = self.L
        vtol = getattr(L, "vtol", False)
        pairs = [("propulsion_module", "intake_module"), ("intake_module", "avionics_module")] + (
            [("avionics_module", "top_cap")] if vtol else       # v0.9 CAD-2 VTOL: the top cap closes the stack
            [("avionics_module", "payload_module"), ("payload_module", "nose_cone")])
        vols = {f"{a} x {b}": _v(self.shape[a], self.shape[b]) for a, b in pairs}
        worst = max(vols, key=vols.get)
        return Check("C6", "adjacent modules do not intersect (spigot/skirt laps, nose skirt vs payload)",
                     _status_no_intersection(vols[worst]), f"max common volume {vols[worst]:.3f} mm^3 ({worst})",
                     f"spigot OD {L.spigot_od:.1f} vs tube ID {L.body_id:.1f}; " + ("top cap skirt over the avionics spigot" if vtol
                     else f"nose skirt ID {L.nose_skirt_id:.1f}"), vols)

    def c7_avionics(self) -> Check:
        L = self.L
        tube, tray = self.shape["avionics_module"], self.shape["avionics_tray"]
        vols = {}
        for n in [n for n in ("battery", "buffer_pack", "esc", "nav", "misc_electronics", "gns") if n in self.shape]:
            vols[f"{n} x tube"] = _v(self.shape[n], tube)
            vols[f"{n} x tray"] = _v(self.shape[n], tray)
        vols["tray x tube"] = _v(tray, tube)
        bb = tray.BoundingBox()
        lo, hi = L.tray_x - L.rail_gap / 2, L.tray_x + L.rail_gap / 2
        in_slot = bb.xmin >= lo - 1e-6 and bb.xmax <= hi + 1e-6
        worst = max(vols, key=vols.get)
        st = _status_no_intersection(vols[worst])
        if not in_slot:
            st = FAIL
        # v0.5d tray stop (SPEC 5.2, both presets), positive evidence: in each rail slot, right under the tray
        # footprint (x = the tray thickness, y from the rails' inner face to the tray edge), a FLOOR_AREA_SLAB-thin slab
        # is avionics_module material, and that material's top is the tray's bottom face (the tray rests on it)
        stop: dict[str, dict] = {}
        stop_txt = "no tray stop in params (tray_stop_h) - SPEC 5.2 requires one: FAIL"
        if not L.tray_stop_h:
            st = FAIL
        else:
            x0, x1 = L.tray_x - L.tray_t / 2, L.tray_x + L.tray_t / 2
            y_in, y_edge = L.rail_y - L.rail_depth, L.tray_w / 2
            for sy, nm in ((+1.0, "+y"), (-1.0, "-y")):
                if y_edge <= y_in:          # the tray does not reach into the slot: nothing to rest on
                    stop[nm] = {"filled": 0.0, "top_z": -math.inf}
                    continue
                ya, yb = (y_in, y_edge) if sy > 0 else (-y_edge, -y_in)
                slab = _box(x0, x1, ya, yb, L.z_tray_bottom - FLOOR_AREA_SLAB, L.z_tray_bottom)
                around = _box(x0, x1, ya, yb, L.z_tray_bottom - FLOOR_PROBE_H, L.z_tray_bottom + FLOOR_PROBE_H)
                stop[nm] = {"filled": _vpos(slab, tube) / slab.Volume(), "top_z": _top_z(tube, around)}
            stop_ok = all(s["filled"] >= TRAY_STOP_FILL_MIN and abs(s["top_z"] - L.z_tray_bottom) < TRAY_STOP_TOP_TOL
                          for s in stop.values())
            if not stop_ok:
                st = FAIL
            stop_txt = ("tray stop under the tray footprint: slab filled " +
                        ", ".join(f"{k} {s['filled']:.3f}" for k, s in stop.items()) +
                        f" (>= {TRAY_STOP_FILL_MIN:g}), top z " + ", ".join(f"{k} {s['top_z']:.3f}" for k, s in stop.items()) +
                        f" vs z_tray_bottom {L.z_tray_bottom:.3f} -> {stop_ok}")
        return Check("C7", "electronics clear tube and tray; tray clears tube and sits in the rail slot (v0.5d: on the tray stops)", st,
                     f"max common volume {vols[worst]:.3f} mm^3 ({worst}); tray x [{bb.xmin:.2f},{bb.xmax:.2f}] in slot [{lo:.2f},{hi:.2f}] -> {in_slot}; "
                     + stop_txt,
                     f"tray stop (SPEC 5.2): block x tray_x +- rail_gap/2, Z {L.z_tray_stop_bottom if L.tray_stop_h else float('nan'):.2f}.."
                     f"{L.z_tray_bottom:.2f}; probes x {L.tray_x - L.tray_t / 2:.2f}..{L.tray_x + L.tray_t / 2:.2f}, |y| "
                     f"{L.rail_y - L.rail_depth:.3f}..{L.tray_w / 2:.2f}, slab {FLOOR_AREA_SLAB:g} mm under the tray",
                     {**vols, "tray_x": [bb.xmin, bb.xmax], "slot": [lo, hi], "tray_stop": stop})

    def c8_exhaust(self) -> Check:
        """SPEC C8: the path cylinder intersects nothing but vanes/shafts and (tabs) the edf_unit motor/hub;
        path x propulsion_module = 0 and, measured, path x every other component = 0."""
        L = self.L
        path = rg.exhaust_path(L)
        pb = path.BoundingBox()
        v = _v(path, self.prop)
        vane_v = sum(_v(path, self.shape[f"vane_{i + 1}"]) for i in range(L.vane_count))
        allowed = {f"vane_{i + 1}" for i in range(L.vane_count)} | {"propulsion_module"}
        if L.tabs:
            allowed.add("edf_unit")
        others = {}
        for n, p in self.parts.items():          # every other component whose bbox reaches the path
            if n in allowed or p.shape is None or not p.in_vehicle:
                continue
            bb = p.shape.BoundingBox()
            if bb.zmax < pb.zmin or bb.zmin > pb.zmax or bb.xmax < pb.xmin or bb.xmin > pb.xmax \
                    or bb.ymax < pb.ymin or bb.ymin > pb.ymax:
                continue
            others[n] = _v(path, p.shape)
        worst_other = max(others.items(), key=lambda kv: kv[1]) if others else ("", 0.0)
        detail = (f"D{L.duct_id - 2:.0f} Z 0..{L.z_edf_housing_bottom:.1f}; other components tested (bbox overlap): "
                  f"{', '.join(f'{n} {x:.3f}' for n, x in others.items()) or 'none'}")
        values = {"module": v, "vanes": vane_v, "others": others}
        if L.tabs:   # v0.5: the probe passes the liner bore (duct_r) up to z_liner_top; the motor sits in the jet
            motor_v = _v(path, self.shape["edf_unit"])
            detail += (f"; liner bore r {L.duct_r:.2f} Z {L.z_edf_shoulder:.1f}..{L.z_liner_top:.1f}; "
                       f"EDF motor/hub inside the path {motor_v:.0f} mm^3 (the EDF's own tail, allowed)")
            values["edf_unit"] = motor_v
        lead_txt = ""
        if getattr(L, "clock_mount", False):
            # wire09c clock mount: the factory bundle / leads of the WORST drag corner (grown) inside the path - allowed,
            # quantified (as the EDF motor / hub); the frontal blockage of that corner; the duct-wall window the passage
            # opens under the rim (E)
            wc = L.ml_blockage["worst_corner"]
            cw = {"S": wc["S"], "sec": wc["sec"], "h": L.gb_sections[wc["sec"]][0], "w": L.gb_sections[wc["sec"]][1],
                  "od": wc["od"], "R": min(L.gb_R), "gap": min(L.gb_gap), "inset": max(L.gb_inset), "early": 0.0}
            lv = {"worst-drag corner envelope (grown)": ckc._v_env(rg.clock_lead_env(L, cw, 0.0, True), path)}
            bl_ = L.ml_blockage
            values["motor_lead_legs"] = lv
            values["motor_lead_blockage"] = {k: v for k, v in bl_.items()}
            values["duct_window_mm2_E"] = L.lp_duct_window_mm2
            lead_txt = (f", motor-lead envelope inside the path {sum(lv.values()):.0f} mm^3 (allowed, quantified: worst corner "
                        f"{bl_['projected_mm2']:.1f} mm^2 = {bl_['projected_pct']:.1f} % of the jet annulus, E; duct-wall "
                        f"window under the rim {L.lp_duct_window_mm2:.0f} mm^2, E)")
            detail += (f"; motor leads (clock mount, worst drag corner {wc['sec']} S{wc['S']:g} od{wc['od']:g} "
                       f"{wc['singles']}): bundle {bl_['bundle_len_in_jet_mm']:.1f} mm + single leads "
                       f"{bl_['single_leads_len_in_jet_mm']:.1f} mm in the jet (drag in C33)")
        elif getattr(L, "ml_lower_uz", None):
            # fix round (review 2026-10-29 G6): the motor-lead bundle / leads behind the stator vane lie in the exhaust
            # path - an allowed, quantified obstruction (as the EDF motor / hub): their envelope (grown by wire_clearance)
            # inside the path and Layout's frontal blockage of the jet annulus; the drag goes to C33 / vtol_sizing
            legs = rg.motor_lead_lower_legs(L)
            lv = {k: _v(path, s_) for k, s_ in legs.items()}
            bl_ = L.ml_blockage
            values["motor_lead_legs"] = lv
            values["motor_lead_blockage"] = dict(bl_)
            lead_txt = (f", motor-lead envelope inside the path {sum(lv.values()):.0f} mm^3 (allowed, quantified: "
                        f"{bl_['projected_mm2']:.0f} mm^2 = {bl_['projected_pct']:.1f} % of the jet annulus)")
            detail += (f"; motor leads (photo round): envelope x path " + ", ".join(f"{k} {x:.0f}" for k, x in lv.items())
                       + f" mm^3, bundle {bl_['bundle_len_in_jet_mm']:.1f} mm + single leads "
                       f"{bl_['single_leads_len_in_jet_mm']:.1f} mm in the jet (drag in C33)")
        return Check("C8", "exhaust path D(duct_id-2), exit -> EDF housing bottom, meets nothing but vanes/shafts "
                     "(and, tabs, the EDF motor/hub; v0.9 the motor-lead bundle, quantified); x propulsion_module = 0",
                     _status_no_intersection(max(v, worst_other[1])),
                     f"path x module {v:.3f} mm^3, x other components max {worst_other[1]:.3f} ({worst_other[0] or '-'}); "
                     f"vanes inside the path {vane_v:.0f} mm^3" + (", EDF motor/hub allowed" if L.tabs else "") + lead_txt
                     + " (allowed)",
                     detail, values)

    def c9_inlet(self) -> Check:
        """SPEC C9 (v0.6.1): inlet area ratio >= minimum, from the MINIMUM opening of the built band (cylindrical probe
        shells across it, build_rocket / rocket_geometry.intake_opening_areas_mm2) and from Layout (at r_band_in); plus
        solid evidence of the v0.6.1 band: every window clear through (no leftover skin), every strut's mid-height
        horizontal section >= C9_STRUT_SECTION_MIN x the design sector and window_wall_t deep, and the band
        window_wall_t thick (radial probes) and solid in the margin rings under / over every window."""
        L = self.L
        intake = self.shape["intake_module"]
        ex = self.report["extra"]
        meas, meas_out = ex["inlet_area_ratio_measured"], ex["inlet_area_ratio_measured_outer"]
        req = L.p["intake_module"]["min_inlet_area_ratio"]
        ratio_ok = L.inlet_area_ratio >= req and meas >= req        # NaN (no evidence) compares False
        e, t = C9_PROBE_INSET, L.window_wall_t
        zm = 0.5 * (L.z_window_bottom + L.z_window_top)
        d_in = math.degrees(e / L.r_band_in)                        # angular inset of the window probes
        gable = L.has_window_gable
        # (a) every window clear through, r from inside the band to outside the body; v0.6.2: above the lower boundary
        # (the gable prism raised by the inset), so the gussets under it are not counted as a blocked window
        win_v = {}
        for (lo, hi), th in zip(L.window_sectors, L.window_thetas):
            probe = rg._sector(L.r_band_in - C9_WINDOW_PROBE_PAST, L.body_r + C9_WINDOW_PROBE_PAST, lo + d_in, hi - d_in,
                               L.z_window_bottom + e, L.z_window_top - e)
            if gable:
                probe = probe.intersect(rg.intake_window_gable_prism(L, th).translate(rg.V(0.0, 0.0, e)))
            win_v[f"{th:g}"] = _v(probe, intake)
        win_ok = max(win_v.values()) < C9_WINDOW_CLEAR_TOL_MM3
        gab = self._c9_gable(intake) if gable else {"ok": True}
        # (b) every strut: mid-height horizontal section (FLOOR_AREA_SLAB slab over the strut and a quarter of each
        # neighbouring window) and its radial extent at the strut centre
        half = 0.5 * L.strut_angle_deg + 0.25 * L.window_angle_deg
        struts, sect_min, depth_err = {}, math.inf, 0.0
        # v0.9 fix round: the motor-lead tie anchors stand on the 0 deg strut's inner face - section it in the free span
        # nearest mid-height (between two anchors) so the probe sees the strut itself
        zs_ = zm
        anc = list(getattr(L, "ml_anchor_z", []) or [])
        if anc:
            stops_ = [L.z_shelf_top] + anc + [L.z_intake_bulkhead_bottom]
            mids = [0.5 * (a + b) for a, b in zip(stops_[:-1], stops_[1:])]
            zs_ = min(mids, key=lambda z: abs(z - zm))
        for s in L.strut_thetas:
            z_p = zs_ if (anc and abs(((s - L.wire_theta + 180.0) % 360.0) - 180.0) < 1e-6) else zm
            slab = rg._sector(L.r_band_in - C9_WINDOW_PROBE_PAST, L.body_r + C9_WINDOW_PROBE_PAST, s - half, s + half,
                              z_p, z_p + FLOOR_AREA_SLAB)
            area = _vpos(slab, intake) / FLOOR_AREA_SLAB
            segs = rg.radial_material(intake, s, z_p, L.r_band_in - C9_WINDOW_PROBE_PAST, L.body_r + C9_WINDOW_PROBE_PAST)
            if len(segs) == 1:
                err = max(abs(segs[0][0] - L.r_band_in), abs(segs[0][1] - L.body_r))
            else:
                err = math.inf                                      # split or missing: not the design section
            struts[f"{s:g}"] = {"section_mm2": area, "radial": segs}
            sect_min, depth_err = min(sect_min, area), max(depth_err, err)
        sect_req = C9_STRUT_SECTION_MIN * L.strut_section_mm2
        strut_ok = sect_min >= sect_req and depth_err < C9_RADIAL_TOL
        # (c) band in the margin rings: radial probes at every window centre, and the ring under / over every window
        # span solid over the band's whole thickness
        rings = {"below": (L.z_shelf_top, L.z_window_bottom), "above": (L.z_window_top, L.z_intake_bulkhead_bottom)}
        ring_err, ring_void = 0.0, 0.0
        for z0, z1 in rings.values():
            for (lo, hi), th in zip(L.window_sectors, L.window_thetas):
                segs = rg.radial_material(intake, th, 0.5 * (z0 + z1), L.r_band_in - C9_WINDOW_PROBE_PAST,
                                          L.body_r + C9_WINDOW_PROBE_PAST)
                ring_err = max(ring_err, max(abs(segs[0][0] - L.r_band_in), abs(segs[0][1] - L.body_r))
                               if len(segs) == 1 else math.inf)
                ring_void = max(ring_void, _void(rg._sector(L.r_band_in + e, L.body_r - e, lo, hi, z0 + e, z1 - e), intake))
        band_ok = ring_err < C9_RADIAL_TOL and ring_void < C20_CLOSED_TOL_MM3
        ok = ratio_ok and win_ok and strut_ok and band_ok and gab["ok"]
        probes = ex.get("inlet_opening_probes_mm2", [])
        gab_txt = ""
        if gable:
            gab_txt = (f"; v0.6.2 gable: gusset void max {gab['gusset_void_max']:.4f} mm^3 (< {C9_GUSSET_VOID_TOL_MM3:g}), "
                       f"bridge above / below z_window_bottom {gab['bridge_above_max']:.4f} / {gab['bridge_below_void_max']:.4f} "
                       f"mm^3, lower edges {gab['n_sloped']} sloped min {gab['slope_min_deg']:.2f} deg (>= "
                       f"{GABLE_MIN_EDGE_SLOPE_DEG:g}), flat edges off the bridge {gab['flat_off_bridge']}, missing "
                       f"{len(gab['missing'])}")
        return Check("C9", "inlet area ratio (minimum opening of the built band) >= minimum; v0.6.1 band: windows clear "
                     "through, struts >= 0.95 x design section and window_wall_t deep, band window_wall_t thick; v0.6.2: "
                     "gussets solid under the gable, bridge flat at z_window_bottom, lower edges >= 35 deg",
                     PASS if ok else FAIL,
                     f"ratio layout {L.inlet_area_ratio:.3f} (min, r {L.inlet_area_r_min:.2f}) / {L.inlet_area_ratio_outer:.3f} "
                     f"(outer), measured min {meas:.3f} / outer {meas_out:.3f} >= {req:.2f}; windows clear max "
                     f"{max(win_v.values()):.4f} mm^3 (< {C9_WINDOW_CLEAR_TOL_MM3:g}); strut section min {sect_min:.2f} >= "
                     f"{sect_req:.2f} mm^2, depth err {depth_err:.4f}; band ring err {ring_err:.4f} mm, ring void "
                     f"{ring_void:.3f} mm^3" + gab_txt,
                     f"band r {L.r_band_in:.2f}..{L.body_r:.2f} (window_wall_t {t:g}), Z {L.z_shelf_top:.2f}.."
                     f"{L.z_intake_bulkhead_bottom:.2f}; windows (radial sectors) "
                     + ", ".join(f"{a:.2f}..{b:.2f}" for a, b in L.window_sectors)
                     + f" deg x Z {L.z_window_bottom:.2f}..{L.z_window_top:.2f}; struts {L.strut_w:g} at body_r / "
                     f"{L.strut_w_in:.2f} inner face, design section {L.strut_section_mm2:.2f} mm^2; opening probes "
                     f"(r_mean, mm^2) over Z {ex.get('inlet_opening_z_mm')}: "
                     + ", ".join(f"({r:.3f}, {a:.1f})" for r, a in probes)
                     + f"; layout area min {L.inlet_area_mm2:.1f} / outer {L.inlet_area_outer_mm2:.1f} mm^2 (square windows "
                       f"{L.inlet_area_square_mm2:.1f}), fan annulus {L.fan_annulus_area_mm2:.1f} mm^2; window probes x intake "
                       f"(mm^3, above the lower boundary): "
                     + ", ".join(f"{k} {v:.4f}" for k, v in win_v.items())
                     + "; strut sections (mm^2) / radial material: "
                     + "; ".join(f"{k} {v['section_mm2']:.2f} / " + ",".join(f"{a:.3f}..{b:.3f}" for a, b in v["radial"])
                                 for k, v in struts.items())
                     + (f"; gable (slope {L.gable_slope_deg:g} deg, bridge {L.gable_bridge_w:g} mm, h {L.gable_h_inner:.2f} / "
                        f"{L.gable_h_outer:.2f} at r_band_in / body_r, layout edge slope min {L.gable_edge_slope_min_deg:.2f} "
                        f"deg): gusset void per window " + ", ".join(f"{k} {v:.4f}" for k, v in gab["gusset_void"].items())
                        + "; lower edges per window (surface/side: z span, min slope) " + "; ".join(
                            f"{k} " + ", ".join(f"{s} {a:.2f}..{b:.2f} {m:.2f}" for s, (a, b, m) in v.items())
                            for k, v in gab["edges"].items())
                        + (f"; MISSING {gab['missing']}" if gab["missing"] else "") if gable else "; square windows (no gable in params)"),
                     {"layout": L.inlet_area_ratio, "layout_outer": L.inlet_area_ratio_outer, "measured": meas,
                      "measured_outer": meas_out, "required": req, "window_probe_mm3": win_v, "struts": struts,
                      "strut_section_min_mm2": sect_min, "strut_section_required_mm2": sect_req,
                      "strut_depth_err_mm": depth_err, "ring_radial_err_mm": ring_err, "ring_void_mm3": ring_void,
                      "gable": gab})

    def _c9_gable(self, intake: cq.Shape) -> dict:
        """v0.6.2 C9 evidence of the window gable (Layout.has_window_gable), all on the solid:
        * gussets solid: per window, the design gusset region inset C9_PROBE_INSET from the band faces, the window sides
          and the gable faces (the prism lowered by the inset) is material - void < C9_GUSSET_VOID_TOL_MM3;
        * bridge flat at z_window_bottom: over |y'| <= bridge_w/2 - inset (sector half angle asin((hf - e) / body_r)) a
          slab right above z_window_bottom is clear and one right below it is solid;
        * printability: every lower-boundary edge on the outer AND inner band surface (BRep edges lying on r = body_r or
          r_band_in inside a window sector, Z [z_window_bottom, z_gable_top]) is either flat at z_window_bottom within the
          bridge or rises at >= GABLE_MIN_EDGE_SLOPE_DEG from horizontal at every tangent sample; on each surface and
          each side of every window the sloped edges run from z_window_bottom to the gable height of that surface
          (missing edges are no evidence -> FAIL)."""
        L = self.L
        e = C9_PROBE_INSET
        res: dict = {"gusset_void": {}, "edges": {}, "missing": [], "flat_off_bridge": 0, "n_sloped": 0,
                     "slope_min_deg": math.inf}
        hf, d_in = L.gable_half_flat, math.degrees(e / L.r_band_in)
        bridge_half = math.degrees(math.asin(max(0.0, hf - e) / L.body_r))
        above, below = 0.0, 0.0
        for (lo, hi), th in zip(L.window_sectors, L.window_thetas):
            region = rg._sector(L.r_band_in + e, L.body_r - e, lo + d_in, hi - d_in, L.z_window_bottom + e,
                                L.z_gable_top + 1.0).cut(rg.intake_window_gable_prism(L, th).translate(rg.V(0.0, 0.0, -e)))
            res["gusset_void"][f"{th:g}"] = _void(region, intake)
            if bridge_half > 0.0:
                above = max(above, _v(rg._sector(L.r_band_in + e, L.body_r - e, th - bridge_half, th + bridge_half,
                                                 L.z_window_bottom + e, L.z_window_bottom + 2 * e), intake))
                below = max(below, _void(rg._sector(L.r_band_in + e, L.body_r - e, th - bridge_half, th + bridge_half,
                                                    L.z_window_bottom - 2 * e, L.z_window_bottom - e), intake))
        res["gusset_void_max"] = max(res["gusset_void"].values())
        res["bridge_above_max"], res["bridge_below_void_max"] = above, below
        # lower-boundary edges on the curved band surfaces
        tol, zb = C9_EDGE_TOL, L.z_window_bottom
        h_surf = {"outer": L.gable_h_outer, "inner": L.gable_h_inner}
        spans: dict[tuple, list] = {}
        for edge in intake.Edges():
            bb = edge.BoundingBox()
            if bb.zmin < zb - tol or bb.zmax > L.z_gable_top + tol:
                continue
            ts = [k / (C9_EDGE_SAMPLES - 1) for k in range(C9_EDGE_SAMPLES)]
            pts = [edge.positionAt(t) for t in ts]
            rs = [math.hypot(p.x, p.y) for p in pts]
            surf = ("outer" if all(abs(r - L.body_r) < tol for r in rs) else
                    "inner" if all(abs(r - L.r_band_in) < tol for r in rs) else None)
            if surf is None:
                continue
            mid = pts[len(pts) // 2]
            th_mid = math.degrees(math.atan2(mid.y, mid.x))
            win = [k for k, (lo, hi) in enumerate(L.window_sectors) if (th_mid - lo) % 360.0 <= hi - lo]
            if len(win) != 1:
                continue
            th = math.radians(L.window_thetas[win[0]])
            yps = [-p.x * math.sin(th) + p.y * math.cos(th) for p in pts]
            if bb.zmax - bb.zmin <= tol:                                   # flat: must be the bridge at z_window_bottom
                if abs(bb.zmax - zb) > tol or max(abs(y) for y in yps) > hf + tol:
                    res["flat_off_bridge"] += 1
                continue
            slopes = []
            for t in ts:
                tg = edge.tangentAt(t)
                slopes.append(math.degrees(math.atan2(abs(tg.z), math.hypot(tg.x, tg.y))))
            side = "+" if yps[len(yps) // 2] > 0 else "-"
            spans.setdefault((win[0], surf, side), []).append((bb.zmin, bb.zmax, min(slopes)))
            res["n_sloped"] += 1
            res["slope_min_deg"] = min(res["slope_min_deg"], min(slopes))
        for k, th_w in enumerate(L.window_thetas):
            rec = {}
            for surf in ("outer", "inner"):
                for side in ("+", "-"):
                    sp = spans.get((k, surf, side))
                    if not sp:
                        res["missing"].append(f"{th_w:g} {surf} {side}")
                        continue
                    z0, z1, m = min(s[0] for s in sp), max(s[1] for s in sp), min(s[2] for s in sp)
                    rec[f"{surf}{side}"] = (z0, z1, m)
                    if abs(z0 - zb) > tol or abs(z1 - (zb + h_surf[surf])) > tol:
                        res["missing"].append(f"{th_w:g} {surf} {side} spans {z0:.3f}..{z1:.3f}")
            res["edges"][f"{th_w:g}"] = rec
        res["ok"] = (res["gusset_void_max"] < C9_GUSSET_VOID_TOL_MM3 and above < C9_WINDOW_CLEAR_TOL_MM3
                     and below < C9_GUSSET_VOID_TOL_MM3 and not res["missing"] and res["flat_off_bridge"] == 0
                     and res["n_sloped"] > 0 and res["slope_min_deg"] >= GABLE_MIN_EDGE_SLOPE_DEG - 1e-6)
        return res

    def c10_min_feature(self) -> Check:
        p = self.L.p
        L = self.L
        mf = p["printer"]["min_feature"]
        designed = {
            "body.wall": p["body"]["wall"], "body.spigot_wall": p["body"]["spigot_wall"],
            "propulsion_module.cone_wall": p["propulsion_module"]["cone_wall"],
            "propulsion_module.sleeve_wall": p["propulsion_module"]["sleeve_wall"],
            "propulsion_module.web_t": p["propulsion_module"]["web_t"],
            "pod.wall_tangential": p["pod"]["wall_tangential"], "pod.wall_radial": p["pod"]["wall_radial"],
            "pod.floor_t": p["pod"]["floor_t"], "fin.t": p["fin"]["t"], "vane.t": p["vane"]["t"],
            "vane.shaft_d": p["vane"]["shaft_d"],
            **({"vane.horn_t": p["vane"]["horn_t"], "vane.horn_w": p["vane"]["horn_w"]} if not L.direct_drive else
               {"vane_drive.fairing.wall": p["vane_drive"]["fairing"]["wall"],
                "vane_drive.fairing.floor_t": p["vane_drive"]["fairing"]["floor_t"],
                "vane_drive.fairing.top_t": p["vane_drive"]["fairing"]["top_t"],
                "vane_drive.fairing.outer_block": p["vane_drive"]["fairing"]["outer_block"],
                "vane_drive.cover.t": p["vane_drive"]["cover"]["t"],
                **({"vane_drive.coupler.flange_t": p["vane_drive"]["coupler"]["flange_t"]}
                   if "flange_t" in p["vane_drive"]["coupler"] else
                   # v0.9 fix round: the horn socket's jaws (radial, outside the hub relief) and the set-screw wall
                   {"coupler socket jaw ((flange_d - collar relief)/2)": (L.dd_flange_d - L.dd_collar_relief_d) / 2,
                    "coupler hub wall at the flat (set-screw thread)": L.dd_set_screw_wall}),
                "servo_leads.fin_route.pipe.wall": p["servo_leads"]["fin_route"]["pipe"]["wall"]}),
            "intake_module.shelf_t": p["intake_module"]["shelf_t"], "intake_module.bulkhead_t": p["intake_module"]["bulkhead_t"],
            "intake_module.strut_w": p["intake_module"]["strut_w"],
            "intake_module.window_wall_t (band / strut thickness)": p["intake_module"]["window_wall_t"],
            "avionics_module.tray_t": p["avionics_module"]["tray_t"], "avionics_module.rail_w": p["avionics_module"]["rail_w"],
            "payload_module.bulkhead_t": p["payload_module"]["bulkhead_t"], "payload_module.piston_t": p["payload_module"]["piston_t"],
            "payload_module.latch_arm_t": p["payload_module"]["latch_arm_t"], "payload_module.latch_arm_w": p["payload_module"]["latch_arm_w"],
            "payload_module.latch_lug_h": p["payload_module"]["latch_lug_h"], "payload_module.latch_lug_w": p["payload_module"]["latch_lug_w"],
            "nose.wall": p["nose"]["wall"], "nose.anchor_bar_w": p["nose"]["anchor_bar_w"], "nose.anchor_bar_h": p["nose"]["anchor_bar_h"],
            "launch_pad.plate_t": p["launch_pad"]["plate_t"], "launch_pad.fin_locator_rib_w": p["launch_pad"]["fin_locator_rib_w"],
            "launch_pad.fin_locator_rib_h": p["launch_pad"]["fin_locator_rib_h"], "launch_pad.foot_t": p["launch_pad"]["foot_t"],
            "spigot shoulder ring (=body.wall)": rg.spigot_shoulder_t(L),
            # switch-collar round (2026-11-05): the protective collar's wall (battery build; its own rules in C41)
            **({"logic_power.collar.wall_t": L.lp_col_t} if getattr(L, "has_lp_collar", False) else {}),
        }
        derived = {
            "hinge boss wall (boss_od-bore_d)/2": (L.hinge_boss_od - L.hinge_bore_d) / 2,
            "piston under recess (piston_t-recess_depth)": p["payload_module"]["piston_t"] - p["payload_module"]["piston_recess_depth"],
            # (the release pod keeps the pod cup and its ear holes in both vane_drive modes)
            "pod wall outside ear hole (pod_w/2-(pitch/2+d/2))": L.pod_w / 2 - (p["servo"]["ear_hole_pitch"] / 2 + p["servo"]["ear_hole_d"] / 2),
            "pod wall inside ear hole ((pitch/2-d/2)-cavity_w/2)": (p["servo"]["ear_hole_pitch"] / 2 - p["servo"]["ear_hole_d"] / 2) - L.pod_cavity_w / 2,
            "shaft D-flat remaining (shaft_d-d_flat_depth)": p["vane"]["shaft_d"] - p["vane"]["d_flat_depth"],
            "spring seat boss wall beside bulkhead holes": p["payload_module"]["bulkhead_hole_r"] - p["payload_module"]["bulkhead_hole_d"] / 2 - p["payload_module"]["spring_seat_boss_d"] / 2,
            "anchor bar wall beside tether eye ((bar_w-eye_d)/2)": (p["nose"]["anchor_bar_w"] - p["nose"]["tether_eye_d"]) / 2,
            # v0.6.1 intake band (SPEC 5.1): radial-sided struts keep strut_w_in at the band's inner face; the shelf
            # stands out past the band by shelf_ledge (Layout raises below min_feature for both)
            "intake strut inner face (strut_w x r_band_in / body_r)": L.strut_w_in,
            "intake shelf ledge past the band (r_band_in - shelf_id/2)": L.shelf_ledge,
        }
        if not L.direct_drive:
            derived["horn wall beside D-bore (horn_w-bore_d)/2"] = (p["vane"]["horn_w"] - L.hinge_bore_d) / 2
            derived["horn material above pin hole"] = rg.HORN_PIN_BELOW_TIP - p["vane"]["horn_pin_hole_d"] / 2
        else:            # v0.9 direct drive (Layout raises below min_feature for all of these)
            derived.update({f"fairing {k}": w for k, w in L.fair_walls.items() if k not in ("side wall", "top", "outer block")})
            derived.update({f"servo cover screw {k}": w for k, w in L.cov_tap_walls.items()})
            derived["coupler hub wall around the D-bore ((hub_d - bore_d)/2)"] = (L.dd_hub_d - L.dd_bore_d) / 2
            derived.update({f"lead pipe {k}": w for k, w in getattr(L, "sl_pipe_walls", {}).items()})
        if L.tabs and getattr(L, "wire_ch_open", False):    # v0.9 open motor-lead groove
            derived.update({f"motor-lead groove {k}": w for k, w in L.wire_cov_walls.items()})
            if getattr(L, "wire_lip_slit_w", 0.0):           # v0.9 fix round: lip slit, tie anchors
                derived["lip-pocket wall beside the slit, inside the gate ((gate_w - slit_w)/2)"] = (
                    (L.wire_gate_w - L.wire_lip_slit_w) / 2)
            if getattr(L, "ml_anchor_z", None):
                derived["tie anchor wall inside its tunnel (inner face)"] = L.ml_anchor_wall
                derived["tie anchor tunnel -> strut face"] = L.r_band_in - (L.ml_anchor_u + L.ml_anchor_wall + L.ml_anchor_tunnel[0])
                derived["tie anchor wall above / below its tunnel ((h - tunnel_h)/2)"] = (L.ml_anchor_h - L.ml_anchor_tunnel[1]) / 2
        if L.direct_drive and hasattr(L, "dd_slot_hw"):      # v0.9 fix round: coupler socket jaw beside the arm slot
            derived["coupler socket jaw beside the arm slot (flange_d/2 - slot half width)"] = L.dd_flange_d / 2 - L.dd_slot_hw
            derived["coupler socket jaw at the horn arm tips"] = L.dd_jaw_at_tip
        if L.has_com_board:   # v0.6 COM-board bosses (SPEC 5.3)
            derived["COM boss wall beside its blind hole ((boss_d-hole_d)/2)"] = (L.com_boss_d - L.com_hole_d) / 2
            derived["payload bulkhead skin over the COM blind hole (boss_h+bulkhead_t-hole_depth)"] = L.com_hole_skin
        if L.tabs:   # v0.5 tab mount (SPEC 3.7 / 5.1)
            wc = p["intake_module"]["wire_channel"]
            pm = p["propulsion_module"]
            designed["intake_module.wire_channel.wall"] = wc["wall"]
            designed["propulsion_module.liner_wall"] = pm["liner_wall"]
            designed["propulsion_module.tab_screw.floor_t"] = pm["tab_screw"]["floor_t"]
            if getattr(L, "clock_mount", False):
                # wire09c clock mount: no tab screws / lugs / wire slot; the new walls and features instead
                ck, lp = pm["clock_keyways"], pm["lead_passage"]
                designed["propulsion_module.clock_keyways.pad_t"] = ck["pad_t"]
                designed["propulsion_module.clock_keyways.col_wall"] = ck["col_wall"]
                designed["propulsion_module.lead_passage.wall"] = lp["wall"]
                derived.update({
                    "sleeve tooth between two keyways (min, at the bore)": L.ck_min_tooth,
                    "spigot ring outside the keyway (spigot_od/2 - keyway corner r)":
                        L.spigot_od / 2 - math.hypot(L.keyway_r_out, L.keyway_w / 2),
                    "lip-pocket wall beside the wire channel (wire_ch_r0 - lip_pocket_id/2)":
                        L.wire_ch_r0 - L.lip_pocket_id / 2,
                })
            def hole_to_bore(d: float, t_near: float) -> float:
                # a hole along t (|t| >= t_near) of diameter d: its point nearest the vehicle axis is
                # (r_s - d/2, t_near), so the wall to the EDF bore is hypot(r_s - d/2, t_near) - bore_r
                return math.hypot(L.tab_screw_r - d / 2, t_near) - L.edf_bore_r
            derived.update({} if getattr(L, "clock_mount", False) else {
                # (Layout.tab_cbore_wall_to_bore = r_seat - d_cbore/2 - bore_r is the conservative disc bound)
                "tab counterbore -> EDF bore (at t_head)": hole_to_bore(L.tab_screw_d_cbore, L.tab_screw_t_head),
                "tab clearance hole -> EDF bore (at the keyway face)": hole_to_bore(L.tab_screw_d_clear, L.tab_screw_t_keyway),
                "tab tap hole -> EDF bore (at the keyway face)": hole_to_bore(L.tab_screw_d_tap, L.tab_screw_t_keyway),
                "keyway floor (keyway_z0 - block_z0)": L.keyway_z0 - L.block_z0,
                "lug margin beyond the counterbore in Z (min over screws)":
                    min(min(z - L.tab_screw_d_cbore / 2 - z0, z1 - (z + L.tab_screw_d_cbore / 2))
                        for z in L.tab_screw_zs for z0, z1 in L.boss_z_ranges if z0 <= z <= z1),
                "spigot ring outside the keyway (spigot_od/2 - keyway corner r)":
                    L.spigot_od / 2 - math.hypot(L.keyway_r_out, L.keyway_w / 2),
                "deck outside the lower wire-slot corners (body_r - hypot(lower_r_out, slot_w/2))":
                    L.body_r - math.hypot(L.wire_slot_lower_r_out, L.wire_slot_w / 2),
                "lip-pocket wall beside the wire channel (wire_ch_r0 - lip_pocket_id/2)":
                    L.wire_ch_r0 - L.lip_pocket_id / 2,
            })
            if not getattr(L, "wire_ch_open", False):   # the v0.5d-v0.8 closed channel (v0.9: open groove + cover)
                derived.update({
                    "bulge outer wall (wire_bulge_r_out - wire_ch_r1)": L.wire_bulge_r_out - L.wire_ch_r1,
                    "bulge floor (wire_ch_z0 - wire_bulge_z0)": L.wire_ch_z0 - L.wire_bulge_z0,
                    "bulge roof (wire_bulge_z1 - wire_ch_z1)": L.wire_bulge_z1 - L.wire_ch_z1,
                })
        if L.servo_leads:   # v0.6 SPEC 3.8 / 5.1 (layout raises below min_feature too)

            def _ang(a: float, b: float) -> float:
                return math.radians(abs(((a - b) + 180.0) % 360.0 - 180.0))
            if not L.direct_drive:
                derived.update({
                    "pod lead window roof under the ear hole ((rim - ear hole depth) - sl_win_z1)":
                        (L.pod_rim_z - rg.EAR_HOLE_DEPTH) - L.sl_win_z1,
                    "pod end wall beside the lead window": min(L.sl_win_u0 - L.pod_cavity_r_in, L.pod_cavity_r_out - L.sl_win_u1)})
            derived.update({
                "entry slot -> web (min over columns)": min(
                    L.sl_entry_u0 * math.sin(_ang(t, w)) - L.sl_entry_w / 2 - L.web_t / 2
                    for t in L.sl_col_thetas for w in L.web_thetas),
                "deck notch -> joint hole (min over columns)": min(
                    L.sl_notch_u0 * math.sin(_ang(t, j)) - L.sl_notch_w / 2 - p["body"]["joint_hole_spigot_d"] / 2
                    for t in L.sl_col_thetas for j in L.joint_thetas),
                "deck (skirt seat) outside the servo-lead notch corners": L.sl_deck_seat,
                "servo-lead rebate floor over the joint holes": L.sl_rebate_floor_over_joint,
                "spigot ring inside the servo-lead rebate": L.sl_rebate_ring,
                "lip-pocket wall beside the servo channel (sl_ch_r0 - lip_pocket_id/2)": L.sl_ch_r0 - L.lip_pocket_id / 2,
                "servo bulge outer wall (sl_bulge_r_out - sl_ch_r1)": L.sl_bulge_r_out - L.sl_ch_r1,
                "servo bulge floor / roof": min(L.sl_ch_z0 - L.sl_bulge_z0, L.sl_bulge_z1 - L.sl_ch_z1),
            })
        if getattr(L, "has_gps_pod", False):   # v0.8 GPS pod (Layout raises below min_feature too)
            gq = p["payload_module"]["gps_pod"]
            designed.update({"payload_module.gps_pod.wall_t": gq["wall_t"], "payload_module.gps_pod.floor_t": gq["floor_t"],
                             "payload_module.gps_pod.lid.t": gq["lid"]["t"], "payload_module.gps_pod.raceway.wall": gq["raceway"]["wall"],
                             "payload_module.gps_pod.connector_pocket.wall": gq["connector_pocket"]["wall"]})
            derived.update({f"GPS {k}": w for k, w in L.gps_walls.items()
                            if k not in ("pod wall_t", "pod floor_t", "lid t", "raceway wall", "connector pocket wall",
                                         "raceway skin over the tube")})
        if getattr(L, "has_gns", False):   # v0.8.1 GNS bosses (Layout raises below min_feature too); the boss length at its
            # outer vertex is a length, not a wall
            derived.update({f"GNS {k}": w for k, w in L.gns_walls.items() if not k.startswith("shortest boss")})
        bad_designed = {k: v for k, v in designed.items() if v < mf - FEATURE_EPS}
        bad_derived = {k: v for k, v in derived.items() if v < mf - FEATURE_EPS}
        st = FAIL if bad_designed else (WARN if bad_derived else PASS)
        return Check("C10", f"minimum designed wall/feature >= printer.min_feature ({mf})", st,
                     f"min designed {min(designed.values()):.2f} ({min(designed, key=designed.get)}); min derived {min(derived.values()):.2f} ({min(derived, key=derived.get)})",
                     "designed: " + ", ".join(f"{k}={v:g}" for k, v in designed.items()) +
                     f"; intake band (v0.6.1): band thickness = strut thickness window_wall_t {L.window_wall_t:g} (body.wall "
                     f"{L.body_wall:g}), strut_w {L.strut_w:g} at body_r, strut inner face {L.strut_w_in:.2f}, shelf ledge past "
                     f"the band {L.shelf_ledge:.2f} mm"
                     + (f"; v0.6.2 window gussets: wedges standing on the ring below each window and joined to the struts, "
                        f"the full band thickness {L.window_wall_t:g} deep everywhere (their thin edge is the bridge end, "
                        f"which lies on the ring: no free feature thinner than the band) - no new minimum feature"
                        if L.has_window_gable else "") +
                     ("; DERIVED BELOW MIN: " + ", ".join(f"{k}={v:.2f}" for k, v in bad_derived.items()) if bad_derived else ""),
                     {"designed": designed, "derived": derived, "min_feature": mf})

    def c11_nose(self) -> Check:
        L = self.L
        cav = self.report["derived"]["nose_cavity_volume_L"]
        req = L.p["recovery"]["chute_pack_volume_L_required"]
        v = _v(self.shape["chute_pack"], self.shape["nose_cone"])
        ok = cav >= req and v < INTERSECT_TOL_MM3
        return Check("C11", "nose cavity above the anchor bar >= required chute volume; chute pack clears the nose",
                     PASS if ok else FAIL, f"cavity {cav:.3f} L >= {req:.2f} L; chute_pack x nose {v:.3f} mm^3",
                     f"layout integral {L.nose_cavity_volume_L:.3f} L", {"cavity_L": cav, "required_L": req, "chute_nose": v})

    def c12_thrust_weight(self) -> Check:
        L = self.L
        m = self.report["totals"]["mass_g"]
        tw = L.p["edf"]["thrust_nominal_N"] / (m * 1e-3 * G0)
        st = PASS if tw >= 1.30 else (WARN if tw >= 1.15 else FAIL)
        return Check("C12", "thrust-to-weight at nominal thrust (>=1.30 PASS, 1.15-1.30 WARN)", st,
                     f"T/W = {tw:.3f} ({L.p['edf']['thrust_nominal_N']:.1f} N / {m:.0f} g)",
                     f"printed {self.report['totals']['printed_mass_g']:.0f} g of {m:.0f} g", {"tw": tw, "mass_g": m})

    def barrowman(self) -> dict:
        L = self.L
        d, R = L.body_od, L.body_r
        n = 2000
        vol = 0.0
        for k in range(n):
            x = L.nose_len * (k + 0.5) / n
            vol += math.pi * L.nose_outer_radius(x) ** 2 * (L.nose_len / n)
        x_n = L.nose_len - vol / (math.pi * R * R)
        z_n = L.z_nose_tip - x_n
        cn_n = 2.0
        s = L.fin_tip_r - L.vane_section_r
        cr, ct = L.fin_root_chord, L.fin_tip_chord
        x_r = L.fin_root_le_z - L.fin_tip_le_z
        lm = math.hypot(s, (x_r + ct / 2) - cr / 2)
        nf = L.p["fin"]["count"]
        rt = L.vane_section_r
        cn_f = (1 + rt / (s + rt)) * (4 * nf * (s / d) ** 2) / (1 + math.sqrt(1 + (2 * lm / (cr + ct)) ** 2))
        x_f = x_r * (cr + 2 * ct) / (3 * (cr + ct)) + (1 / 6) * ((cr + ct) - cr * ct / (cr + ct))
        z_f = L.fin_root_le_z - x_f
        cn = cn_n + cn_f
        z_cp = (cn_n * z_n + cn_f * z_f) / cn
        return {"cn_nose": cn_n, "z_cp_nose": z_n, "cn_fins": cn_f, "z_cp_fins": z_f, "cn_total": cn, "z_cp": z_cp,
                "nose_volume_mm3": vol, "fin_span": s, "fin_mid_chord_len": lm}

    def c13_stability(self) -> Check:
        L = self.L
        z_cg = self.report["totals"]["com_mm"][2]
        h = z_cg - L.vane_hinge_z
        b = self.barrowman()
        margin = (z_cg - b["z_cp"]) / L.body_od
        st = PASS if (h >= 250.0 and margin >= 1.0) else (WARN if (h >= 250.0 and margin >= 0.5) else FAIL)
        return Check("C13", "CG >= 250 mm above the vane hinge; Barrowman CP (nose+fins) below CG (>=1.0 cal PASS, >=0.5 WARN)", st,
                     f"CG z {z_cg:.1f} (hinge+{h:.1f} mm); CP z {b['z_cp']:.1f}; static margin {margin:.2f} cal",
                     f"nose Cn {b['cn_nose']:.2f} @z{b['z_cp_nose']:.0f}, fins Cn {b['cn_fins']:.2f} @z{b['z_cp_fins']:.0f} (coast config = full vehicle)",
                     {"z_cg": z_cg, "cg_above_hinge": h, "margin_cal": margin, **b})

    def c14_placeholders(self) -> Check:
        L = self.L
        big_r = L.footprint_d / 2
        zone: dict[str, tuple[cq.Shape, list[str]]] = {}
        z_edf0 = L.z_edf_housing_bottom - (L.p["edf"]["motor_protrusion_rear"] if L.tabs else 0.0)   # v0.5: motor below
        zone["edf_unit"] = (rg._cyl_z(L.body_r, z_edf0 - 1.0, L.z_edf_lip_top), ["propulsion_module", "intake_module"])
        vtol = getattr(L, "vtol", False)
        for n in [n for n in ("battery", "buffer_pack", "esc", "nav", "misc_electronics") if n in self.shape]:
            zone[n] = (rg._cyl_z(L.body_r, L.z_avionics_bottom, L.z_avionics_top), ["avionics_module", "avionics_tray"]
                       + (["top_cap"] if vtol else []))
        fcu_n = getattr(L, "fcu_part", "fcu")
        if fcu_n in self.shape:   # v0.6.3: avionics zone, lies on the intake bulkhead inside the intake spigot (VTOL: carrier)
            zone[fcu_n] = (rg._cyl_z(L.body_r, L.z_avionics_bottom, L.z_avionics_top),
                           ["intake_module", "avionics_module", "avionics_tray"])
        if "com" in self.shape:   # v0.6: avionics zone, hangs from the payload bulkhead's bosses
            zone["com"] = (rg._cyl_z(L.body_r, L.z_avionics_bottom, L.z_avionics_top),
                           ["avionics_module", "avionics_tray", "payload_module"])
        if "gns" in self.shape:   # v0.8.1: avionics zone, on its bosses on the -x tube wall
            zone["gns"] = (rg._cyl_z(L.body_r, L.z_avionics_bottom, L.z_avionics_top), ["avionics_module", "avionics_tray"])
        if "radio_log" in self.shape:   # v0.6.2: avionics zone, hangs from the payload bulkhead's underside
            zone["radio_log"] = (rg._cyl_z(L.body_r, L.z_avionics_bottom, L.z_avionics_top),
                                 ["avionics_module", "avionics_tray", "payload_module"])
        for n in ("gps", "gps_ground_plane"):   # v0.8: in the GPS pod outside the payload tube, under its lid
            if n in self.shape and vtol:    # v0.9 CAD-2 VTOL: on the cap top, inside the body radius
                zone[n] = (rg._cyl_z(L.body_r, L.z_cap_top, L.z_cap_top + 30.0), ["top_cap"])
            elif n in self.shape:
                zone[n] = (rg._cyl_z(big_r, L.z_payload_bottom, L.z_payload_top), ["payload_module", "gps_pod_lid"])
        for i in range(L.vane_count):
            z = rg._cyl_z(big_r, L.z_exit, L.z_prop_top)
            names = ((f"servo_vane_{i + 1}", f"servo_horn_{i + 1}") if L.direct_drive else
                     (f"servo_vane_{i + 1}", f"servo_arm_{i + 1}", f"pushrod_{i + 1}"))
            for n in names:      # v0.9 direct drive: the servo and horn sit in the fairing (they must clear the cover too)
                zone[n] = (z, ["propulsion_module"] + ([f"servo_cover_{i + 1}", f"vane_coupler_{i + 1}"] if L.direct_drive
                                                       and n.startswith("servo_vane") else
                                                       [f"servo_cover_{i + 1}"] if L.direct_drive else []))
        for i in range(L.vane_count):         # v0.9 fix round: brass hinge bushings in the bosses (clear of the vane shaft)
            n = f"hinge_bushing_{i + 1}"
            if n in self.shape:
                zone[n] = (rg._cyl_z(big_r, L.z_exit, L.z_prop_top), ["propulsion_module", f"vane_{i + 1}",
                                                                       f"vane_coupler_{i + 1}"])
        for n in getattr(L, "tether_boxes", {}):   # v0.9 fix round: tether kit boxes in the avionics bay
            zone[n] = (rg._cyl_z(L.body_r, L.z_avionics_bottom, L.z_avionics_top),
                       ["avionics_module", "avionics_tray", "top_cap", "intake_module"])
        for n in ("tether_eyebolt", "tether_load_washer", "tether_nut"):   # v0.9 fix round: hardpoint stack
            if n in self.shape:
                zone[n] = (rg._cyl_z(L.body_r, L.z_avionics_spigot_bottom, L.z_cap_top + 40.0),
                           ["avionics_module", "avionics_tray", "top_cap"])
        if not vtol:
            zone["servo_release"] = (rg._cyl_z(big_r, L.z_payload_bottom, L.z_payload_top), ["payload_module"])
            zone["cansat_payload"] = (rg.payload_envelope(L), ["payload_module", "piston"])
            zone["spring"] = (rg._cyl_z(L.body_id / 2, L.z_payload_bottom, L.z_payload_top), ["payload_module", "piston"])
            zone["chute_pack"] = (rg.nose_inner_solid(L), ["nose_cone"])
        worst_out, worst_in, rows = (0.0, ""), (0.0, ""), []
        for name, (zs, mods) in zone.items():
            s = self.shape[name]
            outside = s.cut(zs).Volume()
            inter = max(_v(s, self.shape[m]) for m in mods)
            rows.append(f"{name}: out {outside:.2f},  x struct {inter:.2f}")
            if outside > worst_out[0]:
                worst_out = (outside, name)
            if inter > worst_in[0]:
                worst_in = (inter, name)
        vmax = max(worst_out[0], worst_in[0])
        return Check("C14", "every placeholder lies inside its module zone and clears the structure",
                     _status_no_intersection(vmax),
                     f"max outside-zone {worst_out[0]:.3f} mm^3 ({worst_out[1]}), max  x structure {worst_in[0]:.3f} mm^3 ({worst_in[1]})",
                     "zones: bore cylinder of the module (EDF: body_r over housing" + (" (tabs: motor)" if L.tabs else "") +
                     "..lip; servos/arms/pushrods: footprint radius over the module; CanSat: payload envelope; chute: nose inner void); " + "; ".join(rows),
                     {"worst_outside": worst_out, "worst_intersect": worst_in})

    def c15_latch(self) -> Check:
        L = self.L
        arm = self.shape["latch_arm"]
        rel = rg.latch_arm(L, released=True)
        lug = rg.latch_lug(L, overlap=0.0)
        lug_tall = rg._box_polar(L.lug_r_in, L.lug_r_out, -L.lug_w / 2, L.lug_w / 2, L.z_latch_arm_bottom, L.z_latch_arm_top, L.latch_lug_theta)
        t = L.p["payload_module"]["latch_arm_t"]
        area_latched = _vpos(arm, lug_tall) / t       # positive evidence: an uncomputable overlap counts 0 (FAIL)
        area_released = _v(rel, lug_tall) / t         # no-intersection test: uncomputable counts +inf (FAIL)
        ov_len = area_latched / L.latch_arm_w
        v_lug, v_nose = _v(arm, lug), _v(arm, self.shape["nose_cone"])
        v_rel_nose, v_rel_pay = _v(rel, self.shape["nose_cone"]), _v(rel, self.shape["payload_module"])
        ok = ov_len >= 4.0 and max(v_lug, v_nose, v_rel_nose, v_rel_pay) < INTERSECT_TOL_MM3 and area_released < INTERSECT_TOL_MM3
        tip_l, tip_r = rg.latch_arm_tip_xy(L), rg.latch_arm_tip_xy(L, released=True)
        return Check("C15", "latch arm overlaps the lug >= 4 mm in XY when latched, clears lug/skirt; zero overlap released",
                     PASS if ok else FAIL,
                     f"latched XY overlap {area_latched:.1f} mm^2 = {ov_len:.2f} mm along the arm; arm x lug {v_lug:.3f}, arm x nose {v_nose:.3f}; released overlap {area_released:.2f} mm^2, released x nose {v_rel_nose:.3f},  x payload {v_rel_pay:.3f} mm^3",
                     f"axis ({rg.latch_axis_xy(L)[0]:.2f},{rg.latch_axis_xy(L)[1]:.2f}) r={math.hypot(*rg.latch_axis_xy(L)):.2f}; latched tip ({tip_l[0]:.2f},{tip_l[1]:.2f}) r={math.hypot(*tip_l):.2f}; released tip r={math.hypot(*tip_r):.2f}; arm len {L.latch_arm_len:g}",
                     {"overlap_mm": ov_len, "area_latched": area_latched, "area_released": area_released, "arm_lug": v_lug, "arm_nose": v_nose})

    def c16_screw_holes(self) -> Check:
        """SPEC C16; v0.5d (SPEC 3.2): the propulsion spigot holes are blind, so their probe starts just past the hole
        bottom, and a probe from the EDF bore to just short of the bottom must be solid (positive evidence that the
        hole really is blind - a joint screw cannot reach the EDF housing)."""
        L = self.L
        worst, rows = (0.0, ""), []
        floor_min, floor_rows = math.inf, []
        for j in rg.joints(L):
            if not j.screwed:
                continue
            for th in L.joint_thetas:
                probe = rg.joint_probe(L, j, th)
                v_lo, v_up = _v(probe, self.shape[j.lower]), _v(probe, self.shape[j.upper])
                rows.append(f"{j.lower}/{j.upper} th{th:.0f} z{j.z_spigot_bottom + L.joint_screw_dz:.1f}: {v_lo:.3f}/{v_up:.3f}")
                for v, who in ((v_lo, j.lower), (v_up, j.upper)):
                    if v > worst[0]:
                        worst = (v, f"{who} th{th:.0f}")
                fp = rg.joint_hole_floor_probe(L, j, th)
                if fp is not None:
                    fill = _vpos(fp, self.shape[j.lower]) / fp.Volume()
                    floor_min = min(floor_min, fill)
                    floor_rows.append(f"{j.lower} th{th:.0f} {fill:.4f}")
        blind = [j for j in rg.joints(L) if j.screwed and j.hole_bottom_r is not None]
        # SPEC 3.2: with a prop_joint_hole_depth the propulsion holes MUST be blind and their floor must be measured
        need_blind = bool(L.prop_joint_hole_depth)
        floor_ok = (not need_blind or (blind and math.isfinite(floor_min))) and (not blind or floor_min >= JOINT_FLOOR_FILL_MIN)
        st = _status_no_intersection(worst[0]) if floor_ok else FAIL
        blind_txt = (f"; blind holes ({', '.join(j.lower for j in blind)}): floor r {blind[0].spigot_inner_r:.2f}.."
                     f"{blind[0].hole_bottom_r:.2f} (bore -> hole bottom, depth {L.prop_joint_hole_depth:g} from the "
                     f"spigot OD) filled min {floor_min:.4f} >= {JOINT_FLOOR_FILL_MIN:g}" if blind else "; no blind holes")
        return Check("C16", "D2 probes along every joint screw axis pass both the spigot and the outer tube "
                     "(v0.5d: propulsion holes blind)",
                     st, f"max probe x wall {worst[0]:.3f} mm^3 ({worst[1]}) over {len(rows)} probes" + blind_txt,
                     "; ".join(rows) + (f"; blind-hole floor fill: {'; '.join(floor_rows)}" if floor_rows else "")
                     + f"; blind-hole probes start {rg.JOINT_PROBE_INSET:g} mm past the hole bottom",
                     {"worst": worst, "blind_floor_fill_min": floor_min if blind else None})

    def c17_presets(self) -> Check:
        p = load_params()
        presets = [p["meta"]["preset"]] + list(p.get("alt_presets", {}))
        results = {}
        for name in presets:
            if name == self.L.p["meta"]["preset"]:
                results[name] = f"ok ({len(self.parts)} parts)"
                continue
            try:
                t = time.time()
                parts = rg.build_all(rg.layout_for(name))
                bad = [n for n, q in parts.items() if q.shape is not None and not q.shape.isValid()]
                results[name] = f"ok ({len(parts)} parts, {time.time() - t:.1f} s)" if not bad else f"INVALID solids: {bad}"
            except Exception as ex:  # noqa: BLE001 - the check reports any exception
                results[name] = f"EXCEPTION {type(ex).__name__}: {ex}"
        ok = all(r.startswith("ok") for r in results.values())
        return Check("C17", "all presets build without exceptions", PASS if ok else FAIL,
                     "; ".join(f"{k}: {v}" for k, v in results.items()), "", results)

    # ---------------- v0.5 EDF tab mount (SPEC 3.7 / 5.1), N/A for edf.mount = lip_clamp ----------------
    def _na(self, cid: str, title: str) -> Check:
        return Check(cid, title, NA, f"not applicable: edf.mount = {self.L.edf_mount!r} (tab-mount check)", "",
                     {"applicable": False})

    def c18_tab_slide(self) -> Check:
        title = "(tabs) EDF tabs slide down the keyways, seat without interference, keyway floor carries the tab"
        L = self.L
        if not L.tabs:
            return self._na("C18", title)
        if getattr(L, "clock_mount", False):
            st, meas, det, vals = ckc.c18_clock(L, self.prop, self.shape["intake_module"])
            return Check("C18", "(clock mount) EDF tabs slide down EVERY keyway, seat without interference, floor + floor pad "
                         "carry the tab (pad bending factor >= 5 PASS, 3-5 WARN, < 3 FAIL, E)", st, meas, det, vals)
        intake = self.shape["intake_module"]
        rows, worst_sweep, worst_seat, worst_gap, areas = [], 0.0, 0.0, 0.0, []
        for th in L.tab_thetas:
            v_sweep = _v(rg.tab_sweep(L, th), self.prop)
            tab = rg.edf_tab(L, th)
            v_seat = max(_v(tab, self.prop), _v(tab, intake))
            # keyway floor = module material directly under the tab footprint
            under = rg._box_polar(L.tab_r_in - rg.EDF_TAB_INTO_HOUSING, L.tab_r_out, -L.tab_t / 2, L.tab_t / 2,
                                  L.tab_z0 - FLOOR_PROBE_H, L.tab_z0, th)
            floor = self.prop.intersect(under)
            v_floor = floor.Volume() if not floor.wrapped.IsNull() else 0.0
            gap = (L.tab_z0 - floor.BoundingBox().zmax) if v_floor > 1e-9 else math.inf
            # bearing area: material in a FLOOR_AREA_SLAB-thin slab right under the tab footprint / slab height
            slab = rg._box_polar(L.tab_r_in - rg.EDF_TAB_INTO_HOUSING, L.tab_r_out, -L.tab_t / 2, L.tab_t / 2,
                                 L.tab_z0 - FLOOR_AREA_SLAB, L.tab_z0, th)
            area = _vpos(slab, self.prop) / FLOOR_AREA_SLAB
            rows.append(f"tab {th:.0f}deg: sweep x prop {v_sweep:.3f}, seated x modules {v_seat:.3f} mm^3, "
                        f"floor gap {gap:.4f} mm, floor area ~{area:.1f} mm^2")
            worst_sweep, worst_seat, worst_gap = max(worst_sweep, v_sweep), max(worst_seat, v_seat), max(worst_gap, gap)
            areas.append(area)
        area_req = C18_FLOOR_AREA_FRACTION * L.tab_t * (L.tab_r_out - L.edf_bore_r)
        ok = (max(worst_sweep, worst_seat) < INTERSECT_TOL_MM3 and worst_gap < C18_FLOOR_GAP_MAX
              and min(areas) >= area_req)
        return Check("C18", title, PASS if ok else FAIL,
                     f"max sweep x prop {worst_sweep:.3f}, seated tab x (prop|intake) {worst_seat:.3f} mm^3; "
                     f"max floor gap {worst_gap:.4f} mm (< {C18_FLOOR_GAP_MAX}); min floor area {min(areas):.2f} mm^2 "
                     f">= {area_req:.2f} ({C18_FLOOR_AREA_FRACTION:g} x tab_t x (tab_r_out - edf_bore_r))",
                     f"sweep Z {L.tab_z0:.1f}..{L.keyway_z1 + L.tab_z1 - L.tab_z0:.1f} (tab bottom up to keyway_z1 "
                     f"{L.keyway_z1:.1f}); keyway w {L.keyway_w:.1f} r {L.keyway_r_in:.2f}..{L.keyway_r_out:.2f} vs tab "
                     f"t {L.tab_t:.1f} r ..{L.tab_r_out:.1f}; " + "; ".join(rows),
                     {"sweep": worst_sweep, "seat": worst_seat, "floor_gap": worst_gap, "floor_area_mm2": areas})

    def c19_tab_screws(self) -> Check:
        title = "(tabs) tab screws: clear hole, open head tunnel to the outside, tap hole with material, axis through the tab slot"
        L = self.L
        if not L.tabs:
            return self._na("C19", title)
        if getattr(L, "clock_mount", False):
            return Check("C19", title, NA, "not applicable: propulsion_module.tab_mount 'clock_keyways' - no tab screws; the "
                         "EDF is held axially by the intake shelf / foam pads (C35) and turned by the keyway walls (C35 "
                         "bearing)", "", {"applicable": False, "reason": "no tab screws, see C35"})
        edf = self.shape["edf_unit"]
        skin = rg._tube(L.body_r, L.body_r - L.cone_wall, L.z_cyl0, L.z_prop_spigot_bottom)
        t_tun0, t_tun1 = L.tab_screw_t_head + C19_PROBE_INSET, L.tab_screw_t_cbore_end + C19_TUNNEL_PAST_END
        t_tap0, t_tap1 = L.tab_screw_t_tap_end + C19_PROBE_INSET, -L.tab_screw_t_keyway
        tap_len = t_tap1 - t_tap0
        tap_req = C19_TAP_MAT_FRACTION * math.pi / 4 * (C19_TAP_MAT_PROBE_D ** 2 - L.tab_screw_d_tap ** 2) * tap_len
        d_ctrl = L.tab_slot_w + C19_SLOT_CONTROL_EXTRA_D
        t_slot = L.tab_t / 2
        worst = {"clear": 0.0, "tunnel": 0.0, "tap_free": 0.0, "edf": 0.0}
        min_tap_mat, min_ctrl, min_skin, rows = math.inf, math.inf, math.inf, []
        n = 0
        for th in L.tab_thetas:
            for z in L.tab_screw_zs:
                n += 1
                probe = lambda d, t0, t1: rg.tab_screw_probe(L, th, z, d, t0, t1)  # noqa: E731
                tunnel = probe(C19_TUNNEL_PROBE_D, t_tun0, t_tun1)
                v = {
                    "clear": _v(probe(C19_CLEAR_PROBE_D, L.tab_screw_t_keyway, L.tab_screw_t_head), self.prop),
                    "tunnel": _v(tunnel, self.prop),
                    "tap_free": _v(probe(C19_TAP_FREE_PROBE_D, t_tap0, t_tap1), self.prop),
                    "edf": _v(probe(SHANK_PROBE_D, -t_slot, t_slot), edf),
                }
                tap_mat = _vpos(probe(C19_TAP_MAT_PROBE_D, t_tap0, t_tap1), self.prop)
                ctrl = _vpos(probe(d_ctrl, -t_slot, t_slot), edf)  # positive control: the tab is really there
                through_skin = _vpos(tunnel, skin)         # > 1 mm^3: the open tunnel crosses where the skin is
                for k in worst:
                    worst[k] = max(worst[k], v[k])
                min_tap_mat, min_ctrl = min(min_tap_mat, tap_mat), min(min_ctrl, ctrl)
                min_skin = min(min_skin, through_skin)
                rows.append(f"{th:.0f}deg z{z:.1f}: clear {v['clear']:.3f} tunnel {v['tunnel']:.3f} (skin crossed "
                            f"{through_skin:.1f}) tap {v['tap_free']:.3f} / O{C19_TAP_MAT_PROBE_D:g} {tap_mat:.2f} "
                            f"slot O{SHANK_PROBE_D:g} x edf {v['edf']:.3f} / O{d_ctrl:g} x edf {ctrl:.2f}")
        ok = (max(worst["clear"], worst["tap_free"], worst["edf"]) < INTERSECT_TOL_MM3
              and worst["tunnel"] < C19_TUNNEL_TOL_MM3 and min_tap_mat >= tap_req and min_ctrl > INTERSECT_TOL_MM3
              and min_skin > INTERSECT_TOL_MM3)
        return Check("C19", title, PASS if ok else FAIL,
                     f"{n} screws: max clear-hole {worst['clear']:.3f}, tunnel {worst['tunnel']:.4f} (< {C19_TUNNEL_TOL_MM3:g}), tap-hole "
                     f"{worst['tap_free']:.3f}, O{SHANK_PROBE_D:g} slot x edf {worst['edf']:.3f} mm^3; tunnel x skin annulus min "
                     f"{min_skin:.2f} mm^3 (> {INTERSECT_TOL_MM3:g}: it reaches the outside); min tap material "
                     f"{min_tap_mat:.2f} >= {tap_req:.2f} mm^3; slot control O{d_ctrl:g} x edf min {min_ctrl:.2f} mm^3 "
                     f"(> 0, i.e. above the {INTERSECT_TOL_MM3:g} mm^3 tolerance)",
                     f"axis r {L.tab_screw_r:.1f}, t keyway {L.tab_screw_t_keyway:.1f} / head {L.tab_screw_t_head:.1f} / tip "
                     f"{L.tab_screw_t_tip:.1f} / tap end {L.tab_screw_t_tap_end:.1f} / out {L.tab_screw_t_out:.2f} / cbore end "
                     f"{L.tab_screw_t_cbore_end:.2f}; tunnel probe t {t_tun0:.2f}..{t_tun1:.2f}; tap probes t {t_tap0:.2f}.."
                     f"{t_tap1:.2f} (len {tap_len:.2f}, required {C19_TAP_MAT_FRACTION:g} x pi/4 x ({C19_TAP_MAT_PROBE_D:g}^2 - "
                     f"{L.tab_screw_d_tap:g}^2) x len = {tap_req:.2f}); slot probes |t| <= {t_slot:.2f}; " + "; ".join(rows),
                     {**worst, "min_tap_material": min_tap_mat, "tap_material_required": tap_req,
                      "slot_control_min": min_ctrl, "slot_control_d": d_ctrl, "tunnel_skin_min": min_skin})

    def _screw_probes(self, axes, d_tap: float, d_clear: float, t_cover: float, target: cq.Shape, cover: cq.Shape) -> list[dict]:
        """Tap hole clear, material ring around it, cover clearance hole clear - for screw axes (head point, tap end)."""
        rows = []
        for a, b in axes:
            va, vb = cq.Vector(*a), cq.Vector(*b)
            ax = (vb - va).normalized()
            n = (vb - va).Length
            tap_clear = rg._cyl_between(d_tap - 2 * C5_PROBE_INSET, a, (va + ax * (n - C5_PROBE_INSET)).toTuple())
            ring = rg._cyl_between(d_tap + 2 * C5_TAP_RING, (va + ax * C5_PROBE_INSET).toTuple(), b).cut(
                rg._cyl_between(d_tap + 2 * C5_PROBE_INSET, a, b, ext0=1.0, ext1=1.0))
            hole = rg._cyl_between(d_clear - 2 * C5_PROBE_INSET, (va - ax * (t_cover + 0.5)).toTuple(), a)
            rows.append({"tap_clear": _v(tap_clear, target), "tap_material": _vpos(ring, target) / ring.Volume(),
                         "hole_clear": _v(hole, cover)})
        return rows

    def _c20_open(self, title: str) -> Check:
        """v0.9 (intake wire_channel.open): the three bare motor leads side by side (rocket_geometry.motor_lead_legs, grown
        by wire_clearance) clear the propulsion / intake modules, the EDF and the cover along the whole path; the groove
        is OPEN with the cover off (no material across its outer face), its side walls and roof wedge are solid, the
        wire_cover seats on it (no overlap, gap < 0.01) and its four screws have clear tap holes with material and clear
        cover holes; leg E keeps a BRep gap > 0 to the windowed band; the intake's outer skin has no other opening."""
        L = self.L
        intake, cover = self.shape["intake_module"], self.shape["wire_cover"]
        mods = {"prop": self.prop, "intake": intake, "edf": self.shape["edf_unit"], "cover": cover}
        legs = rg.motor_lead_legs(L)
        per_leg = {k: {m: _v(leg, s) for m, s in mods.items()} for k, leg in legs.items()}
        v_max = max(max(d.values()) for d in per_leg.values())
        th, hw, sw, i_ = L.wire_theta, L.wire_ch_w / 2, L.wire_side_wall, C5_PROBE_INSET
        open_probe = rg._box_polar(L.wire_ch_r1 - 0.5, L.wire_ch_r1 + 2.0, -hw + i_, hw - i_, L.z_intake_bottom + i_,
                                   L.wire_ch_z1 - i_, th)
        v_open = _v(open_probe, intake)
        walls = {f"side wall {'+' if s > 0 else '-'}": rg._box_polar(L.body_r + i_, L.wire_ch_r1 - i_,
                                                                      (hw + i_) if s > 0 else (-hw - sw + i_),
                                                                      (hw + sw - i_) if s > 0 else (-hw - i_),
                                                                      L.z_intake_bottom + i_, L.wire_ch_z1 - i_, th)
                 for s in (1.0, -1.0)}
        walls["roof wedge"] = rg._prism_uz(L.wire_roof_rz, -hw - sw + i_, hw + sw - i_, th).intersect(
            rg._tube(L.wire_ch_r1 - i_, L.body_r + i_, L.wire_ch_z1 + i_, L.wire_bulge_z1))
        taps = rg._fuse([rg._cyl_between(L.wire_cov_d_tap + 2 * i_, a, b, ext0=1.0, ext1=i_)
                         for a, b in rg.wire_cover_screw_axes(L)])
        missing = {k: _void(b.cut(taps), intake) for k, b in walls.items()}     # the tap holes are C20's screw rows
        seat = {"cover x intake": _v(cover, intake), "cover gap": _clearance(cover, intake)}
        covers_opening = (L.wire_cov_hv >= hw + sw - 1e-9 and L.wire_cov_z[0] <= L.z_intake_bottom + 1e-9
                          and L.wire_cov_z[1] >= L.wire_ch_z1 - 1e-9)
        screws = self._screw_probes(rg.wire_cover_screw_axes(L), L.wire_cov_d_tap, L.wire_cov_d_clear, L.wire_cov_t,
                                    intake, cover)
        # skin: the intake's outer 0.3 mm over [z_intake_bottom, z_window_bottom] has no opening except the joint holes,
        # the groove (with its side walls) and the servo channel
        shell = rg._tube(L.body_r, L.body_r - 0.3, L.z_intake_bottom, L.z_window_bottom)
        # (u from body_r - 3: at |v| = 15 the cylinder lies 1.9 mm inside the tangent plane's body_r)
        allowed = rg._box_polar(L.body_r - 3.0, L.body_r + 1.0, -hw - sw, hw + sw, L.z_intake_bottom - 1.0, L.wire_ch_z1 + 1.0, th)
        for jth in L.joint_thetas:
            jz = L.z_intake_bottom + L.joint_screw_dz
            allowed = allowed.fuse(rg._box_polar(L.body_r - 1.0, L.body_r + 1.0, -2.0, 2.0, jz - 2.0, jz + 2.0, jth))
        if L.servo_leads:
            allowed = allowed.fuse(rg._box_polar(L.body_r - 1.0, L.body_r + 1.0, -L.sl_ch_w / 2, L.sl_ch_w / 2,
                                                 L.sl_ch_z0, L.sl_ch_z1, L.sl_gather_theta))
        try:
            stray = _void(shell.cut(allowed), intake)
        except Exception:  # noqa: BLE001
            stray = math.inf
        band_gap = _clearance(legs["E"], self._intake_band_part())
        ok = (v_max < INTERSECT_TOL_MM3 and v_open < C29_CLEAR_TOL_MM3 and max(missing.values()) < C20_CLOSED_TOL_MM3
              and seat["cover x intake"] < INTERSECT_TOL_MM3 and seat["cover gap"] < 0.01 and covers_opening
              and all(r["tap_clear"] < C5_CLEAR_TOL_MM3 and r["tap_material"] >= C5_FILL_MIN and r["hole_clear"] < C5_CLEAR_TOL_MM3
                      for r in screws) and stray < C20_CLOSED_TOL_MM3 and band_gap > 0.0)
        sec = L.ml_sections
        return Check("C20", title, PASS if ok else FAIL,
                     f"3 leads (O{L.ml_od:g} + {L.ml_wire_clear:g}) x (prop/intake/edf/cover) max {v_max:.3f} mm^3; groove open "
                     f"(cover off) x intake {v_open:.4f} mm^3; side walls / roof missing max {max(missing.values()):.3f} mm^3; "
                     f"cover x intake {seat['cover x intake']:.3f} mm^3, gap {seat['cover gap']:.3f} mm, covers the opening "
                     f"{covers_opening}; screws tap clear max {max(r['tap_clear'] for r in screws):.4f}, material min "
                     f"{min(r['tap_material'] for r in screws):.3f}, cover holes clear max {max(r['hole_clear'] for r in screws):.4f}; "
                     f"skin stray {stray:.3f} mm^3; leg E -> band {band_gap:.2f} mm",
                     f"groove {L.wire_ch_w:g} x {L.wire_ch_r1 - L.wire_ch_r0:g} (r {L.wire_ch_r0:.2f}..{L.wire_ch_r1:.2f}), Z "
                     f"{L.z_intake_bottom:.1f}..{L.wire_ch_z1:.1f}, gate {L.wire_ch_gate_h:g} mm over the lip, bulkhead hole "
                     f"r {L.wire_hole_r0:g}..{L.wire_hole_r1:g} x {L.wire_ch_w:g}; sections (have vs need, mm): "
                     + "; ".join(f"{k} {d['have_w']:.1f}x{d['have_h']:.1f} vs {d['need_w']:.1f}x{d['need_h']:.1f}"
                                 for k, d in sec.items())
                     + "; per leg x (prop/intake/edf/cover): "
                     + "; ".join(f"{k} " + "/".join(f"{per_leg[k][m]:.3f}" for m in mods) for k in legs),
                     {"per_leg": per_leg, "open": v_open, "walls_missing": missing, "seat": seat,
                      "covers_opening": covers_opening, "screws": screws, "skin_stray": stray, "leg_e_band_gap_mm": band_gap,
                      "sections": sec})

    def _c29_clock(self) -> dict:
        """wire09c clock mount: the generosity-box corner grid (check_clock.clock_grid: every corner x e in {-E, 0, +E},
        grown envelope x module / intake, drop-in sweep x module, raw envelope x EDF, hovering tab gap, clearances,
        negative controls that must collide) + the bond-gap rule (TE inset + rim gap <= bond_gap_max: WARN 'thicker RTV
        bead or a shim', the limit is not raised) + the jet free span without the optional RTV bond."""
        L = self.L
        cache = os.path.join(os.path.dirname(os.path.abspath(__file__)), "..", "exports", "c29_clock_grid")
        os.makedirs(cache, exist_ok=True)
        g = ckc.clock_grid(L, self.shape, cache, log=lambda m: print(m, flush=True))
        tol = ckc.CLOCK_CLEAR_TOL_MM3
        neg = min(g["negative_control_e_plus6_mm3"], g["negative_control_wall_plus3_mm3"],
                  g["negative_control_dropin_e_plus6_mm3"])
        hg = g["hover_tab_gap_min_mm"]
        cl = g["clearances_mm"]
        ok = (g["grown_x_module_max"][0] < tol and g["grown_x_intake_max"][0] < tol and g["dropin_x_module_max"][0] < tol
              and g["raw_x_edf_max"][0] < tol and neg > INTERSECT_TOL_MM3 and (hg is None or hg >= ckc.HOVER_TAB_GAP_MIN)
              and min(cl.values()) > 0.0 and max(L.ml_lower_free_spans) <= L.ml_lower_max_free_span + 1e-9)
        warns = []
        if L.ml_bond_gap_worst > L.ml_bond_gap_max + 1e-9:
            warns.append(f"bond gap TE inset {max(L.gb_inset):g} + rim gap {max(L.gb_gap):g} = {L.ml_bond_gap_worst:g} mm > "
                         f"bond_gap_max_ASSUMED {L.ml_bond_gap_max:g} (the optional RTV bond of the bundle to the stator TE "
                         f"needs a thicker RTV bead or a shim there; the limit is not raised)")
        txt = (f"; CLOCK MOUNT lead passage (every generosity-box corner x e in "
               f"{{{', '.join(f'{e:+.2f}' for e in g['e_values_deg'])}}} deg{', ' + g['from_cache'] if g.get('from_cache') else ''}): "
               f"{g['module_envelopes']} grown envelopes x module max {g['grown_x_module_max'][0]:.4f} mm^3 "
               f"({g['grown_x_module_max'][1]}), x intake max {g['grown_x_intake_max'][0]:.4f}; {g['dropin_sweeps']} drop-in "
               f"sweeps x module max {g['dropin_x_module_max'][0]:.4f}; {g['raw_x_edf_tests']} raw envelope x EDF tests max "
               f"{g['raw_x_edf_max'][0]:.4f} (TE inset 0 / 3, hub ends at the TE - A; protrusion "
               f"{min(L.gb_protrusion):g} / {max(L.gb_protrusion):g}; nominal + {len(L.ck_hover)} hover seats); negative "
               f"controls (must collide) e + 6 deg {g['negative_control_e_plus6_mm3']:.0f}, wall + 3 mm "
               f"{g['negative_control_wall_plus3_mm3']:.0f}, drop-in e + 6 {g['negative_control_dropin_e_plus6_mm3']:.0f} mm^3; "
               f"hovering tab -> leads min {hg if hg is None else round(hg, 2)} mm (>= {ckc.HOVER_TAB_GAP_MIN:g}); "
               f"clearances " + ", ".join(f"{k} {v:.1f}" for k, v in cl.items())
               + f" mm; jet free span without the RTV bond {max(L.ml_lower_free_spans):.1f} mm (<= "
               f"{L.ml_lower_max_free_span:g} ASSUMED); exit azimuth not an input (coverage C34)")
        return {"ok": ok, "warns": warns, "txt": txt, "grid": g}
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
