Yuchan-00/CanSat_EDF_Rocket/(commit log)

2026-11-04 CanSat EDF Rocket v0.9: initial public commit
    90 mm EDF CanSat launcher (rocket) and lighter VTOL configurations
    (battery / tether / hybrid): layout + Fusion 360 script, CadQuery twin
    with geometry checks C1-C36, Bambu P2S print files (white body, orange
    YUCHAN 2-colour AMS inlay), 6-DOF Python simulation and campaigns,
    ATmega128A 4-chip firmware with simavr co-simulation, sizing, budget
    and Korean documentation. Showcase README with renders and process
    images. EDF thrust is not measured yet; see README for open items.
    License: CC BY-NC 4.0.
    [avionics_module.3mf, avionics_tray.3mf, config.txt, gps_pod_lid.3mf, human_rigged.blend, intake_module.3mf, latch_arm.3mf, launch_pad.3mf]
2026-11-05 Add the VTOL avionics carrier PCB and the logic power round
    PCB (pcb/vtol_carrier, KiCad 10 + Freerouting 2.5.0, never built: NOT_VERIFIED)
    - rev 2c: 76 x 70 mm 4-layer carrier, 4 x ATmega128A (NAV/FCU/COM/GNS),
    ESP-12E radio (replaces the PLM100 LoRa), 1S logic battery input +
    Pololu 5 V buck-boost + AMS1117-3.3, BMP280 / GY-521 / NEO-7M lead,
    OpenLog. The unpopulated 5th ATmega128A footprint and the VTOL release
    header J13 were removed.
    - kicad-cli 10.0.6: ERC 0 errors / 0 warnings; DRC 0 errors / 0 warnings /
    0 unconnected / 0 parity. Gerbers, JLC BOM/CPL with LCSC numbers,
    devicemart purchase list, STEP, renders, schematic PDF/SVG.
    - Every part sourced from JLCPCB/LCSC or dev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
    [bom_sources_all_lines.csv, com.kicad_sch, devicemart_purchase_list.csv, fcu.kicad_sch, gns.kicad_sch, io.kicad_sch, jlcpcb_bom.csv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]
2026-11-05 Firmware round: ESP-12E Wi-Fi link, regenerated headers, NEO-7M id
    No control change in this round (the sim keeps the LoRa link model).
    - Headers params_gen.h / gains.h / bridge_config_gen.h regenerated from the
    current params.json (no vehicle constant changed; hashes, FC_PARAMS_TAG,
    ESP and LOGIC_BAT macros). The 3 header-currency tests pass again.
    - COM backend hal/esp_bridge.c: USART1 38400 8N1 (UBRR 25, +0.16 %),
    open-drain ESP reset on PC6 at cold boot only, 400 ms boot-garbage
    window; frame protocol byte-identical. Selected by the new key
    flight_computer.link.vehicle_radio = esp_bridge (VTOL and rocket);
    lora_uart / sx127x stay buildable as the fallback.
    - firmware/esp_bri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
    [bridge_core.cpp, bridge_core.h, build_arduino_cli.py, com_main.c, com_simbench.c, esp_bridge.c, esp_bridge.h]
2026-11-09 Docs: match the current hardware (BMP280, NEO-7M, 4 chips, ESP radio, no 5th chip)
    Prose documentation only; params.json, code and the generated budget files
    are unchanged (a params.json edit would change every HEX again - those
    places are fixed together in the next control round).
    - Barometer part is the BMP280 module (user decision 2026-11-04); the
    firmware still has only the MS5611 driver and the sim keeps the MS5611
    model until the BMP280 control round - stated as such, no BMP280 support
    is claimed.
    - GPS part is the NEO-7M (user decision 2026-11-04).
    - P3 fallback: the carrier has no 5th-chip footprint since rev 2b
    (2026-11-05); using P3 now needs a board redesign (user decisio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
2026-11-10 WIP: control round (ESP link, BMP280 driver + baro model) paused mid-sync
    Stopped 2026-11-11 03:50 (weekly usage). Stages done: baseline, link
    (R-ESP1, TELEM v6/v7), baro (BMP280 NAV driver, cosim model, sim baro
    BMP280 + GPS NEO-7M, altitude crossover 0.5 -> 0.4 Hz). The sync stage
    was interrupted, so doc/param sync edits may be partial.
    Open: tools/test_ground_station.py::test_vtol_demo_profile_practice_hop
    fails (h_max 2.537 m vs 2.5 m limit) - user decision. Row 21 ballistic
    hashes await user re-declaration. Remaining: sync, comparison videos,
    reviews, fix, deliver.
    [avionics_module.3mf, avionics_tray.3mf, gps_pod_lid.3mf, latch_arm.3mf, launch_pad.3mf, nose_cone.3mf, payload_module.3mf, piston.3mf]
2026-11-14 WIP: rocket baseline = carrier PCB (stopped at weekly usage limit)
    User decision 2026-11-13: the carrier PCB rev 3.1 also flies in the rocket
    and replaces the NAV / FCU / COM / GNS boards and the radio box.
    Done and independently verified:
    - params: rocket electronics = carrier (39.4 g ASSUMED, weigh it), intake
    vent holes 2 at 90/270 deg, wall switch holes (arm 82 deg, logic 106 deg),
    rocket logic_power (1S pack flies), release lead to J13, GPS lead to J7.
    Open items are marked 'default, user decision pending'.
    - Layout / check_geometry: rocket 0 FAIL, 5 WARN (C10, C12, C13, C29, C42);
    VTOL unchanged (0 FAIL, 3 WARN). C22/C24/C27 N/A (boards gone), new C42.
    No check limit loosene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
    [avionics_module.3mf, avionics_tray.3mf, intake_module.3mf, payload_module.3mf]
